SSCsimsi/8Bit_Computer/Programmer/Xgpro/img/T48BGA64.jpg

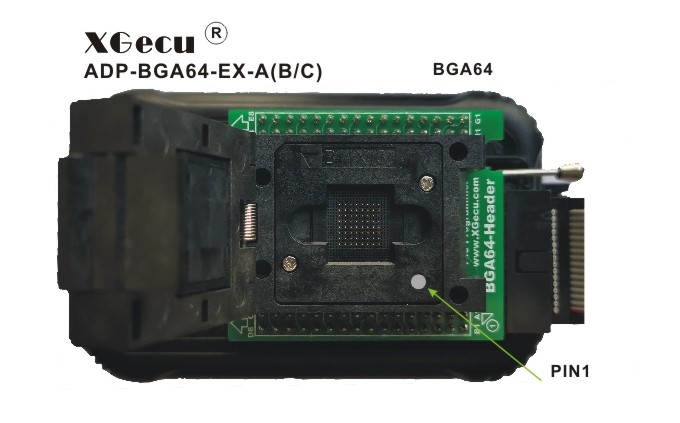
Programmer/Xgpro/img/T48BGA64.jpg
