SSCsimsi/8Bit_Computer/Programmer/Xgpro/img/T48_EMMC_Prog.jpg

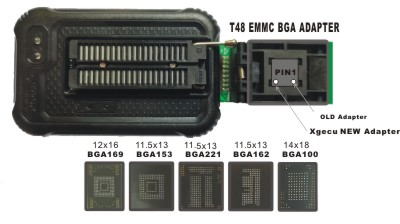
Programmer/Xgpro/img/T48_EMMC_Prog.jpg
