SSCsimsi/8Bit_Computer/Digital_new/docu/Documentation_it.pdf

### Digital

# Digital


Revisione: | v0.31
Data: | 2024-09-03 12:57
https://github.com/hneemann/Digital | 1 / 106

## Indice

A Generale

B Impostazioni
C Interfaccia a Linea di Comando D Componenti
1. Logica
2. IO
3. IO - Schermi

4. IO - Meccanici
5. IO - Periferiche
6. Cavi
7. Plexer
8. Flip-Flop
9. Memoria - RAM

10. Memoria - EEPROM
11. Memoria
12. Aritmetica
13. Interruttori
14. Altro
15. Altro - Decorazioni
16. Altro - Generici
17. Altro - VHDL/Verilog
18. Altro

E Libreria

## A Generale

### 1. Digital

### 1.1. Introduzione

Digital è un semplice simulatore utilizzato per simulare circuiti digitali. Le porte logiche sono connesse tra di loro da cavi e il comportamento complessivo del circuito può essere simulato. L'utente può interagire con la simulazione o premendo i bottoni o impostando i valori degli ingressi del circuito.
In questo modo, la maggior parte dei circuiti di base utilizzati nell'elettronica digitale può essere costruita e simulata. Nella cartella examples, gli utenti possono sfogliare gli esempi che inclu-dono anche un processore Harvard funzionale a ciclo singolo a 16 bit.
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
