SSCsimsi/8Bit_Computer/8Bit Computer ver2.0/Kicad/Kicad_Plugins_06.11.2025.png

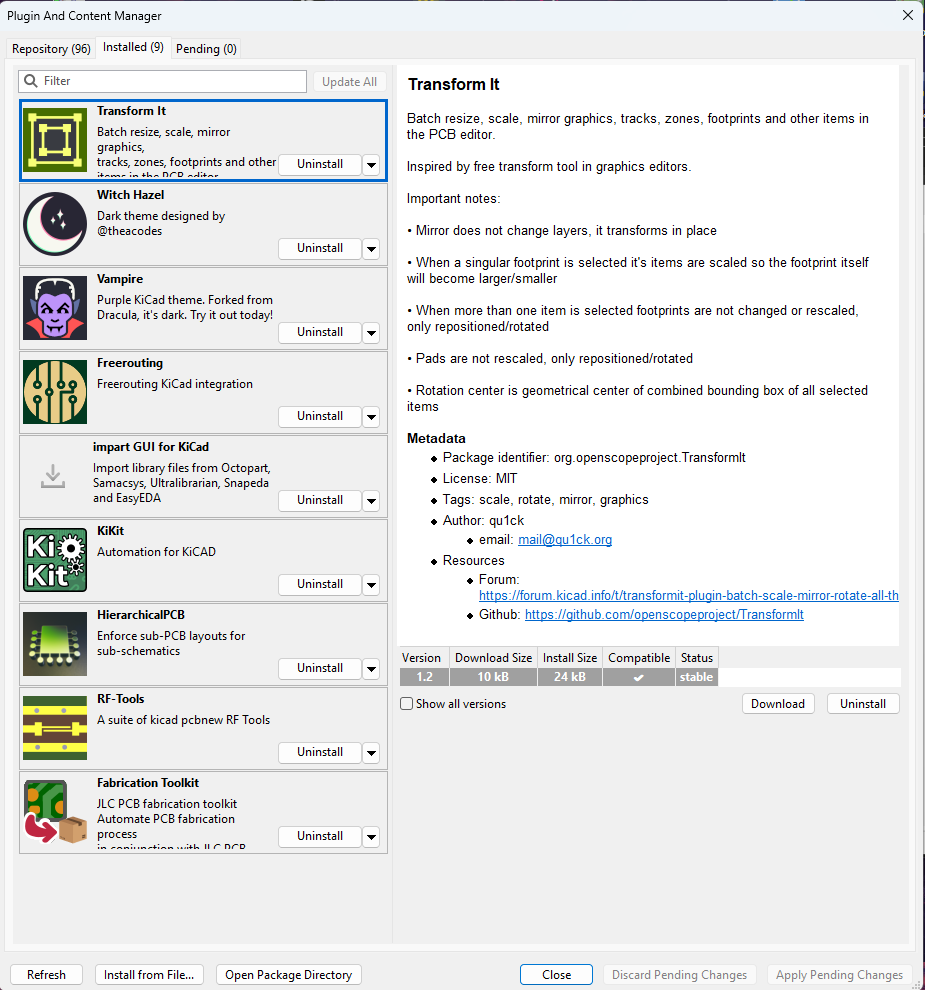
8Bit Computer ver2.0/Kicad/Kicad_Plugins_06.11.2025.png
