SSCsimsi/8Bit_Computer/8Bit Computer ver2.0/new_logic/Buffer.png

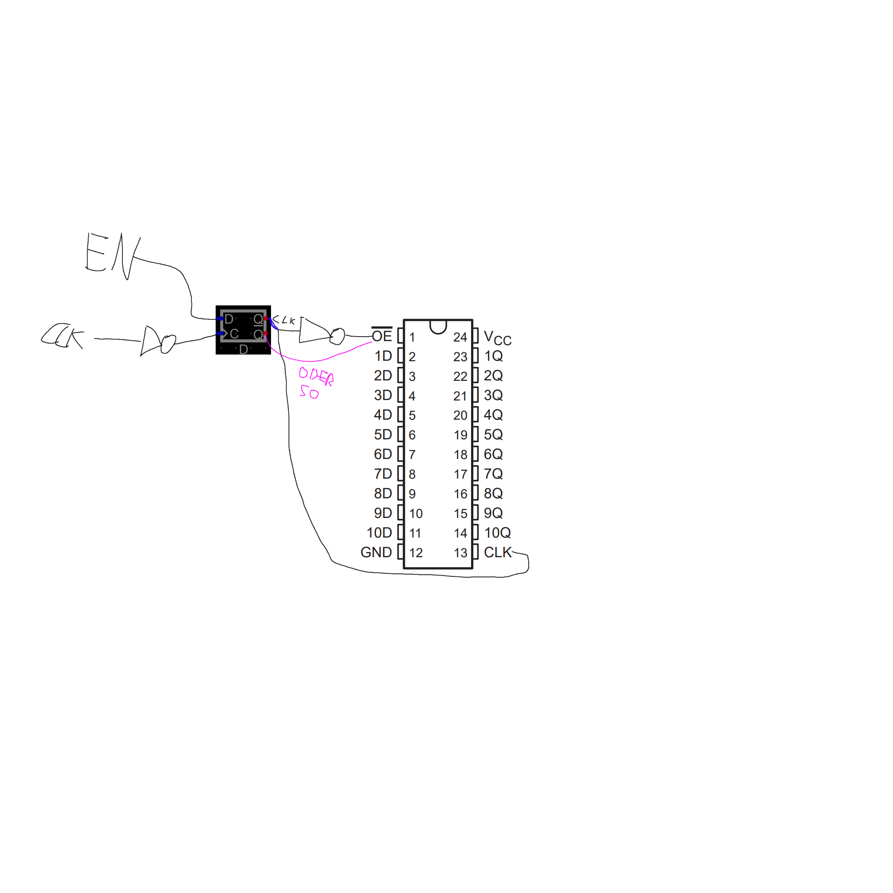
8Bit Computer ver2.0/new_logic/Buffer.png
