SSCsimsi/8Bit_Computer/Documentation/Thesis Documentation/Digital/Basics/Flip Flops/d-Latch.png

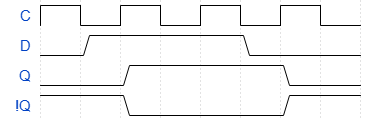
Documentation/Thesis Documentation/Digital/Basics/Flip Flops/d-Latch.png
