SSCsimsi/8Bit_Computer/Documentation/Thesis Documentation/Digital/Busses/Generic Bus.drawio.png

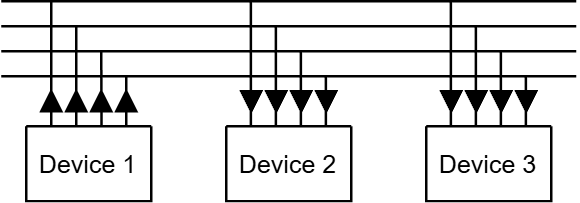
Documentation/Thesis Documentation/Digital/Busses/Generic Bus.drawio.png
