SSCsimsi/8Bit_Computer/Documentation/Thesis Documentation/Digital/Circuits/Output Circuit Diagram.png

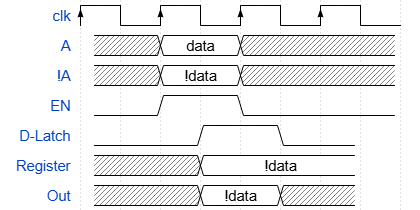
Documentation/Thesis Documentation/Digital/Circuits/Output Circuit Diagram.png
