SSCsimsi/8Bit_Computer/Documentation/Thesis Documentation/Digital/Overview/ALU.png

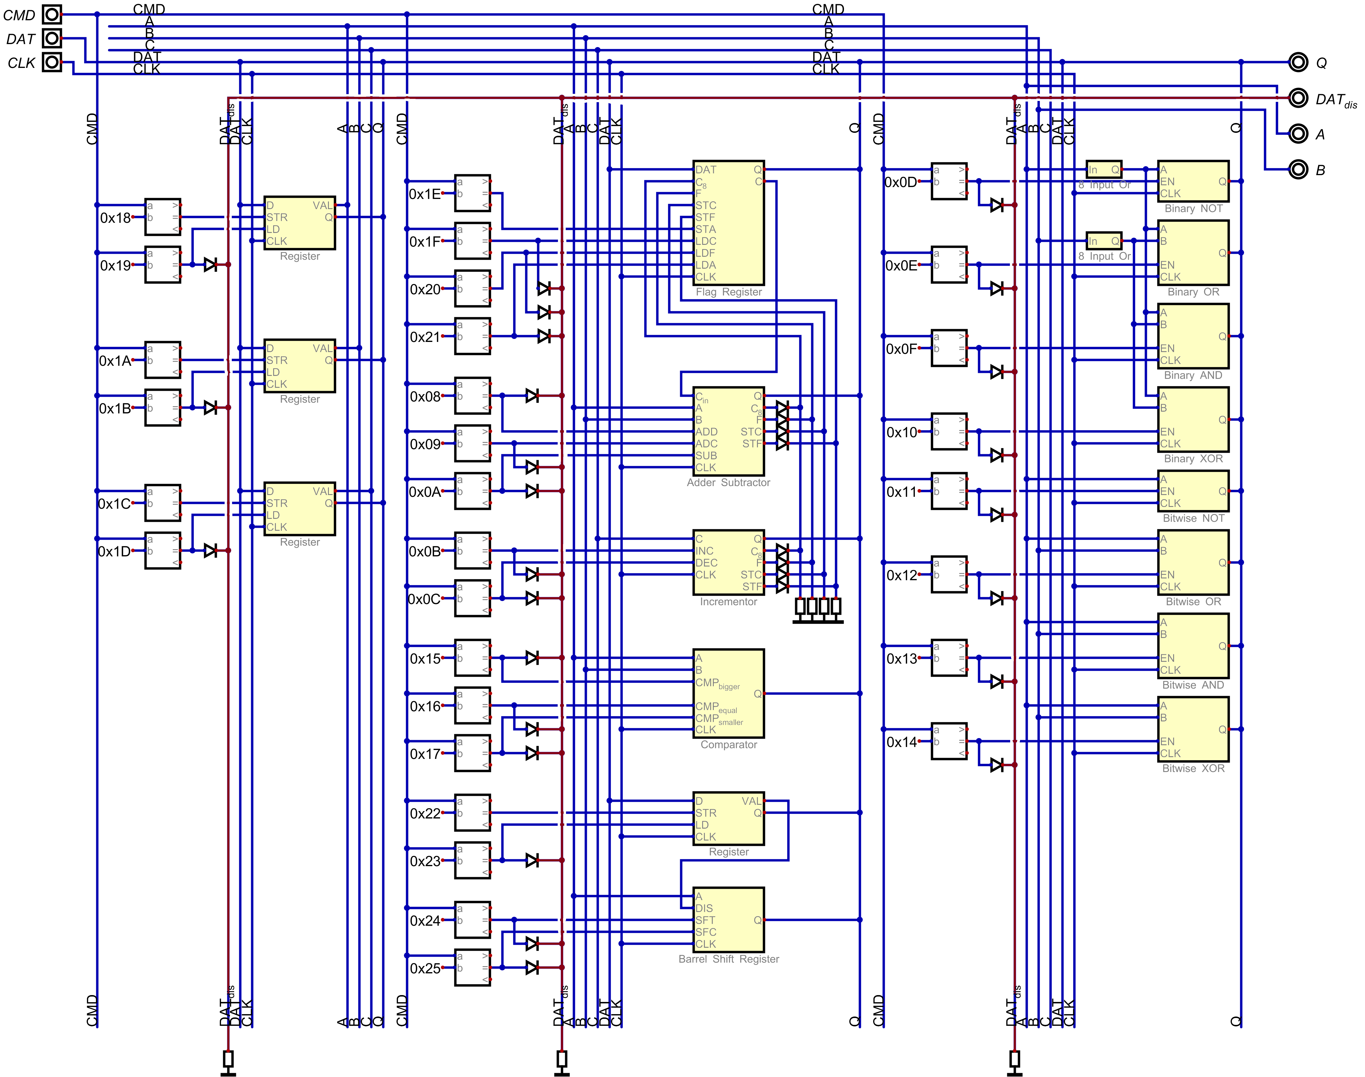
Documentation/Thesis Documentation/Digital/Overview/ALU.png
