SSCsimsi/8Bit_Computer/Programmer/Xgpro/img/T48BGA4808.jpg

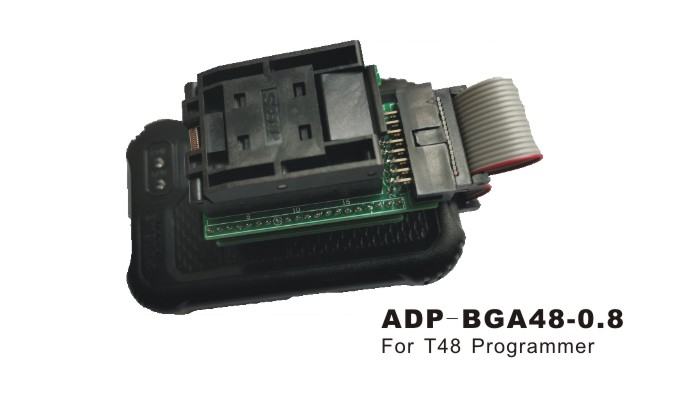
Programmer/Xgpro/img/T48BGA4808.jpg
