SSCsimsi/8Bit_Computer/Programmer/Xgpro/img/T48BGA6308.jpg

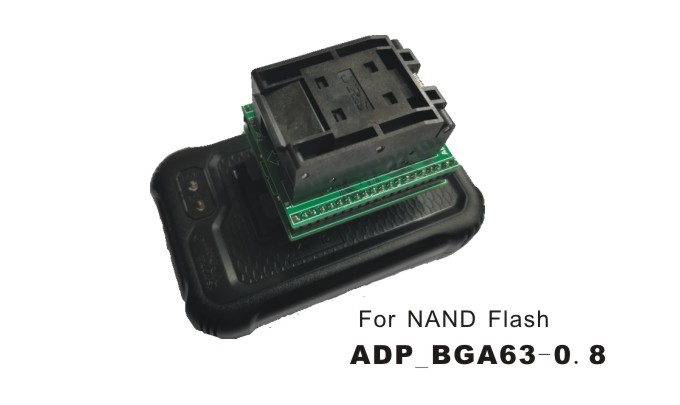
Programmer/Xgpro/img/T48BGA6308.jpg
