SSCsimsi/8Bit_Computer/Programmer/Xgpro/img/T76_VGA.jpg

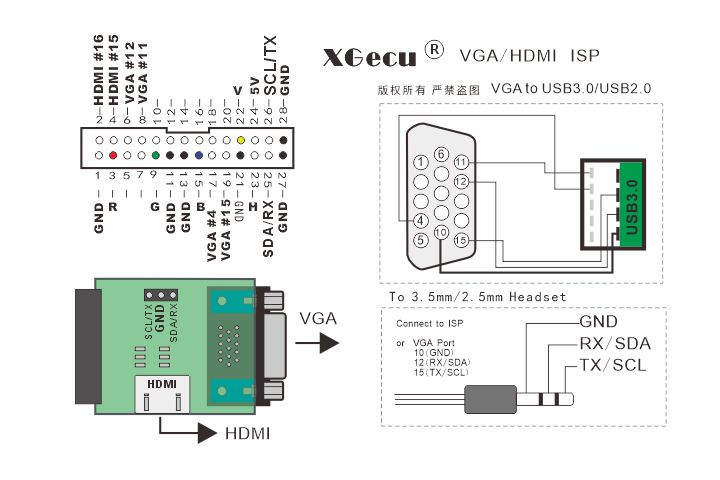
Programmer/Xgpro/img/T76_VGA.jpg
