SSCsimsi/8Bit_Computer/Programmer/Xgpro/img/T76BGA24_4x6.jpg

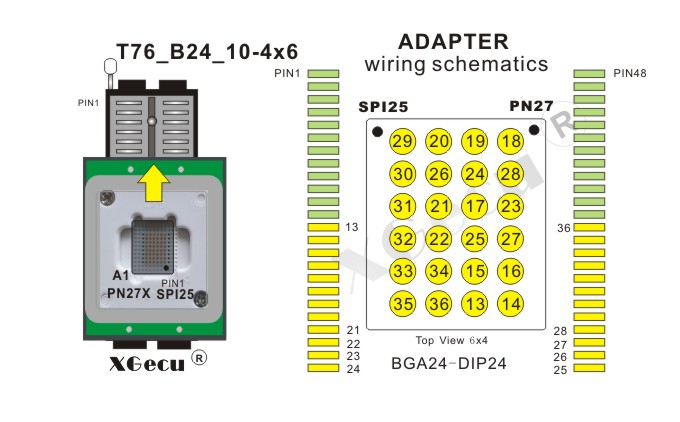
Programmer/Xgpro/img/T76BGA24_4x6.jpg
