SSCsimsi/8Bit_Computer/8Bit Computer ver2.0/excel/BOM.xlsx

Qty | Value | Footprint | Datasheet | Reference
12 | 22uF | Capacitor_SMD:C_1206_3216Metric_Pad1.33x1.80mm_HandSolder | ~ | C1,C2,C3,C6,C7,C9,C167,C168,C169,C175,C176,C177
8 | 0.1uF | Capacitor_SMD:C_1206_3216Metric_Pad1.33x1.80mm_HandSolder | ~ | C4,C5,C11,C12,C170,C171,C178,C179
4 | 22nF | Capacitor_SMD:C_1206_3216Metric_Pad1.33x1.80mm_HandSolder | ~ | C8,C13,C172,C180
4 | 300pF | Capacitor_SMD:C_1206_3216Metric_Pad1.33x1.80mm_HandSolder | ~ | C10,C14,C173,C182
288 | 100nF | Capacitor_SMD:C_1206_3216Metric_Pad1.33x1.80mm_HandSolder | ~ | C15,C16,C17,C18,C19,C20,C21,C22,C23,C24,C25,C26,C27,C28,C29,C30,C31,C32,C33,C34,C35,C36,C37,C38,C39,C40,C41,C42,C43,C44,C45,C46,C47,C48,C49,C50,C51,C52,C53,C54,C55,C56,C57,C58,C59,C60,C61,C62,C63,C64,C65,C66,C67,C68,C69,C70,C71,C72,C73,C74,C75,C76,C77,C78,C79,C80,C81,C82,C83,C84,C85,C86,C87,C88,C89,C90,C91,C92,C93,C94,C95,C96,C97,C98,C99,C100,C101,C102,C103,C104,C105,C106,C107,C108,C109,C110,C111,C112,C113,C114,C115,C116,C117,C118,C119,C120,C121,C122,C123,C124,C125,C126,C127,C128,C129,C130,C131,C132,C133,C134,C135,C136,C137,C138,C139,C140,C141,C142,C143,C144,C145,C146,C147,C148,C149,C150,C151,C152,C153,C154,C155,C156,C157,C158,C159,C160,C161,C162,C163,C164,C165,C166,C174,C181,C183,C184,C185,C186,C187,C188,C189,C190,C191,C192,C193,C194,C195,C196,C197,C198,C199,C200,C201,C202,C203,C204,C205,C206,C207,C208,C209,C210,C211,C212,C213,C214,C215,C216,C217,C218,C219,C220,C221,C222,C223,C224,C225,C226,C227,C228,C229,C230,C231,C232,C233,C234,C235,C236,C237,C238,C239,C240,C241,C242,C244,C246,C247,C248,C251,C252,C253,C254,C255,C256,C257,C258,C259,C260,C261,C262,C263,C264,C265,C266,C267,C268,C269,C270,C271,C272,C274,C275,C276,C277,C278,C279,C280,C281,C282,C283,C284,C285,C286,C287,C288,C289,C290,C291,C292,C293,C294,C295,C296,C297,C298,C299,C300,C301,C302,C303,C304,C305,C306,C307,C308,C309,C310,C311,C312,C313,C314,C315,C316,C317,C318,C319,C320,C321
2 | 27pF | Capacitor_SMD:C_1206_3216Metric_Pad1.33x1.80mm_HandSolder | ~ | C243,C245
1 | 10nF | Capacitor_SMD:C_1206_3216Metric_Pad1.33x1.80mm_HandSolder | ~ | C249
1 | 4.7uF | Capacitor_SMD:C_1206_3216Metric_Pad1.33x1.80mm_HandSolder | ~ | C250
1 | 100uF | Capacitor_THT:CP_Radial_D8.0mm_P3.50mm | ~ | C322
30 | 1N4148WS-7-F | Samacsys:SOD2513X120N | https://www.diodes.com//assets/Datasheets/1N4148WS_BAV16WS.pdf | D1,D2,D3,D4,D5,D6,D7,D8,D9,D10,D11,D12,D13,D14,D15,D16,D17,D18,D19,D20,D21,D22,D23,D24,D26,D27,D28,D29,D30,D31
4 | MP2338GTL-Z | Samacsys:MP2338GTLZ | https://www.monolithicpower.com/en/documentview/productdocument/index/version/2/document_type/Datasheet/lang/en/sku/MP2338GTL/document_id/9461/ | IC1,IC2,IC31,IC261
2 | DS1100Z-150+ | Samacsys:SOIC127P600X175-8N | https://datasheets.maximintegrated.com/en/ds/DS1100.pdf | IC3,IC238
42 | SN74F521DWR | Samacsys:SOIC127P1030X265-20N | http://www.ti.com/lit/gpn/sn74f521 | IC4,IC5,IC6,IC7,IC8,IC9,IC32,IC33,IC34,IC35,IC36,IC37,IC38,IC39,IC40,IC41,IC42,IC43,IC44,IC45,IC46,IC47,IC69,IC70,IC71,IC72,IC73,IC74,IC75,IC76,IC155,IC156,IC216,IC217,IC224,IC225,IC226,IC236,IC237,IC242,IC243,IC272
75 | SN74LVC1G14DBVR | Samacsys:SOT95P280X145-5N | https://datasheet.datasheetarchive.com/originals/distributors/Datasheets-DGA13/1136296.pdf | IC10,IC11,IC12,IC13,IC14,IC15,IC16,IC17,IC18,IC48,IC49,IC50,IC51,IC52,IC53,IC54,IC55,IC56,IC57,IC58,IC59,IC60,IC61,IC62,IC63,IC64,IC77,IC78,IC79,IC80,IC81,IC82,IC83,IC84,IC89,IC93,IC94,IC97,IC101,IC105,IC110,IC115,IC120,IC125,IC136,IC137,IC145,IC146,IC151,IC152,IC157,IC158,IC159,IC164,IC169,IC183,IC197,IC218,IC219,IC220,IC222,IC227,IC228,IC229,IC230,IC239,IC241,IC244,IC245,IC246,IC248,IC249,IC252,IC268,IC273
23 | SN74ABT574ADWR | Samacsys:SOIC127P1030X265-20N | http://www.ti.com/lit/gpn/sn74abt574a | IC19,IC20,IC21,IC65,IC92,IC96,IC100,IC104,IC109,IC114,IC119,IC124,IC133,IC143,IC144,IC154,IC182,IC195,IC196,IC231,IC232,IC247,IC255
28 | SN74AHC74DR | Samacsys:SOIC127P600X175-14N | http://www.ti.com/lit/gpn/sn74ahc74 | IC22,IC23,IC24,IC66,IC91,IC95,IC99,IC103,IC108,IC113,IC118,IC123,IC129,IC130,IC131,IC138,IC150,IC173,IC189,IC199,IC221,IC233,IC250,IC253,IC254,IC257,IC264,IC270
13 | SN74LVC1G08DBVR | Samacsys:SOT95P280X145-5N | http://www.ti.com/lit/ds/symlink/sn74lvc1g08.pdf | IC25,IC26,IC27,IC67,IC90,IC153,IC160,IC174,IC177,IC178,IC186,IC251,IC258
25 | SN74ABT245BDWR | Samacsys:SOIC127P1030X265-20N | http://www.ti.com/lit/gpn/sn74abt245b | IC28,IC29,IC30,IC68,IC134,IC184,IC200,IC201,IC202,IC203,IC204,IC206,IC208,IC209,IC210,IC211,IC212,IC213,IC214,IC215,IC234,IC235,IC256,IC259,IC260
6 | SN74HCS4075DR | Samacsys:SOIC127P600X175-14N | https://www.ti.com/lit/gpn/SN74HCS4075 | IC85,IC87,IC127,IC149,IC162,IC185
9 | SN74LVC1G32DBVR | Samacsys:SOT95P280X145-5N | http://www.ti.com/lit/gpn/sn74lvc1g32 | IC86,IC88,IC102,IC135,IC161,IC163,IC170,IC190,IC271
4 | SN74LVC1G86DBVR | Samacsys:SOT95P280X145-5N | http://www.ti.com/lit/ds/symlink/sn74lvc1g86.pdf | IC98,IC142,IC194,IC240
6 | SN74AHC08DR | Samacsys:SOIC127P600X175-14N | http://www.ti.com/lit/gpn/sn74ahc08 | IC106,IC107,IC128,IC132,IC148,IC179
2 | SN74AHC14DR | Samacsys:SOIC127P600X175-14N | http://www.ti.com/lit/gpn/sn74ahc14 | IC111,IC112
3 | SN74AHC32DR | Samacsys:SOIC127P600X175-14N | http://www.ti.com/lit/gpn/sn74ahc32 | IC116,IC117,IC126
4 | SN74AHC86DR | Samacsys:SOIC127P600X175-14N | http://www.ti.com/lit/gpn/sn74ahc86 | IC121,IC122,IC187,IC188
6 | SN74F283D | Samacsys:SOIC127P600X175-16N | http://www.ti.com/lit/ds/symlink/sn74f283.pdf | IC139,IC140,IC141,IC191,IC192,IC193
1 | SN74HC682N | Samacsys:DIP794W53P254L2540H508Q20N | http://www.ti.com/lit/gpn/sn74hc682 | IC147
4 | CY74FCT163CTSOC | Samacsys:SOIC127P1030X265-16N | http://www.ti.com/lit/ds/symlink/cy54fct163t.pdf | IC165,IC166,IC167,IC168
6 | SN74AHC157DR | Samacsys:SOIC127P600X175-16N | http://www.ti.com/lit/gpn/sn74ahc157 | IC171,IC172,IC175,IC176,IC180,IC181
1 | DS1100Z-20+ | Samacsys:SOIC127P600X175-8N | https://datasheets.maximintegrated.com/en/ds/DS1100.pdf | IC198
2 | M29F800FT55N3E2 | Samacsys:SOP50P2000X120-48N | https://www.alliancememory.com/wp-content/uploads/pdf/micron/M29FxxFT_FB.pdf | IC205,IC207
1 | AS7C1024B-12TCN | Samacsys:SOP50P2000X120-32N | https://mm.digikey.com/Volume0/opasdata/d220001/medias/docus/7135/PdfFile_316396.pdf | IC223
10 | SN74AHC540DWR | Samacsys:SOIC127P1030X265-20N | http://www.ti.com/lit/gpn/sn74ahc540 | IC262,IC263,IC274,IC275,IC276,IC277,IC278,IC279,IC280,IC281
1 | SN74LVC1GU04DCKR | Samacsys:SOT65P210X110-5N | http://www.ti.com/lit/gpn/sn74lvc1gu04 | IC266
1 | TMUX1309DYYR | Samacsys:SOP50P326X110-16N | https://www.ti.com/lit/ds/symlink/tmux1309.pdf | IC267
1 | LM555CMX_NOPB | Samacsys:SOIC127P600X175-8N | http://www.ti.com/lit/ds/symlink/lm555.pdf | IC269
19 | M20-7910842R | Samacsys:M207910842R | https://www.digikey.ph/en/products/detail/harwin-inc/M20-7910842R/6559285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 | J1,J2,J3,J4,J5,J6,J7,J8,J9,J10,J11,J12,J13,J14,J15,J16,J17,J38,J39
17 | M20-8890845 | Samacsys:M208890845 | https://cdn.harwin.com/pdfs/M20-889.pdf | J18,J19,J20,J21,J22,J23,J24,J25,J26,J27,J28,J29,J30,J31,J32,J33,J34
2 | Conn_02x25_Odd_Even | Connector_PinHeader_2.54mm:PinHeader_2x25_P2.54mm_Vertical | ~ | J35,J36
2 | M20-7911042R | Samacsys:M207911042R | https://content.harwin.com/m/0e0398fdb977d498/original/DRG-02613-Technical-Drawing-Datasheet-M20-791R-pdf.pdf | J40,J41
4 | 6.8uH | Samacsys:INDPM108100X400N | https://content.kemet.com/datasheets/KEM_L9016_MPEV.pdf | L1,L2,L3,L4
16 | LTST-C170KRKT | Samacsys:LEDC2012X120N | https://componentsearchengine.com/Datasheets/1/LTST-C170KRKT.pdf | LED1,LED2,LED3,LED4,LED6,LED8,LED10,LED12,LED97,LED98,LED99,LED100,LED101,LED102,LED103,LED104
8 | LTST-C171TBKT | Samacsys:LTSTC171TBKT | https://optoelectronics.liteon.com/upload/download/DS22-2000-233/LTST-C171TBKT(0630).pdf | LED5,LED7,LED9,LED11,LED13,LED14,LED15,LED16
48 | LTST-C170KFKT | Samacsys:LEDC2012X120N | http://optoelectronics.liteon.com/upload/download/DS-22-99-0185/LTST-C170KFKT.pdf | LED17,LED18,LED19,LED20,LED21,LED22,LED23,LED24,LED25,LED26,LED27,LED28,LED29,LED30,LED31,LED32,LED33,LED34,LED35,LED36,LED37,LED38,LED39,LED40,LED41,LED42,LED43,LED44,LED45,LED46,LED47,LED48,LED49,LED50,LED51,LED52,LED53,LED54,LED55,LED56,LED88,LED90,LED91,LED92,LED93,LED94,LED95,LED96
24 | LTST-C171KSKT | Samacsys:LTSTC171KSKT | https://optoelectronics.liteon.com/upload/download/DS22-2000-110/LTST-C171KSKT.pdf | LED57,LED58,LED59,LED60,LED61,LED62,LED63,LED64,LED65,LED66,LED67,LED68,LED69,LED70,LED71,LED72,LED105,LED107,LED109,LED111,LED113,LED115,LED117,LED119
24 | LTST-C170KGKT | Samacsys:LEDC2012X110N |  | LED73,LED74,LED75,LED76,LED77,LED78,LED79,LED80,LED81,LED82,LED83,LED84,LED85,LED86,LED87,LED89,LED106,LED108,LED110,LED112,LED114,LED116,LED118,LED120
26 | 4.7k | Resistor_SMD:R_1206_3216Metric_Pad1.30x1.75mm_HandSolder | ~ | R1,R20,R21,R22,R23,R24,R25,R26,R27,R28,R29,R30,R31,R35,R39,R42,R45,R50,R54,R57,R60,R62,R68,R69,R70,R71
12 | 10k | Resistor_SMD:R_1206_3216Metric_Pad1.30x1.75mm_HandSolder | ~ | R2,R5,R7,R8,R11,R13,R14,R17,R19,R32,R36,R38
4 | 191k | Resistor_SMD:R_1206_3216Metric_Pad1.30x1.75mm_HandSolder | ~ | R3,R9,R15,R33
4 | 49.9k | Resistor_SMD:R_1206_3216Metric_Pad1.30x1.75mm_HandSolder | ~ | R4,R10,R16,R34
4 | 90.9k | Resistor_SMD:R_1206_3216Metric_Pad1.30x1.75mm_HandSolder | ~ | R6,R12,R18,R37
72+40 | 390 | Resistor_SMD:R_1206_3216Metric_Pad1.30x1.75mm_HandSolder | ~ | R40,R41,R43,R44,R47,R49,R52,R55,R112,R113,R114,R115,R116,R117,R118,R119,R120,R121,R122,R123,R124,R125,R126,R127,R128,R129,R130,R131,R132,R133,R134,R135,R136,R137,R138,R139,R140,R141,R142,R143,R144,R145,R146,R147,R148,R149,R150,R151,R152,R153,R154,R155,R156,R157,R158,R159,R160,R161,R162,R163,R164,R165,R166,R167,R168,R169,R170,R171,R172,R173,R174,R175
8 | 270 | Resistor_SMD:R_1206_3216Metric_Pad1.30x1.75mm_HandSolder | ~ | R46,R48,R51,R53,R56,R58,R59,R61
2 | 1M | Resistor_SMD:R_1206_3216Metric_Pad1.30x1.75mm_HandSolder | ~ | R63,R66
1 | 330 | Resistor_SMD:R_1206_3216Metric_Pad1.30x1.75mm_HandSolder | ~ | R64
1 | 100 | Resistor_SMD:R_1206_3216Metric_Pad1.30x1.75mm_HandSolder | ~ | R65
1 | 1500 | Resistor_SMD:R_1206_3216Metric_Pad1.30x1.75mm_HandSolder | ~ | R67
x40 | 150 | Resistor_SMD:R_1206_3216Metric_Pad1.30x1.75mm_HandSolder | ~ | R72,R73,R74,R75,R76,R77,R78,R79,R80,R81,R82,R83,R84,R85,R86,R87,R88,R89,R90,R91,R92,R93,R94,R95,R96,R97,R98,R99,R100,R101,R102,R103,R104,R105,R106,R107,R108,R109,R110,R111
3 | B3FS-4055P | Samacsys:B3FS4055P | https://omronfs.omron.com/en_US/ecb/products/pdf/en-b3fs_4.pdf | S1,S2,S14
11 | 2MS1T2B3M2QES | Samacsys:2MS1T2B3M2QES |  | S3,S4,S5,S6,S7,S8,S9,S10,S11,S12,S13
1 | ~ | Samacsys:USB_C_PD_Triggerboard |  | U1
1 | M61P104KT20T607 | Samacsys:M61P104KT20T607 | https://www.vishay.com/docs/51108/m61.pdf | VR1
1 | 8MHz | Crystal:Crystal_SMD_HC49-SD_HandSoldering | ~ | Y1
