SSCsimsi/8Bit_Computer/8Bit Computer ver2.0/excel/8Bit_Computer_1.0_Parts.xlsx

2 input AND gate | 83 |  | https://csd-electronics.de/ICs/Logik/74HC/SMD/Logikgatter-74HC08-SO14::200.html | https://www.reichelt.at/at/de/4-fach-und-gatter-2-eingaenge-2--6-v-so-14-74hc-08d-nxp-p219337.html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 | ICs | Plugs
2 input OR gate | 66 |  | https://csd-electronics.de/ICs/Logik/74HC/SMD/Logikgatter-74HC32-SO14::206.html | https://www.reichelt.at/at/de/or-gate-2-input-3--20-v-so-14-smd-4071-p18488.html?&trstct=pol_2&nbc=1
2 input XOR gate | 34 |  |  | https://www.reichelt.at/at/de/xor-gate-2-input-3--20-v-so-14-smd-4070-p18487.html?trstct=pol_0&nbc=1 | 2 input AND gate single | Molex
3 input OR gate | 9 |  |  | https://www.reichelt.at/at/de/or-gate-3-input-3--15-v-so-14-smd-4075-p18491.html?&trstct=pol_1&nbc=1
4 input AND gate | 15 |  |  | https://www.reichelt.at/at/de/and-gate-4-element-2--6-v-so-14-smd-hc-21-p18657.html?trstct=pos_0&nbc=1 | SN74AHC1G08DCKR | https://www.reichelt.at/at/de/molex-crimpkontakt-mini-fit-jr-buchse-molex-39000039-p185722.html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
NOT gate | 40 |  |  | https://www.reichelt.at/at/de/inverter-hex-2--6-v-so-14-smd-hc-04-p18627.html?&trstct=pol_1&nbc=1 | https://www.ti.com/product/SN74AHC1G08/part-details/SN74AHC1G08DCKR
D latch | 18 |  |  | https://www.reichelt.at/at/de/octal-d-type-latch-3-state-2--6-v-so-20-smd-hc-573-p18698.html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 | https://www.snapeda.com/parts/SN74AHC1G08DCKR/Texas%20Instruments/view-part/?t=SN74AHC1G08DCKR | MOLEX 39281243 Molex Stiftleiste - Mini-Fit Jr - 2x12-polig - Stecker
T latch | 1 |  |  | https://www.reichelt.de/dual-flip-flop-jk-type-24-mhz-13ns-5-2-ma-2--6-v-so-16-smd-hc-112-p18633.html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 | included | https://www.reichelt.at/at/de/molex-stiftleiste-mini-fit-jr-2x12-polig-stecker-molex-39281243-p236824.html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
register file | 1 | (8 bit address + 8 data bits) |  | https://www.reichelt.at/at/de/register-3-state-ausgang-2--6-v-dil-16-74hc-670-p3279.html?trstct=pol_0&nbc=1 |  | https://www.snapeda.com/parts/39281243/Molex/view-part/?ref=search&t=MOLEX%2039281243
counter | 1 | (8 data bits + ld command) |  | https://www.reichelt.at/at/de/decoder-4-bit-2--6-v-so-16-smd-hc-193-p18655.html?&trstct=pol_0&nbc=1 | Single Inverter
rom chips | 3 | (8 bit address + 8 data bits) |  | https://www.reichelt.at/at/de/eeprom-128-b-16-x-8-2-5--5-5-v-so-8-24lc00-i-sn-p96528.html?trstct=pol_0&nbc=1 |  | MOLEX 39012240 Molex Crimpgehäuse - Mini-Fit Jr - 2x12-polig - Buchse
variable clock | 1 |  |  | inside school | SN74AHC1G14DBVR | https://www.reichelt.at/at/de/molex-crimpgehaeuse-mini-fit-jr-2x12-polig-buchse-molex-39012240-p236814.html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
 |  |  |  |  | https://www.ti.com/product/SN74AHC1G14/part-details/SN74AHC1G14DBVR
 |  |  |  |  | https://www.snapeda.com/parts/SN74AHC1G14DBVR/Texas%20Instruments/view-part/?t=SN74AHC1G14DBVR | included
 |  |  |  |  | included
 |  |  |  |  |  | MOLEX 39281023 Molex Stiftleiste - Mini-Fit Jr - 2x1-polig - Stecker
 |  |  |  |  | 6 channel Inverter | https://www.reichelt.at/at/de/molex-stiftleiste-mini-fit-jr-2x1-polig-stecker-molex-39281023-p185715.html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
 |  |  |  |  |  | https://www.snapeda.com/parts/39281023/Molex/view-part/?ref=search&t=MOLEX%2039281023
 |  |  | T flip flop build with 1 xor gate and 1 d flip flop |  | 74HC04D
 |  |  |  | https://www.mouser.at/ | https://www.reichelt.at/at/de/inverter-hex-2--6-v-so-14-smd-hc-04-p18627.html?&trstct=pol_1&nbc=1 | MOLEX 39012020 Molex Crimpgehäuse - Mini-Fit Jr - 2x1-polig - Buchse
 |  |  |  |  | https://www.snapeda.com/parts/74HC04D%2C653/Nexperia%20USA%20Inc./view-part/?ref=search&t=74HC04 | https://www.reichelt.at/at/de/molex-crimpgehaeuse-mini-fit-jr-2x1-polig-buchse-molex-39012020-p185701.html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
 |  |  |  |  | included
 |  |  |  |  |  | included
 |  |  |  |  | 2 input OR gate single
 |  |  |  |  |  | MOLEX 39303035 Molex Stiftleiste - Mini-Fit Jr - 1x3-polig - Stecker
 |  |  |  |  | SN74AHC1G32DBVR | https://www.reichelt.at/at/de/molex-stiftleiste-mini-fit-jr-1x3-polig-stecker-molex-39303035-p236835.html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
 |  |  |  |  | https://www.ti.com/product/SN74AHC1G32/part-details/SN74AHC1G32DBVR | https://www.snapeda.com/parts/39303035/Molex/view-part/?ref=search&t=MOLEX%2039303035
 |  |  |  |  | https://www.snapeda.com/parts/SN74AHC1G32DBVR/Texas%20Instruments/view-part/?t=SN74AHC1G32DBVR
 |  |  |  |  | included | MOLEX 39014030 Molex Crimpgehäuse - Mini-Fit Jr - 1x3-polig - Buchse
 |  |  |  |  |  | https://www.reichelt.at/at/de/molex-crimpgehaeuse-mini-fit-jr-1x3-polig-buchse-molex-39014030-p185699.html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
 |  |  |  |  | 3 input OR gate single
 |  |  |  |  |  | included
 |  |  |  |  | SN74LVC1G332DCKR
 |  |  |  |  | https://www.ti.com/product/SN74LVC1G332/part-details/SN74LVC1G332DCKR | MOLEX 39281183 Molex Stiftleiste - Mini-Fit Jr - 2x9-polig - Stecker
 |  |  |  |  | https://www.snapeda.com/parts/SN74LVC1G332DCKR/Texas%20Instruments/view-part/?t=SN74LVC1G332 | https://www.reichelt.at/at/de/molex-stiftleiste-mini-fit-jr-2x9-polig-stecker-molex-39281183-p186193.html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
 |  |  |  |  | included | https://www.snapeda.com/parts/39281183/Molex/view-part/?ref=search&t=MOLEX%2039281183
 |  |  |  |  | 2 input XOR gate single | MOLEX 39012180 Molex Crimpgehäuse - Mini-Fit Jr - 2x9-polig - Buchse
 |  |  |  |  |  | https://www.reichelt.at/at/de/molex-crimpgehaeuse-mini-fit-jr-2x9-polig-buchse-molex-39012180-p185709.html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
 |  |  |  |  | SN74AHC1G86DBVR
 |  |  |  |  | https://www.ti.com/product/SN74AHC1G86/part-details/SN74AHC1G86DBVR | included
 |  |  |  |  | https://www.snapeda.com/parts/SN74AHC1G86DBVR/Texas%20Instruments/view-part/?t=SN74AHC1G86DBVR
 |  |  |  |  | included | MOLEX 39281103 Molex Stiftleiste - Mini-Fit Jr - 2x5-polig - Stecker
 |  |  |  |  |  | https://www.reichelt.at/at/de/molex-stiftleiste-mini-fit-jr-2x5-polig-stecker-molex-39281103-p185719.html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
 |  |  |  |  | D flip flop single | https://www.snapeda.com/parts/39281103/Molex/view-part/?ref=search&t=MOLEX%2039281103
 |  |  |  |  | 74AHC 1G79GW | MOLEX 39012100 Molex Crimpgehäuse - Mini-Fit Jr - 2x5-polig - Buchse
 |  |  |  |  | https://www.reichelt.at/at/de/flip-flop-d-type-single-2--5-5-v-sot-353-5-74ahc-1g79gw-p219157.html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 | https://www.reichelt.at/at/de/molex-crimpgehaeuse-mini-fit-jr-2x5-polig-buchse-molex-39012100-p185705.html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
 |  |  |  |  | https://www.snapeda.com/parts/74AHCT1G79GW/NXP%20Semiconductors/view-part/?t=74AHC%201G79GW
 |  |  |  |  | included | included
 |  |  |  |  | 4 input OR gate 2 channel
 |  |  |  |  | CD4072BM
 |  |  |  |  | https://www.reichelt.at/at/de/or-gate-4-input-3--15-v-so-14-smd-4072-p18489.html?trstct=pol_10&nbc=1
 |  |  |  |  | https://www.snapeda.com/parts/CD4072BM/Texas%20Instruments/view-part/?ref=search&t=CD4072BM
 |  |  |  |  | included
 |  |  |  |  | Octal D flip flop
 |  |  |  |  | SN74HC273QDWRG4Q1
 |  |  |  |  | https://www.ti.com/product/SN74HC273-Q1/part-details/SN74HC273QDWRG4Q1
 |  |  |  |  | https://vendor.ultralibrarian.com/TI/embedded/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
 |  |  |  |  | included
 |  |  |  |  | 2 input AND gate 4 channel
 |  |  |  |  | 74HC08D
 |  |  |  |  | https://www.reichelt.at/at/de/4-fach-und-gatter-2-eingaenge-2--6-v-so-14-74hc-08d-nxp-p219337.html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
 |  |  |  |  | https://www.snapeda.com/parts/74HC08D%2C652/Nexperia%20USA/view-part/?ref=search&t=74HC08D
 |  |  |  |  | included
 |  |  |  |  | 4 input AND gate 2 channel
 |  |  |  |  | SN74HC21D
 |  |  |  |  | https://www.reichelt.at/at/de/and-gate-4-element-2--6-v-so-14-smd-hc-21-p18657.html?trstct=pos_0&nbc=1
 |  |  |  |  | https://www.snapeda.com/parts/SN74HC21D/Texas%20Instruments/view-part/?ref=search&t=SN74HC21D
 |  |  |  |  | included
 |  |  |  |  | 2 input OR gate 4 channel
 |  |  |  |  | SN74HCS32PWR
 |  |  |  |  | https://www.ti.com/product/SN74HCS32/part-details/SN74HCS32PWR
 |  |  |  |  | https://vendor.ultralibrarian.com/TI/embedded/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
 |  |  |  |  | included
 |  |  |  |  | 2 input XOR gate 4 channel
 |  |  |  |  | 74HC 86D NXP
 |  |  |  |  | https://www.reichelt.at/at/de/vierfache-2-eingangs-exklusiv-oder-gatter-2--6-v-so-14-74hc-86d-nxp-p219160.html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
 |  |  |  |  | https://www.snapeda.com/parts/74HC86D%2C652/Nexperia%20USA/view-part/?ref=search&t=74HC86D
 |  |  |  |  | included
 |  |  |  |  | 4-by-4 Register File
 |  |  |  |  | CD74HC670M
 |  |  |  |  | https://www.ti.com/product/CD74HC670/part-details/CD74HC670M
 |  |  |  |  | https://vendor.ultralibrarian.com/TI/embedded/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
 |  |  |  |  | included
 |  |  |  |  | 4-Bit Synchronous Up/Down Counters (Dual Clock With Clear)
 |  |  |  |  | SN74HC193D
 |  |  |  |  | https://www.ti.com/product/SN74HC193/part-details/SN74HC193D
 |  |  |  |  | https://www.snapeda.com/parts/SN74HC193D/Texas%20Instruments/view-part/?ref=search&t=SN74HC193D
 |  |  |  |  | included
 |  |  |  |  | 3 input OR gate 3 channel
 |  |  |  |  | SN74HCS4075DR
 |  |  |  |  | https://www.ti.com/product/SN74HCS4075/part-details/SN74HCS4075DR
 |  |  |  |  | https://vendor.ultralibrarian.com/TI/embedded/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
 |  |  |  |  | included
 |  |  |  |  | EEPROM
 |  |  |  |  | AT28C64B-15PU
 |  |  |  |  | https://www.microchip.com/en-us/product/AT28C64B
 |  |  |  |  | https://www.snapeda.com/parts/AT28C64B-15PU/Microchip/view-part/?ref=search&t=AT28C64B-15PU
 |  |  |  |  | included
 |  |  |  |  | SRAM
 |  |  |  |  | IS62C1024AL-35QL
 |  |  |  |  | https://www.reichelt.at/at/de/sram-1-mb-128-k-x-8-5-v-35ns-sop-32-is62c1024al-35ql-p146565.html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
 |  |  |  |  | https://www.snapeda.com/parts/IS62C1024AL35QLITR/ISSI/view-part/?ref=search&t=IS62C1024AL
