SSCsimsi/8Bit_Computer/8Bit Computer ver2.0/excel/chips availability.xlsx

 |  | Boolean Logic
Need | State | Chip Name | Chip Function | Version1 | Version2 | Website1 | Website2 | Price~ | Chip Type | Propagation Delay Time |  | Datasheet1 | Datasheet2 | Kicad state | Mouser
 | notused | 74x04 | Not | 1CH
 | use | 74x14 | Not | 6CH Schmitttrigger | 6CH Schmitttrigger | Website1 (https://www.ti.com/product/de-de/SN74AHC14) | Website2 (https://www.ti.com/product/de-de/SN74HCS14) | 0.30 USD | AHC/HCS |  |  | Datasheet1 (https://www.ti.com/lit/ds/symlink/sn74ahc14.pdf?ts=1760108227976) | Datasheet2 (https://www.ti.com/lit/ds/symlink/sn74hcs14.pdf?ts=1757190910036) | INCLUDED | BUY (https://eu.mouser.com/ProductDetail/Texas-Instruments/SN74AHC14DR?qs=ZA235jQDfbrd%252BwhwnzLskw%3D%3D)
 | use | 74x1G14 | Not | 1CH Schmitttrigger | 1CH Schmitttrigger | Website1 (https://www.ti.com/product/de-de/SN74AHC1G14) | Website2 (https://www.ti.com/product/de-de/SN74LVC1G14) | 0.30 USD | AHC/LVC |  |  | Datasheet1 (https://www.ti.com/lit/ds/symlink/sn74ahc1g14.pdf?ts=1757172131384) | Datasheet2 (https://www.ti.com/lit/ds/symlink/sn74lvc1g14.pdf?ts=1757172154130) | INCLUDED | BUY (https://www.mouser.at/ProductDetail/Texas-Instruments/SN74LVC1G14DBVR?qs=dT9u2OTAaVWRIgCrQFnxuQ%3D%3D)
 | use | 74x08 | And | 4x 2input | 4x 2input Schmittt | Website1 (https://www.ti.com/product/SN74AHC08) | Website2 (https://www.ti.com/product/SN74HCS08) | 0.30 USD | AHC/HCS |  |  | Datasheet1 (https://www.ti.com/lit/ds/symlink/sn74ahc08.pdf?ts=1760074946404) | Datasheet2 (https://www.ti.com/lit/ds/symlink/sn74hcs08.pdf?ts=1757190317977) | INCLUDED | BUY (https://eu.mouser.com/ProductDetail/Texas-Instruments/SN74AHC08DR?qs=3pnr37ZAbK%252BRKKo59Fme5A%3D%3D)
 | use | 74x32 | Or | 4x 2input | 4x 2input Schmittt | Website1 (https://www.ti.com/product/SN74AHC32) | Website2 (https://www.ti.com/product/SN74HCS32) | 0.30 USD | AHC/HCS |  |  | Datasheet1 (https://www.ti.com/lit/ds/symlink/sn74hc32.pdf?ts=1757190561557) | Datasheet2 (https://www.ti.com/lit/ds/symlink/sn74hcs32.pdf?ts=1757190458236) | INCLUDED | BUY (https://eu.mouser.com/ProductDetail/Texas-Instruments/SN74AHC32DR?qs=bvpNxolhIUP1gpgKlKyYQQ%3D%3D)
 | use | 74x86 | Xor | 4x 2input | 4x 2input Schmittt | Website1 (https://www.ti.com/product/de-de/SN74AHC86) | Website2 (https://www.ti.com/product/de-de/SN74HCS86) | 0.30 USD | AHC/HCS |  |  | Datasheet1 (https://www.ti.com/lit/ds/symlink/sn74ahc86.pdf?ts=1760108265518) | Datasheet2 (https://www.ti.com/lit/ds/symlink/sn74hcs86.pdf?ts=1757189011902) | INCLUDED | BUY (https://eu.mouser.com/ProductDetail/Texas-Instruments/SN74AHC86DR?qs=D5pVkbrsqqK0yvWJ8LFETg%3D%3D)
6 | use as 8in or | 74x4075 | Or | 3x 3input | 3x 3input Schmittt | Website1 (https://www.ti.com/product/CD74HC4075) | Website2 (https://www.ti.com/product/SN74HCS4075) | 0.30 USD | HC/HCS |  |  | Datasheet1 (https://www.ti.com/lit/ds/symlink/cd74hc4075.pdf?ts=1757183417815) | Datasheet2 (https://www.ti.com/lit/ds/symlink/sn74hcs4075.pdf?ts=1757186975519) | INCLUDED | BUY (https://www.mouser.at/ProductDetail/Texas-Instruments/SN74HCS4075DR?qs=sPbYRqrBIVmdJ91ff%252BdGMg%3D%3D)
2 | use for 8in or | 74x1G32 | Or | 1CH | 1CH | Website1 (https://www.ti.com/product/SN74AHC1G32) | Website2 (https://www.ti.com/product/SN74LVC1G32) | 0.30 USD | AHC/LVC |  |  | Datasheet1 (https://www.ti.com/lit/ds/symlink/sn74ahc1g32.pdf?ts=1757188663895) | Datasheet2 (https://www.ti.com/lit/ds/symlink/sn74lvc1g32.pdf?ts=1757172239914) | INCLUDED | BUY (https://www.mouser.at/ProductDetail/Texas-Instruments/SN74LVC1G32DBVR?qs=3pnr37ZAbK%2F6ArGi%2FPb2Ng%3D%3D)
 | use | 74x1G08 | And | 1CH |  | Website1 (https://www.ti.com/product/SN74LVC1G08) |  | 0.30USD | LVC |  |  | Datasheet1 (https://www.ti.com/lit/ds/symlink/sn74lvc1g08.pdf?ts=1760074824393) |  | INCLUDED | BUY (https://www.mouser.at/ProductDetail/Texas-Instruments/SN74LVC1G08DBVR?qs=8yeEWhuAOtNjtL049wSCoQ%3D%3D)
 | use | SN74x1G86 | XOR | 1CH |  | Website1 (https://www.ti.com/product/SN74LVC1G86) |  | 0.30USD | LVC |  |  | Datasheet1 (https://www.ti.com/lit/ds/symlink/sn74lvc1g86.pdf?ts=1760181090682) |  | INCLUDED | BUY (https://www.mouser.at/ProductDetail/Texas-Instruments/SN74LVC1G86DBVR?qs=d9gICRQKuCcyH%2F0J6yE9tQ%3D%3D)
 |  | SN74LVC1GU04 | NOT | 1CH Unbuffered |  | Website1 (https://www.ti.com/product/SN74LVC1GU04) |  | 0.30 | LVC |  |  | Datasheet1 (https://www.ti.com/lit/ds/symlink/sn74lvc1gu04.pdf?ts=1762367978997) |  | Not Included | BUY (https://www.mouser.at/ProductDetail/Texas-Instruments/SN74LVC1GU04DCKR?qs=HE9hdJajmeplLYeGBFwXAQ%3D%3D)
 |  | General Logic
 | State | Chip Name | Chip Function | Version |  | Website1 | Website2 | Price | Chip Type | Propagation Delay Time |  | Datasheet1 | Datasheet2 | Kicad state
 | old | 74x85 | Comparator | 8Bit |  | Website (https://www.mouser.at/ProductDetail/Texas-Instruments/SN74LS85N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) |  | 1.44 EUR | LS
 | old | 74x682 | Comparator | 8Bit |  | Website (https://www.digikey.at/en/products/base-product/texas-instruments/296/74LS682/21135) |  | 2.57 EUR | LS
 | old | 74x518 | Comparator | 8Bit |  | Website (https://www.ti.com/product/SN74ALS518/part-details/SN74ALS518N) |  | 10.166 USD | ALS
 | old | 74x688 | Comparator | 8Bit nex | 8Bit ti | Website1 (https://www.nexperia.com/product/74HC688D) | Website2 (https://www.ti.com/product/de-de/CD74HC688) | 0.5 EUR | HC |  |  | Datasheet1 (https://assets.nexperia.com/documents/data-sheet/74HC688.pdf) | Datasheet2 (https://www.ti.com/lit/ds/symlink/cd74hc688.pdf?ts=1757335819558) | INCLUDED | BUY (https://www.mouser.at/ProductDetail/Nexperia/74HC688D653?qs=P62ublwmbi%252BZYv%2F8J45taw%3D%3D)
 | use for cmds | 74x521 | Comparator | 8Bit identity |  | Website (https://www.ti.com/product/SN74F521) |  | 0.8 | F |  |  | Datasheet (https://www.ti.com/lit/ds/symlink/sn54f521.pdf?ts=1760223444371) |  | INCLUDED | BUY (https://www.mouser.at/ProductDetail/Texas-Instruments/SN74F521DWR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)
1 | use for P>Q | 74HC682 | Comparator | 8Bit |  | Website1 (https://www.ti.com/product/de-de/SN74HC682) |  |  | HC PDIP |  |  | Datasheet1 (https://www.ti.com/lit/ds/symlink/sn74hc682.pdf?ts=1759864992606) |  | INCLUDED | BUY (https://eu.mouser.com/ProductDetail/Texas-Instruments/SN74HC682N?qs=JD1fk4stihZ5fZizX5ugBQ%3D%3D)
 | old | 74x323 | Shift Register | 8Bit |  | Website1 (https://www.ti.com/product/SN74ALS323) | Website2 (https://www.ti.com/product/CD74AC323) | 11USD/0.7USD | ALS/AC |  |  | Datasheet1 (https://www.ti.com/lit/ds/symlink/sn54als323.pdf?ts=1756926622365f?ts=1756926622365) | Datasheet2 (https://www.ti.com/lit/ds/symlink/cd74ac323.pdf?ts=1757345595129) | INCLUDED
 | old | CD74x194 | Shift Register | 4Bit |  | Website1 (https://www.ti.com/product/CD74HC194) |  | 0.5 | HC |  |  | Datasheet1 (https://www.ti.com/lit/ds/symlink/cd74hc194.pdf?ts=1759666023722)
1 | old | SN74x4051 | MUX | 8Bit |  | Website (https://www.ti.com/product/SN74LV4051A) |  |  | LV |  |  | Datasheet (https://www.ti.com/lit/ds/symlink/sn74lv4051a.pdf?ts=1759374886404) |  | INCLUDED | BUY (https://www.mouser.at/ProductDetail/Texas-Instruments/SN74LV4051ADR?qs=8Pd2FuFSoMHt2f%2FU0%252B0rVg%3D%3D)
 | old | CD74x4051 | Multiplexer | 8Bit |  | Website (https://www.ti.com/product/CD74HC4051) |  |  | HCT/HC |  | fall rise | Datasheet (https://www.ti.com/lit/ds/symlink/cd74hc4051.pdf?ts=1756999873621)
 | old | 74x194 | Shift Register | 4Bit |  | Website (https://www.ti.com/product/SN74AS194) |  | 3.68 USD | AS
 | old | 74x83 | Adder | 4Bit |  | Not available |  | - | -
 | use as 4Bit+3B+2B+1B | 74x283 | Adder | 4Bit |  | Website1 (https://www.ti.com/product/de-de/SN74S283) | Website2 (https://www.ti.com/product/de-de/SN74F283) | 8.295 EUR/ 1EUR | S/F |  |  | Datasheet1 (https://www.ti.com/lit/ds/symlink/sn74s283.pdf?ts=1757168041261) | Datasheet2 (https://www.ti.com/lit/ds/symlink/sn74f283.pdf?ts=1757344110529) | INCLUDED | BUY (https://www.mouser.at/ProductDetail/Texas-Instruments/SN74F283D?qs=RnzODY3cU8t9RP7%252BwWjEZw%3D%3D)
 | old | 74x183 | 2 Half Adders |  |  | Not available |  | - | -
 | old | 74x80 | 2 Half Adders |  |  | Not many sources |  | ? | LS
 | old | 74x885 | Comparator | 8Bit |  |  |  |  | AS |  | would need a nor as the output
 | old | 74x795 | Buffer/Driver | 8Bit |  |  |  |  | LS | 15ns
 | use 4xfor 16Bit | 74x163 | Program Counter | 4Bit |  | Website1 (https://www.ti.com/product/CY74FCT163T) |  | 1.3USD | FCT | sub 10ns |  | Datasheet1 (https://www.ti.com/lit/ds/symlink/cy74fct163t.pdf?ts=1760116319125) |  | INCLUDED | BUY (https://www.mouser.at/ProductDetail/Texas-Instruments/CY74FCT163CTSOC?qs=LU5rZWrBGo2D2kQkTzgJvw%3D%3D)
 | use | LM555 | Timer |  |  | Website1 (https://www.ti.com/product/LM555/part-details/LM555CMX/NOPB) |  |  | CMX/NOPB |  |  | Datasheet1 (https://www.ti.com/lit/ds/symlink/lm555.pdf?ts=1764232185351) |  | INCLUDED | BUY (https://www.mouser.at/ProductDetail/Texas-Instruments/LM555CMX-NOPB?qs=QbsRYf82W3GHnQuoL%2FmIoA%3D%3D)
 |  | Storage
 | State | Chip Name | Chip Function |  |  | Website |  | Price | Chip Type | Read speed | Info | Datasheet
 | old | AT28C64B | EEPROM | 64Kbit (8Kbit x 8) |  | Website (https://www.microchip.com/en-us/product/AT28C64B) |  |  |  | 150ns |  | Datasheet (https://ww1.microchip.com/downloads/aemDocuments/documents/MPD/ProductDocuments/DataSheets/AT28C64B-64-Kbit-8Kx8-Parallel-EEPROM-with-Page-Write-and-Software-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)
 | use faster as IS | AS7C1024B-12TCN | SRAM | 1Mb (128Kbit x 8) |  | Website (https://www.alliancememory.com/AS7C1024B-1/) |  | ~4USD |  | 12ns |  | Datasheet (https://www.alliancememory.com/wp-content/uploads/AS7C1024B_March2022_v3.0.pdf) |  | INCLUDED | BUY (https://eu.mouser.com/ProductDetail/Alliance-Memory/AS7C1024B-12TCN?qs=E5c5%252Bmu3i39p9b7hUnTiBw%3D%3D)
 | old | IS62C1024 | SRAM | 1Mb (128Kbit x 8) |  | Website (https://www.issi.com/WW/pdf/62-65C1024AL.pdf) |  | ~2USD |  | 35ns/45ns |  | Datasheet (https://www.issi.com/WW/pdf/62-65C1024AL.pdf) |  | INCLUDED | BUY (https://www.mouser.at/ProductDetail/ISSI/IS62C1024AL-35QLI-TR?qs=tFgq3%2FJV4HgOUVNChCblDw%3D%3D)
3 | old | SST39xFxxxx | NORFlash | 1-8Mb |  | Website (https://www.microchip.com/en-us/parametric-search/600) |  | ~2USD |  | 55ns | 1xAdress, 1xData, 1xCommands | Datasheet (https://www.mouser.at/datasheet/3/282/1/25041A.pdf) |  | INCLUDED | BUY (https://www.mouser.at/ProductDetail/Microchip-Technology/SST39LF802C-55-4C-EKE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)
3 | use | M29F800FT | NORFlash | 8Mb |  | Website (https://www.alliancememory.com/product/micron-m29f-nor-flash-5v/) |  | ~4USD |  | 55ns | 1xAdress, 1xData, 1xCommands | Datasheet (https://www.alliancememory.com/wp-content/uploads/M29FxxFT_FB.pdf) |  | INCLUDED | BUY (https://www.mouser.at/ProductDetail/Alliance-Memory/M29F800FT55N3E2?qs=vmHwEFxEFR9Aw9aI%2FlWRzQ%3D%3D)
3 | old | SN74HCS273 | Register | Octal Dlatch |  | Website (https://www.ti.com/product/SN74HCS273) |  | 0.5 |  |  |  | Datasheet (https://www.ti.com/lit/ds/symlink/sn74hcs273.pdf?ts=1759408082671) |  |  | BUY (https://www.mouser.at/ProductDetail/Texas-Instruments/SN74HCS273PWR?qs=QNEnbhJQKvYIJo9rBWLKyw%3D%3D)
3 | use | SN74x574 | Register/Buffer | Octal Dlatch | TriState | Website (https://www.ti.com/product/SN74HCS574) | Website2 (https://www.ti.com/product/SN74ABT574A) | 0.4/0.9 | HCS/ABT | 16.7/6.6ns |  | Datasheet (https://www.ti.com/lit/ds/symlink/sn74hcs74.pdf?ts=1759421989098) | Datasheet2 (https://www.ti.com/lit/ds/symlink/sn74abt574a.pdf?ts=1760121015200) | INCLUDED | BUY1 (https://www.mouser.at/ProductDetail/Texas-Instruments/SN74HCS574DGSR?qs=3Rah4i%252BhyCHGg6B36IqQww%3D%3D) | BUY2 (https://www.mouser.at/ProductDetail/Texas-Instruments/SN74ABT574ADWR?qs=nMmhAzRCgdCWNOUsuPi1DA%3D%3D)
 | use | SN74x74 | Dlatch | 2x |  | Website (https://www.ti.com/product/SN74HCS74) | Website2 (https://www.ti.com/product/SN74AHC74) | 0.2/0.3 | HCS/AHC |  |  | Datasheet (https://www.ti.com/lit/ds/symlink/sn74hcs74.pdf?ts=1759421989098) | Datasheet2 (https://www.ti.com/lit/ds/symlink/sn74ahc74.pdf?ts=1760122148694) | INCLUDED | BUY (https://www.mouser.at/ProductDetail/Texas-Instruments/SN74HCS74DR?qs=TiOZkKH1s2QvGxo75w4r5Q%3D%3D) | BUY2 (http://mouser.at/ProductDetail/Texas-Instruments/SN74AHC74DR?qs=st7IWvlL5%2FgP9OJq63EsFQ%3D%3D)
9 | old | 74x821 | Buffer | 10Bit | TriState | Website (https://www.ti.com/product/de-de/SN74ABT821A) |  |  | AS |  |  | Datasheet (https://www.ti.com/lit/ds/symlink/sn74abt821a.pdf?ts=1757008739474) |  | INCLUDED | BUY (https://www.mouser.at/ProductDetail/Texas-Instruments/SN74ABT821ADWR?qs=FM6NhYOeeBXxX%2Fnpl0SzFQ%3D%3D)
 | old | SN74ABT16374A | Buffer | 16Bit | TriState | Website (https://www.ti.com/product/de-de/SN74ABT16374A) |  | 1.6EUR | ABT |  |  | Datasheet (https://www.ti.com/lit/ds/symlink/sn74abt16374a.pdf?ts=1759423616551) |  | INCLUDED | BUY (https://www.mouser.at/ProductDetail/Texas-Instruments/SN74ABT16374ADLR?qs=spW5eSrOWB6e5DUehrf92g%3D%3D)
6 | use | SN74AHC157 | MUX(Barrelshifter) | 4x2in |  | Website (https://www.ti.com/product/SN74AHC157) |  | 0.3 | AHC | 7.5ns |  | Datasheet (https://www.ti.com/lit/ds/symlink/sn74ahc157.pdf?ts=1760133933987) |  | INCLUDED | BUY (https://www.mouser.at/ProductDetail/Texas-Instruments/SN74AHC157DR?qs=nMmhAzRCgdCMVxhGfqxf9A%3D%3D)
 | use need pullup res | SN74ABT245B | Driver | 8Bit | TriState | Website (https://www.ti.com/product/SN74ABT245B) |  | 0.8USD | ABT |  |  | Datasheet (https://www.ti.com/lit/ds/symlink/sn74abt245b.pdf?ts=1760218683334) |  | INCLUDED | BUY (https://www.mouser.at/ProductDetail/Texas-Instruments/SN74ABT245BDWR?qs=afYny40WCj1jrBby8G5Ixw%3D%3D)
 | old | SN74ABT16245A | Driver | 16Bit | TriState | Website (https://www.ti.com/product/SN74ABT16245A) |  | 1.6USD | ABT |  |  | Datasheet (https://www.ti.com/lit/ds/symlink/sn74abt16245a.pdf?ts=1760218680080) |  | INCLUDED | BUY (https://www.mouser.at/ProductDetail/Texas-Instruments/SN74ABT16245ADLR?qs=vxEfx8VrU7BbFiTJWgbLWw%3D%3D)
 |  | Other
 |  | Chip Name | Chip Function |  |  | Website |  | Price | Chip Type | Propagation Delay Time
 |  | 74x153 | Multiplexer |  |  | https://www.digipart.com/part/74S153 |  | 0.35 USD | S
 |  | M20-8891045 | Pin Strip | 10pin |  |  |  |  |  |  |  | Datasheet (https://www.mouser.at/datasheet/3/71/1/M20-889.pdf) |  | NOT INCLUDED | BUY (https://www.mouser.at/ProductDetail/Harwin/M20-8891045?qs=k41KVqW3ymoWRIXfp5Ho2g%3D%3D)
 |  | M20-7911042R | Pin socket | 10pin |  |  |  |  |  |  |  | Datasheet (https://www.mouser.at/datasheet/3/71/1/M20-791R.pdf) |  | NOT INCLUDED | BUY (https://www.mouser.at/ProductDetail/Harwin/M20-7911042R?qs=k41KVqW3ymrRz%252BqhOwly6Q%3D%3D)
 |  | M20-8890845 | Pin Strip | 8pin |  |  |  |  |  |  |  | Datasheet (https://www.mouser.at/datasheet/3/71/1/M20-889.pdf) |  | INCLUDED | BUY (https://www.mouser.at/ProductDetail/Harwin/M20-8890845?qs=k41KVqW3ymqbj55BP%2FIx8Q%3D%3D)
 |  | M20-7910842R | Pin socket | 8pin |  |  |  |  |  |  |  | Datasheet (https://www.mouser.at/datasheet/3/71/1/M20-791R.pdf) |  | INCLUDED | BUY (https://www.mouser.at/ProductDetail/Harwin/M20-7910842R?qs=k41KVqW3ympJ6ZCQNkwKKw%3D%3D)
 |  | DS1100Z-20+ | Delay | 16ns |  |  |  |  | -20 | 4,8,12,16,20 |  | Datasheet (https://www.analog.com/media/en/technical-documentation/data-sheets/DS1100.pdf) |  | INCLUDED | BUY (https://www.mouser.at/ProductDetail/Analog-Devices-Maxim-Integrated/DS1100Z-20%2b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)
 | use for PSU | MPEV1D1040L6R8 | Inductor |  |  |  |  |  |  |  |  | Datasheet (https://www.mouser.at/datasheet/3/72/1/KEM_L9016_MPEV.pdf) |  | INCLUDED | BUY (https://www.mouser.at/ProductDetail/KEMET/MPEV1D1040L6R8?qs=CiayqK2gdcKA1UFpsymDIg%3D%3D)
 |  | MP2338GTL | Step-Down Converter |  |  |  |  |  |  |  |  | Datasheet (https://www.monolithicpower.com/en/documentview/productdocument/index/version/2/document_type/Datasheet/lang/en/sku/MP2338GTL) |  | INCLUDED | BUY (https://www.mouser.at/ProductDetail/Monolithic-Power-Systems-MPS/MP2338GTL-Z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)
 | use for clk delay | DS1100Z-150+ | Delay | 90ns |  |  |  |  |  |  |  | Datasheet (https://www.analog.com/media/en/technical-documentation/data-sheets/DS1100.pdf) |  | INCLUDED | BUY (https://www.mouser.at/ProductDetail/Analog-Devices-Maxim-Integrated/DS1100Z-150%2b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)
 |  | Adafruit 5807 | USB C PD Trigger board |  |  |  |  |  |  |  |  |  |  |  | BUY (https://www.mouser.at/ProductDetail/Adafruit/5807?qs=mELouGlnn3fWsy0gTsEJWw%3D%3D)
 | use for clk mux | TMUX1309DYYR | MUX CLKs |  |  |  |  |  |  |  |  | Datasheet (https://www.ti.com/lit/ds/symlink/tmux1309.pdf?ts=1764235918623) |  | INCLUDED | BUY (https://www.mouser.at/ProductDetail/Texas-Instruments/TMUX1309DYYR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)
 | use4 | 1N4148WS-7-F | diode |  |  |  |  | 0.086 |  |  |  | Datasheet (https://4donline.ihs.com/images/VipMasterIC/IC/DIOD/DIOD-S-A0001754954/DIOD-S-A0001754954-1.pdf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) |  | INCLUDED | BUY (https://www.mouser.at/ProductDetail/Diodes-Incorporated/1N4148WS-7-F?qs=4drIV0IxA0r8aNy7%2Fu4kVw%3D%3D)
 |  |  |  |  |  |  |  |  |  |  | For other socket/strips (https://www.mouser.at/c/connectors/headers-wire-housings/?mounting%20angle=Right%20Angle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)
 |  | I/O
 | State | Chip Name | Chip Function | Version |  | Website1 | Website2 | Price | Chip Type | Propagation Delay Time |  | Datasheet1 | Datasheet2 | Kicad state
 | use | SN74x540 | NOT | 8 channel |  | Website1 (https://www.ti.com/product/de-de/SN74AHC540) |  | 0.5 | AHC |  |  | Datasheet1 (https://www.ti.com/lit/ds/symlink/sn74ahc540.pdf?ts=1761241872935) |  | INCLUDED | BUY (https://eu.mouser.com/ProductDetail/Texas-Instruments/SN74AHC540DWR?qs=L4Mc90zKIpi4SuDaog6Ejw%3D%3D)
 | use | LTST-C170KFKT | LED | Orange |  |  |  |  |  |  |  | Datasheet1 (https://www.mouser.com/catalog/specsheets/Lite-On-LTST-C170KFKT.pdf) |  | INCLUDED | BUY (https://www.mouser.at/ProductDetail/LITEON/LTST-C170KFKT?qs=sGAEpiMZZMvVL5Kk7ZYykcZEi2s58B9En7hpGRVPfLI%3D)
 | use | LTST-C170KGKT | LED | Green |  |  |  |  |  |  |  | Datasheet1 (https://www.mouser.com/catalog/specsheets/Lite-On-LTST-C170KGKT.pdf) |  | INCLUDED | BUY (https://www.mouser.at/ProductDetail/LITEON/LTST-C170KGKT?qs=sGAEpiMZZMvVL5Kk7ZYykcgAqUIE7U7q7CTKtePBO7o%3D)
 | use | LTST-C170KRKT | LED | Red |  |  |  |  |  |  |  | Datasheet1 (https://www.mouser.com/catalog/specsheets/Lite-On-LTST-C170KRKT.pdf) |  | INCLUDED | BUY (https://www.mouser.at/ProductDetail/LITEON/LTST-C170KRKT?qs=sGAEpiMZZMvVL5Kk7ZYykXqPXANRkQ325sjpbimicKg%3D)
 | use | LTST-C171KSKT | LED | Yellow |  |  |  |  |  |  |  | Datasheet1 (https://www.mouser.com/catalog/specsheets/Lite-On-LTST-C171KSKT.pdf) |  | INCLUDED | BUY (https://www.mouser.at/ProductDetail/LITEON/LTST-C171KSKT?qs=sGAEpiMZZMvVL5Kk7ZYykfQIlWBvjmHcwcfZRRuiU7w%3D)
 | use | LTST-C171TBKT | LED | Blue |  |  |  |  |  |  |  | Datasheet1 (https://www.mouser.com/catalog/specsheets/Lite-On_LTST-C171TBKT.pdf) |  | INCLUDED | BUY (https://www.mouser.at/ProductDetail/LITEON/LTST-C171TBKT?qs=sGAEpiMZZMvVL5Kk7ZYykXNOjDnPJrWD0yOSCVEHjRI%3D)
8 | use | 2MS1T2B3M2QES | Flip Switch | ON-ON |  |  |  |  |  |  | Schematic wrong chngd to right | Datasheet1 (https://www.mouser.com/catalog/specsheets/Dailywell_01132020_2M_Series.pdf) |  | INCLUDED | BUY (https://www.mouser.at/ProductDetail/Dailywell/2MS1T2B3M2QES?qs=B6kkDfuK7%2FA47d%2FxOCDsrA%3D%3D)
 | use | B3FS-4055P | Push Button | OFF - (ON) |  |  |  |  |  |  |  | Datasheet1 (https://omronfs.omron.com/en_US/ecb/products/pdf/en-b3fs_4.pdf) |  | INCLUDED | BUY (https://www.mouser.at/ProductDetail/Omron-Electronics/B3FS-4055P?qs=8Kz9Wu9QwqWEoBxnkyUN7A%3D%3D)
 | use | M61P104KT20T607 | Potentiometer | 100kOhm |  |  |  |  |  |  |  | Datasheet1 (https://www.vishay.com/docs/51108/m61.pdf) |  | INCLUDED | BUY (https://www.mouser.at/ProductDetail/Vishay-Sfernice/M61P104KT20T607?qs=savM97goi5hOBnoBAJ7hyw%3D%3D)
 | possible LEDs (https://www.mouser.at/c/optoelectronics/led-lighting/leds-light-emitting-diodes/single-color-leds/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)
 | possible switches (https://eu.mouser.com/ProductDetail/TE-Connectivity-PB/A101SDCQ04?qs=qzQkFgQjdxXW%252BQKGDdgTyA%3D%3D)
