SSCsimsi/8Bit_Computer/8Bit Computer ver2.0/excel/chips availabilityOLDOLD.xlsx

 |  | Boolean Logic
Need | State | Chip Name | Chip Function | Version1 | Version2 | Website1 | Website2 | Price~ | Chip Type | Propagation Delay Time |  | Datasheet1 | Datasheet2 | Kicad state | Mouser
 | notused | 74x04 | Not | 1CH
 | use | 74x14 | Not | 6CH Schmitttrigger | 6CH Schmitttrigger | Website1 (https://www.ti.com/product/de-de/SN74LS14) | Website2 (https://www.ti.com/product/de-de/SN74HCS14) | 0.30 USD | LS/HCS |  |  | Datasheet1 (https://www.ti.com/lit/ds/symlink/sn74ls14.pdf?ts=1757172349561) | Datasheet2 (https://www.ti.com/lit/ds/symlink/sn74hcs14.pdf?ts=1757190910036) |  | BUY (https://www.mouser.at/ProductDetail/Texas-Instruments/SN74HCS14DR?qs=sPbYRqrBIVmUkCpweRJJCA%3D%3D)
 | use | 74x1G14 | Not | 1CH Schmitttrigger | 1CH Schmitttrigger | Website1 (https://www.ti.com/product/de-de/SN74AHC1G14) | Website2 (https://www.ti.com/product/de-de/SN74LVC1G14) | 0.30 USD | AHC/LVC |  |  | Datasheet1 (https://www.ti.com/lit/ds/symlink/sn74ahc1g14.pdf?ts=1757172131384) | Datasheet2 (https://www.ti.com/lit/ds/symlink/sn74lvc1g14.pdf?ts=1757172154130) |  | BUY (https://www.mouser.at/ProductDetail/Texas-Instruments/SN74LVC1G14DBVR?qs=dT9u2OTAaVWRIgCrQFnxuQ%3D%3D)
 | use | 74x08 | And | 4x 2input | 4x 2input Schmittt | Website1 (https://www.ti.com/product/SN74HC08) | Website2 (https://www.ti.com/product/SN74HCS08) | 0.30 USD | HC/HCS |  |  | Datasheet1 (https://www.ti.com/lit/ds/symlink/sn74hc08.pdf?ts=1757190110676) | Datasheet2 (https://www.ti.com/lit/ds/symlink/sn74hcs08.pdf?ts=1757190317977) |  | BUY (https://www.mouser.at/ProductDetail/Texas-Instruments/SN74HCS08DR?qs=7MVldsJ5UaxBpqBusi11%2Fg%3D%3D)
 | use | 74x32 | Or | 4x 2input | 4x 2input Schmittt | Website1 (https://www.ti.com/product/SN74HC32) | Website2 (https://www.ti.com/product/SN74HCS32) | 0.30 USD | HC/HCS |  |  | Datasheet1 (https://www.ti.com/lit/ds/symlink/sn74hc32.pdf?ts=1757190561557) | Datasheet2 (https://www.ti.com/lit/ds/symlink/sn74hcs32.pdf?ts=1757190458236) |  | BUY (https://www.mouser.at/ProductDetail/Texas-Instruments/SN74HCS32DR?qs=7MVldsJ5Uay%2FXLwyM20zFg%3D%3D)
 | use | 74x86 | Xor | 4x 2input | 4x 2input Schmittt | Website1 (https://www.ti.com/product/de-de/SN74HC86) | Website2 (https://www.ti.com/product/de-de/SN74HCS86) | 0.30 USD | HC/HCS |  |  | Datasheet1 (https://www.ti.com/lit/ds/symlink/sn74hc86.pdf?ts=1757189010256) | Datasheet2 (https://www.ti.com/lit/ds/symlink/sn74hcs86.pdf?ts=1757189011902) |  | BUY (https://www.mouser.at/ProductDetail/Texas-Instruments/SN74HCS86DR?qs=7MVldsJ5Uax3N1HpQm%2FwtA%3D%3D)
6 | use as 8in or | 74x4075 | Or | 3x 3input | 3x 3input Schmittt | Website1 (https://www.ti.com/product/CD74HC4075) | Website2 (https://www.ti.com/product/SN74HCS4075) | 0.30 USD | HC/HCS |  |  | Datasheet1 (https://www.ti.com/lit/ds/symlink/cd74hc4075.pdf?ts=1757183417815) | Datasheet2 (https://www.ti.com/lit/ds/symlink/sn74hcs4075.pdf?ts=1757186975519) |  | BUY (https://www.mouser.at/ProductDetail/Texas-Instruments/SN74HCS4075DR?qs=sPbYRqrBIVmdJ91ff%252BdGMg%3D%3D)
2 | use for 8in or | 74x1G32 | Or | 1CH | 1CH | Website1 (https://www.ti.com/product/SN74AHC1G32) | Website2 (https://www.ti.com/product/SN74LVC1G32) | 0.30 USD | AHC/LVC |  |  | Datasheet1 (https://www.ti.com/lit/ds/symlink/sn74ahc1g32.pdf?ts=1757188663895) | Datasheet2 (https://www.ti.com/lit/ds/symlink/sn74lvc1g32.pdf?ts=1757172239914) |  | BUY (https://www.mouser.at/ProductDetail/Texas-Instruments/SN74LVC1G32DBVR?qs=3pnr37ZAbK%2F6ArGi%2FPb2Ng%3D%3D)
 |  | General Logic
 | State | Chip Name | Chip Function | Version |  | Website1 | Website2 | Price | Chip Type | Propagation Delay Time |  | Datasheet1 | Datasheet2 | Kicad state
 | old | 74x85 | Comparator | 8Bit |  | Website (https://www.mouser.at/ProductDetail/Texas-Instruments/SN74LS85N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) |  | 1.44 EUR | LS
 | old | 74x682 | Comparator | 8Bit |  | Website (https://www.digikey.at/en/products/base-product/texas-instruments/296/74LS682/21135) |  | 2.57 EUR | LS
 | old | 74x518 | Comparator | 8Bit |  | Website (https://www.ti.com/product/SN74ALS518/part-details/SN74ALS518N) |  | 10.166 USD | ALS
 | use | 74x688 | Comparator | 8Bit nex | 8Bit ti | Website1 (https://www.nexperia.com/product/74HC688D) | Website2 (https://www.ti.com/product/de-de/CD74HC688) | 0.5 EUR | HC |  |  | Datasheet1 (https://assets.nexperia.com/documents/data-sheet/74HC688.pdf) | Datasheet2 (https://www.ti.com/lit/ds/symlink/cd74hc688.pdf?ts=1757335819558) |  | BUY (https://www.mouser.at/ProductDetail/Nexperia/74HC688D653?qs=P62ublwmbi%252BZYv%2F8J45taw%3D%3D)
 | Looking for replacement | 74x323 | Shift Register | 8Bit |  | Website1 (https://www.ti.com/product/SN74ALS323) | Website2 (https://www.ti.com/product/CD74AC323) | 11USD/0.7USD | ALS/AC |  |  | Datasheet1 (https://www.ti.com/lit/ds/symlink/sn54als323.pdf?ts=1756926622365f?ts=1756926622365) | Datasheet2 (https://www.ti.com/lit/ds/symlink/cd74ac323.pdf?ts=1757345595129)
1 | for Shift reg | SN74x4051 | MUX | 8Bit |  | Website (https://www.ti.com/product/SN74LV4051A) |  |  | LV |  |  | Datasheet (https://www.ti.com/lit/ds/symlink/sn74lv4051a.pdf?ts=1759374886404) |  |  | BUY (https://www.mouser.at/ProductDetail/Texas-Instruments/SN74LV4051ADR?qs=8Pd2FuFSoMHt2f%2FU0%252B0rVg%3D%3D)
 | old | CD74x4051 | Multiplexer | 8Bit |  | Website (https://www.ti.com/product/CD74HC4051) |  |  | HCT/HC |  | fall rise | Datasheet (https://www.ti.com/lit/ds/symlink/cd74hc4051.pdf?ts=1756999873621)
 | old | 74x194 | Shift Register | 4Bit |  | Website (https://www.ti.com/product/SN74AS194) |  | 3.68 USD | AS
 | old | 74x83 | Adder | 4Bit |  | Not available |  | - | -
 | use as 4Bit+3B+2B+1B | 74x283 | Adder | 4Bit |  | Website1 (https://www.ti.com/product/de-de/SN74S283) | Website2 (https://www.ti.com/product/de-de/SN74F283) | 8.295 EUR/ 1EUR | S/F |  |  | Datasheet1 (https://www.ti.com/lit/ds/symlink/sn74s283.pdf?ts=1757168041261) | Datasheet2 (https://www.ti.com/lit/ds/symlink/sn74f283.pdf?ts=1757344110529) |  | BUY (https://www.mouser.at/ProductDetail/Texas-Instruments/SN74F283D?qs=RnzODY3cU8t9RP7%252BwWjEZw%3D%3D)
 | old | 74x183 | 2 Half Adders |  |  | Not available |  | - | -
 | old | 74x80 | 2 Half Adders |  |  | Not many sources |  | ? | LS
 | old | 74x885 | Comparator | 8Bit |  |  |  |  | AS |  | would need a nor as the output
 | old | 74x795 | Buffer/Driver | 8Bit |  |  |  |  | LS | 15ns
 |  | Storage
 | State | Chip Name | Chip Function |  |  | Website |  | Price | Chip Type | Read speed | Info | Datasheet
 | old | AT28C64B | EEPROM | 64Kbit (8Kbit x 8) |  | Website (https://www.microchip.com/en-us/product/AT28C64B) |  |  |  | 150ns |  | Datasheet (https://ww1.microchip.com/downloads/aemDocuments/documents/MPD/ProductDocuments/DataSheets/AT28C64B-64-Kbit-8Kx8-Parallel-EEPROM-with-Page-Write-and-Software-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)
 | use | IS62C1024 | SRAM | 1Mb (128Kbit x 8) |  | Website (https://www.issi.com/WW/pdf/62-65C1024AL.pdf) |  | ~2USD |  | 35ns/45ns |  | Datasheet (https://www.issi.com/WW/pdf/62-65C1024AL.pdf) |  |  | BUY (https://www.mouser.at/ProductDetail/ISSI/IS62C1024AL-35QLI-TR?qs=tFgq3%2FJV4HgOUVNChCblDw%3D%3D)
3 | use | SST39xFxxxx | NORFlash | 1-8Mb |  | Website (https://www.microchip.com/en-us/parametric-search/600) |  | ~2USD |  | 55ns | 1xAdress, 1xData, 1xCommands | Datasheet (https://www.mouser.at/datasheet/3/282/1/25041A.pdf) |  |  | BUY (https://www.mouser.at/ProductDetail/Microchip-Technology/SST39LF802C-55-4C-EKE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)
3 | old | SN74HCS273 | Register | Octal Dlatch |  | Website (https://www.ti.com/product/SN74HCS273) |  | 0.5 |  |  |  | Datasheet (https://www.ti.com/lit/ds/symlink/sn74hcs273.pdf?ts=1759408082671) |  |  | BUY (https://www.mouser.at/ProductDetail/Texas-Instruments/SN74HCS273PWR?qs=QNEnbhJQKvYIJo9rBWLKyw%3D%3D)
3 | mby | SN74HCS574 | Register | Octal Dlatch | TriState | Website (https://www.ti.com/product/SN74HCS574) |  | 0.4 |  |  |  | Datasheet (https://www.ti.com/lit/ds/symlink/sn74hcs74.pdf?ts=1759421989098) |  |  | BUY (https://www.mouser.at/ProductDetail/Texas-Instruments/SN74HCS574DGSR?qs=3Rah4i%252BhyCHGg6B36IqQww%3D%3D)
 | use | SN74HCS74 | Dlatch | 2x |  | Website (https://www.ti.com/product/SN74HCS74) |  | 0.2 |  |  |  | Datasheet (https://www.ti.com/lit/ds/symlink/sn74hcs74.pdf?ts=1759421989098) |  |  | BUY (https://www.mouser.at/ProductDetail/Texas-Instruments/SN74HCS74DR?qs=TiOZkKH1s2QvGxo75w4r5Q%3D%3D)
9 | need Invert for clk | 74x821 | Buffer | 10Bit | TriState | Website (https://www.ti.com/product/de-de/SN74ABT821A) |  |  | AS |  |  | Datasheet (https://www.ti.com/lit/ds/symlink/sn74abt821a.pdf?ts=1757008739474) |  |  | BUY (https://www.mouser.at/ProductDetail/Texas-Instruments/SN74ABT821ADWR?qs=FM6NhYOeeBXxX%2Fnpl0SzFQ%3D%3D)
 | use need Invert for clk | SN74ABT16374A | Buffer | 16Bit | TriState | Website (https://www.ti.com/product/de-de/SN74ABT16374A) |  | 1.6EUR |  |  |  | Datasheet (https://www.ti.com/lit/ds/symlink/sn74abt16374a.pdf?ts=1759423616551) |  |  | BUY (https://www.mouser.at/ProductDetail/Texas-Instruments/SN74ABT16374ADLR?qs=spW5eSrOWB6e5DUehrf92g%3D%3D)
 |  | Other
 |  | Chip Name | Chip Function |  |  | Website |  | Price | Chip Type | Propagation Delay Time
 |  | 74x153 | Multiplexer |  |  | https://www.digipart.com/part/74S153 |  | 0.35 USD | S
