SSCsimsi/8Bit_Computer/parts/symbolsandfootprints_kicad/74HC04D_653/74HC04D_653.step

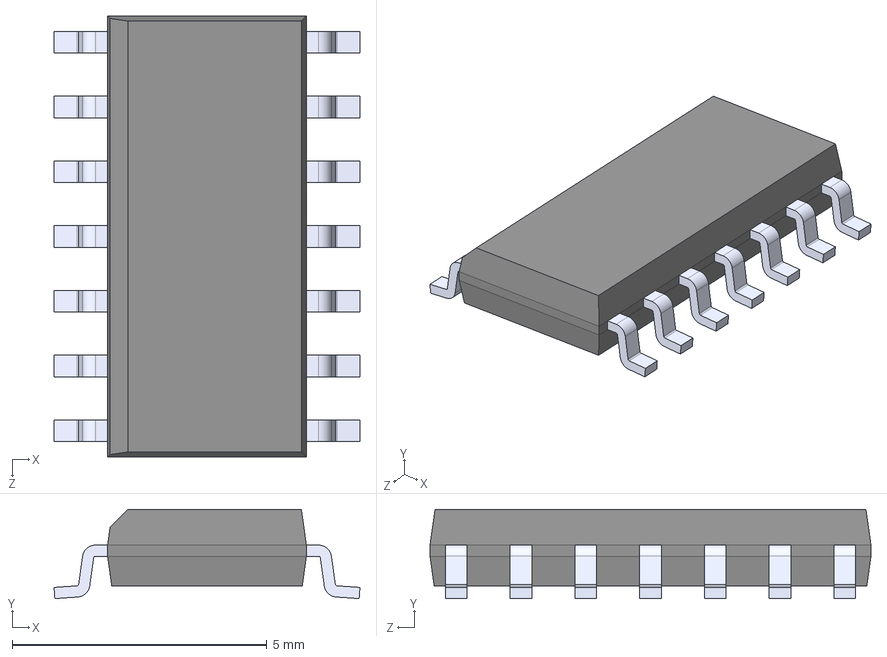
[picture p163: CAD file, 2024-05-31]
parts/symbolsandfootprints_kicad/74HC04D_653/74HC04D_653.step
6.00 x 1.75 x 8.65 mm
