SSCsimsi/8Bit_Computer/parts/symbolsandfootprints_kicad/AT28C64B-15PU/AT28C64B-15PU.step

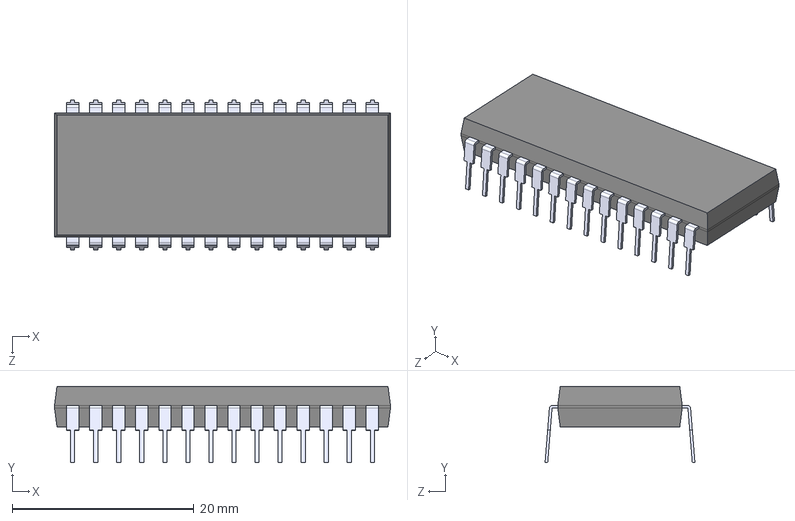
[picture p164: CAD file, 2024-05-31]
parts/symbolsandfootprints_kicad/AT28C64B-15PU/AT28C64B-15PU.step
37.0 x 8.38 x 16.5 mm
