SSCsimsi/8Bit_Computer/parts/symbolsandfootprints_kicad/CD4072BM/CD4072BM.step

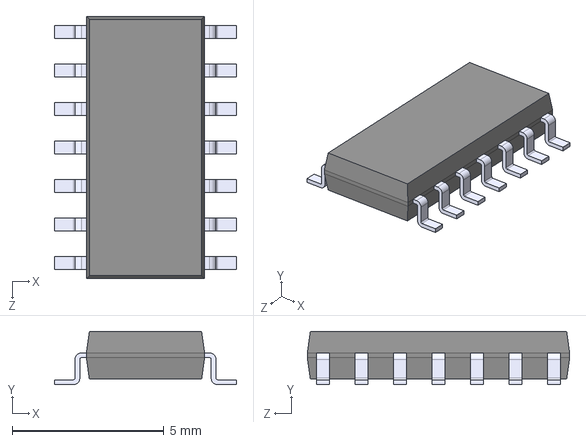
[picture p165: CAD file, 2024-05-31]
parts/symbolsandfootprints_kicad/CD4072BM/CD4072BM.step
6.00 x 1.75 x 8.65 mm
