SSCsimsi/8Bit_Computer/parts/symbolsandfootprints_kicad/SN74AHC1G08DCKR/SN74AHC1G08DCKR.step

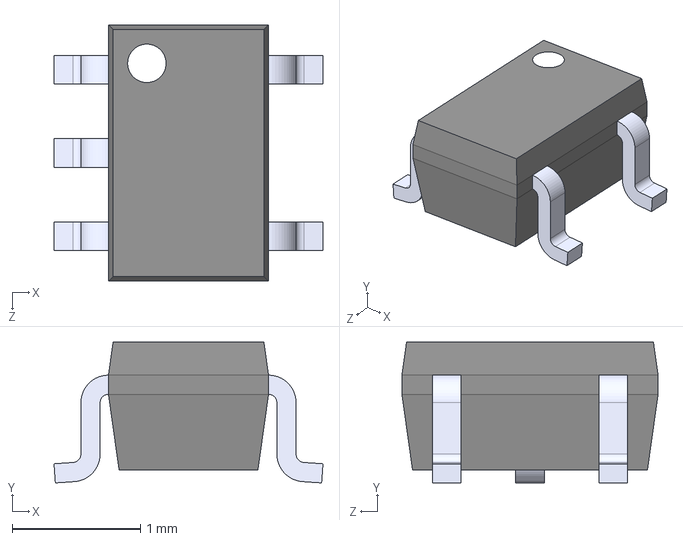
[picture p166: CAD file, 2024-05-31]
parts/symbolsandfootprints_kicad/SN74AHC1G08DCKR/SN74AHC1G08DCKR.step
2.10 x 1.10 x 2.00 mm
