SSCsimsi/8Bit_Computer/parts/symbolsandfootprints_kicad/SN74AHC1G14DBVR/SN74AHC1G14DBVR.step

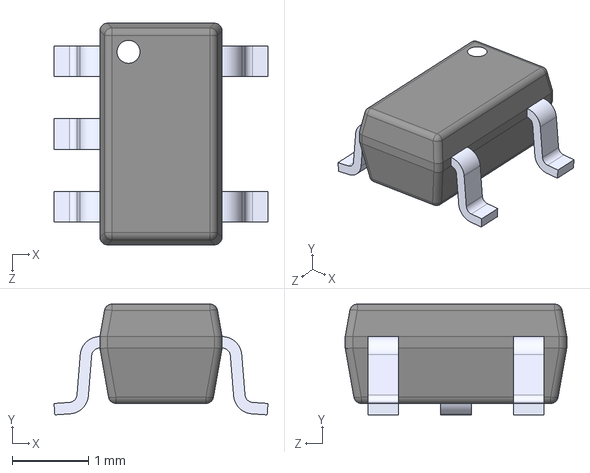
[picture p167: CAD file, 2024-05-31]
parts/symbolsandfootprints_kicad/SN74AHC1G14DBVR/SN74AHC1G14DBVR.step
2.80 x 1.45 x 2.90 mm
