SSCsimsi/8Bit_Computer/parts/symbolsandfootprints_kicad/SN74HC193D/SN74HC193D.step

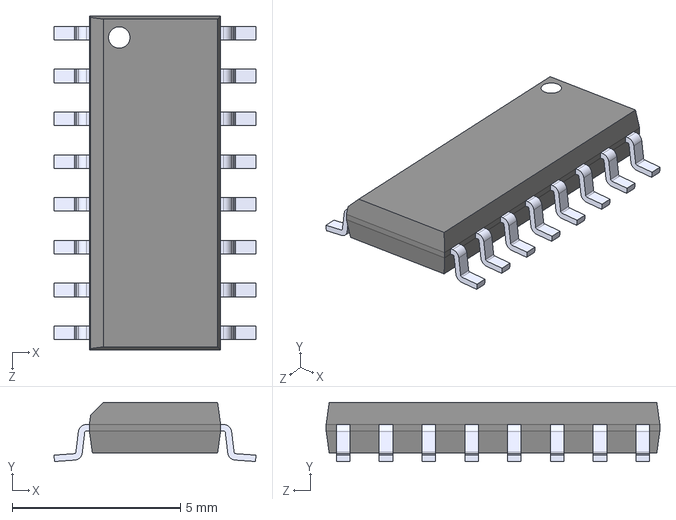
[picture p168: CAD file, 2024-05-31]
parts/symbolsandfootprints_kicad/SN74HC193D/SN74HC193D.step
5.99 x 1.75 x 9.91 mm
