SSCsimsi/8Bit_Computer/parts/symbolsandfootprints_kicad/SN74LVC1G332DCKR/SN74LVC1G332DCKR.step

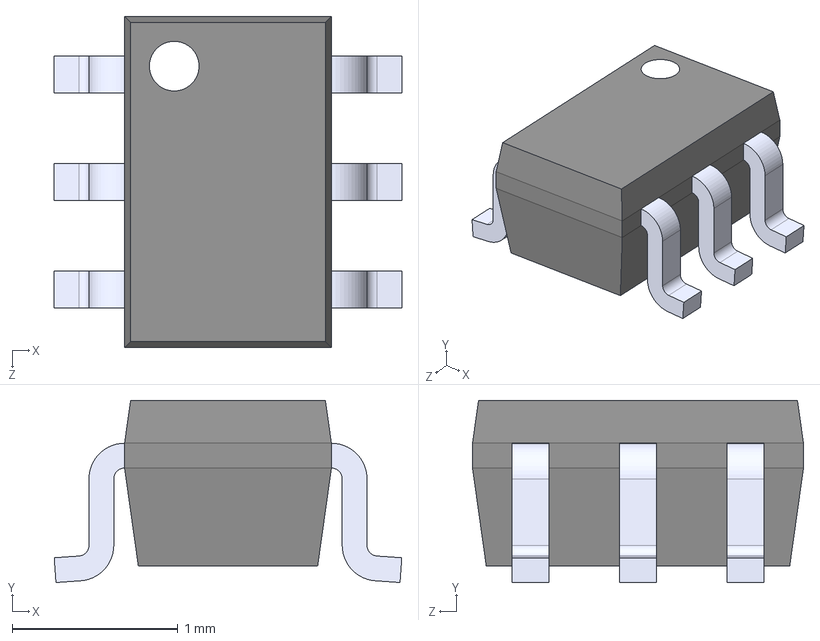
[picture p169: CAD file, 2024-05-31]
parts/symbolsandfootprints_kicad/SN74LVC1G332DCKR/SN74LVC1G332DCKR.step
2.10 x 1.10 x 2.00 mm
