SSCsimsi/8Bit_Computer/parts/symbolsandfootprints_kicad/MOLEX_39281023/39281023.step

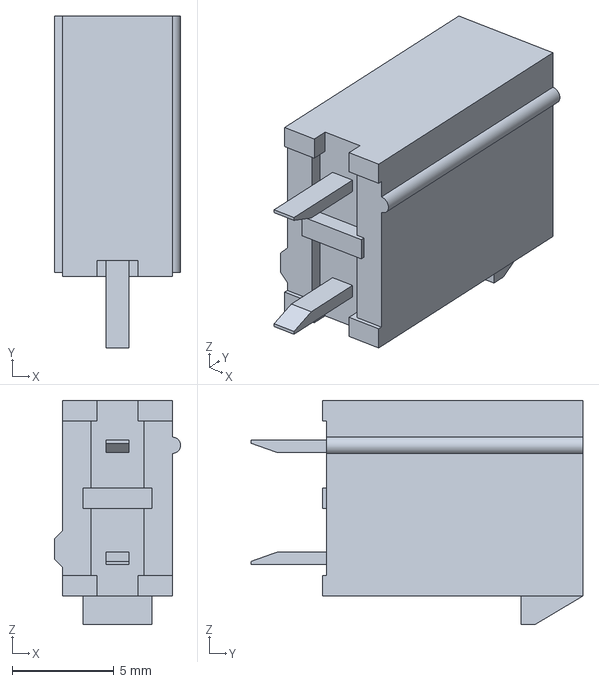
[picture p170: CAD file, 2024-05-31]
parts/symbolsandfootprints_kicad/MOLEX_39281023/39281023.step
6.20 x 16.3 x 11.0 mm
