SSCsimsi/8Bit_Computer/parts/symbolsandfootprints_kicad/MOLEX_39281103/39281103.step

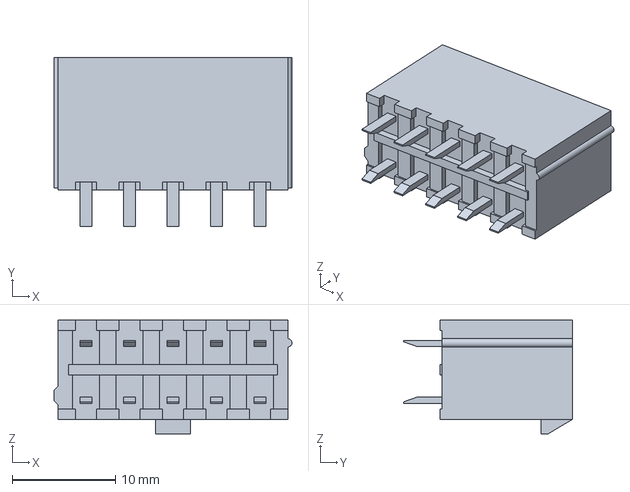
[picture p171: CAD file, 2024-05-31]
parts/symbolsandfootprints_kicad/MOLEX_39281103/39281103.step
23.0 x 16.3 x 11.0 mm
