SSCsimsi/8Bit_Computer/parts/symbolsandfootprints_kicad/MOLEX_39281183/39281183.step

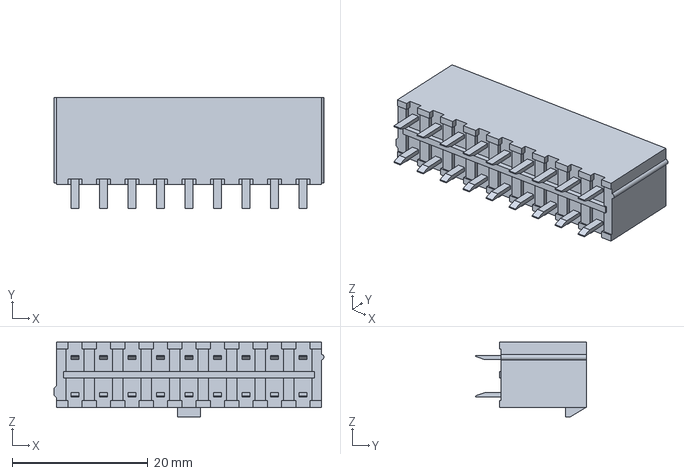
[picture p172: CAD file, 2024-05-31]
parts/symbolsandfootprints_kicad/MOLEX_39281183/39281183.step
39.8 x 16.3 x 11.0 mm
