SSCsimsi/8Bit_Computer/parts/symbolsandfootprints_kicad/MOLEX_39281243/39281243.step

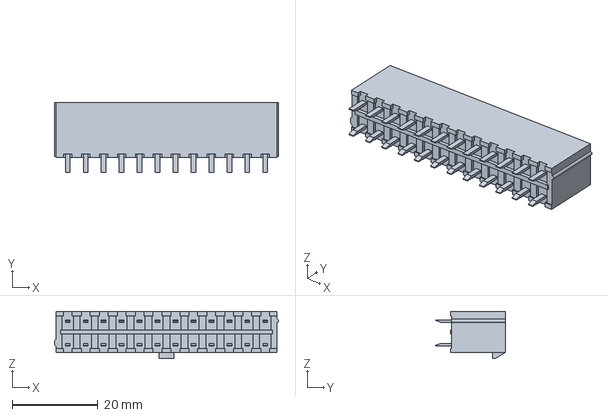
[picture p173: CAD file, 2024-05-31]
parts/symbolsandfootprints_kicad/MOLEX_39281243/39281243.step
52.4 x 16.3 x 11.0 mm
