SSCsimsi/8Bit_Computer/parts/symbolsandfootprints_kicad/MOLEX_39303035/39303035.step

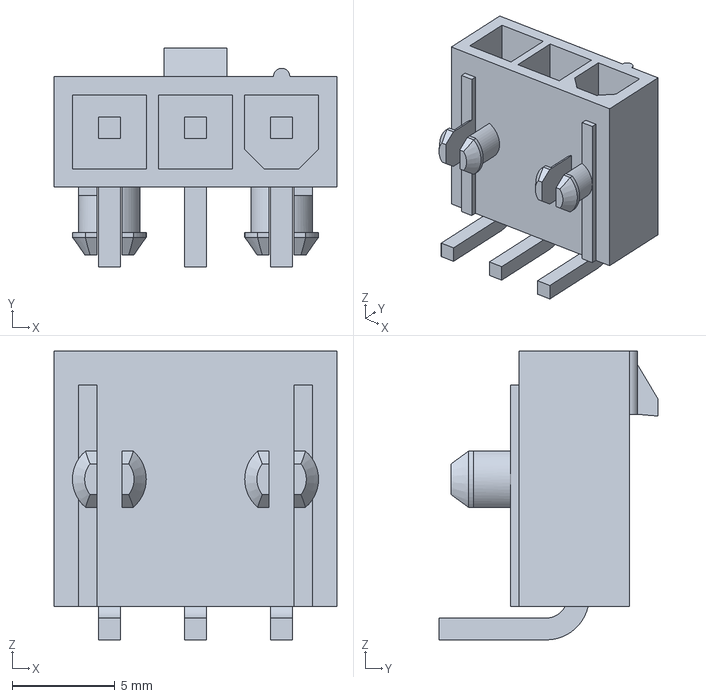
[picture p174: CAD file, 2024-05-31]
parts/symbolsandfootprints_kicad/MOLEX_39303035/39303035.step
13.8 x 10.7 x 14.1 mm
