SSCsimsi/8Bit_Computer/8Bit Computer ver2.0/programmes/test/test.txt

 LN  CMD DAT ADR
0000 NOP 
0001 STR FB 0001
0002 LD     0001
0003 STA 
0004 STB 07	 //A:FB, B:06
0005 ADD 	 
0006 STB 	 //A:FB, B:02, C8:high
0007 ADC	 
0008 STC	 //C:FE, C8:low
0009 INC	 
000A STA
000B STB FF	 //A:FF, B:FF
000C CPE 	 
000D STS
000E STA 01	 //SHIFT DIST:01, A:01
000F SFC	 
0010 STC	 //C:80
0011 DEC
0012 STA
0013 STB 7E	 //A:7F, B:7E
0014 CPB
0015 STA	 //A:01
0016 CPS
0017 STF	 //C8:high
0018 LCR	 /* load carry flag */
0019 STA	 //A:01
001A BWN	 /* bitwise not */
001B STA
001C STS 03	 //A:FE, SHIFT DIST:03
001D SFT
001E STA	 //A:1F
001F LDF
0020 STC	 //C:01
0021 INC
0022 STF	 //C8:low, Ovf:high
0023 LDO
0024 STB	 //A:1F, B:02
0025 SUB
0026 STA	 //A:1D
0027 LDA
0028 BIN	 /* binary not */
0029 CJP    002B /* conditional jump */
002A STB 01
002B NOP
002C LDB	 // should be 02
002D BIO	 /* binary or */
002E STA	 //A:01
002F BIA	 /* binary and */
0030 STA	 //A:01
0031 STB 00	 //B:00
0032 BIX	 /* binary xor */
0033 STA	 //A:01
0034 BWA	 /* bitwise and */
0035 CJP    0037
0036 STA 0F
0037 NOP
0038 BWN	 /* bitwise not */
0039 STA	 //A:F0
003A STB 0F
003B BWO	 /* bitwise or */
003C STA	 //A:FF
003D STB AA	 //B:AA
003E BWX	 /* bitwise xor */
003F STC	 //C:55
0040 LDC
0041 STS	 //SHIFT DIST:55
0042 LDS	 /* load shift distance */
0043 ST1	 /* store interface reg1 */ //INT REG1:55
0044 LDS
0045 ST2	 //INT REG2:55
0046 STR 42 5555
0047 STO AA	 /* store outputs */ //OUT:AA
0048 LDO	 /* load outputs */
0049 STA	 //A:AA
004A NOP
004B BIX
004C CJP    004A /* keep looping */
004D LTA	 /* load to address */ //should be 5555
004E LD 	 //should work, since the address is hopefully still on the bus
004F STO	 //OUT:42
0050 NOP	 //for the loop to repeat starting from here, from now on, it is possible to enter values, which will be written to the output
0051 LDU	 /* load unread */
0052 STA
0053 BIN
0054 CJP    0057
0055 LDI	 /* load inputs */
0056 STO
0057 NOP
0058 JMP    0050
