SSCsimsi/8Bit_Computer/Documentation/Thesis Documentation/8Bit Computer ESD Schutz.pdf

49,39

69,39

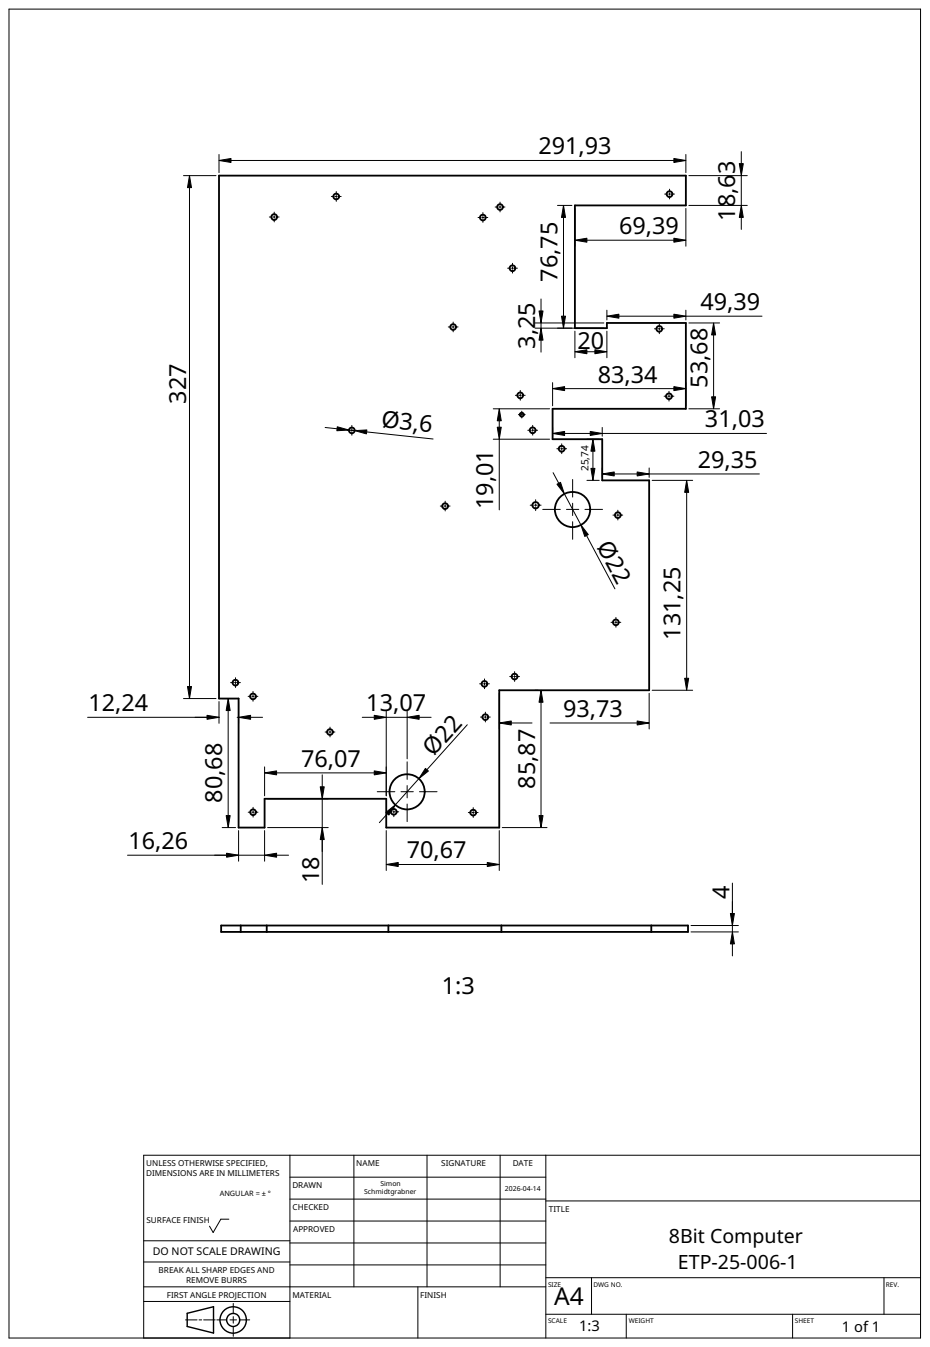
[picture p175: page 1]
MATERIAL; FINISH

UNLESS OTHERWISE SPECIFIED, DIMENSIONS ARE IN MILLIMETERS ANGULAR = ± ° SURFACE FINISH | | NAME | SIGNATURE | DATE

DRAWN | Simon Schmidtgrabner | | 2026-04-14

CHECKED | | | | TITLE 8Bit Computer ETP-25-006-1

APPROVED

DO NOT SCALE DRAWING
BREAK ALL SHARP EDGES AND
REMOVE BURRS
FIRST ANGLE PROJECTION

SIZE A4 | DWG NO. | REV.

SCALE 1:3 | WEIGHT | SHEET 1 of 1
