SSCsimsi/8Bit_Computer/8Bit Computer ver2.0/Kicad/Computer/8Bit_Computer_SCH_V2.7.pdf

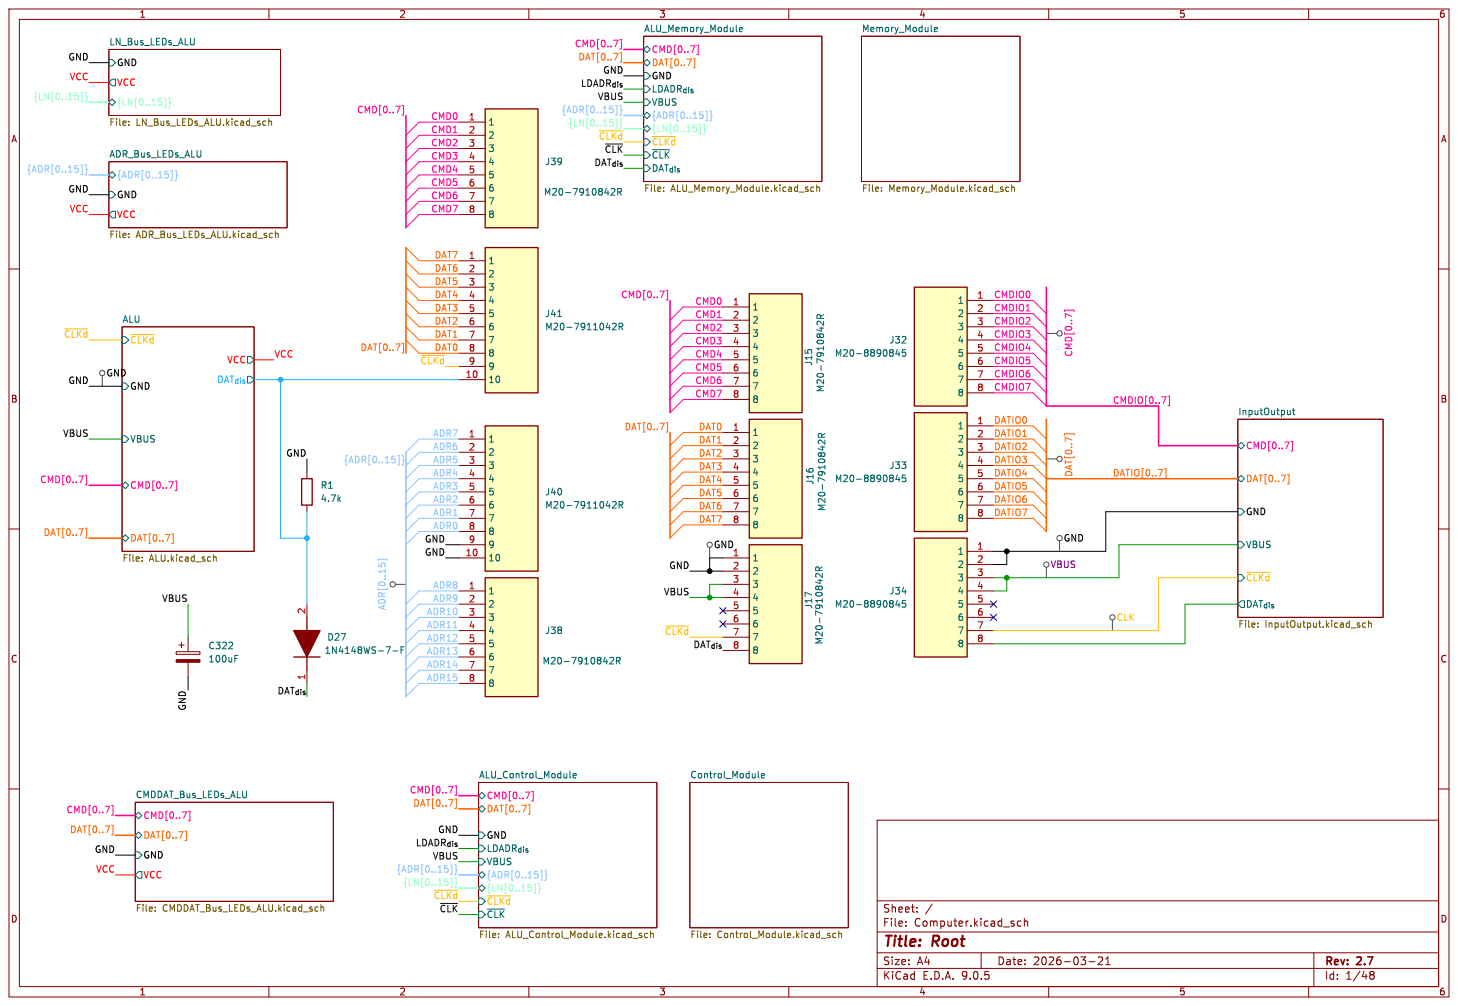
[picture p176: page 1]

Id: 1/48 Title: Root File: Computer.kicad_sch Sheet: /

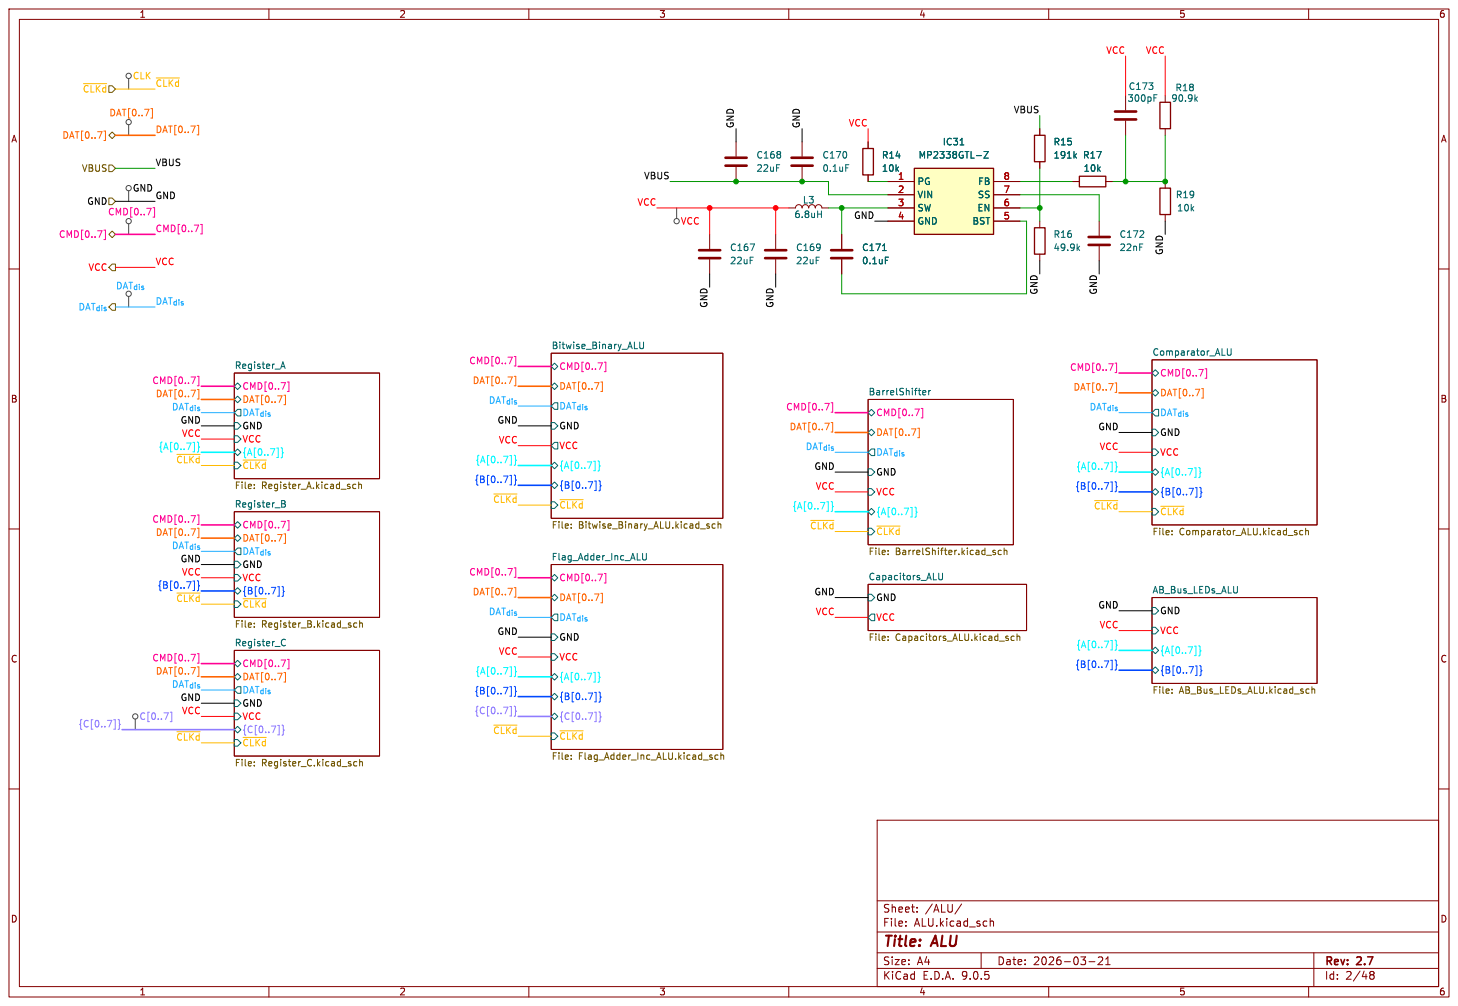
[picture p177: page 2]

VCC
~{CLKd} BarrelShifter File: BarrelShifter.kicad_sch C170

CMD[0..7]
DAT[0..7]
DAT_{dis} GND
File: ALU.kicad_sch Sheet: /ALU/ GND

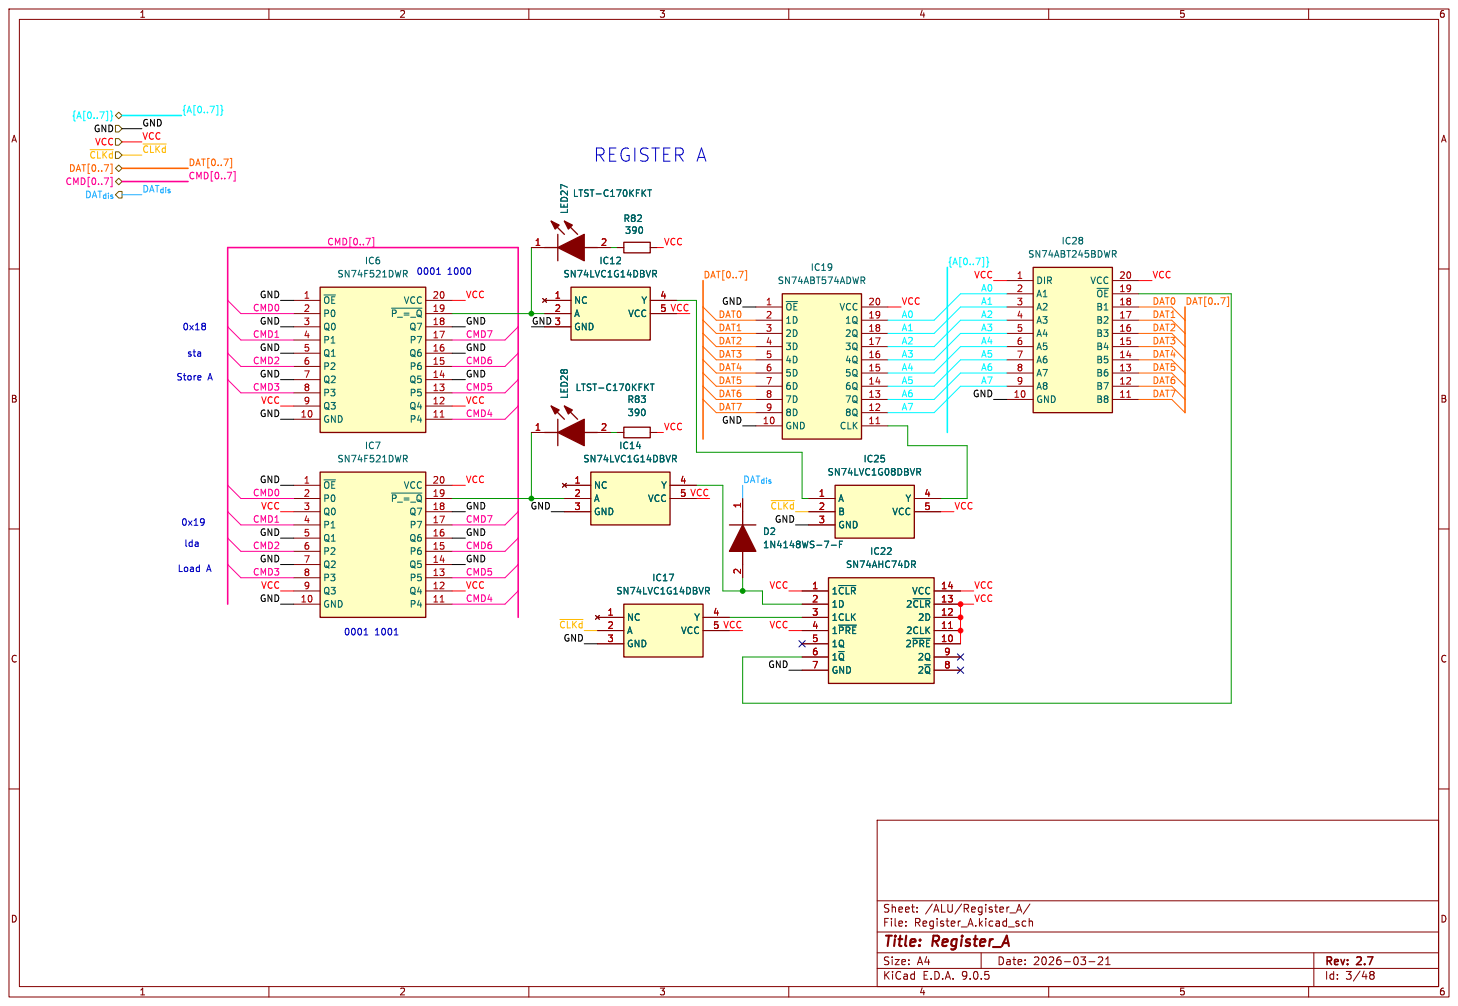
[picture p178: page 3]

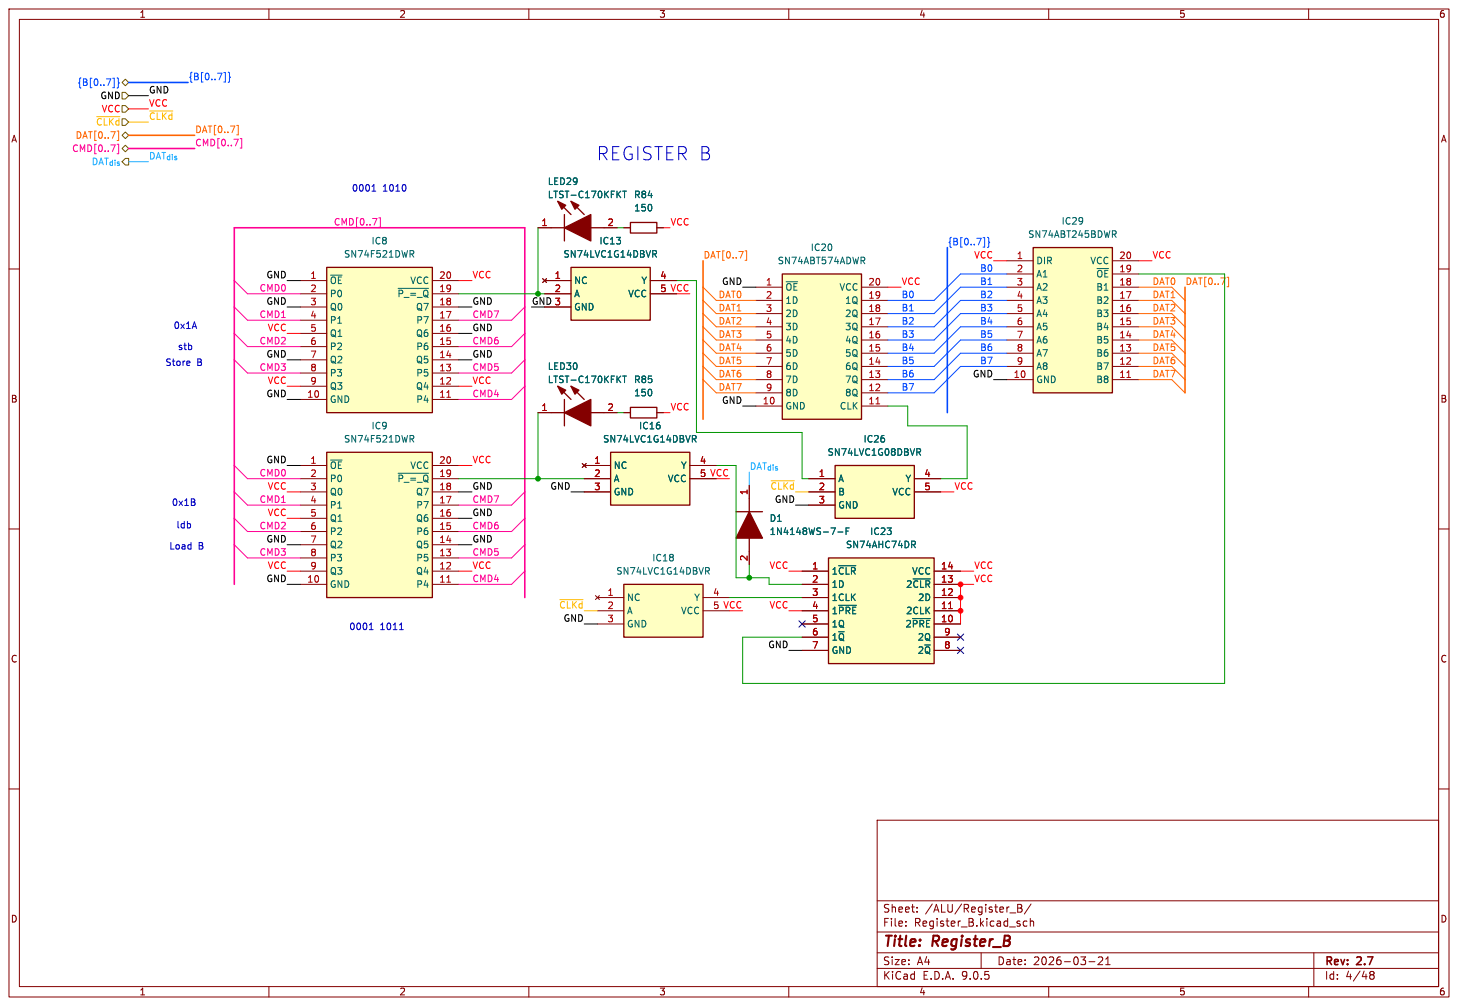
[picture p179: page 4]

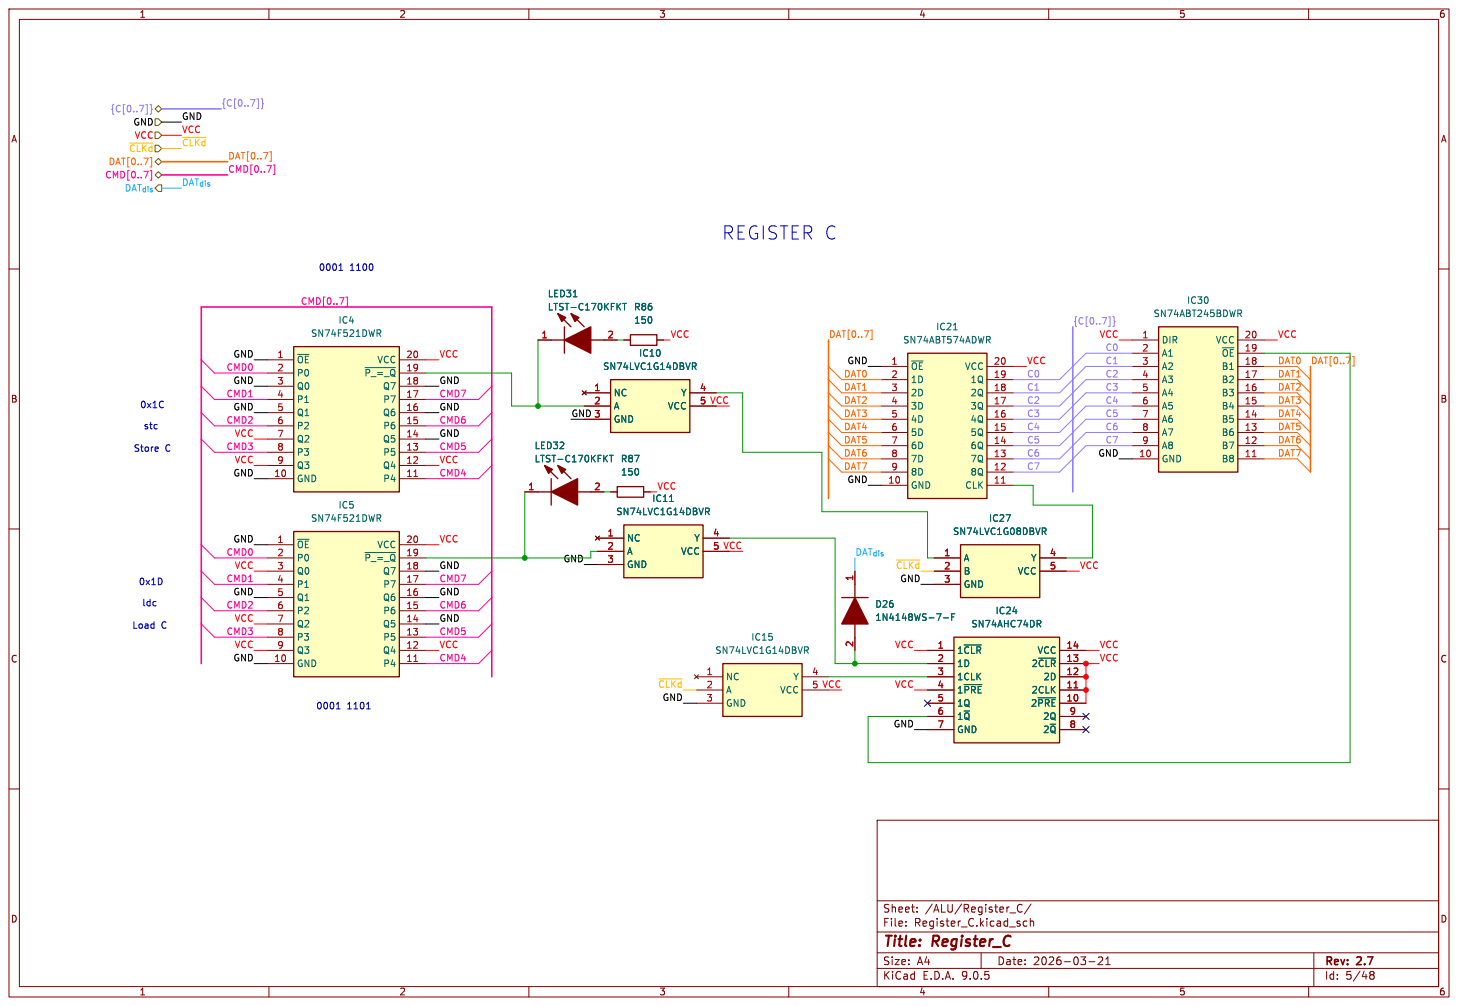
[picture p180: page 5]

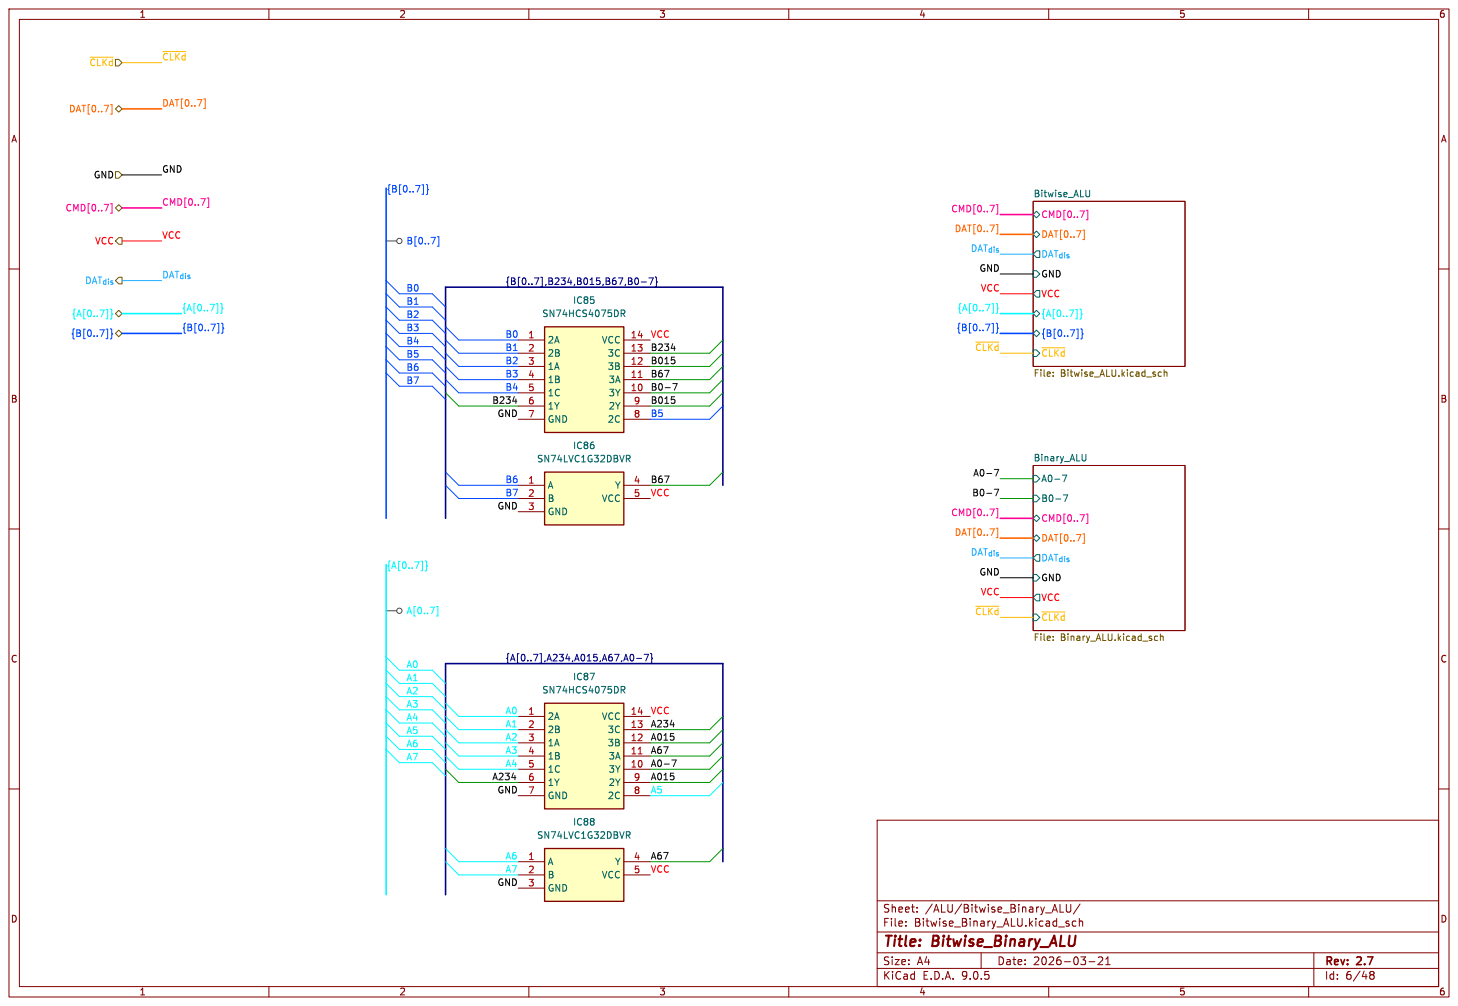
[picture p181: page 6]

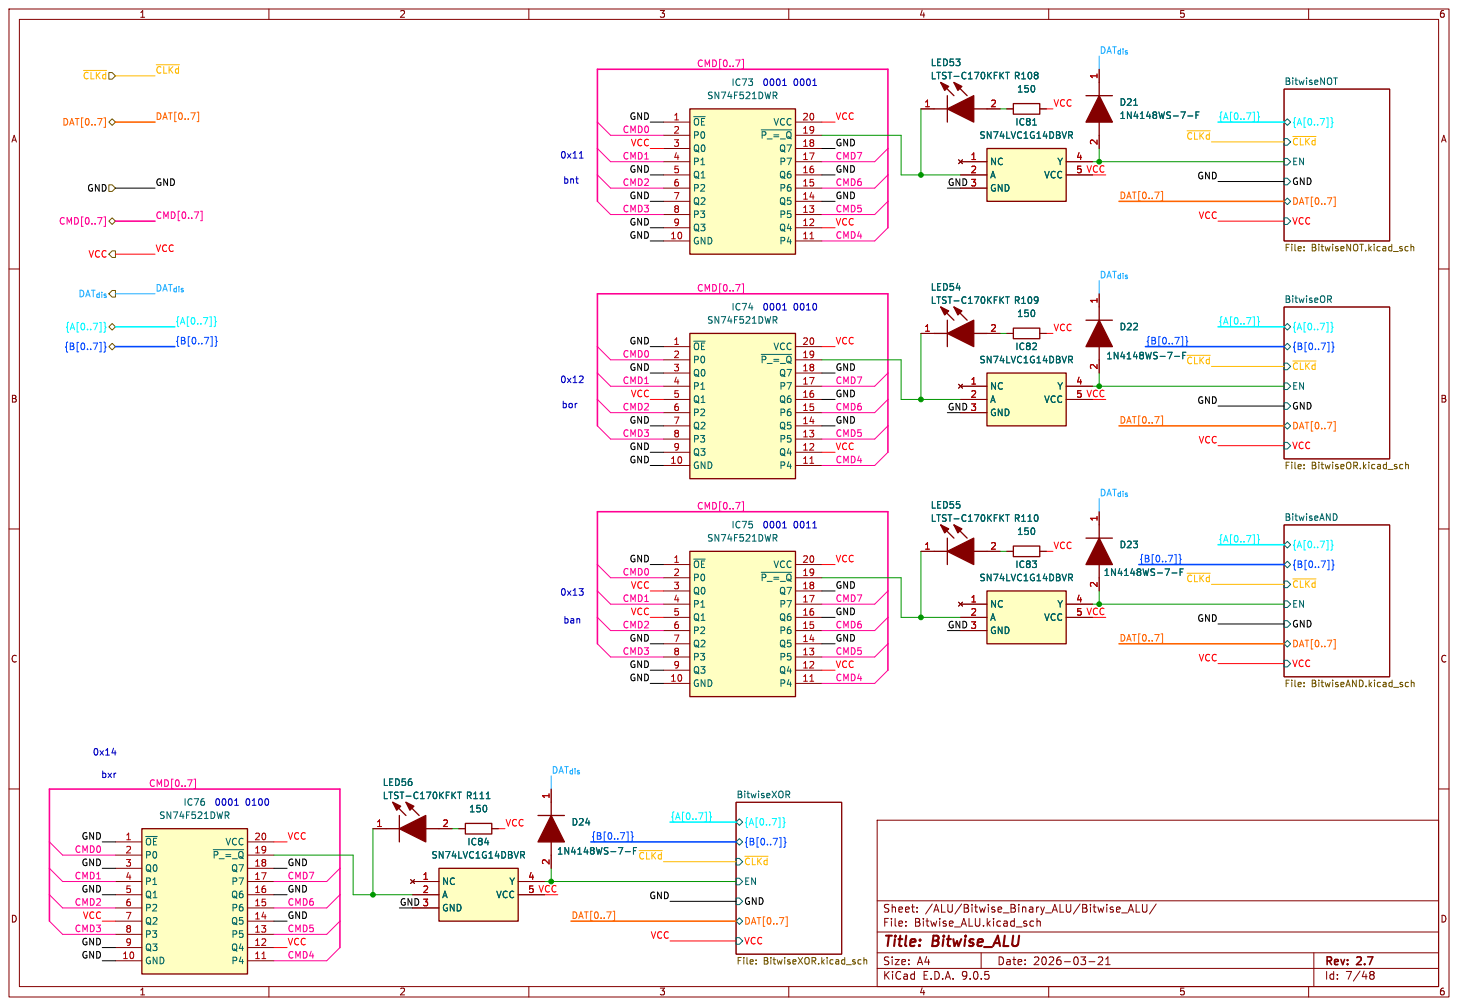
[picture p182: page 7]

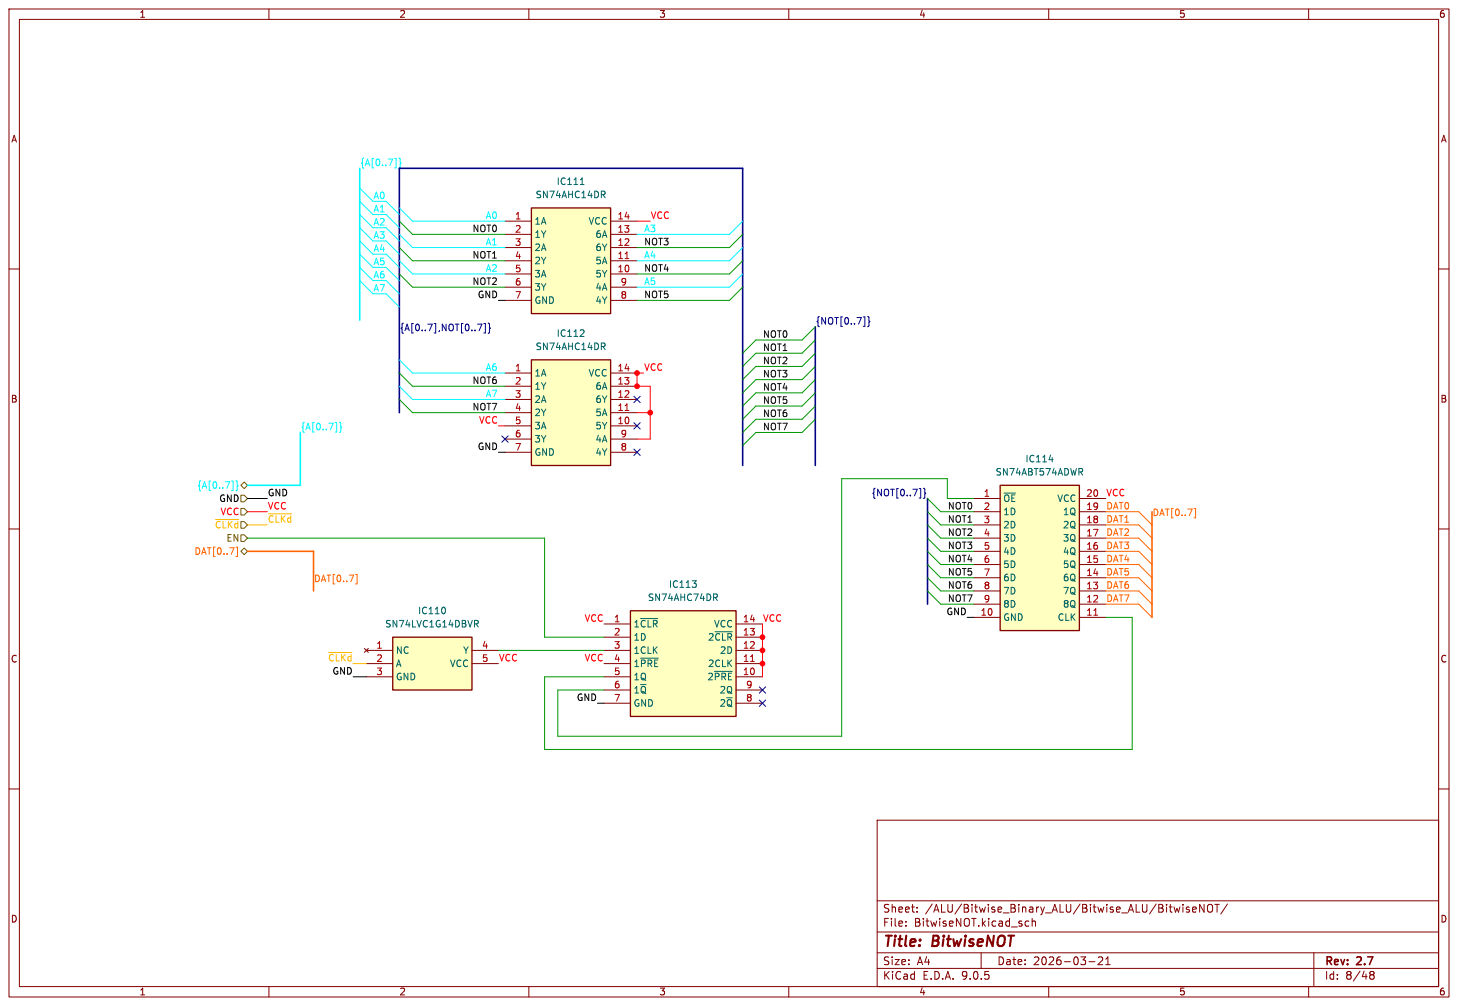
[picture p183: page 8]

File: BitwiseNOT.kicad_sch Sheet: /ALU/Bitwise_Binary_ALU/Bitwise_ALU/BitwiseNOT/
Id: 8/48 Title: BitwiseNOT

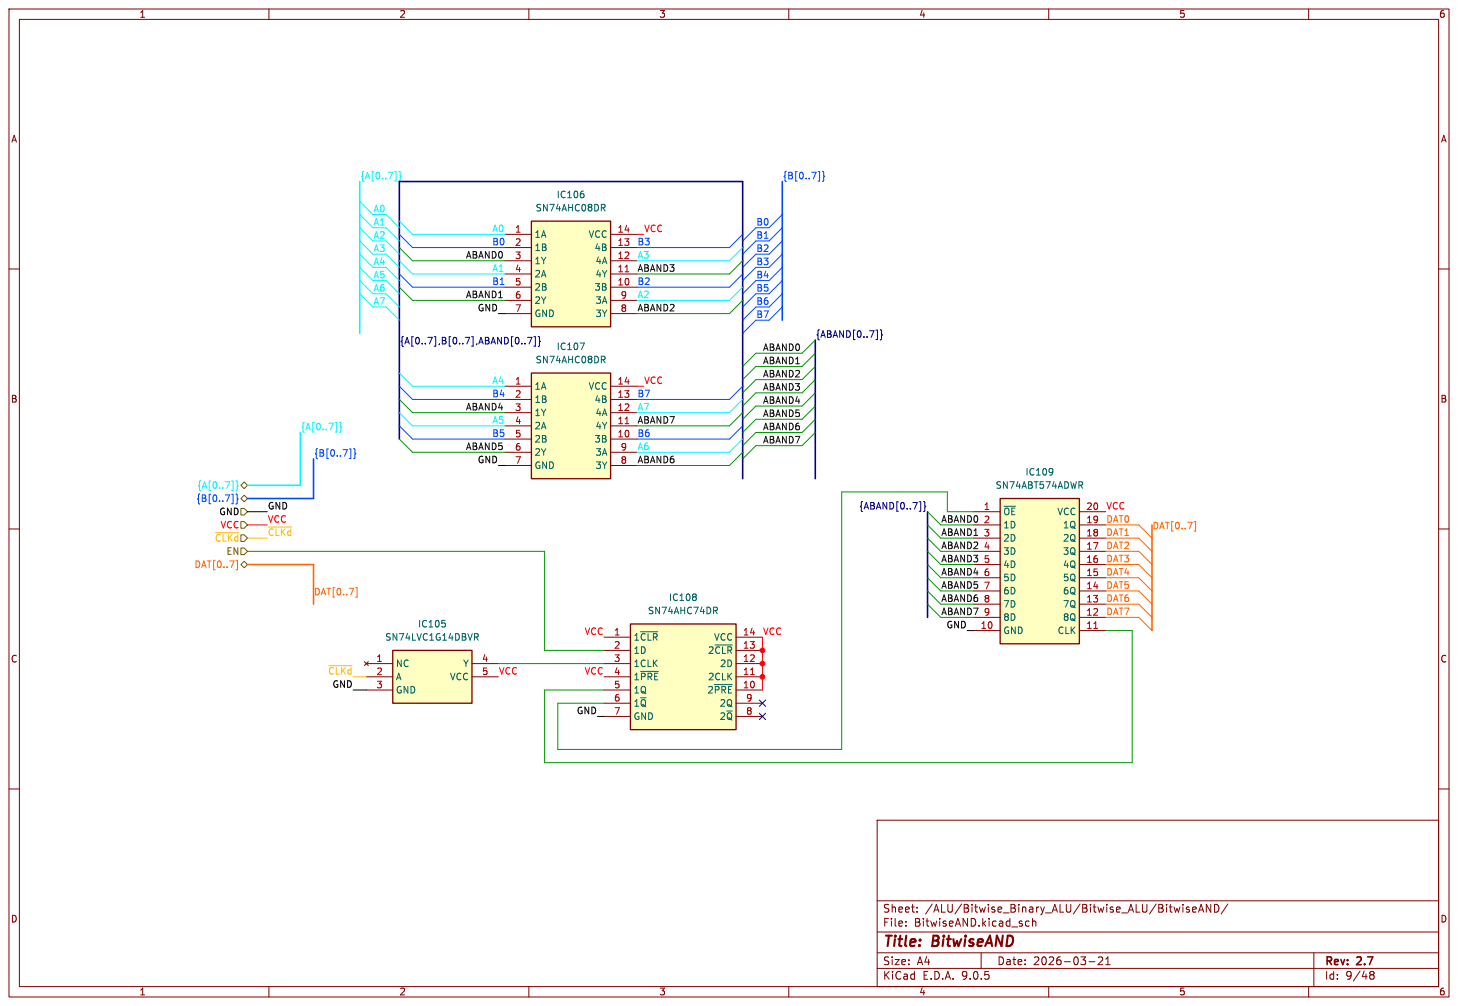
[picture p184: page 9]

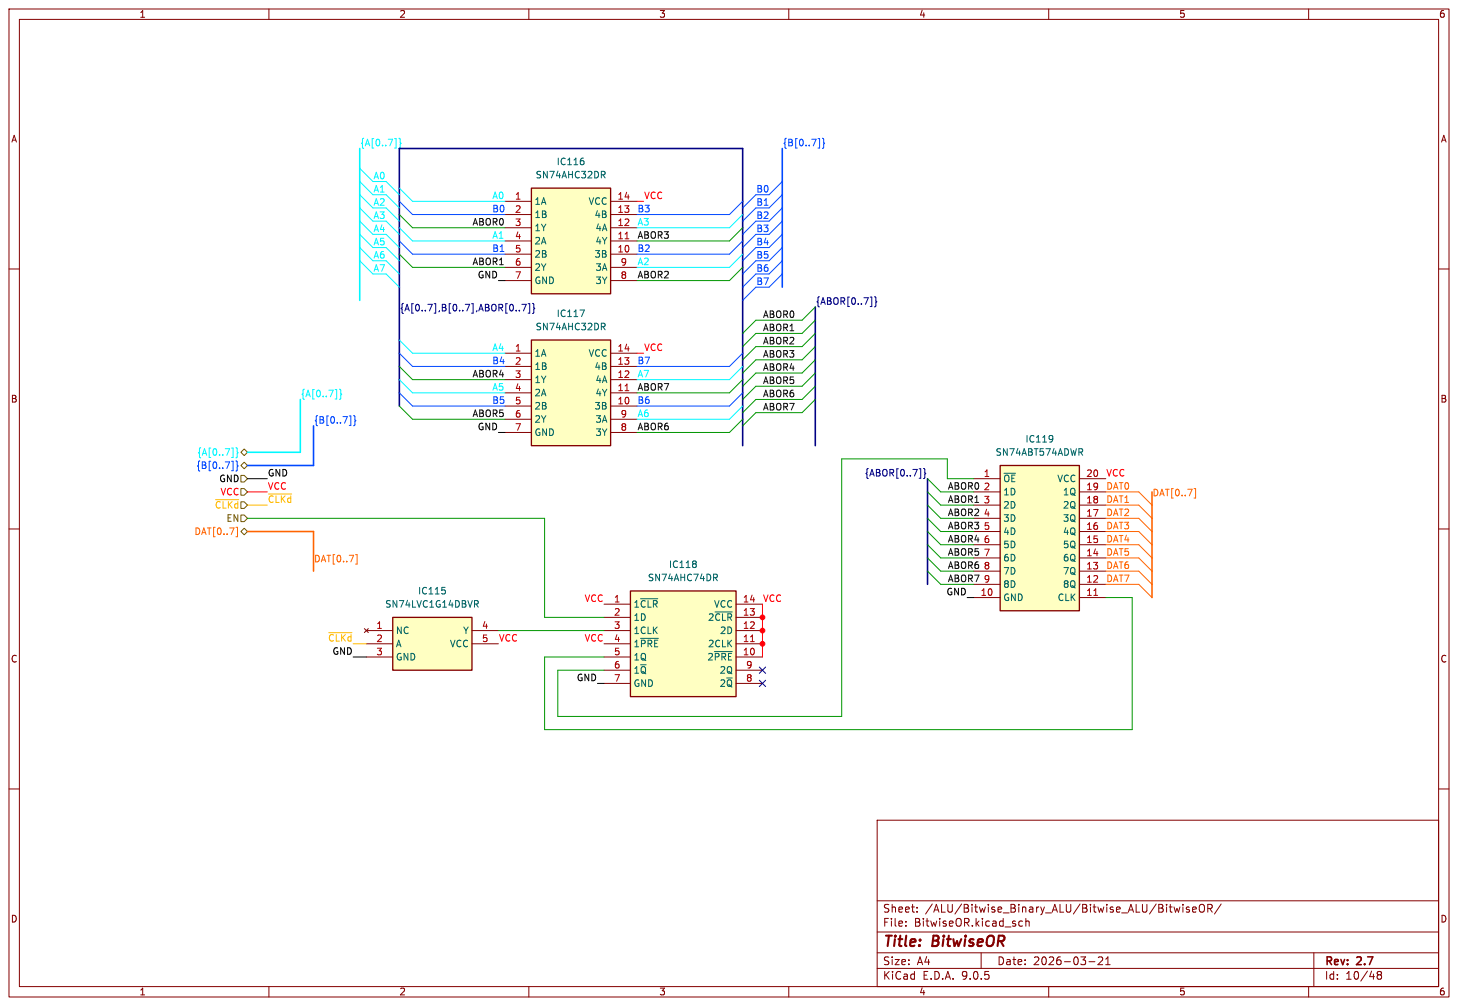
[picture p185: page 10]

File: BitwiseOR.kicad_sch Sheet: /ALU/Bitwise_Binary_ALU/Bitwise_ALU/BitwiseOR/
Id: 10/48 Title: BitwiseOR

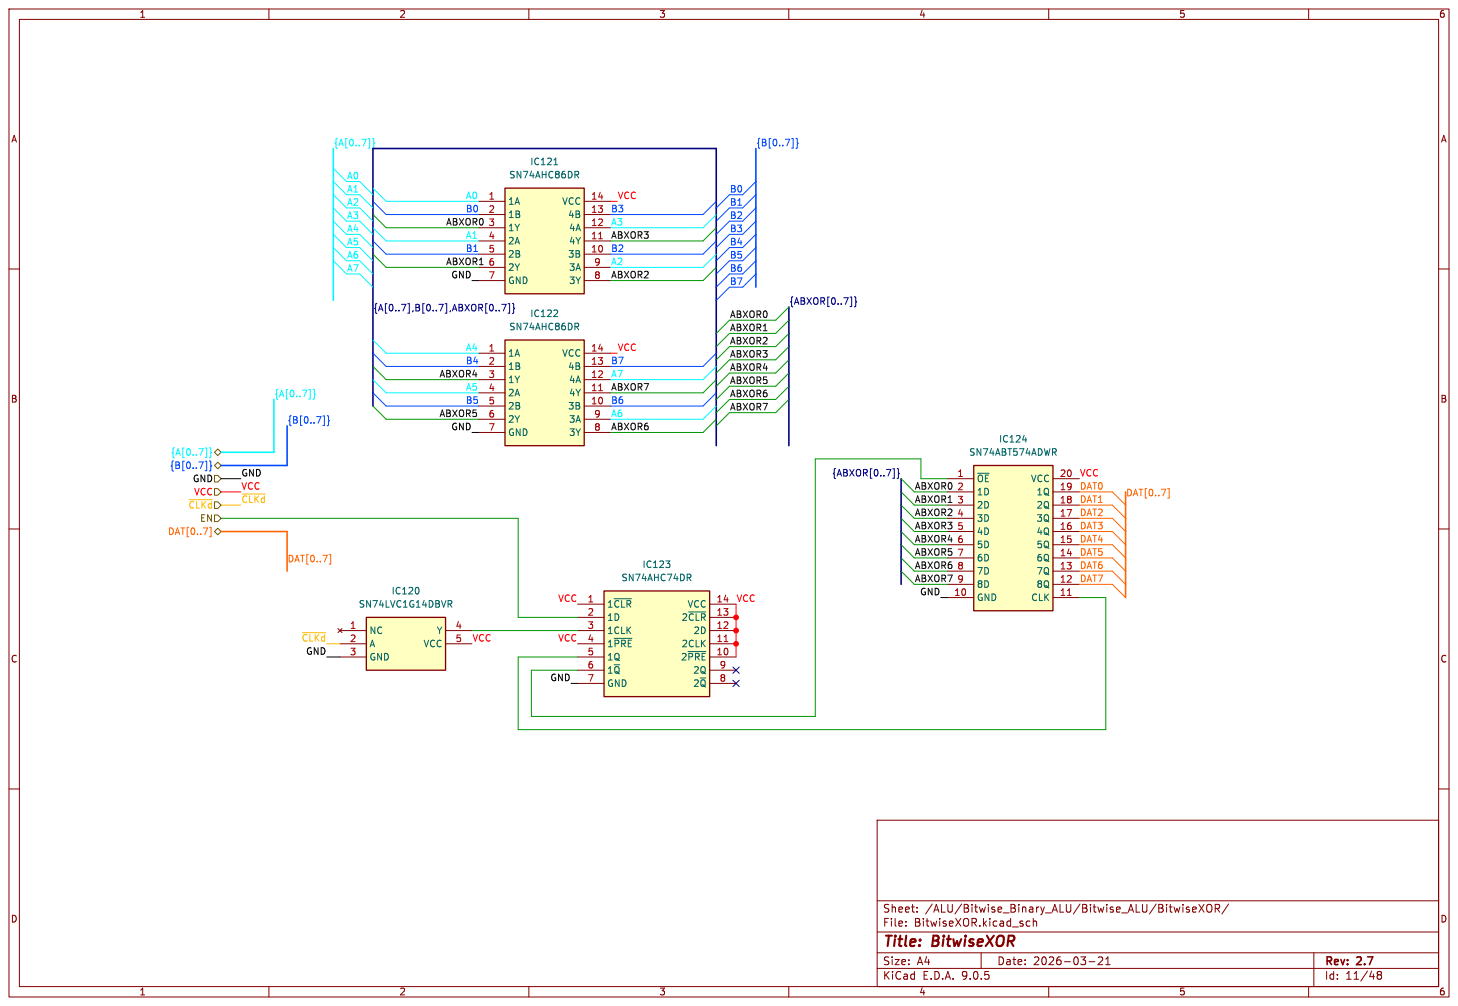
[picture p186: page 11]

File: BitwiseXOR.kicad_sch Sheet: /ALU/Bitwise_Binary_ALU/Bitwise_ALU/BitwiseXOR/
Id: 11/48 Title: BitwiseXOR

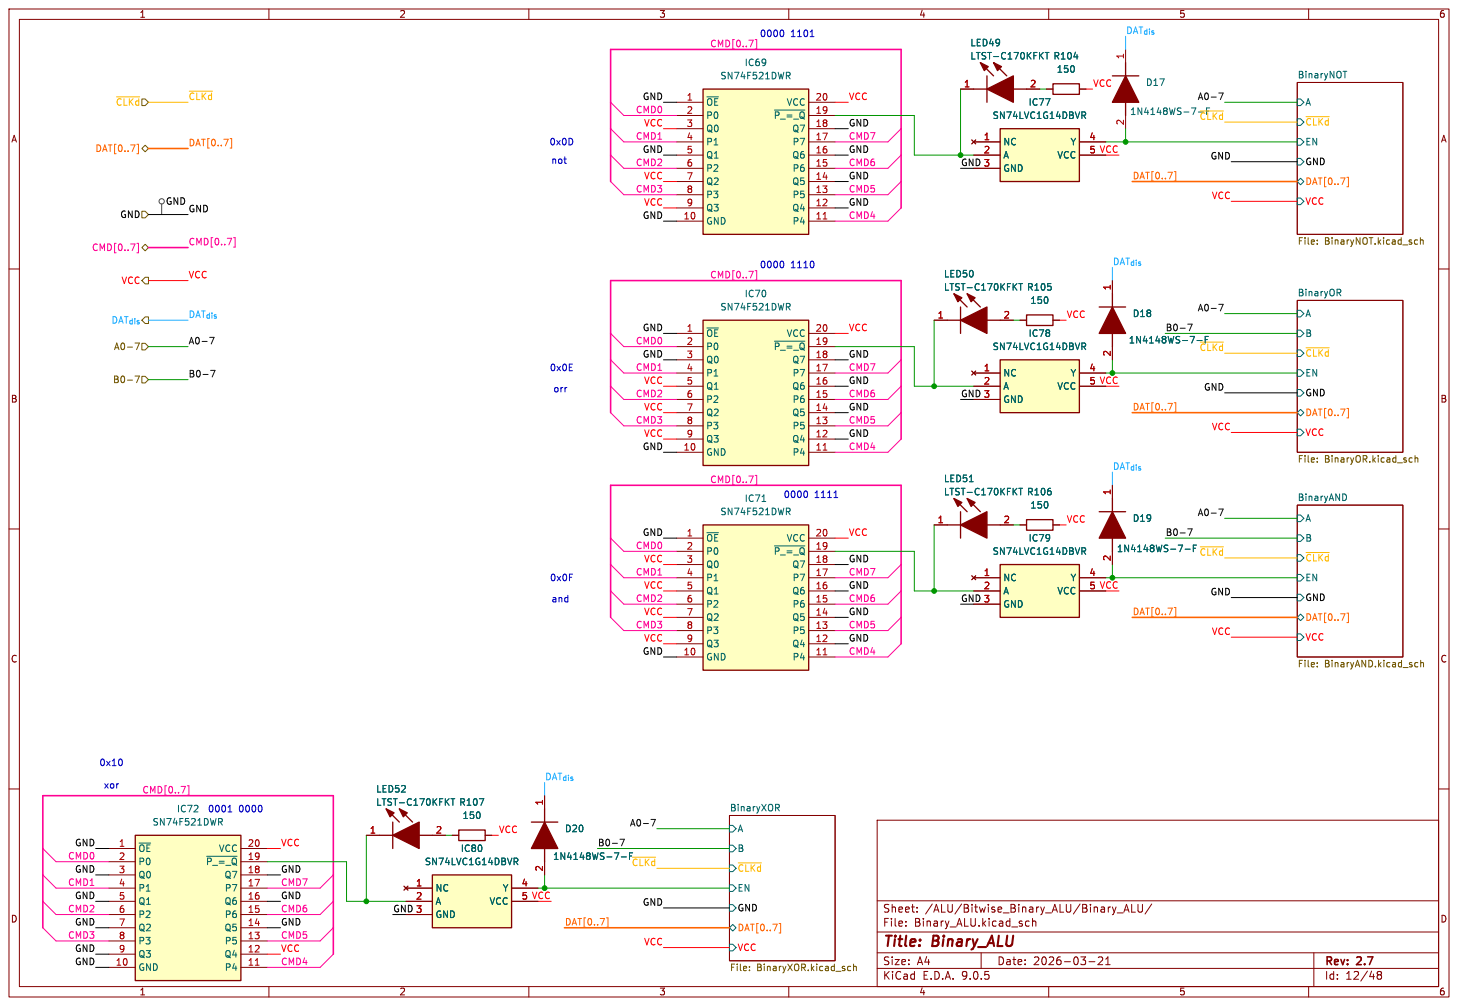
[picture p187: page 12]

VCC
CMD[0..7] CMD3 GND GND GND GND
CMD0 A0-7 ~{CLKd}

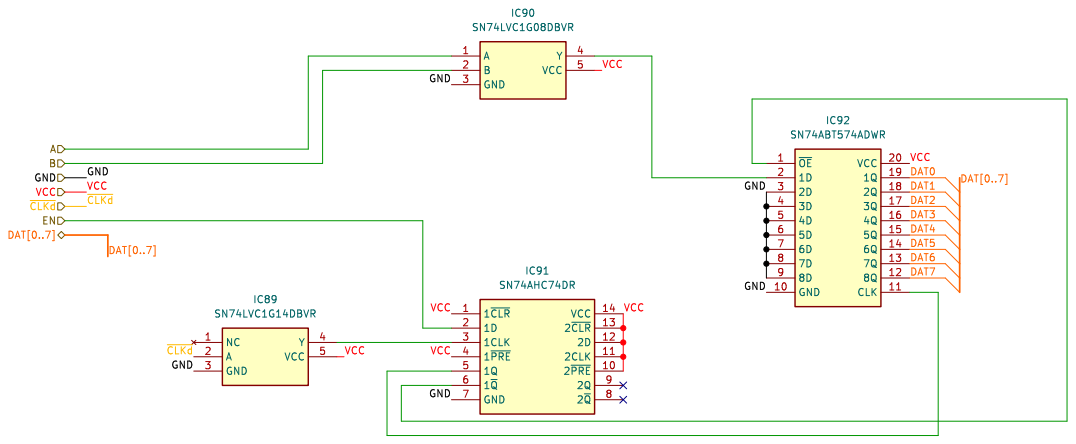
[picture p188: page 13]

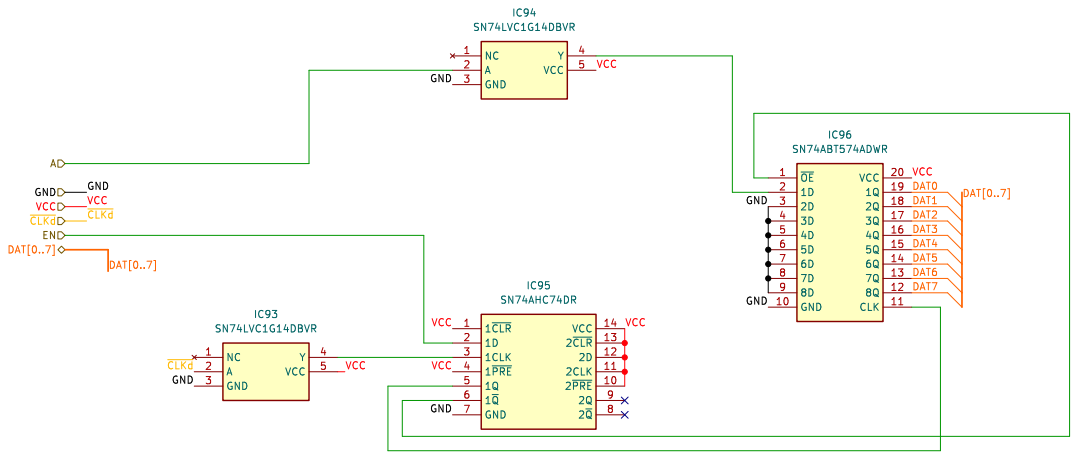
[picture p189: page 14]

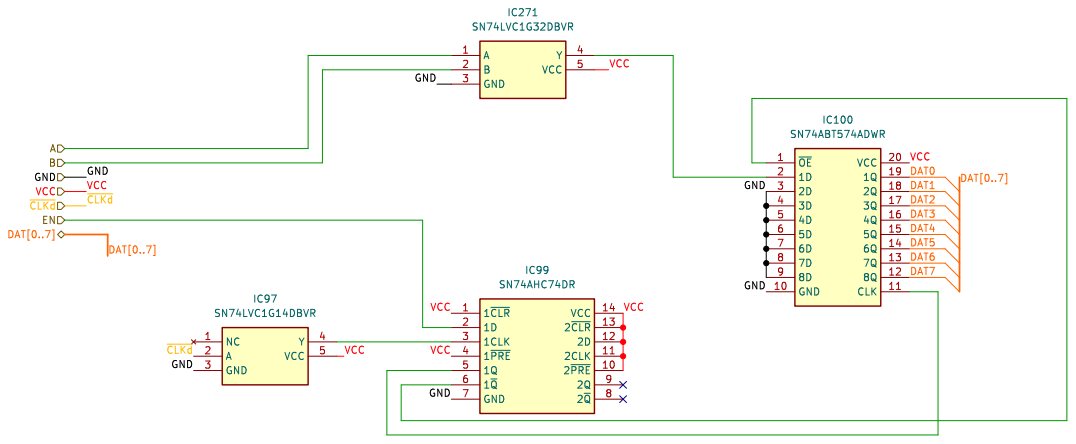
[picture p190: page 15]

File: BinaryOR.kicad_sch Sheet: /ALU/Bitwise_Binary_ALU/Binary_ALU/BinaryOR/
Id: 15/48 Title: BinaryOR

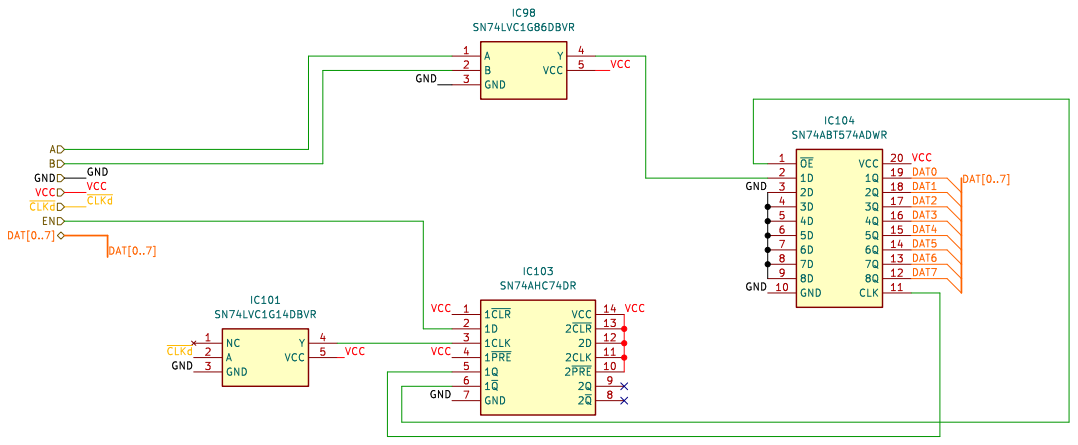
[picture p191: page 16]

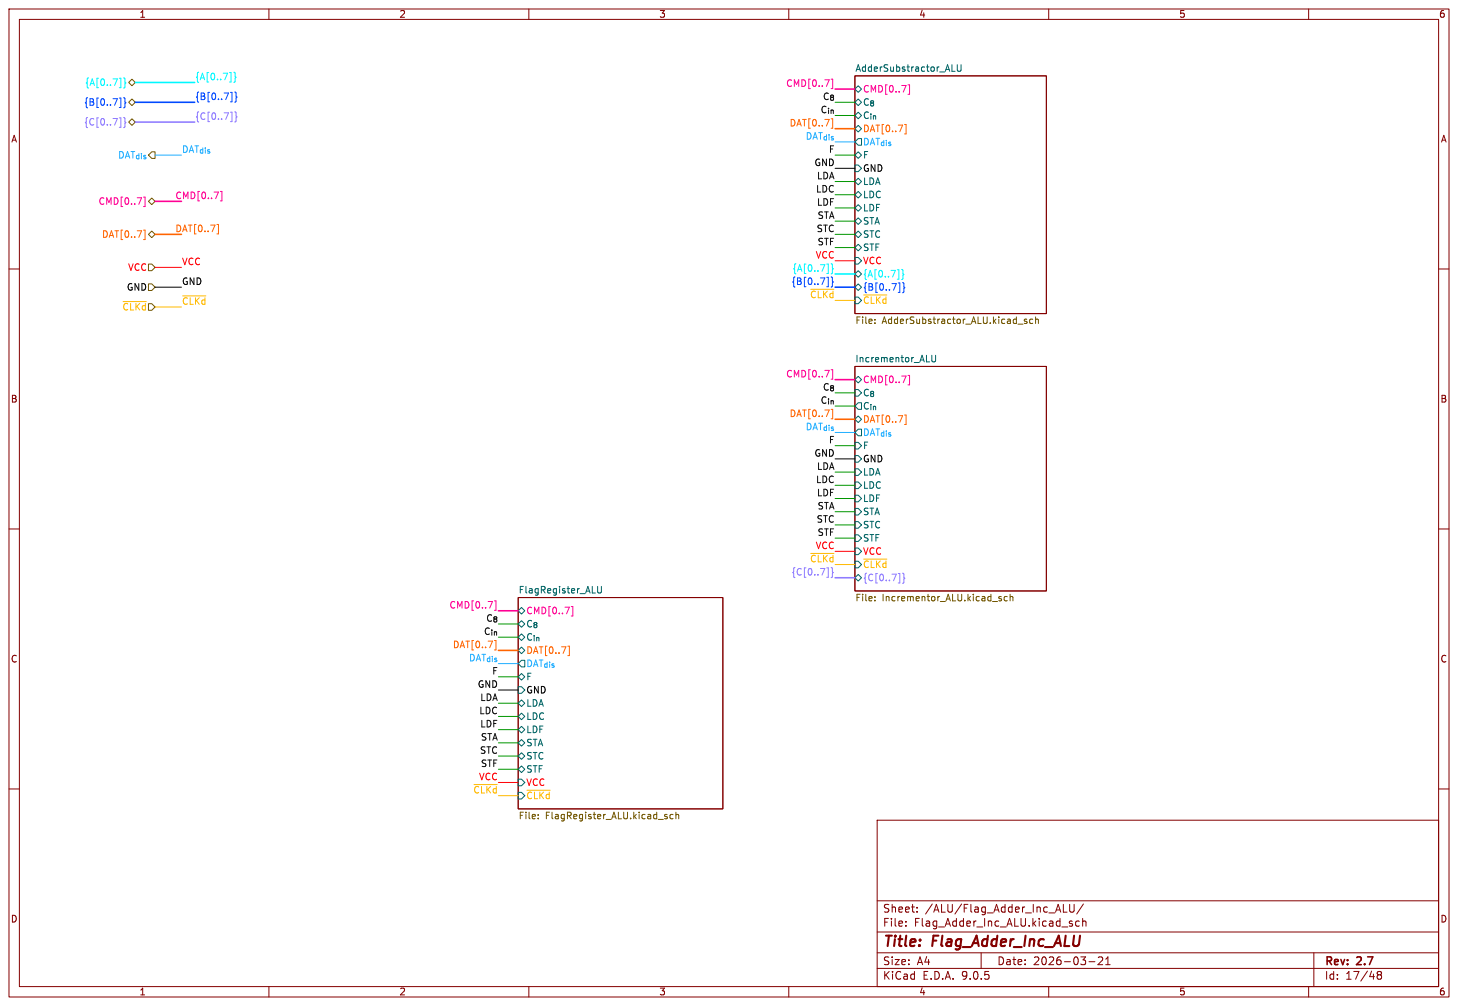
[picture p192: page 17]

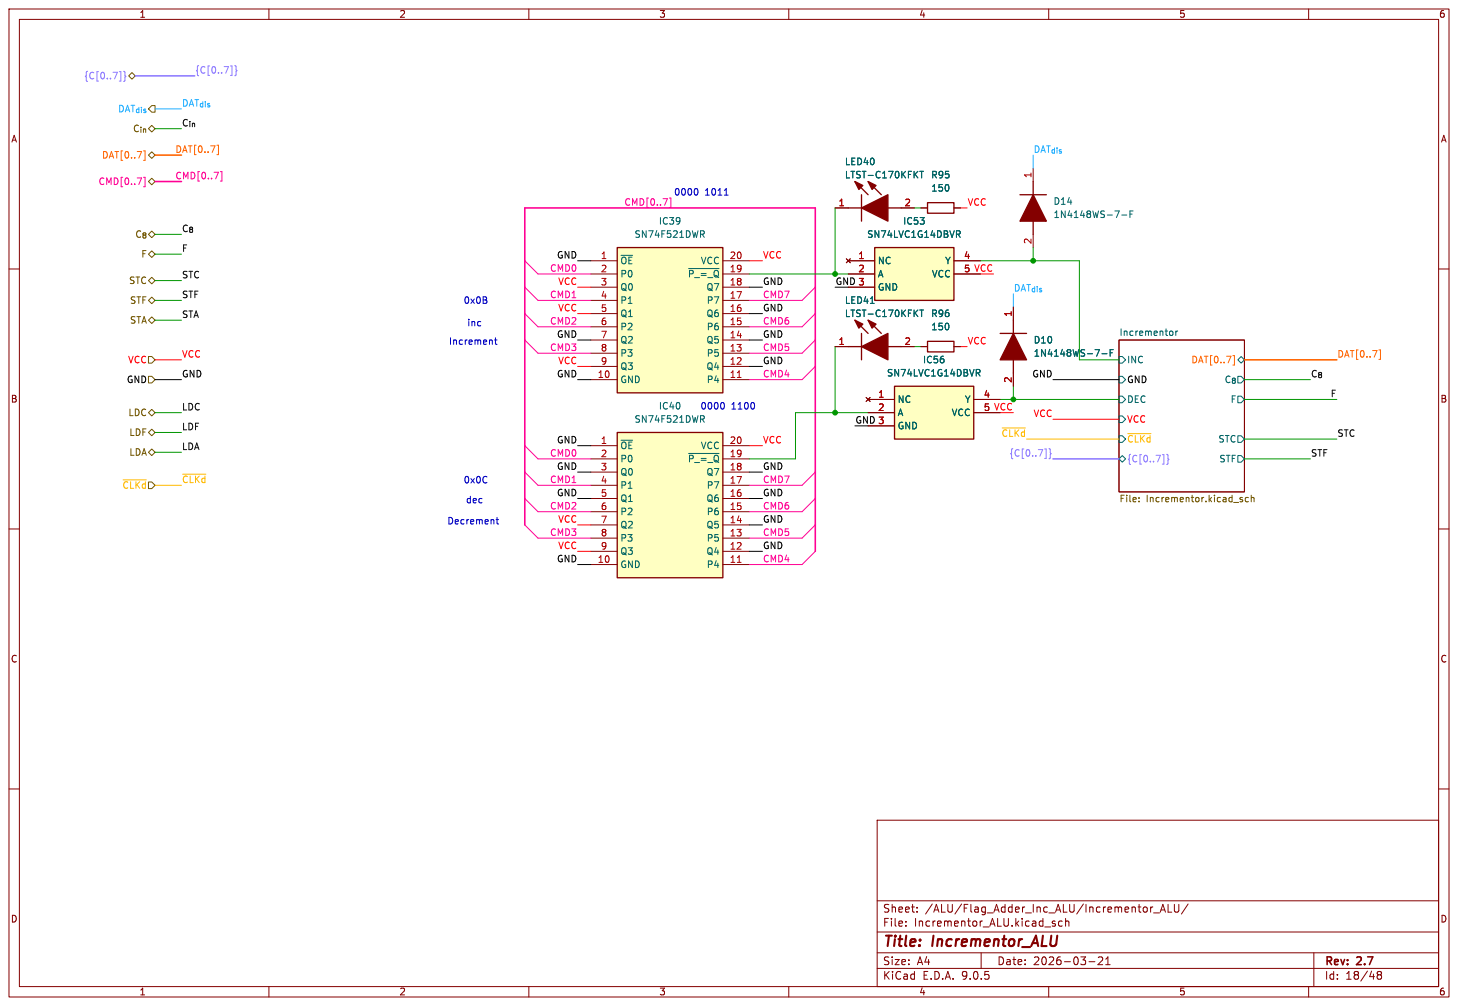
[picture p193: page 18]

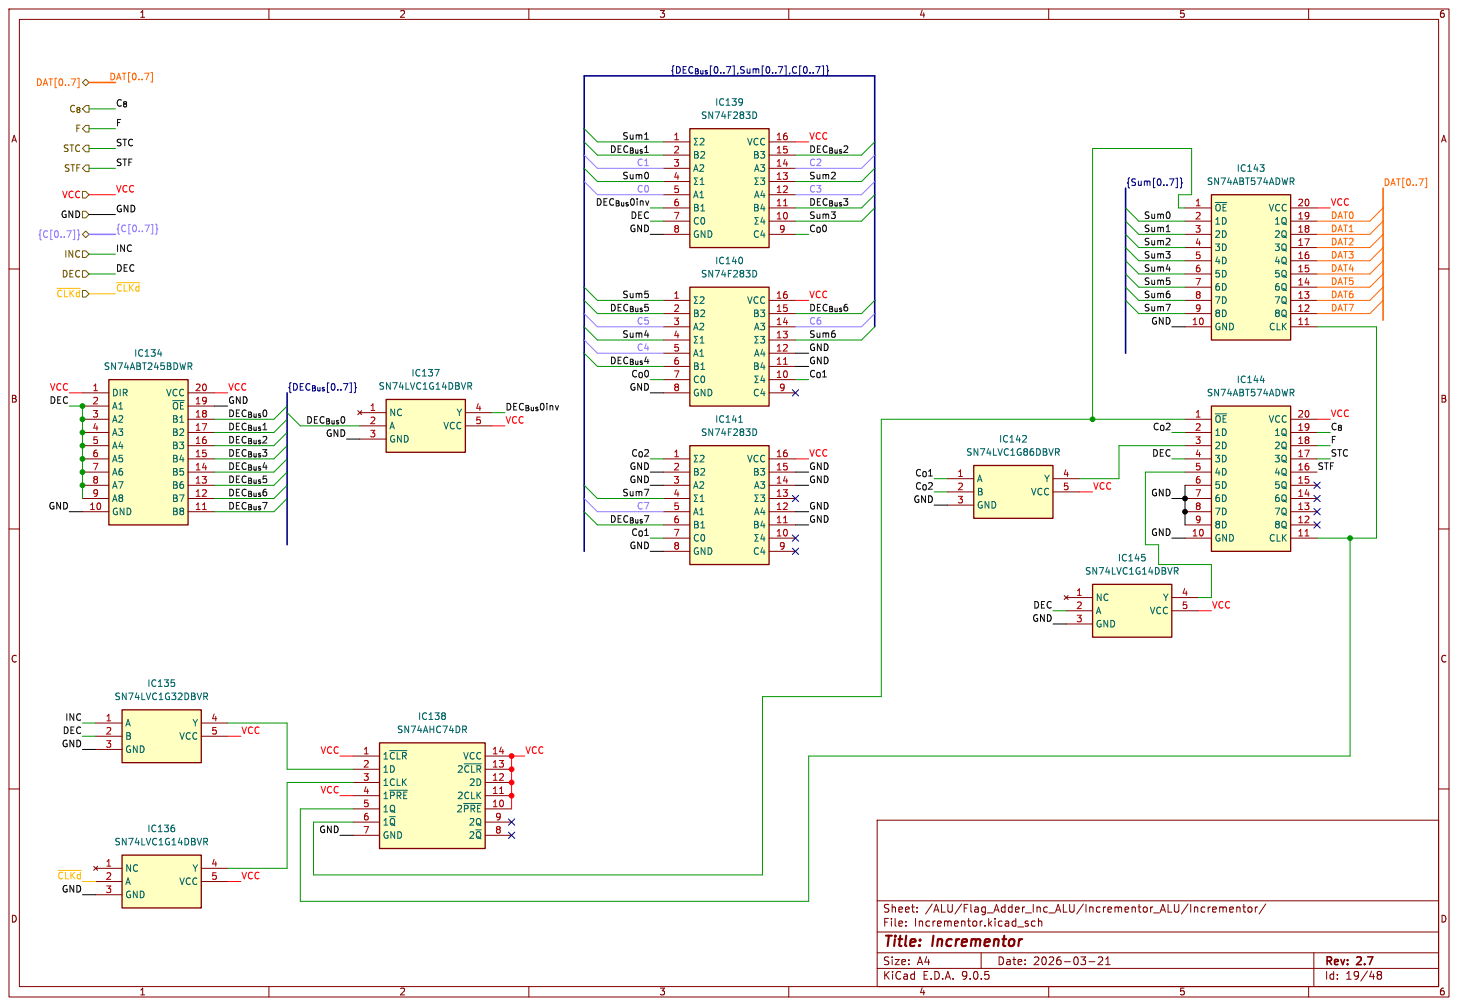
[picture p194: page 19]

Id: 19/48 Title: Incrementor File: Incrementor.kicad_sch Sheet: /ALU/Flag_Adder_Inc_ALU/Incrementor_ALU/Incrementor/

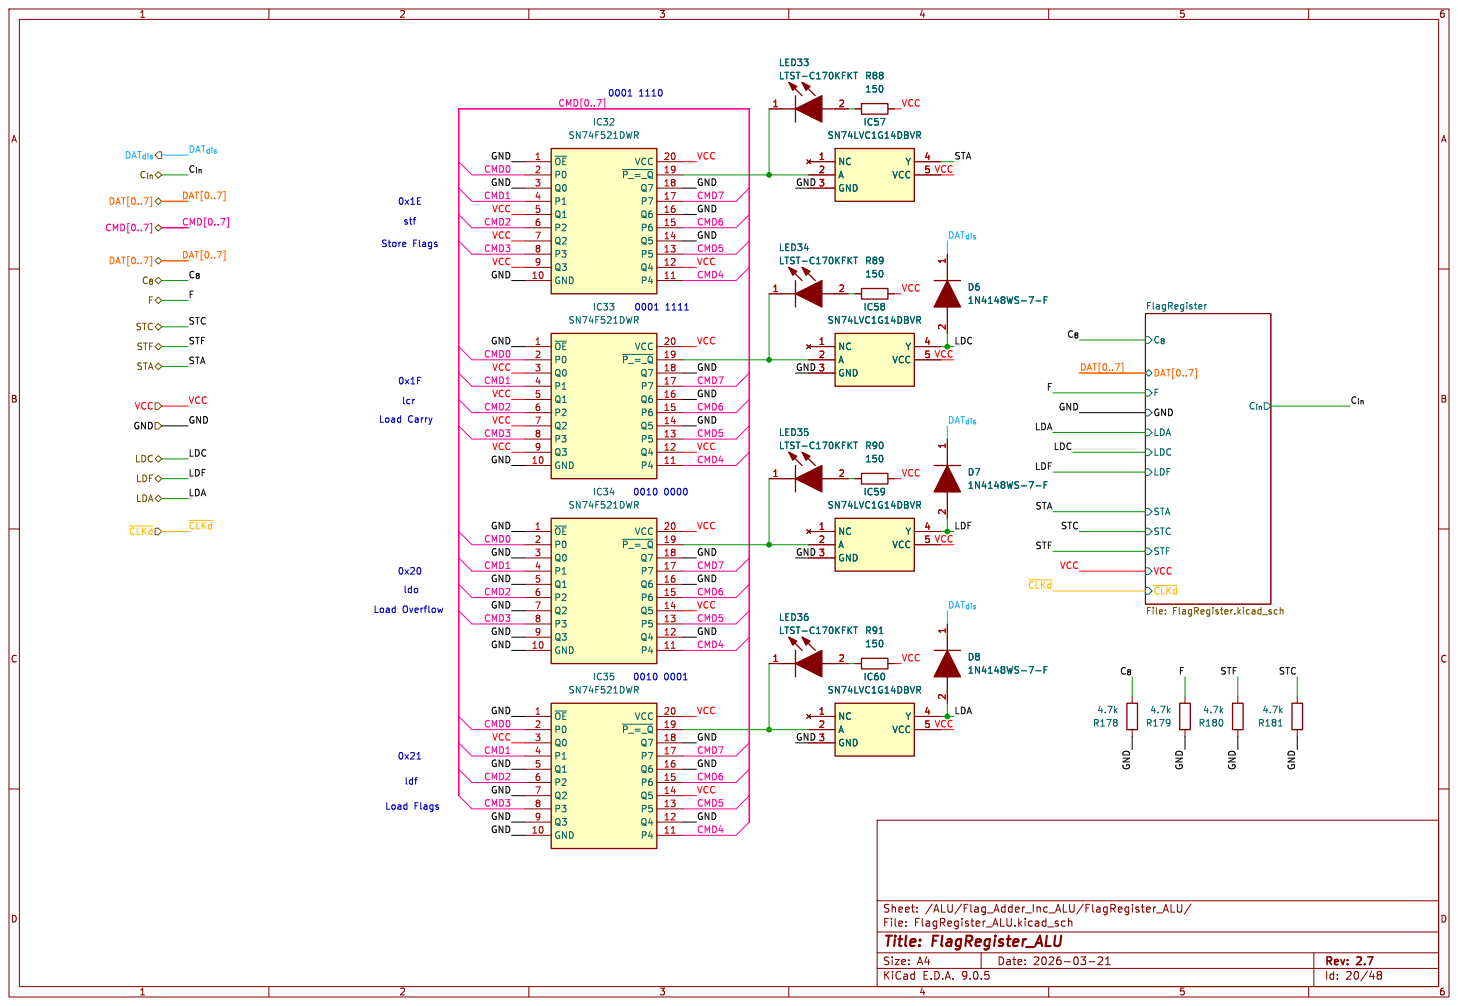
[picture p195: page 20]

LDF STF STA C_{in}

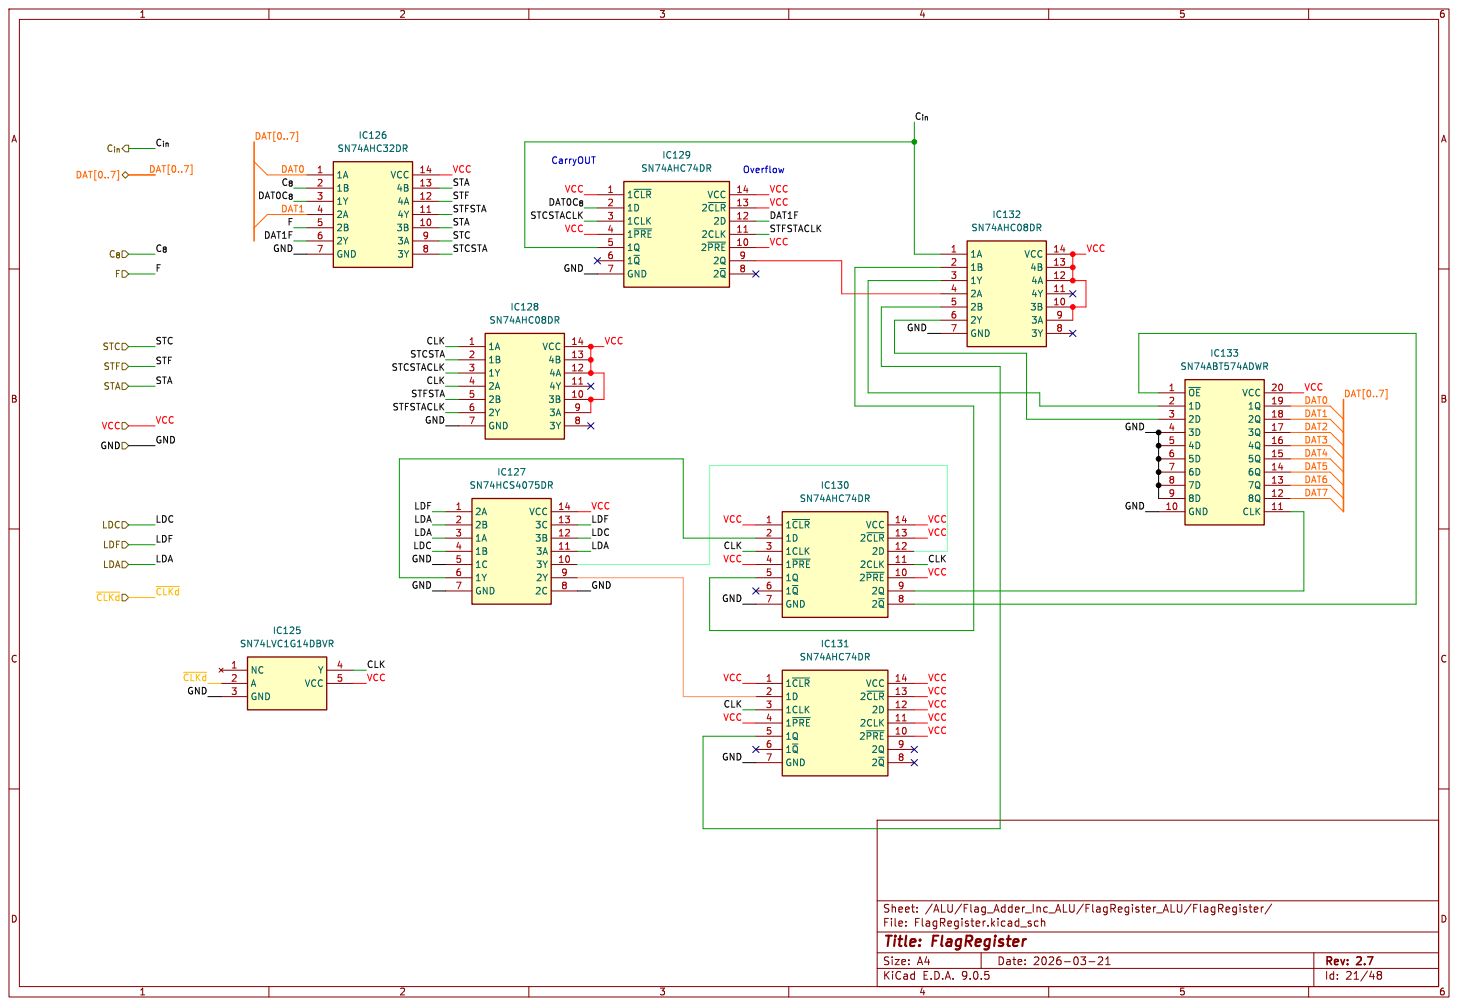
[picture p196: page 21]

Id: 21/48 Title: FlagRegister File: FlagRegister.kicad_sch Sheet: /ALU/Flag_Adder_Inc_ALU/FlagRegister_ALU/FlagRegister/

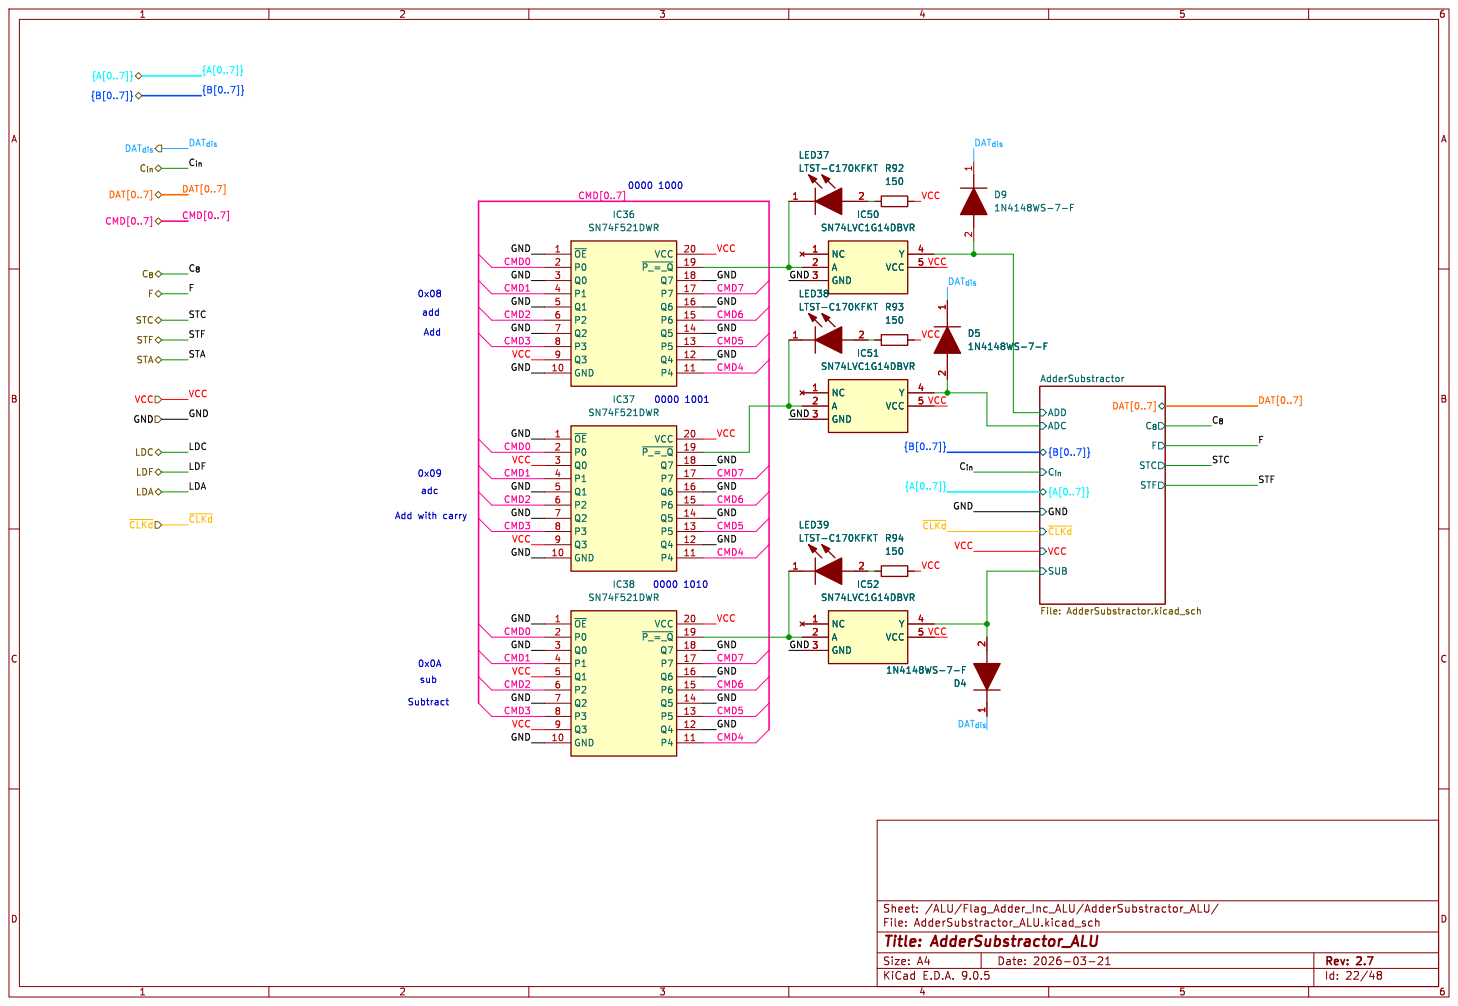
[picture p197: page 22]

IC36 SN74F521DWR
adc Add with carry add

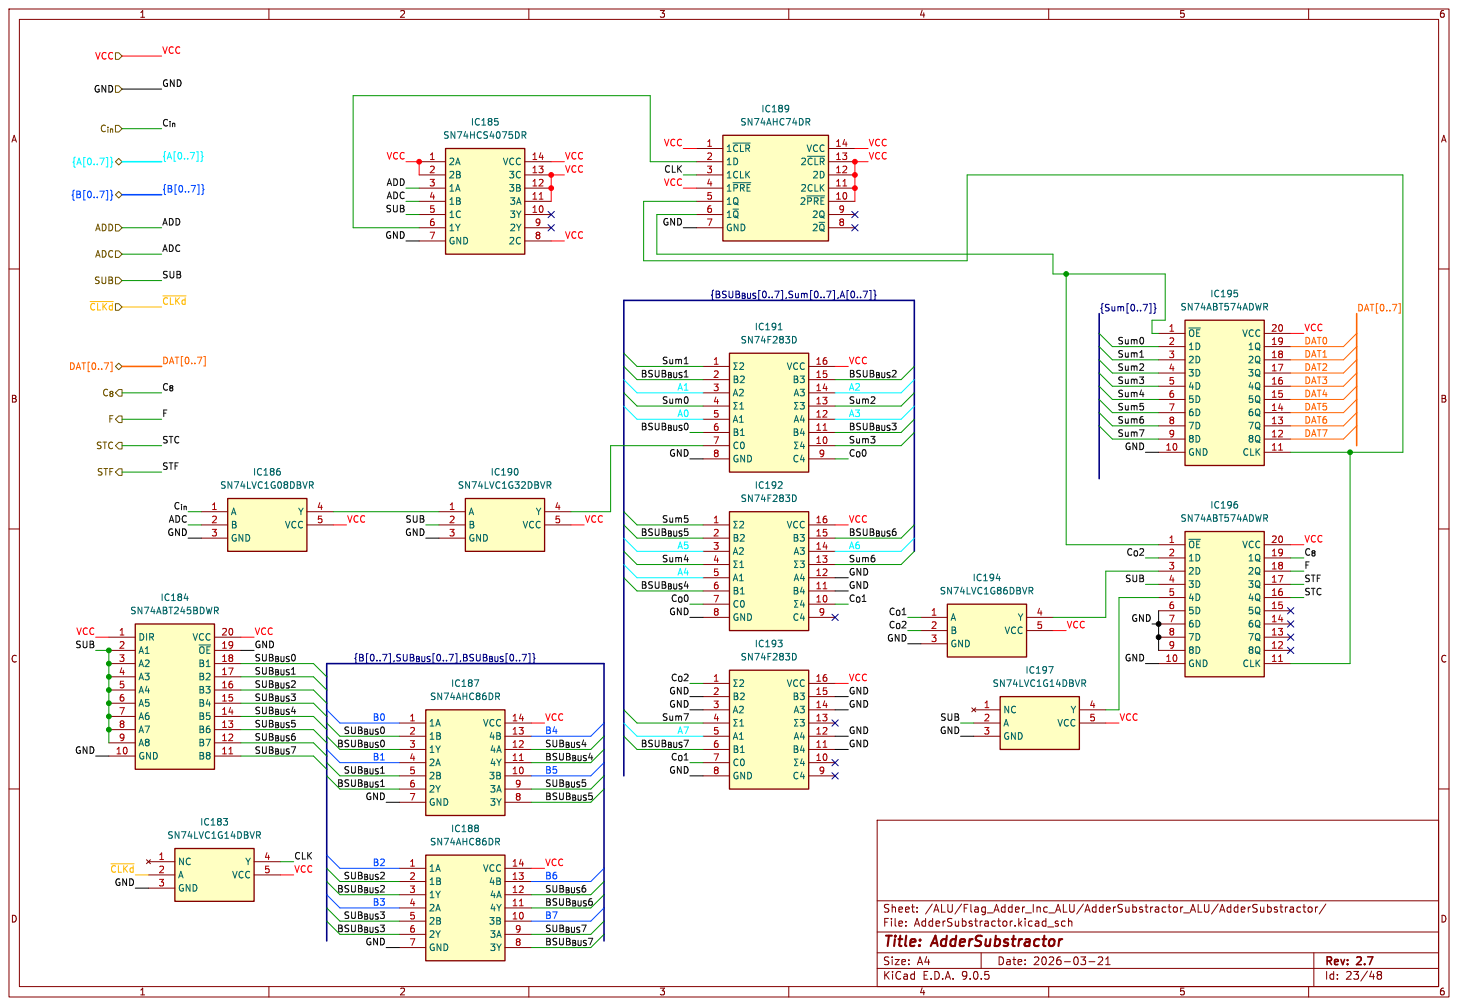
[picture p198: page 23]

VCC GND GND SUB_{BUS}6
SUB_{BUS}3

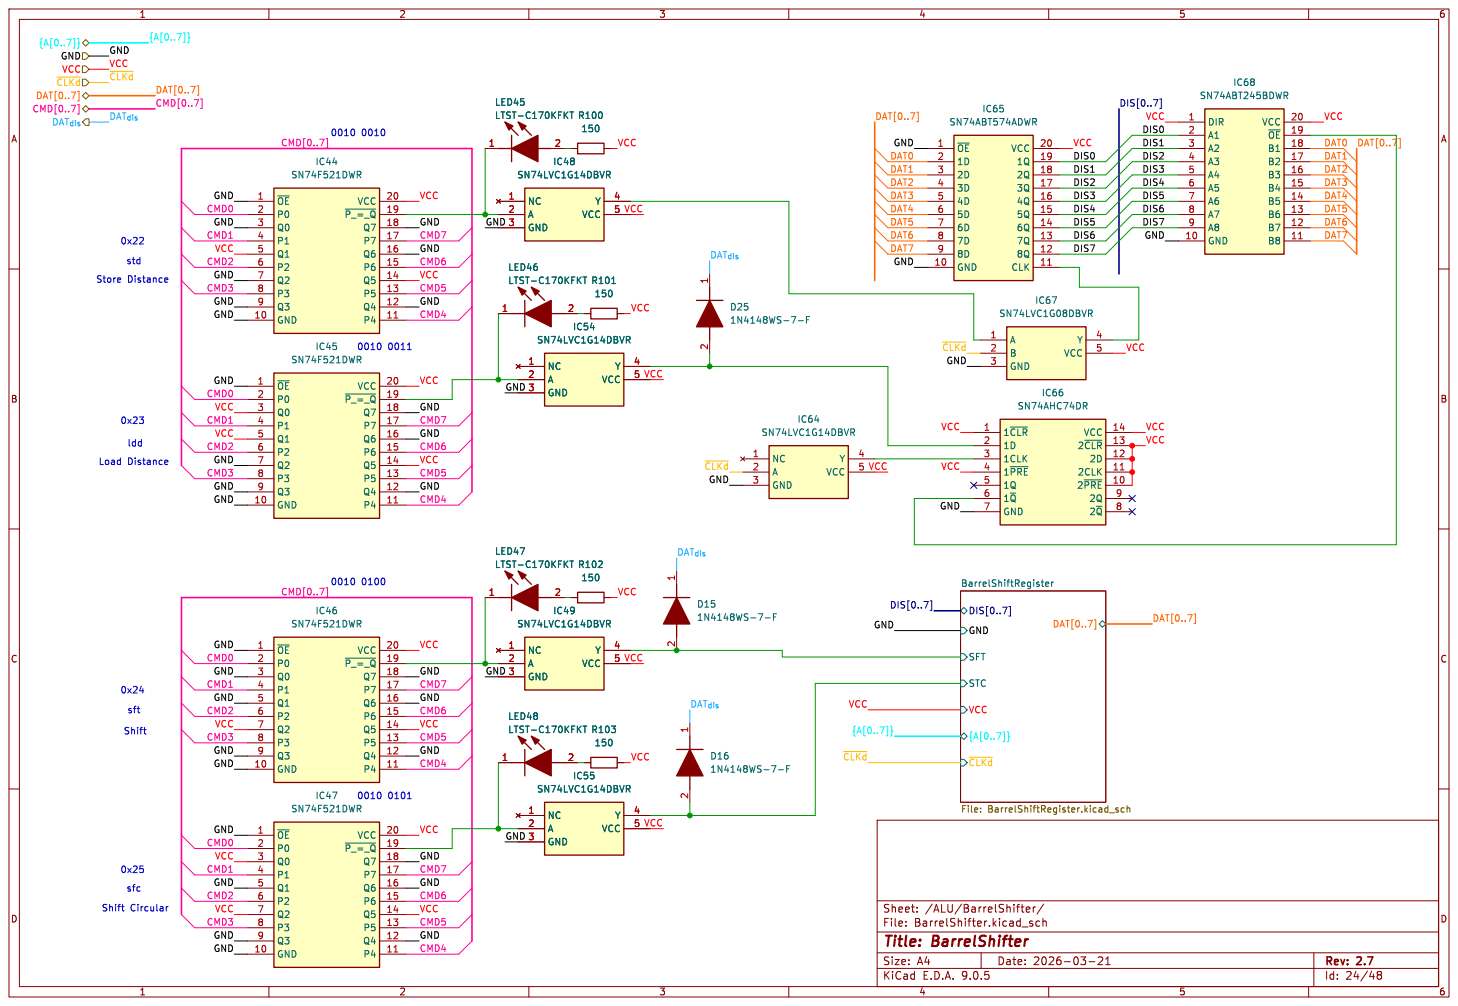
[picture p199: page 24]

SFT BarrelShiftRegister File: BarrelShiftRegister.kicad_sch

Id: 24/48 Title: BarrelShifter File: BarrelShifter.kicad_sch Sheet: /ALU/BarrelShifter/ DIS[0..7] GND

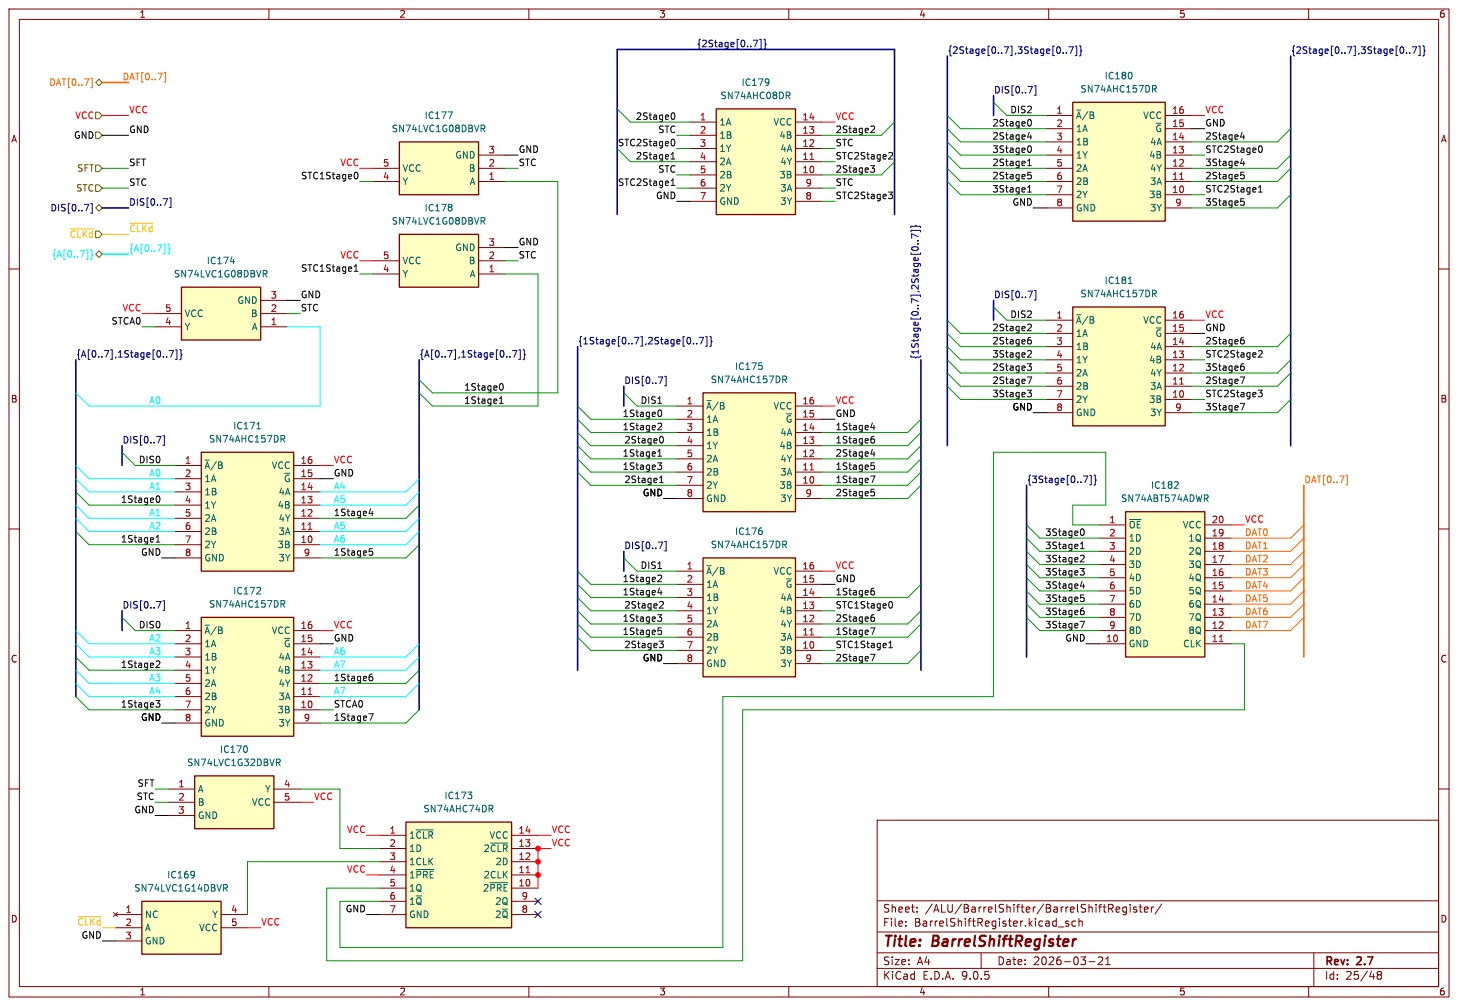
[picture p200: page 25]

Id: 25/48 Title: BarrelShiftRegister File: BarrelShiftRegister.kicad_sch Sheet: /ALU/BarrelShifter/BarrelShiftRegister/

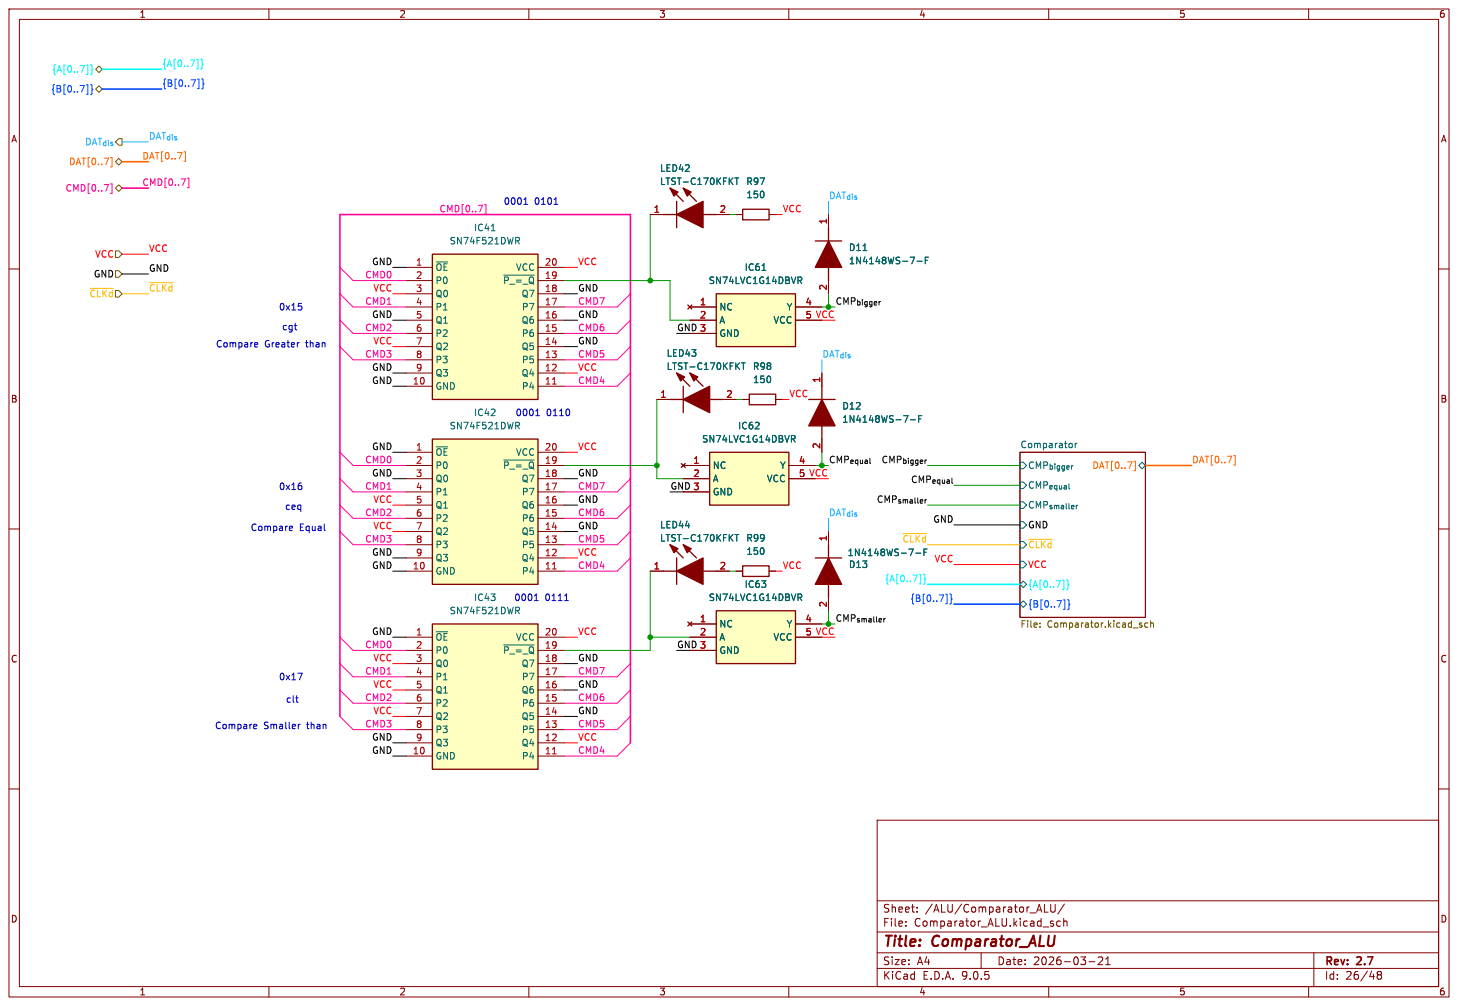
[picture p201: page 26]

ceq Compare Greater than

clt Compare Equal 0x17 Compare Smaller than

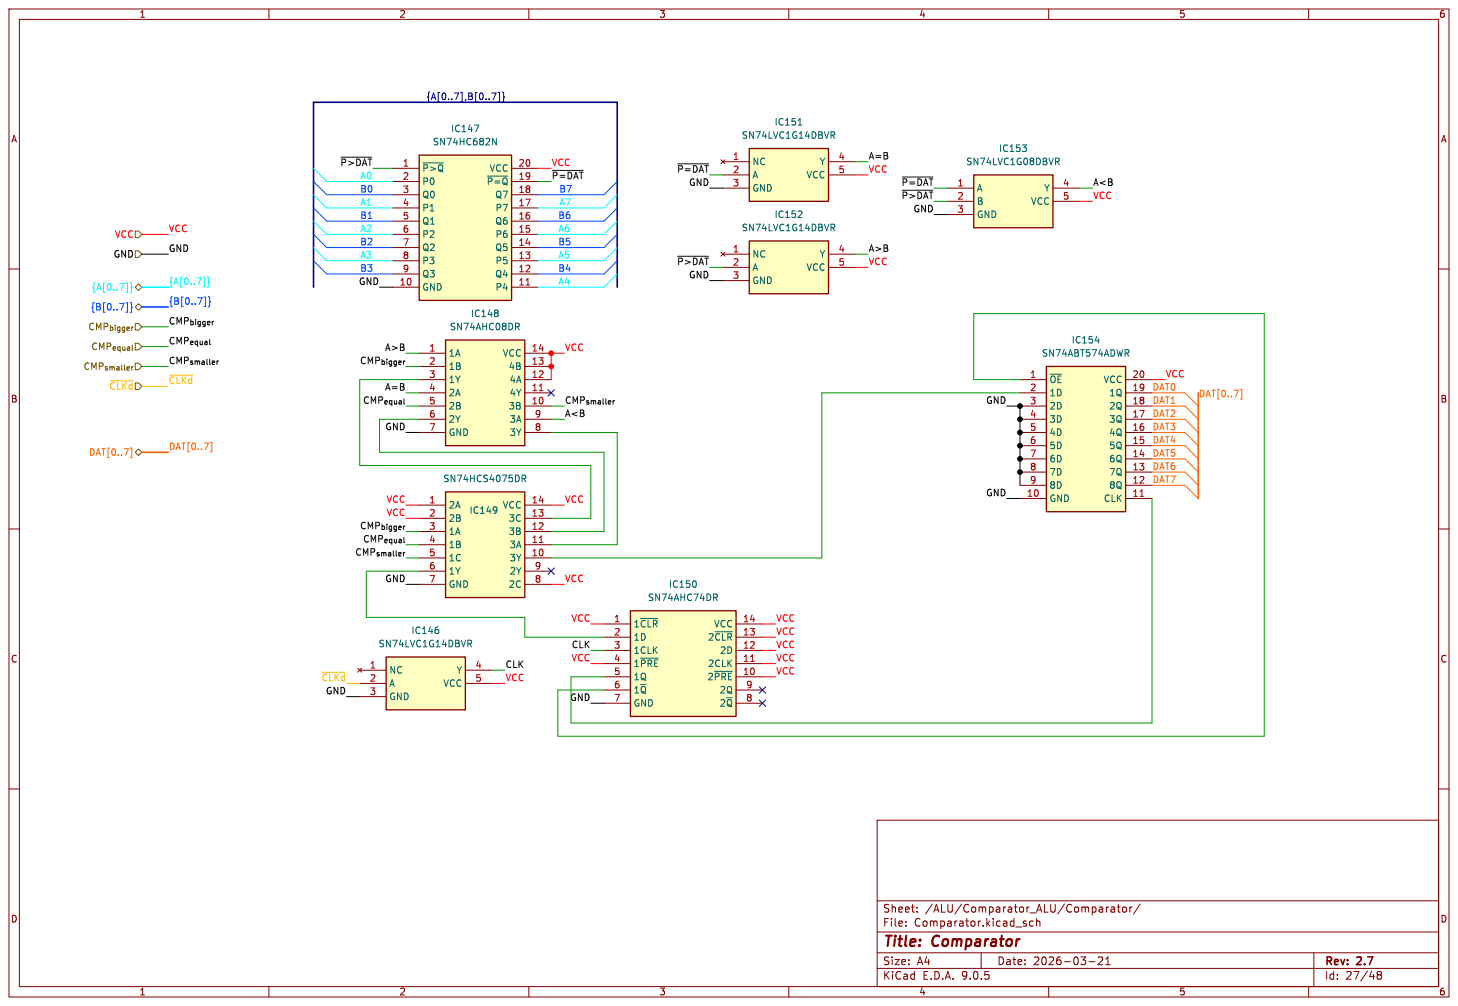
[picture p202: page 27]

Id: 27/48 Title: Comparator File: Comparator.kicad_sch Sheet: /ALU/Comparator_ALU/Comparator/

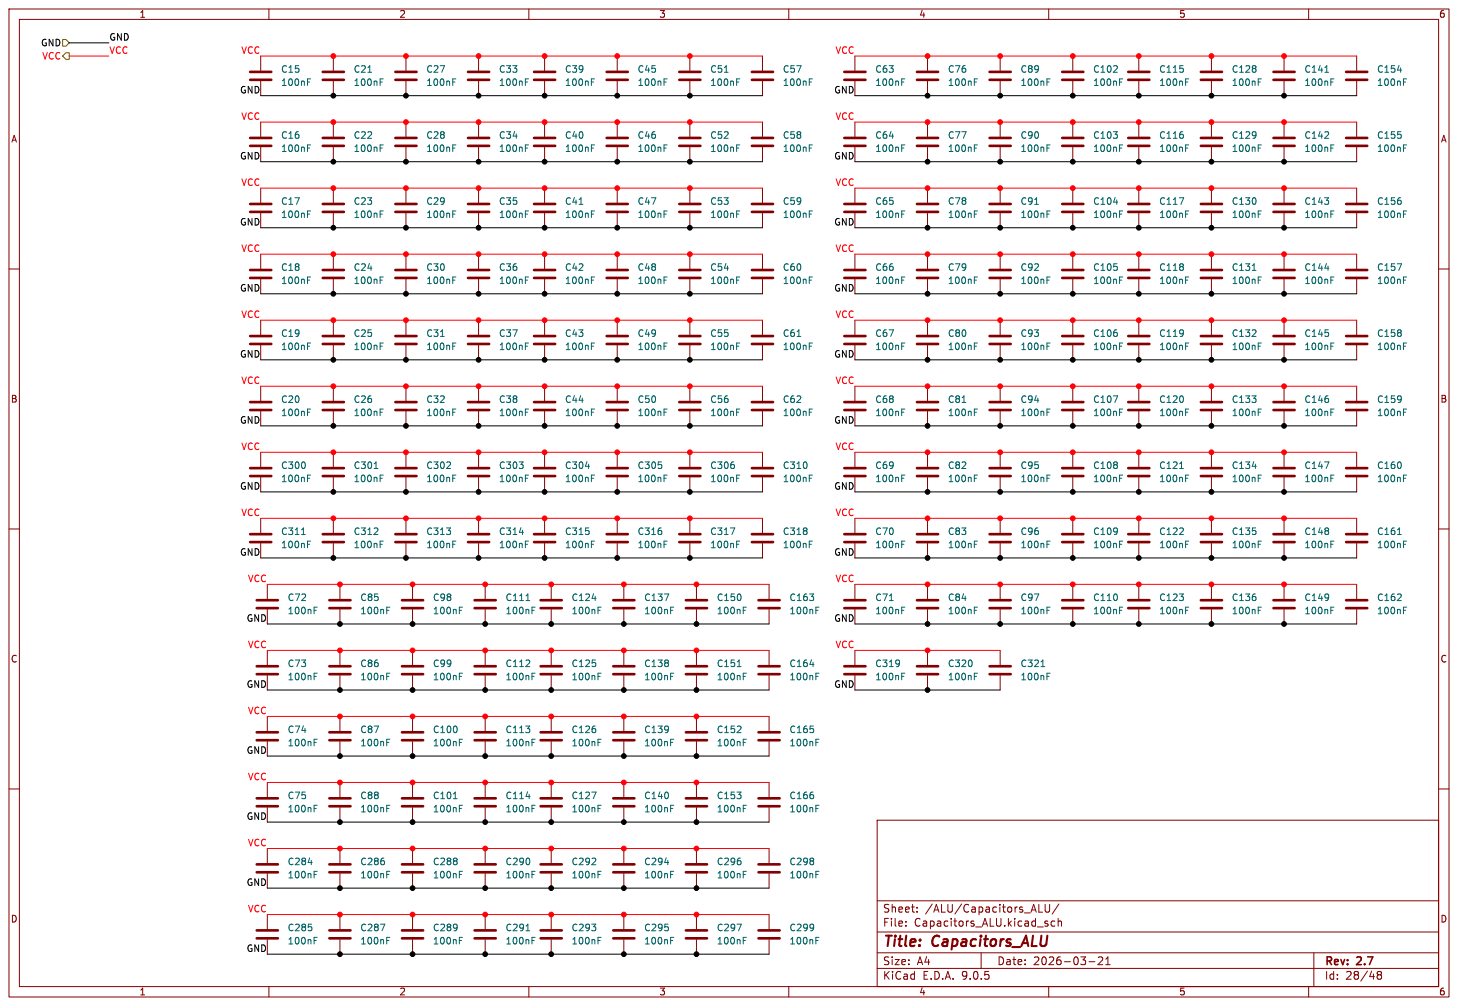
[picture p203: page 28]

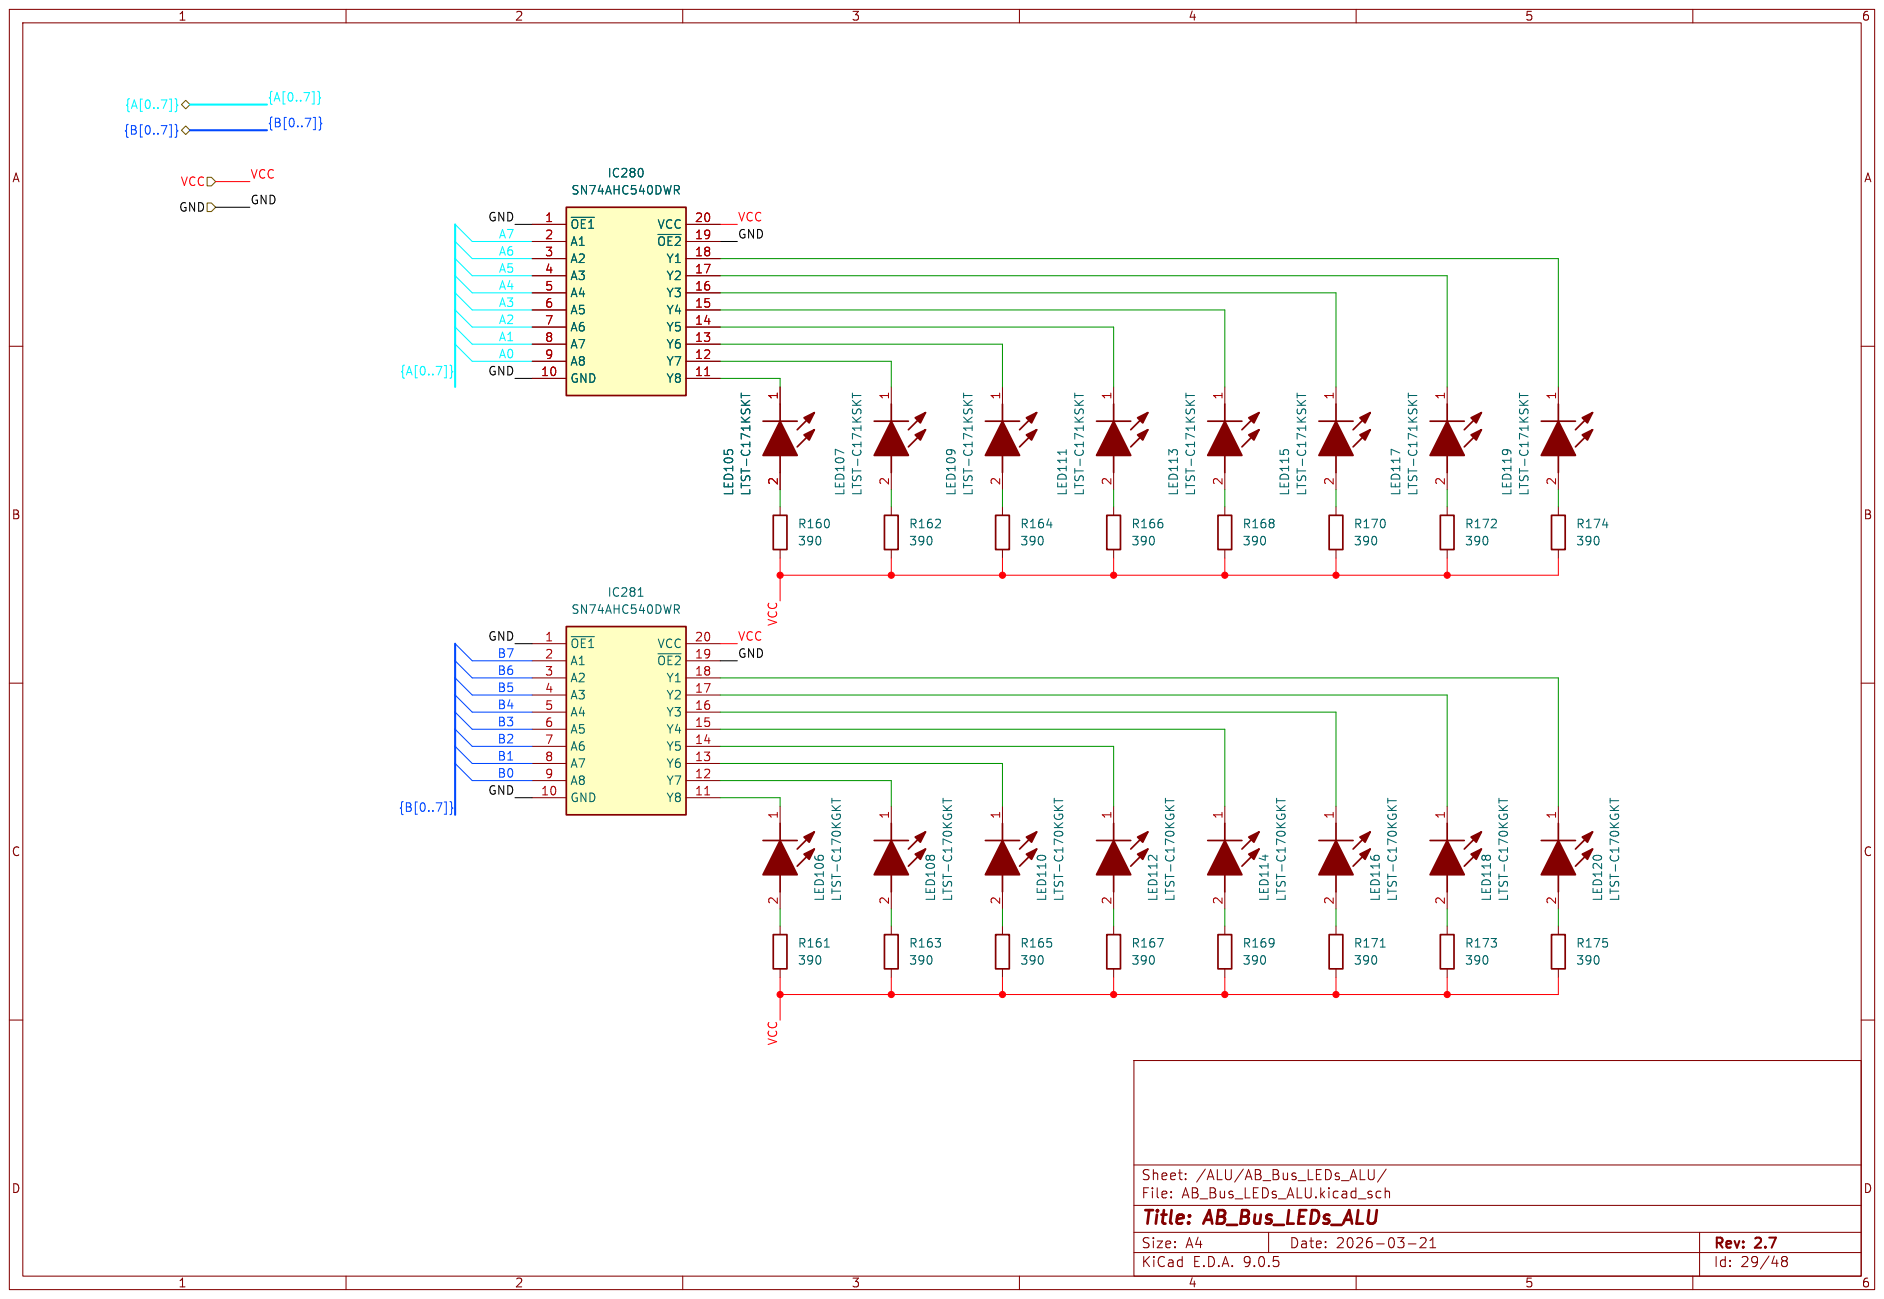
[picture p204: page 29]

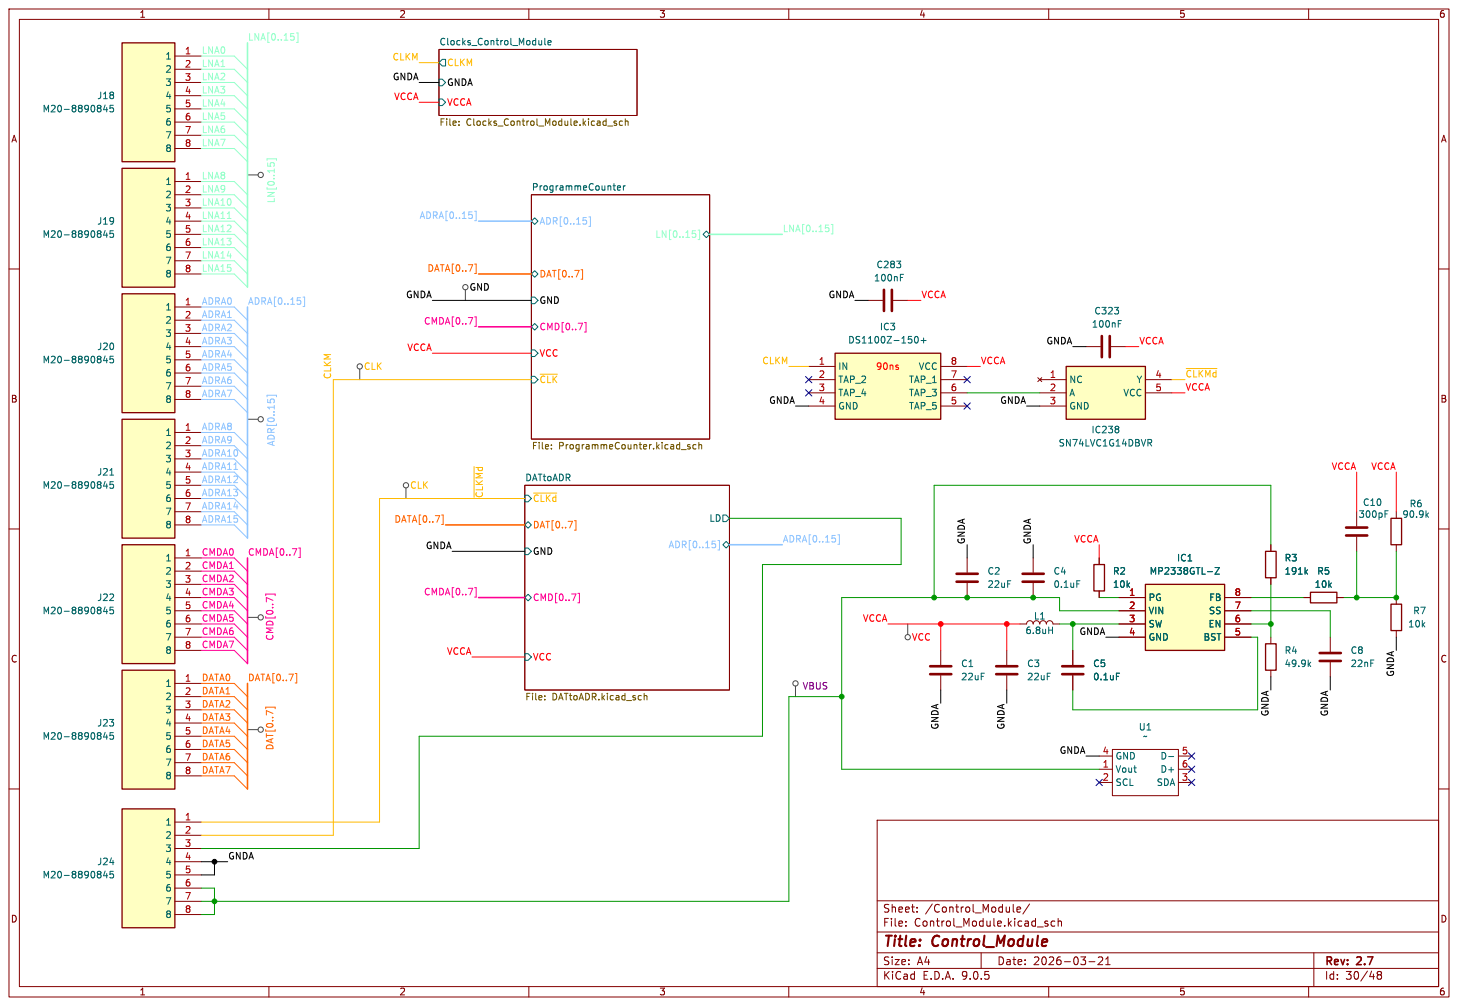
[picture p205: page 30]

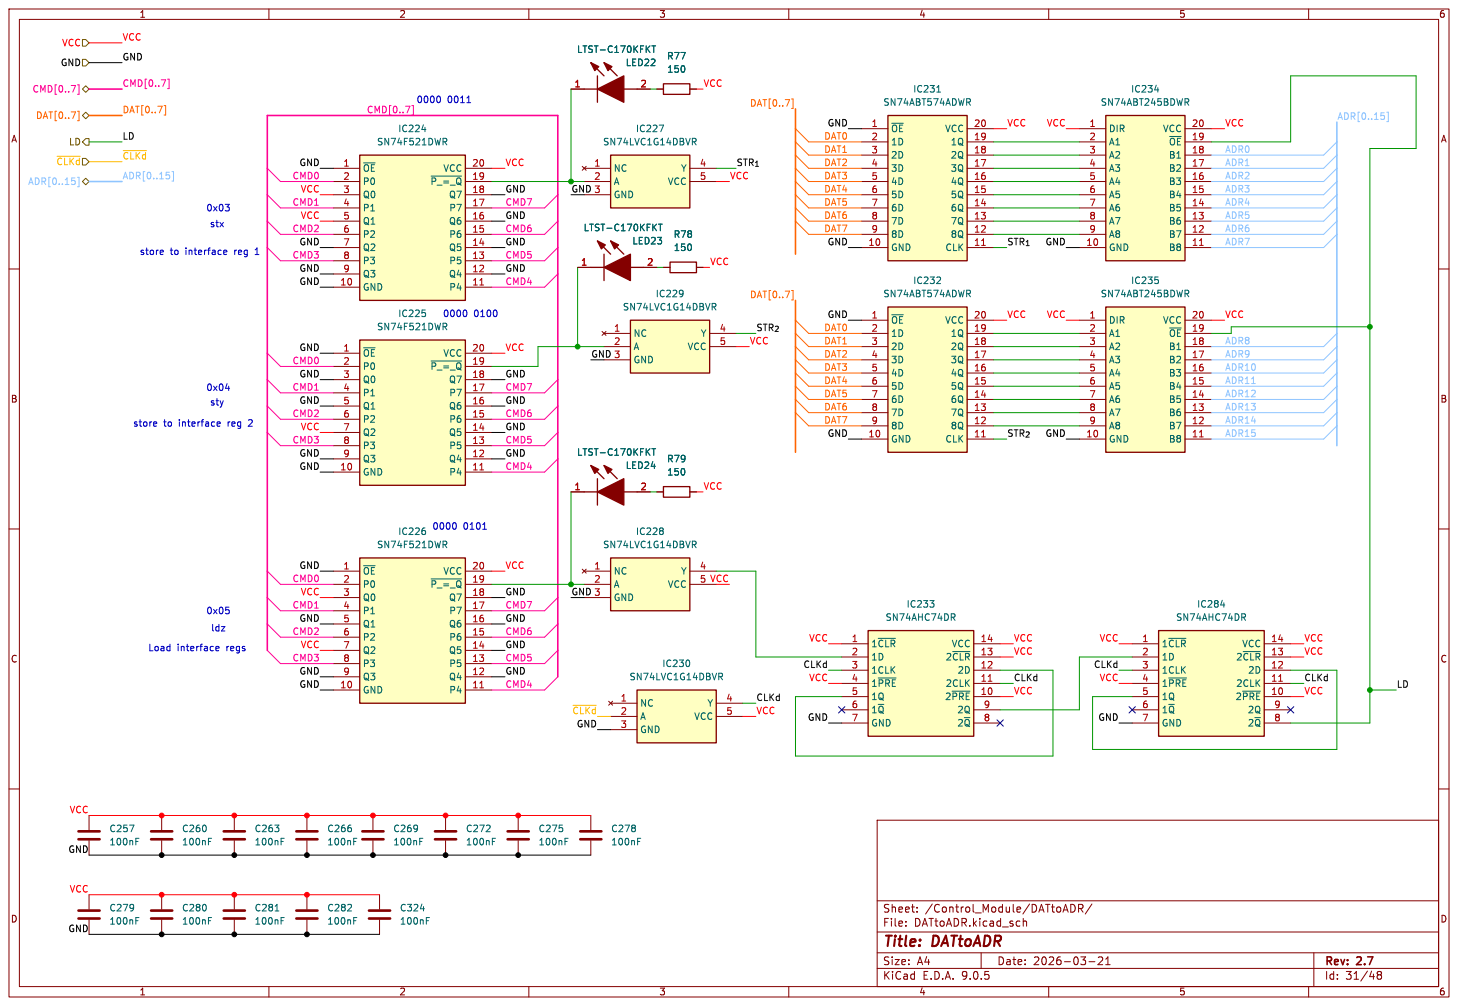
[picture p206: page 31]

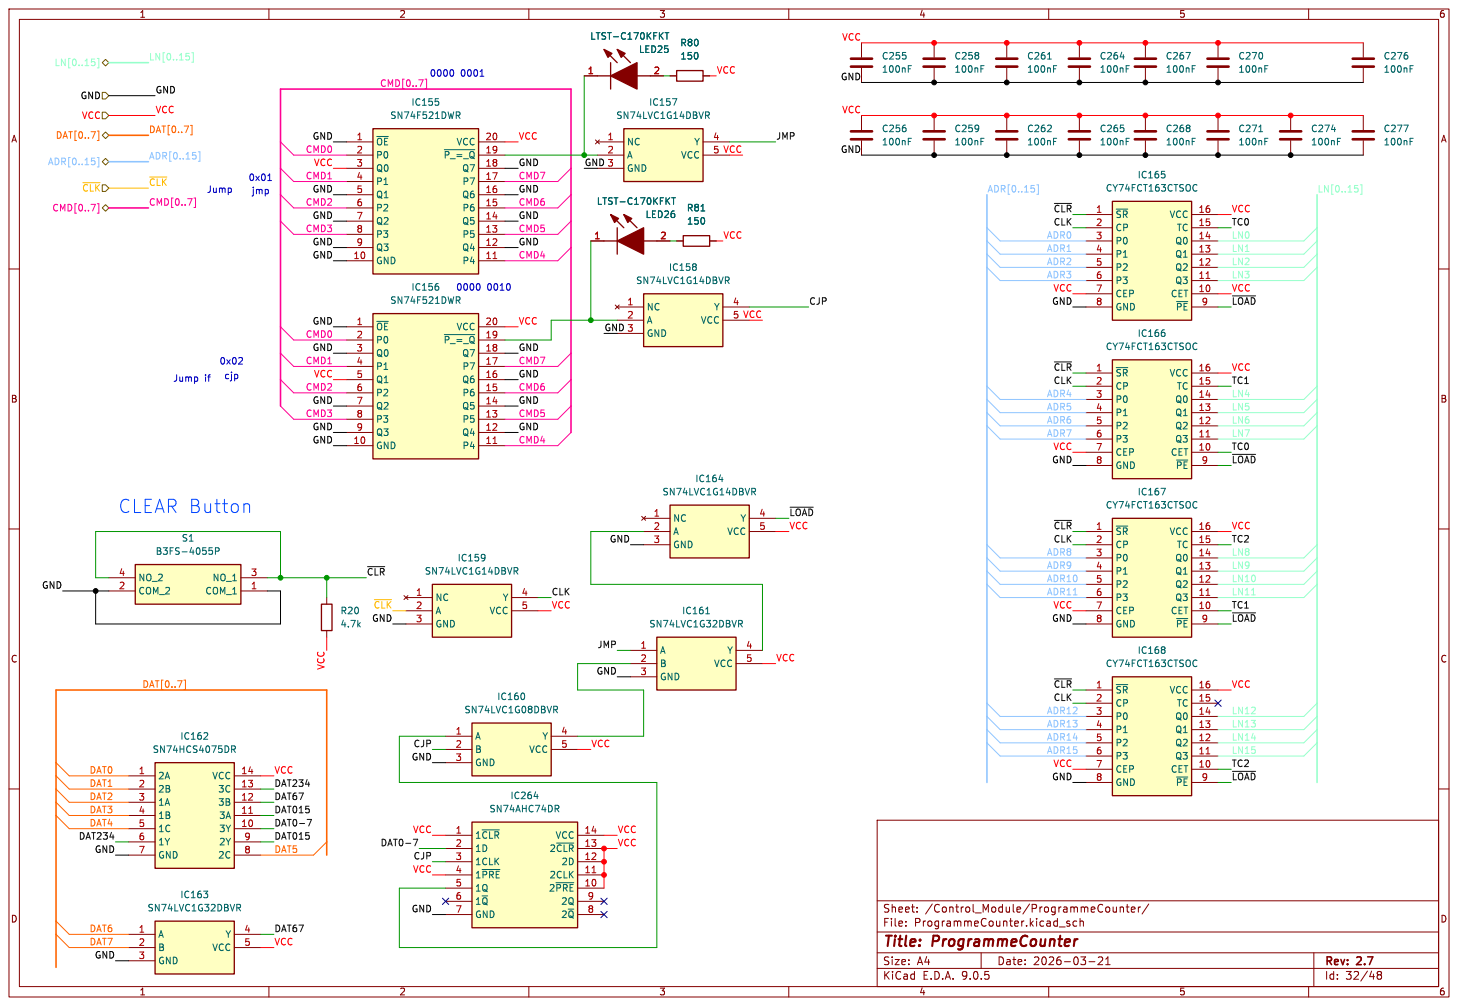
[picture p207: page 32]

Id: 32/48 Title: ProgrammeCounter File: ProgrammeCounter.kicad_sch Sheet: /Control_Module/ProgrammeCounter/

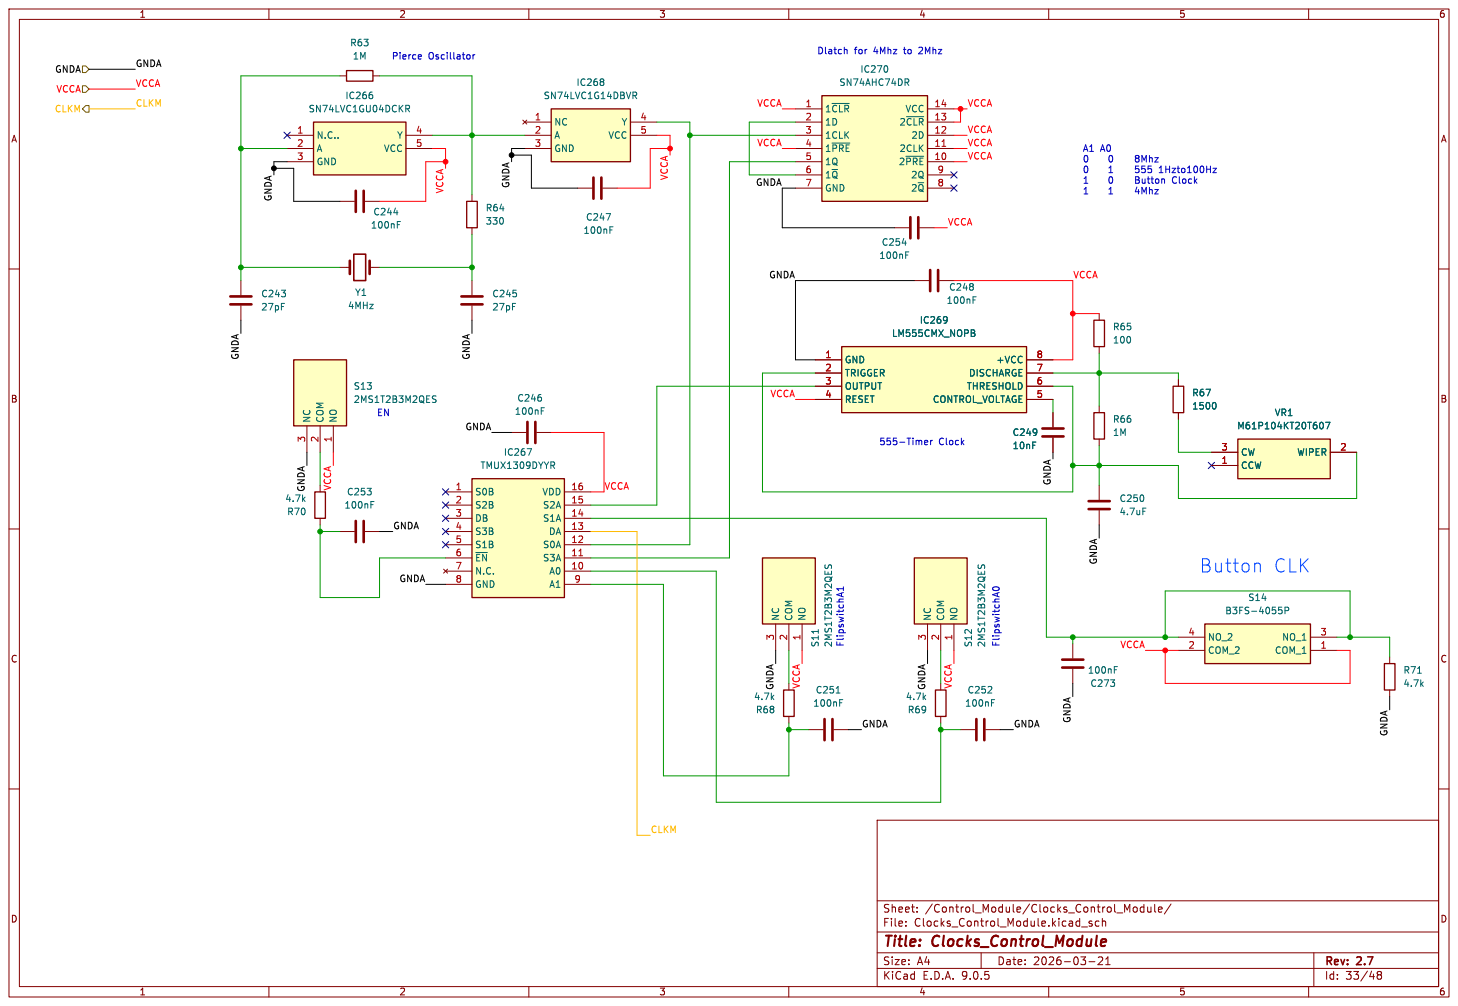
[picture p208: page 33]

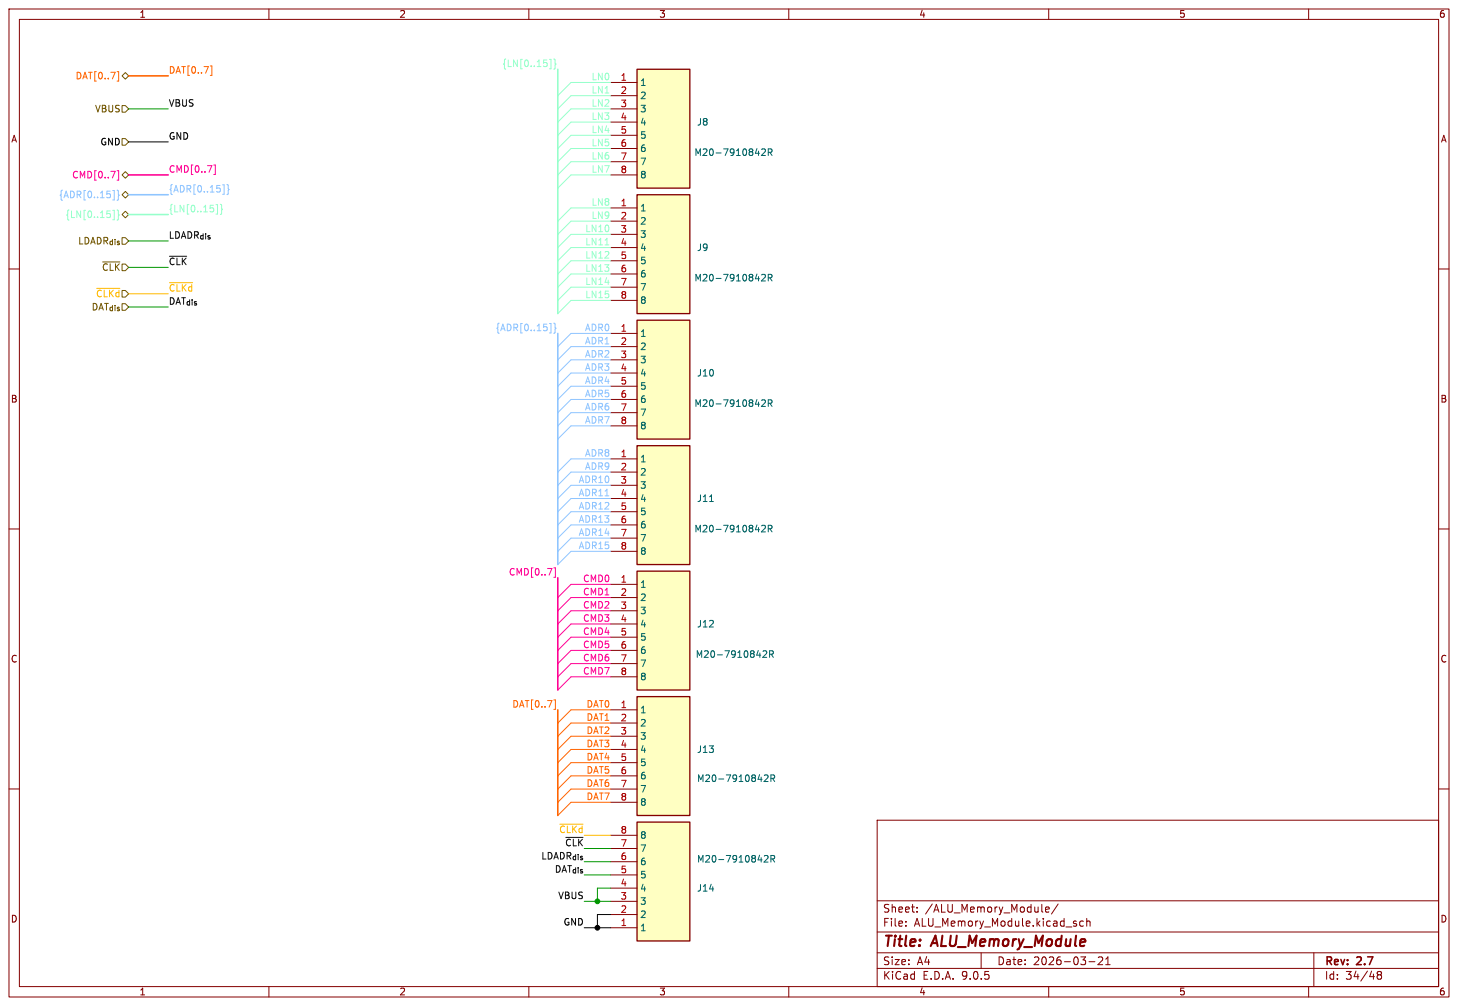
[picture p209: page 34]

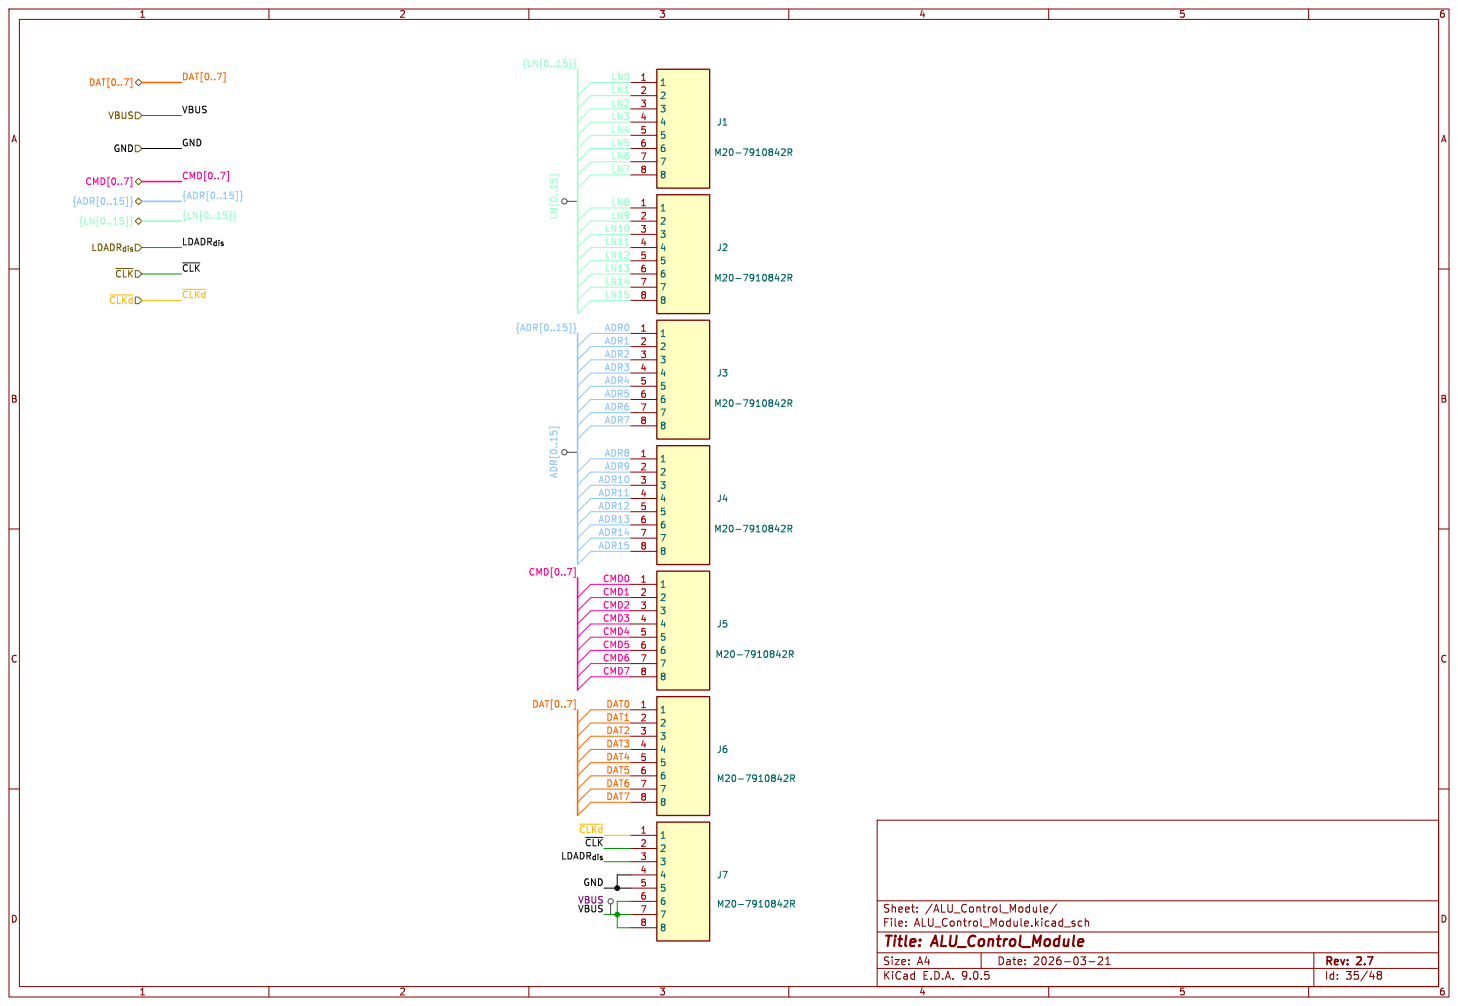
[picture p210: page 35]

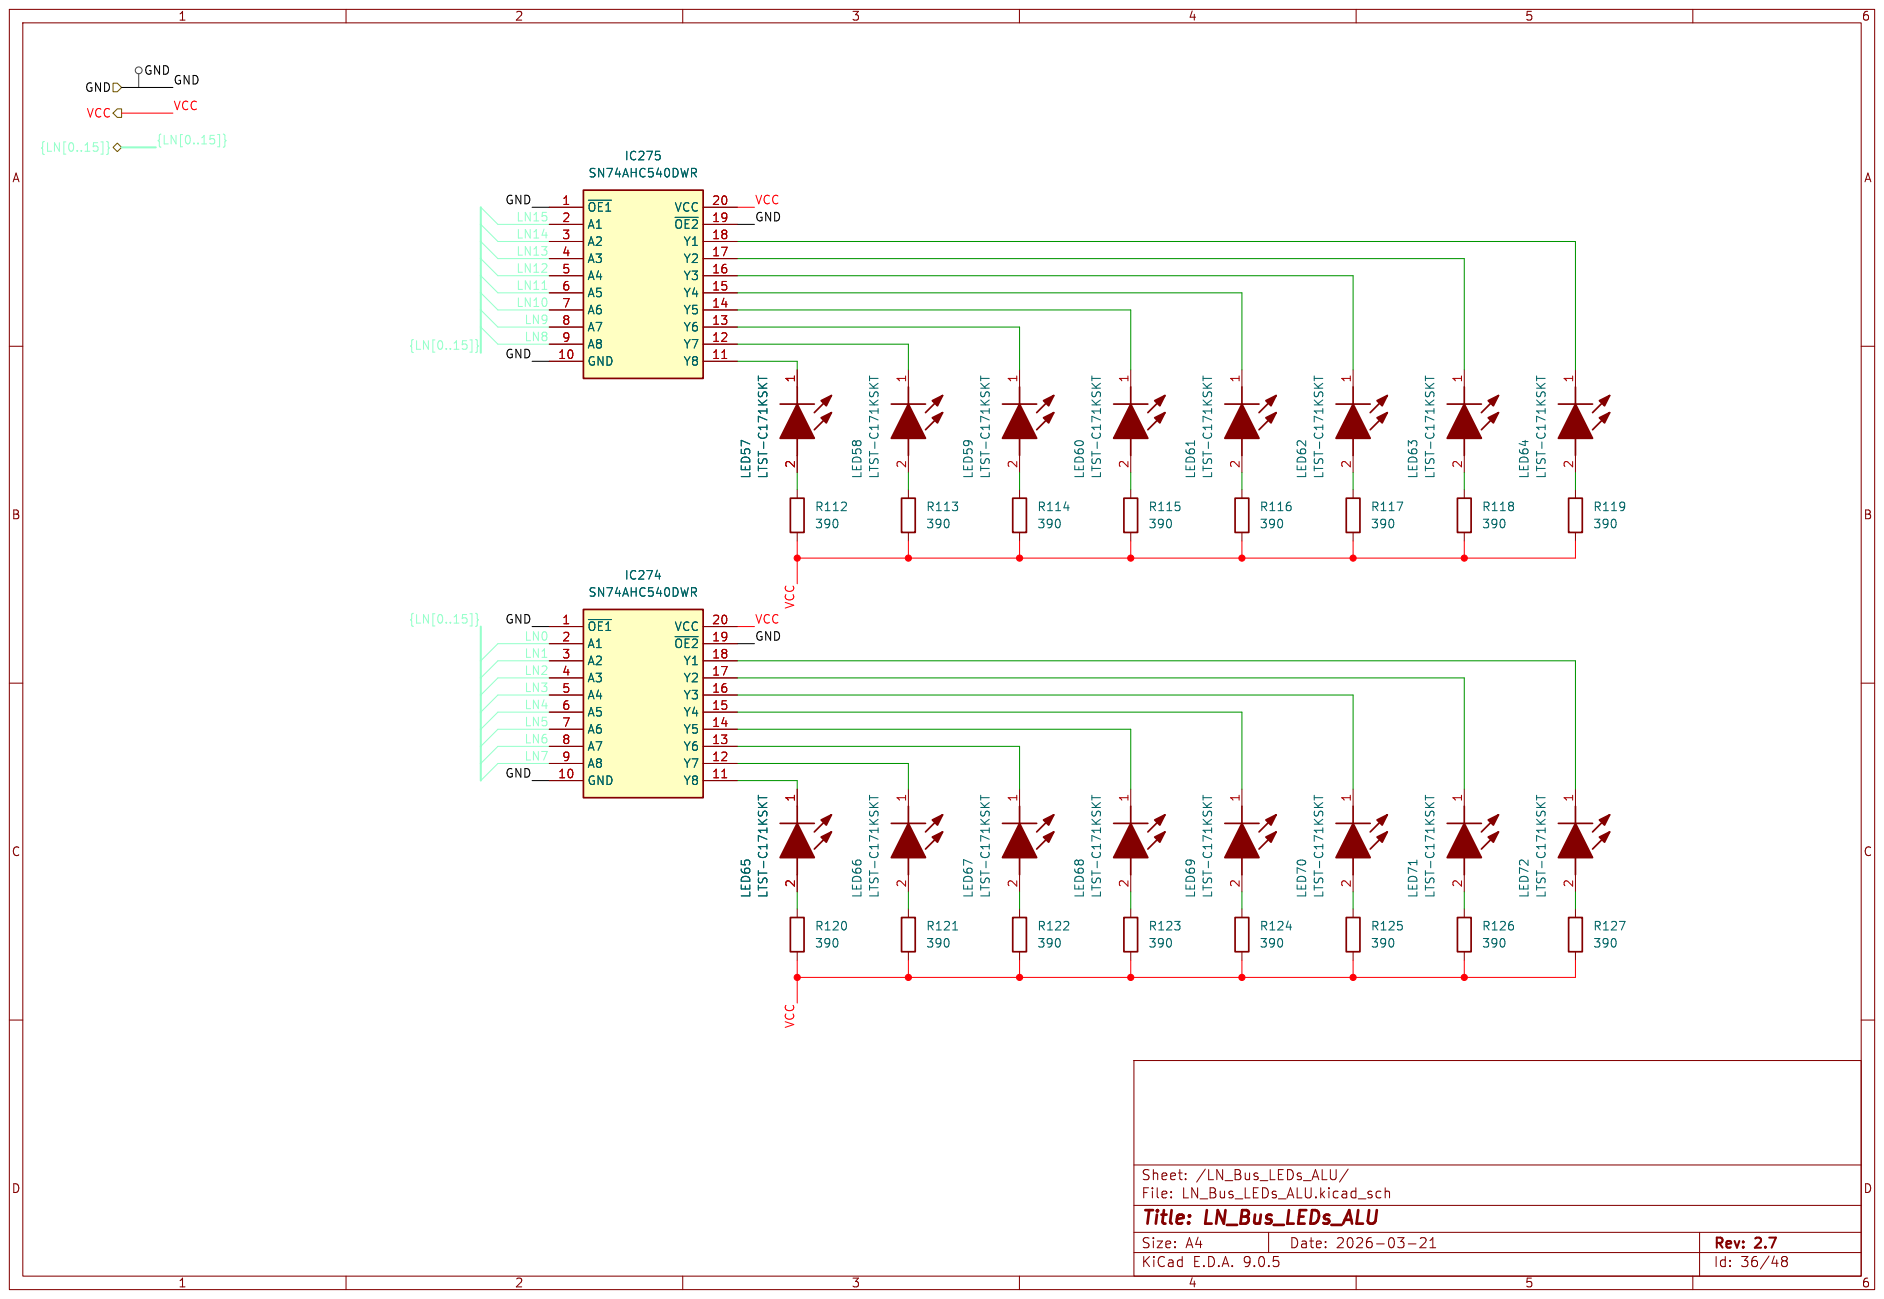
[picture p211: page 36]

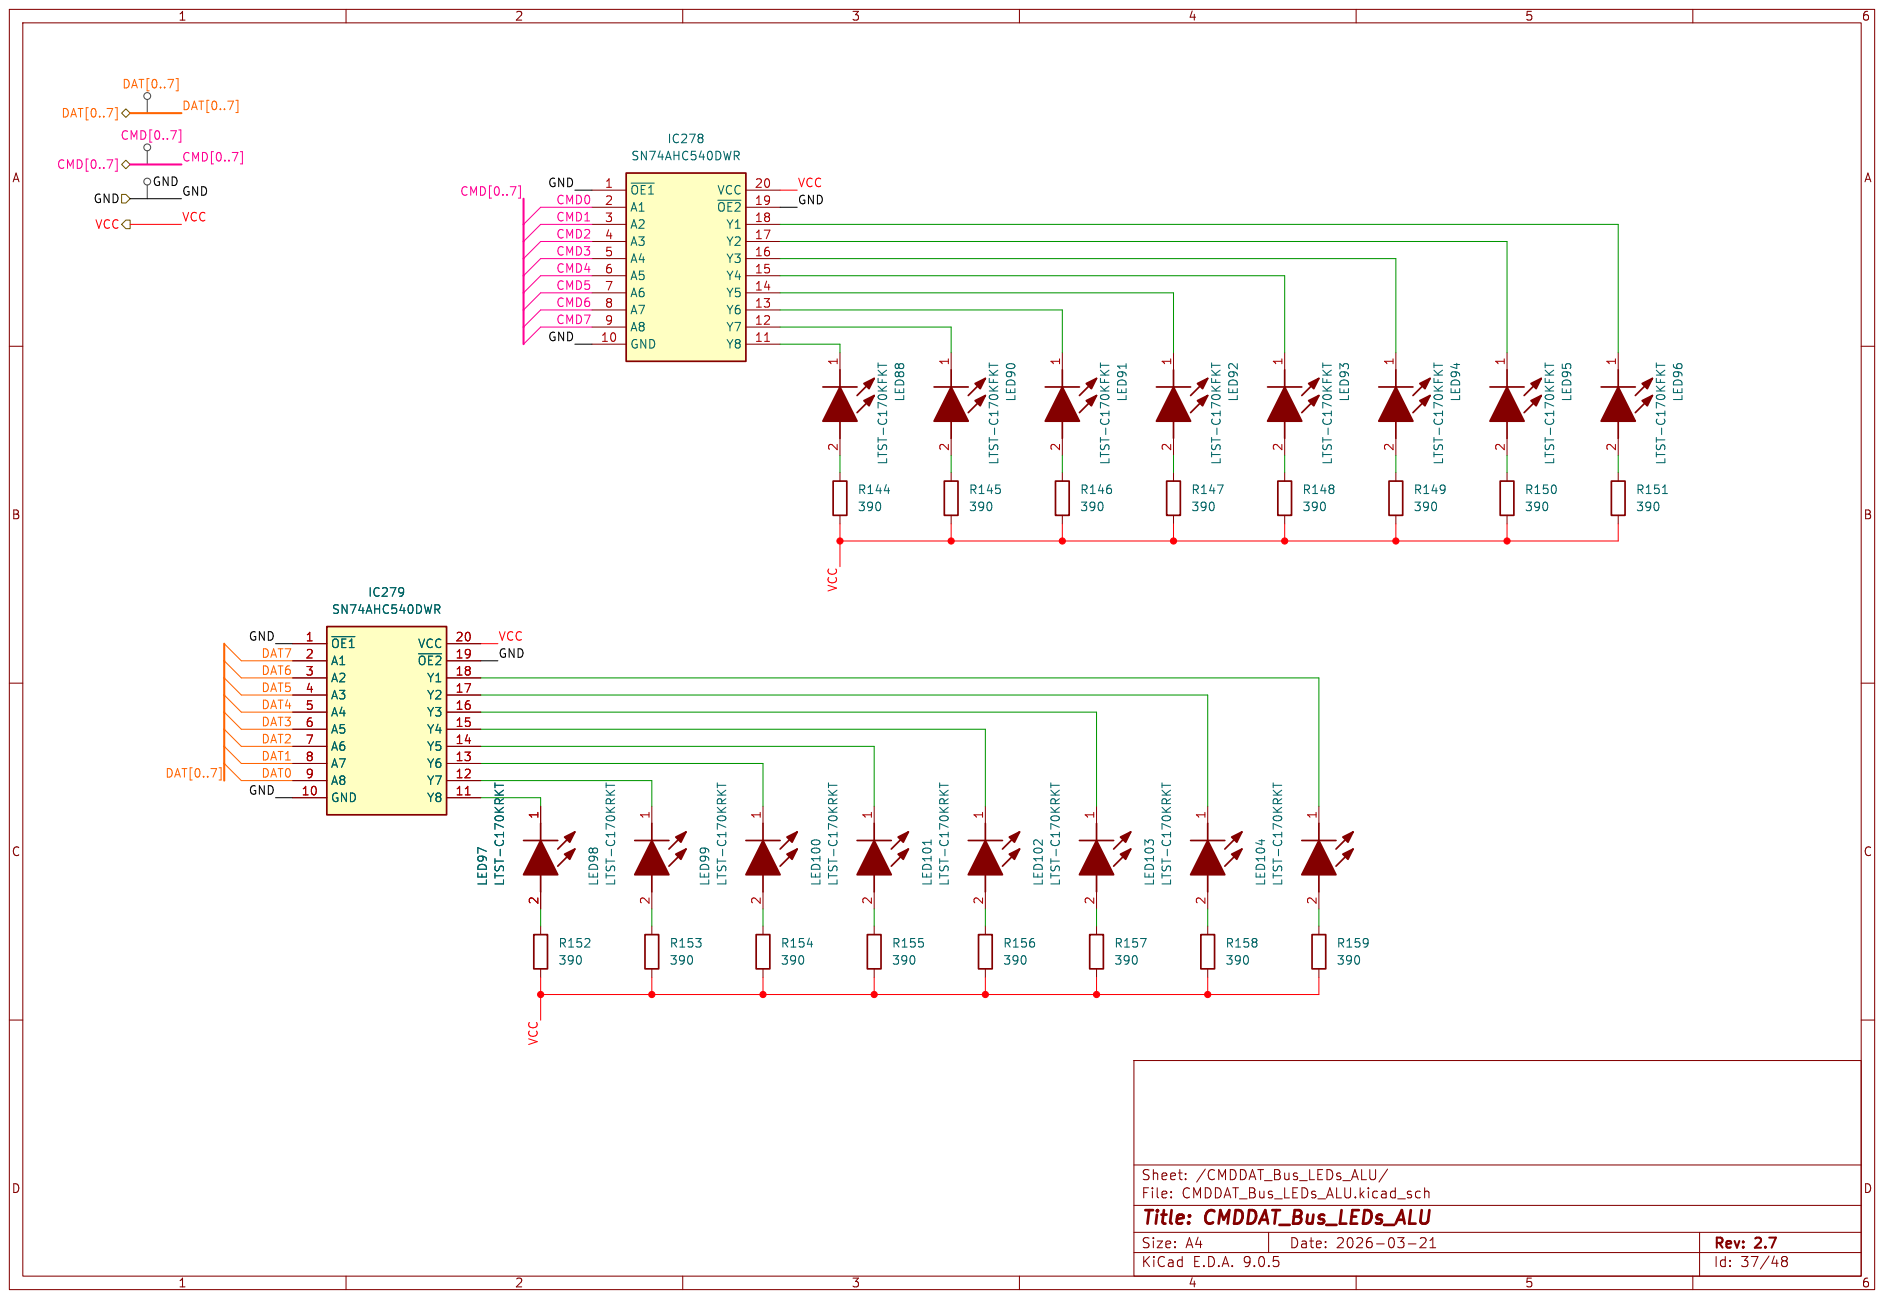
[picture p212: page 37]

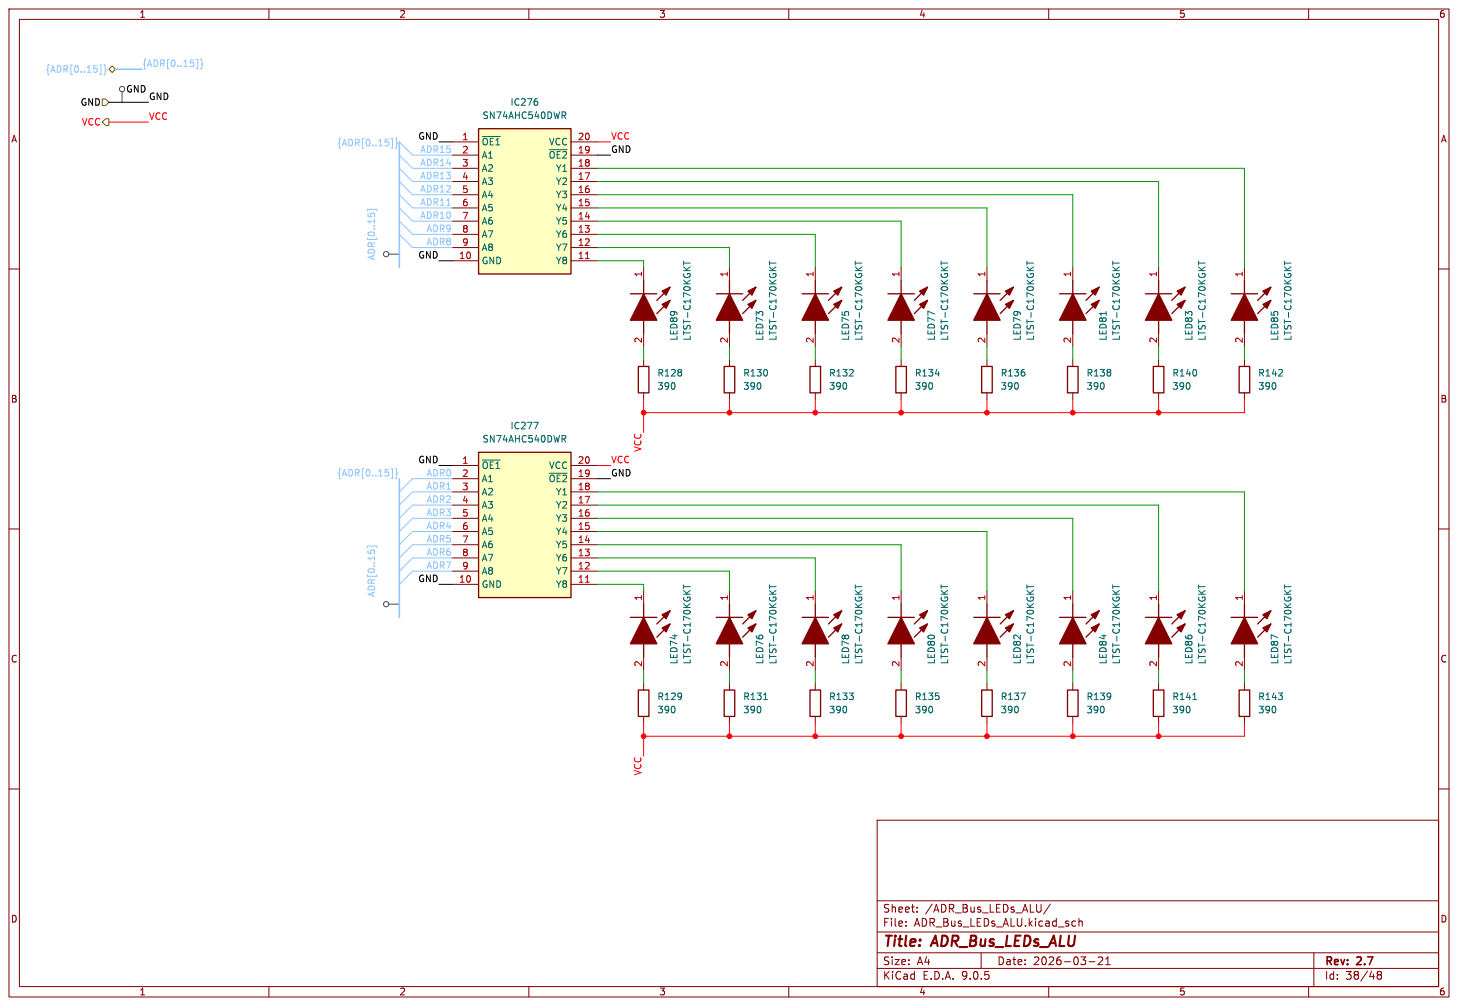
[picture p213: page 38]

IC277 SN74AHC540DWR ADR[0..15] ADR[0..15] GND GND

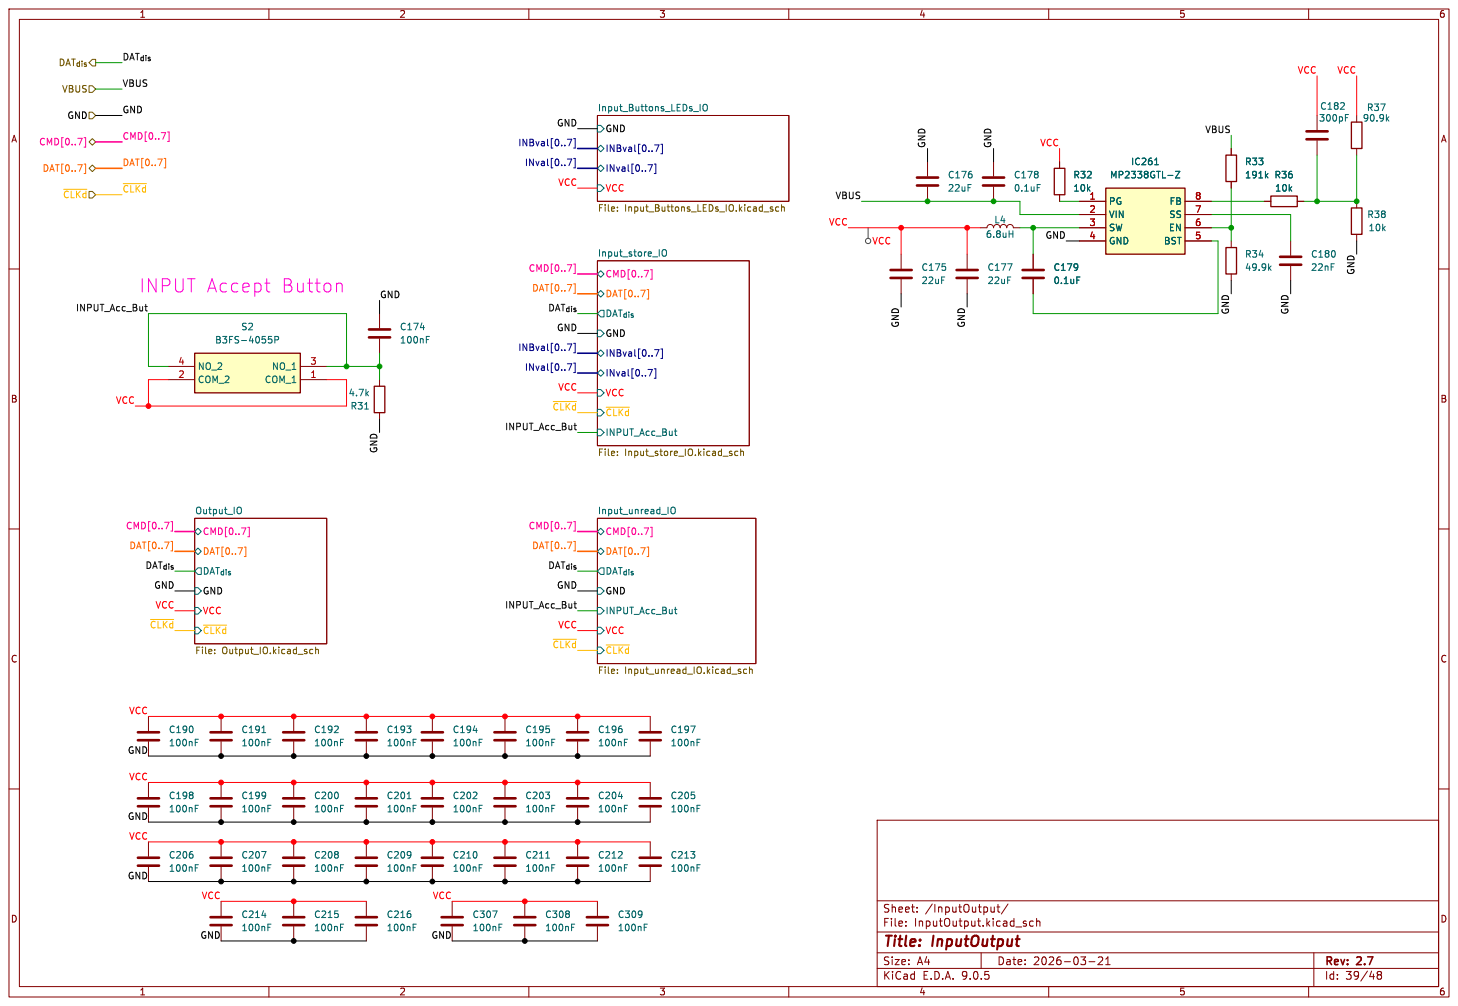
[picture p214: page 39]

Id: 39/48 Title: InputOutput File: InputOutput.kicad_sch Sheet: /InputOutput/

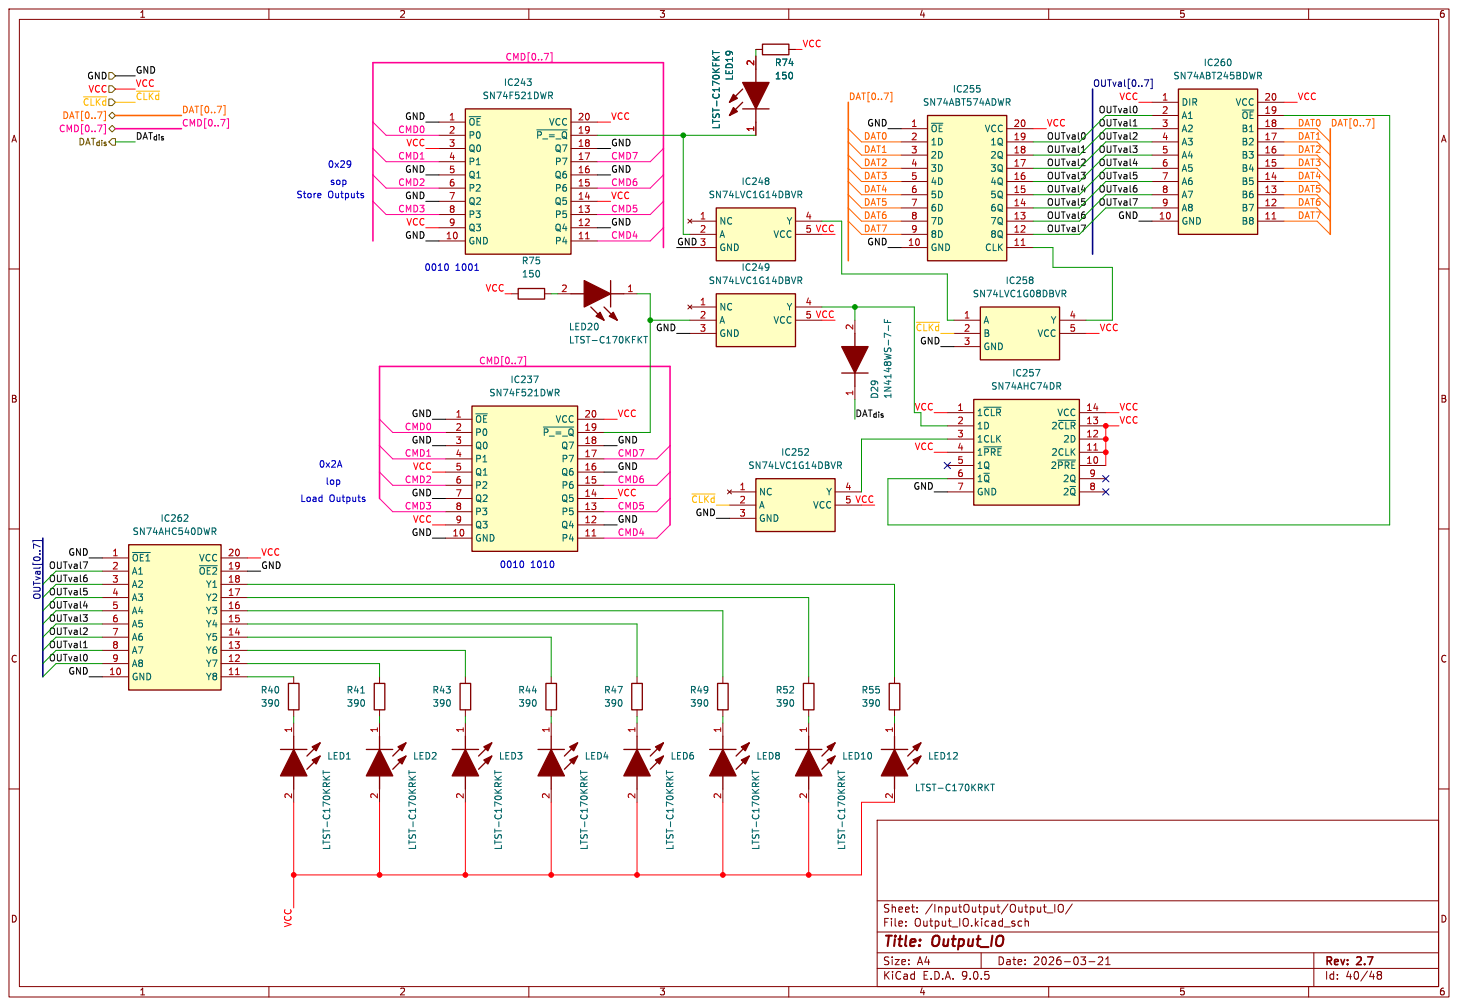
[picture p215: page 40]

0010 1010 Store Outputs Load Outputs

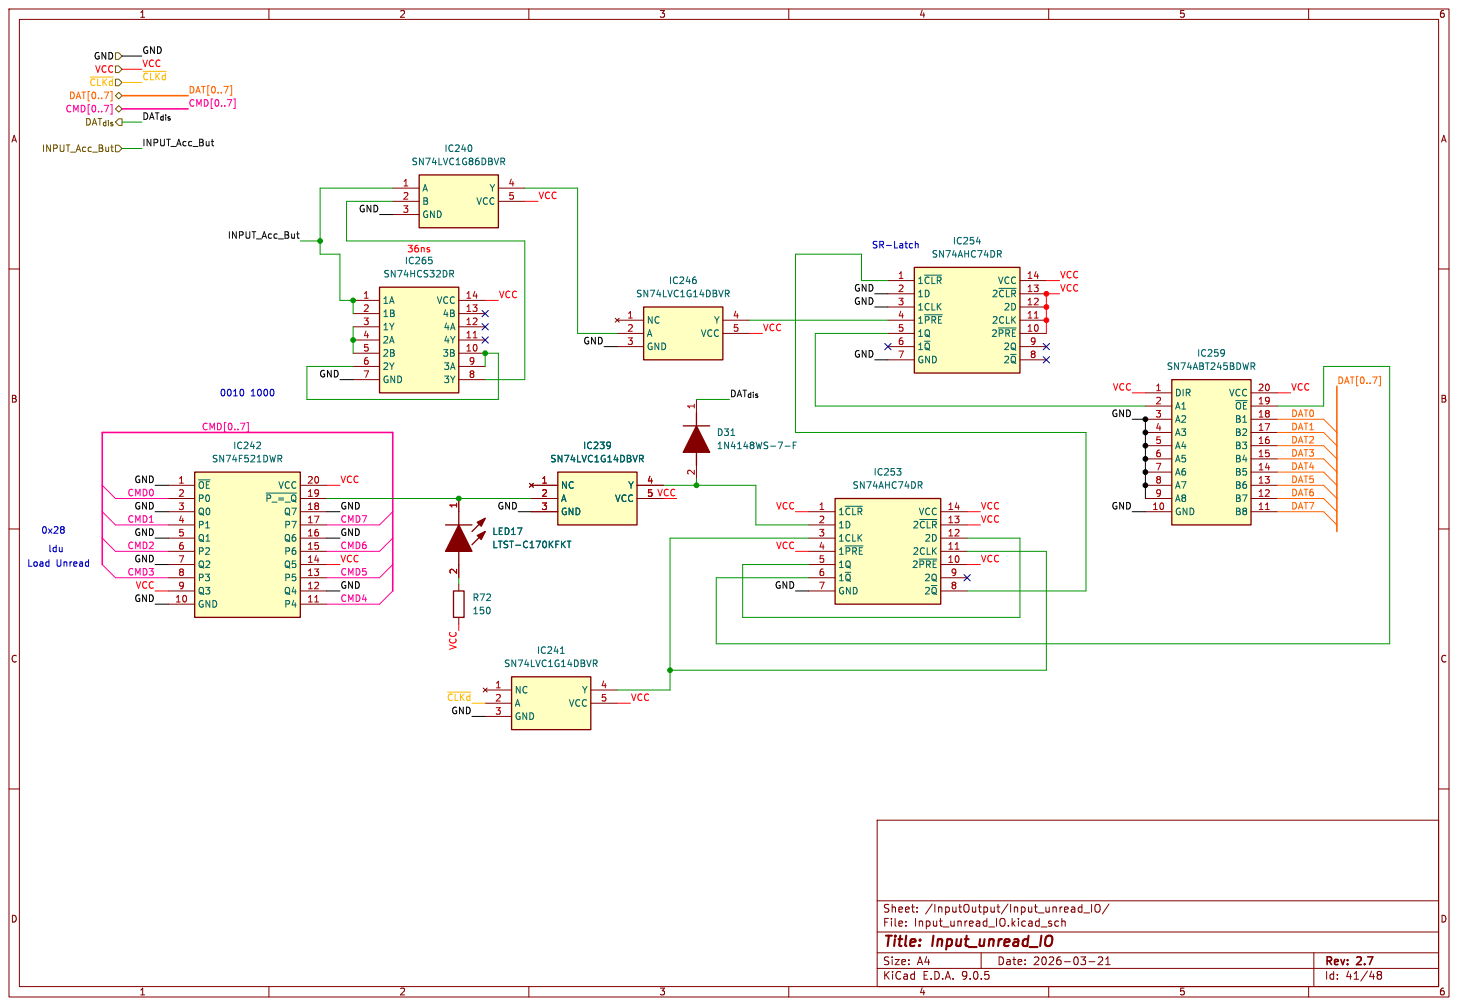
[picture p216: page 41]

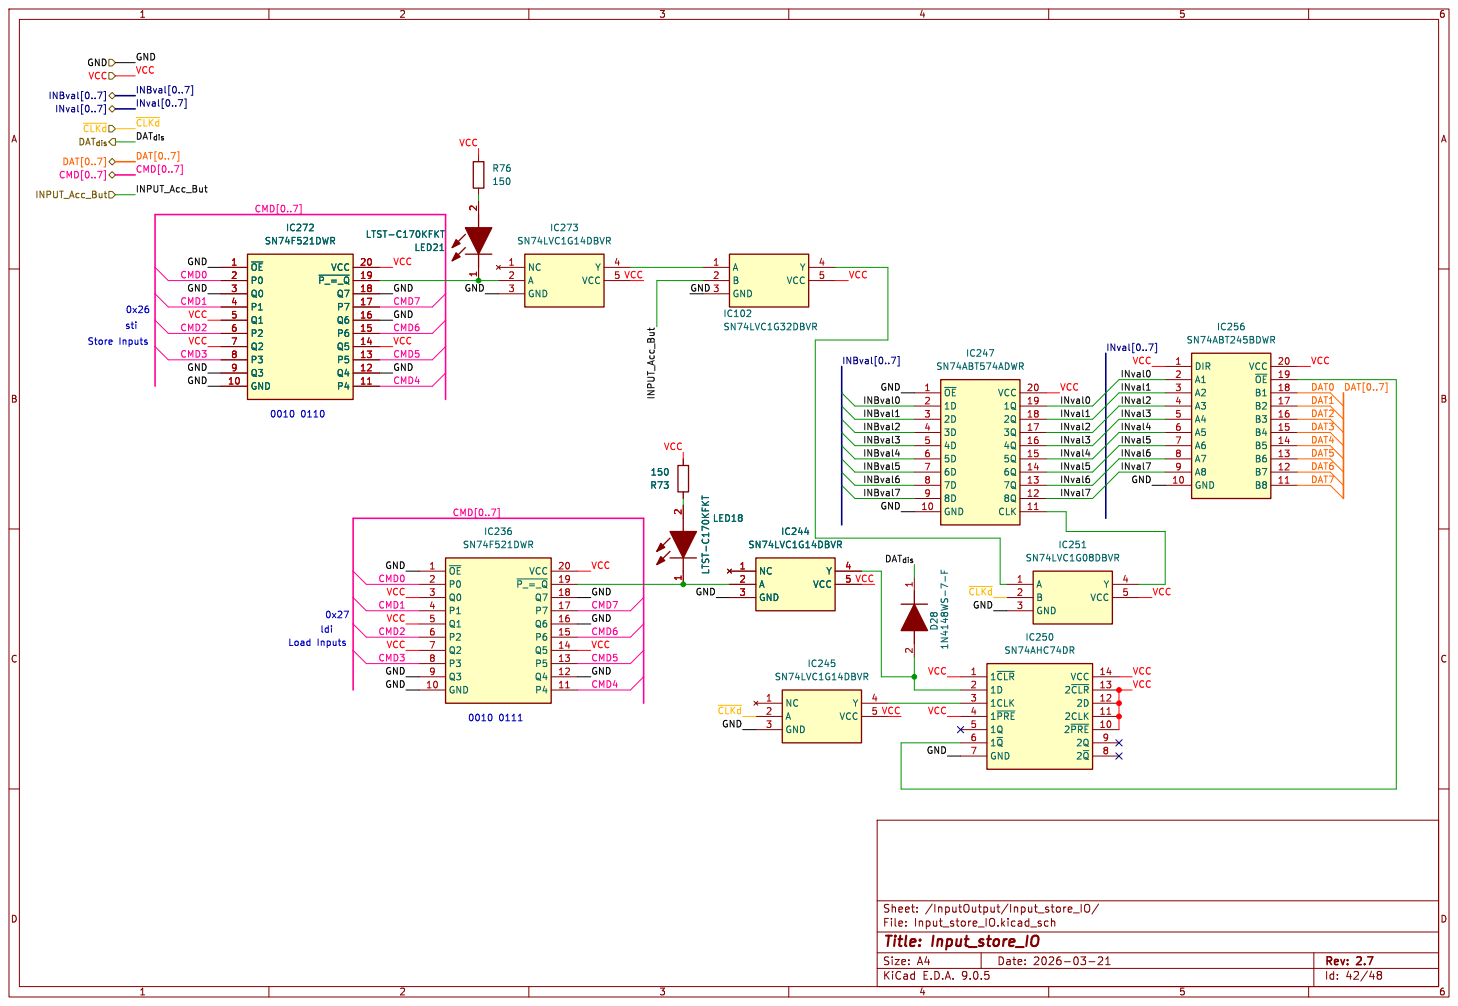
[picture p217: page 42]

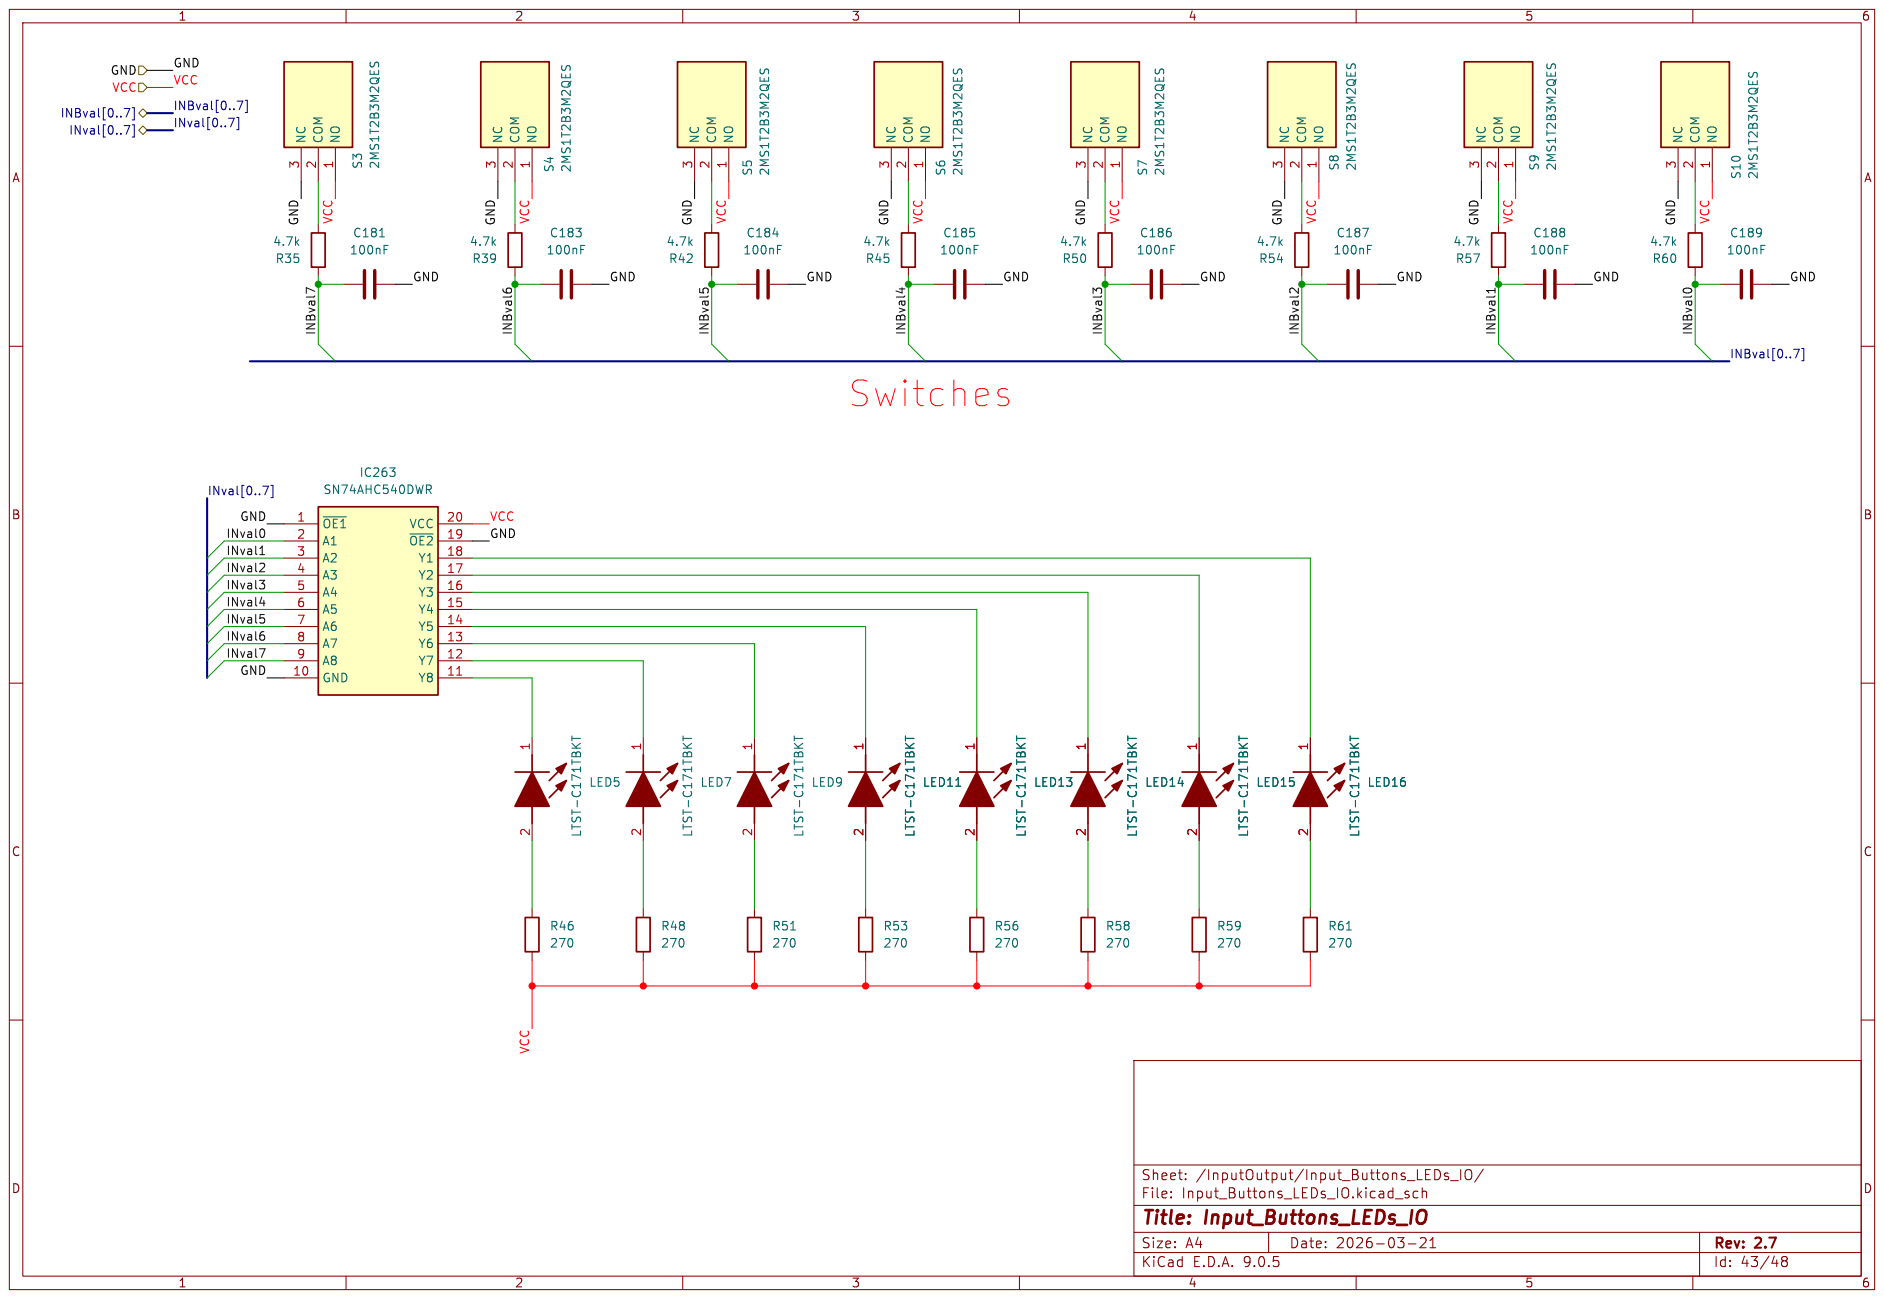
[picture p218: page 43]

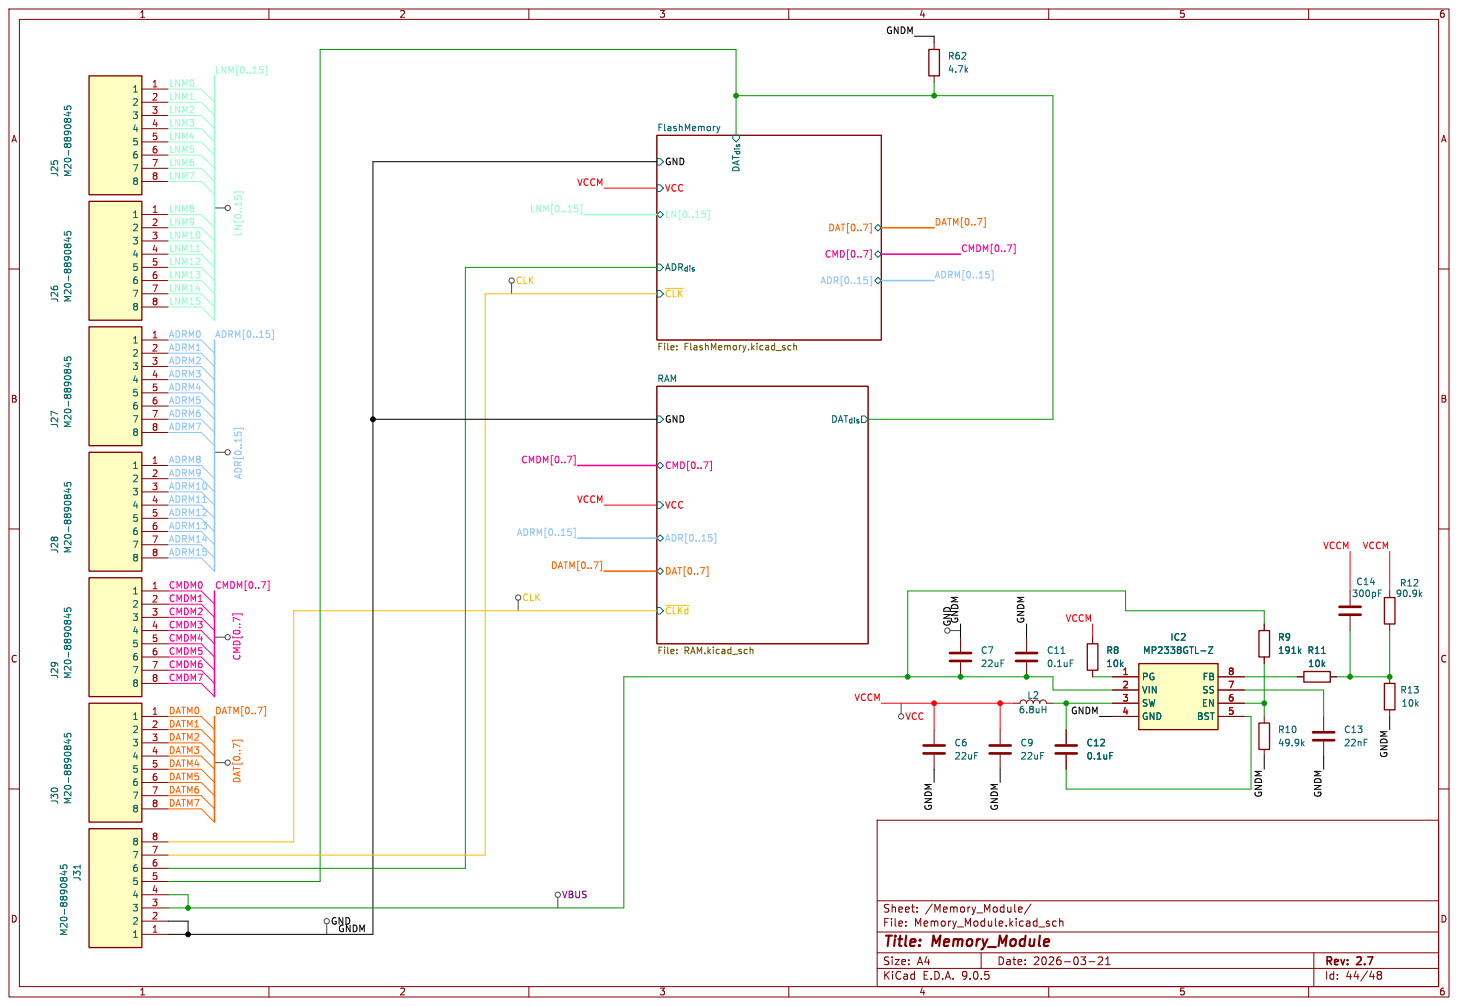
[picture p219: page 44]

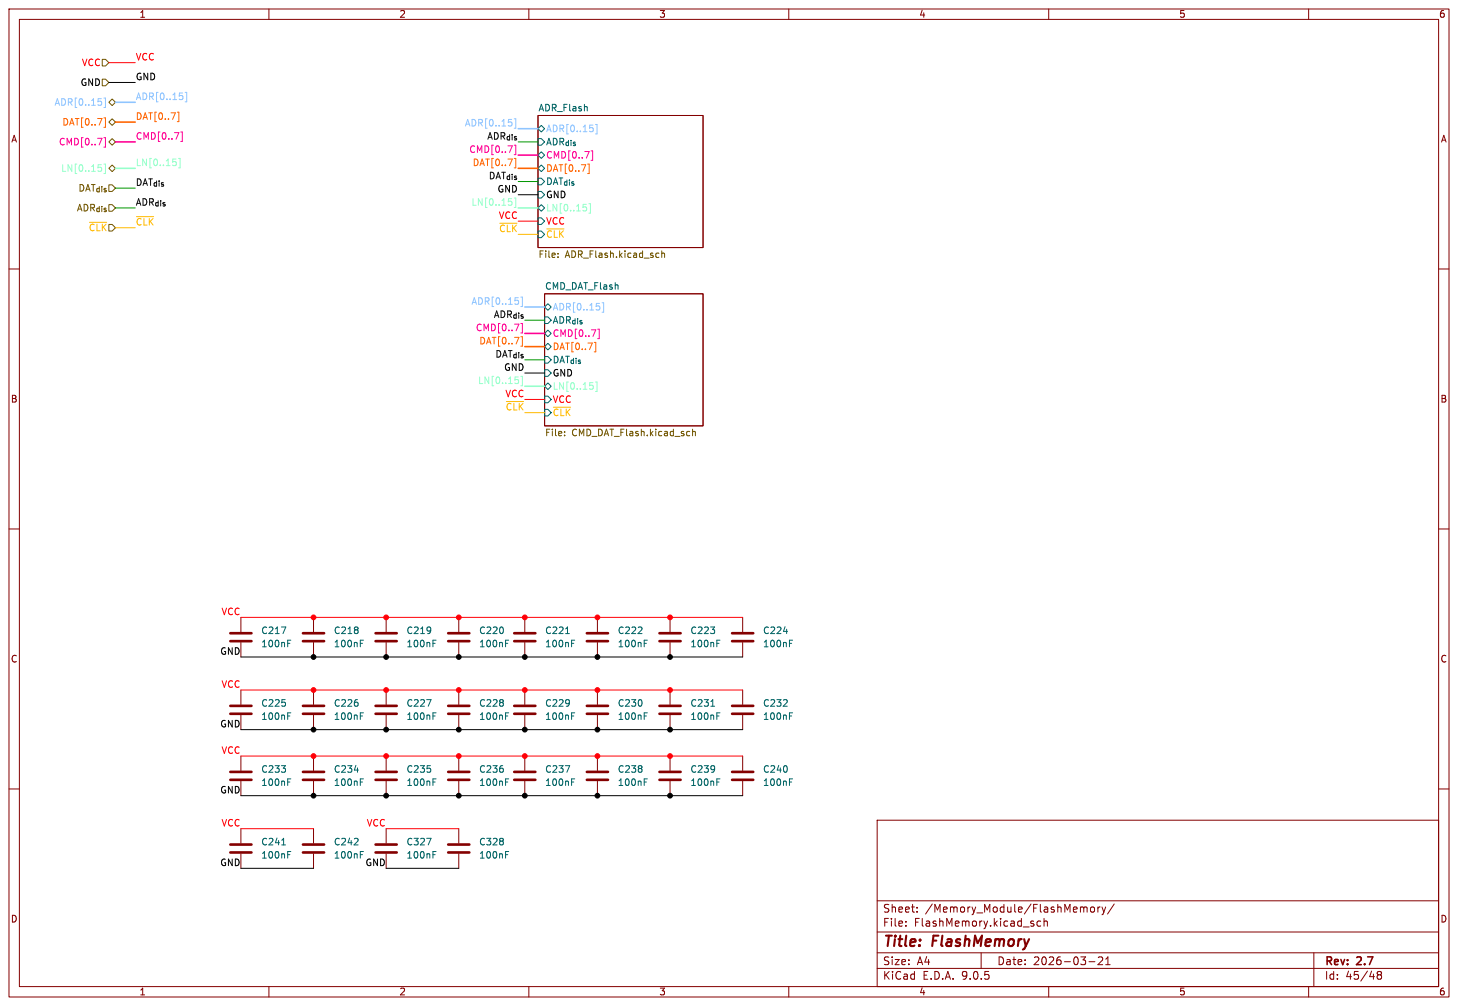
[picture p220: page 45]

File: FlashMemory.kicad_sch Sheet: /Memory_Module/FlashMemory/
Id: 45/48 Title: FlashMemory

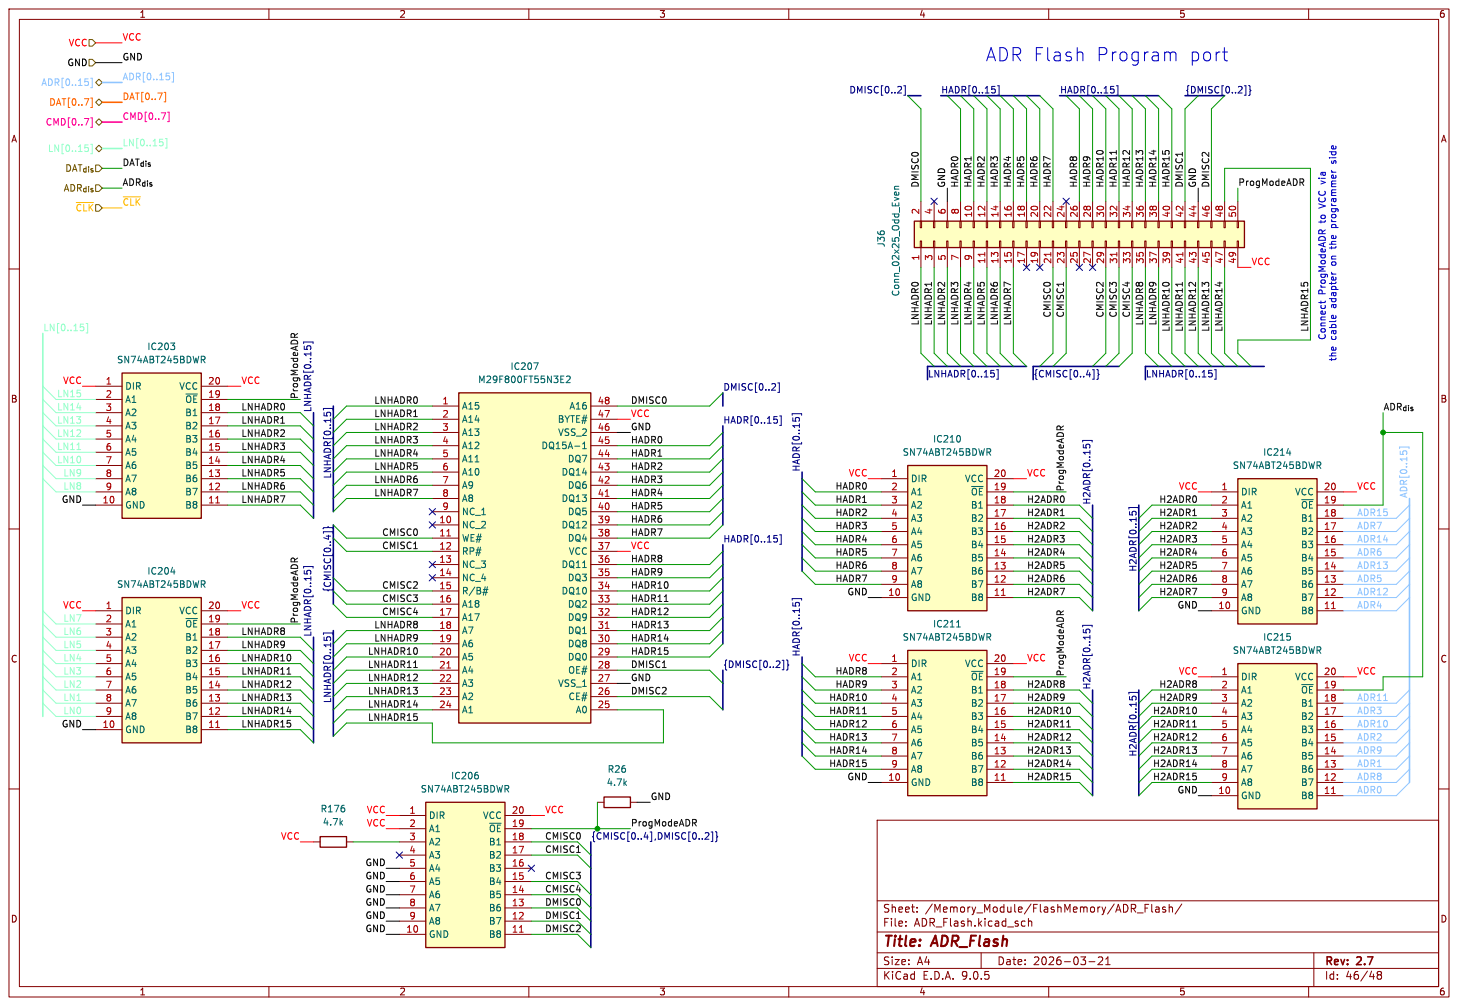
[picture p221: page 46]

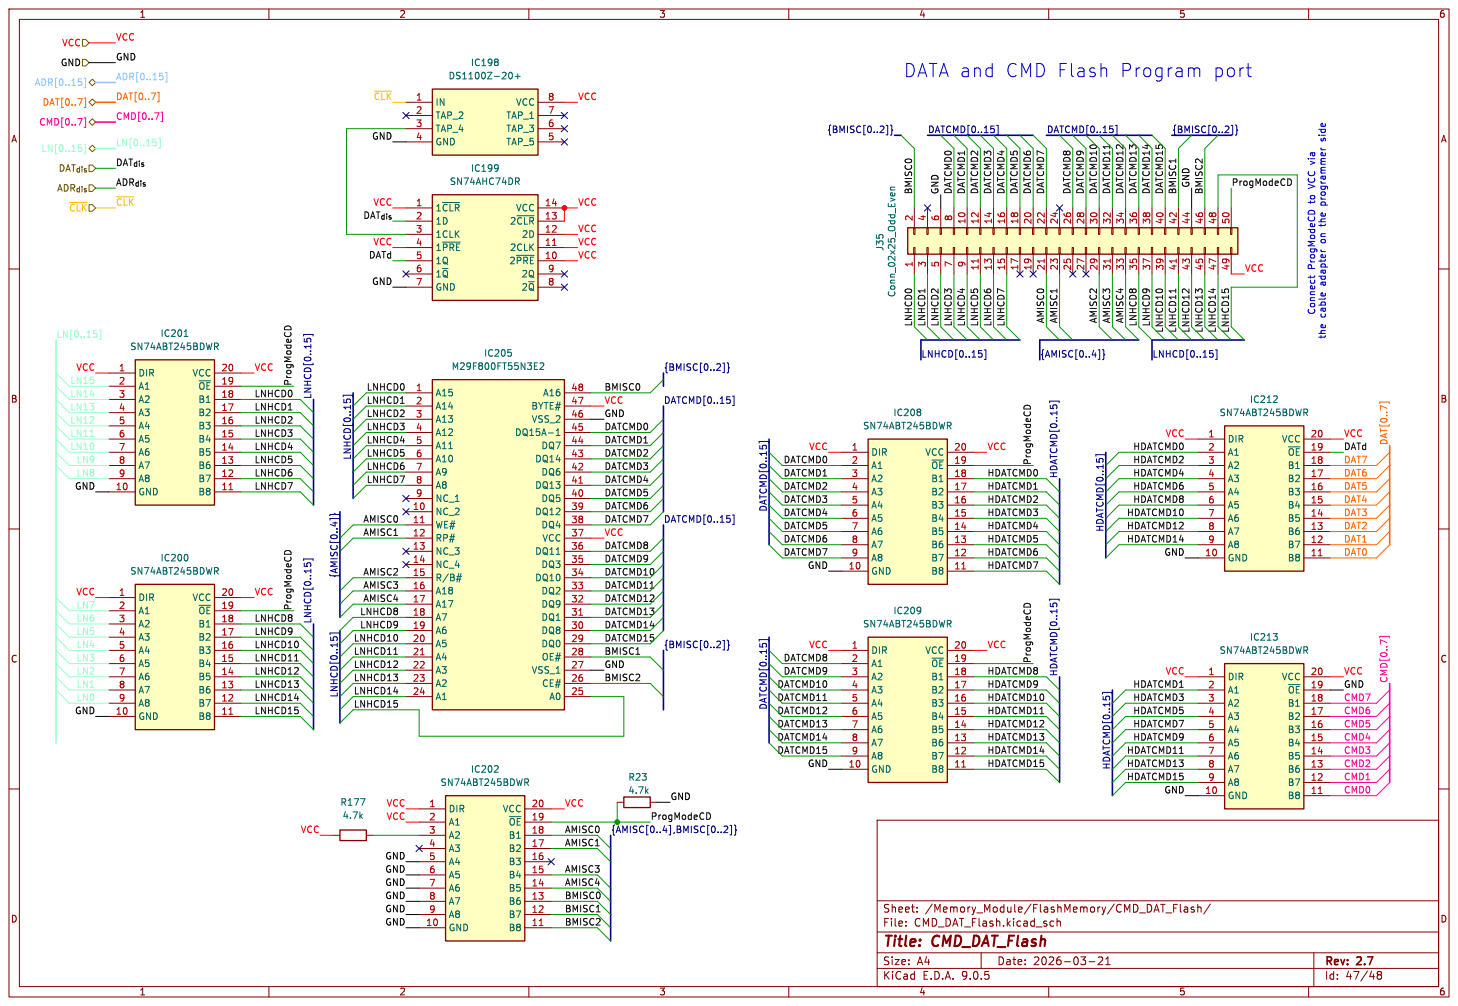
[picture p222: page 47]

DATA and CMD Flash Program port

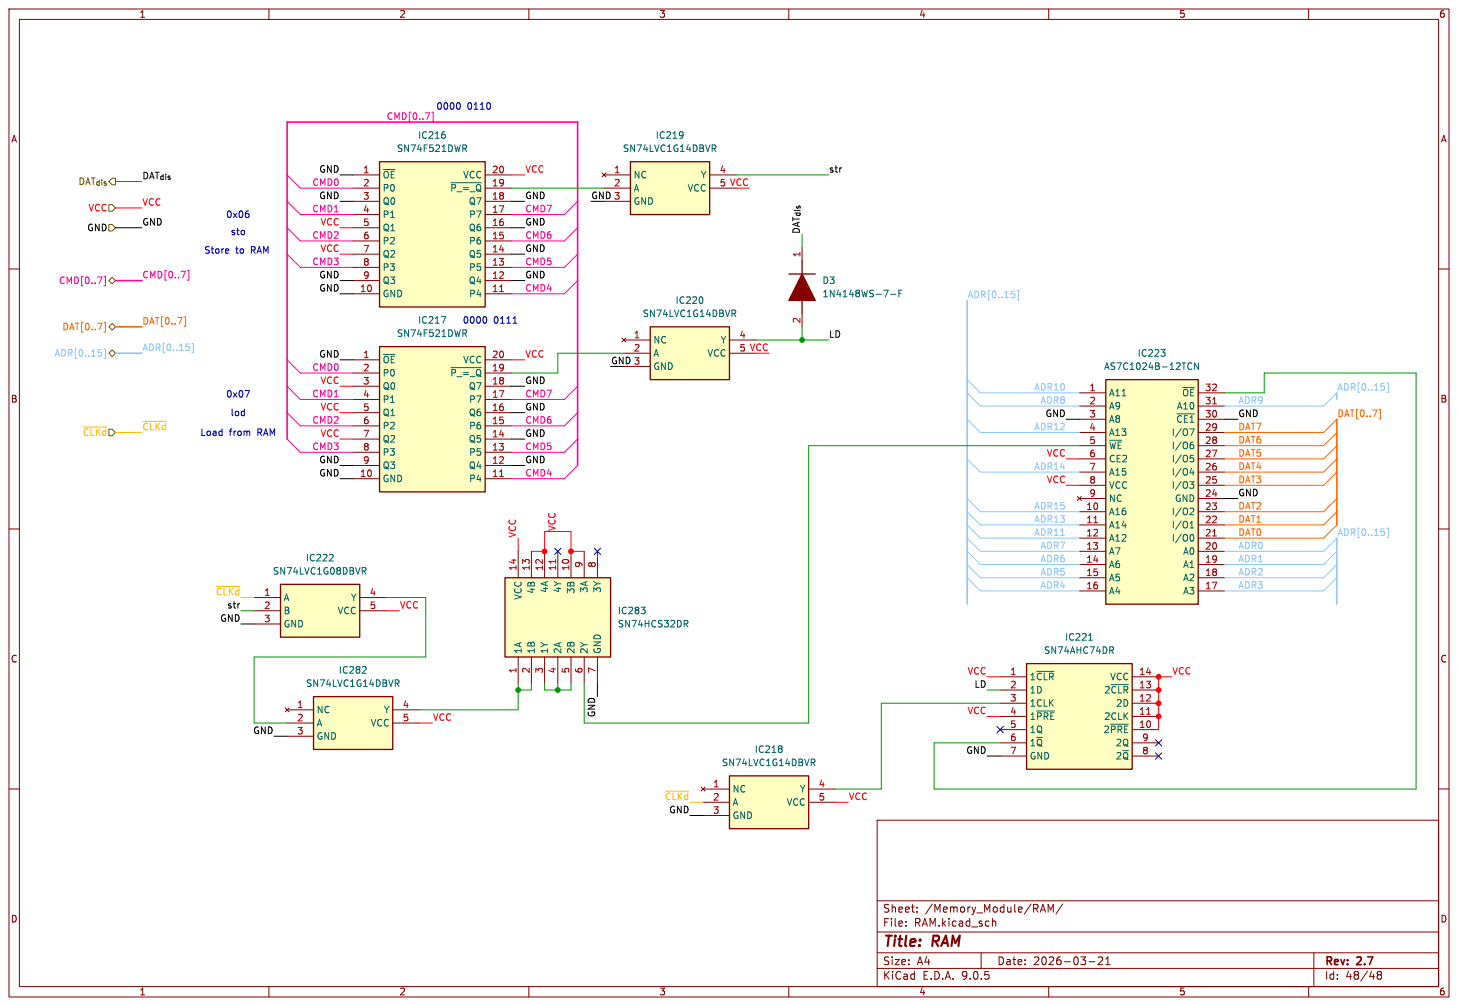
[picture p223: page 48]
