SSCsimsi/8Bit_Computer/8Bit Computer ver2.0/Kicad/Computer/Computer-ALU.pdf

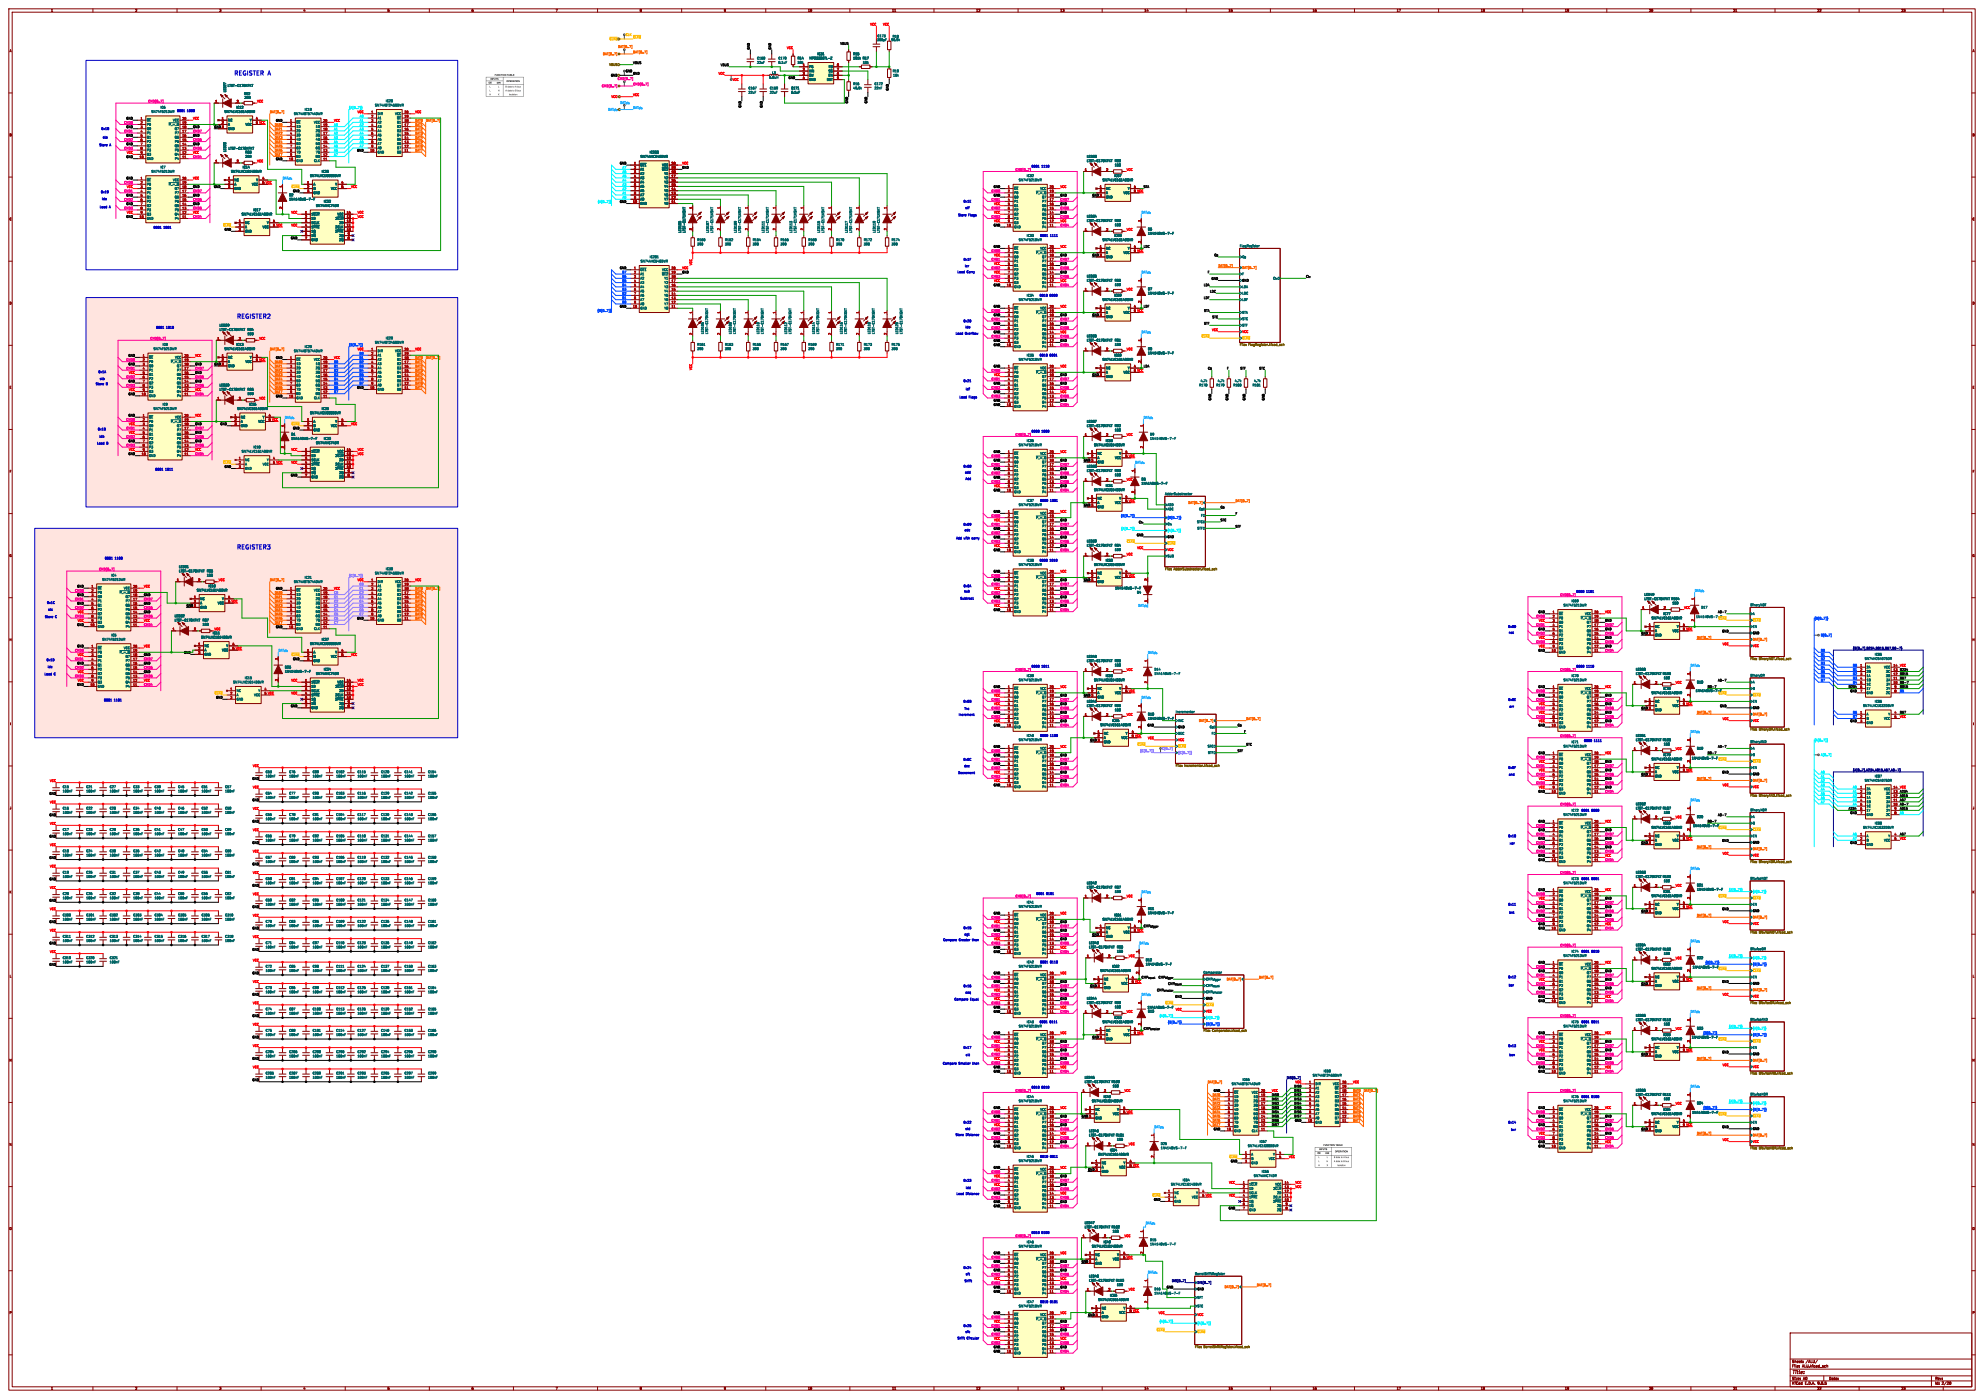
[picture p224: page 1]

VCC GND GND GND
CMD3 CMD2 CMD1

IC33 SN74F521DWR
Load Carry Load Overflow

~{CLKd} AdderSubstractor File: AdderSubstractor.kicad_sch

IC72 SN74F521DWR
CMD3 CMD2 VCC GND GND GND

CMD5 CMD6 VCC

Id: 2/20 Title: File: ALU.kicad_sch Sheet: /ALU/
