SSCsimsi/8Bit_Computer/8Bit Computer ver2.0/Kicad/Computer/Computer-DATtoADR.pdf

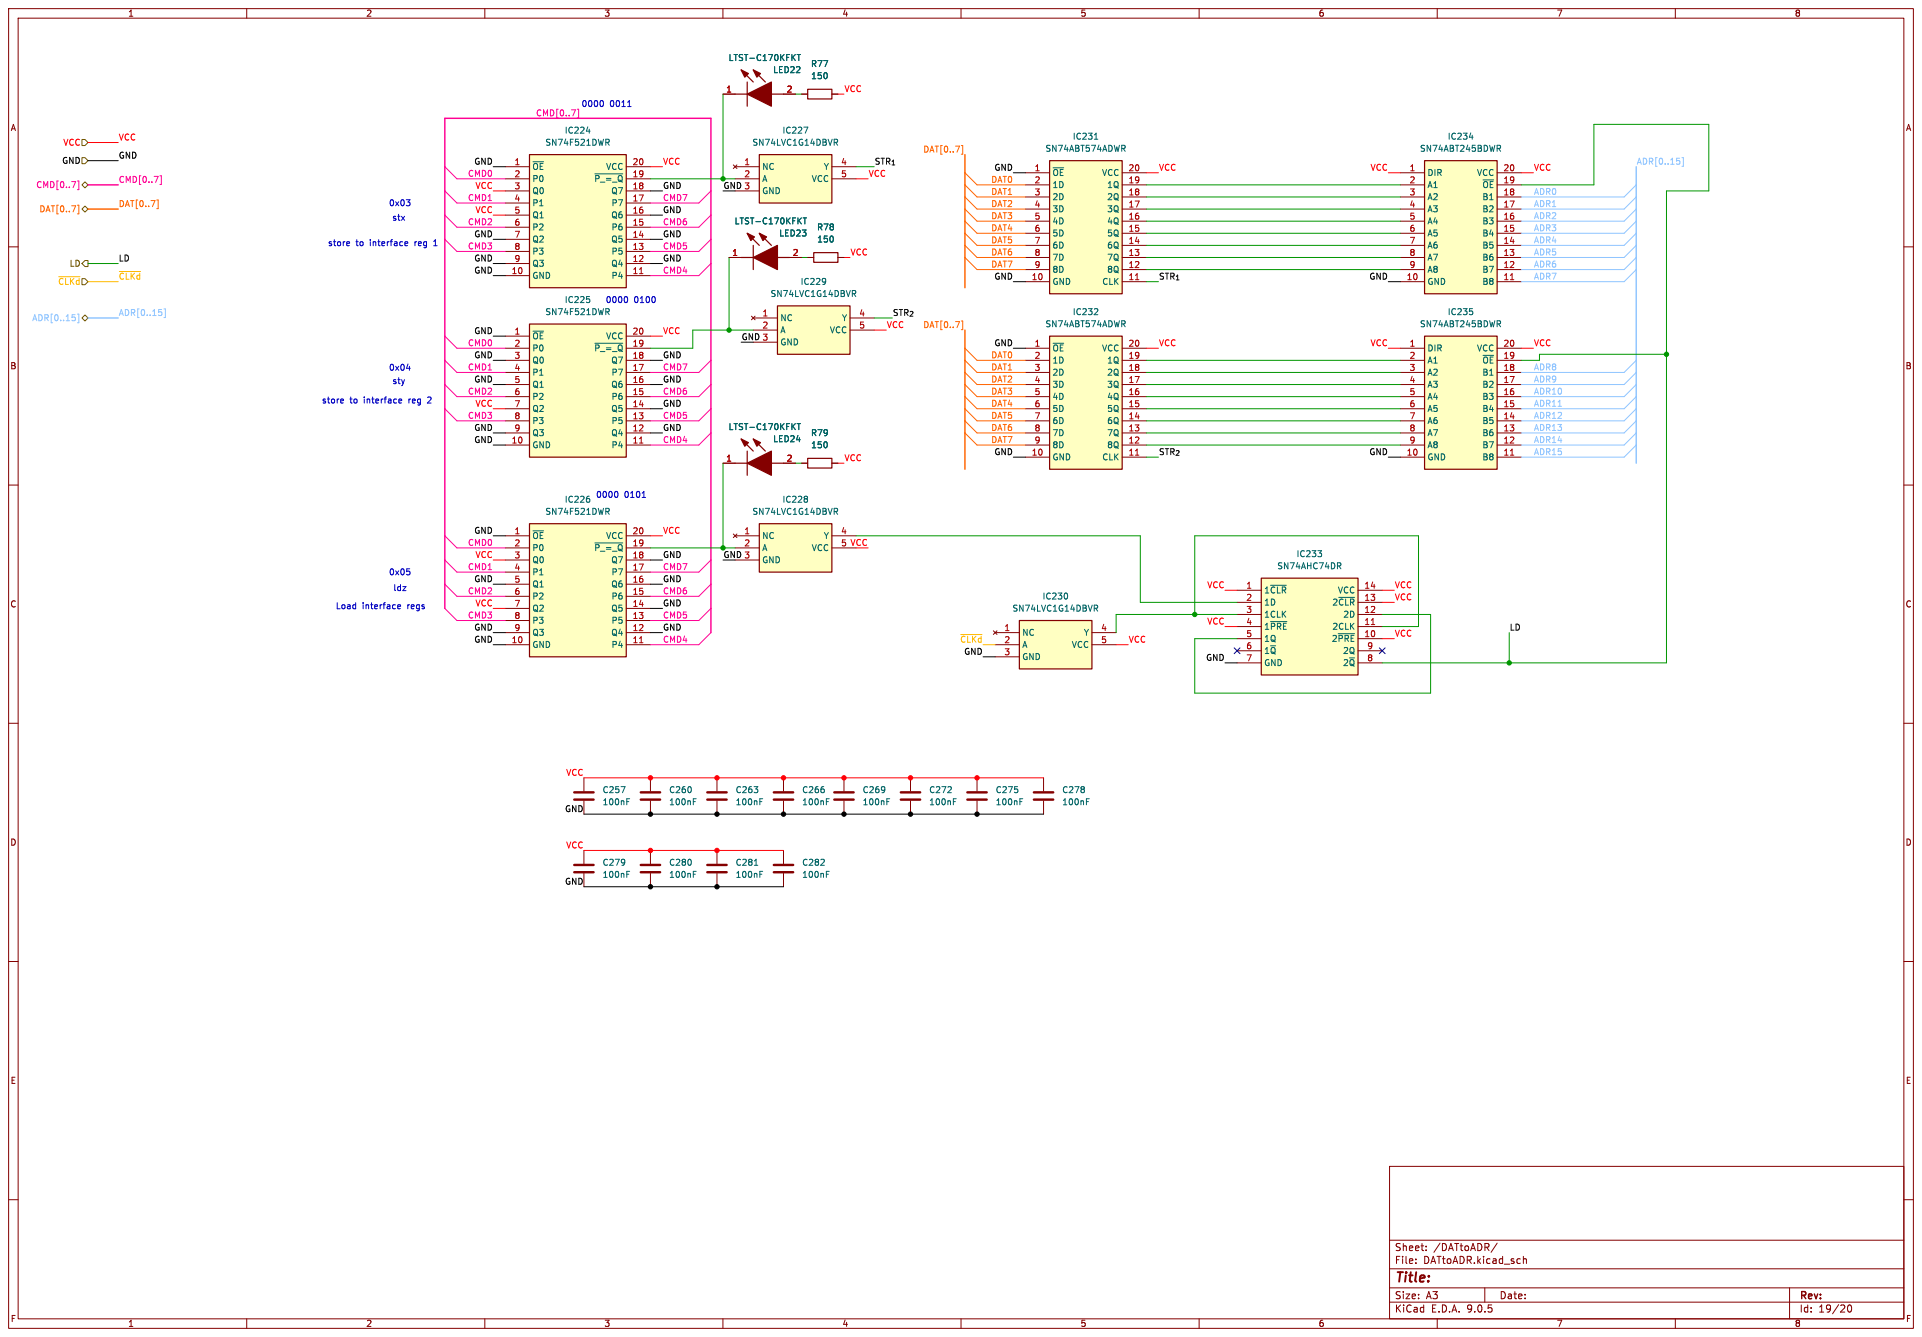
[picture p225: page 1]

CMD0 VCC GND GND GND GND
