SSCsimsi/8Bit_Computer/8Bit Computer ver2.0/Kicad/Computer/Computer-FlashMemory.pdf

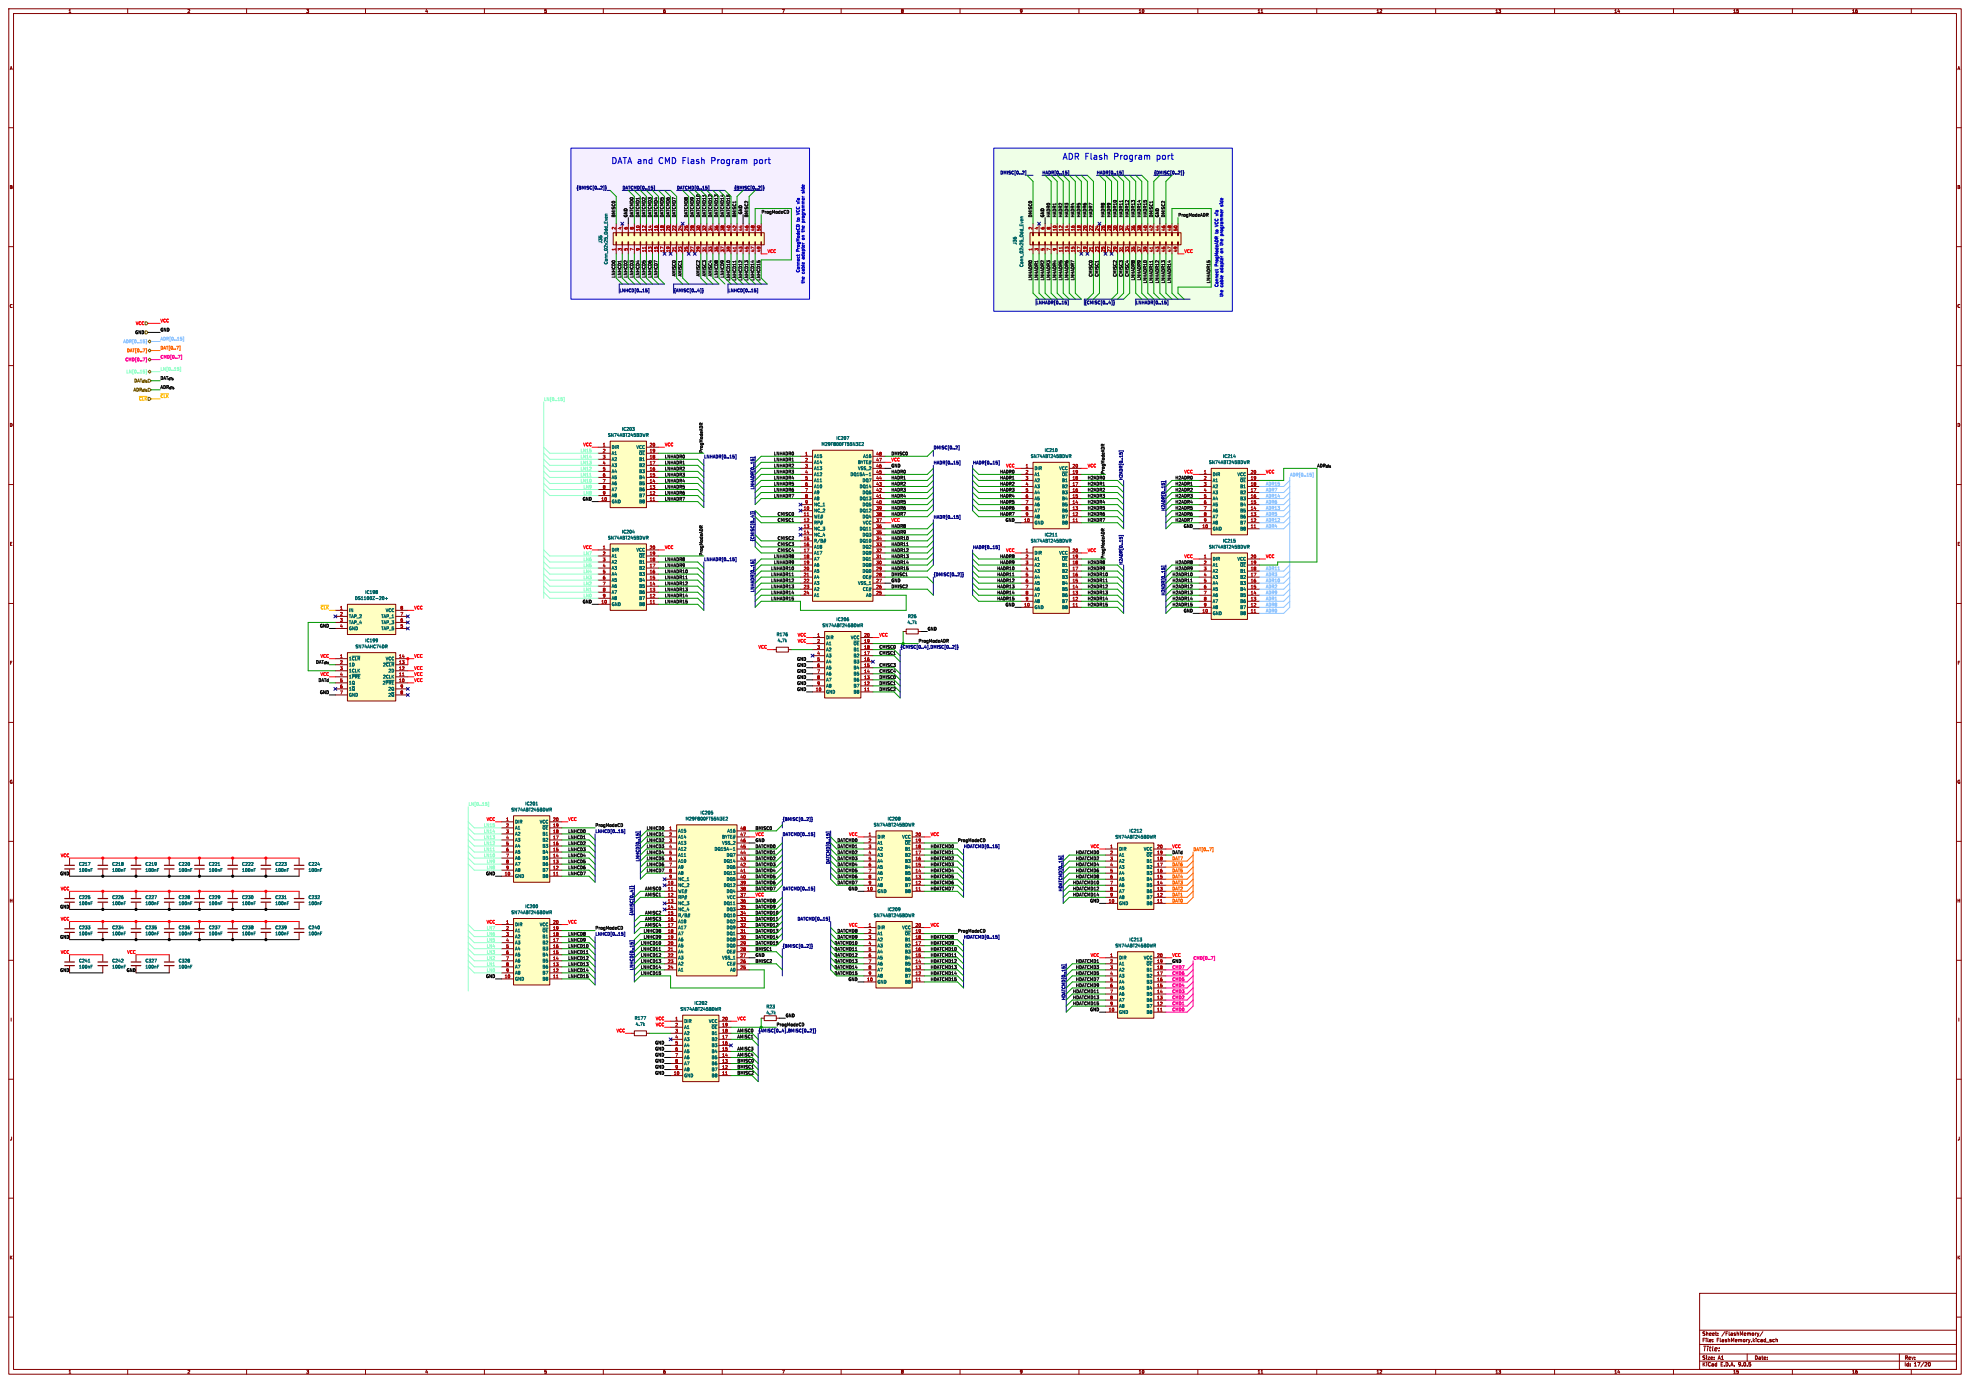
[picture p226: page 1]

ADR Flash Program port

Id: 17/20 Title: File: FlashMemory.kicad_sch Sheet: /FlashMemory/
