SSCsimsi/8Bit_Computer/8Bit Computer ver2.0/Kicad/ClockGen/ClockGen.pdf

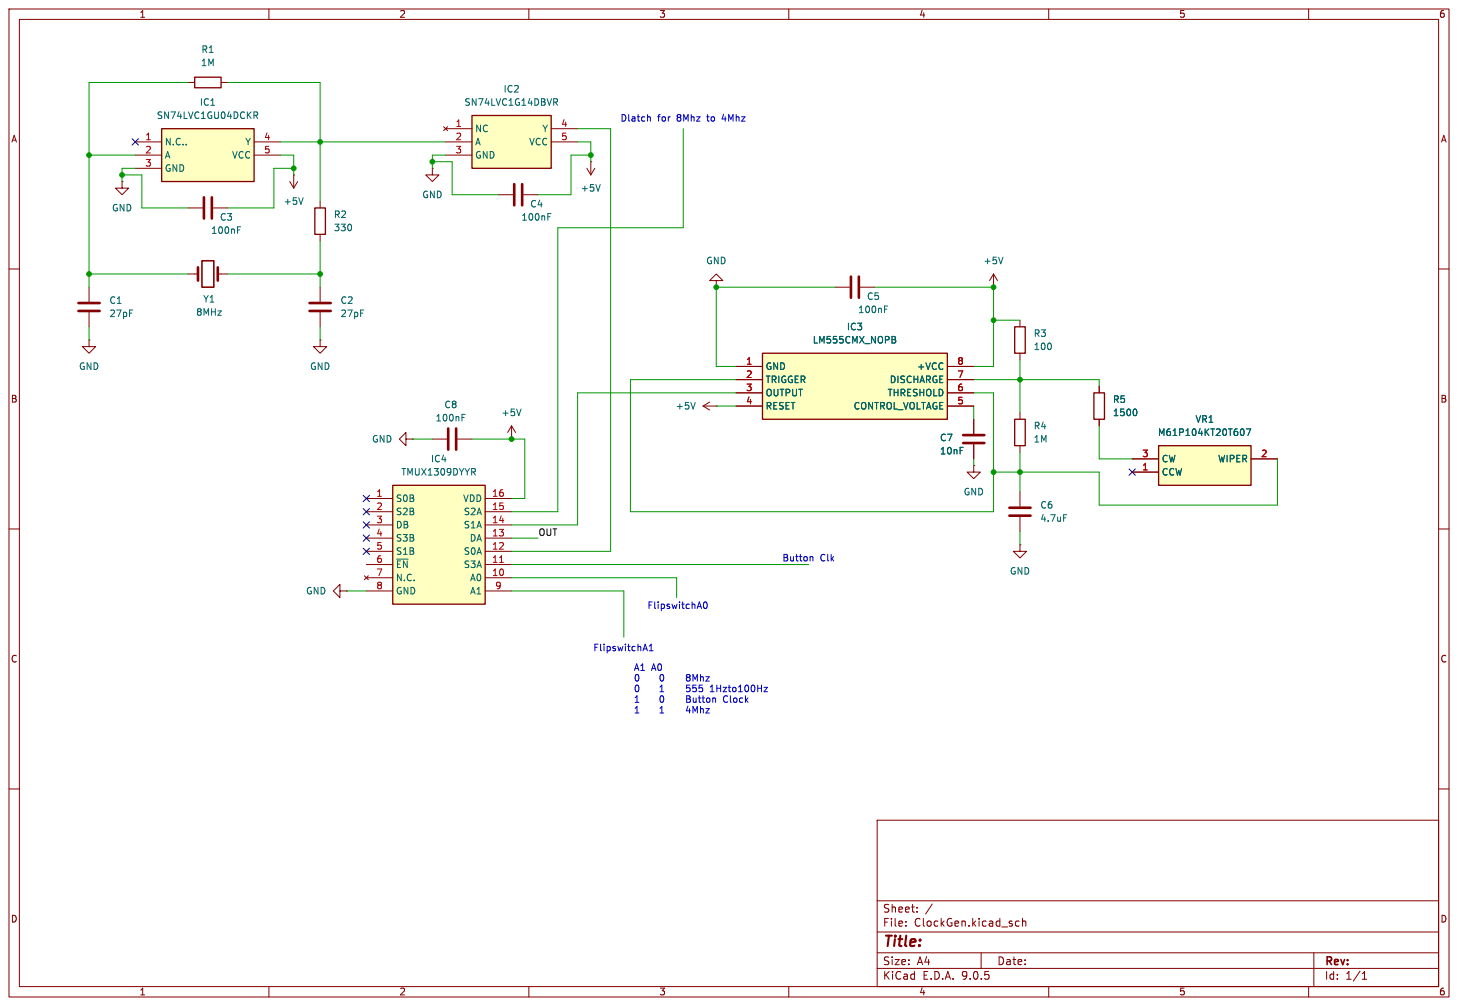
[picture p227: page 1]

Id: 1/1 Title: File: ClockGen.kicad_sch Sheet: /
