SSCsimsi/8Bit_Computer/8Bit Computer ver2.0/Kicad/ClockGen/KALK555.pdf

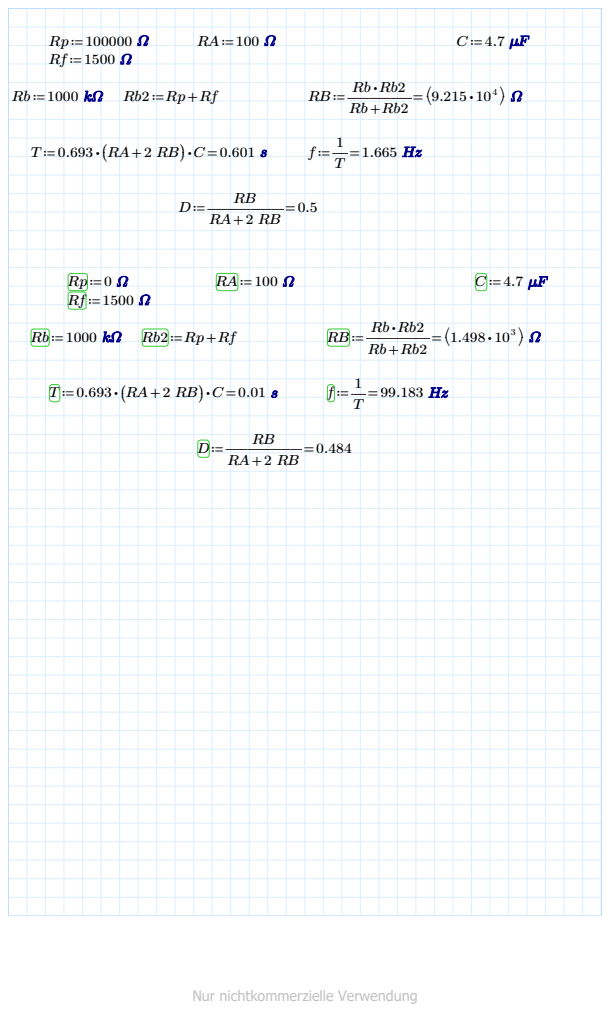
[picture p230: page 1]

Nur nichtkommerzielle Verwendung
