SSCsimsi/8Bit_Computer/8Bit Computer ver2.0/Kicad/ClockGen/ClockGenPCB.pdf

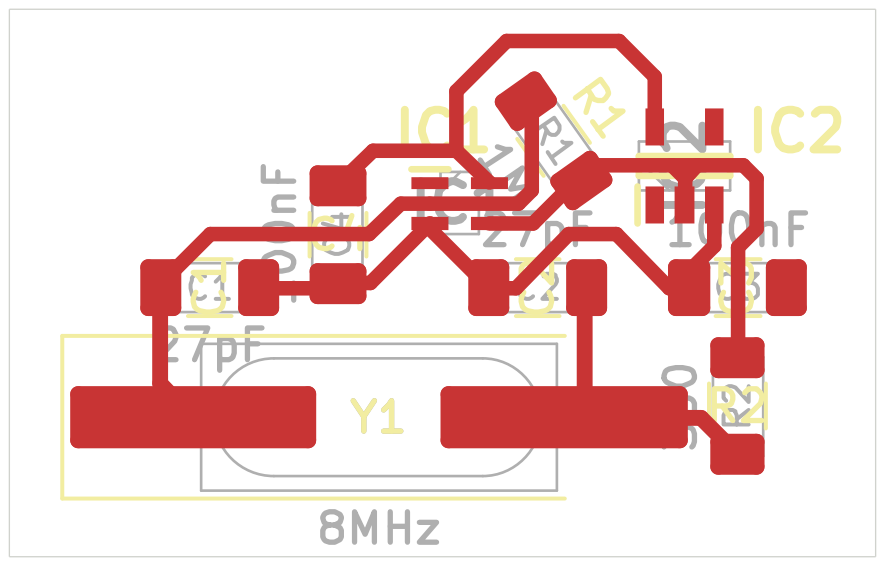
[picture p231: page 1]
