SSCsimsi/8Bit_Computer/8Bit Computer ver2.0/Kicad/Computer/8Bit_Computer_SCH_V2.6.pdf

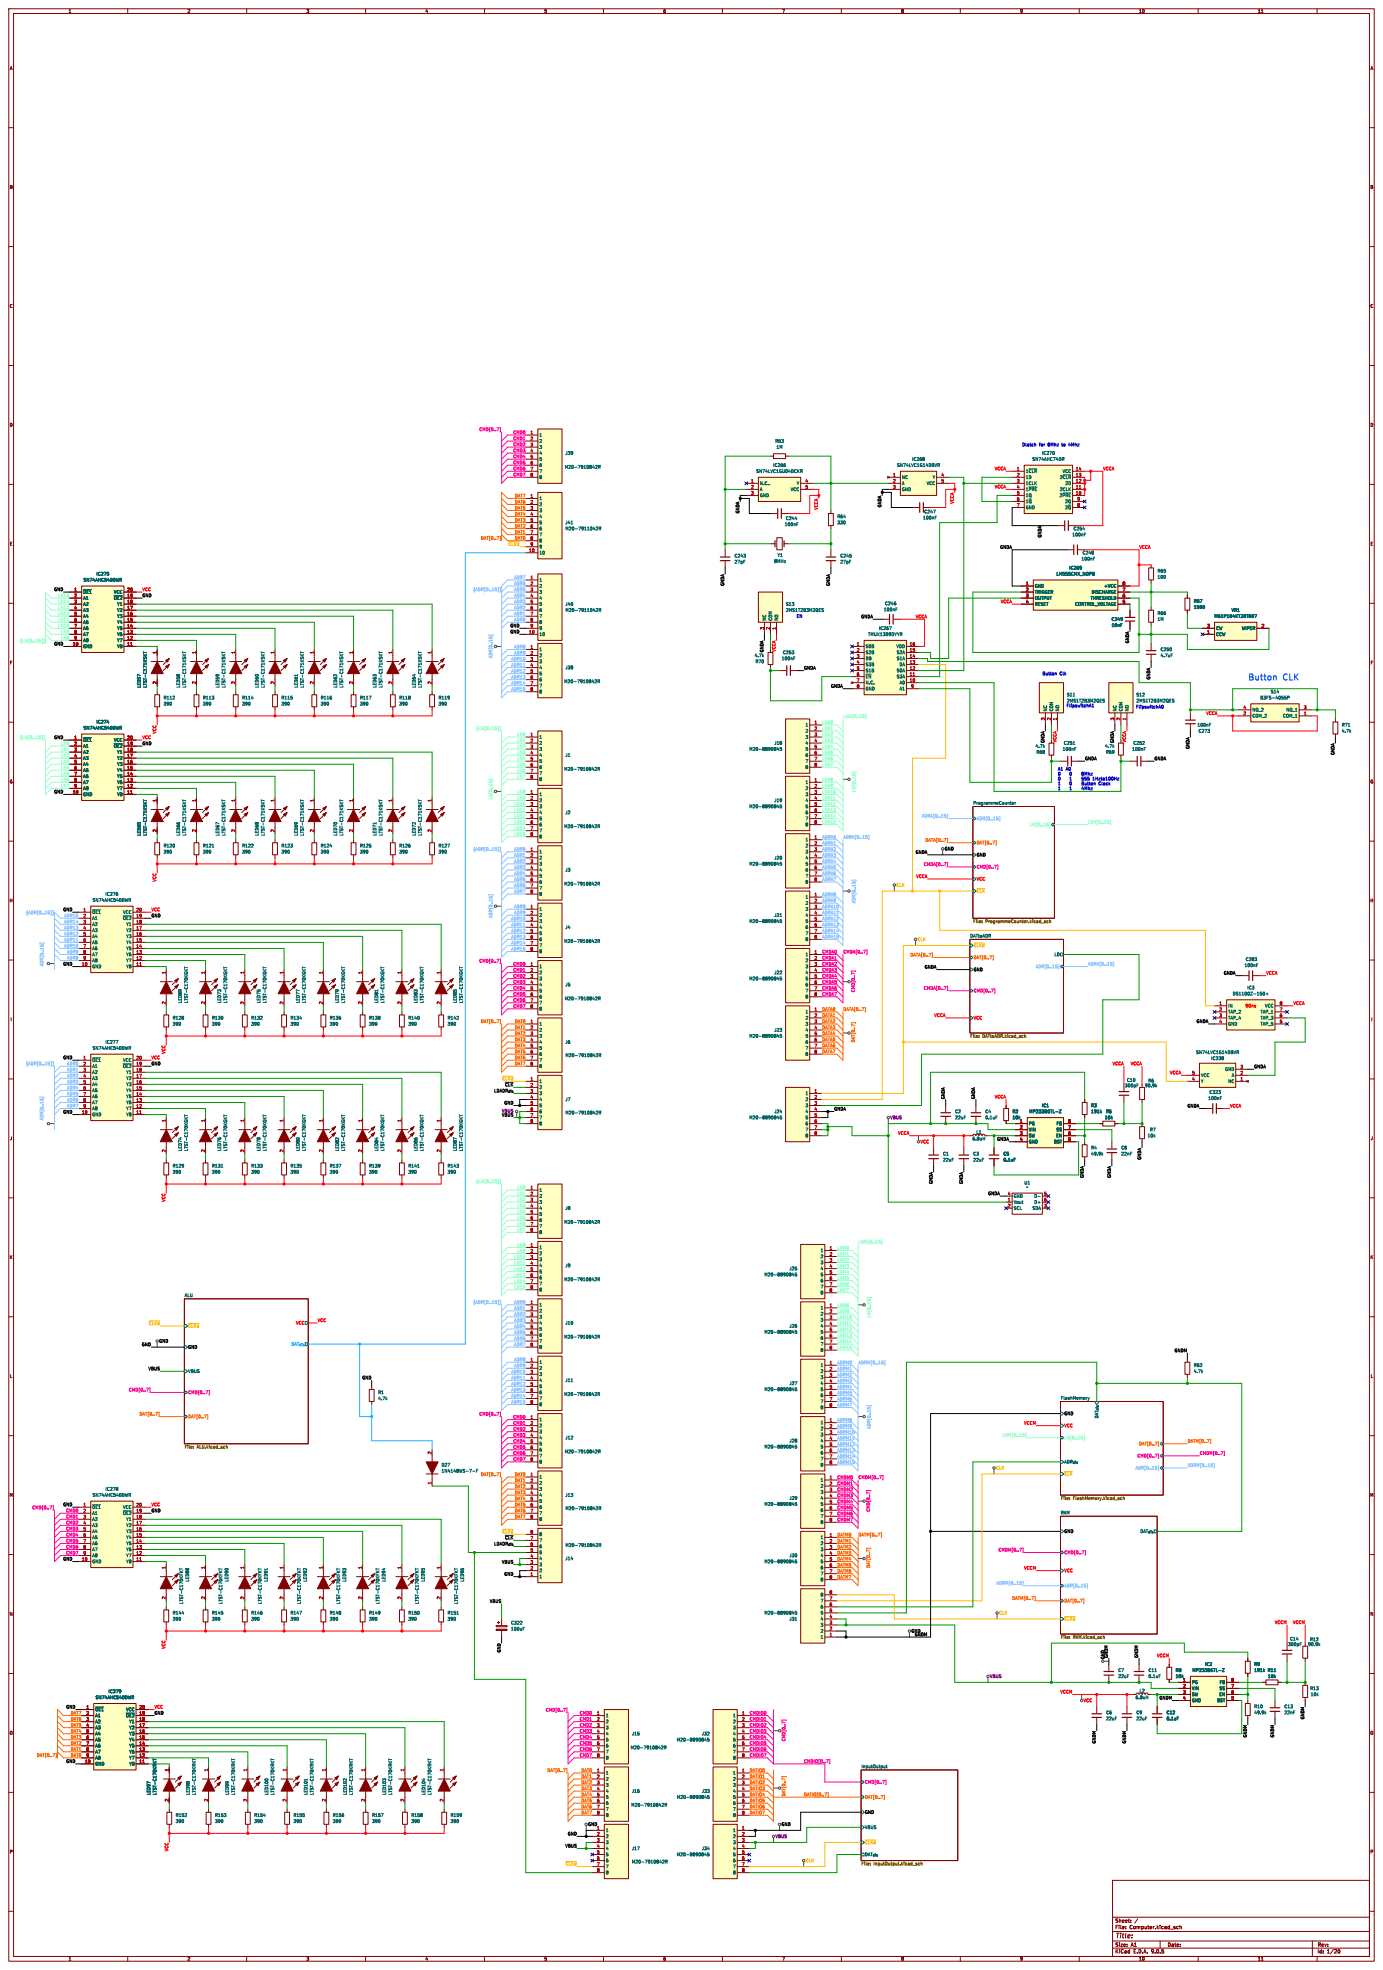
[picture p232: page 1]

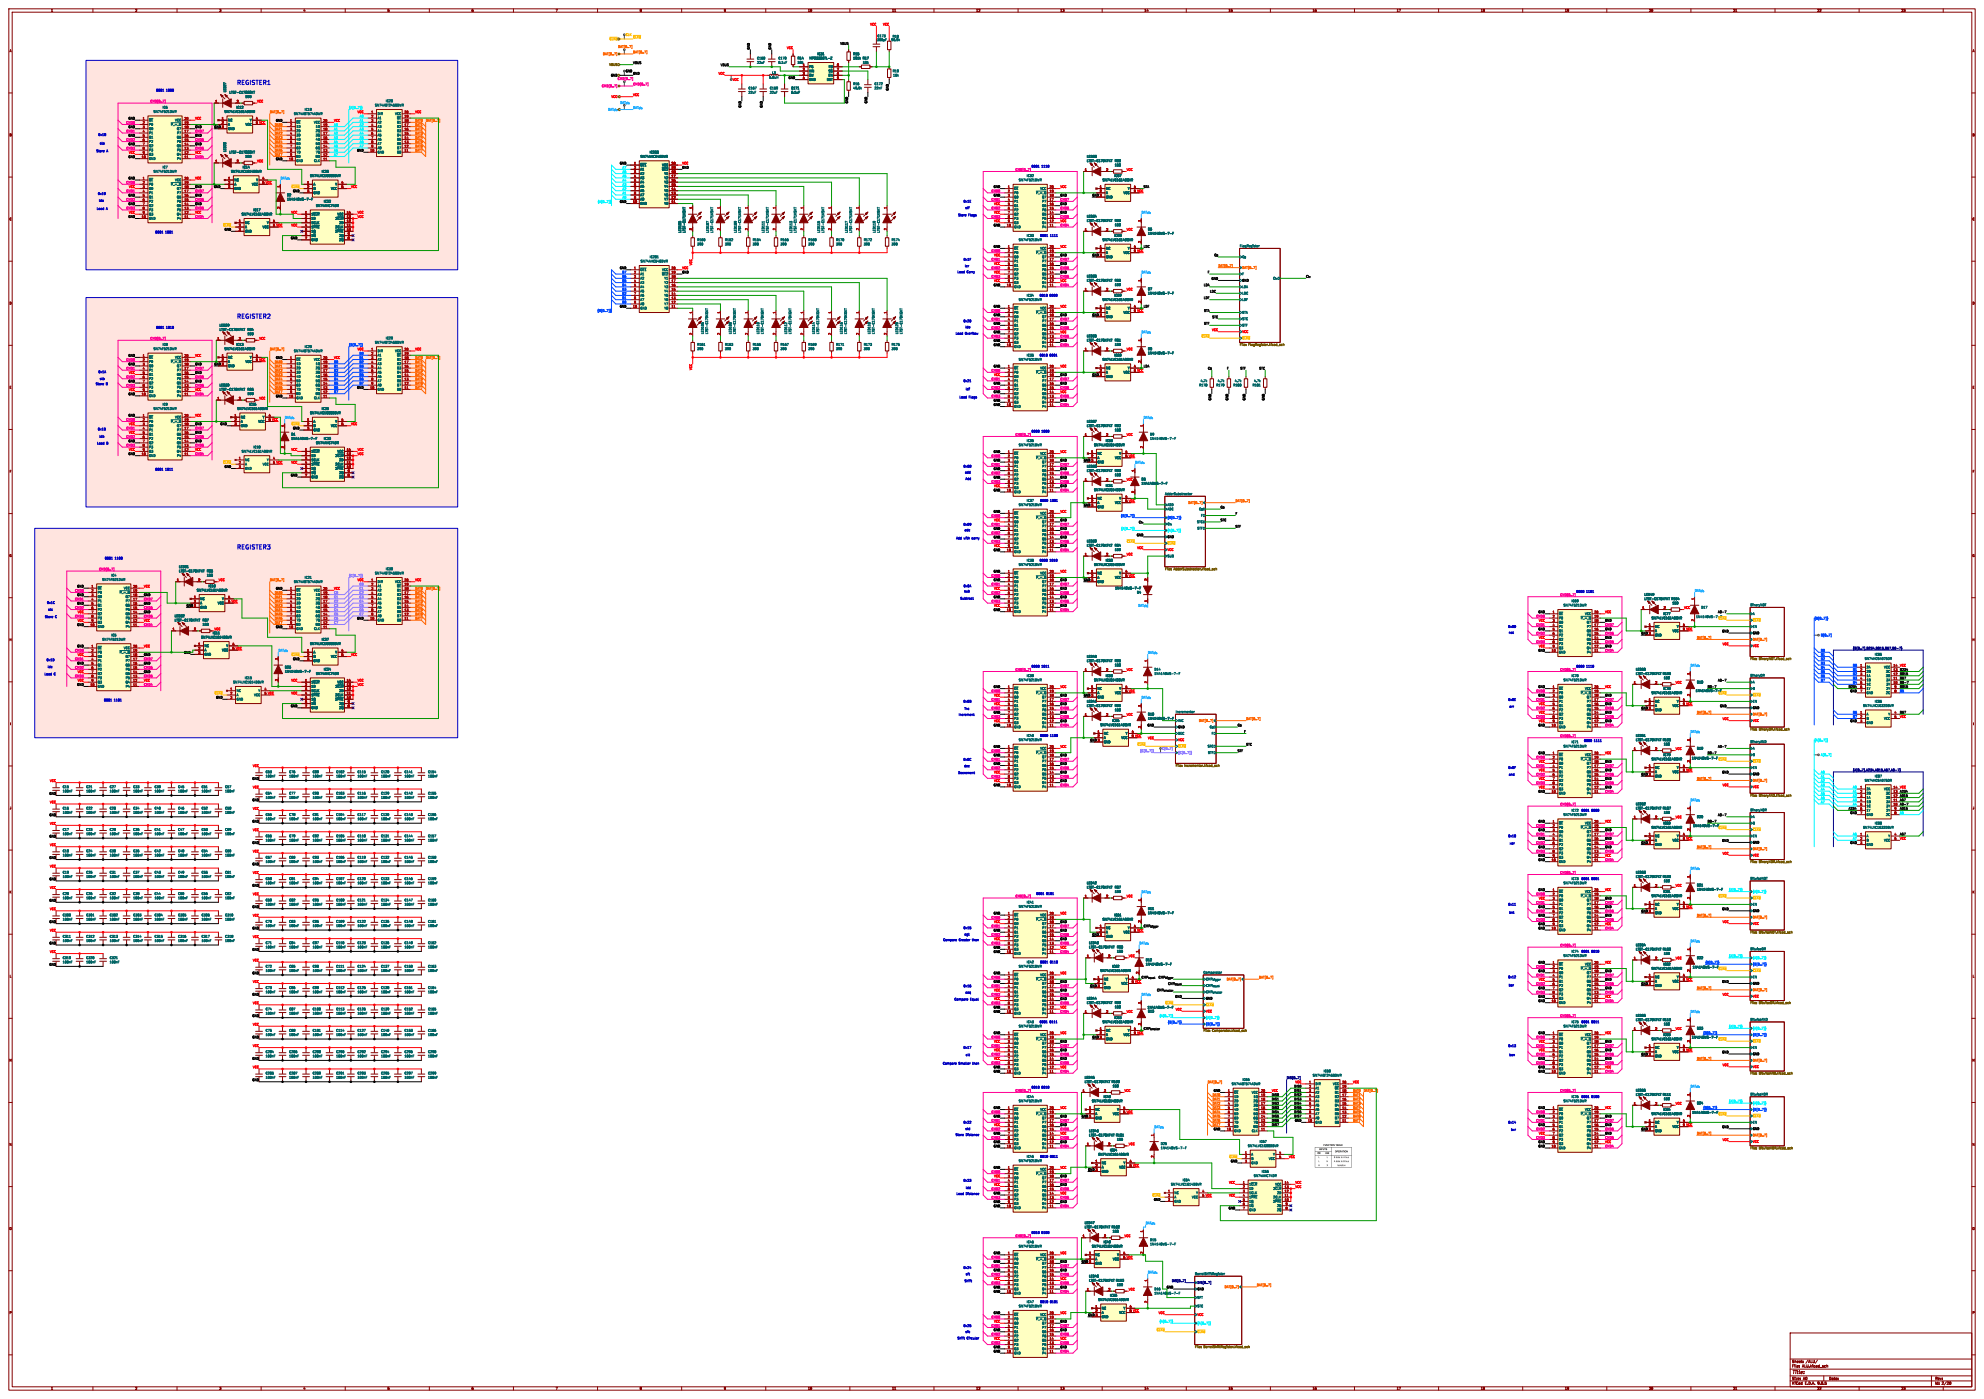
[picture p233: page 2]

~{CLKd} AdderSubstractor File: AdderSubstractor.kicad_sch

ceq Compare Equal 0x16 Compare Greater than

CMD2 CMD3 VCC
VCC GND GND
Compare Smaller than Store Distance

SFT BarrelShiftRegister File: BarrelShiftRegister.kicad_sch

Id: 2/20 Title: File: ALU.kicad_sch Sheet: /ALU/


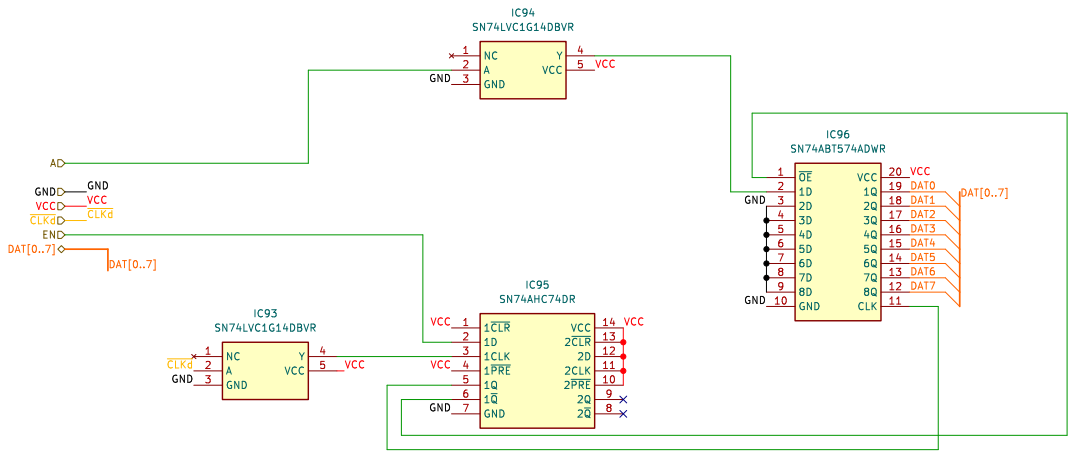
[picture p234: page 4]

Id: 4/20 Title: File: BinaryNOT.kicad_sch Sheet: /ALU/BinaryNOT/

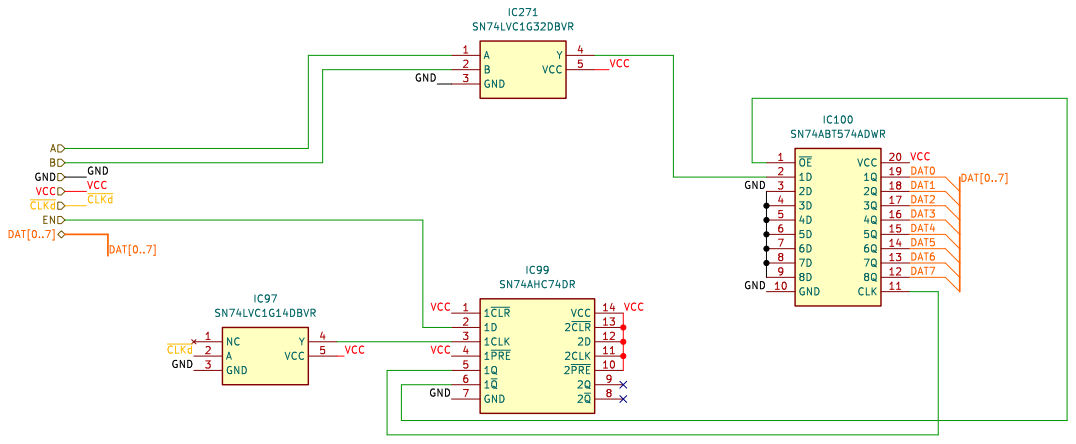
[picture p235: page 5]

Id: 5/20 Title: File: BinaryOR.kicad_sch Sheet: /ALU/BinaryOR/

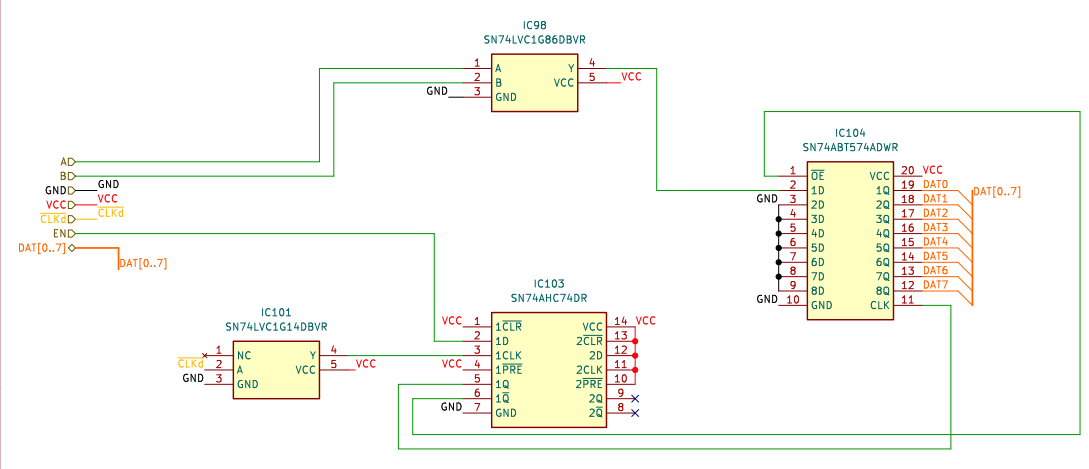
[picture p236: page 6]

Id: 6/20 Title: File: BinaryXOR.kicad_sch Sheet: /ALU/BinaryXOR/

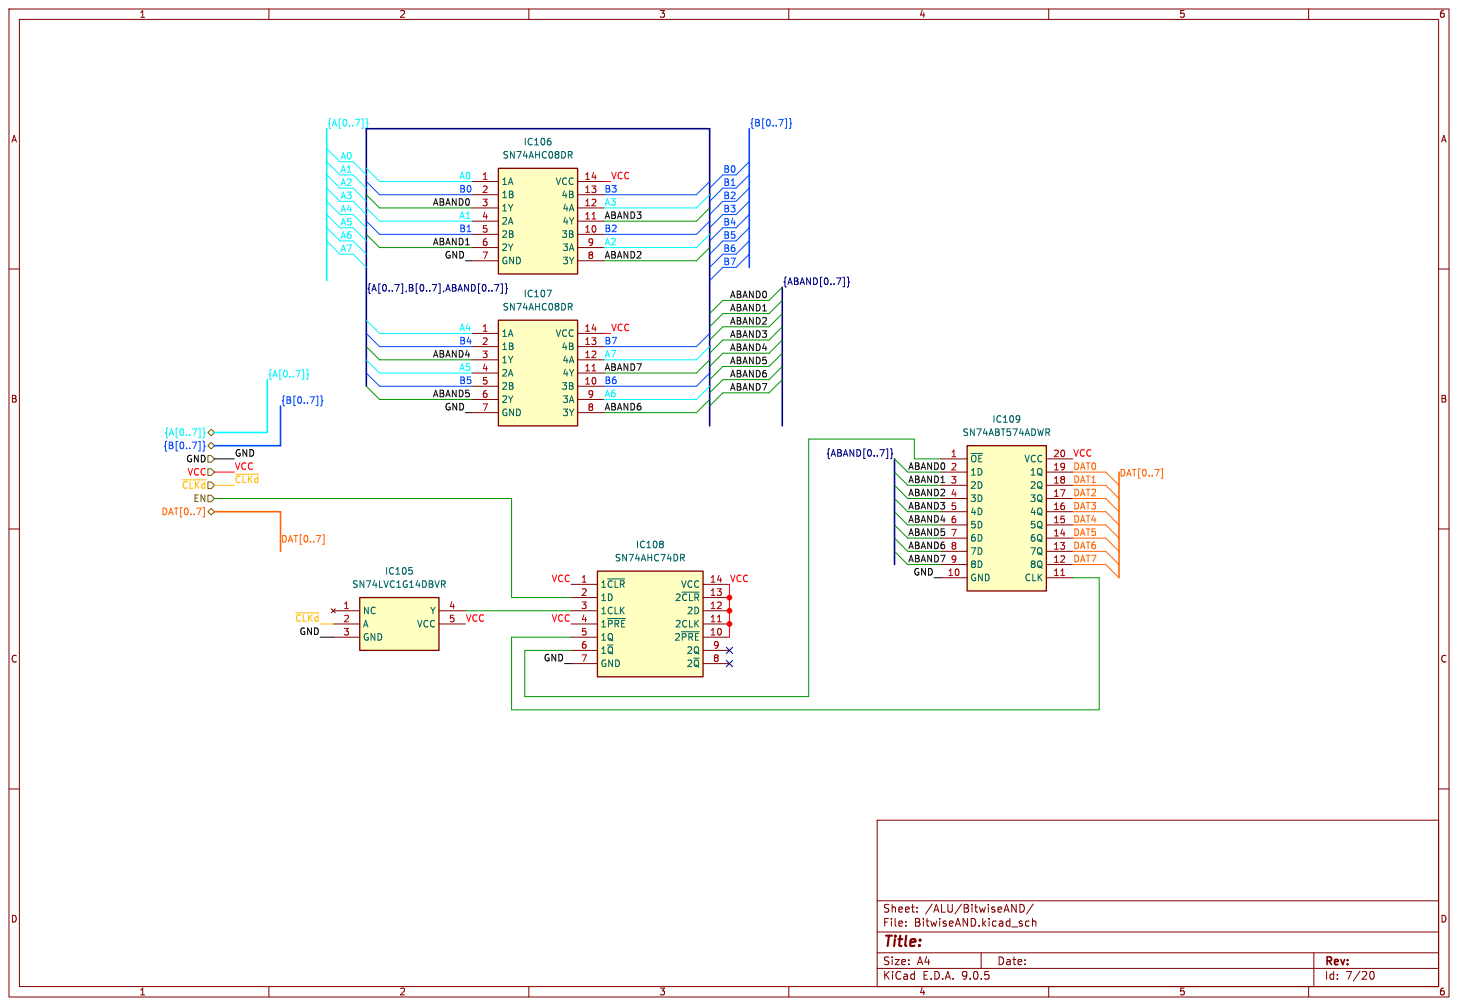
[picture p237: page 7]

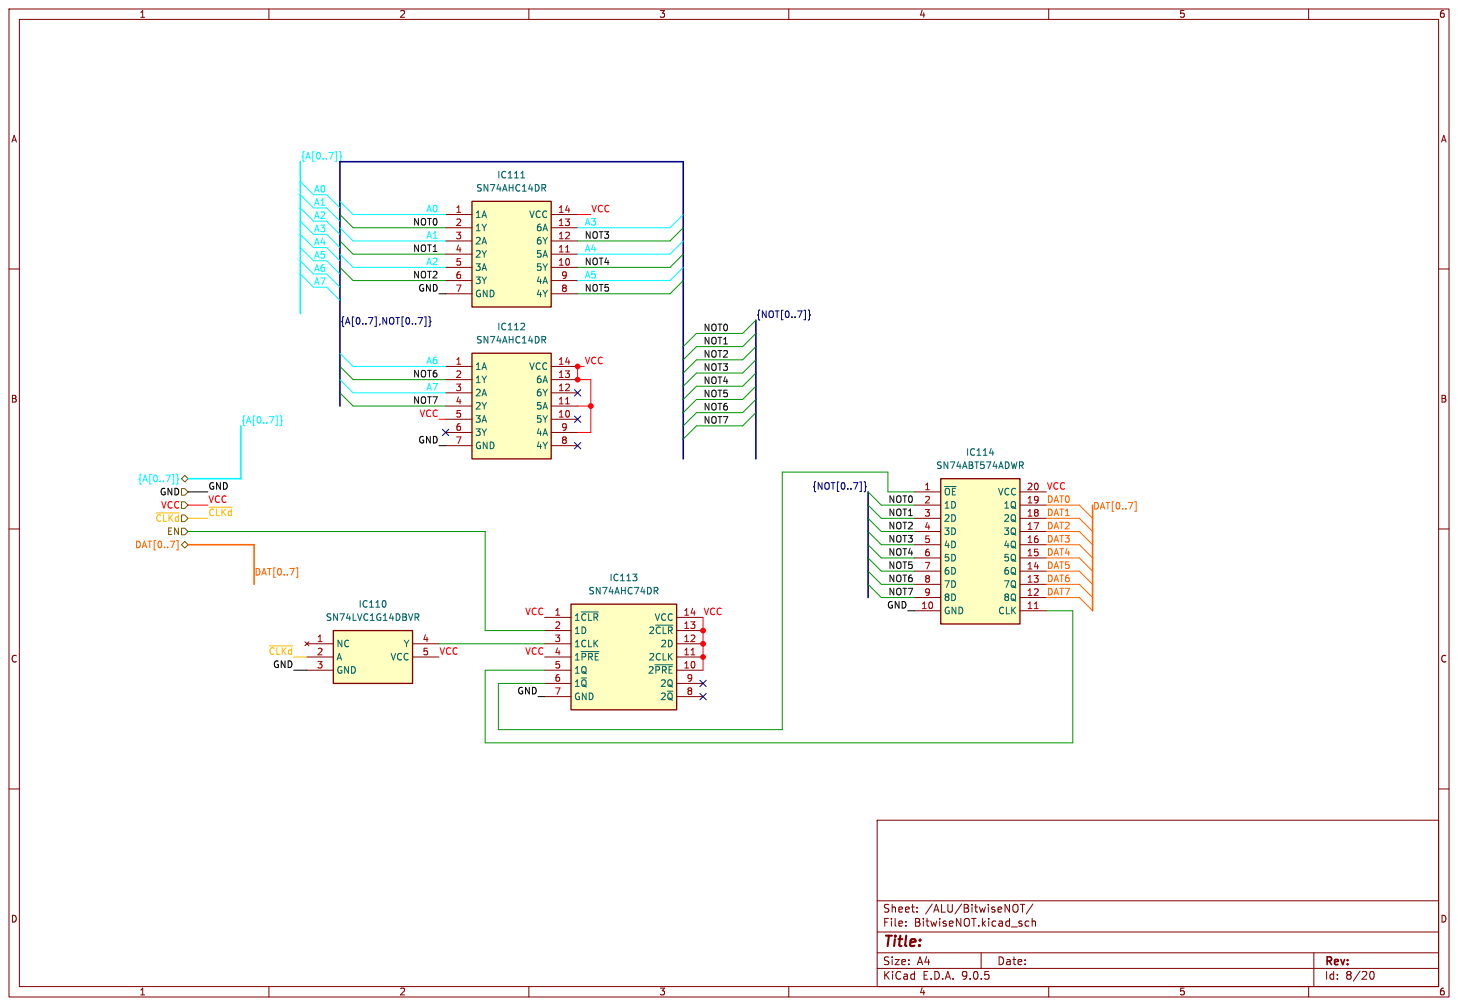
[picture p238: page 8]

Id: 8/20 Title: File: BitwiseNOT.kicad_sch Sheet: /ALU/BitwiseNOT/

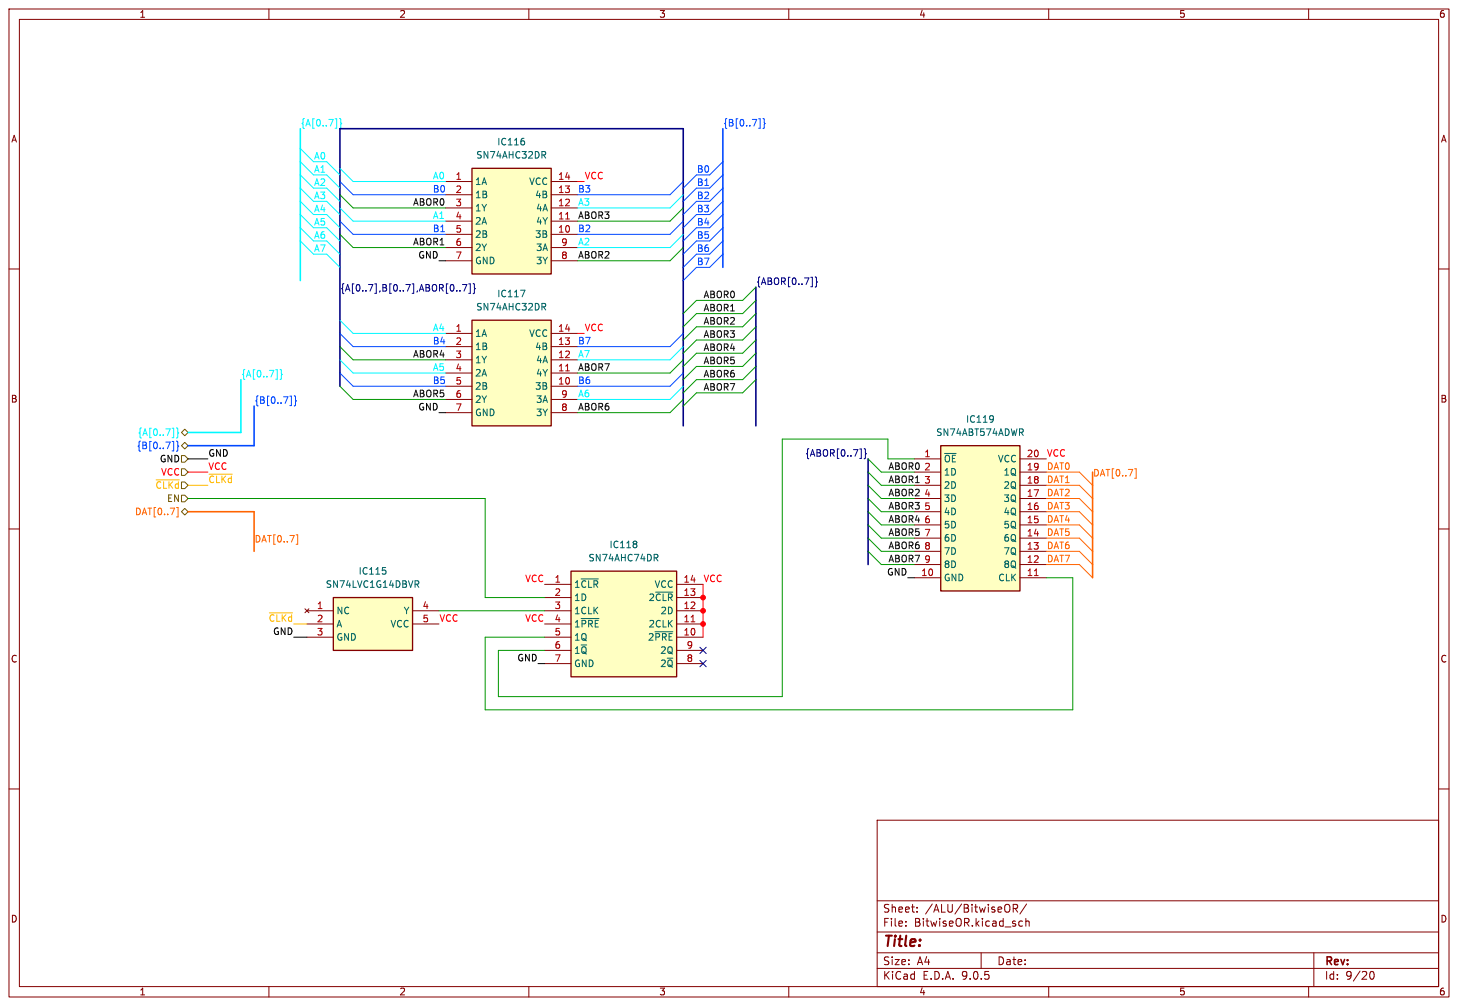
[picture p239: page 9]

Id: 9/20 Title: File: BitwiseOR.kicad_sch Sheet: /ALU/BitwiseOR/

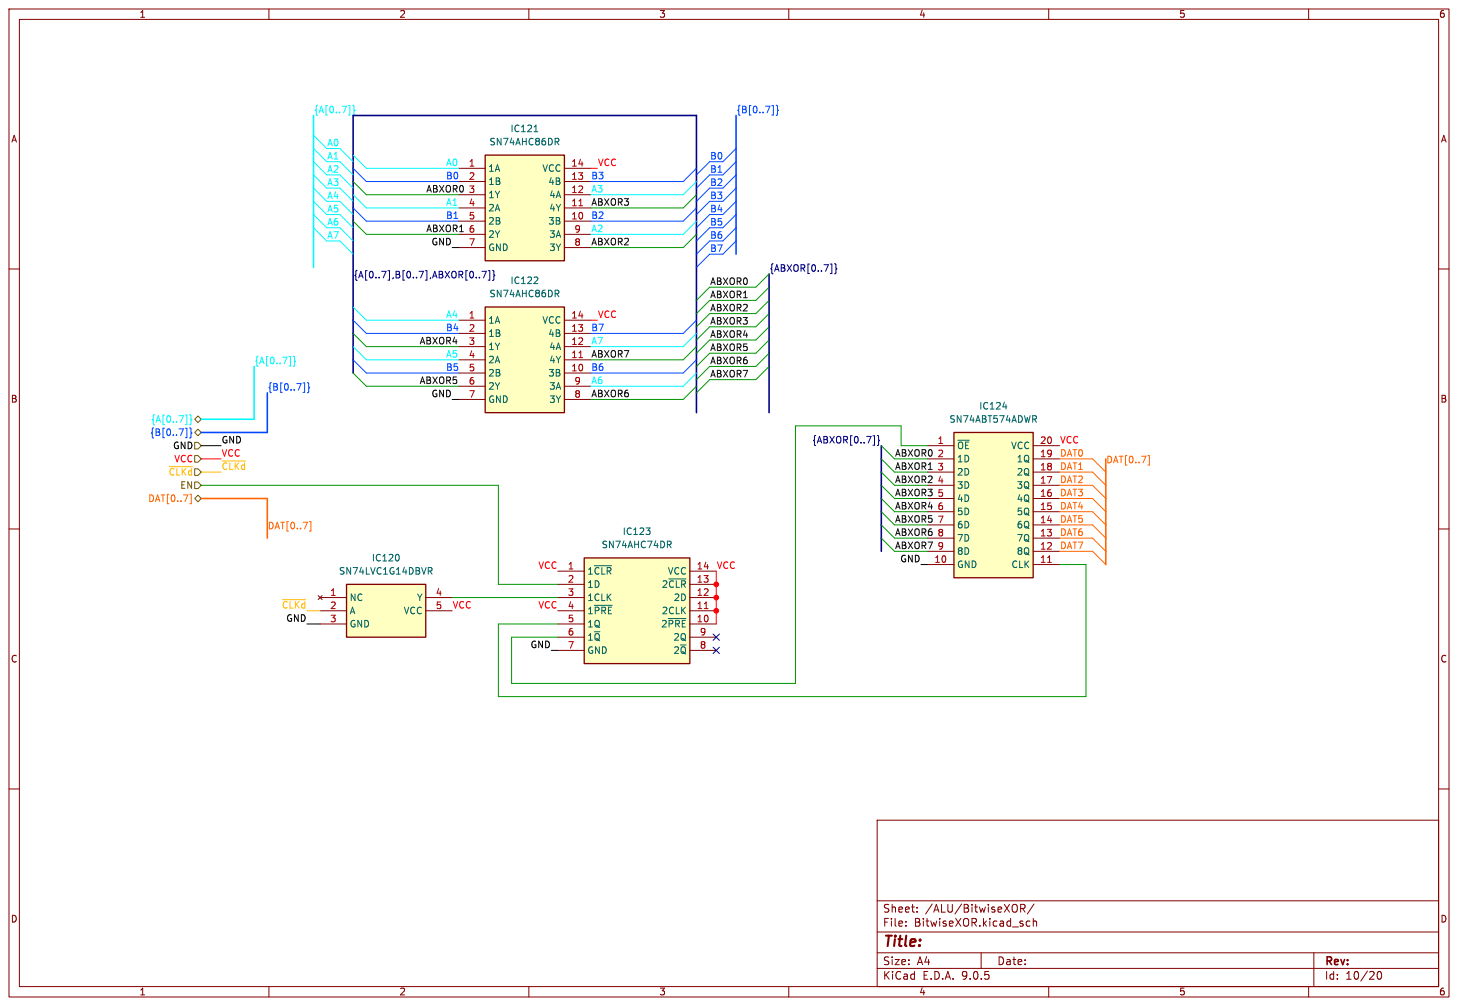
[picture p240: page 10]

Id: 10/20 Title: File: BitwiseXOR.kicad_sch Sheet: /ALU/BitwiseXOR/

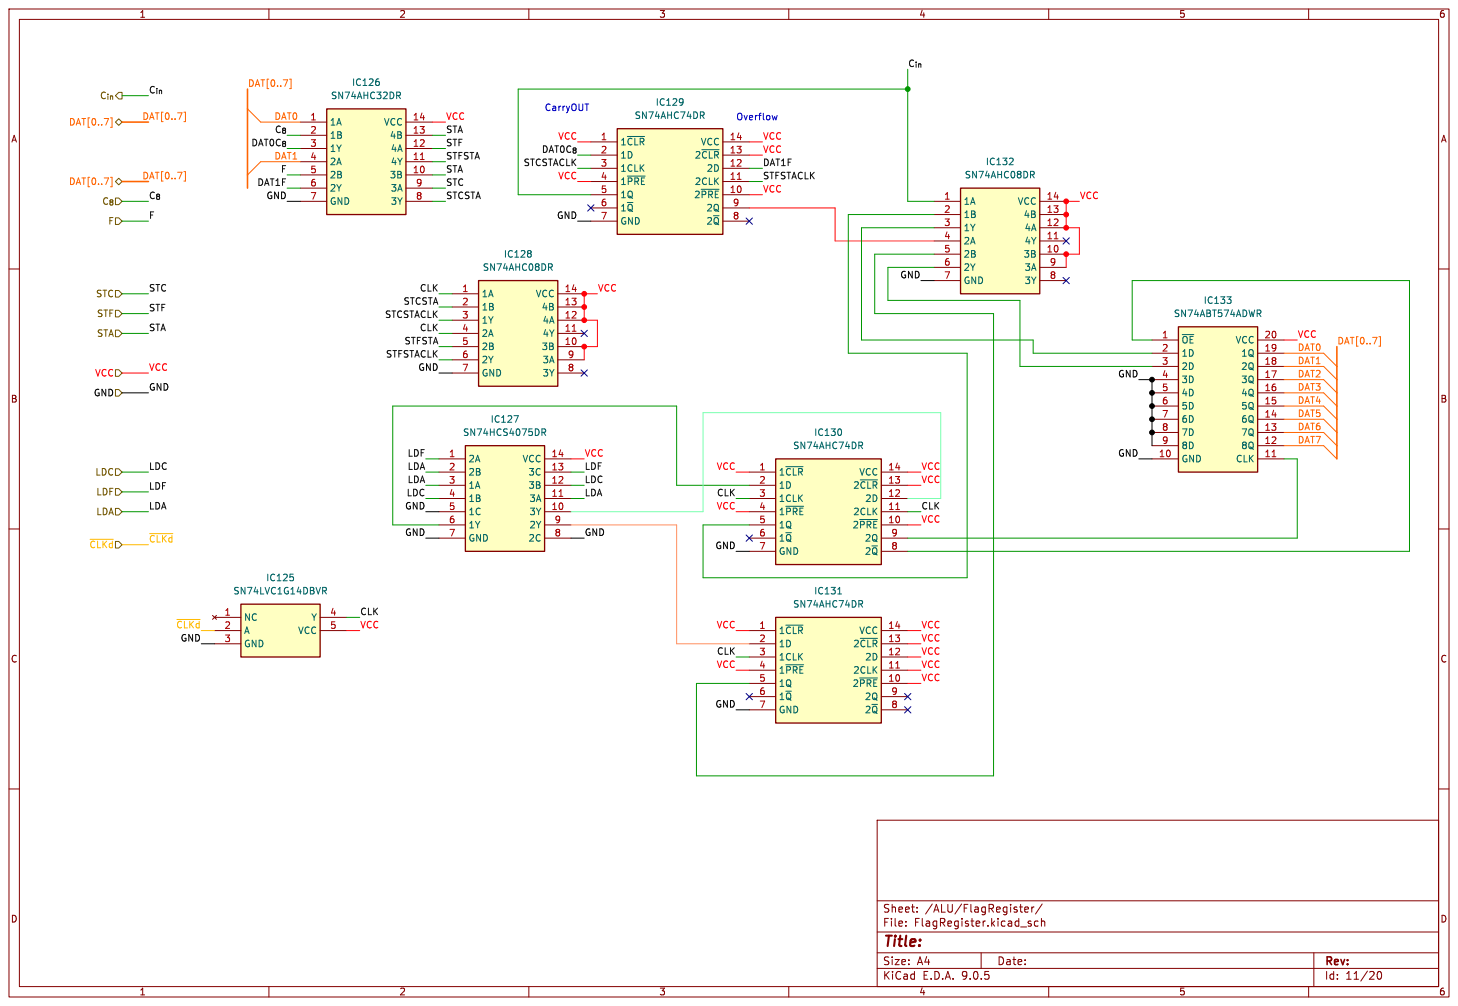
[picture p241: page 11]

Id: 11/20 Title: File: FlagRegister.kicad_sch Sheet: /ALU/FlagRegister/

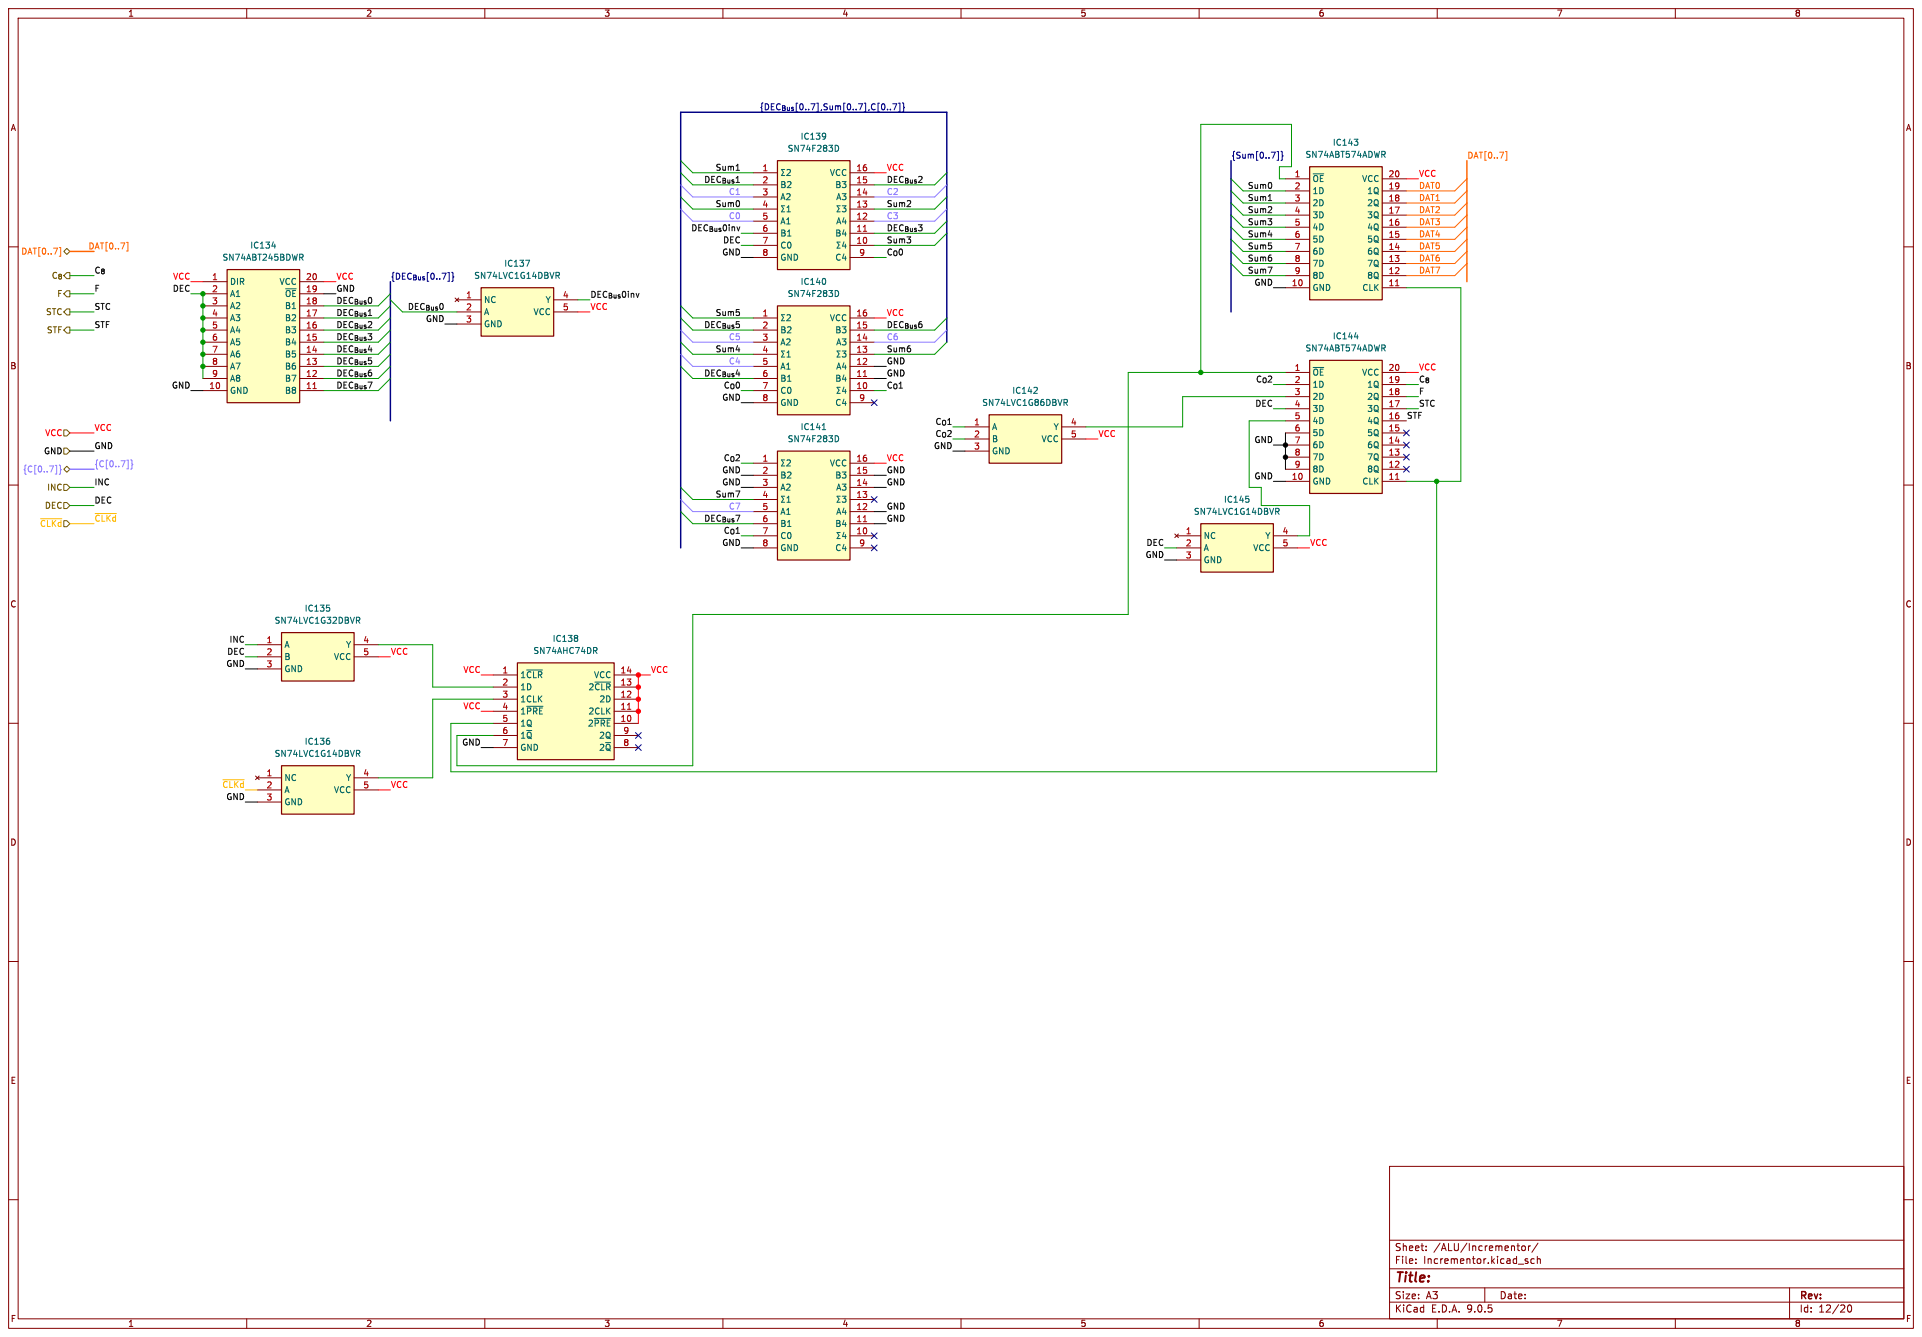
[picture p242: page 12]

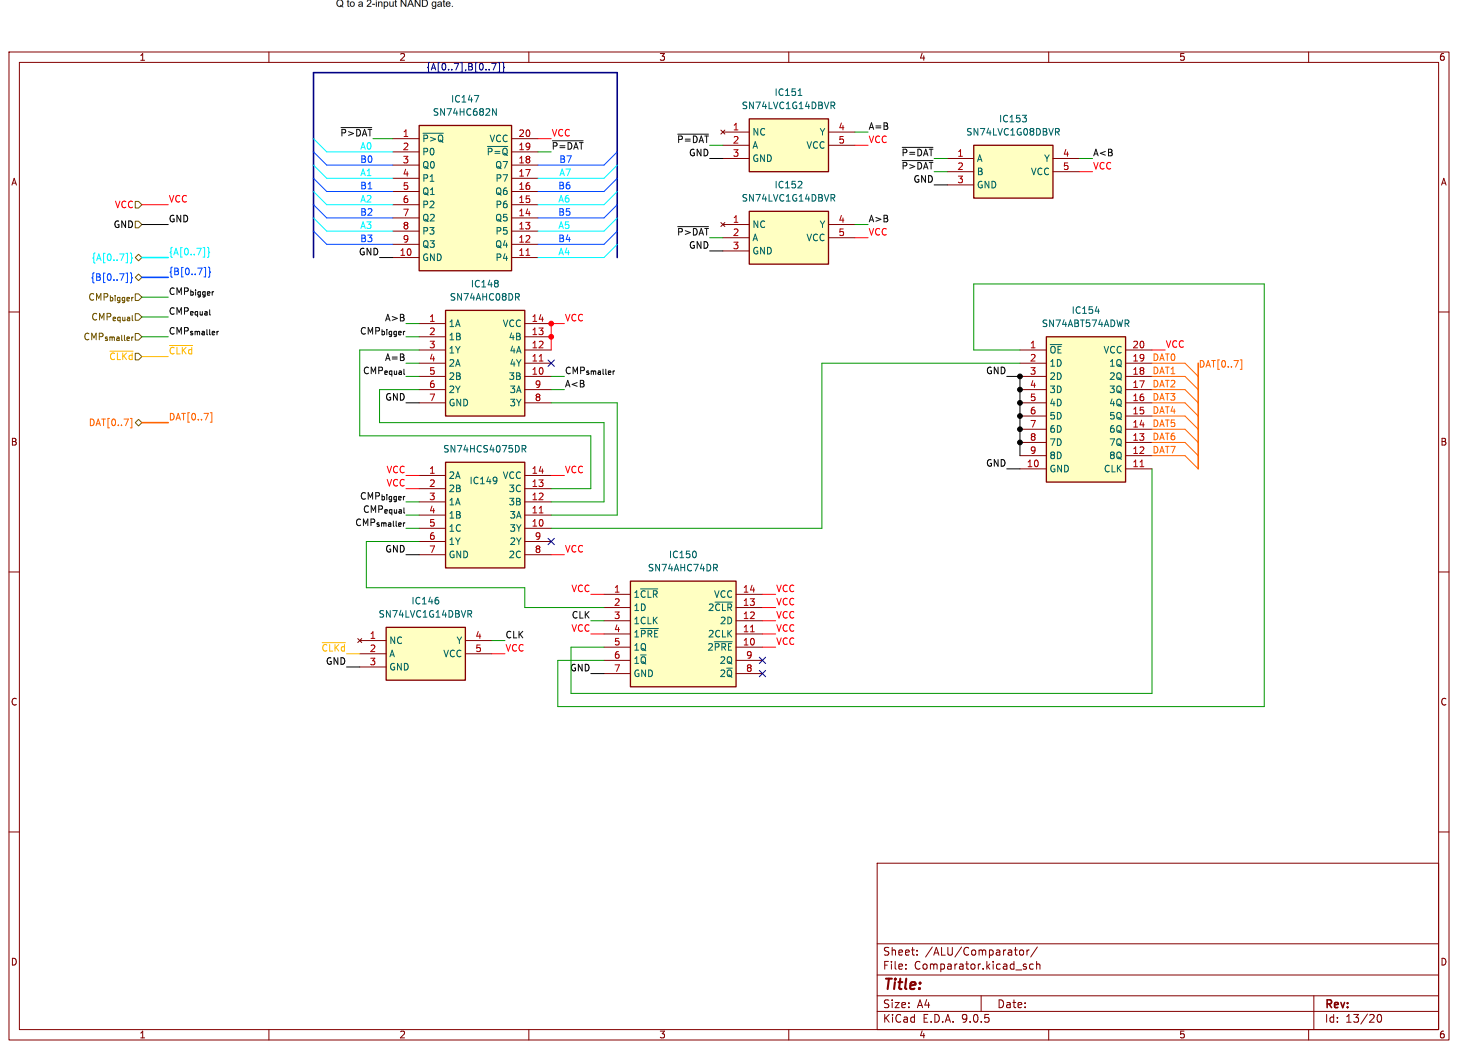
[picture p243: page 13]

Id: 13/20 Title: File: Comparator.kicad_sch Sheet: /ALU/Comparator/

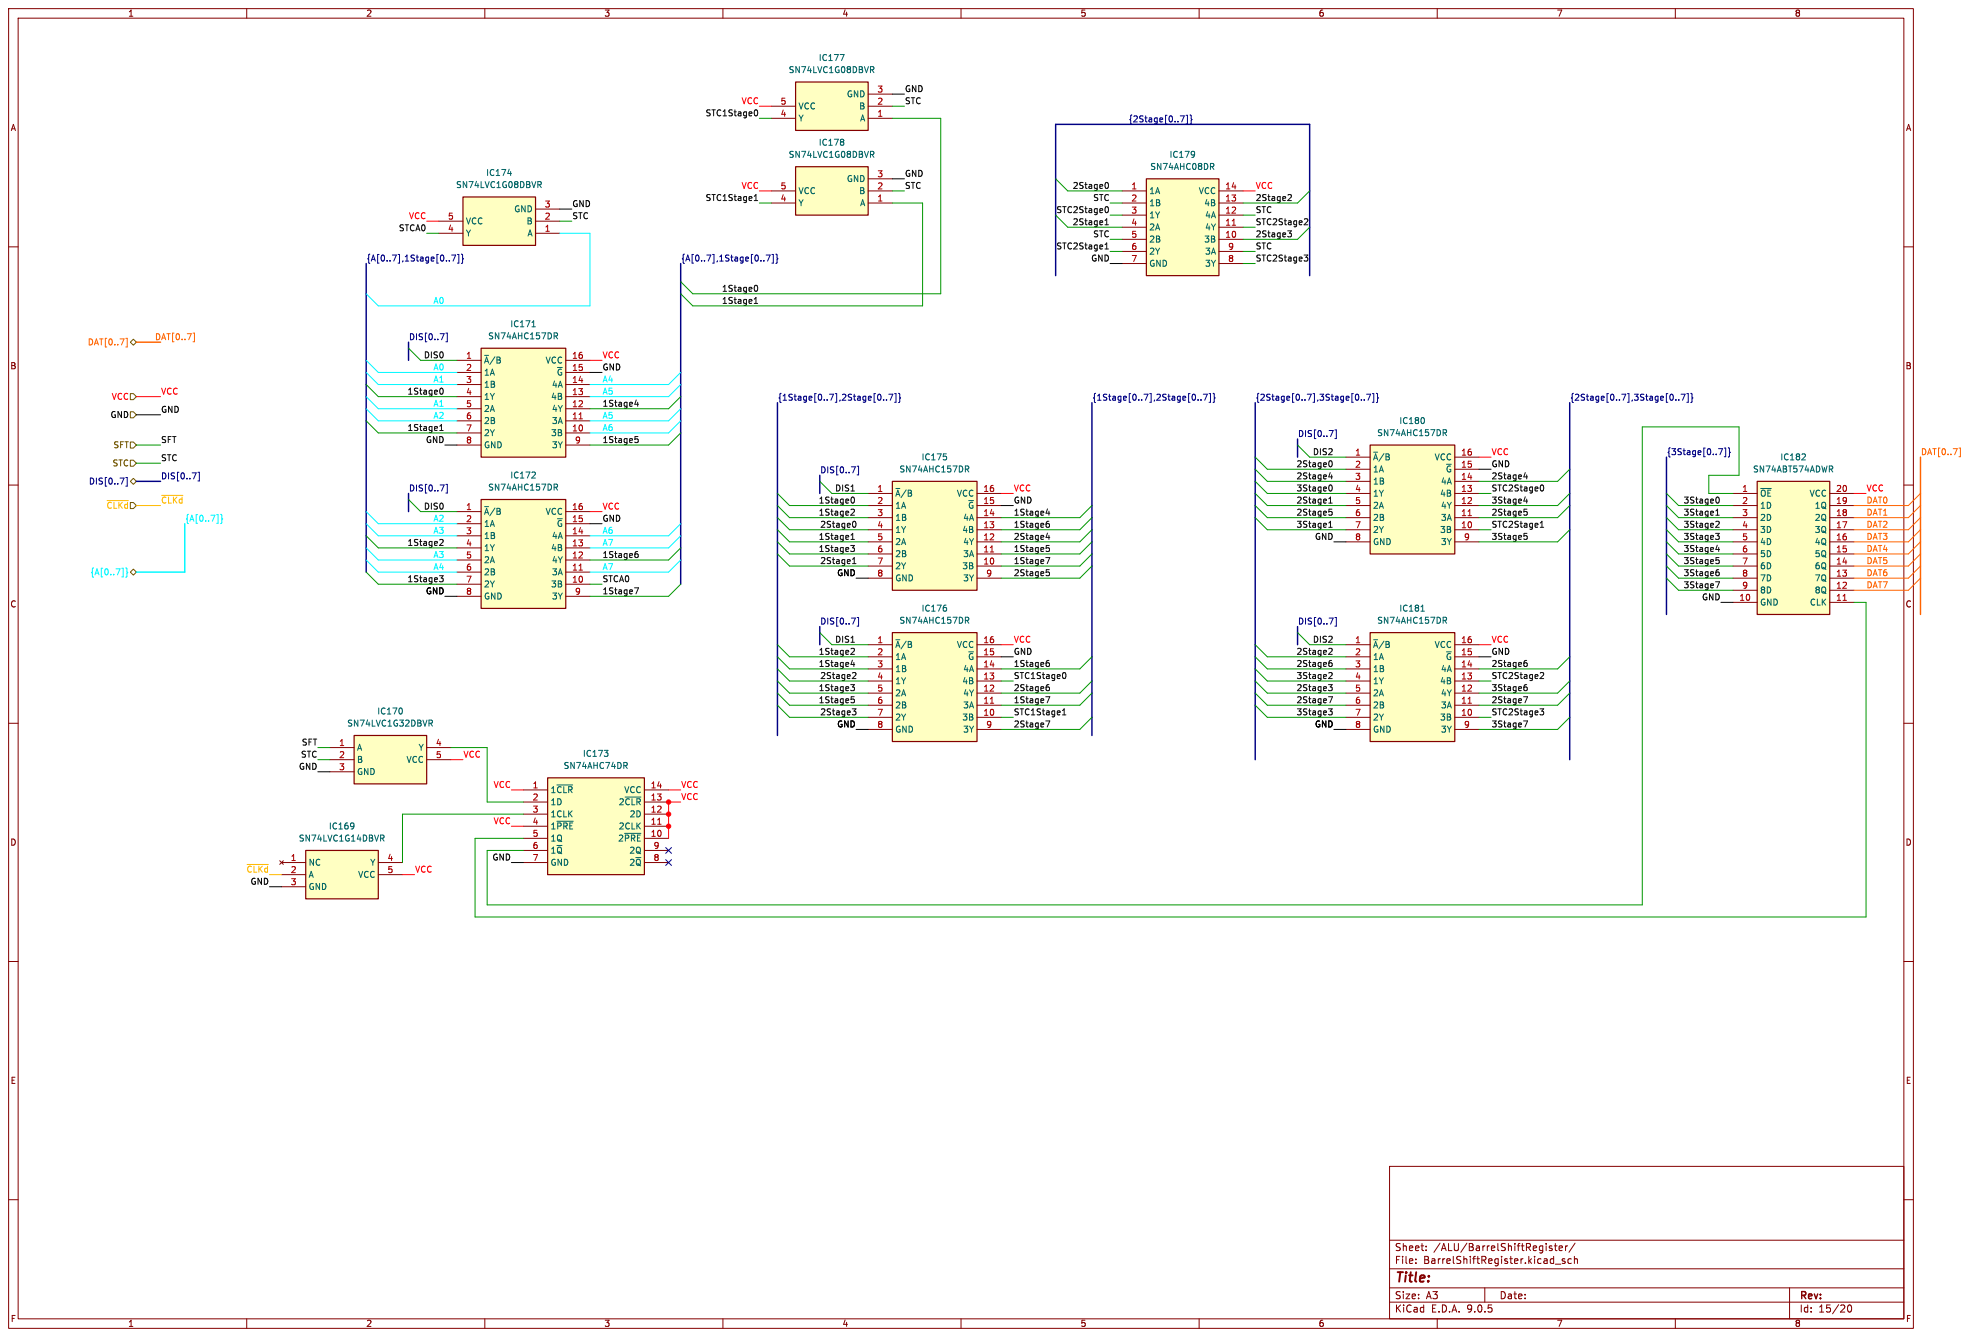
[picture p244: page 14]

DAT[0..7] VCC
DIS[0..7] SFT DAT[0..7] STC
{A[0..7]} GND

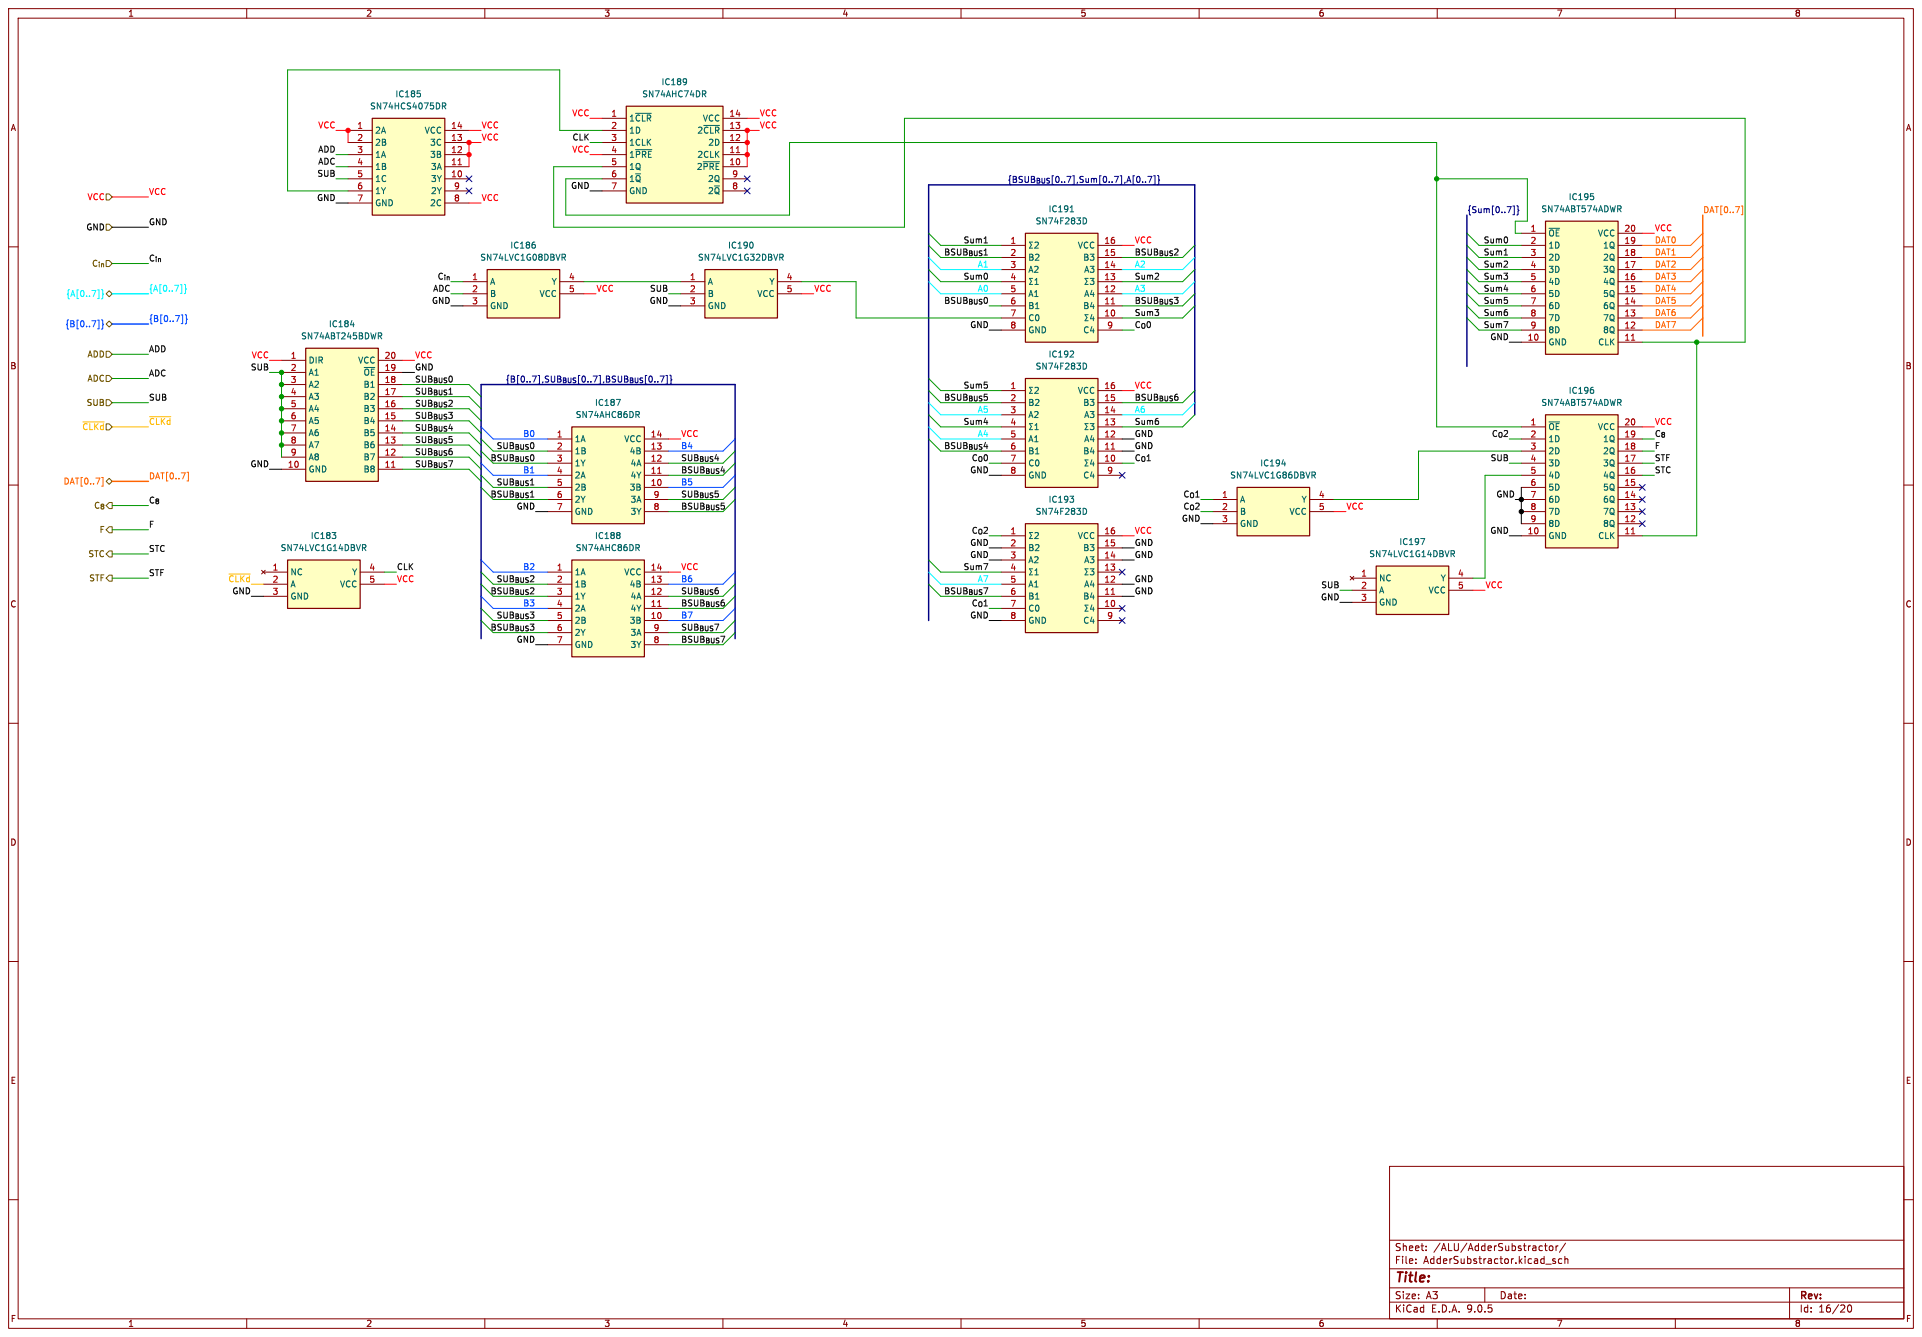
[picture p245: page 15]

Id: 16/20 Title: File: AdderSubstractor.kicad_sch Sheet: /ALU/AdderSubstractor/

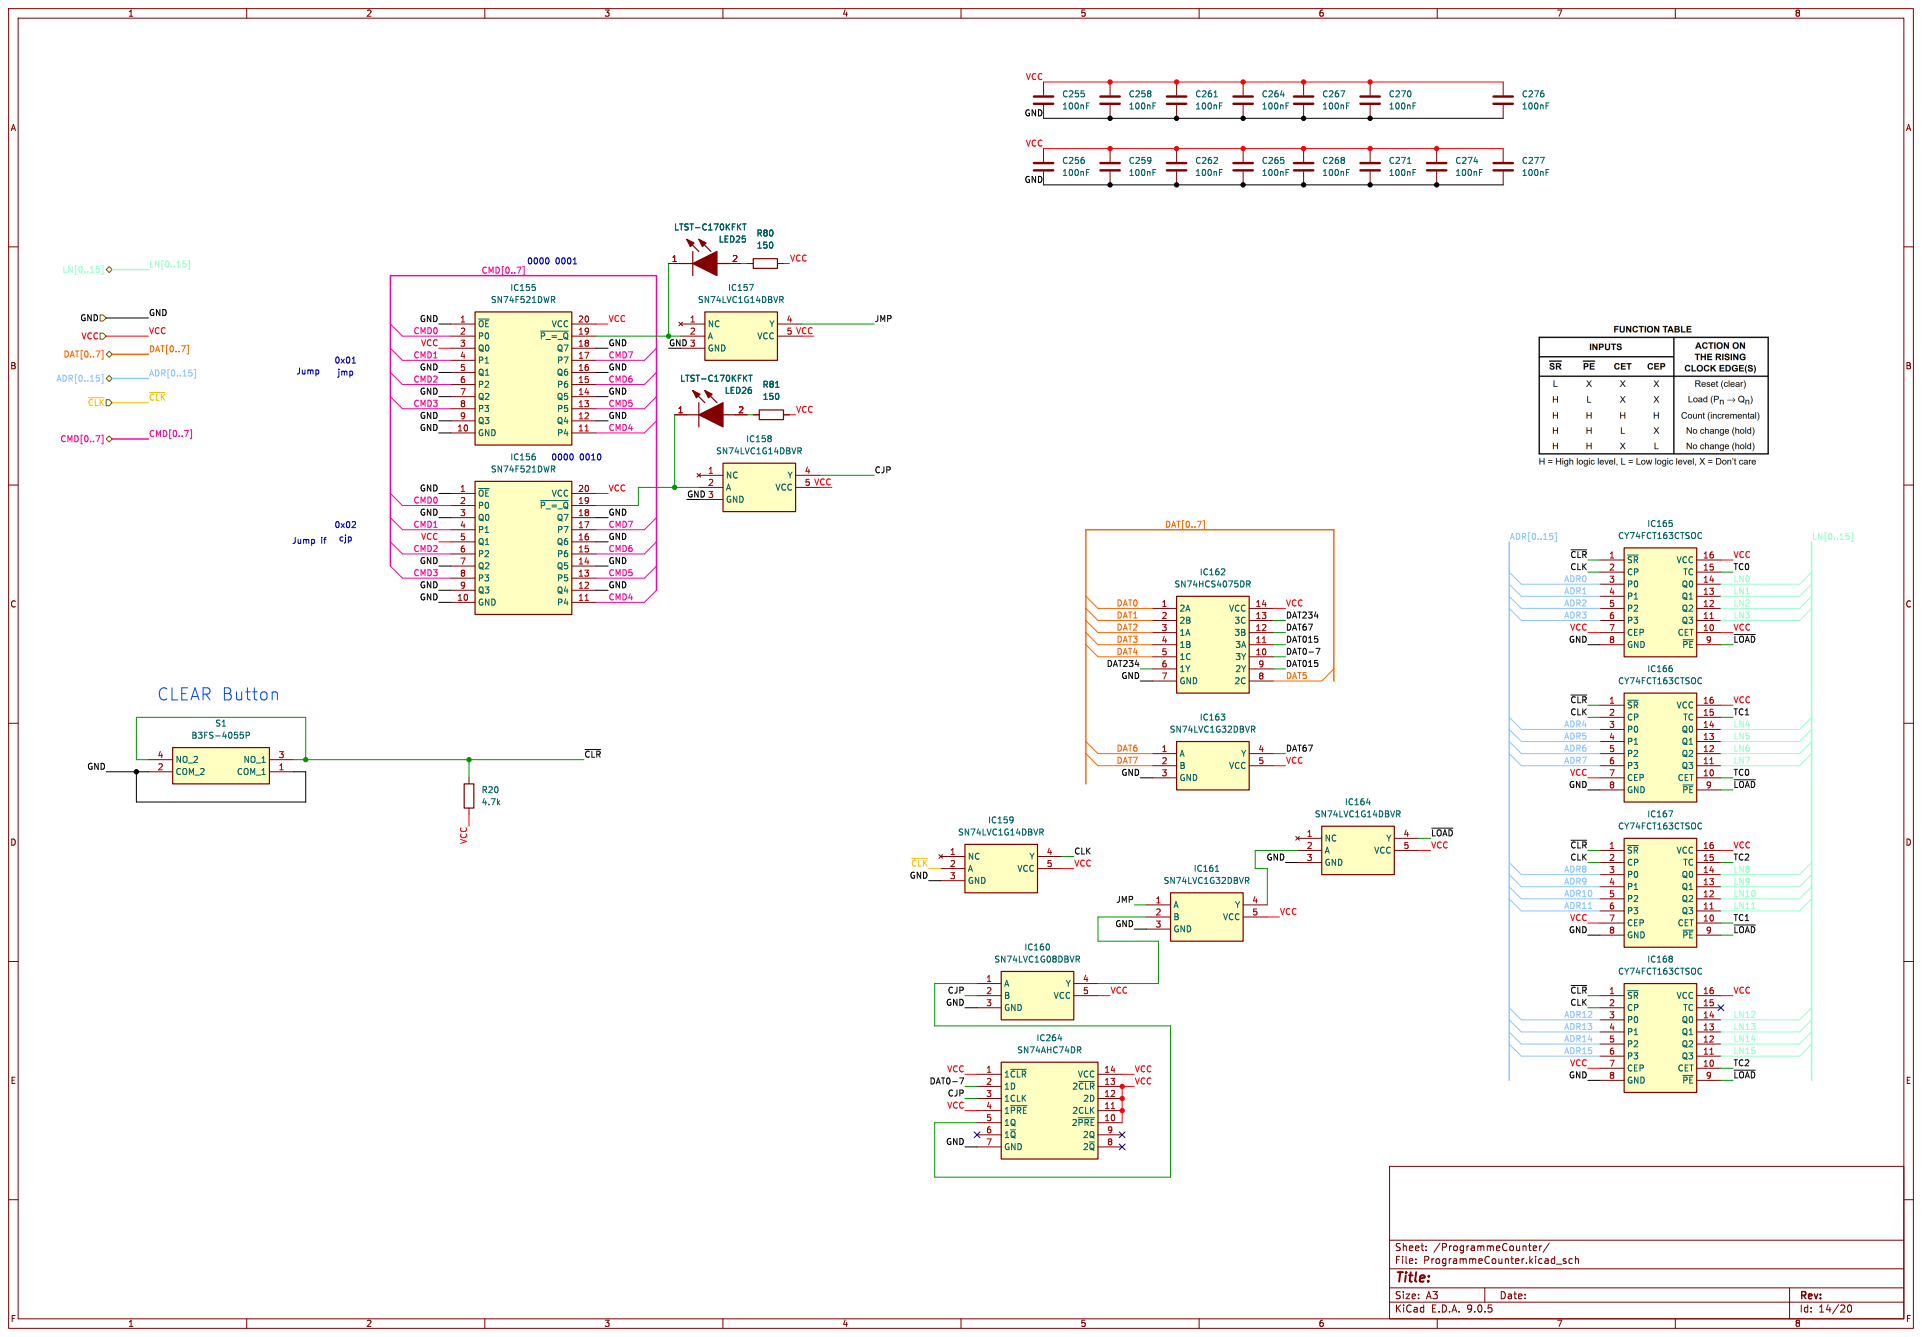
[picture p246: page 16]

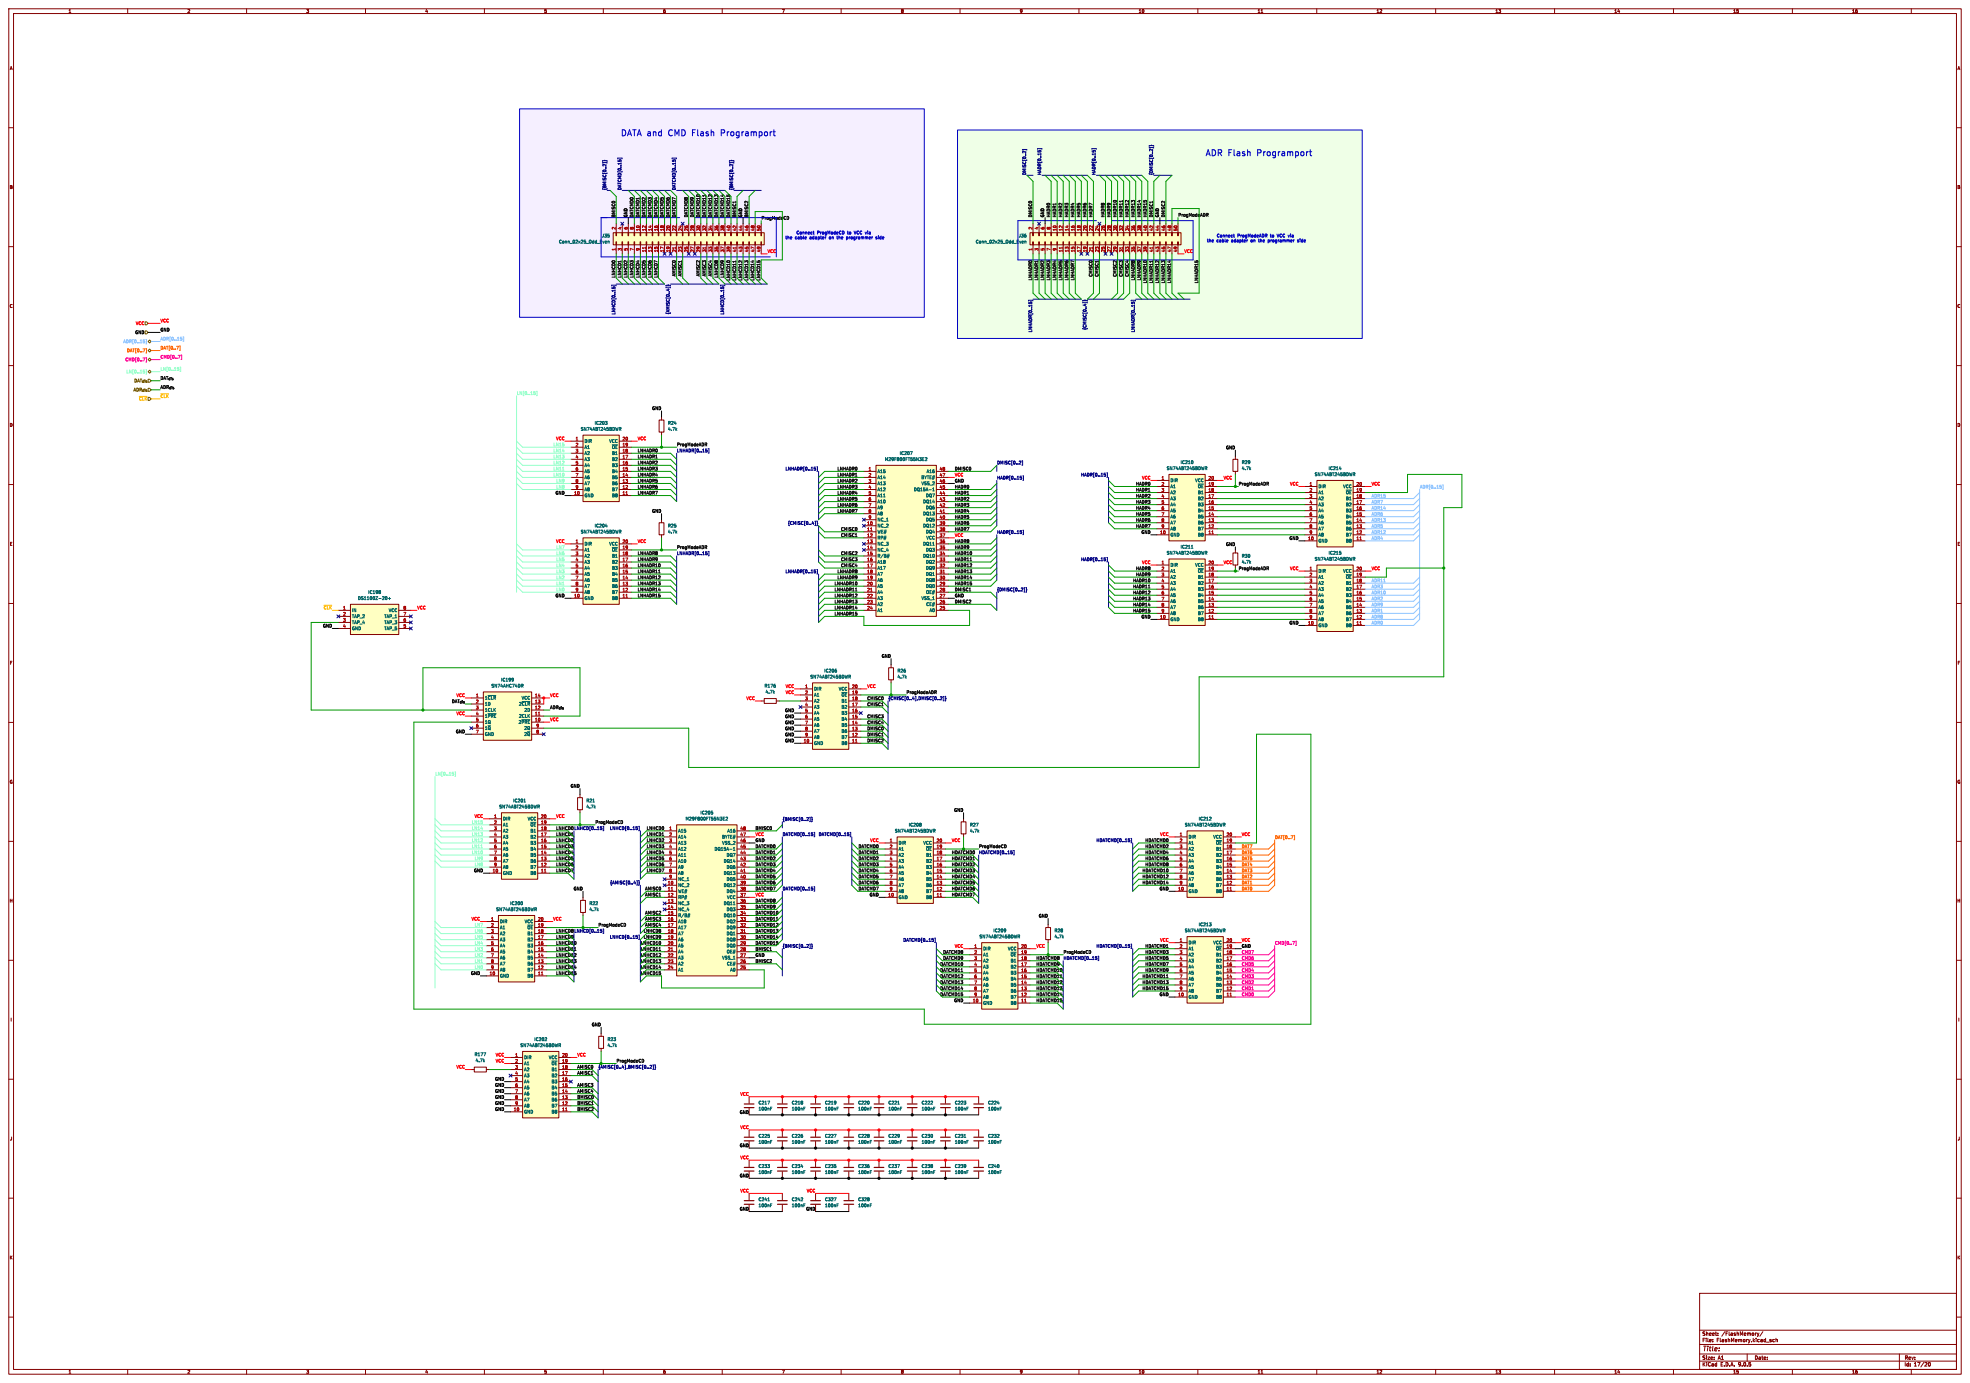
[picture p247: page 17]

Connect ProgModeADR to VCC via

Id: 17/20 Title: File: FlashMemory.kicad_sch Sheet: /FlashMemory/ C225

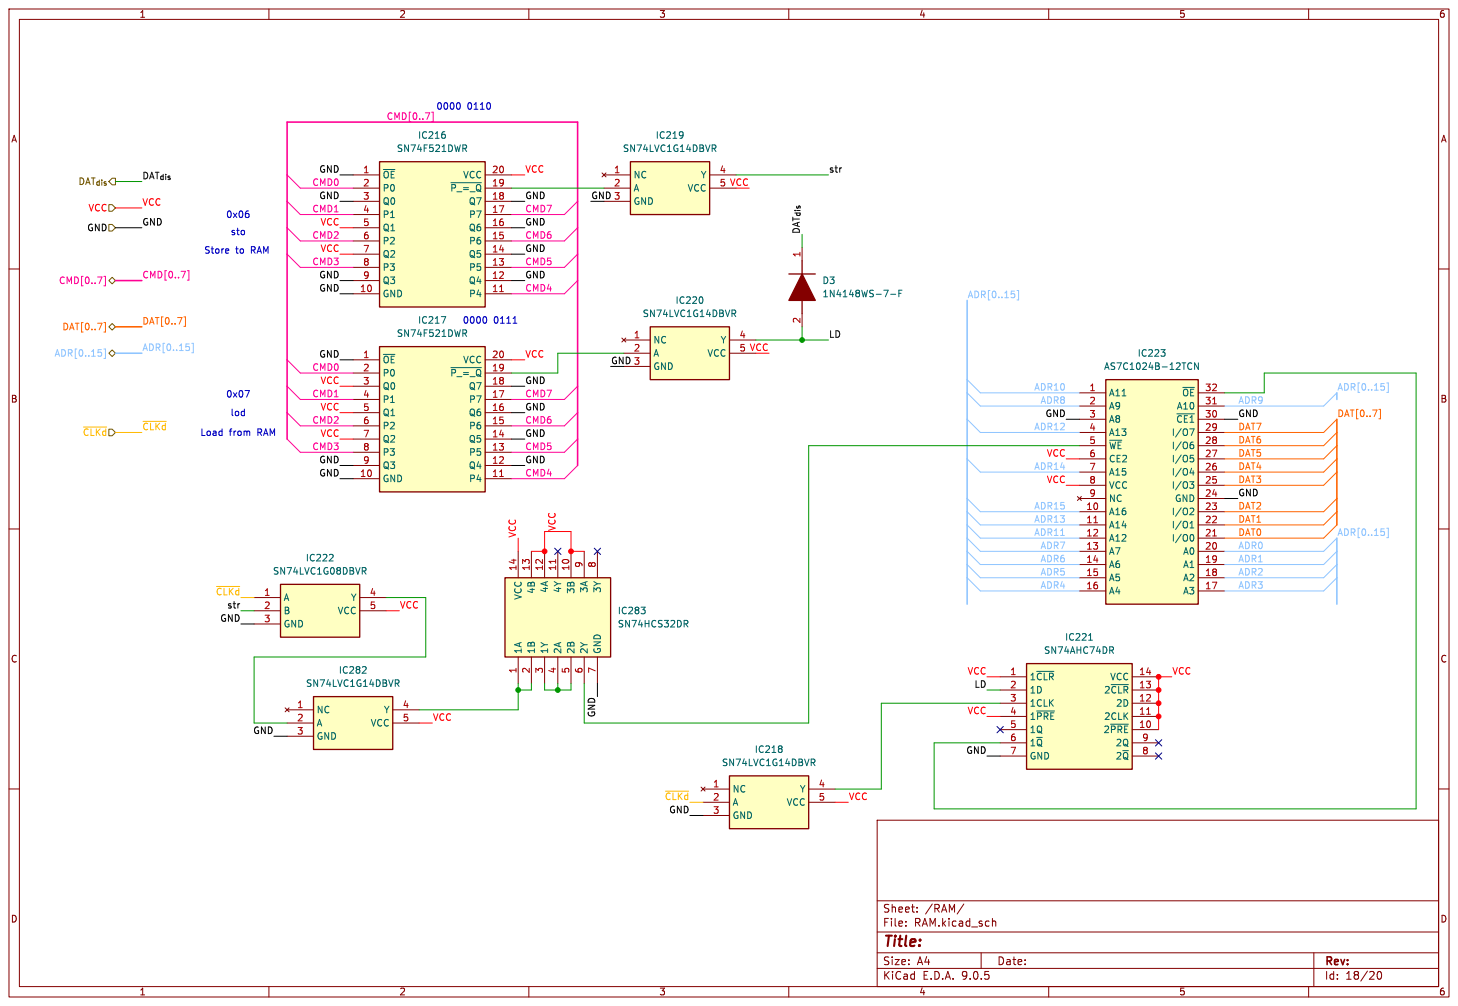
[picture p248: page 18]

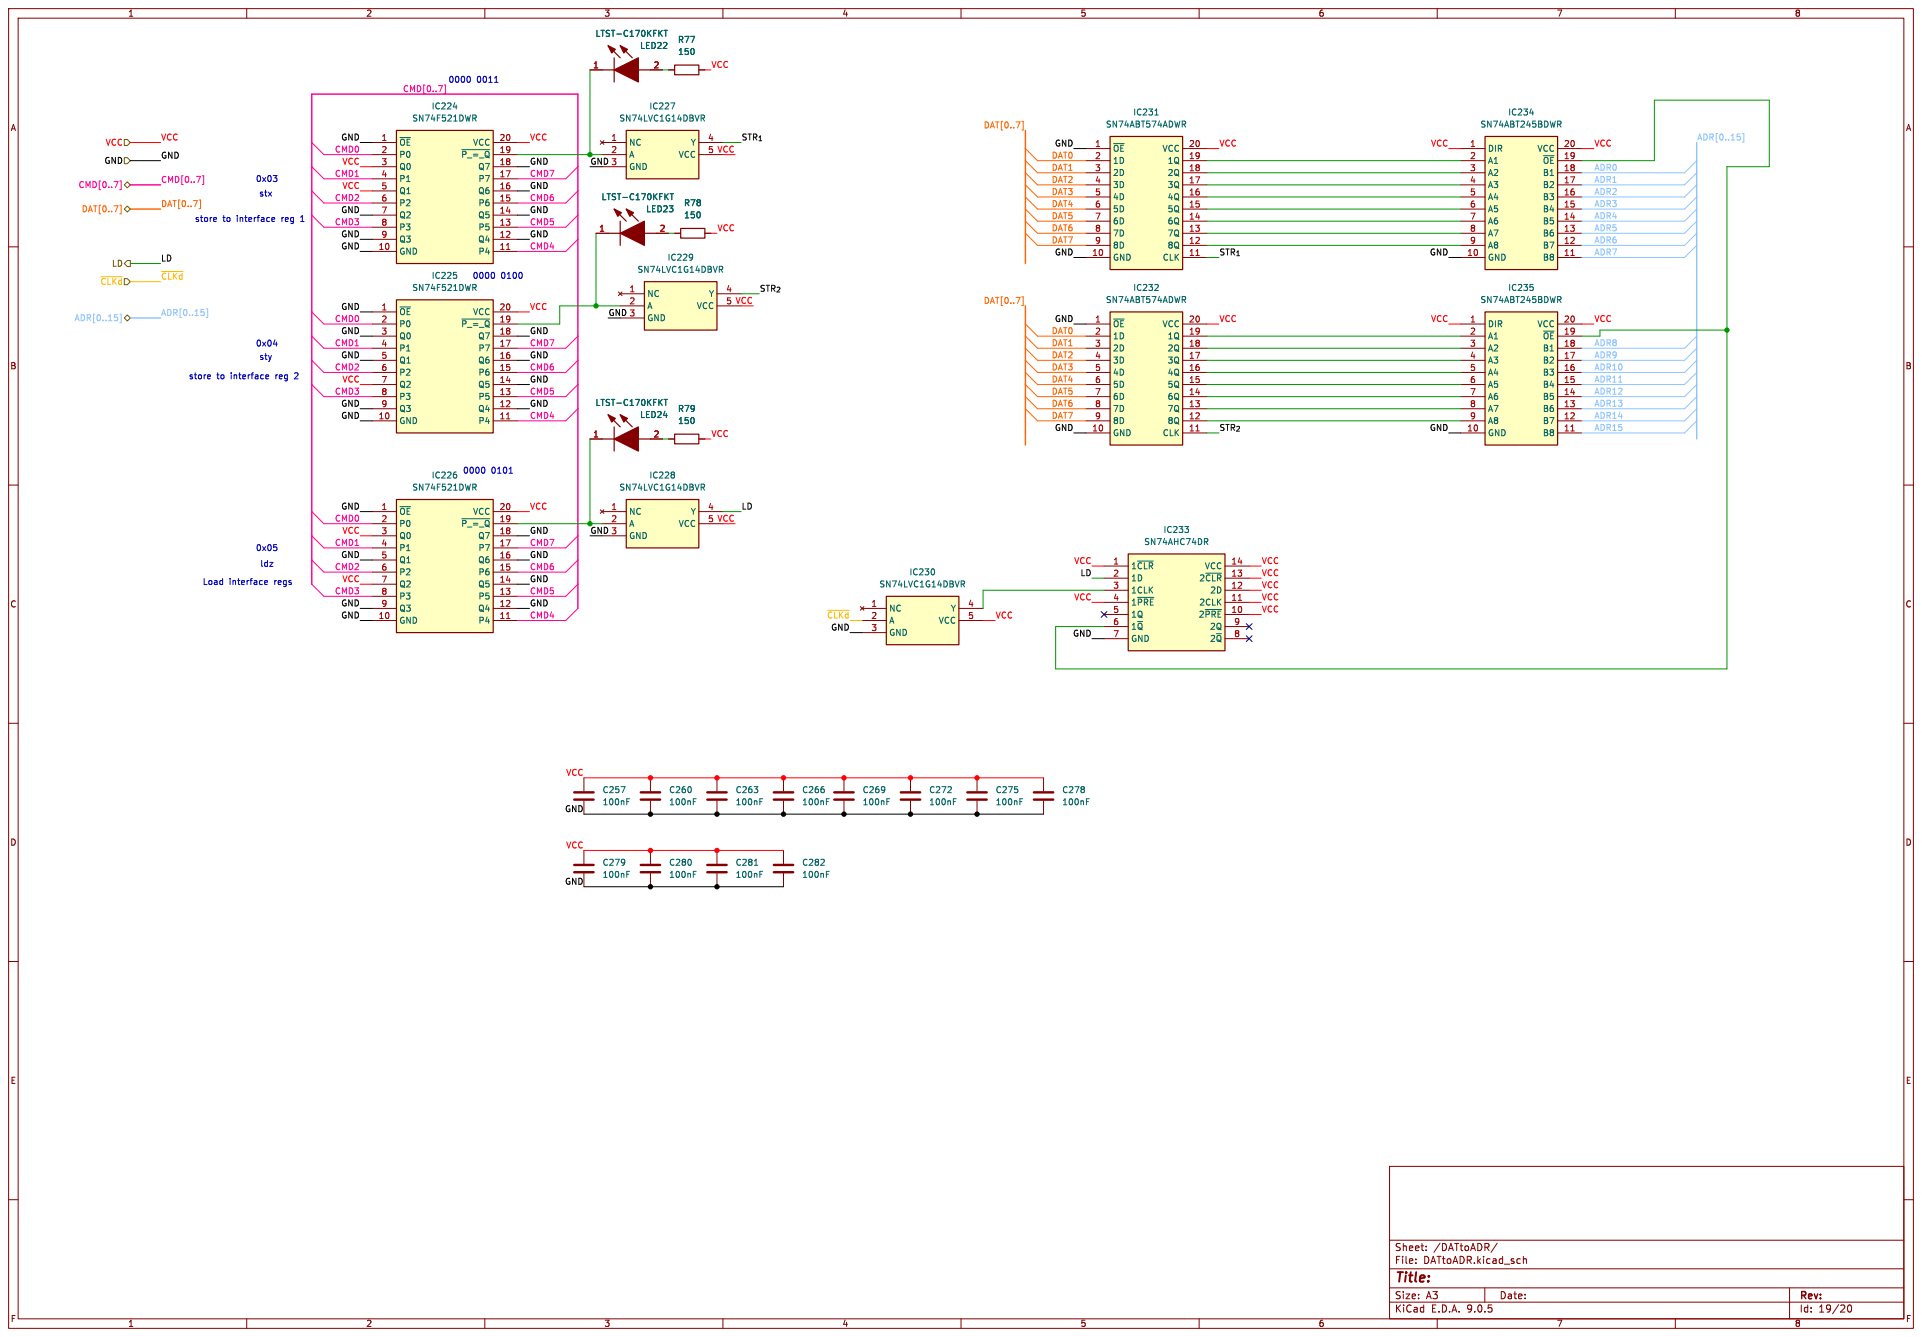
[picture p249: page 19]

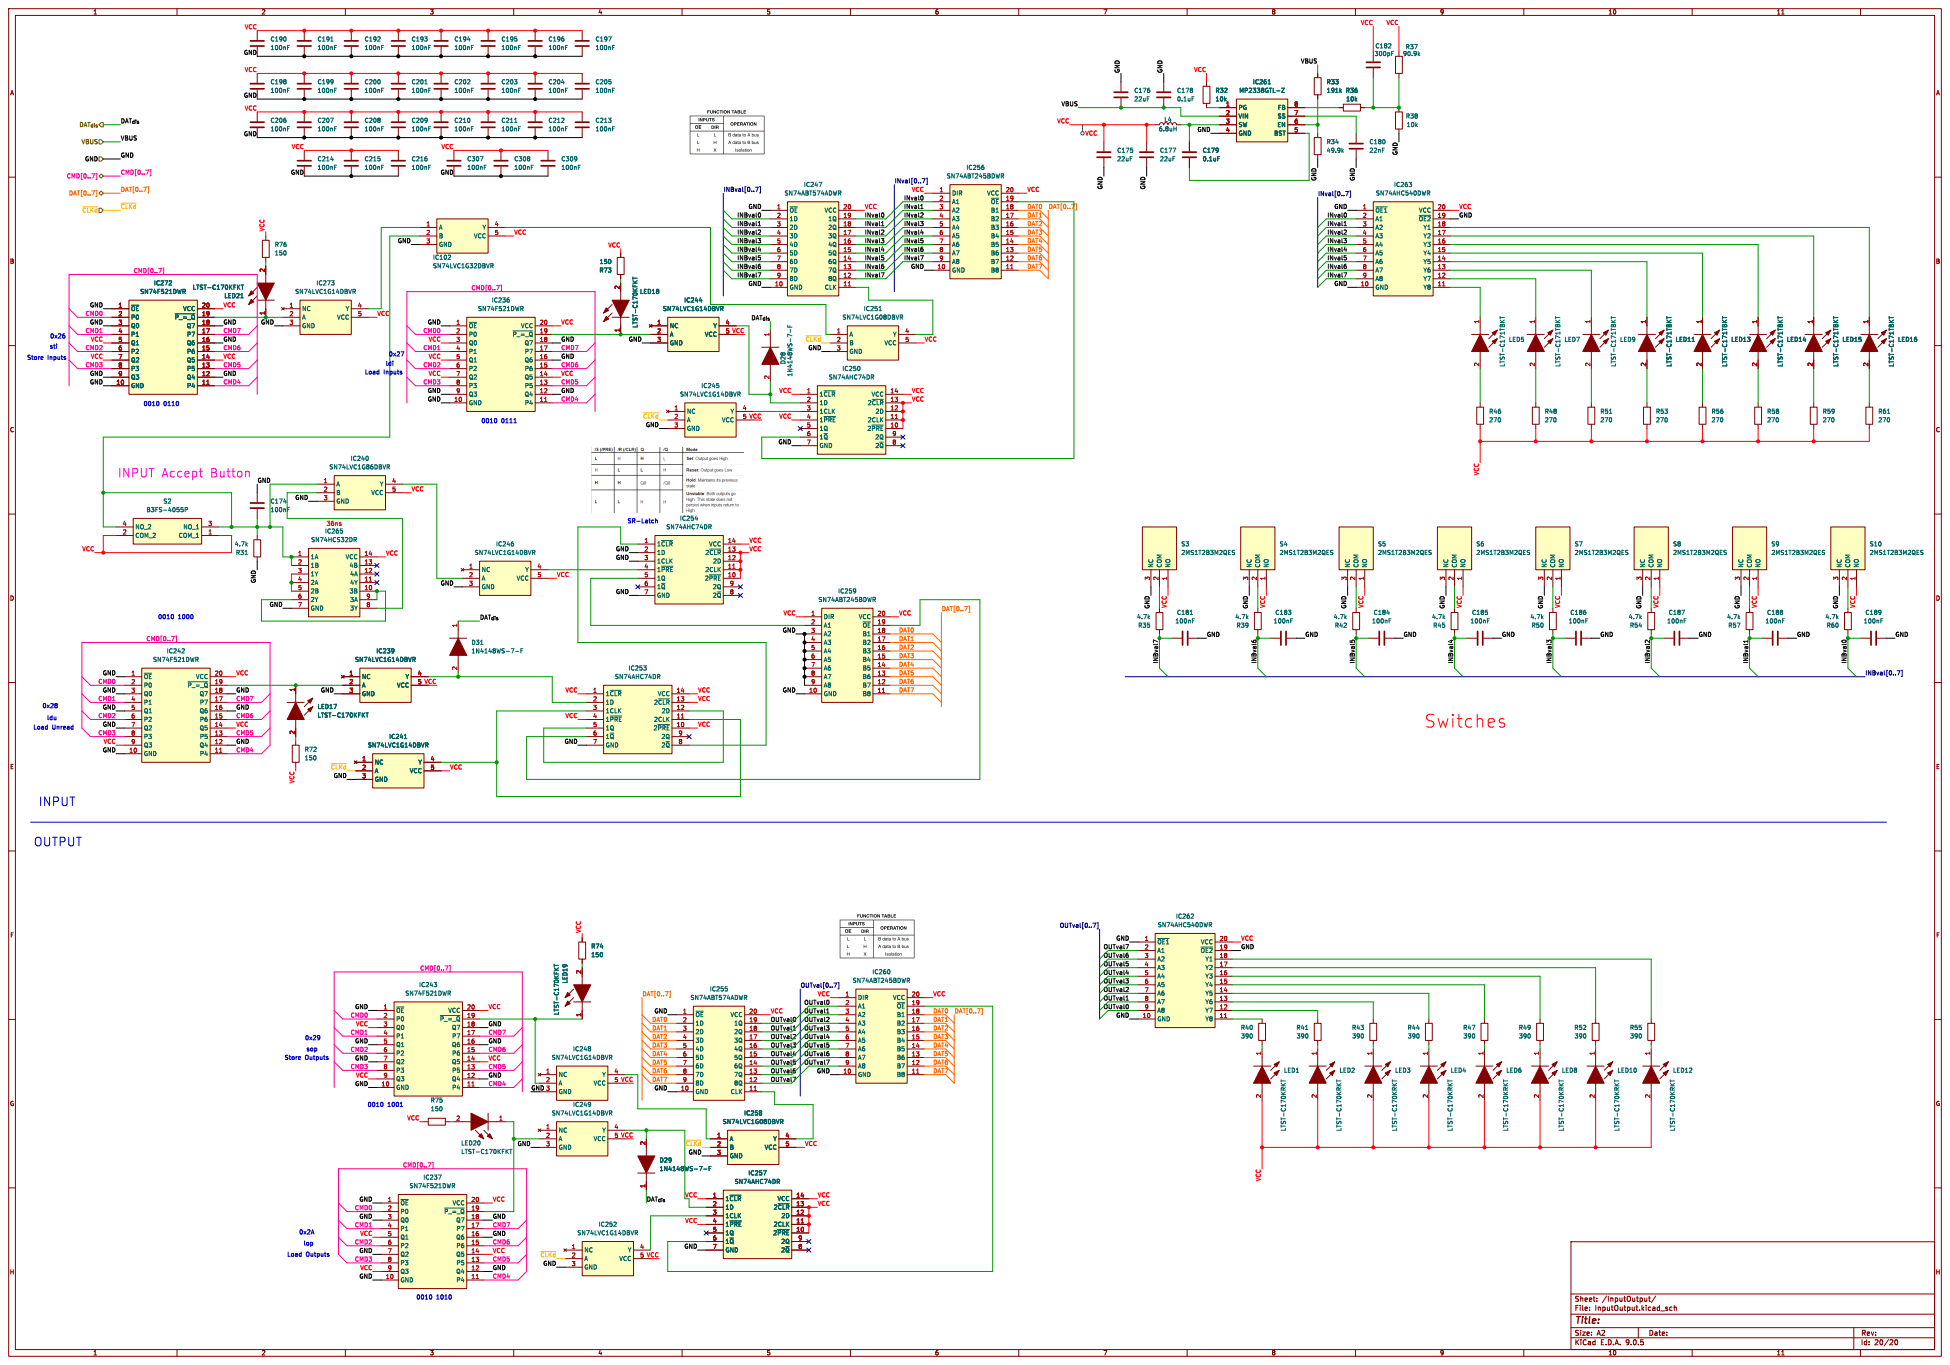
[picture p250: page 20]

VCC VCC GND GND
