SSCsimsi/8Bit_Computer/8Bit Computer ver2.0/Kicad/Computer/8Bit_Computer_SCH_V2.5.pdf

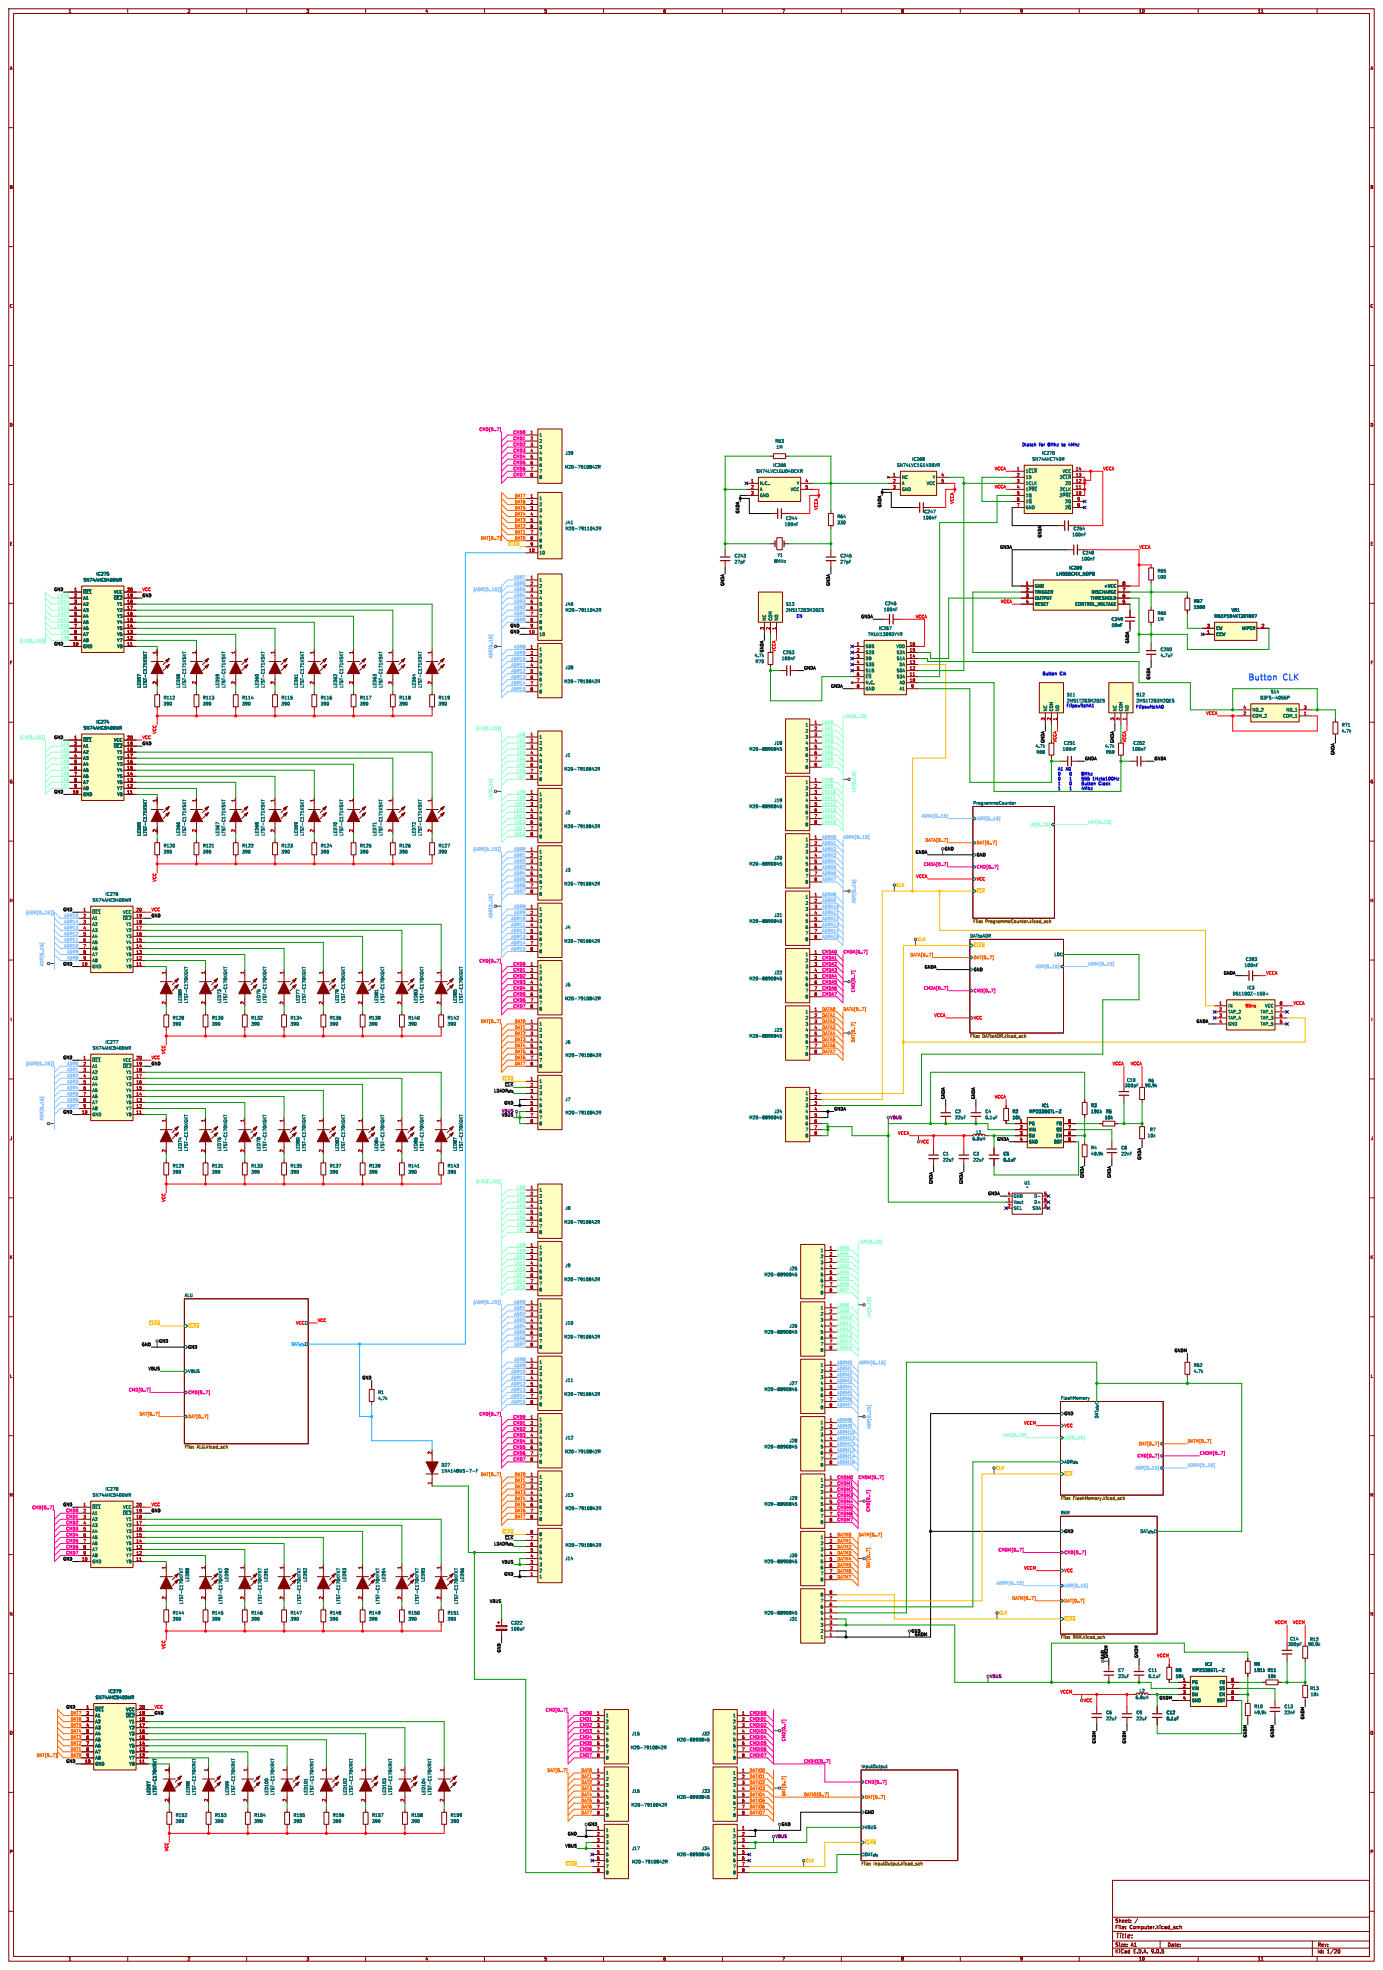
[picture p251: page 1]

Dlatch for 8Mhz to 4Mhz EN

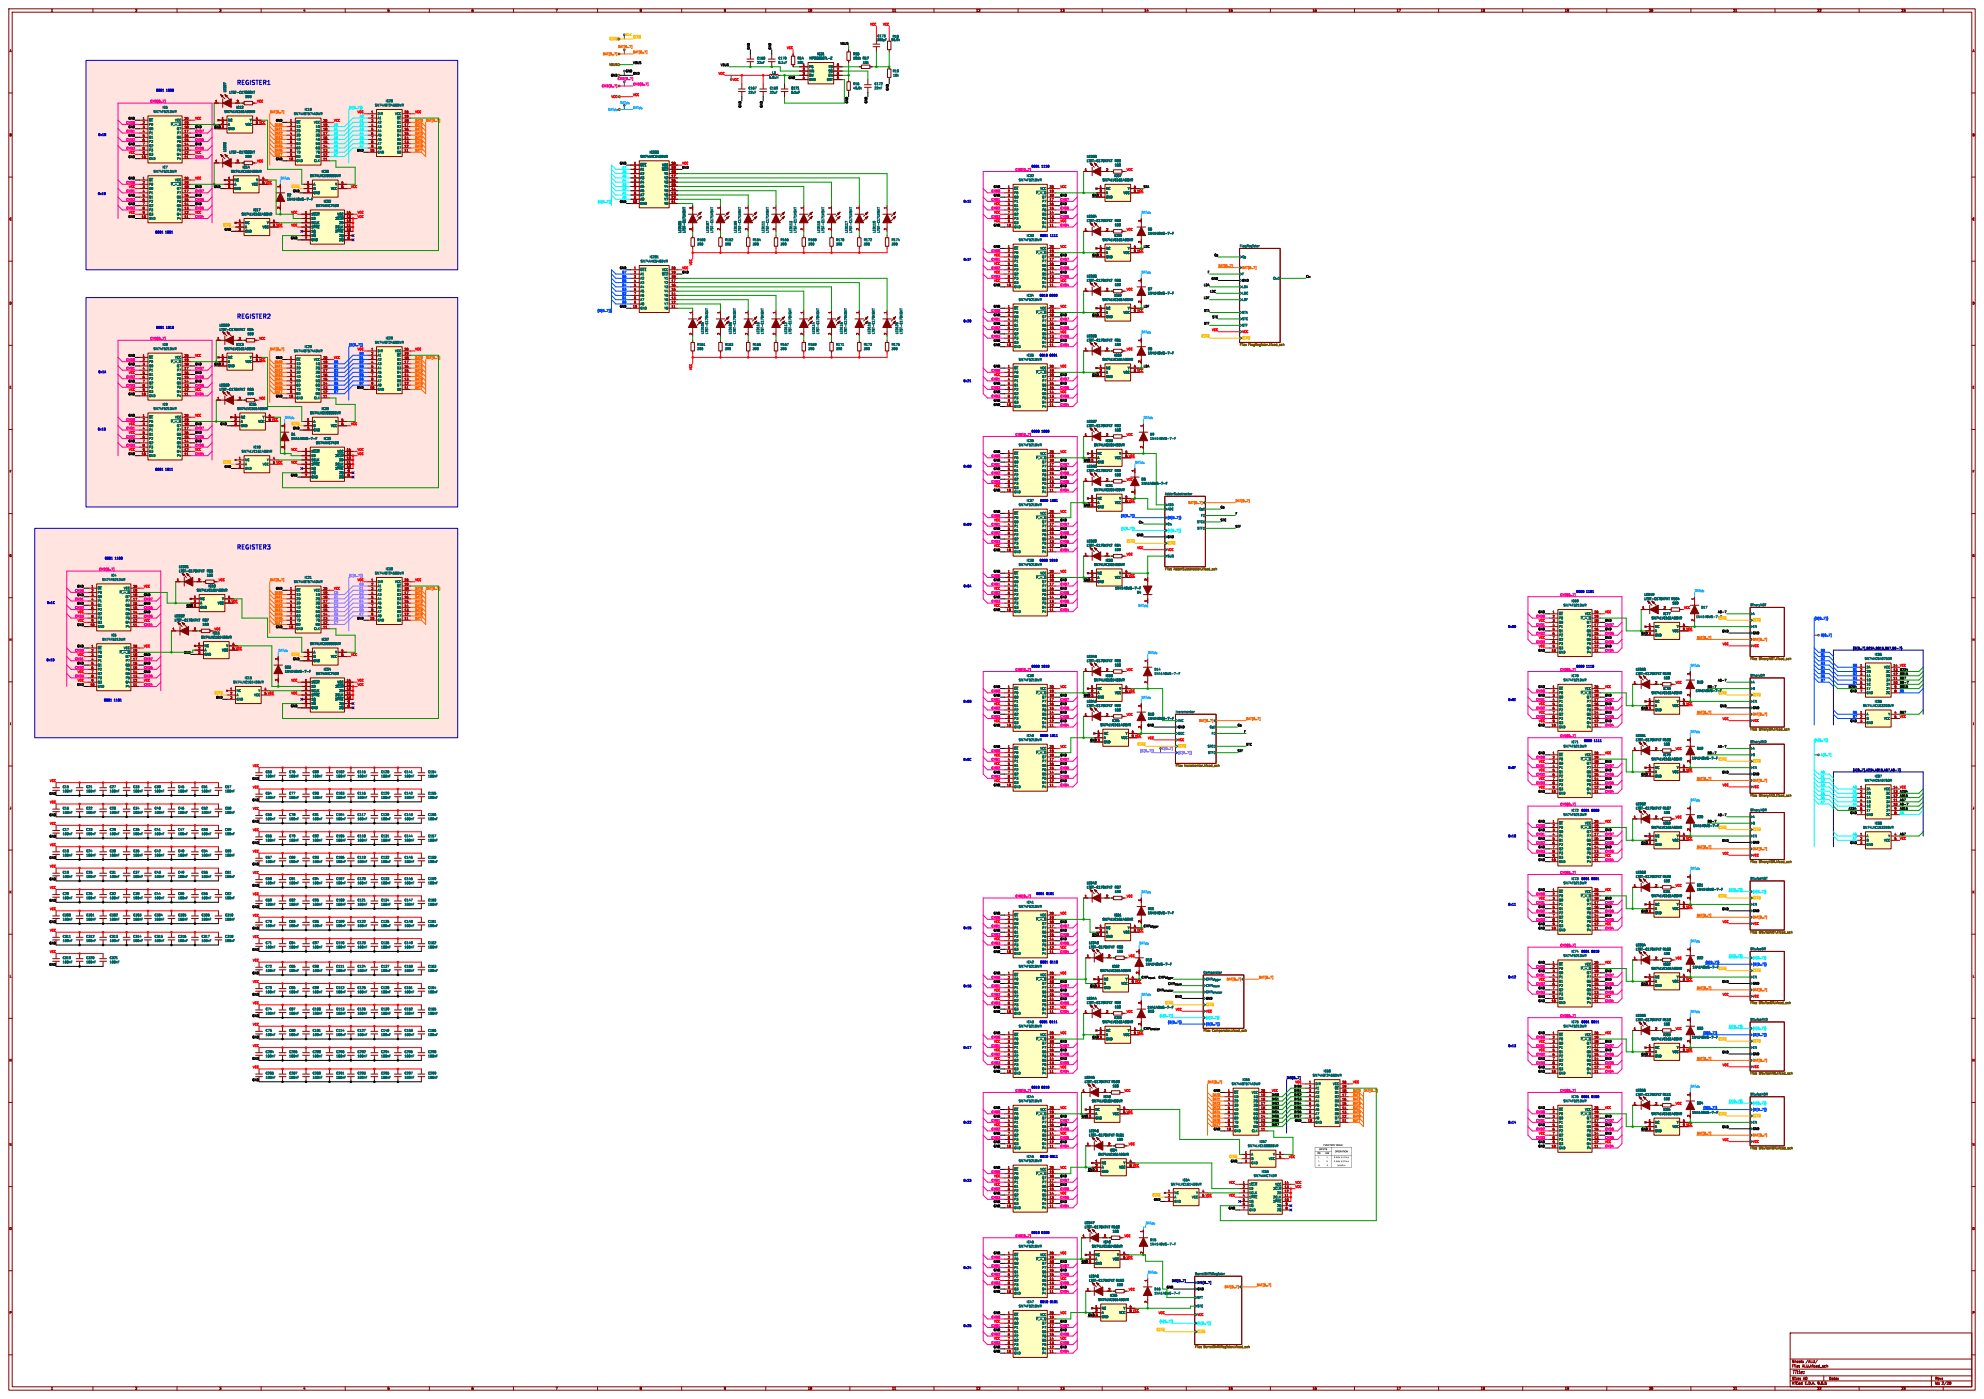
[picture p252: page 2]

{B[0..7],B234,B015,B67,B0-7} B0B4B3 B234B6B7 GND GND VCC GND

~{CLKd} AdderSubstractor File: AdderSubstractor.kicad_sch

CMD0 VCC GND GND GND GND GND

CMD1 GND
VCC GND GND GND

SFT BarrelShiftRegister File: BarrelShiftRegister.kicad_sch

Id: 2/20 Title: File: ALU.kicad_sch Sheet: /ALU/



Id: 4/20 Title: File: BinaryNOT.kicad_sch Sheet: /ALU/BinaryNOT/


Id: 5/20 Title: File: BinaryOR.kicad_sch Sheet: /ALU/BinaryOR/


Id: 6/20 Title: File: BinaryXOR.kicad_sch Sheet: /ALU/BinaryXOR/



Id: 8/20 Title: File: BitwiseNOT.kicad_sch Sheet: /ALU/BitwiseNOT/


Id: 9/20 Title: File: BitwiseOR.kicad_sch Sheet: /ALU/BitwiseOR/


Id: 10/20 Title: File: BitwiseXOR.kicad_sch Sheet: /ALU/BitwiseXOR/

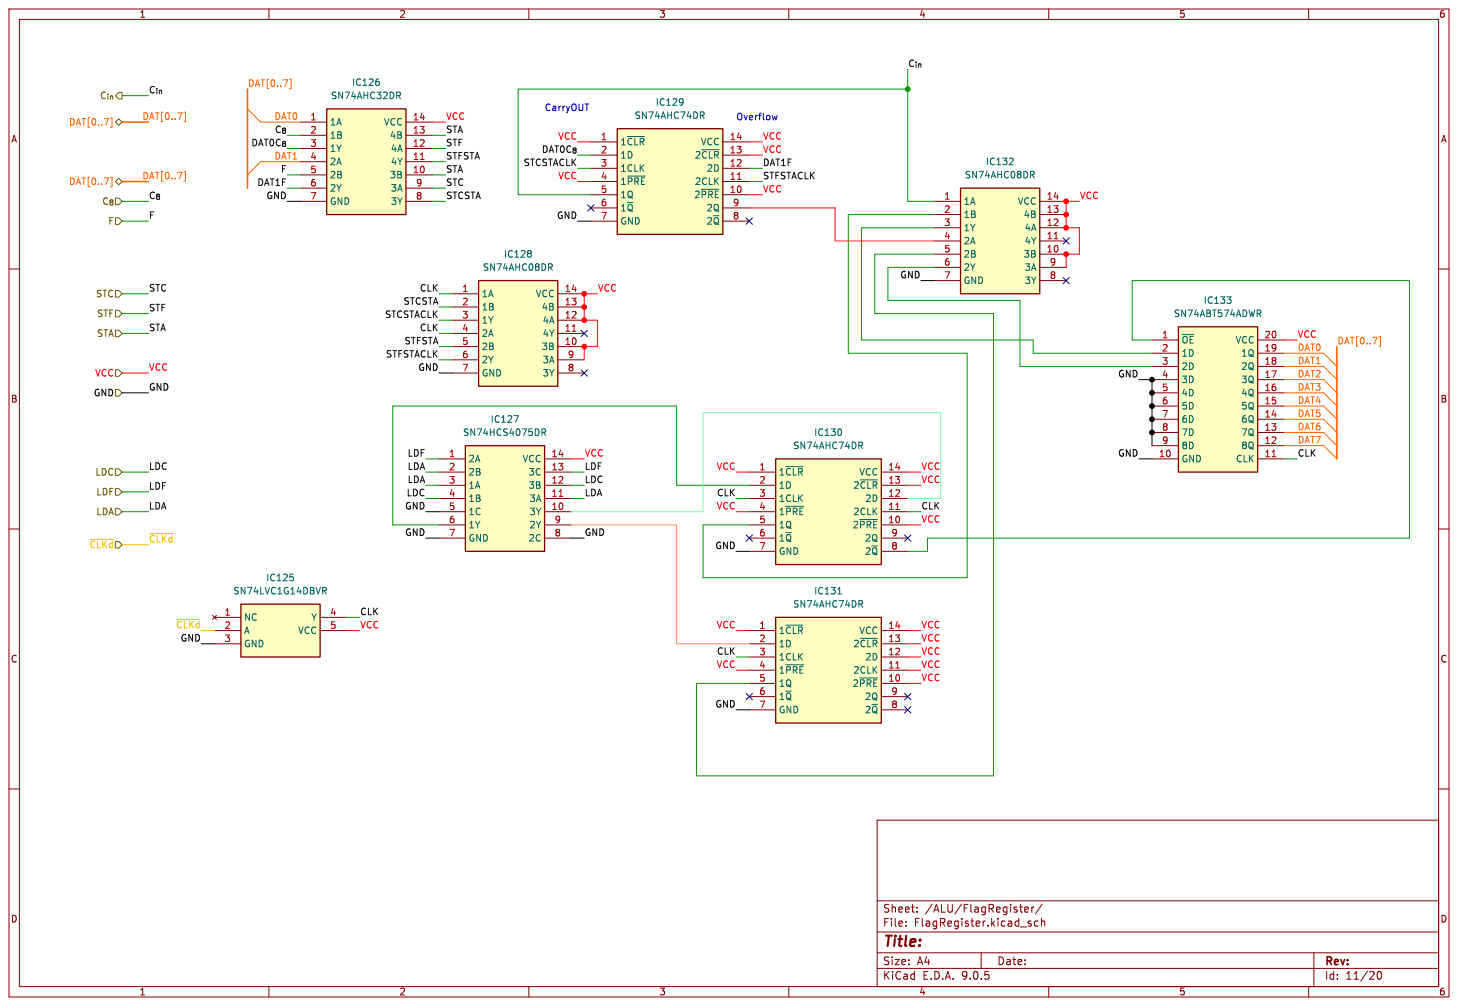
[picture p253: page 11]

Id: 11/20 Title: File: FlagRegister.kicad_sch Sheet: /ALU/FlagRegister/



Id: 13/20 Title: File: Comparator.kicad_sch Sheet: /ALU/Comparator/


DAT[0..7] VCC
DIS[0..7] SFT DAT[0..7] STC
{A[0..7]} GND


Id: 16/20 Title: File: AdderSubstractor.kicad_sch Sheet: /ALU/AdderSubstractor/

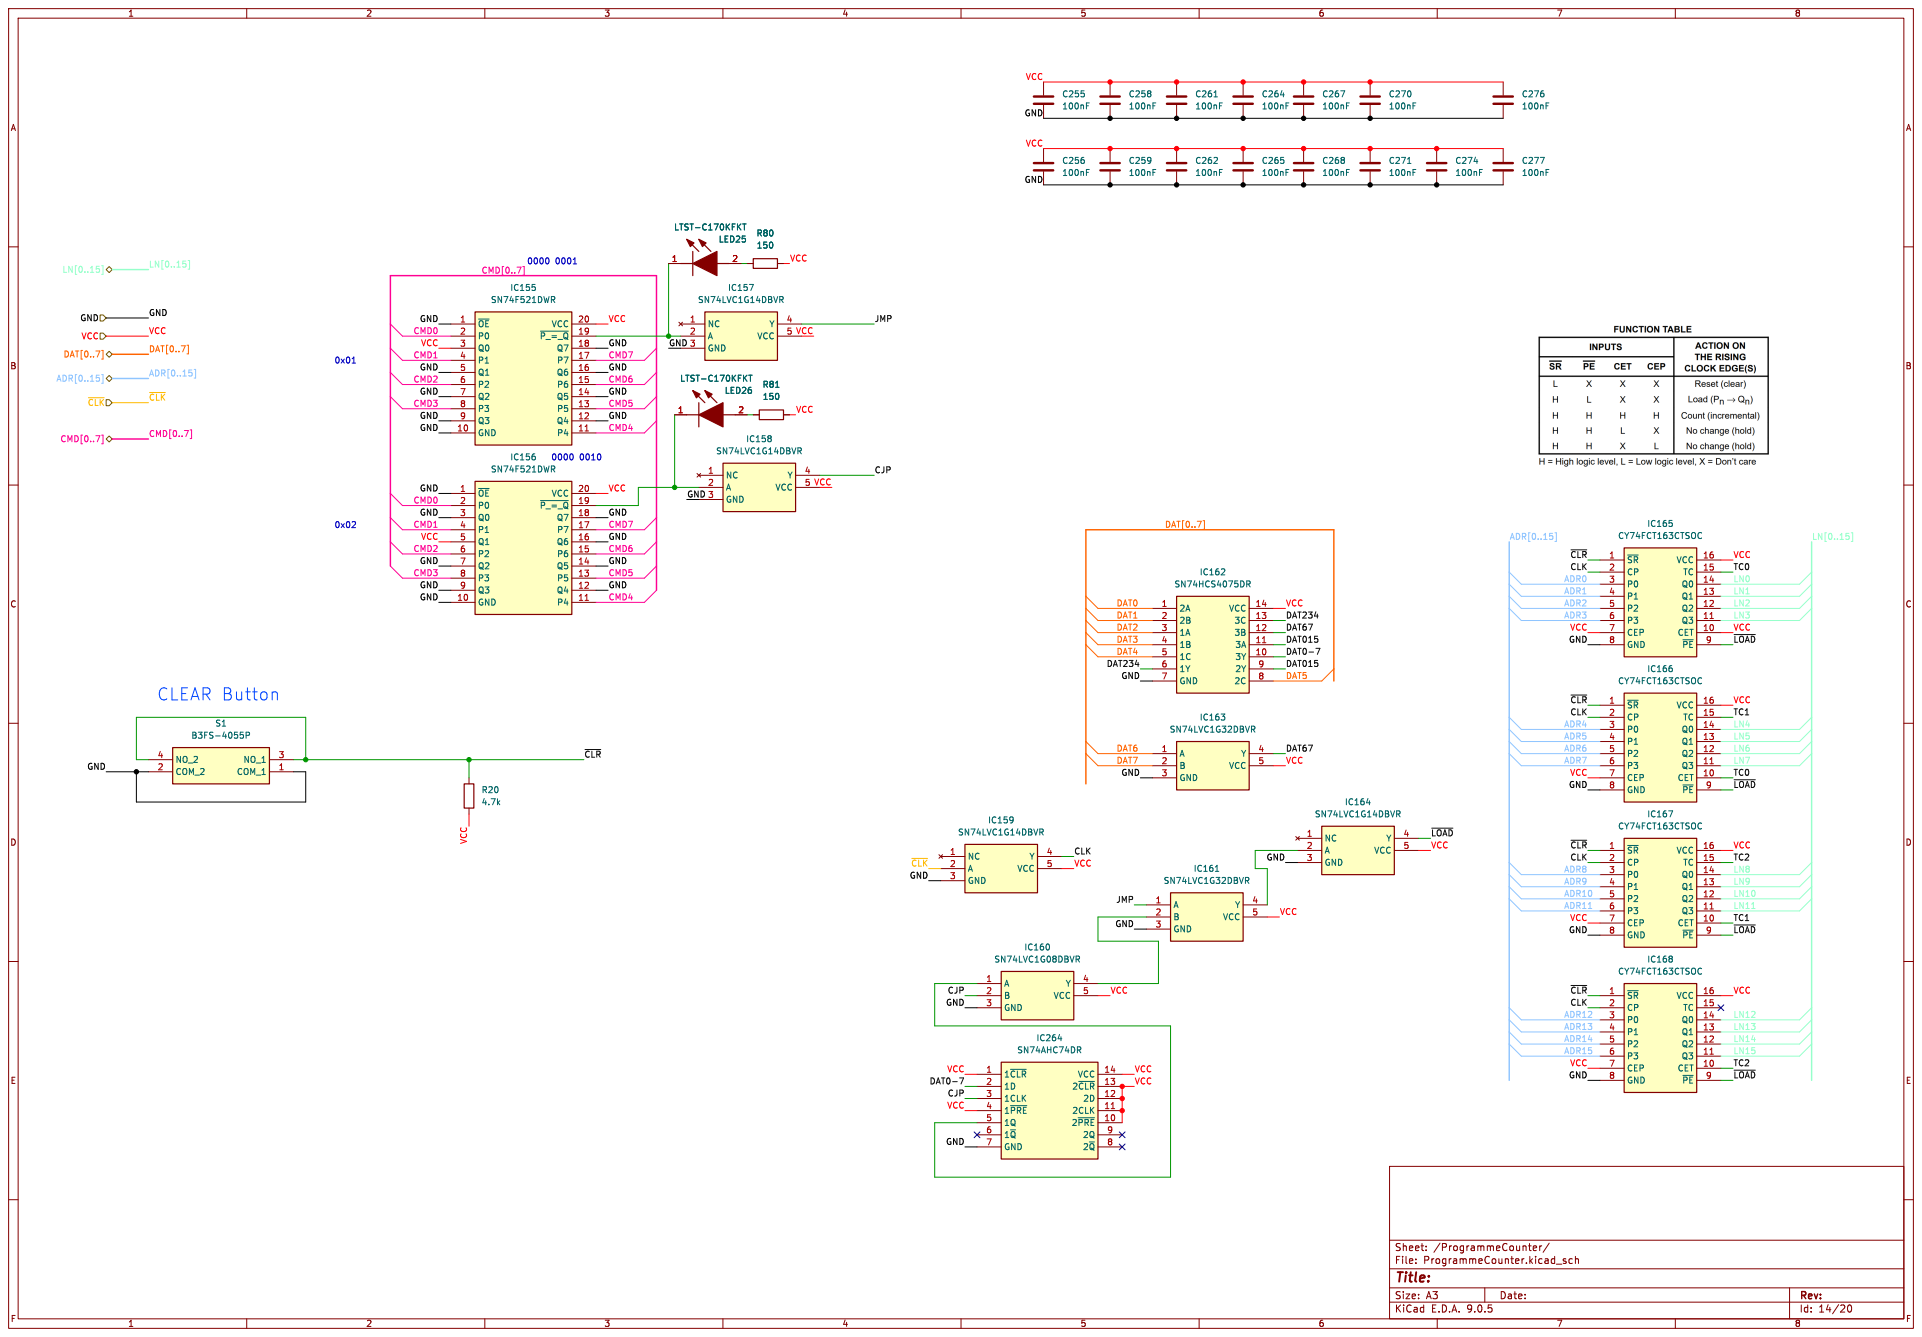
[picture p254: page 16]

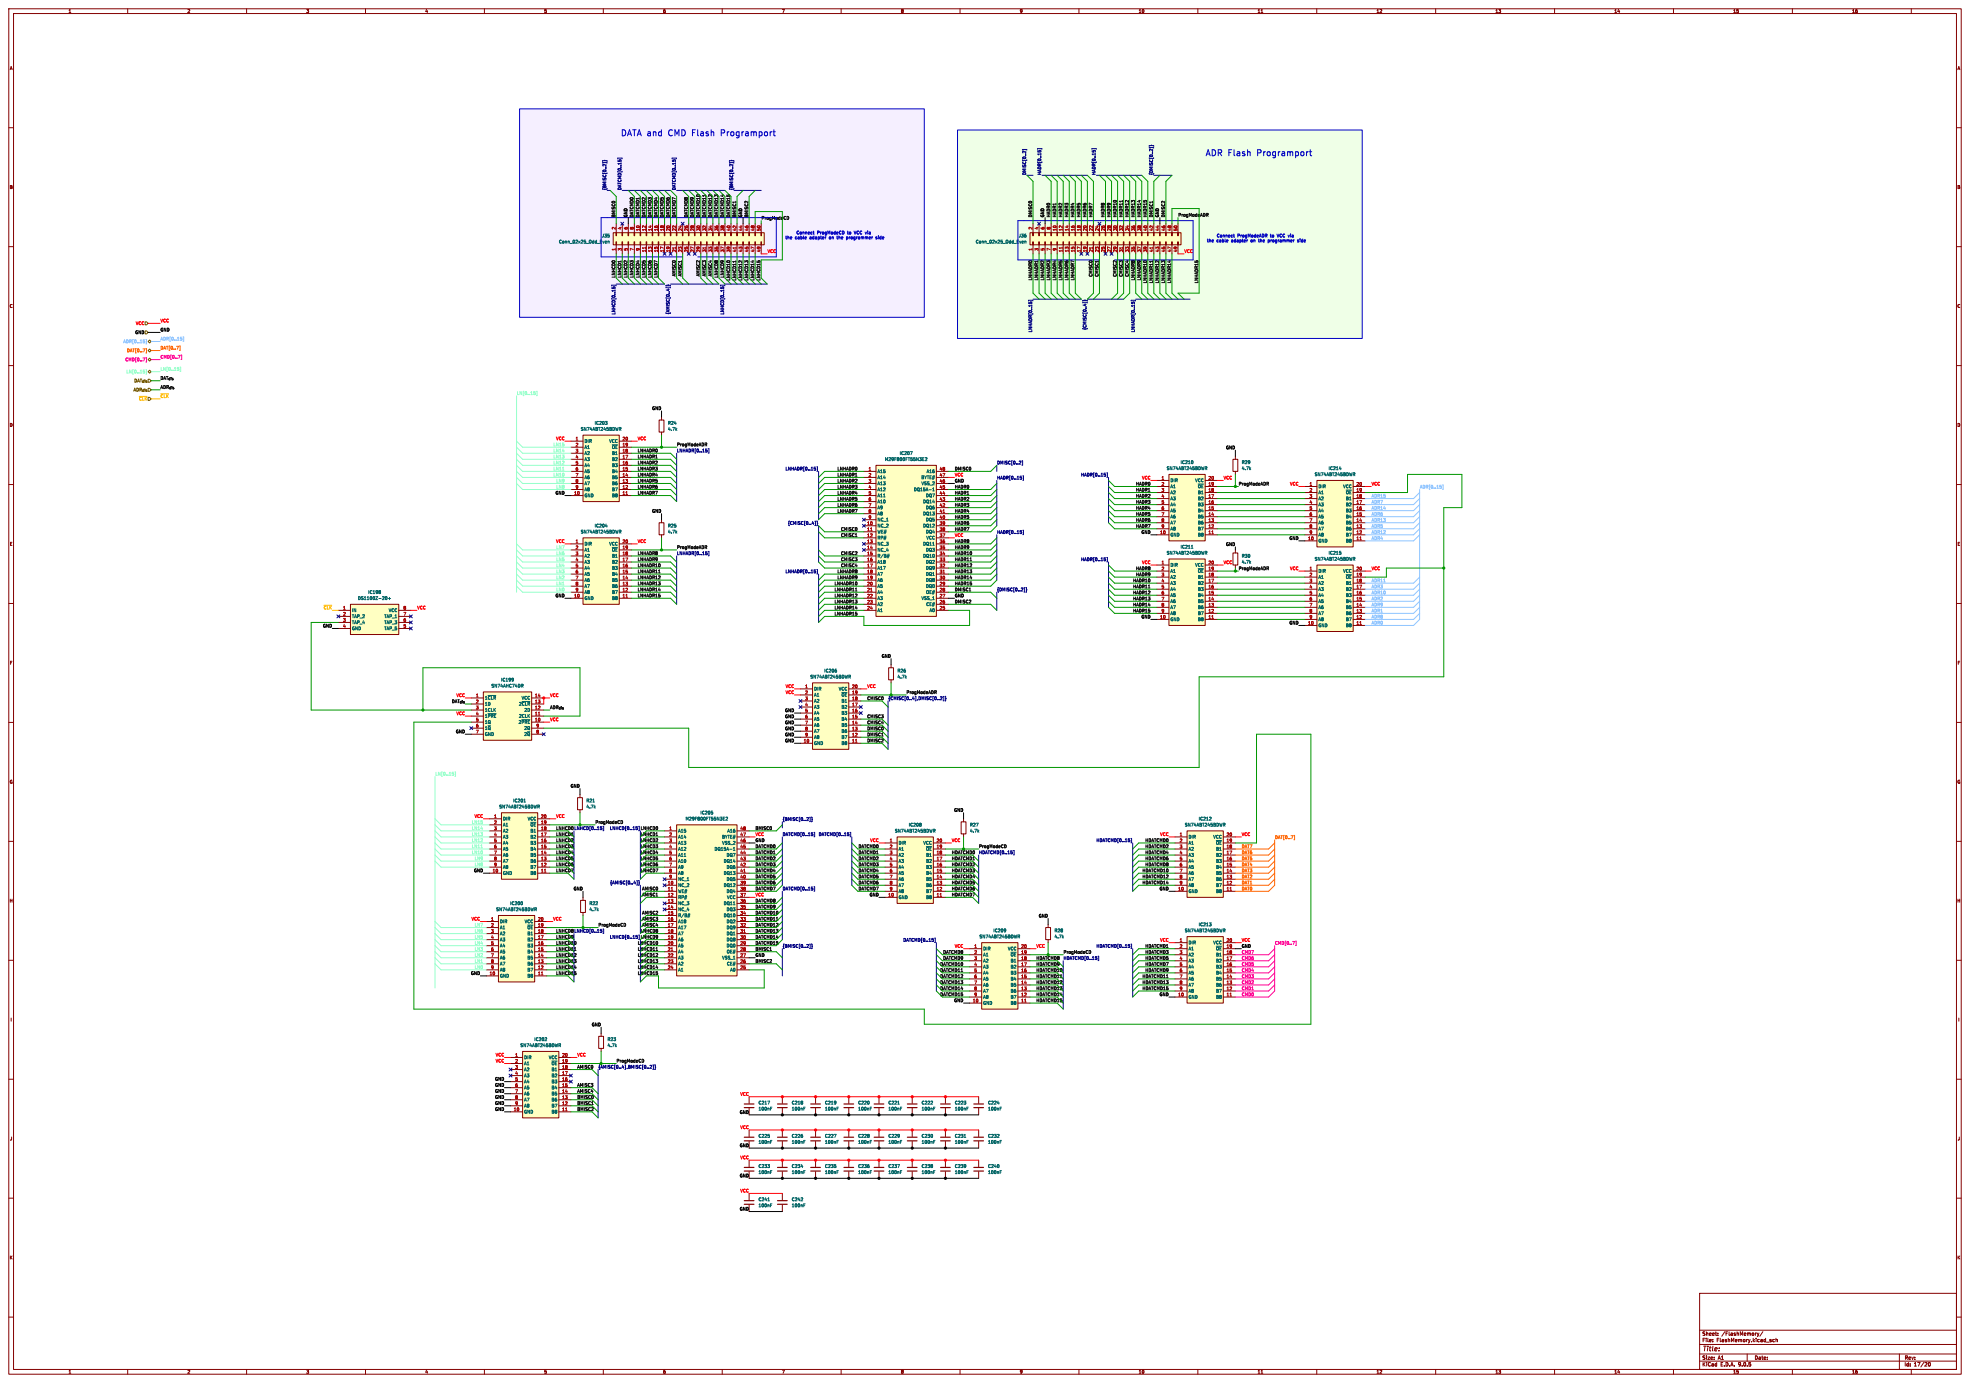
[picture p255: page 17]

Id: 17/20 Title: File: FlashMemory.kicad_sch Sheet: /FlashMemory/

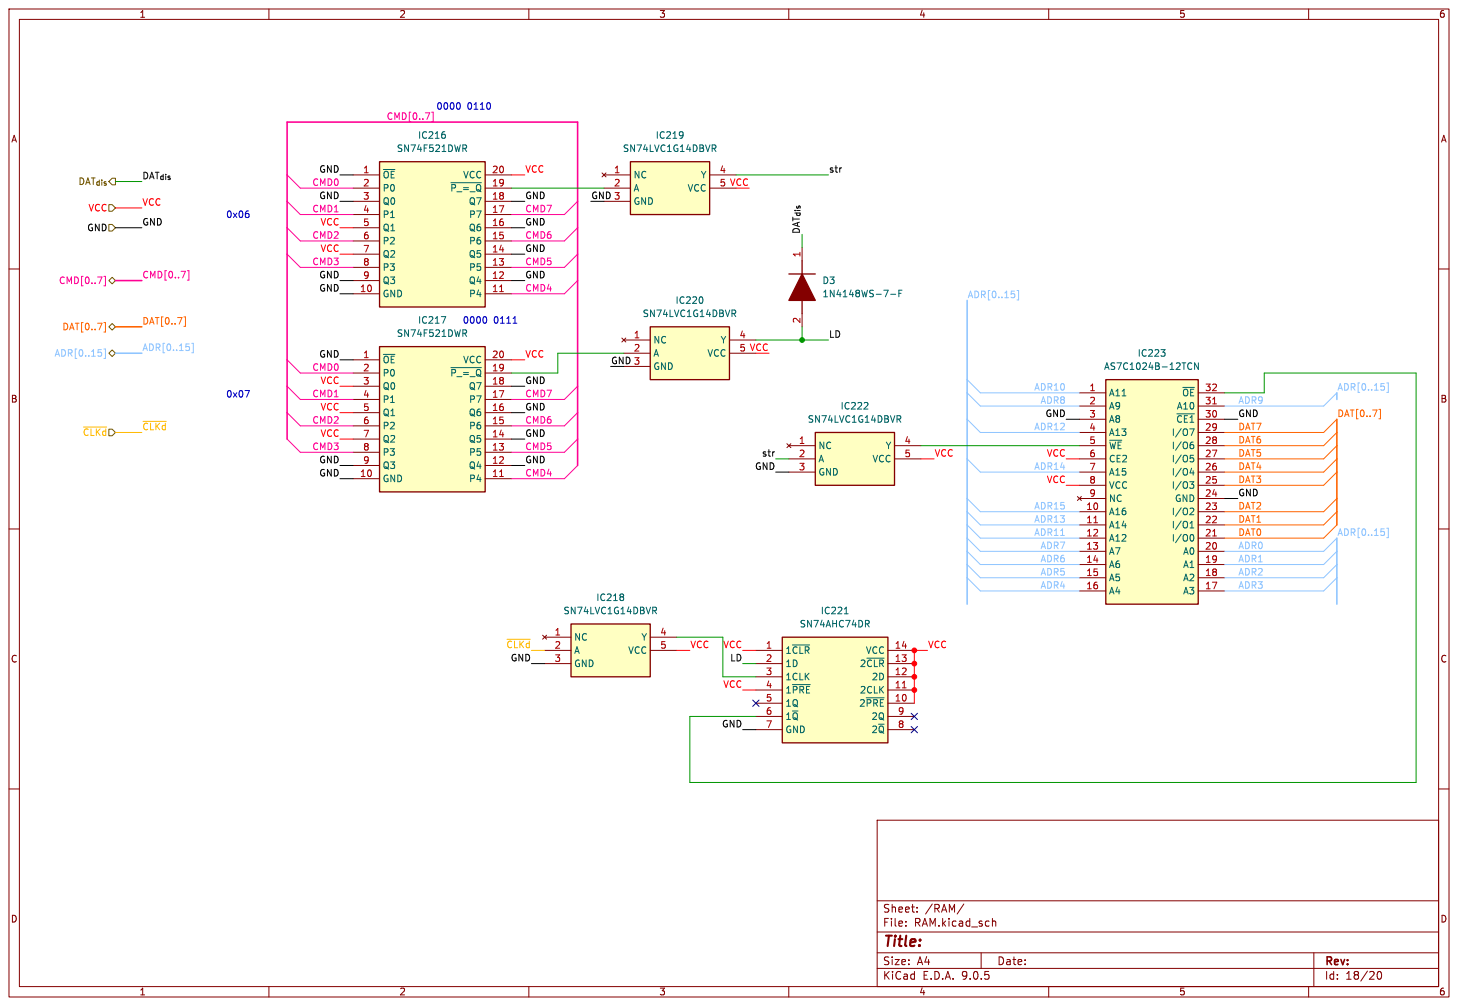
[picture p256: page 18]

Id: 18/20 Title: File: RAM.kicad_sch Sheet: /RAM/

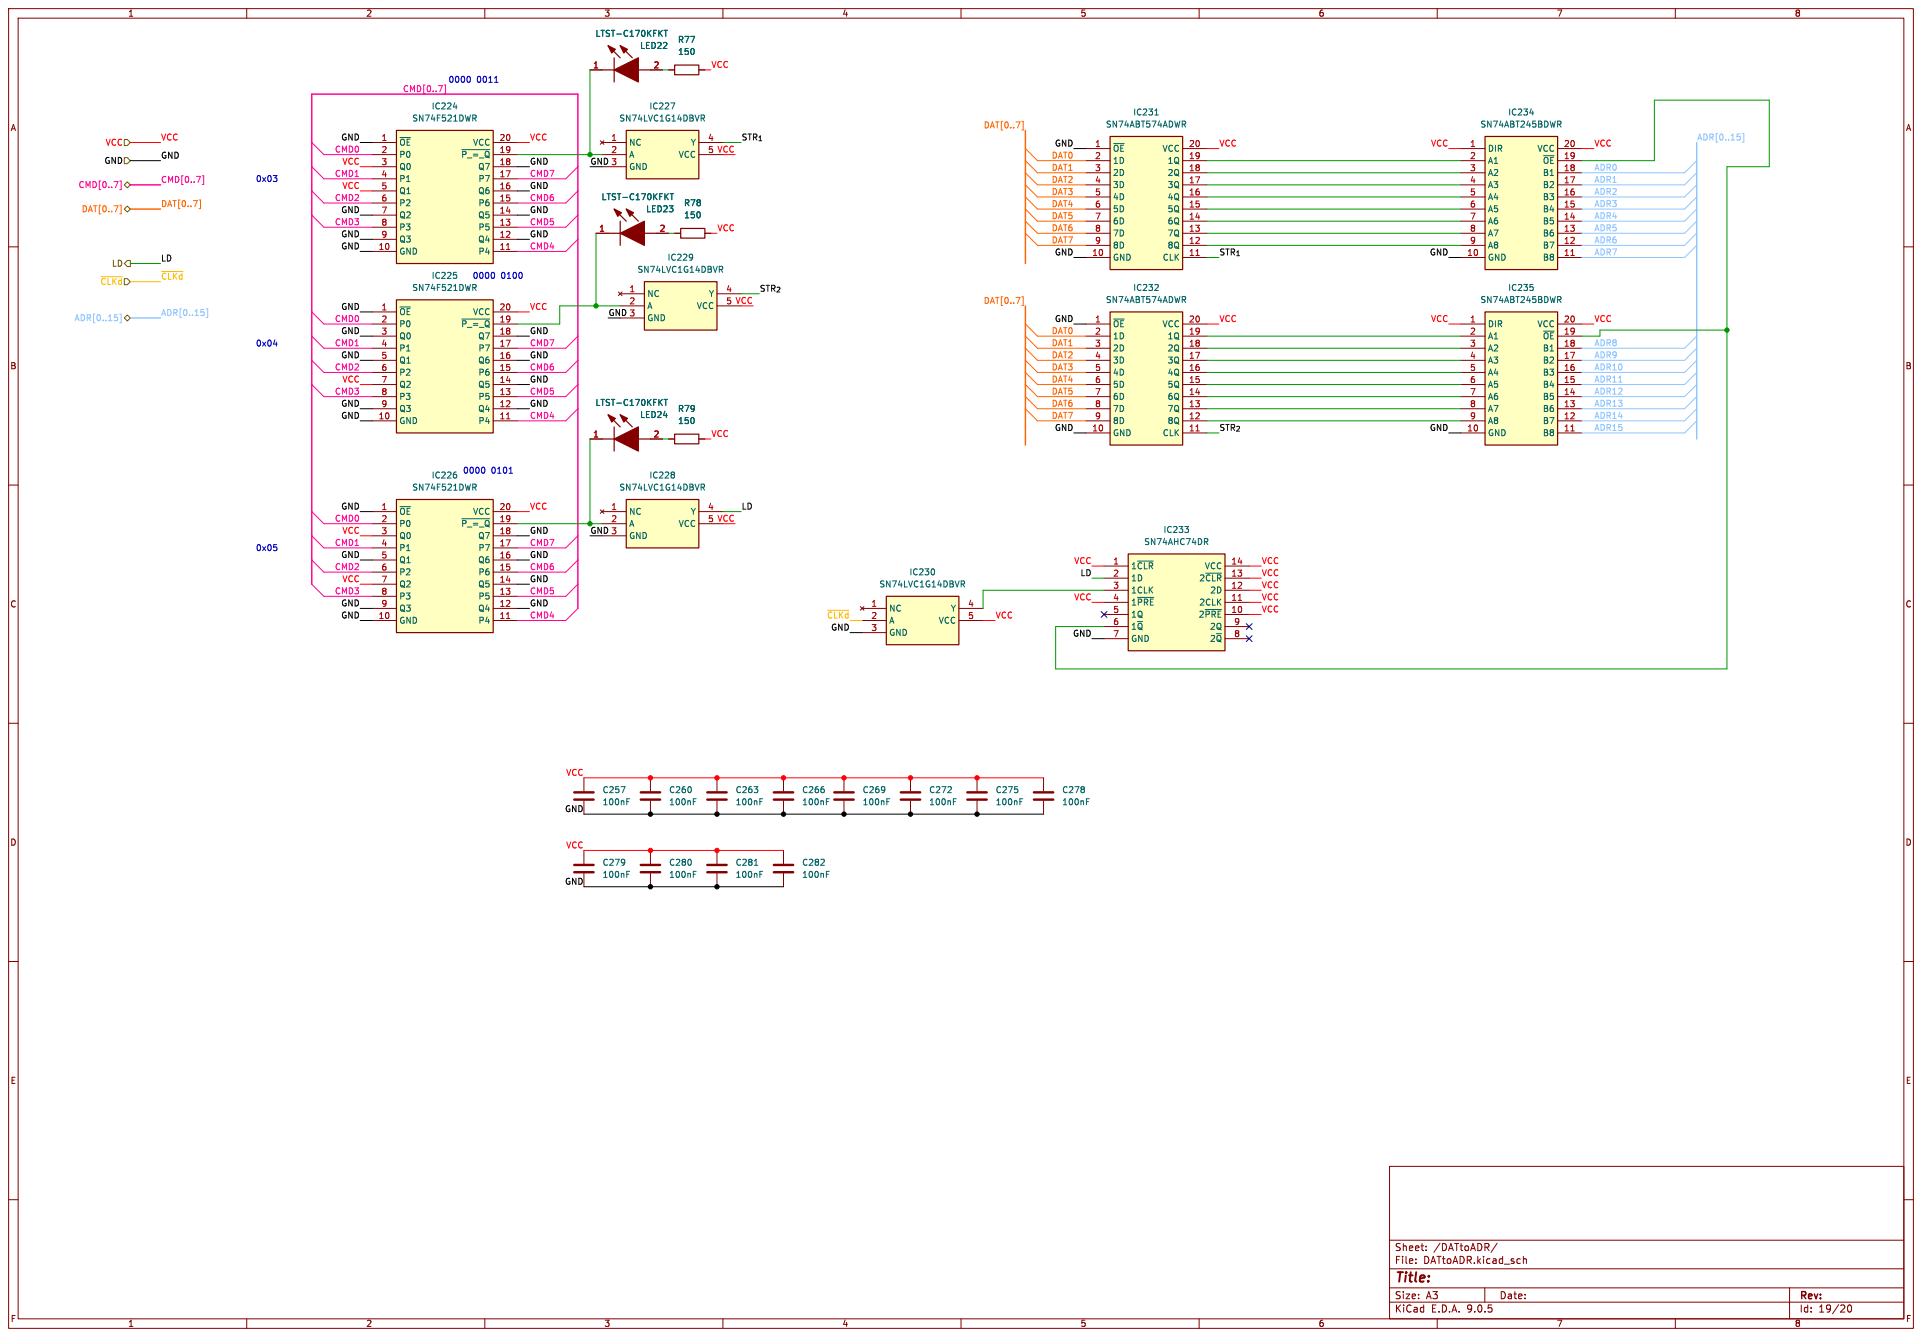
[picture p257: page 19]

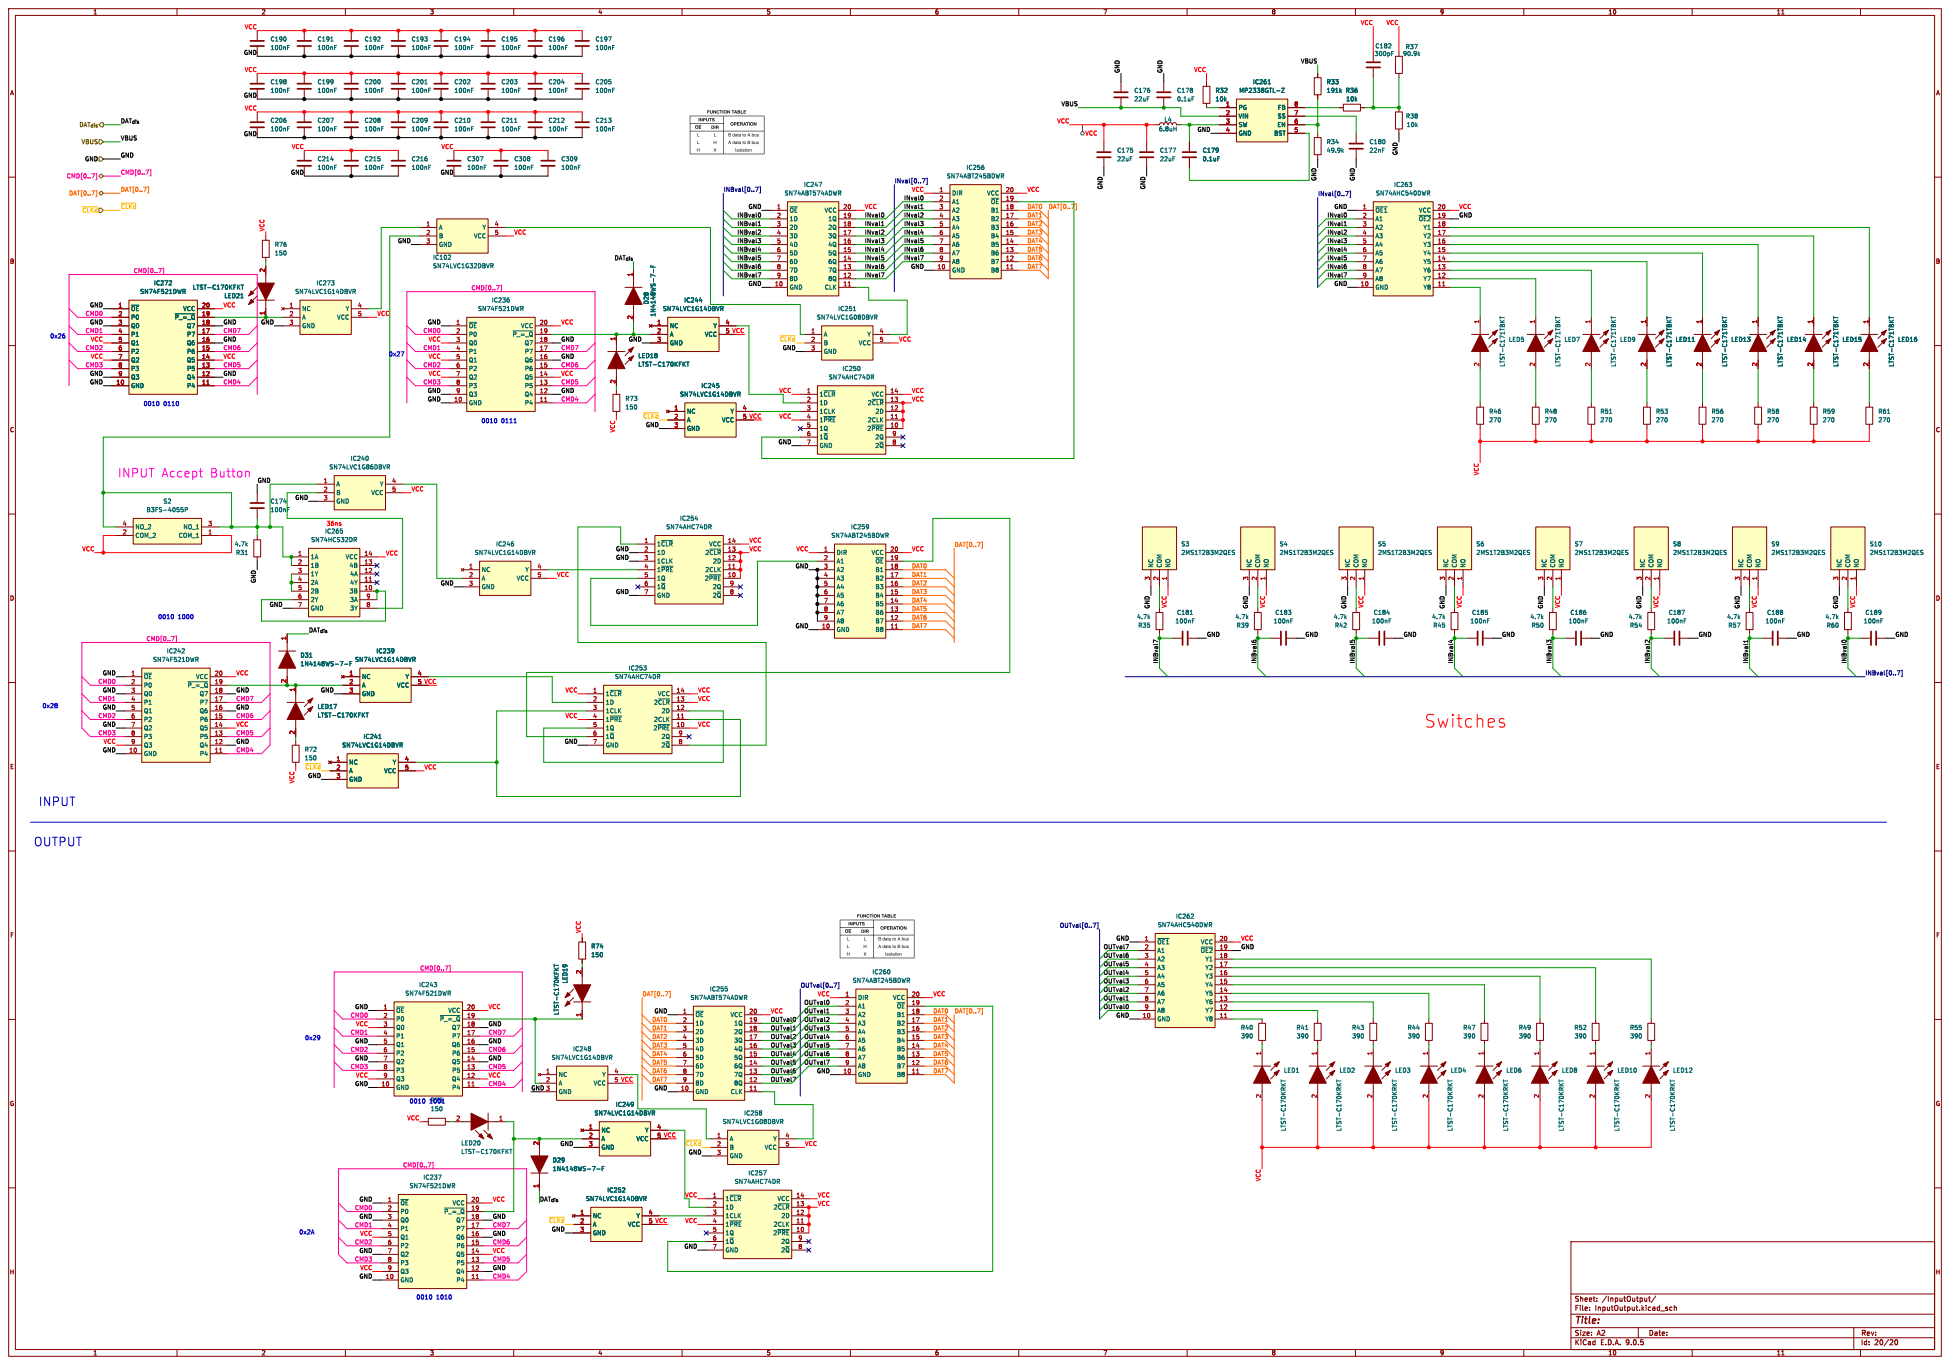
[picture p258: page 20]
