SSCsimsi/8Bit_Computer/8Bit Computer ver2.0/Kicad/Computer/8Bit_Computer_SCH_V0.5.pdf

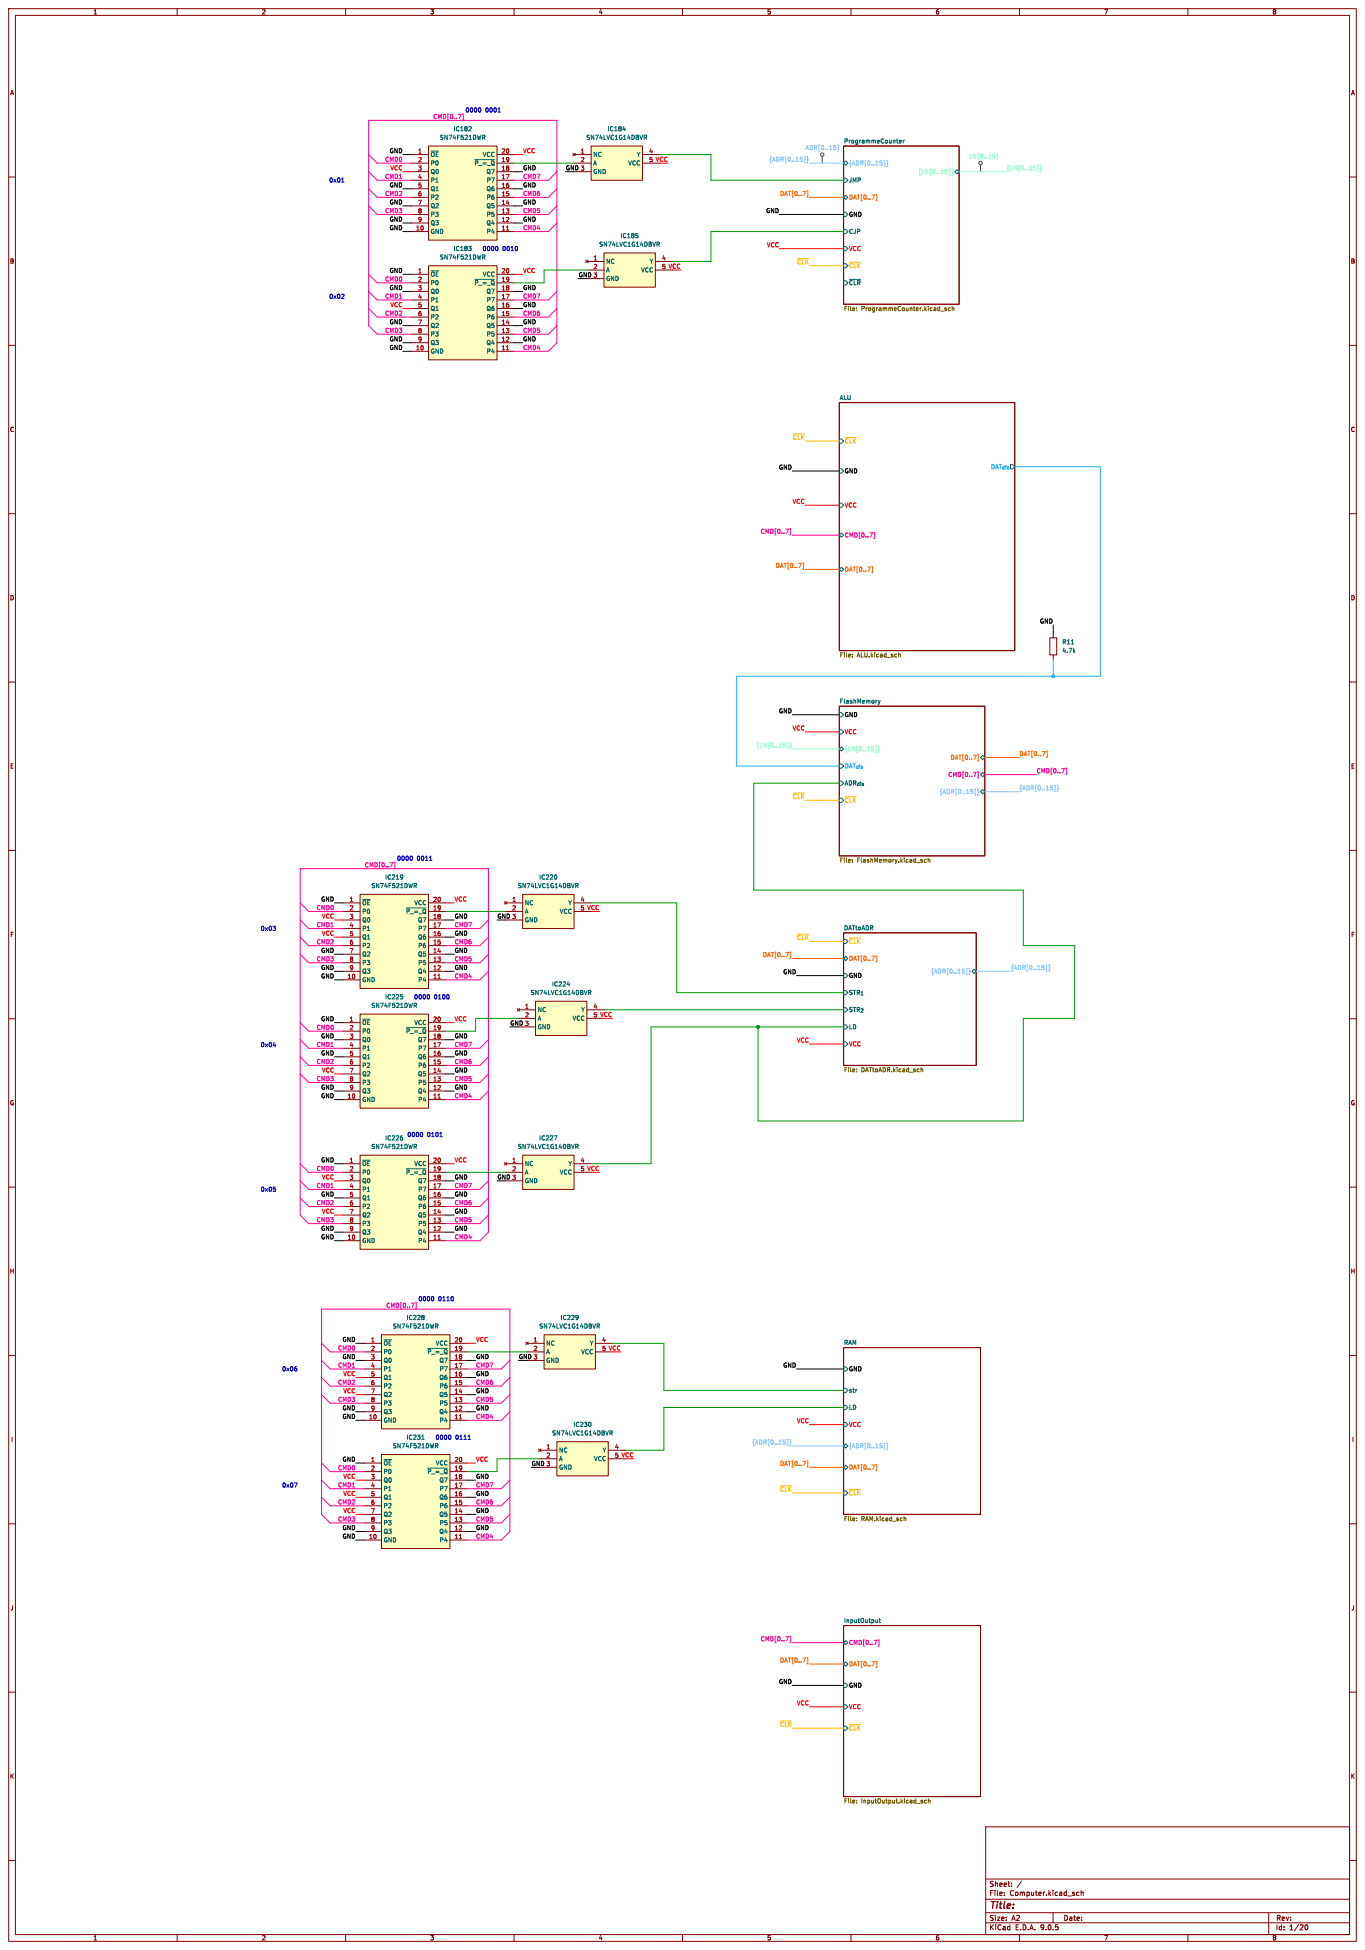
[picture p259: page 1]

ProgrammeCounter File: ProgrammeCounter.kicad_sch
{ADR[0..15]} CJP DAT[0..7] GND
{LN[0..15]} VCC
JMP

Id: 1/20 Title: File: Computer.kicad_sch Sheet: / CMD[0..7]

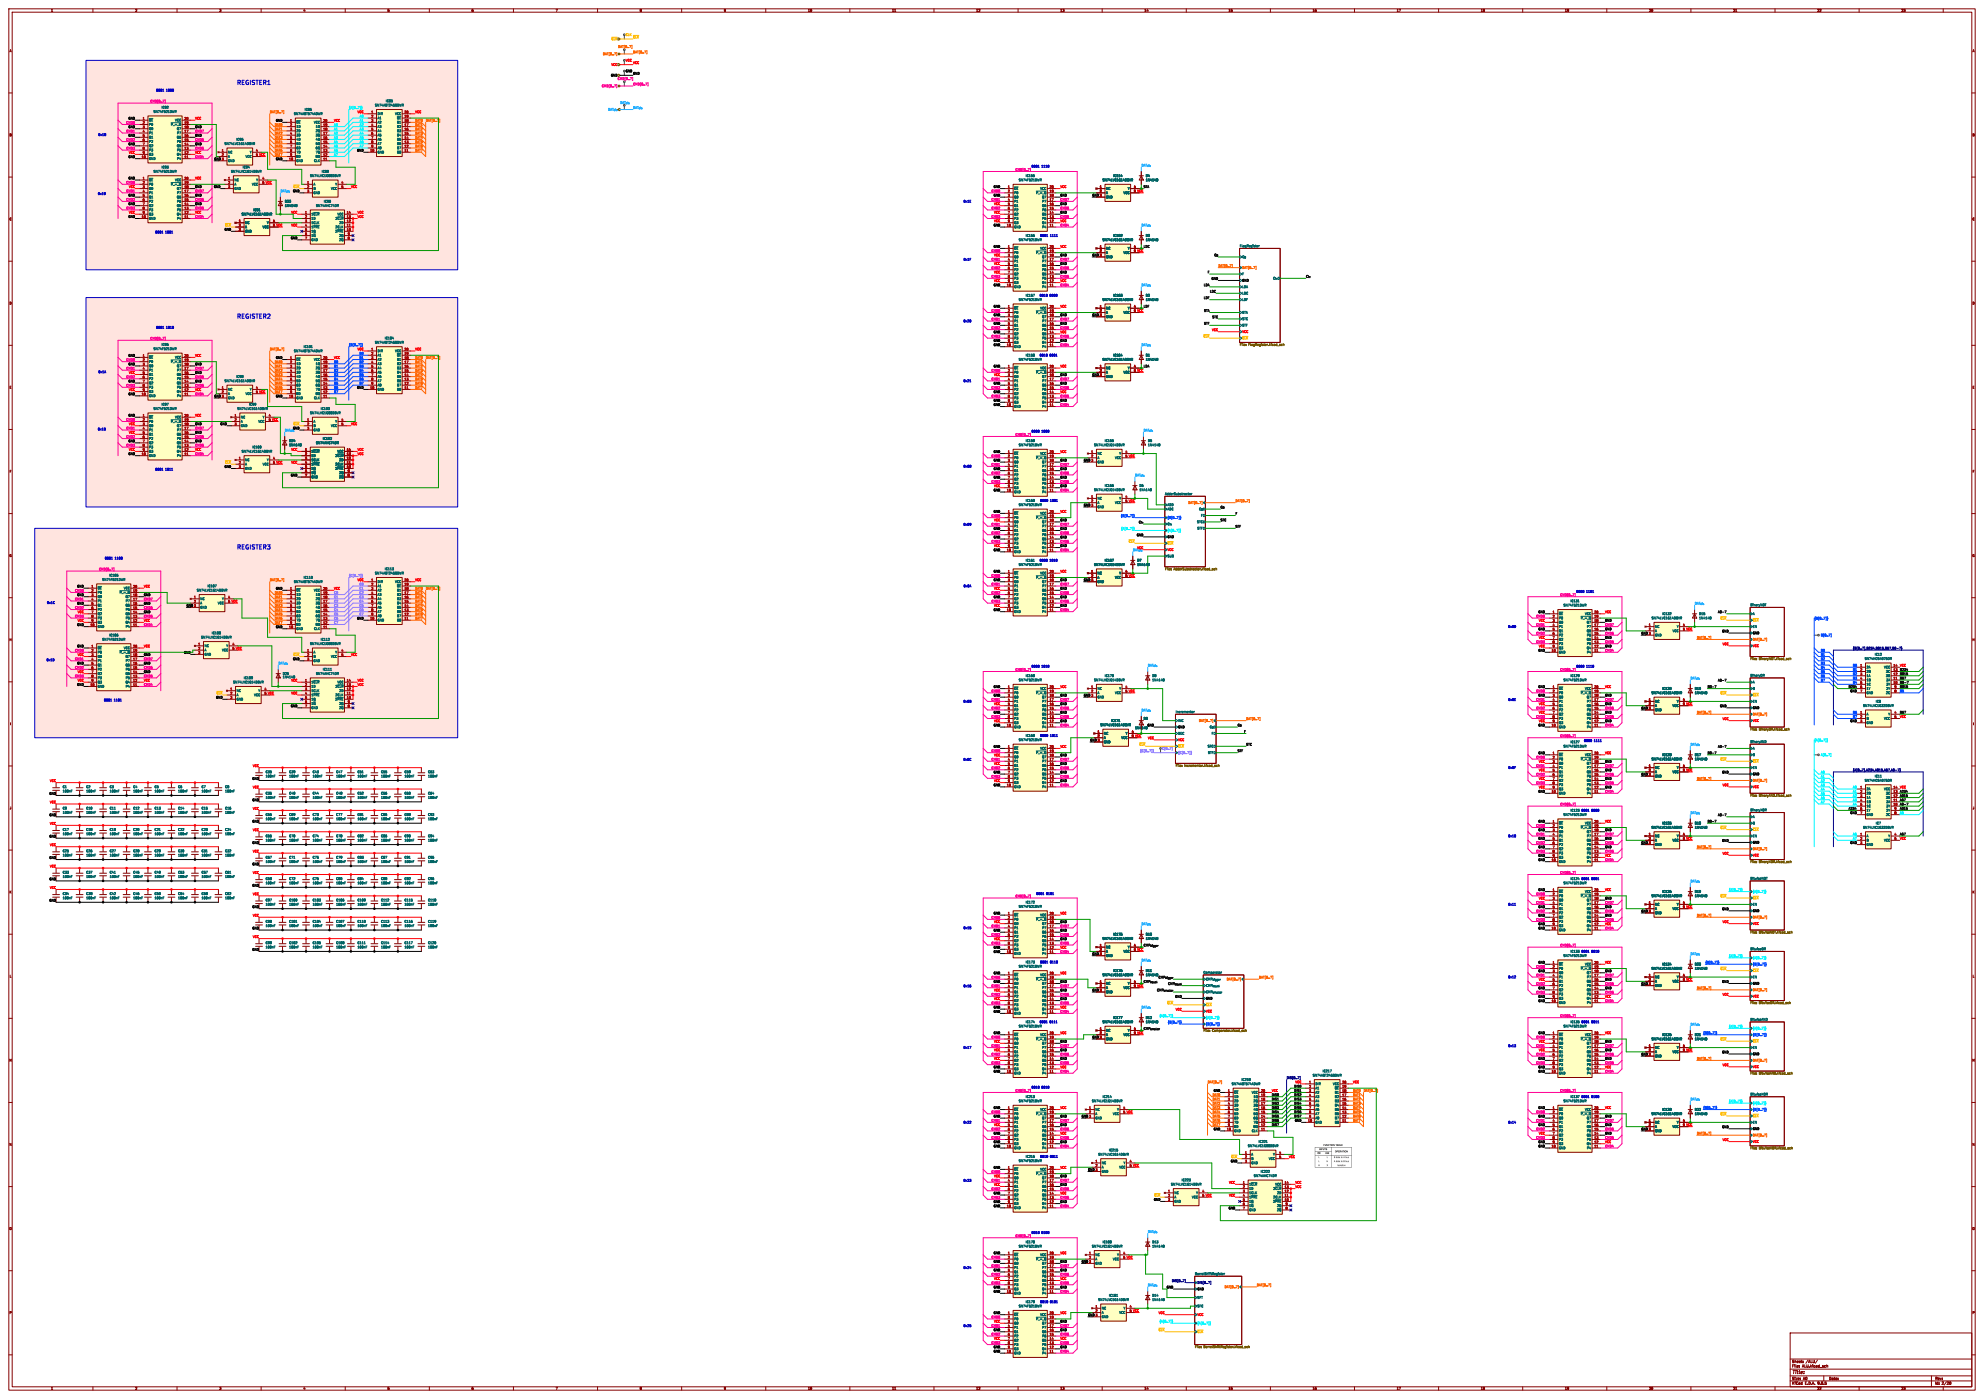
[picture p260: page 2]

CMD0 CMD1 GND
VCC GND GND GND GND GND

~{CLK} AdderSubstractor File: AdderSubstractor.kicad_sch

Id: 2/20 Title: File: ALU.kicad_sch Sheet: /ALU/ AB

VCC GND GND GND

CMD[0..7] GND GND GND

SFT BarrelShiftRegister File: BarrelShiftRegister.kicad_sch

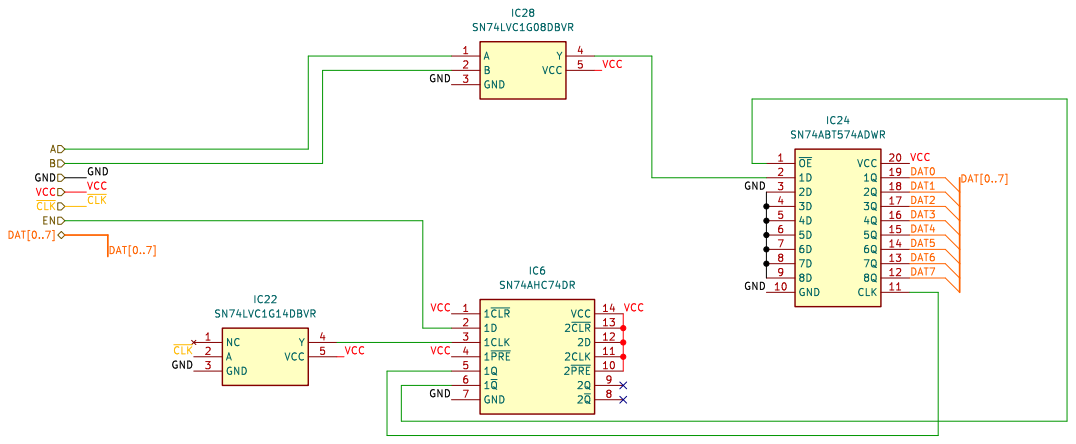
[picture p261: page 3]

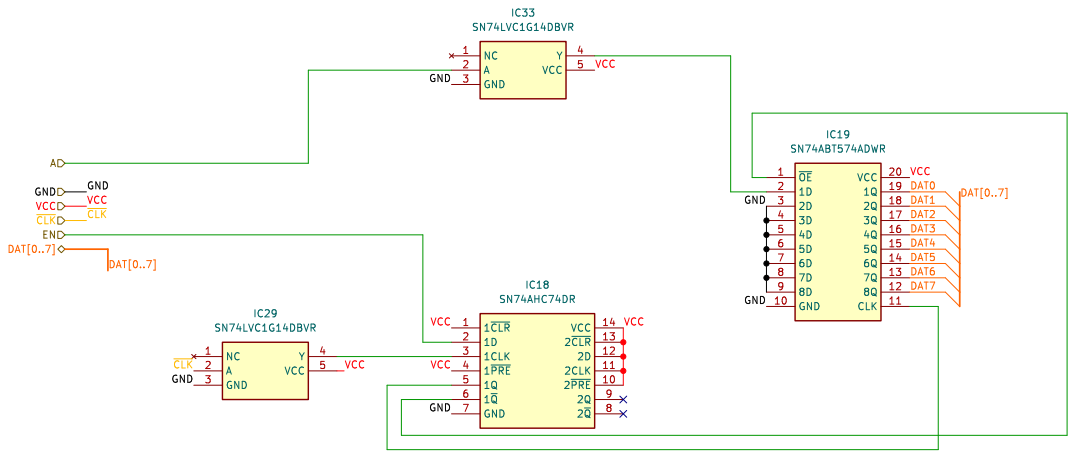
[picture p262: page 4]

Id: 4/20 Title: File: BinaryNOT.kicad_sch Sheet: /ALU/BinaryNOT/

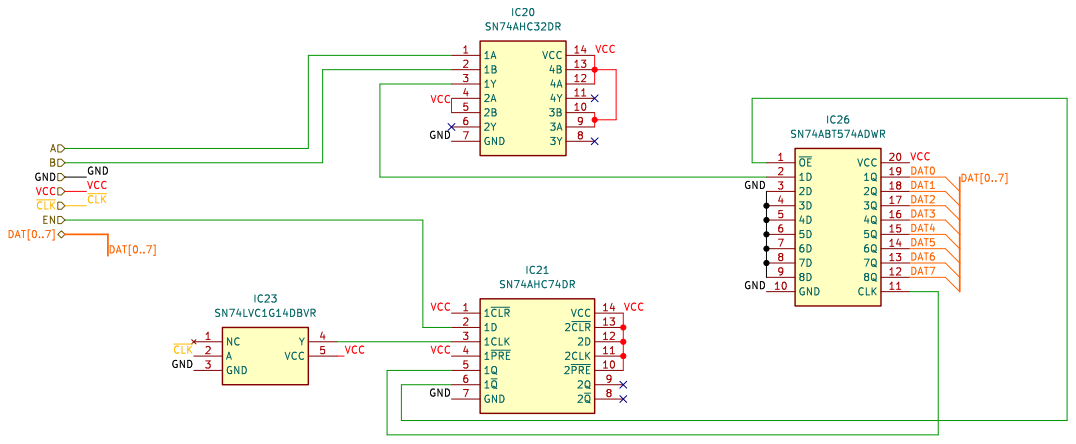
[picture p263: page 5]

Id: 5/20 Title: File: BinaryOR.kicad_sch Sheet: /ALU/BinaryOR/

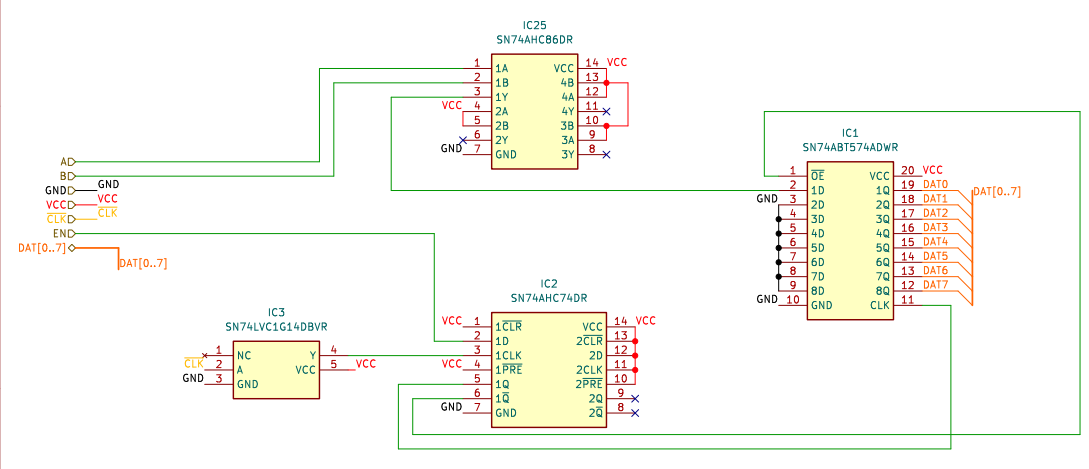
[picture p264: page 6]

Id: 6/20 Title: File: BinaryXOR.kicad_sch Sheet: /ALU/BinaryXOR/

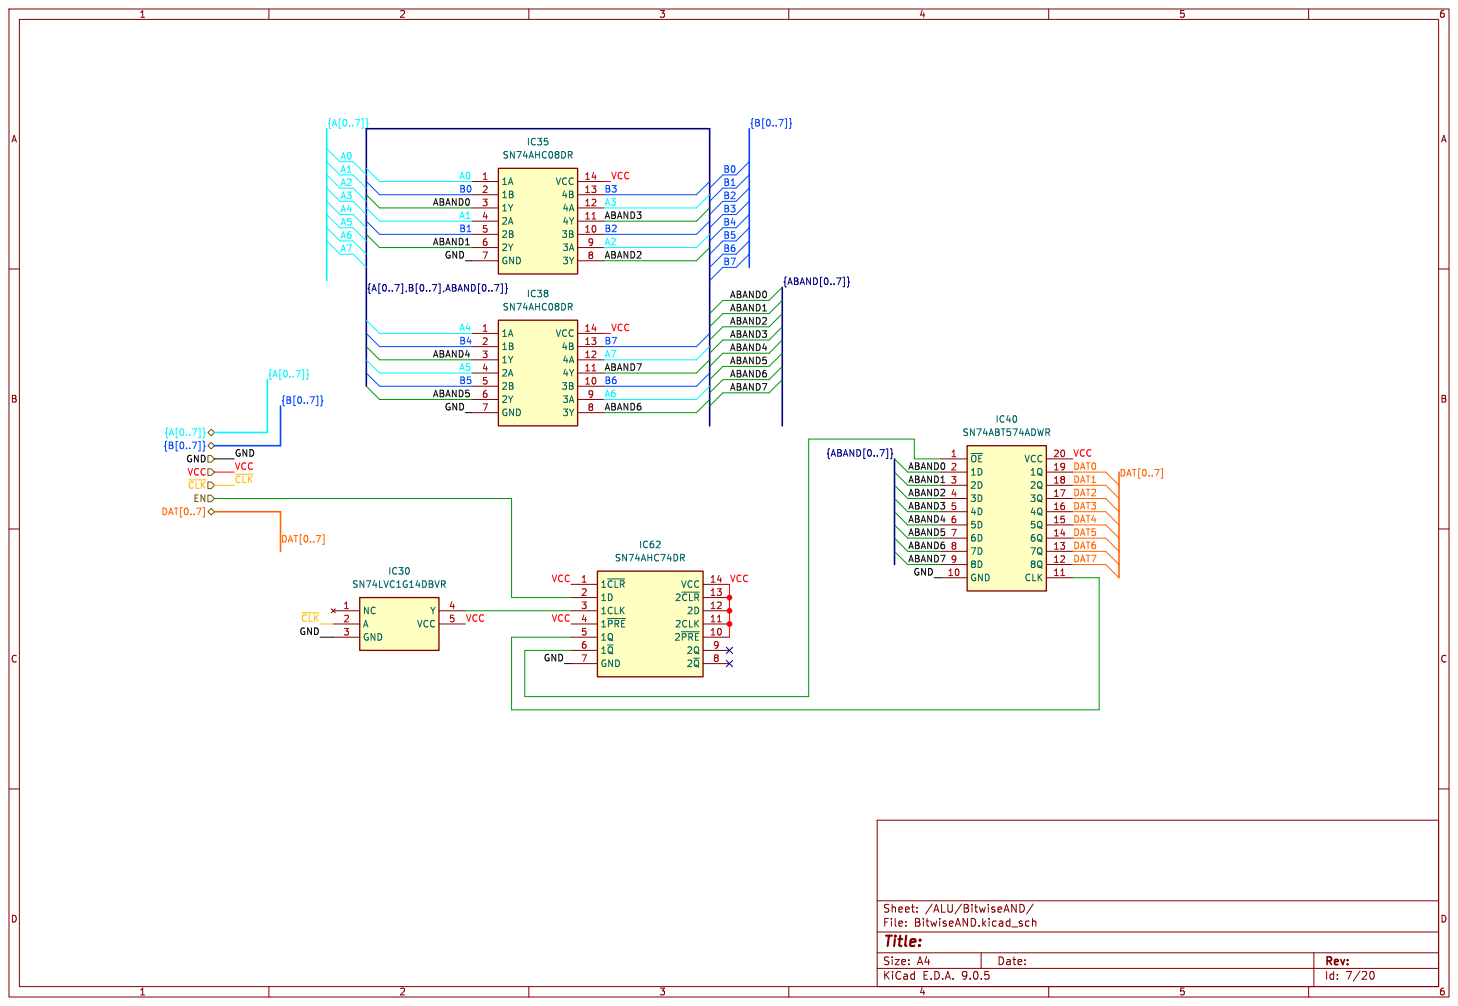
[picture p265: page 7]

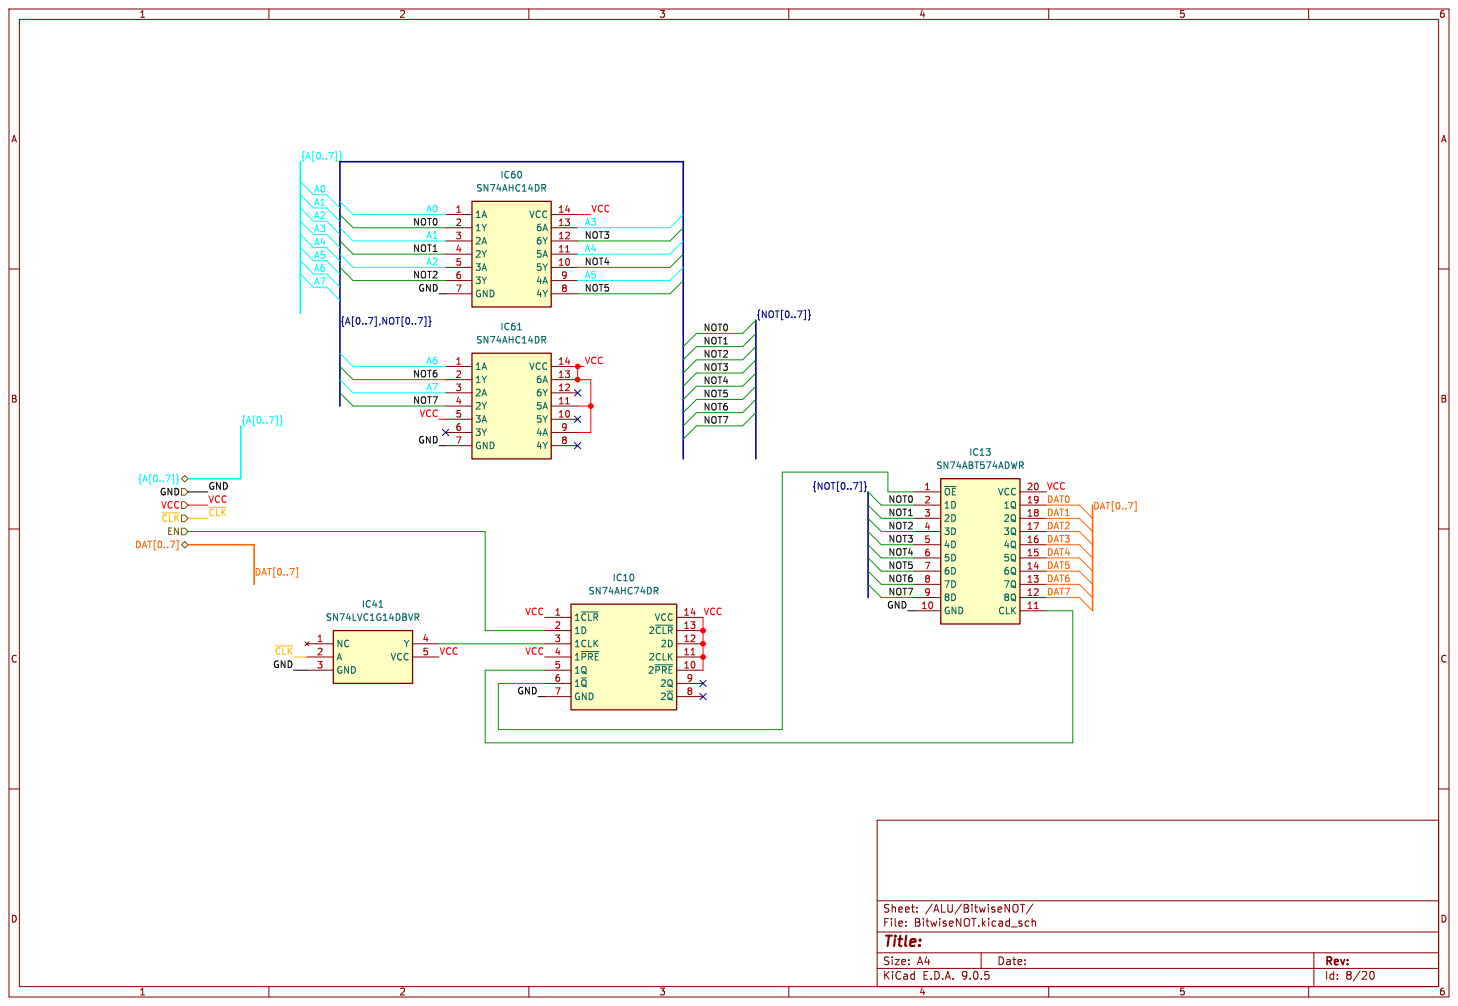
[picture p266: page 8]

Id: 8/20 Title: File: BitwiseNOT.kicad_sch Sheet: /ALU/BitwiseNOT/

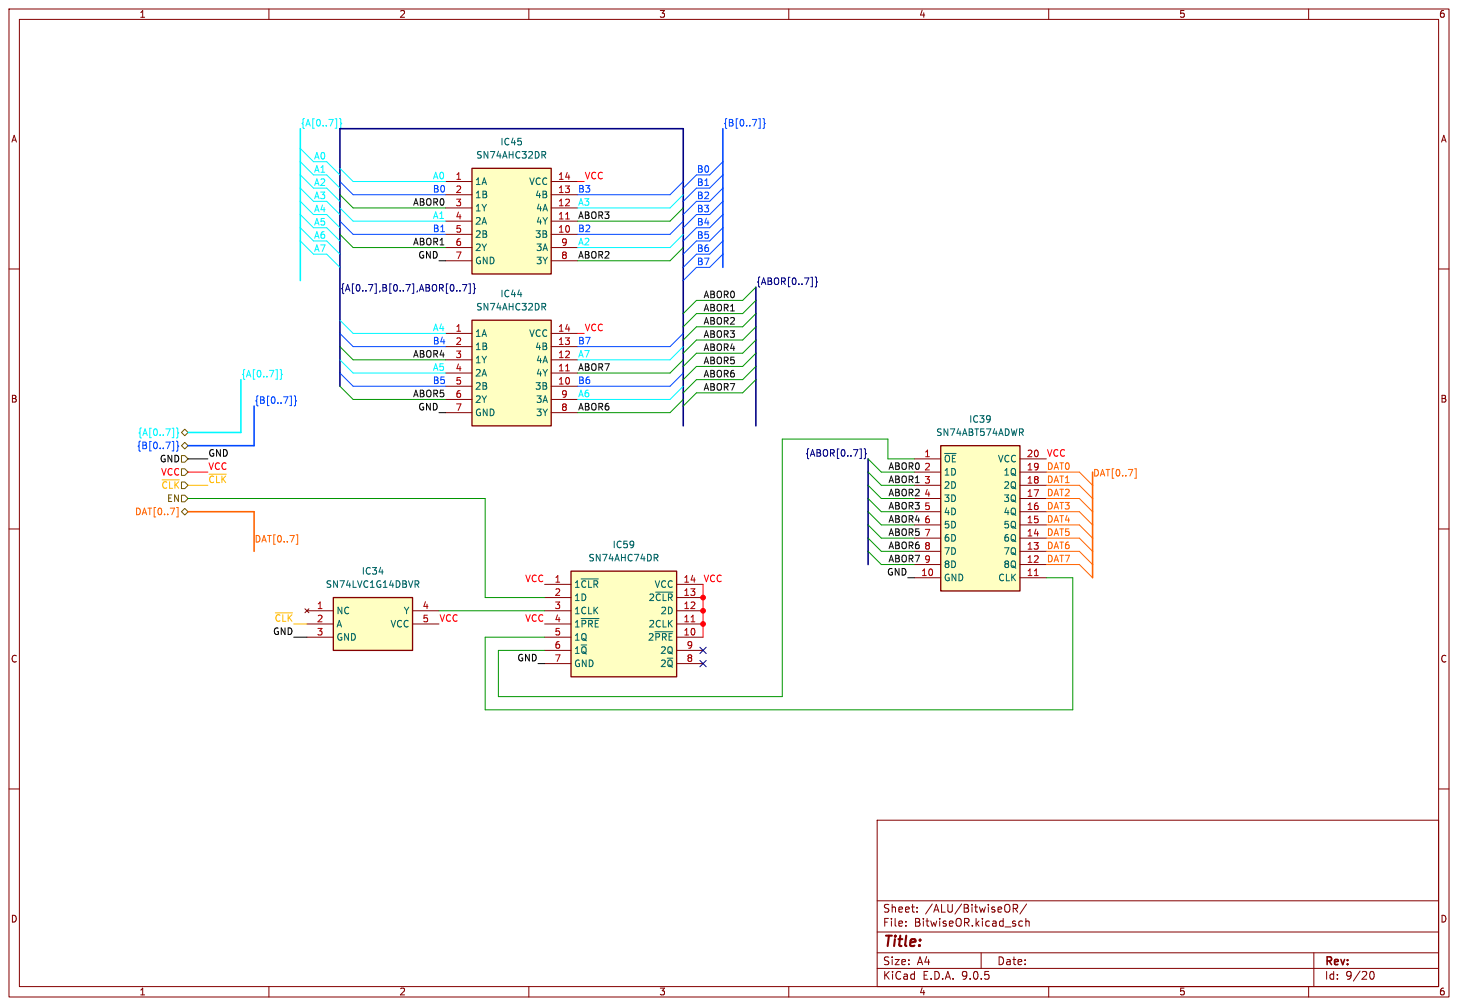
[picture p267: page 9]

Id: 9/20 Title: File: BitwiseOR.kicad_sch Sheet: /ALU/BitwiseOR/

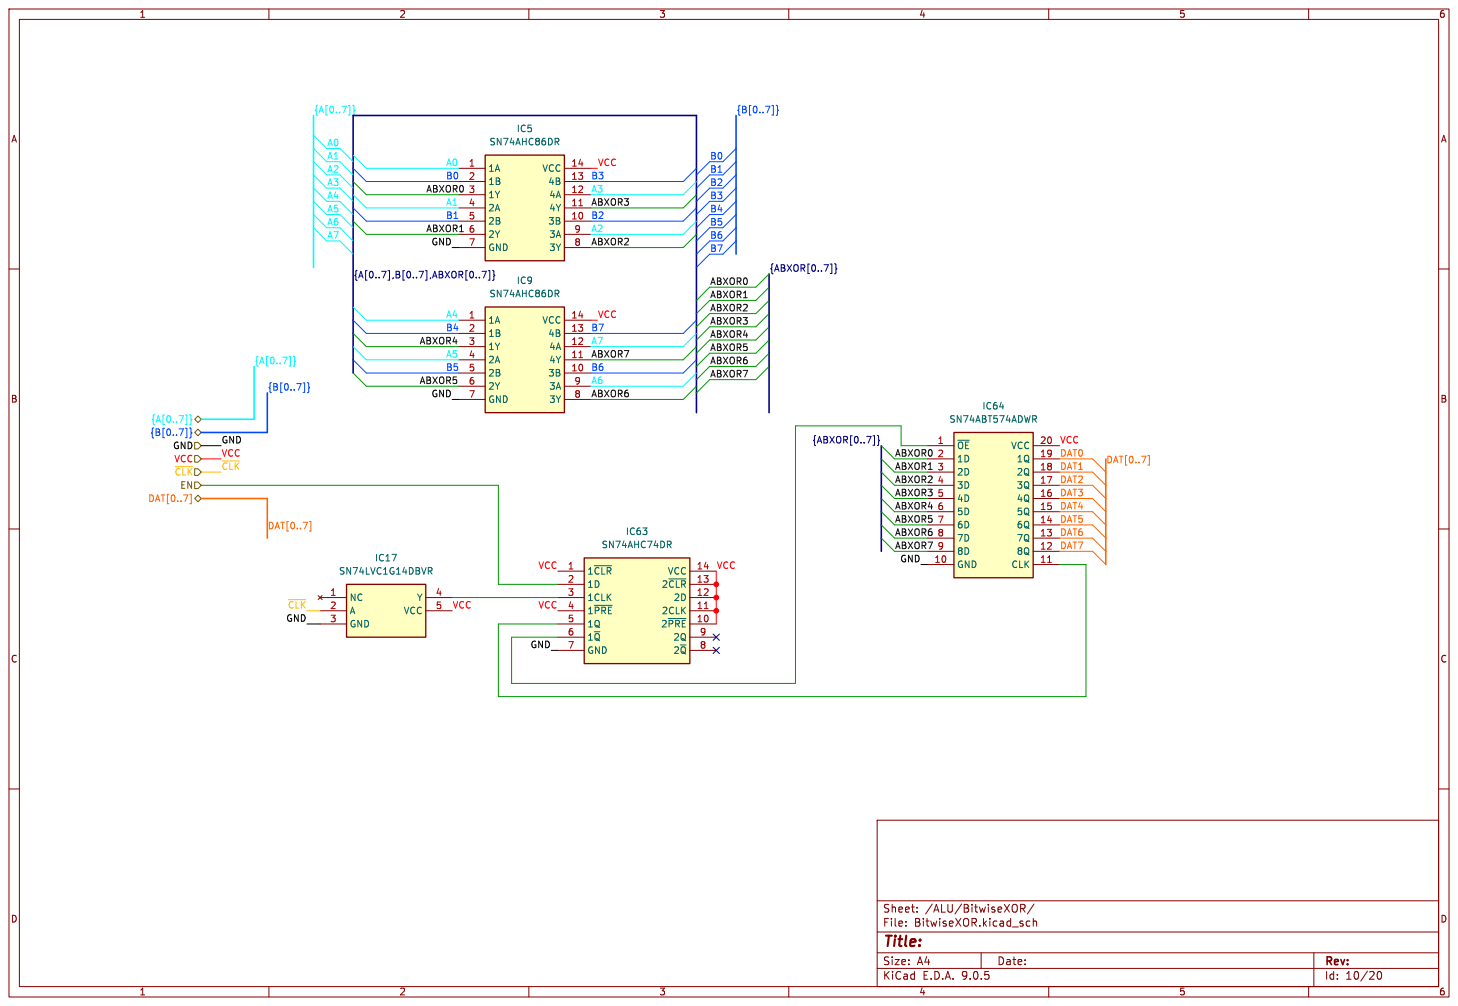
[picture p268: page 10]

Id: 10/20 Title: File: BitwiseXOR.kicad_sch Sheet: /ALU/BitwiseXOR/

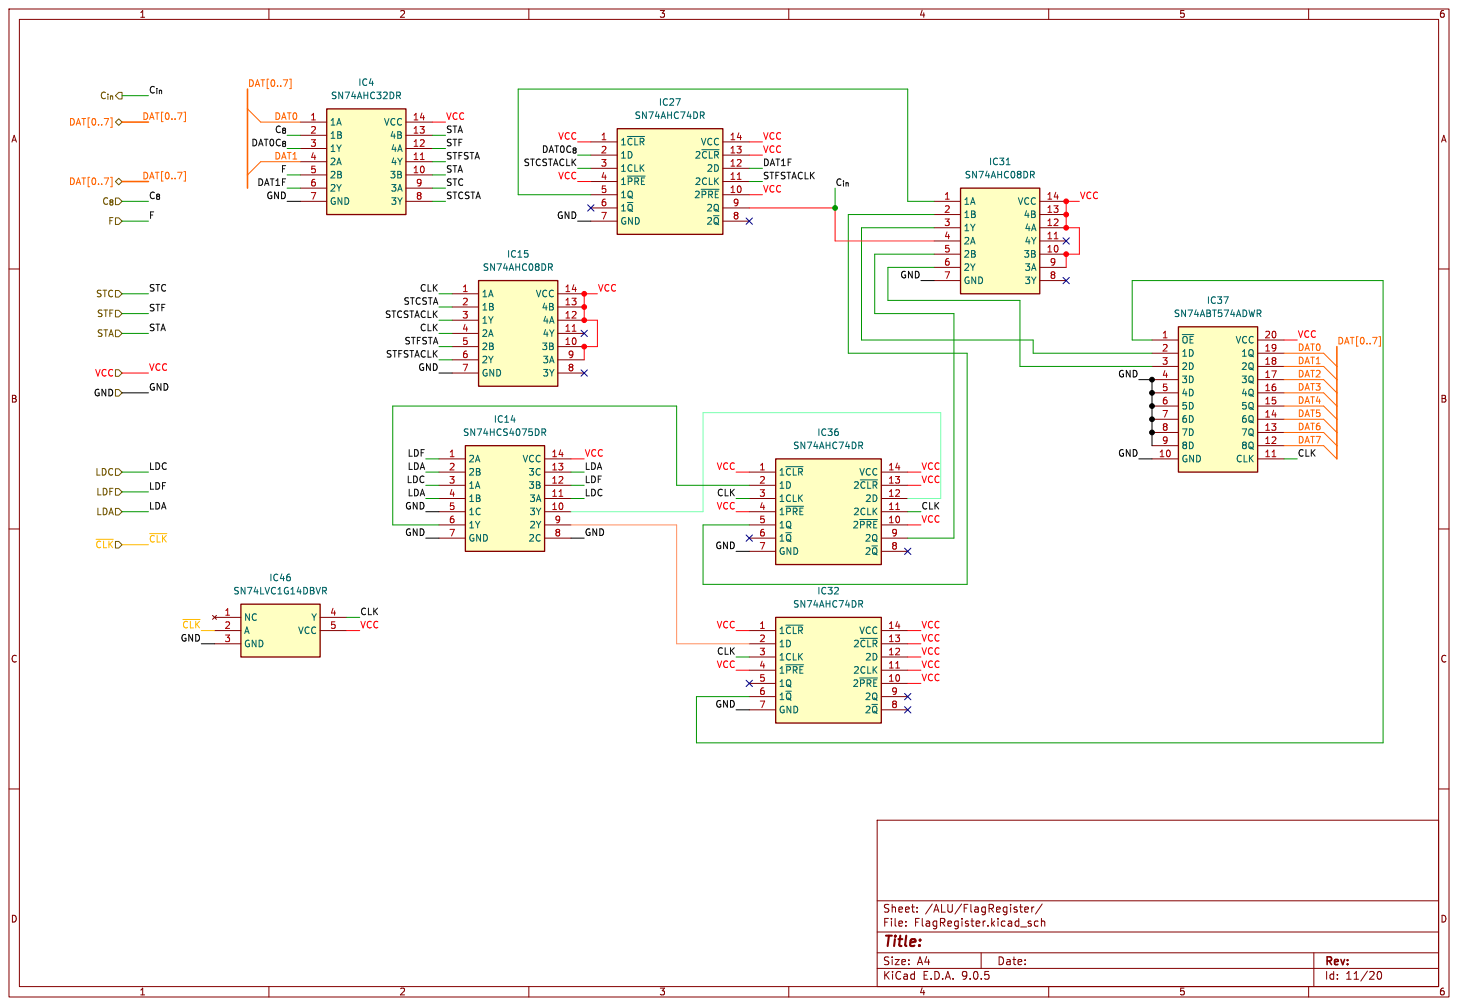
[picture p269: page 11]

DAT1FDAT1 C_{in}
LDF STA C_{in} STFC_{8} LDC GND
DAT[0..7] LDA

Id: 11/20 Title: File: FlagRegister.kicad_sch Sheet: /ALU/FlagRegister/

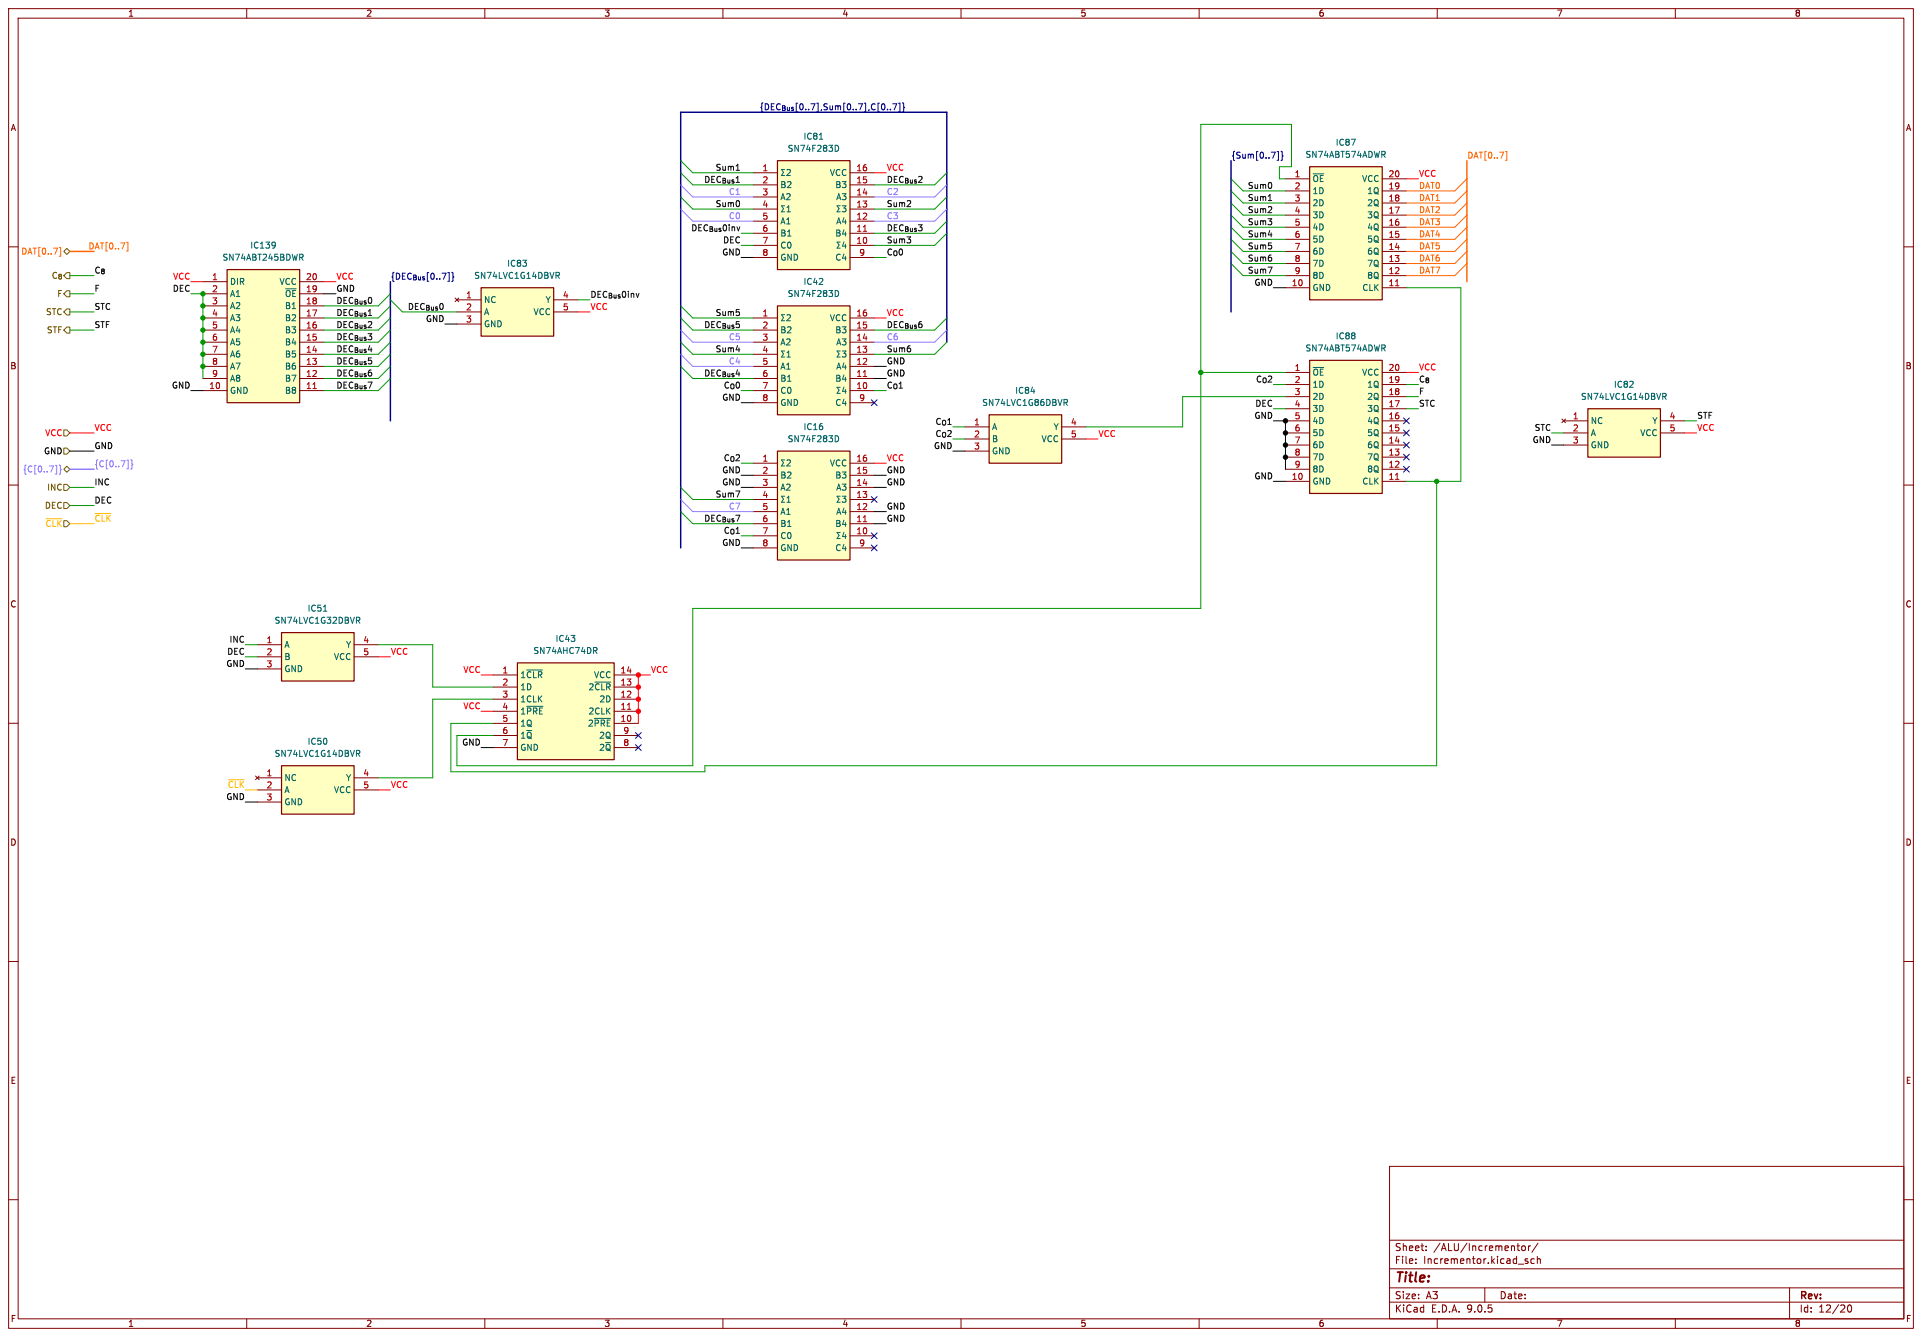
[picture p270: page 12]

DEC_{Bus}0inv VCC DEC_{Bus}1 VCC

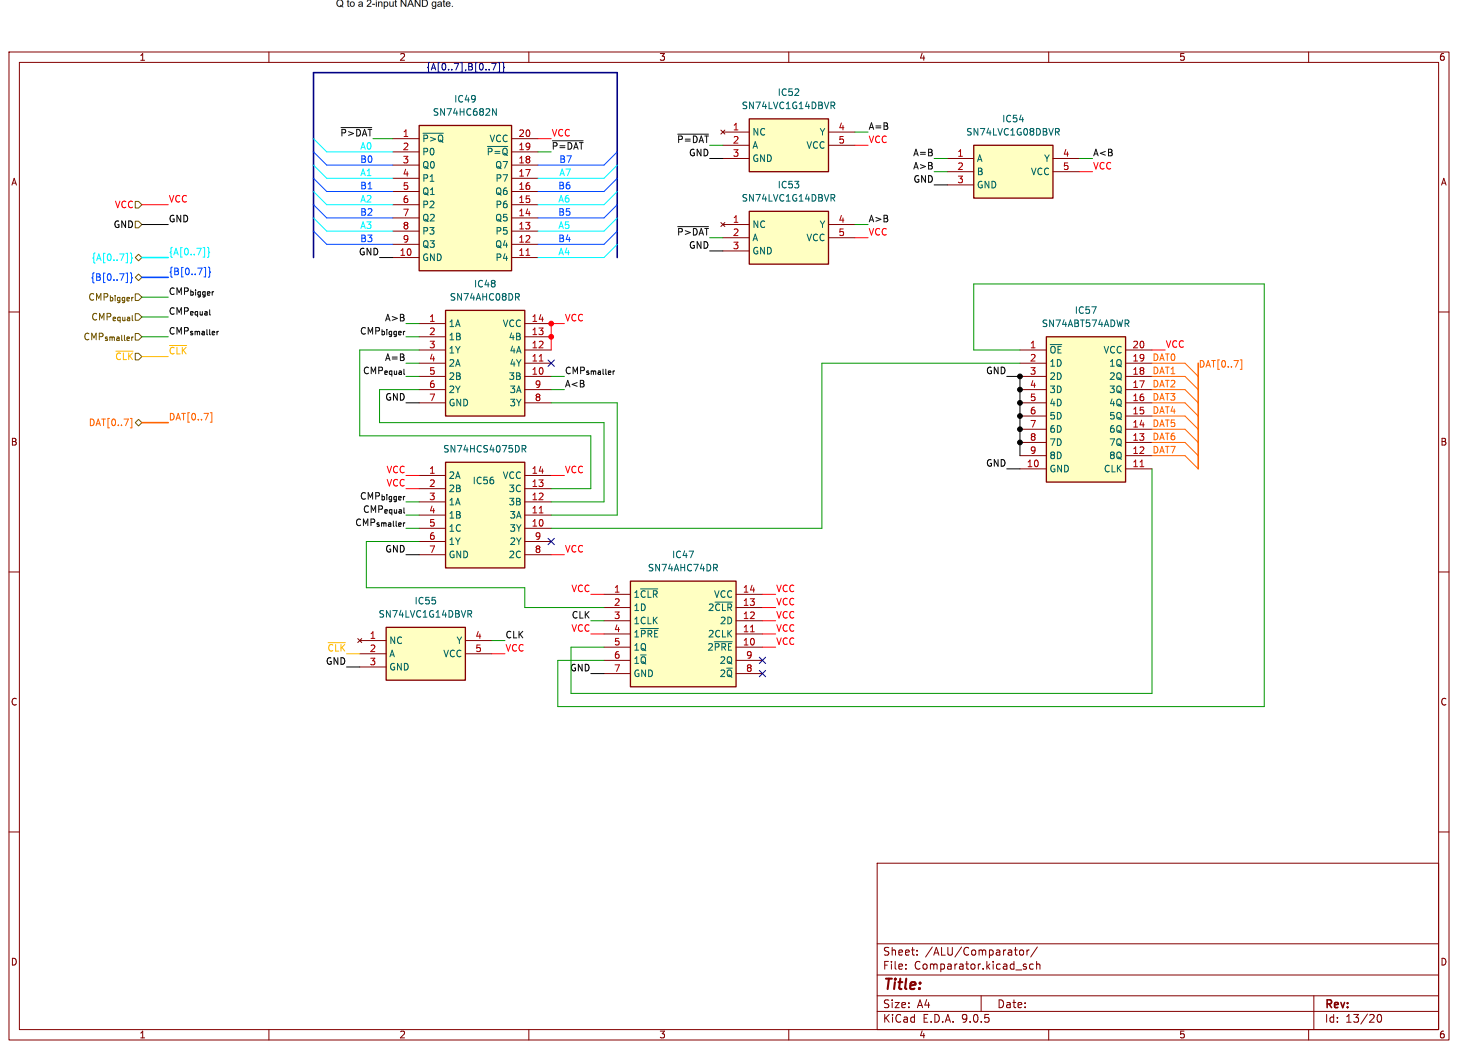
[picture p271: page 13]

Id: 13/20 Title: File: Comparator.kicad_sch Sheet: /ALU/Comparator/

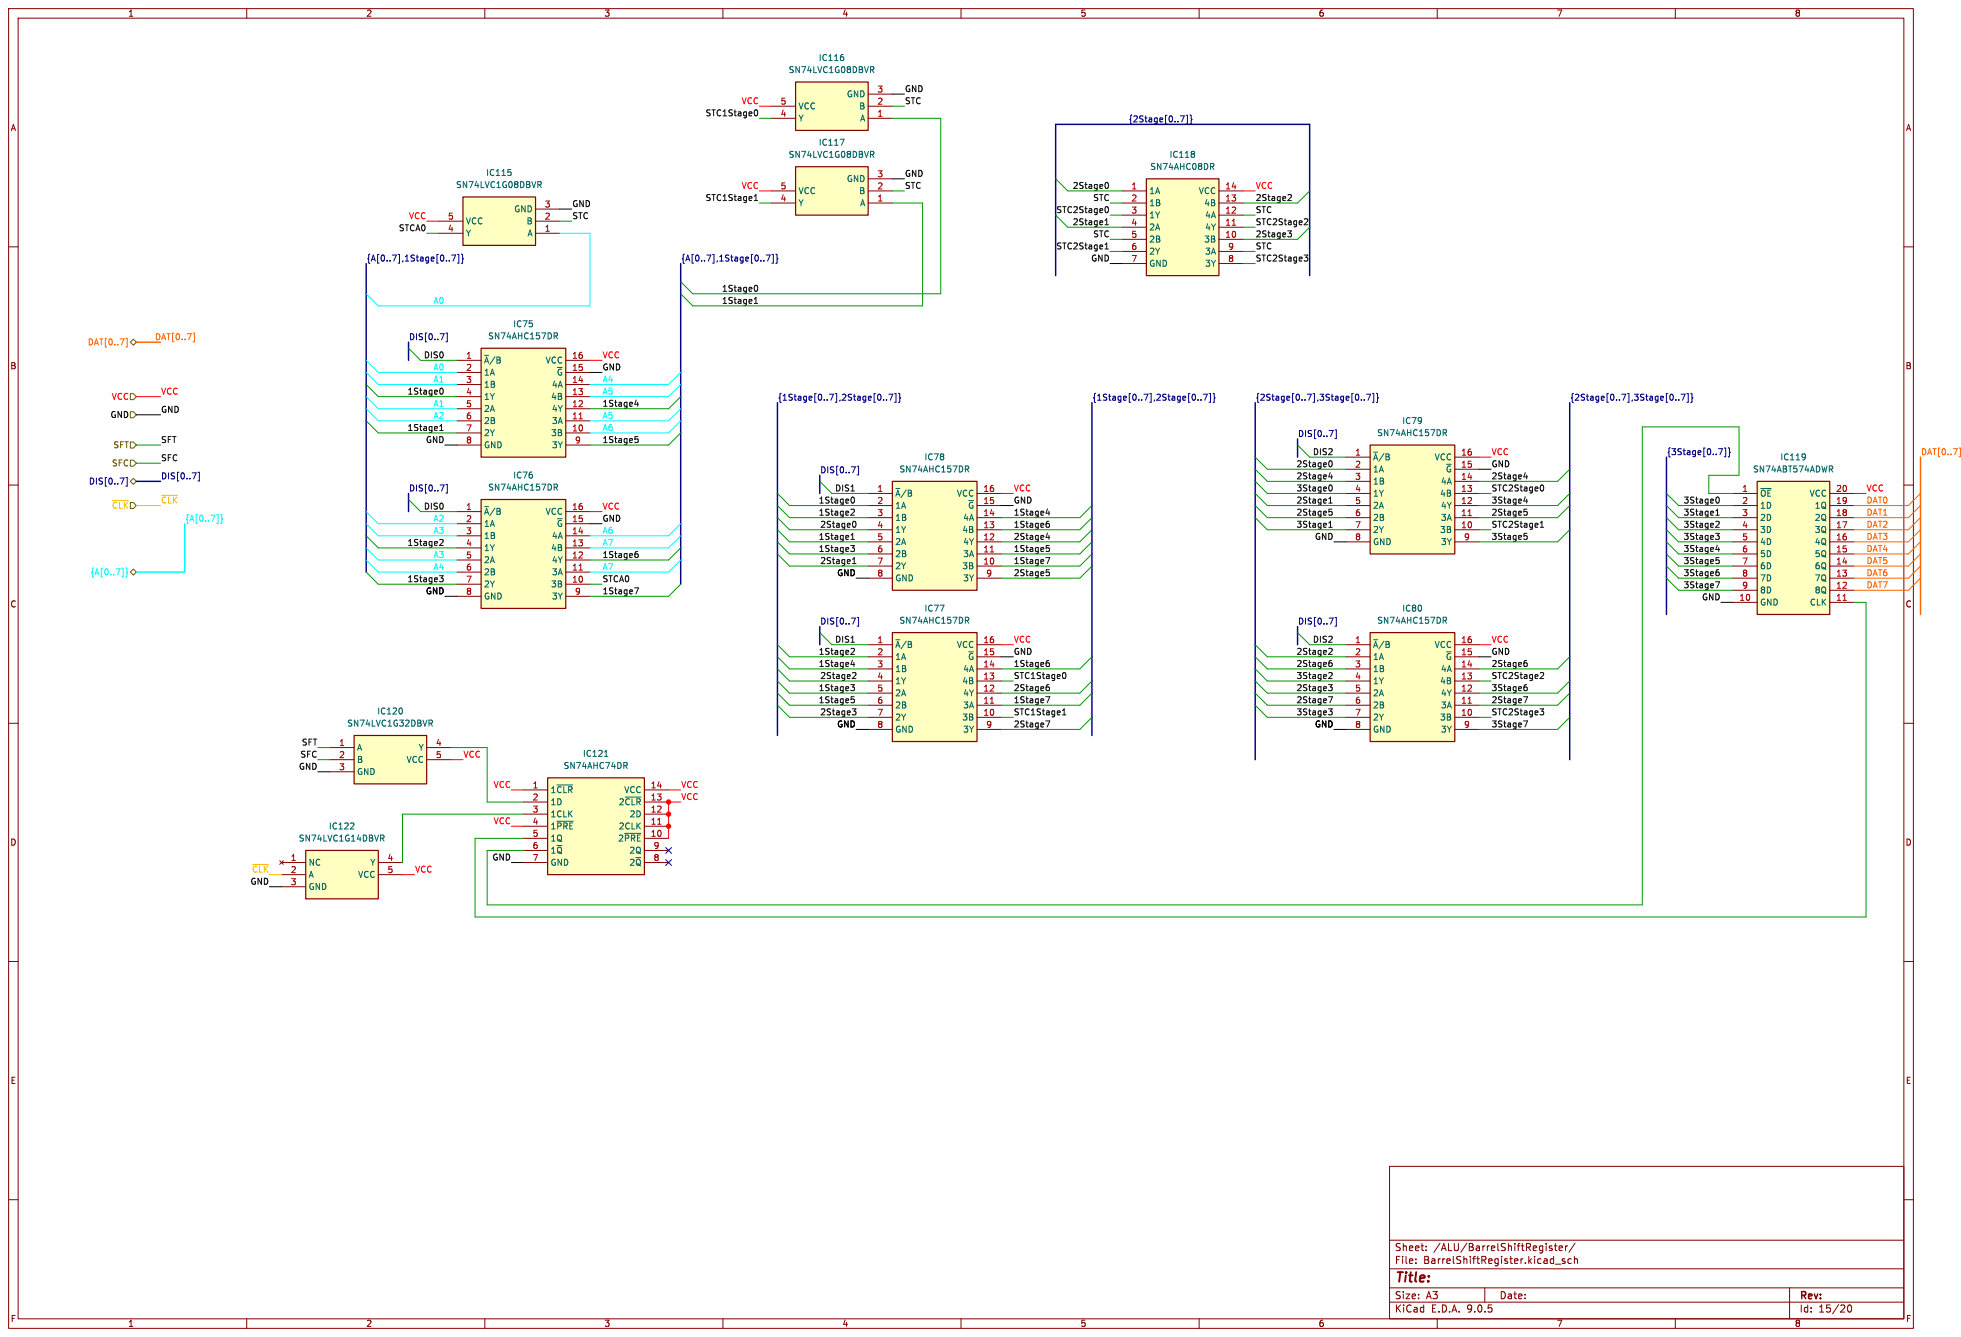
[picture p272: page 14]

DAT[0..7] VCC
DIS[0..7] SFT DAT[0..7] SFC
{A[0..7]} GND

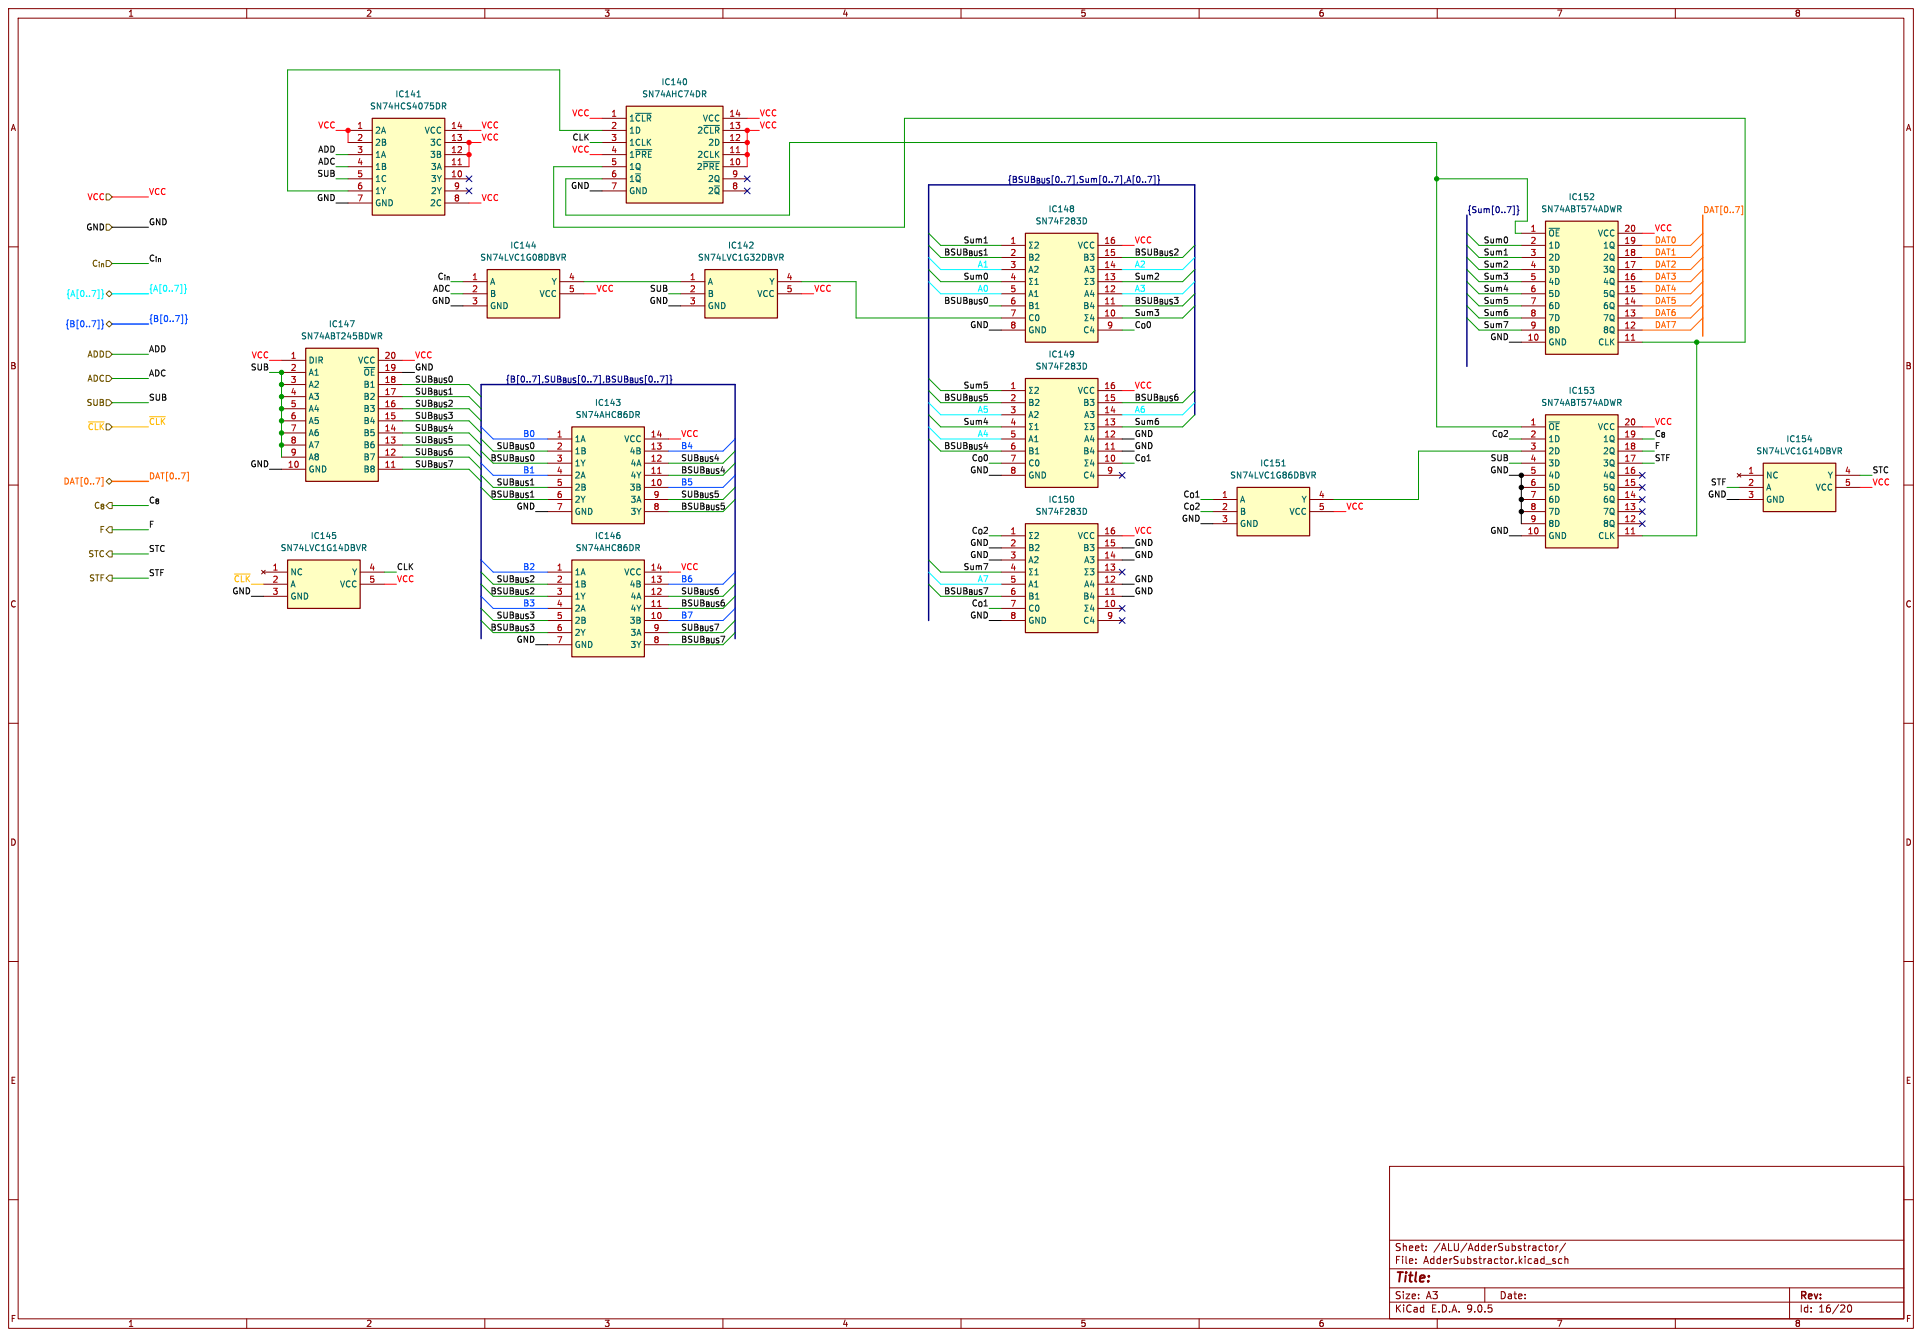
[picture p273: page 15]

Id: 16/20 Title: File: AdderSubstractor.kicad_sch Sheet: /ALU/AdderSubstractor/

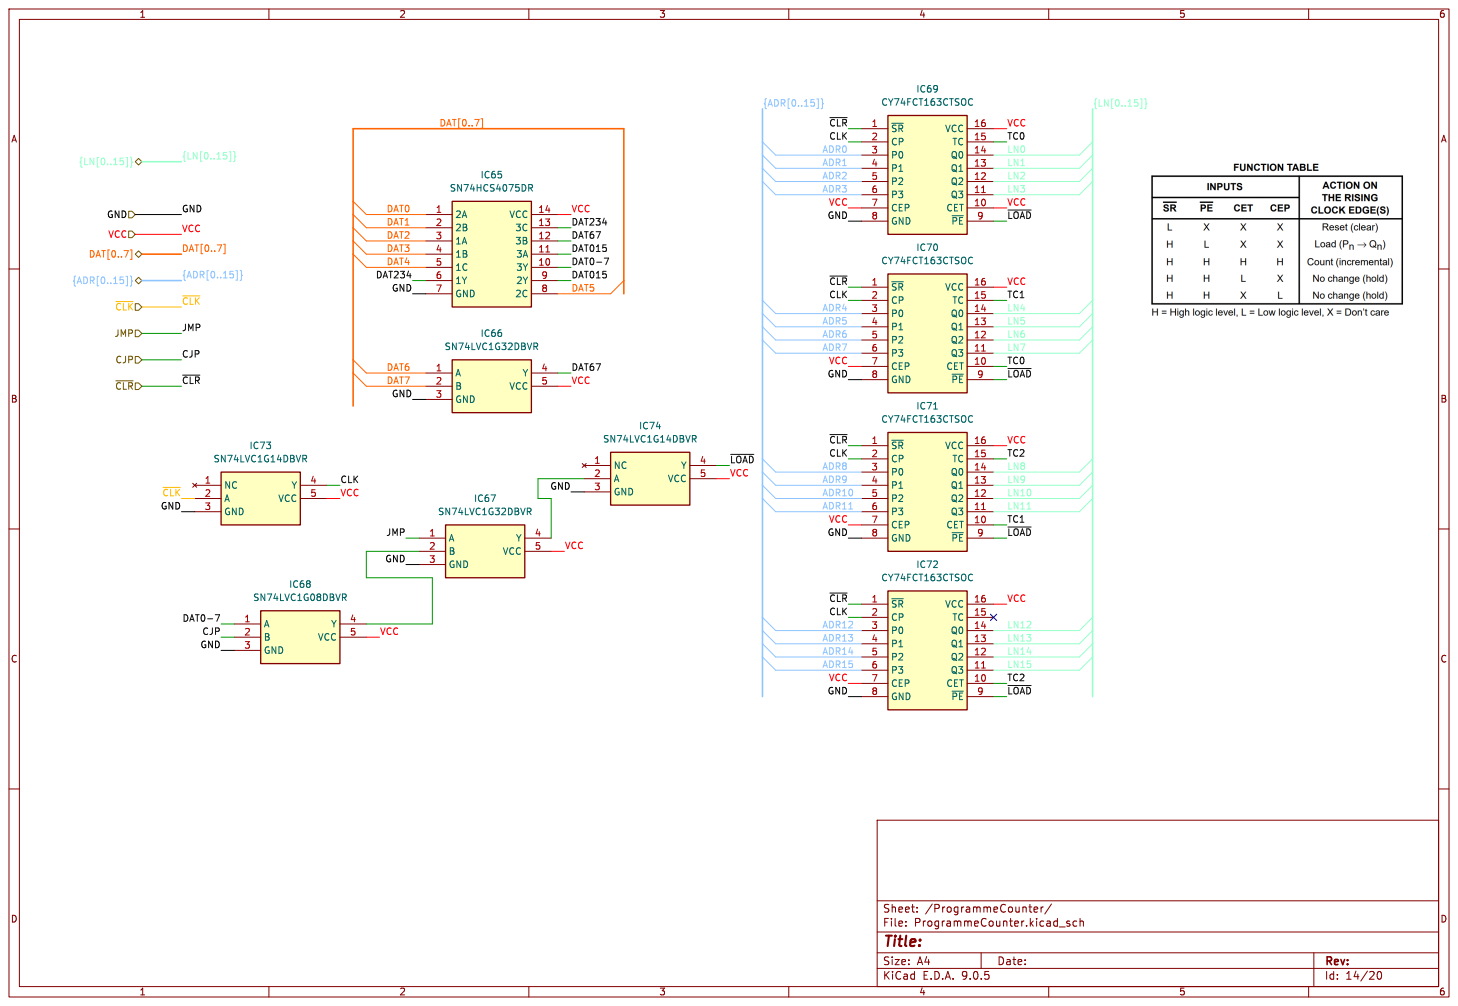
[picture p274: page 16]

~{CLR} CLK GND GND

Id: 14/20 Title: File: ProgrammeCounter.kicad_sch Sheet: /ProgrammeCounter/

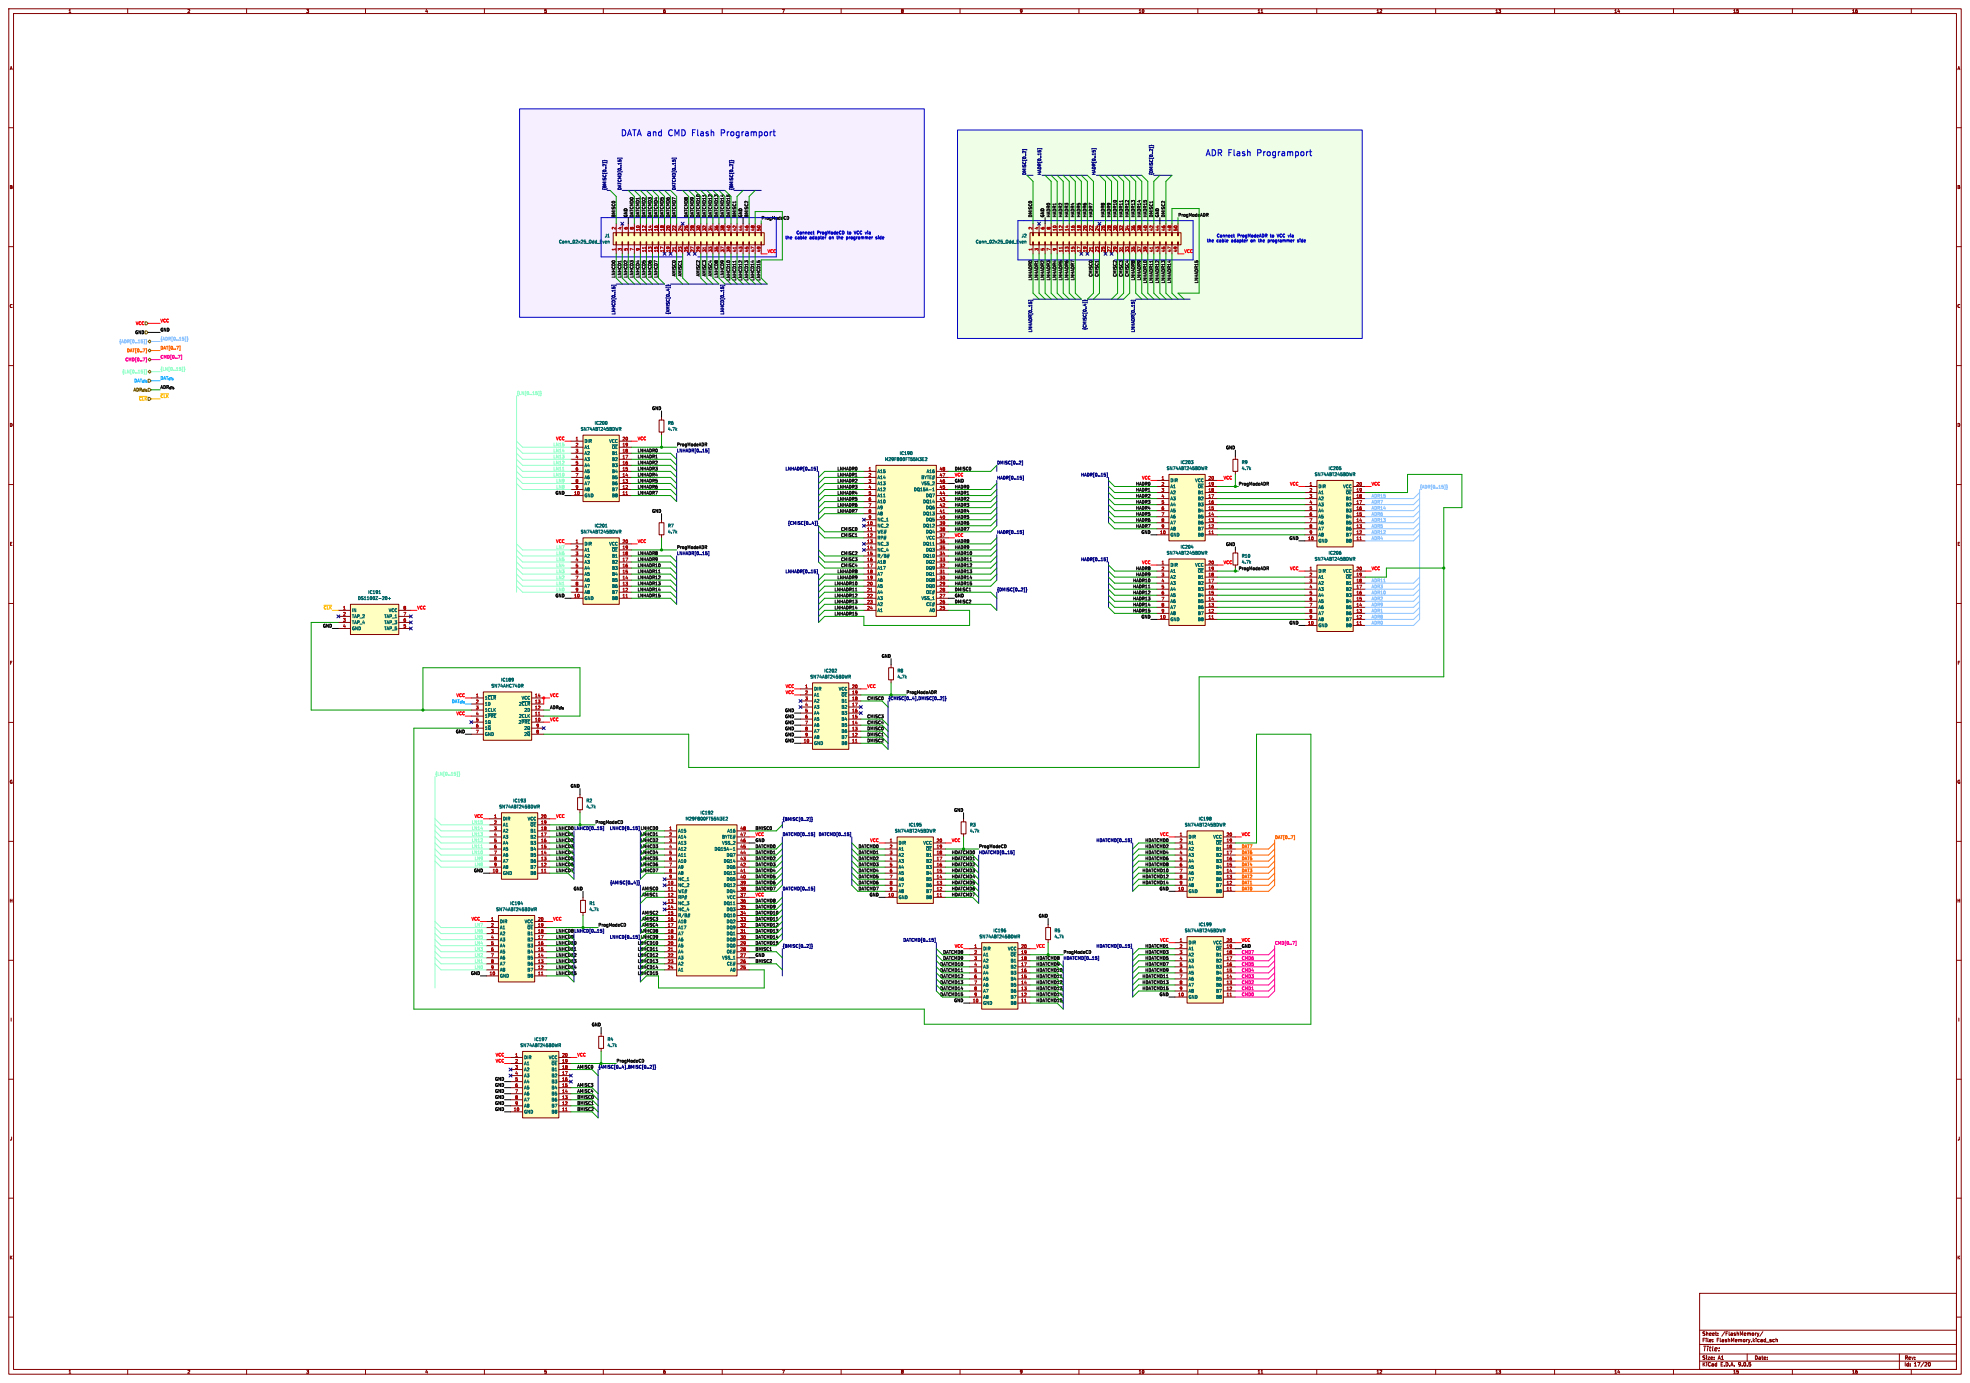
[picture p275: page 17]

DMISC0 VCC GND GND GND GND

Id: 17/20 Title: File: FlashMemory.kicad_sch Sheet: /FlashMemory/

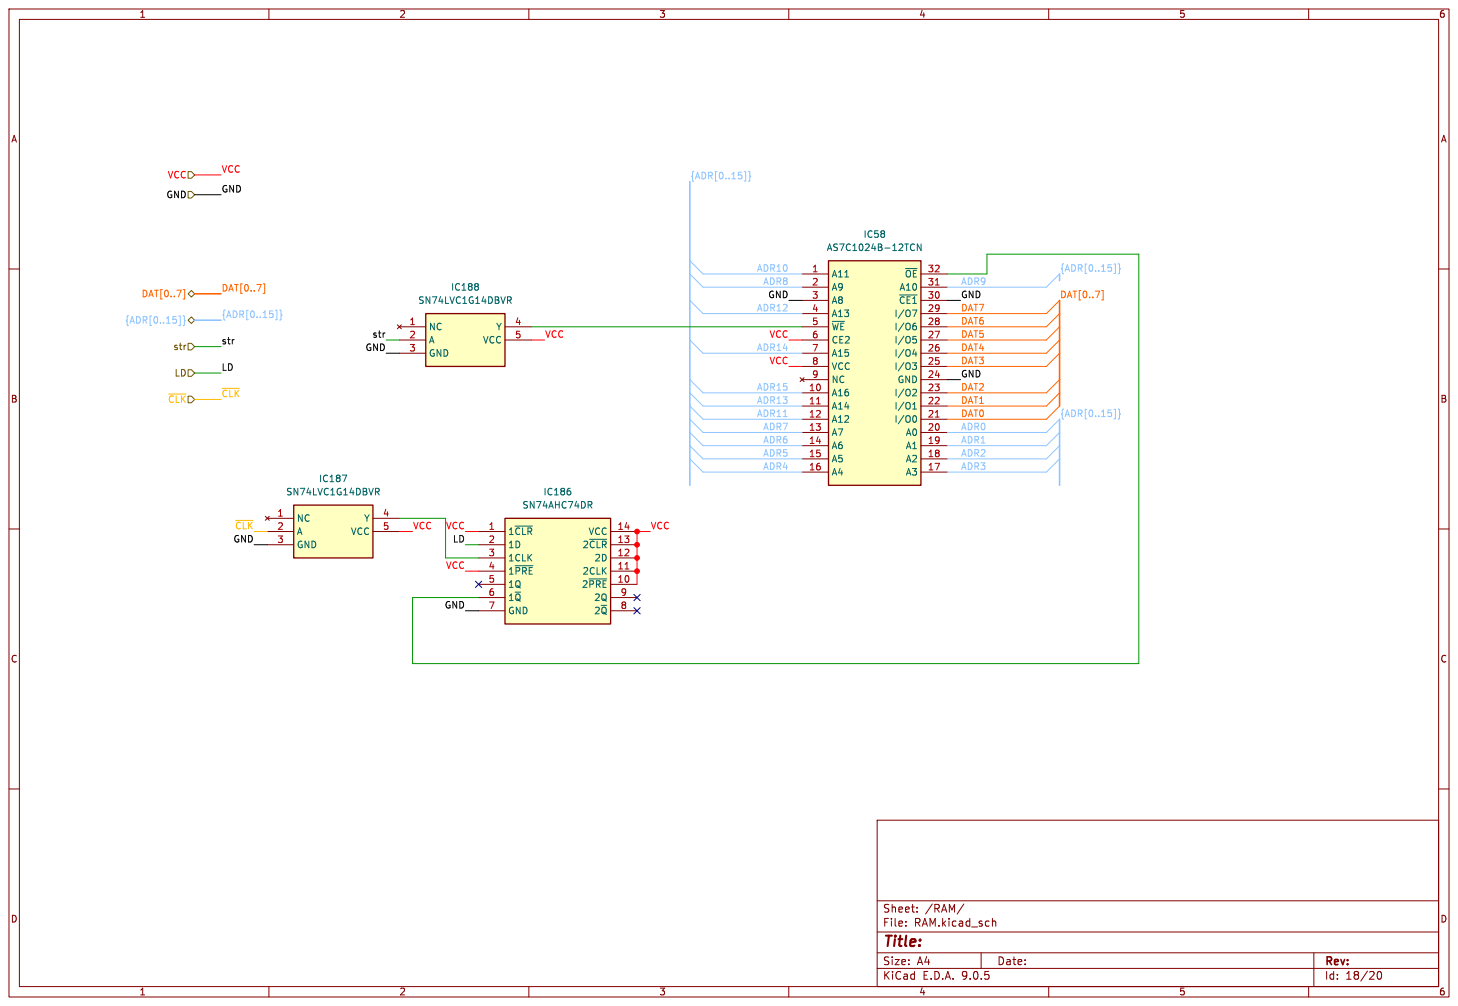
[picture p276: page 18]

{ADR[0..15]} str ~{CLK} GND
DAT[0..7]
DAT[0..7] str LD

Id: 18/20 Title: File: RAM.kicad_sch Sheet: /RAM/

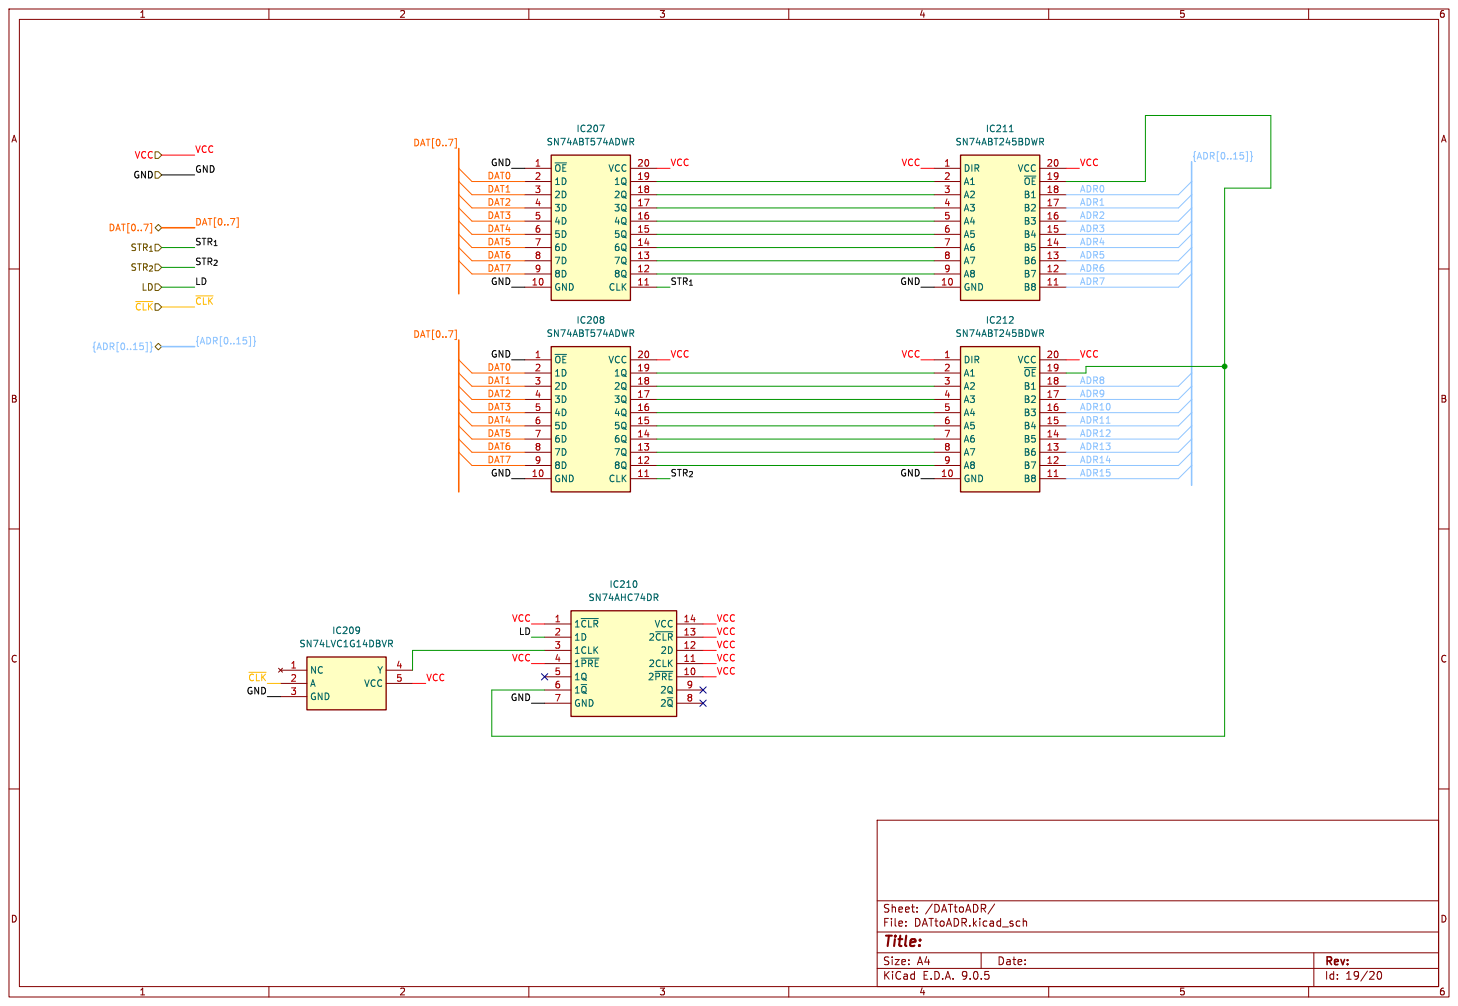
[picture p277: page 19]

Id: 19/20 Title: File: DATtoADR.kicad_sch Sheet: /DATtoADR/

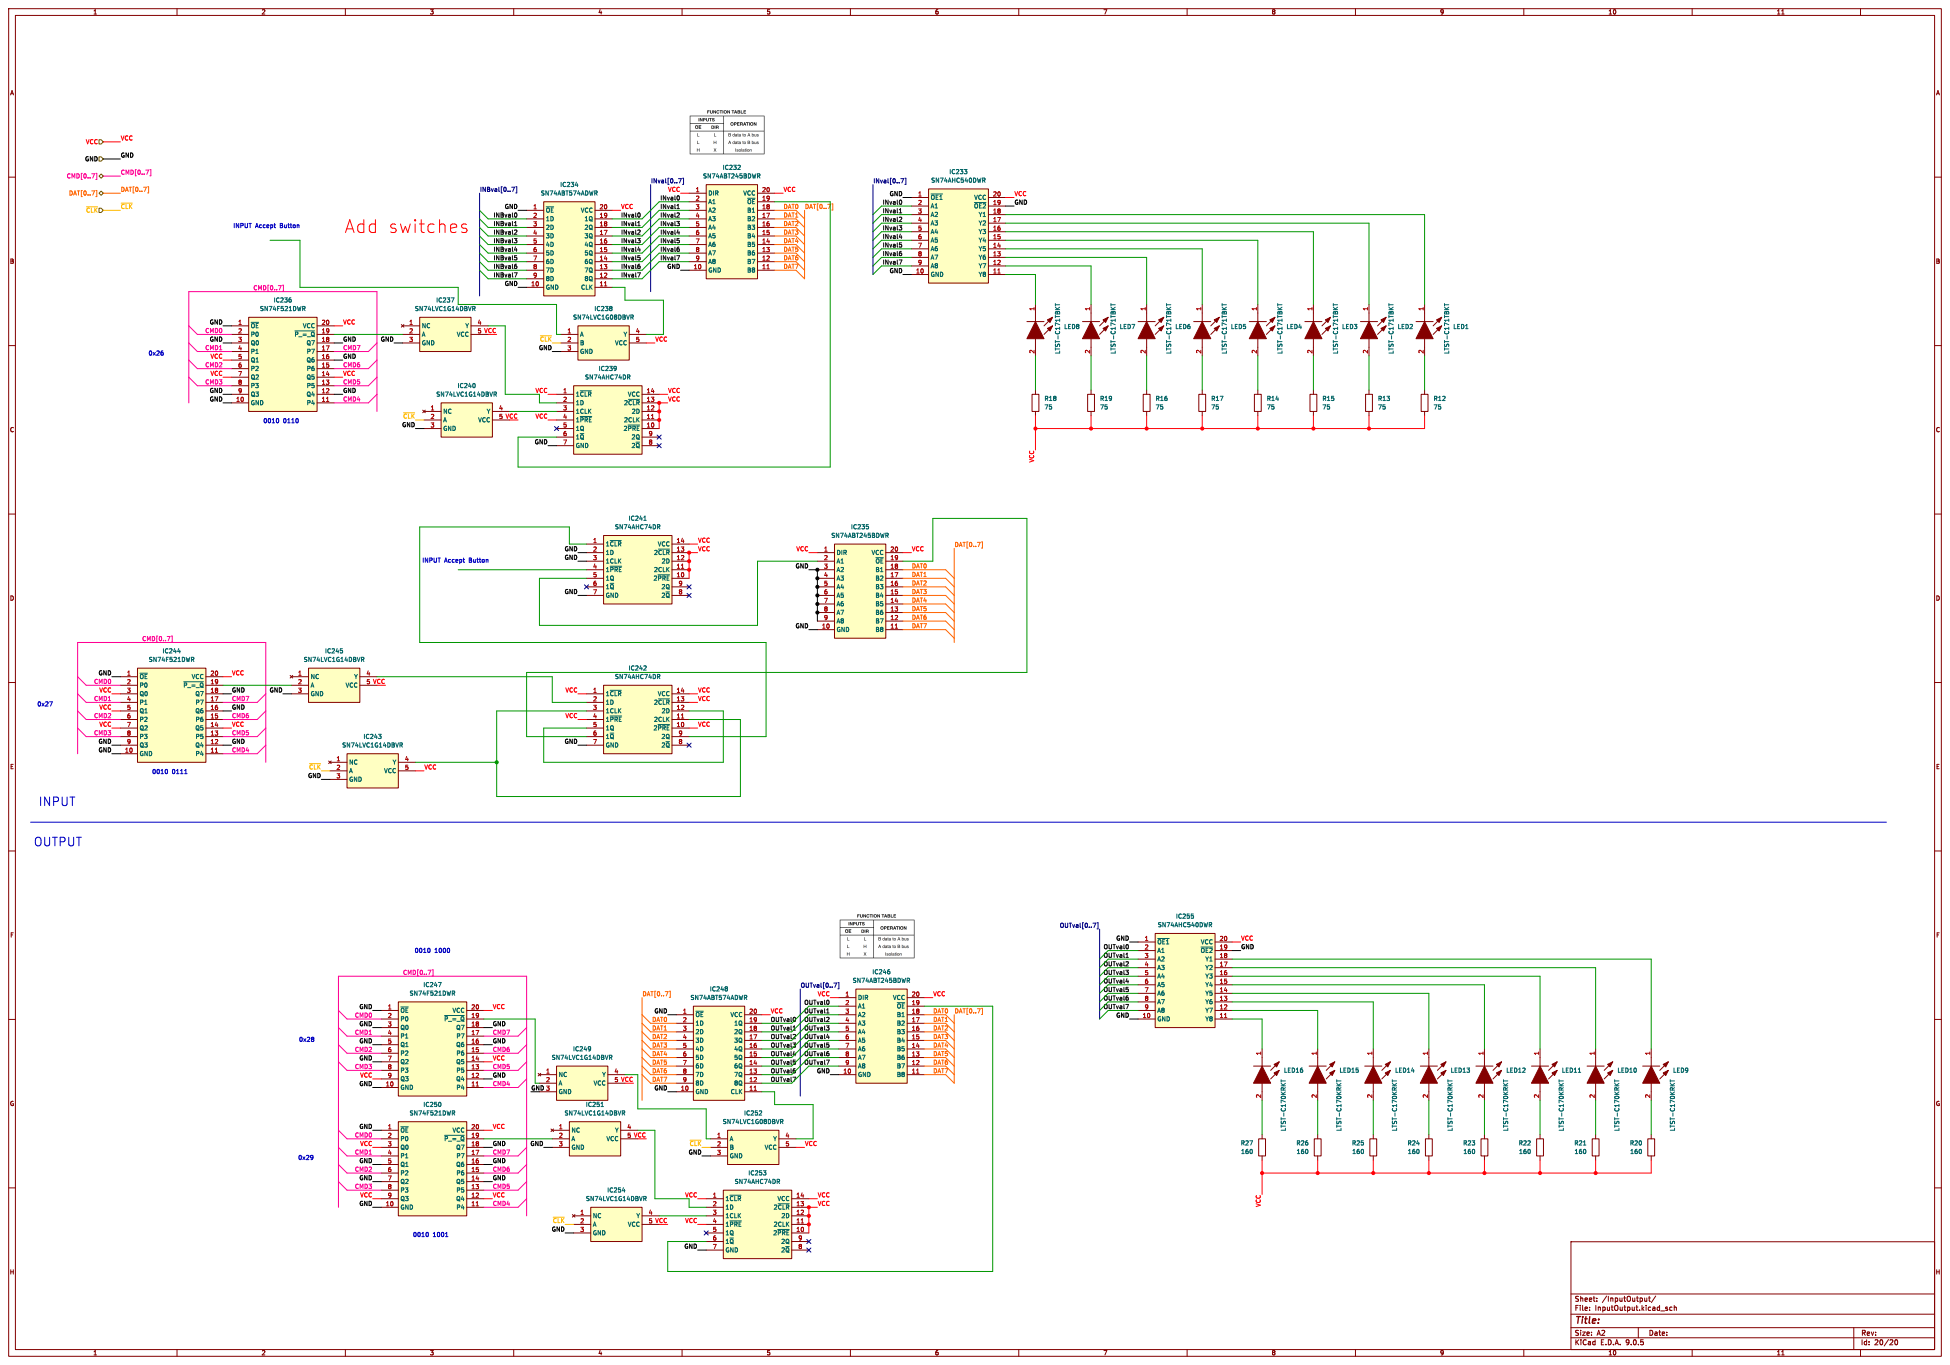
[picture p278: page 20]
