SSCsimsi/8Bit_Computer/8Bit Computer ver2.0/Kicad/Computer/8Bit_Computer_SCH_V2.0.pdf

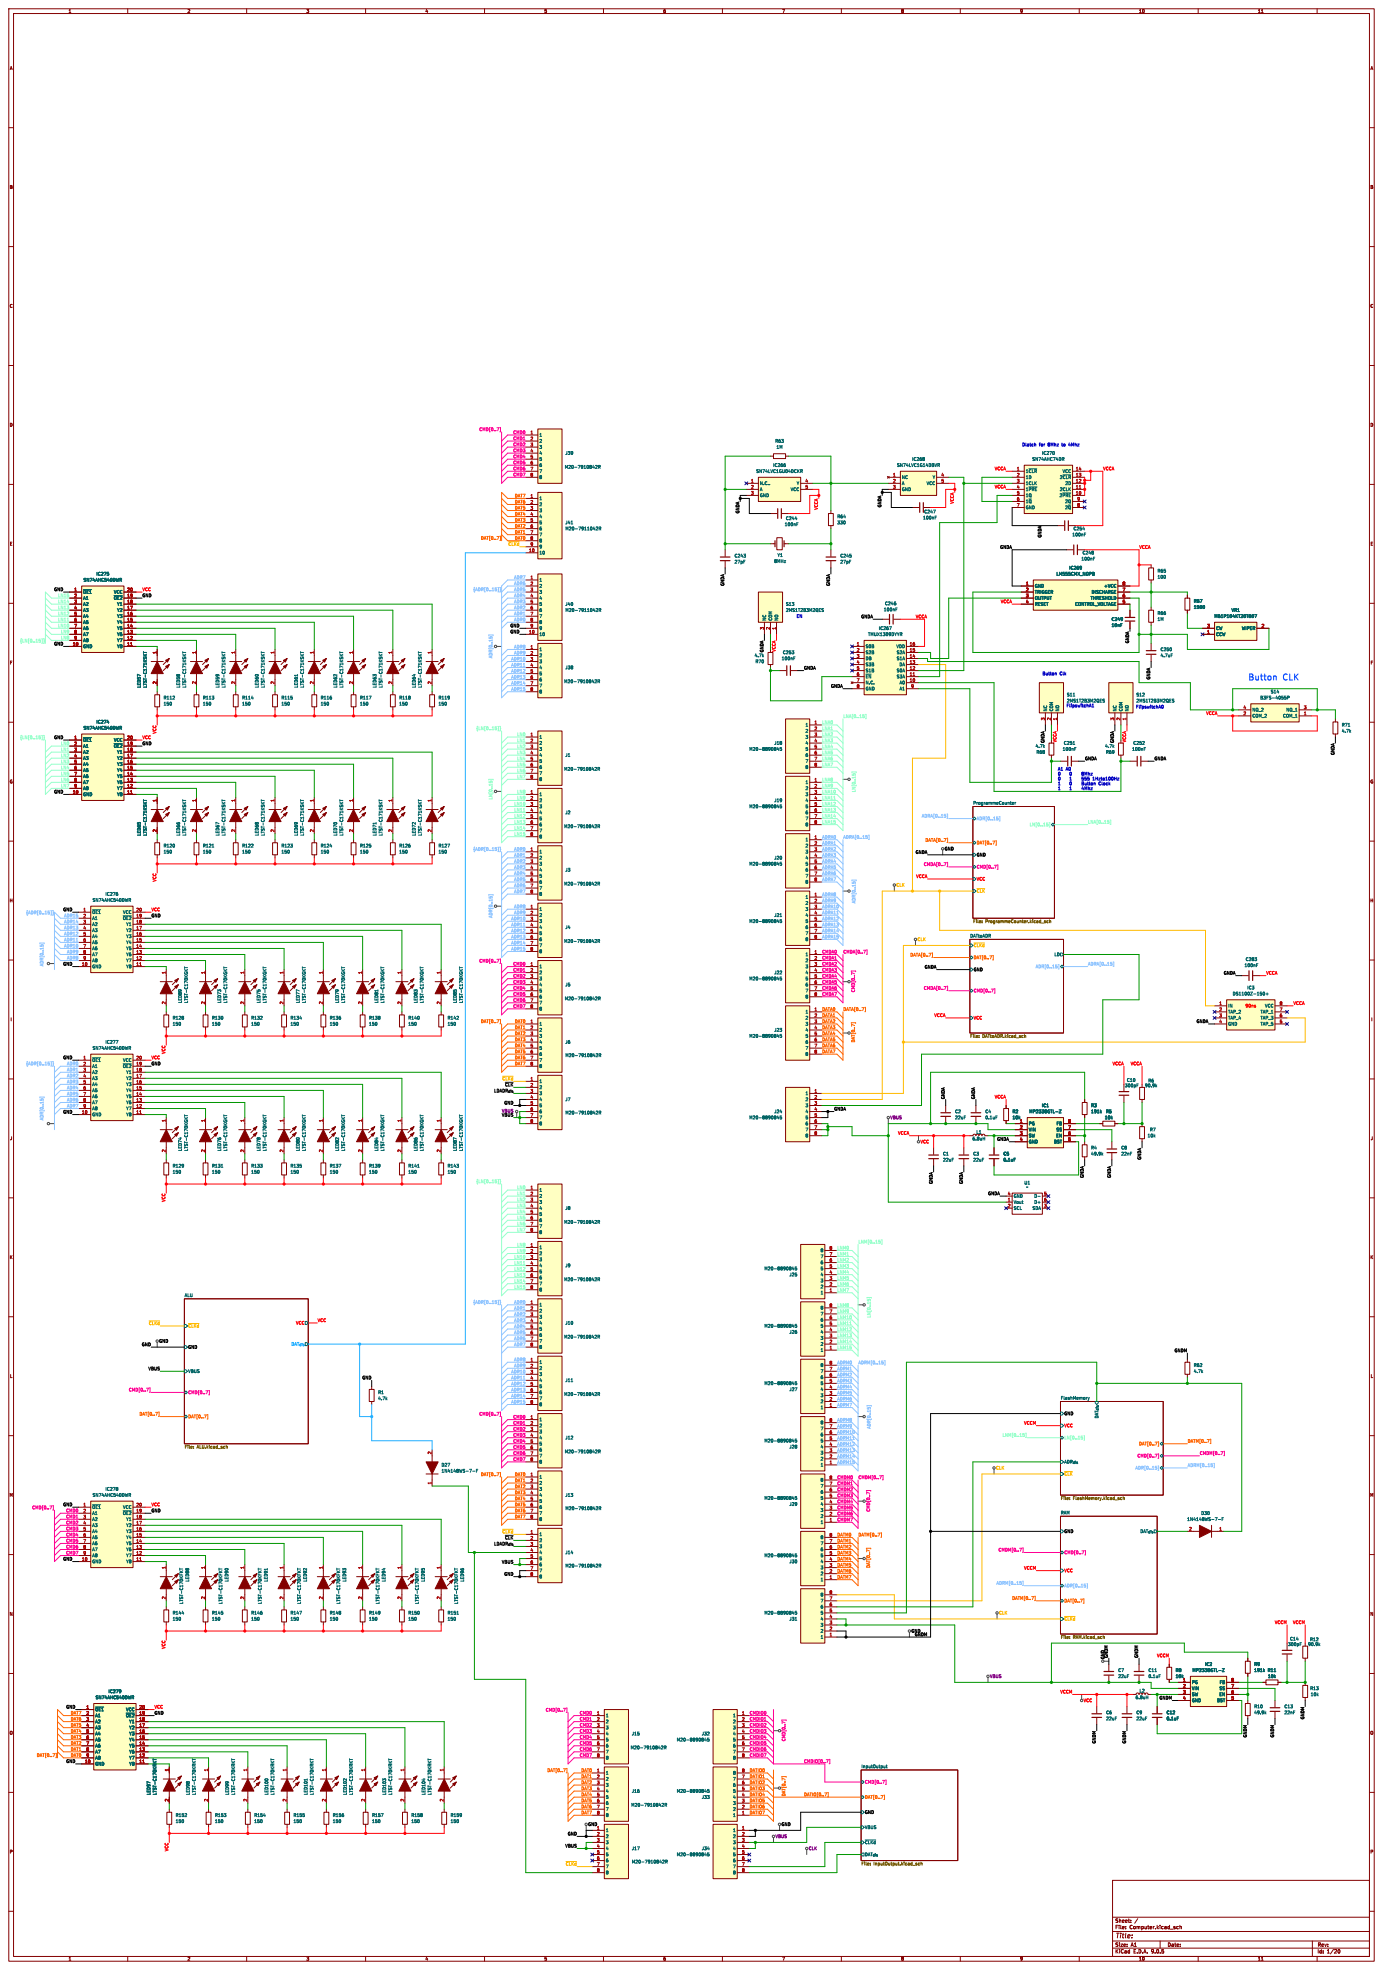
[picture p279: page 1]

GND ADR[0..15] ADR[0..15] ADR[0..15]

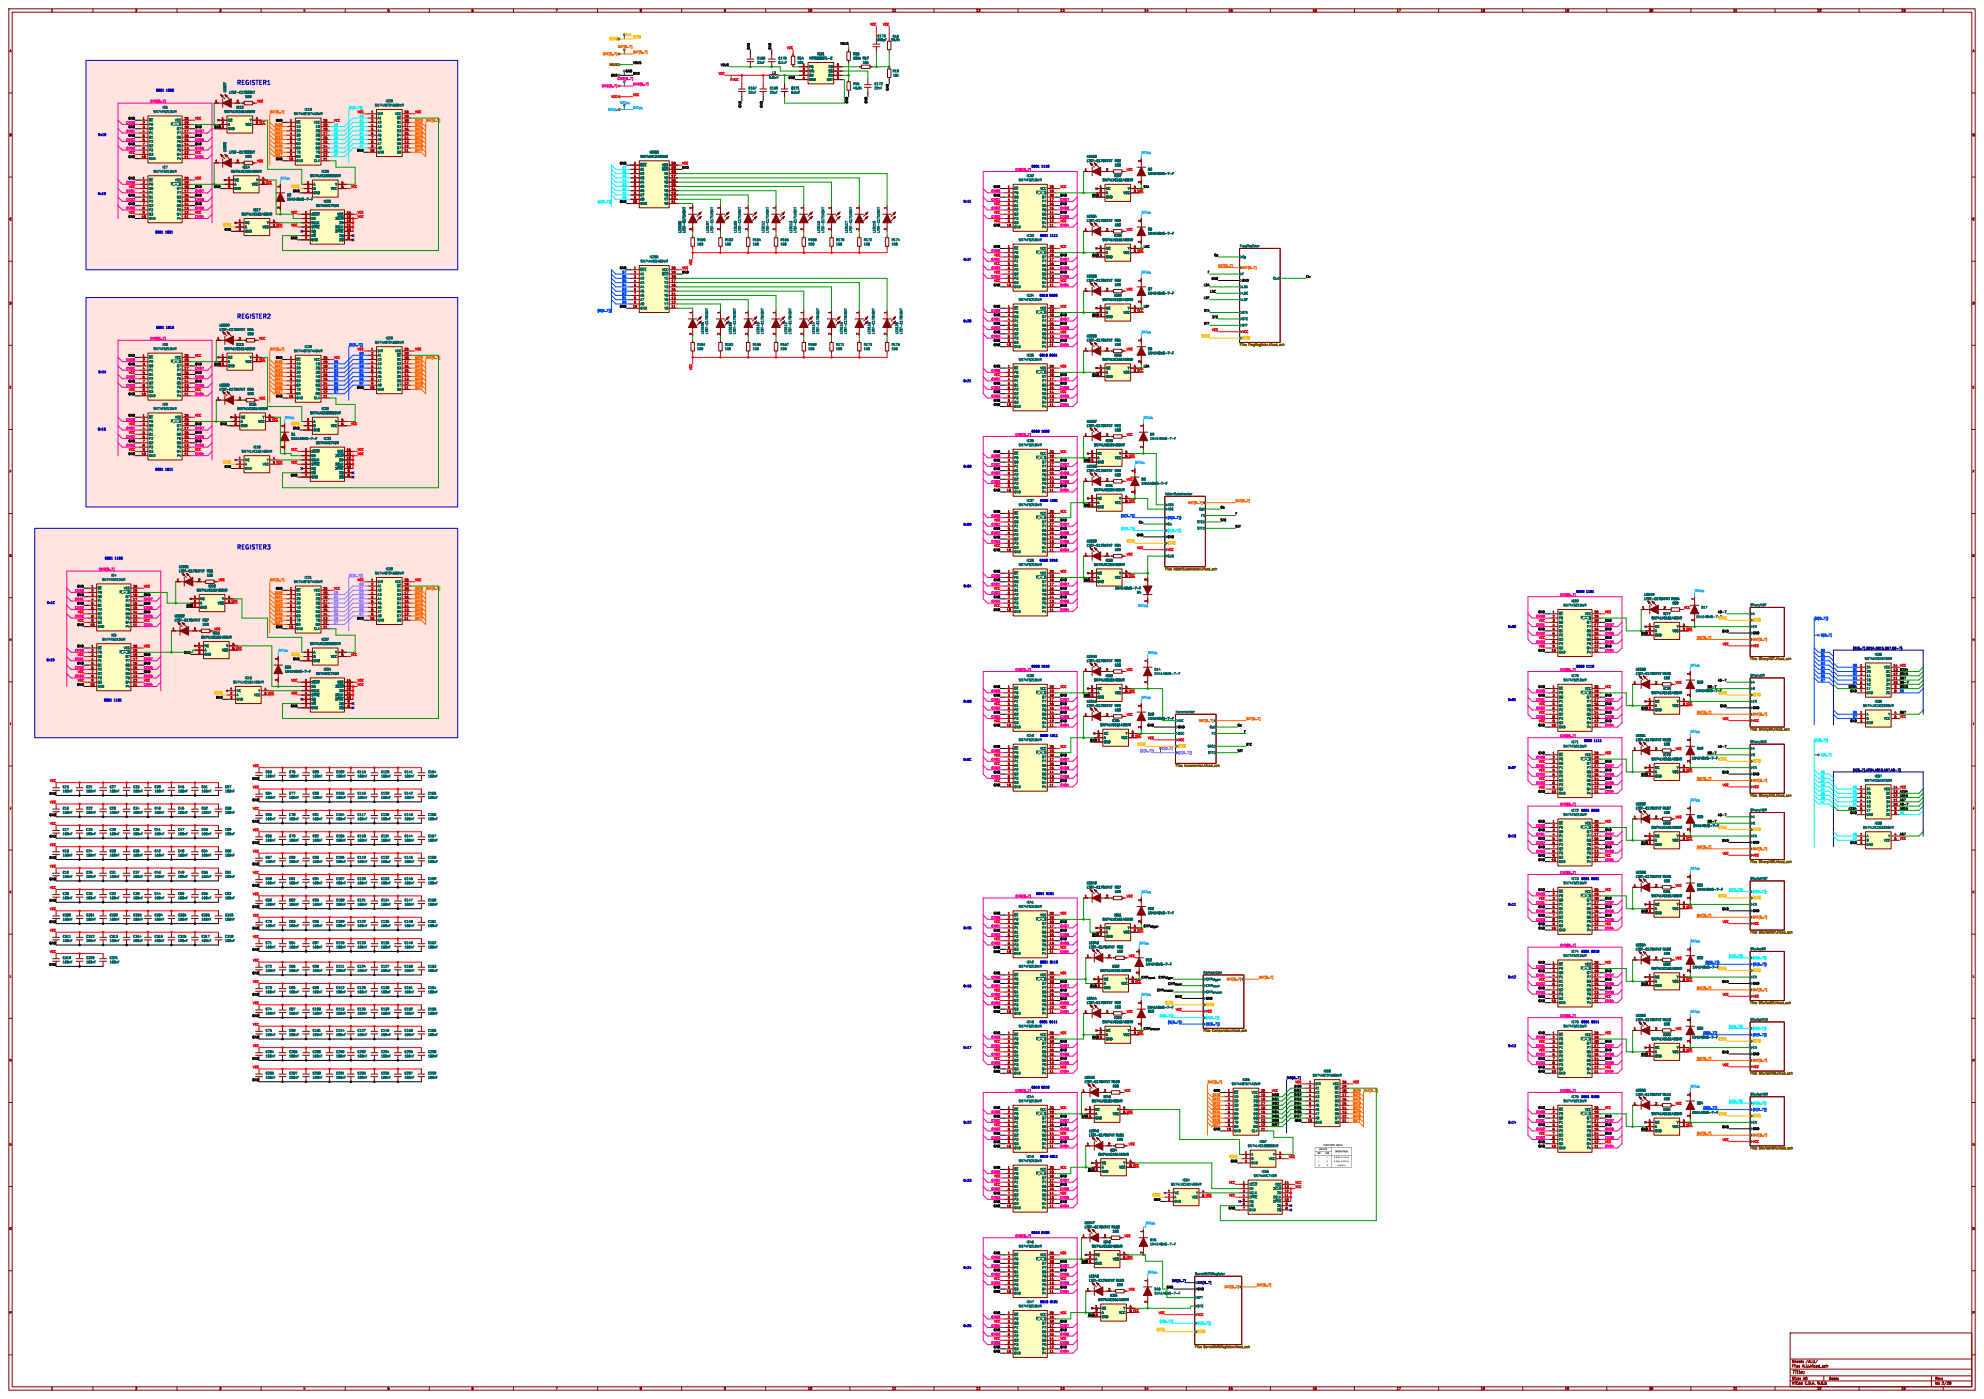
[picture p280: page 2]

~{CLKd} AdderSubstractor File: AdderSubstractor.kicad_sch

GND
Id: 2/20 Title: File: ALU.kicad_sch Sheet: /ALU/ AB

CMD0 VCC GND GND GND GND GND

CMD1 GND
VCC GND GND GND

SFT BarrelShiftRegister File: BarrelShiftRegister.kicad_sch



Id: 4/20 Title: File: BinaryNOT.kicad_sch Sheet: /ALU/BinaryNOT/


Id: 5/20 Title: File: BinaryOR.kicad_sch Sheet: /ALU/BinaryOR/


Id: 6/20 Title: File: BinaryXOR.kicad_sch Sheet: /ALU/BinaryXOR/



Id: 8/20 Title: File: BitwiseNOT.kicad_sch Sheet: /ALU/BitwiseNOT/


Id: 9/20 Title: File: BitwiseOR.kicad_sch Sheet: /ALU/BitwiseOR/


Id: 10/20 Title: File: BitwiseXOR.kicad_sch Sheet: /ALU/BitwiseXOR/

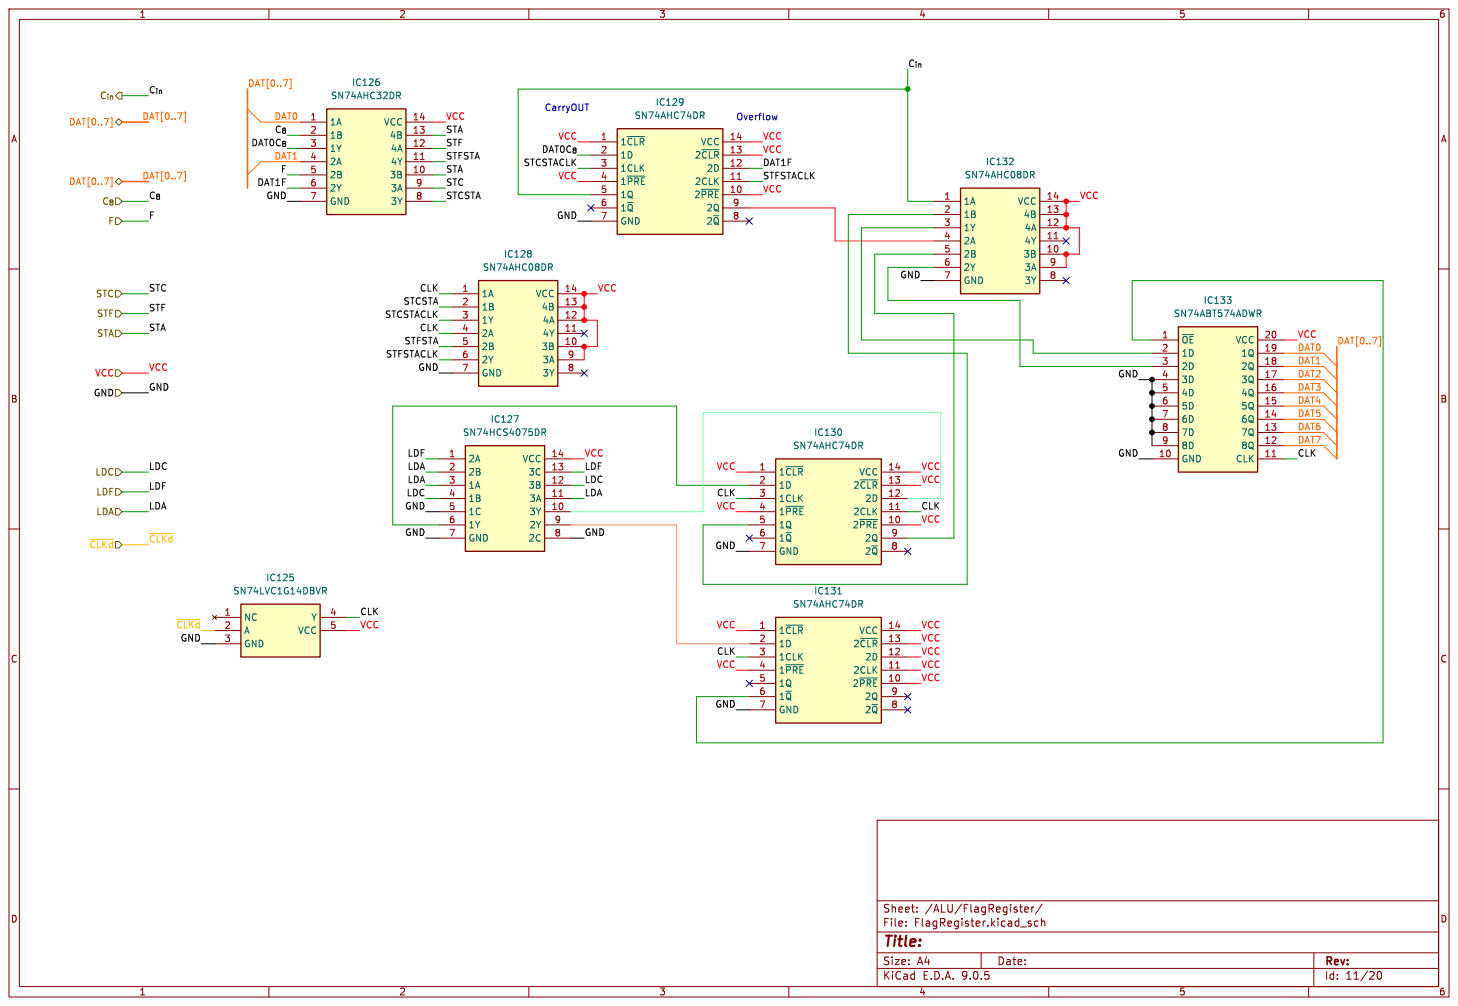
[picture p281: page 11]

DAT[0..7]
DAT[0..7] STC
~{CLKd} STF STA DAT[0..7]

STCSTACLK CLK CLK GND
~{CLKd} LDC GND
LDC GND

Id: 11/20 Title: File: FlagRegister.kicad_sch Sheet: /ALU/FlagRegister/


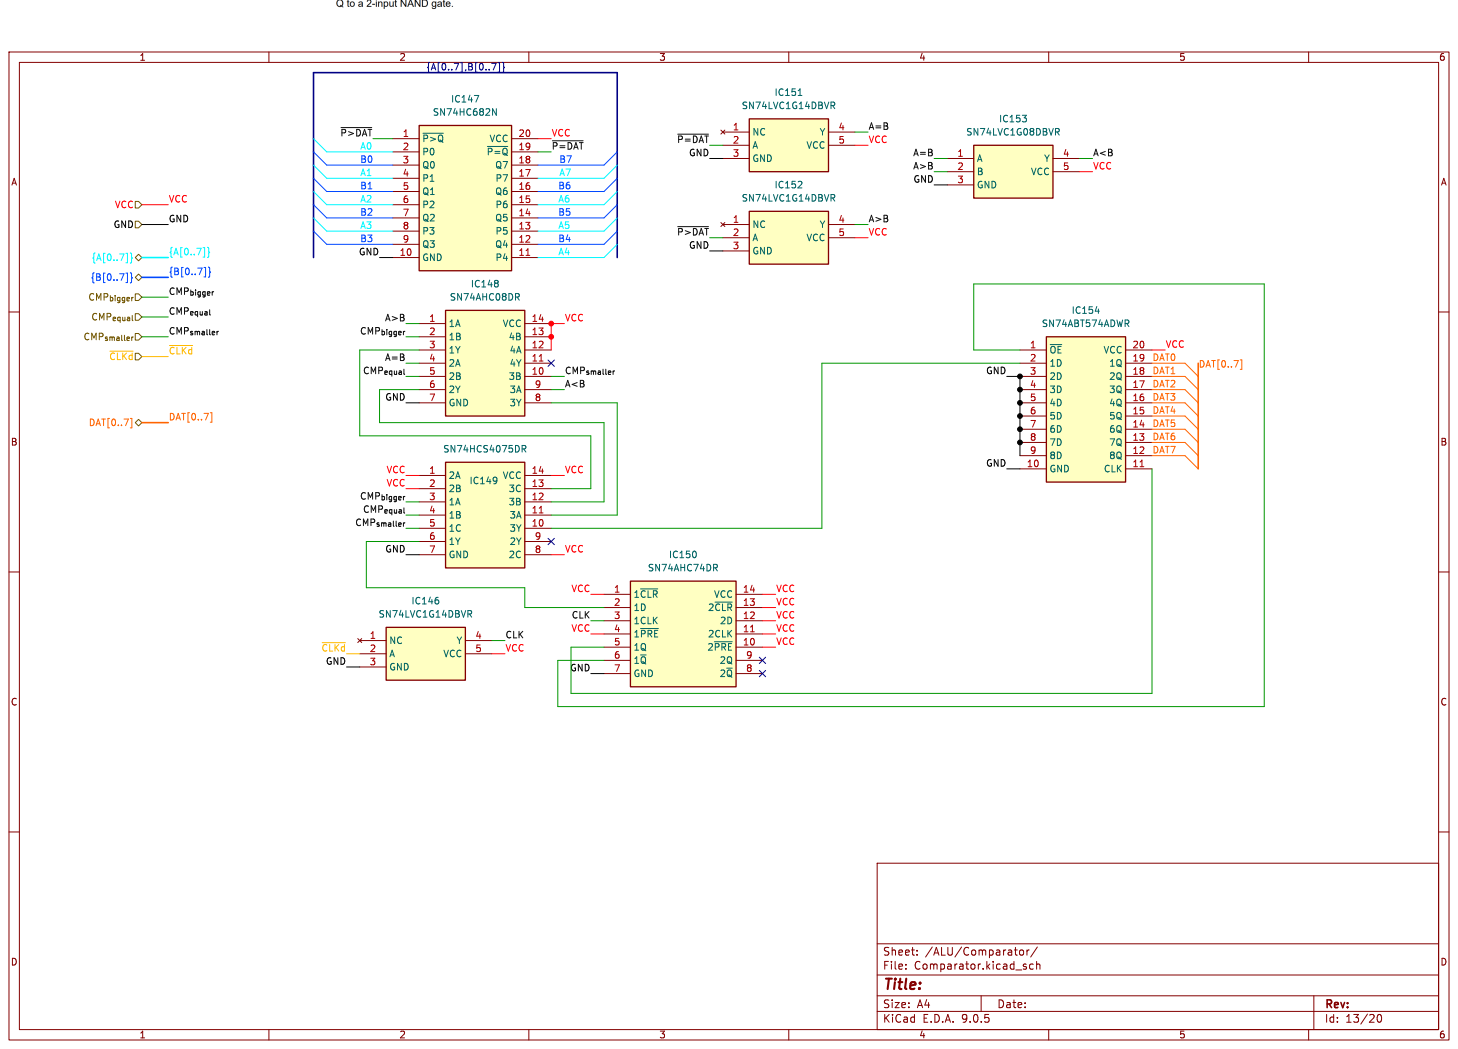
[picture p282: page 13]

Id: 13/20 Title: File: Comparator.kicad_sch Sheet: /ALU/Comparator/

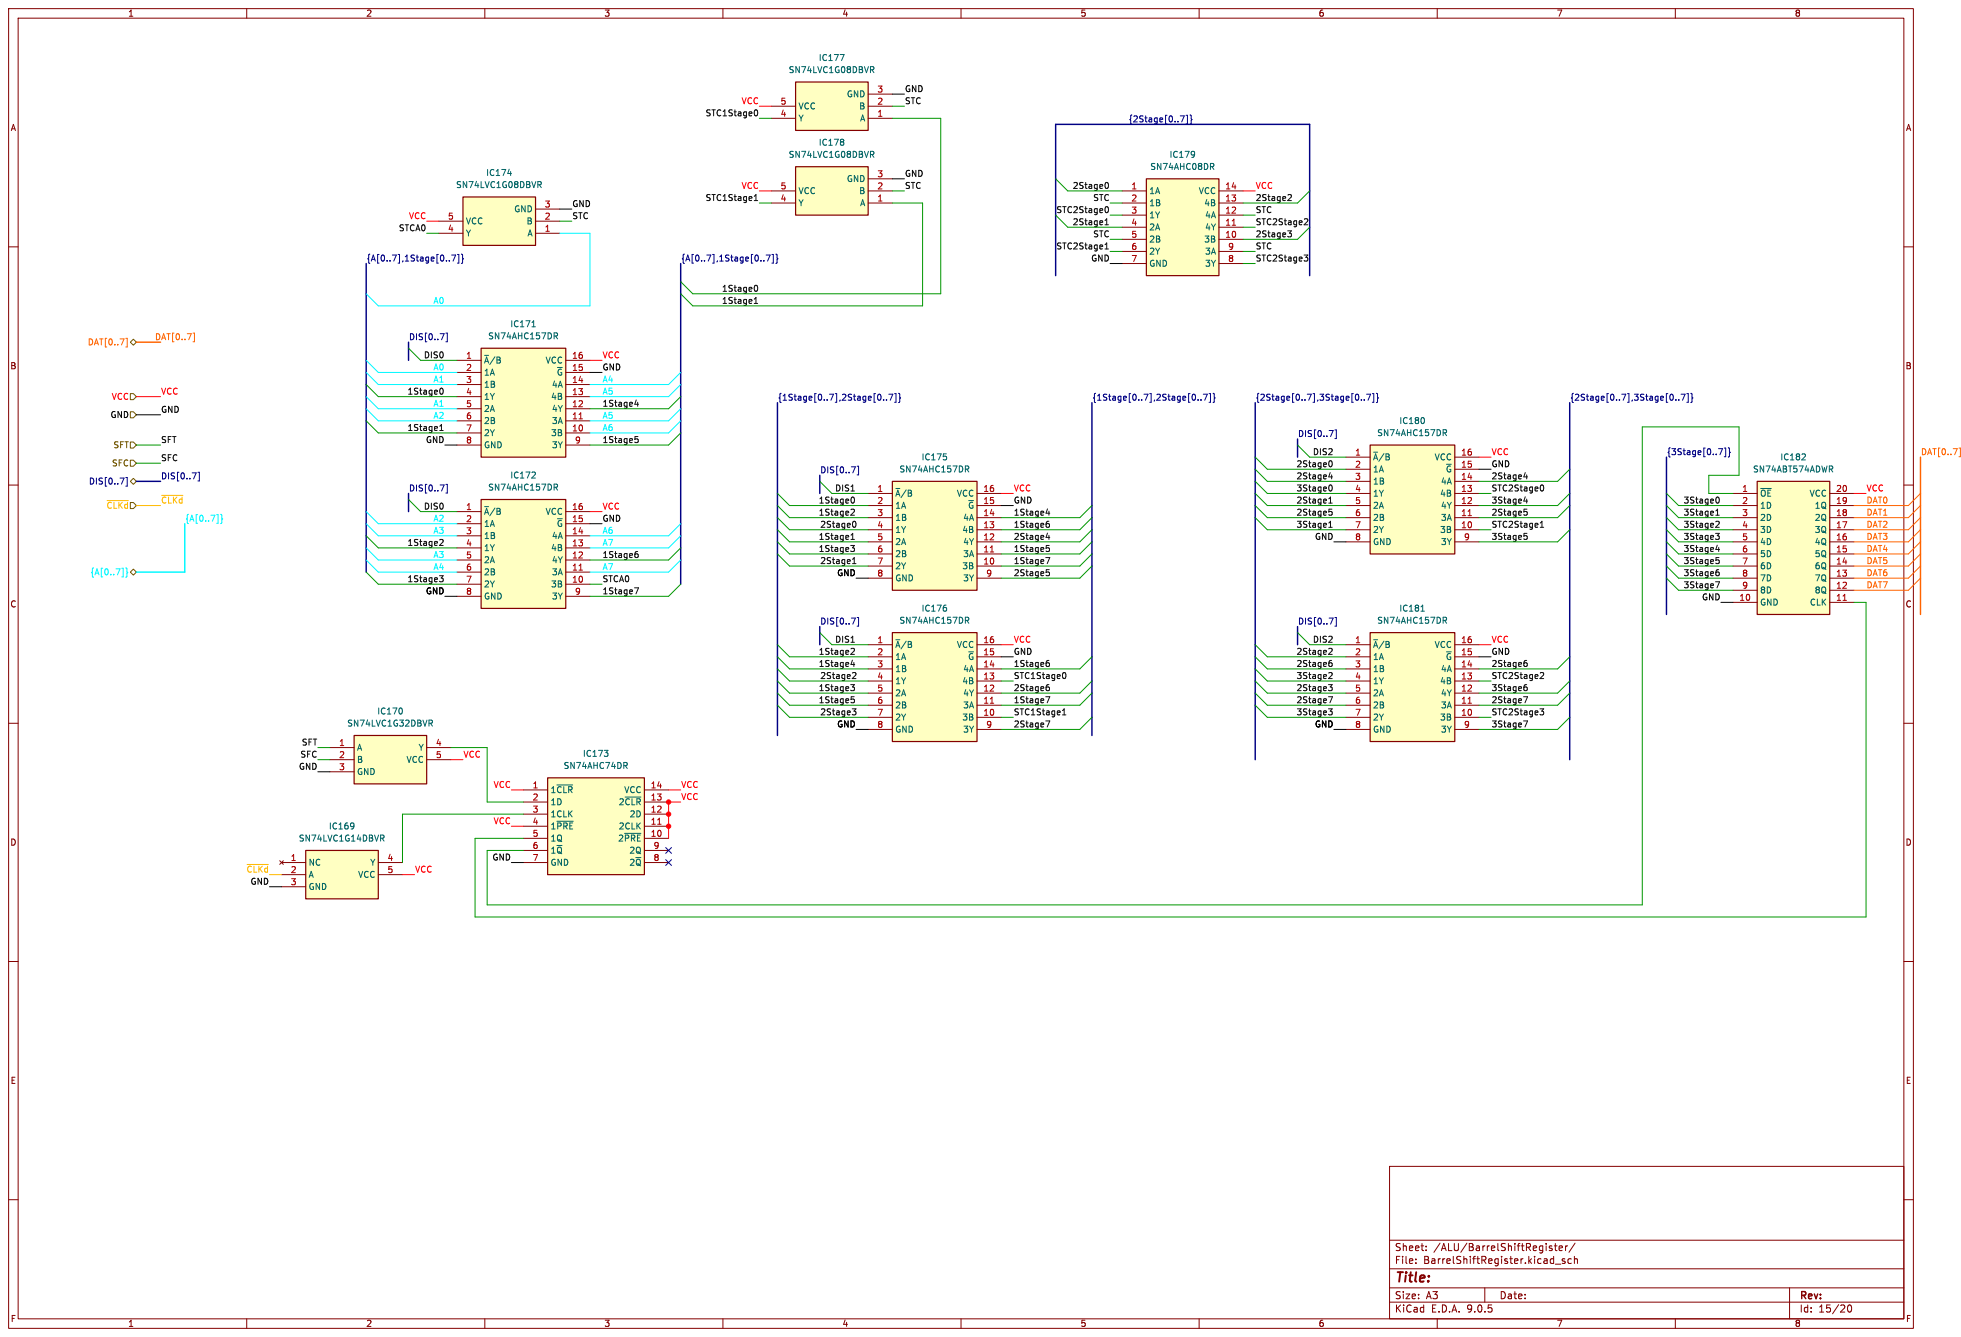
[picture p283: page 14]

DAT[0..7] VCC
DIS[0..7] SFT DAT[0..7] SFC
{A[0..7]} GND


Id: 16/20 Title: File: AdderSubstractor.kicad_sch Sheet: /ALU/AdderSubstractor/

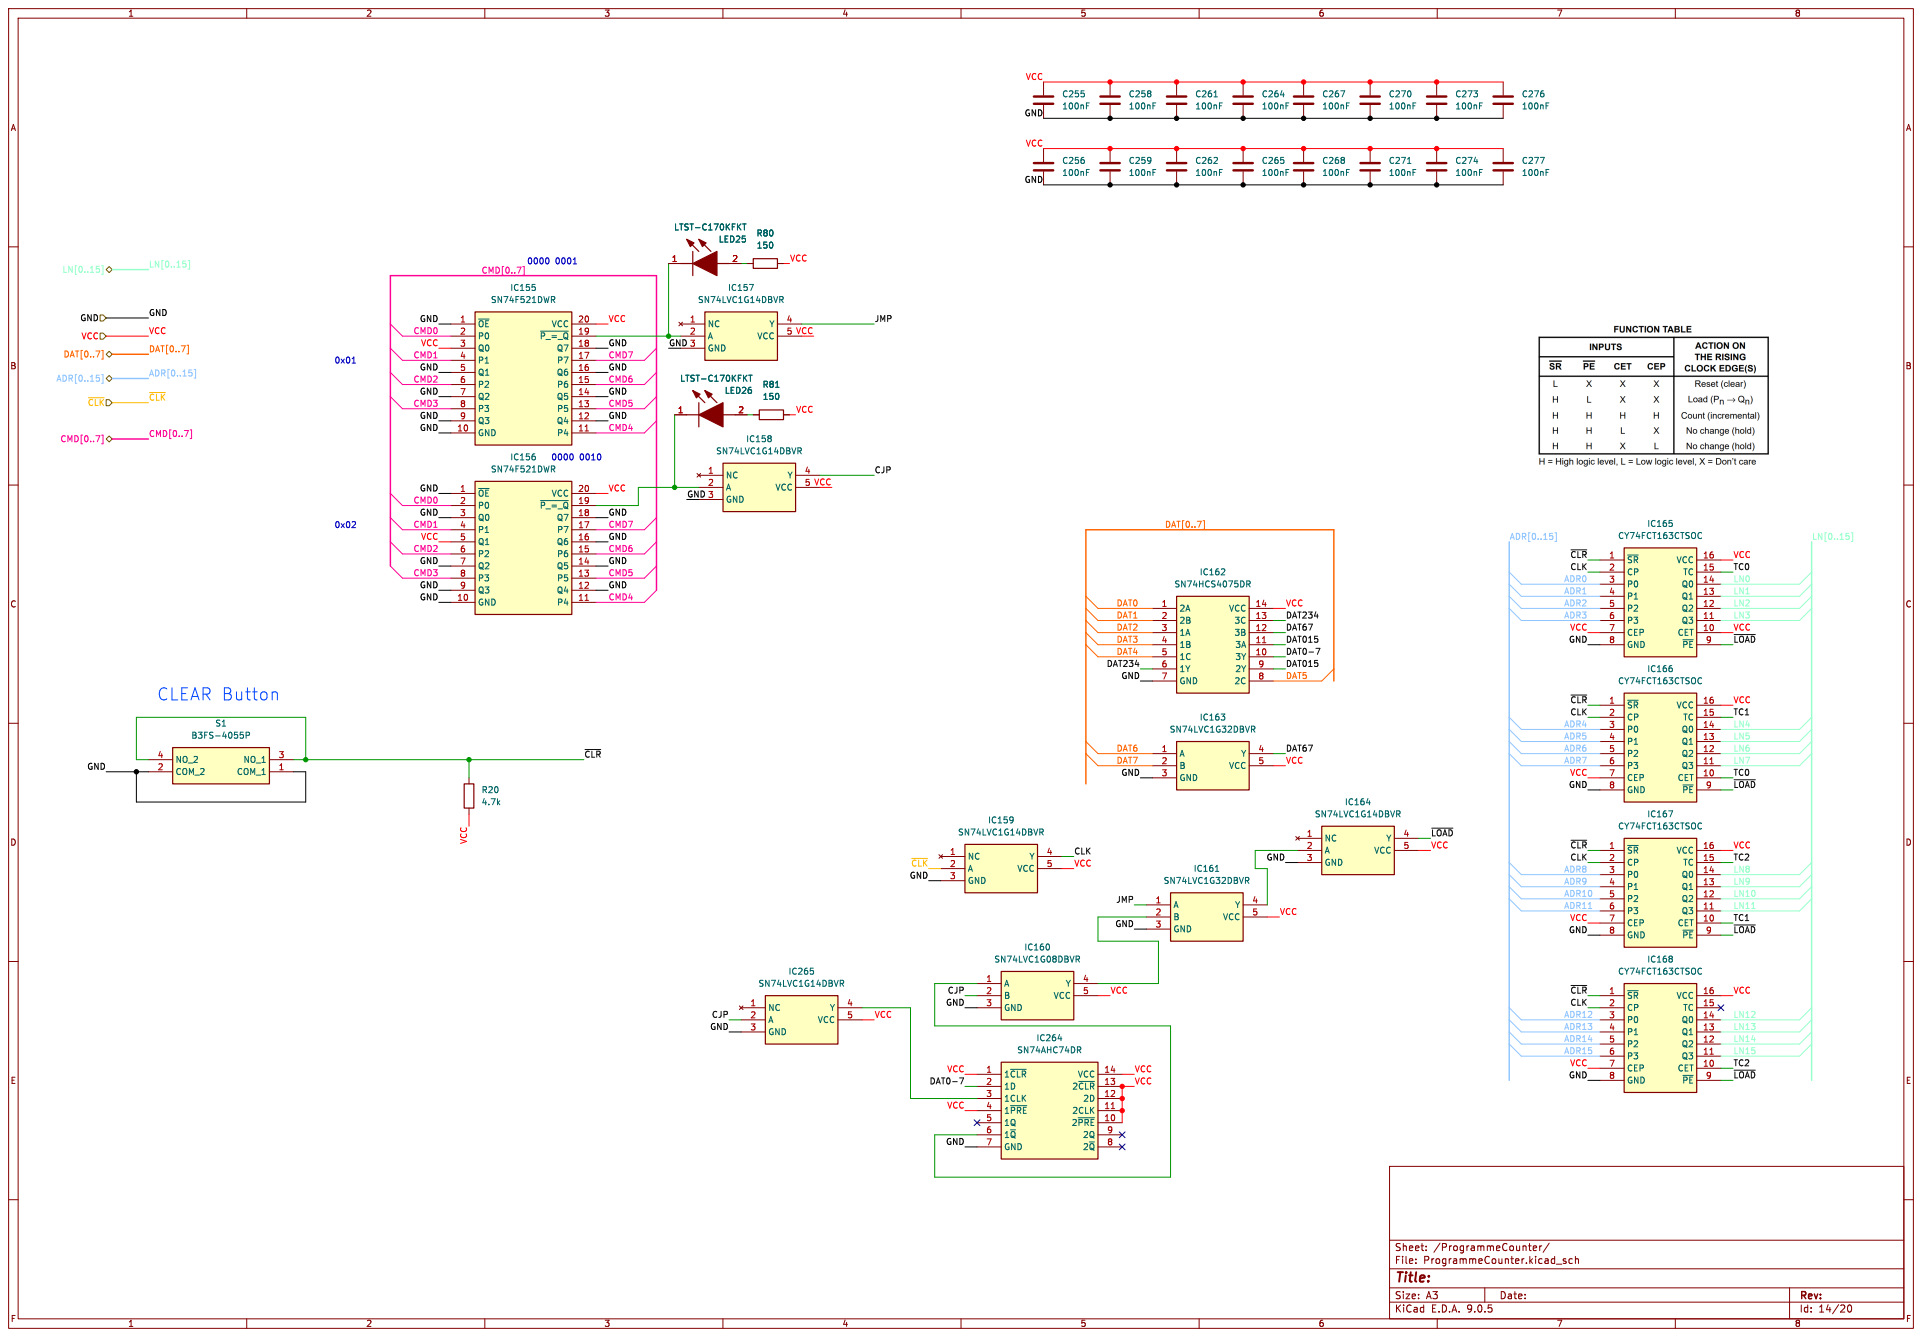
[picture p284: page 16]

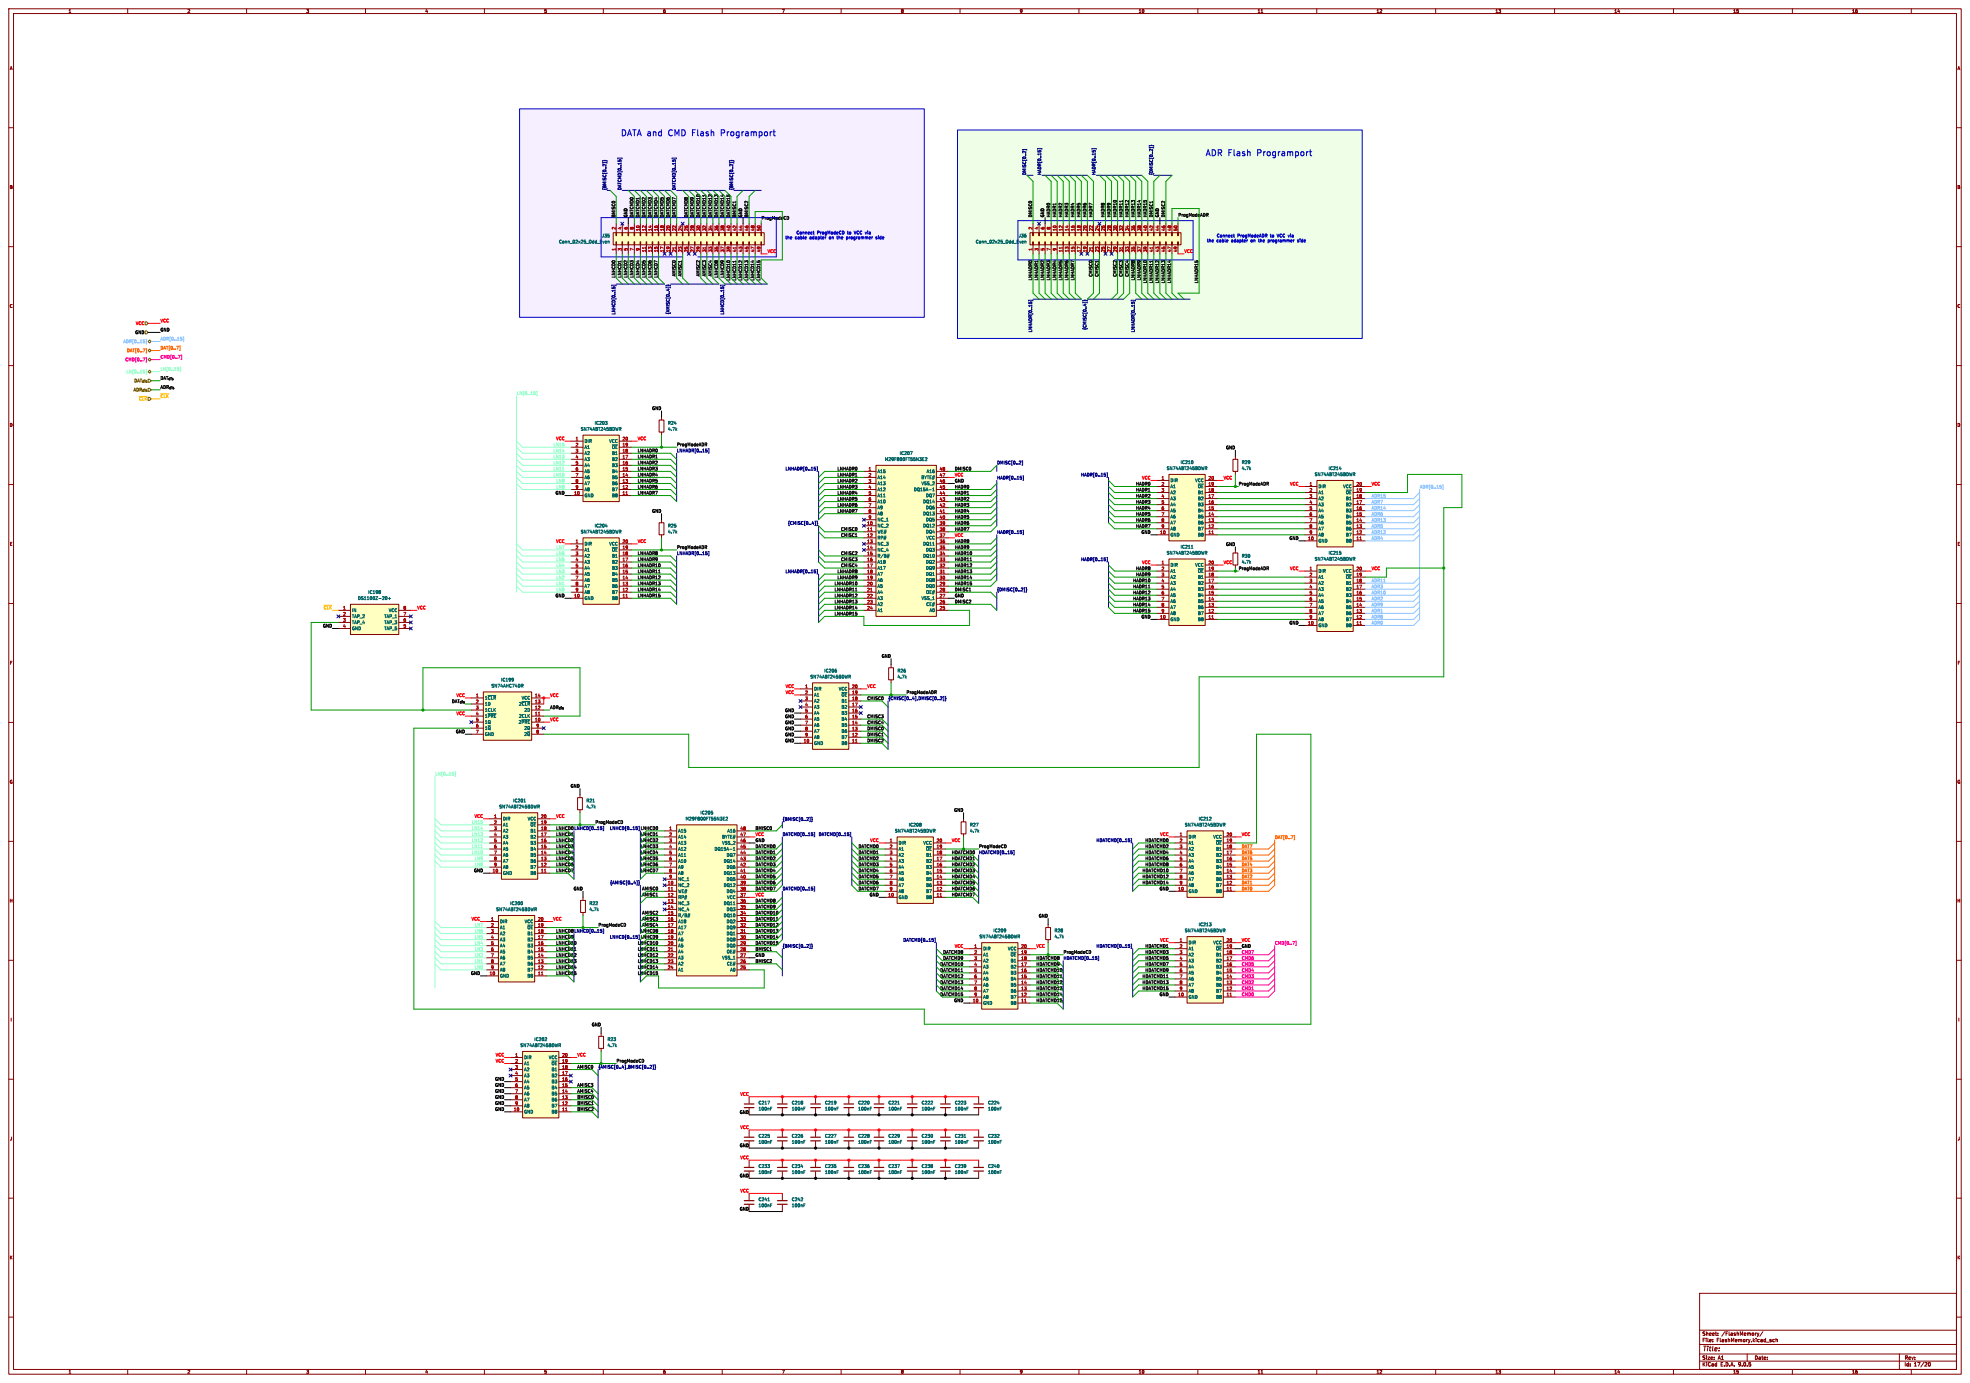
[picture p285: page 17]

Id: 17/20 Title: File: FlashMemory.kicad_sch Sheet: /FlashMemory/

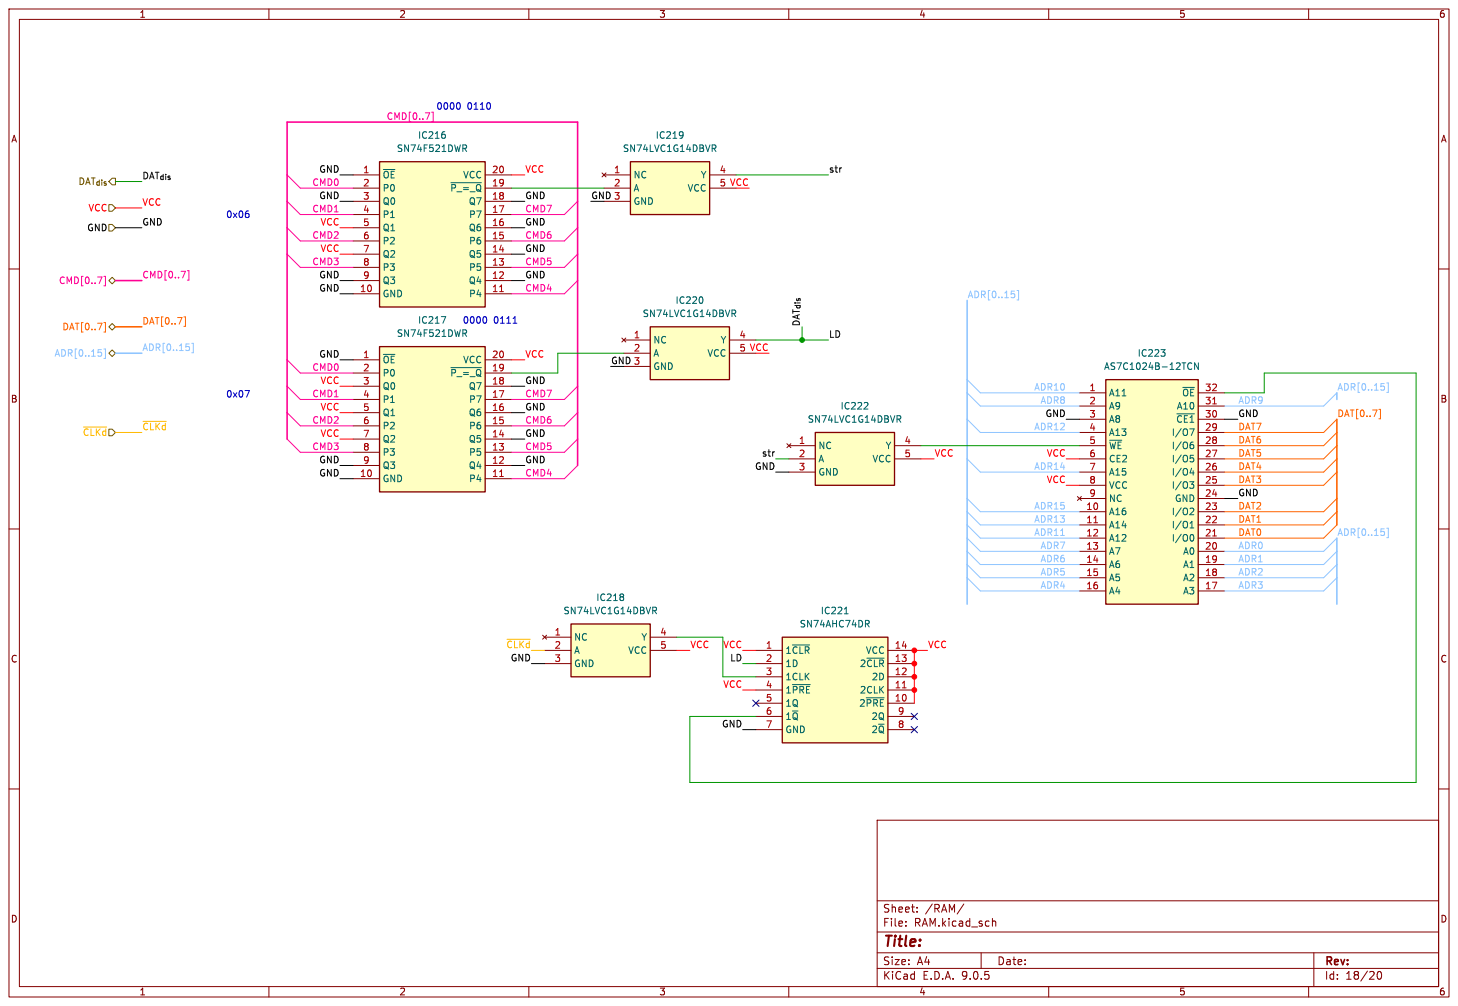
[picture p286: page 18]

Id: 18/20 Title: File: RAM.kicad_sch Sheet: /RAM/


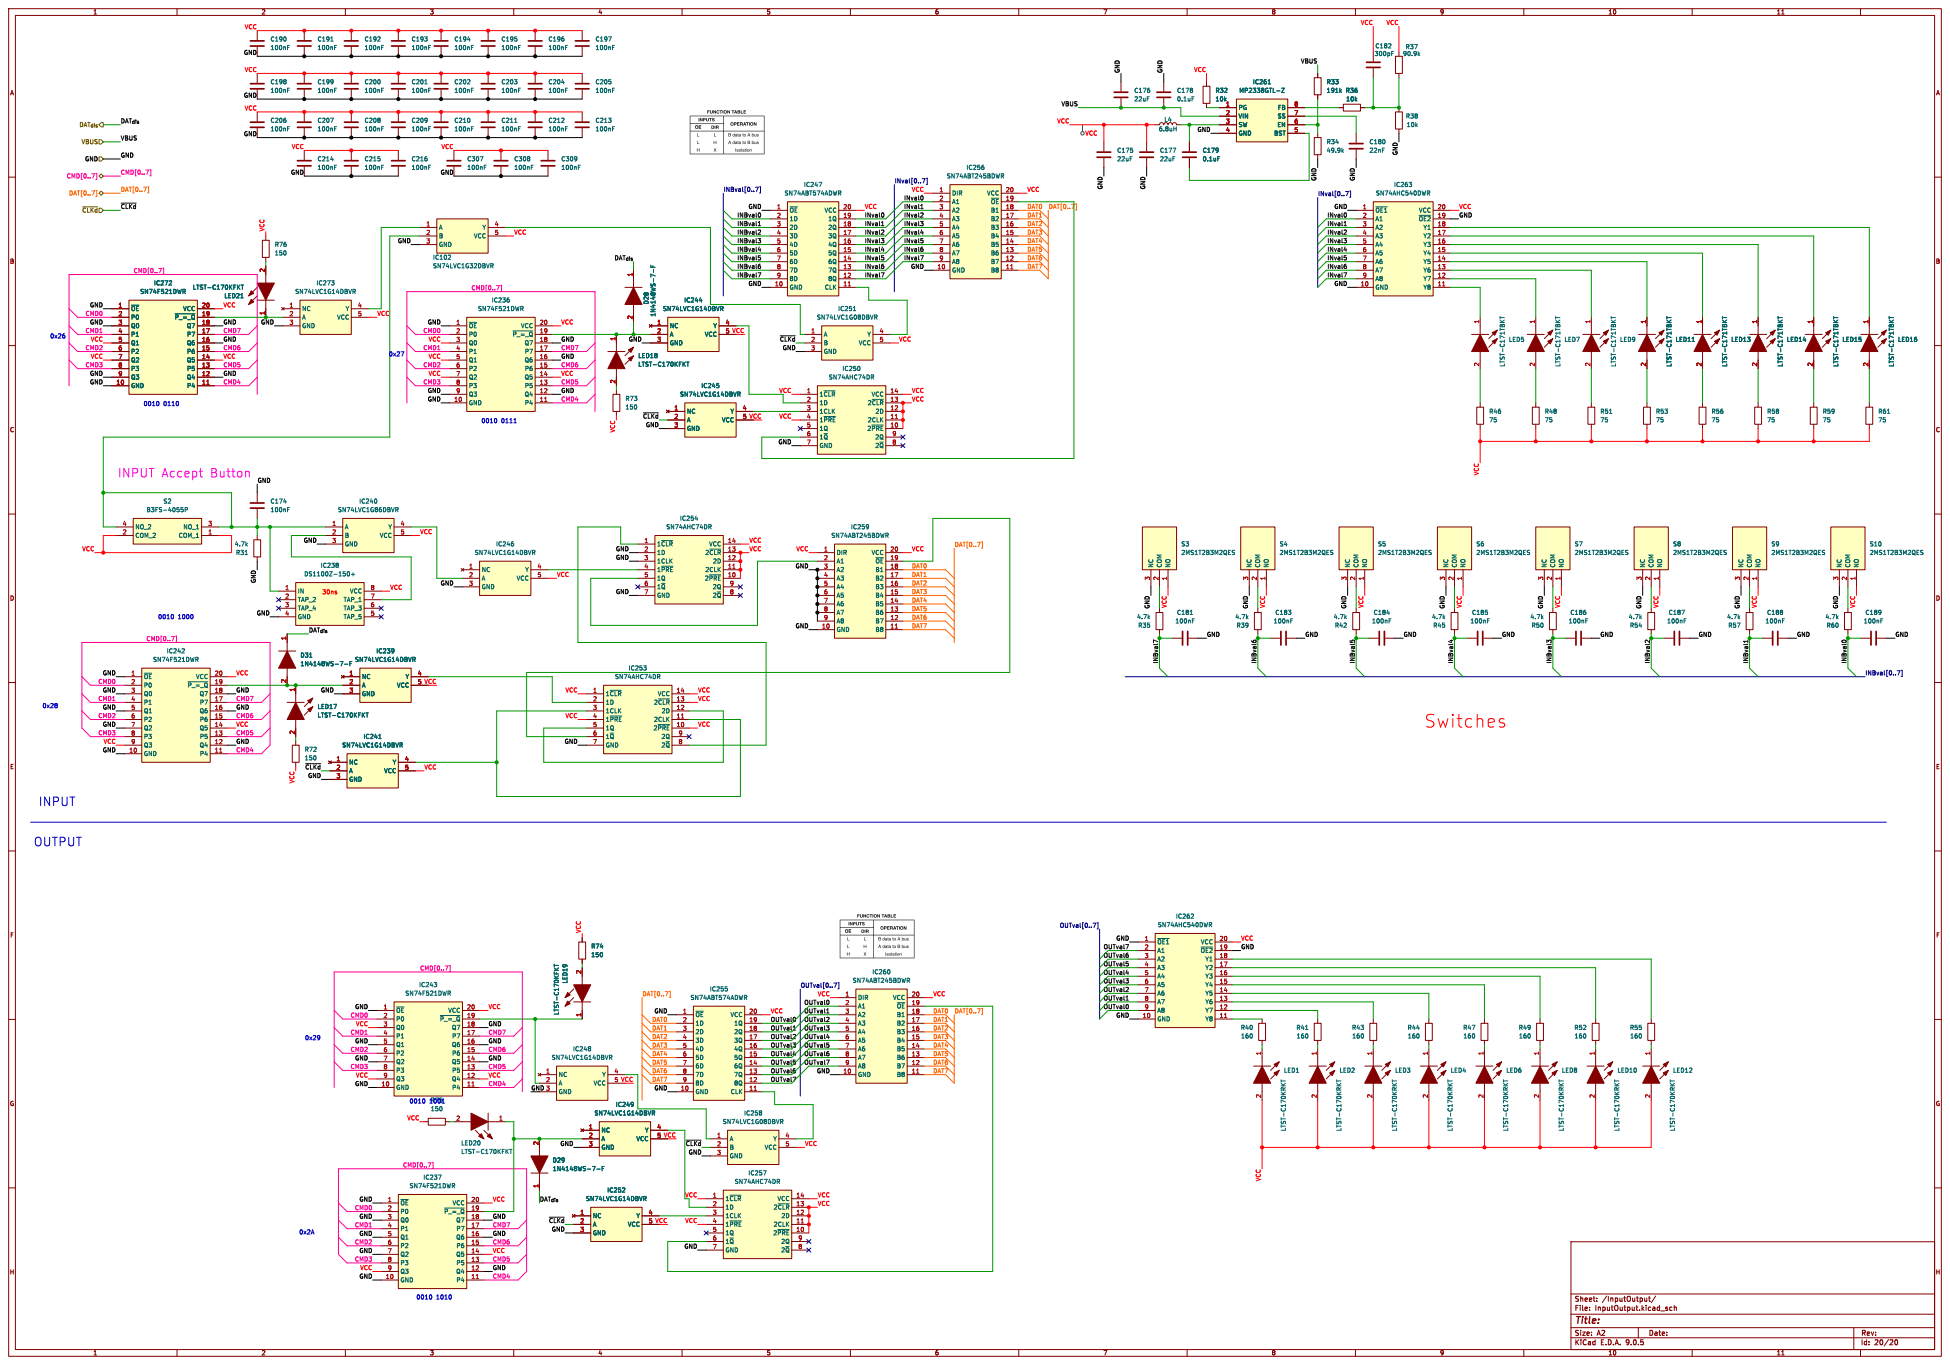
[picture p287: page 20]
