SSCsimsi/8Bit_Computer/8Bit Computer ver2.0/Kicad/Computer/8Bit_Computer_SCH_V1.0.pdf

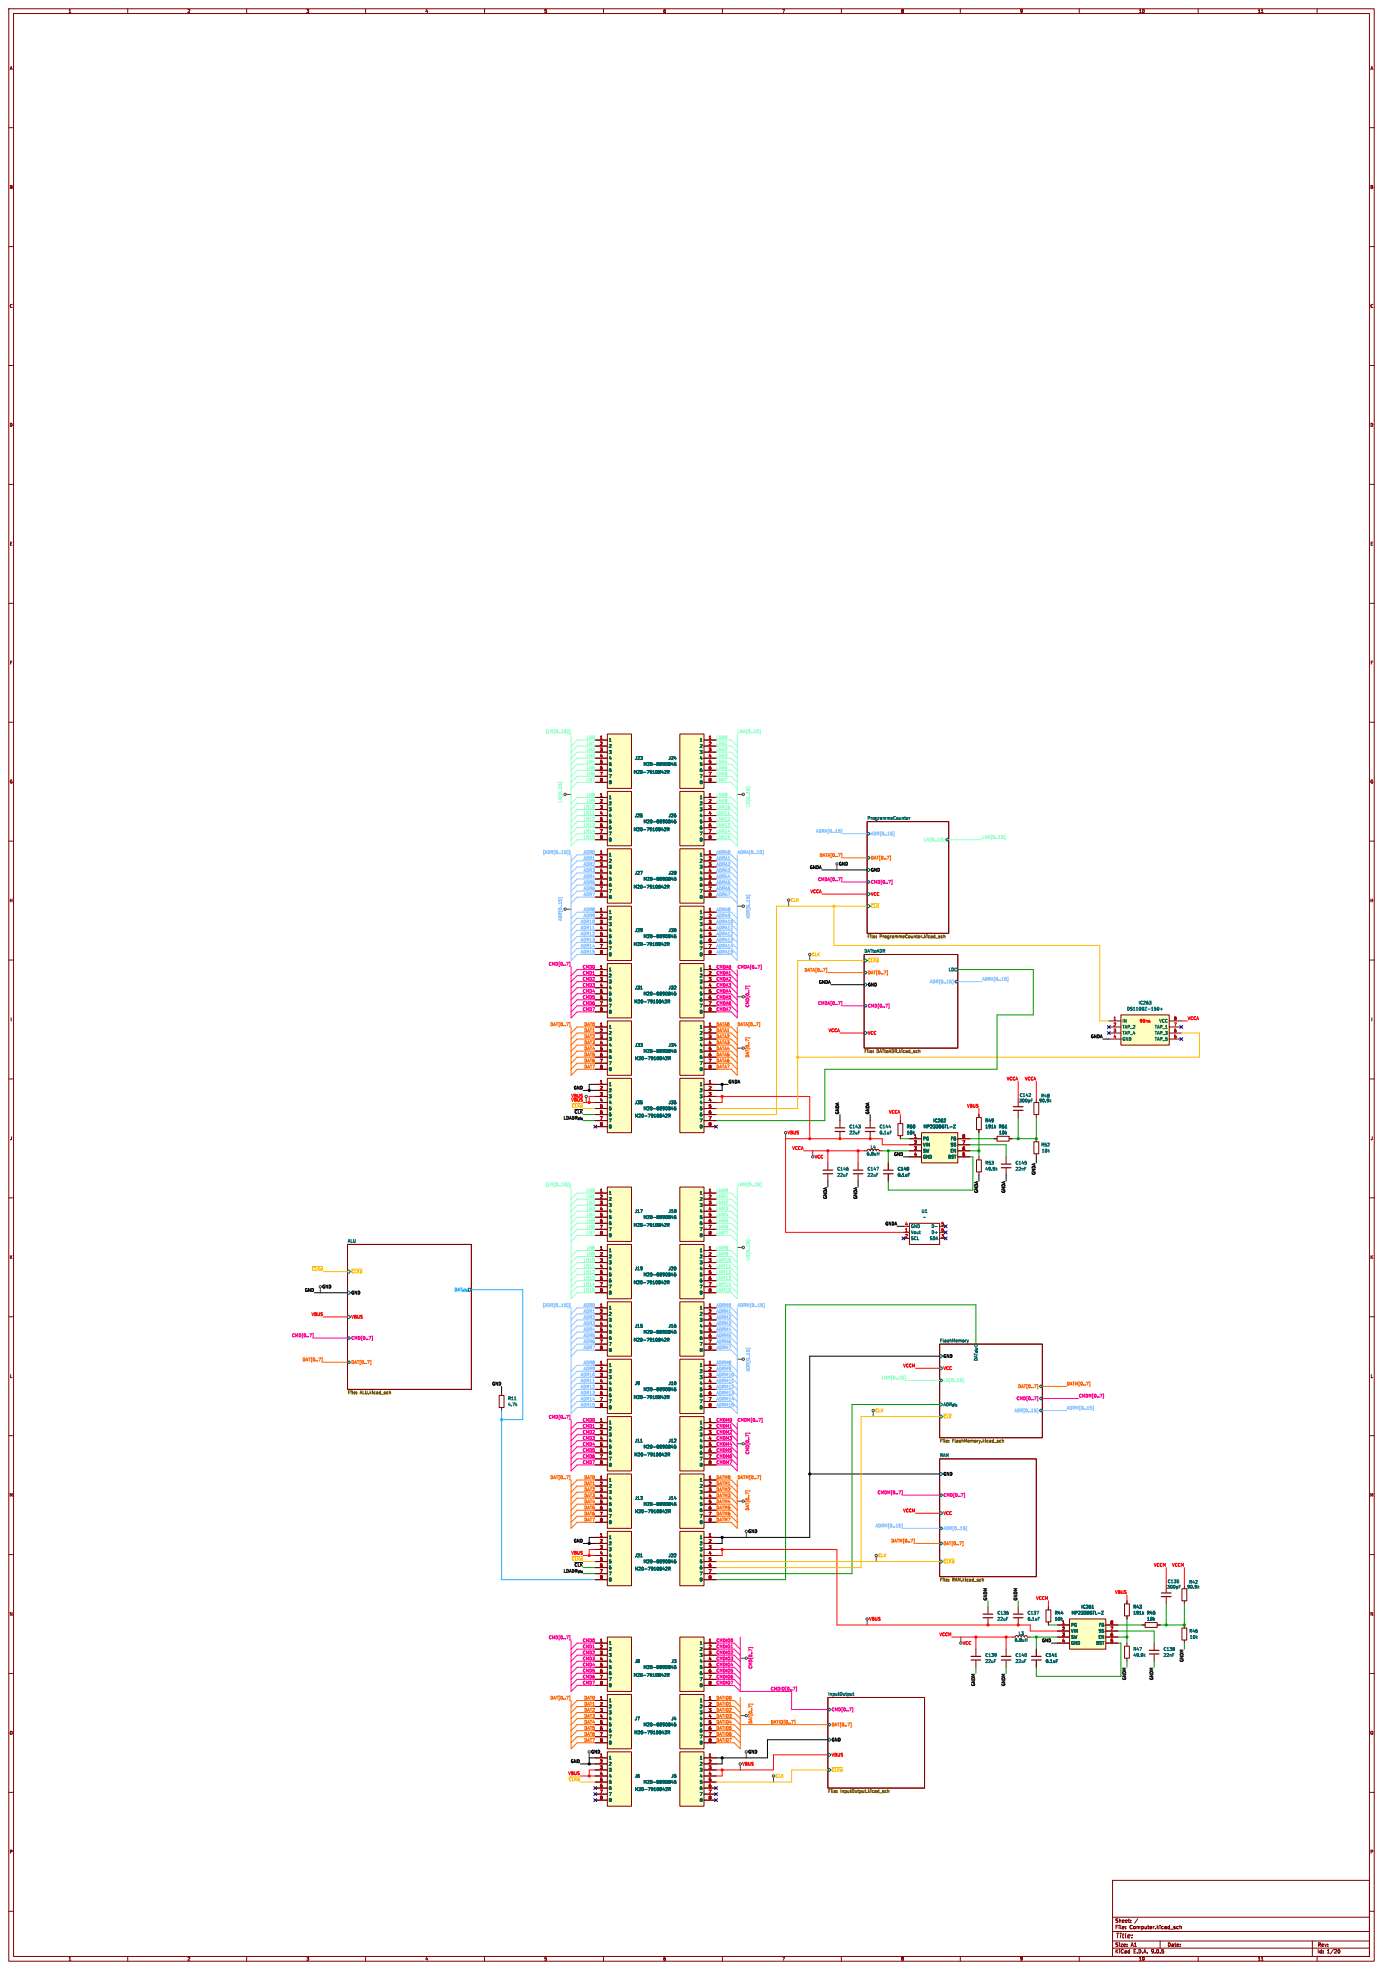
[picture p288: page 1]

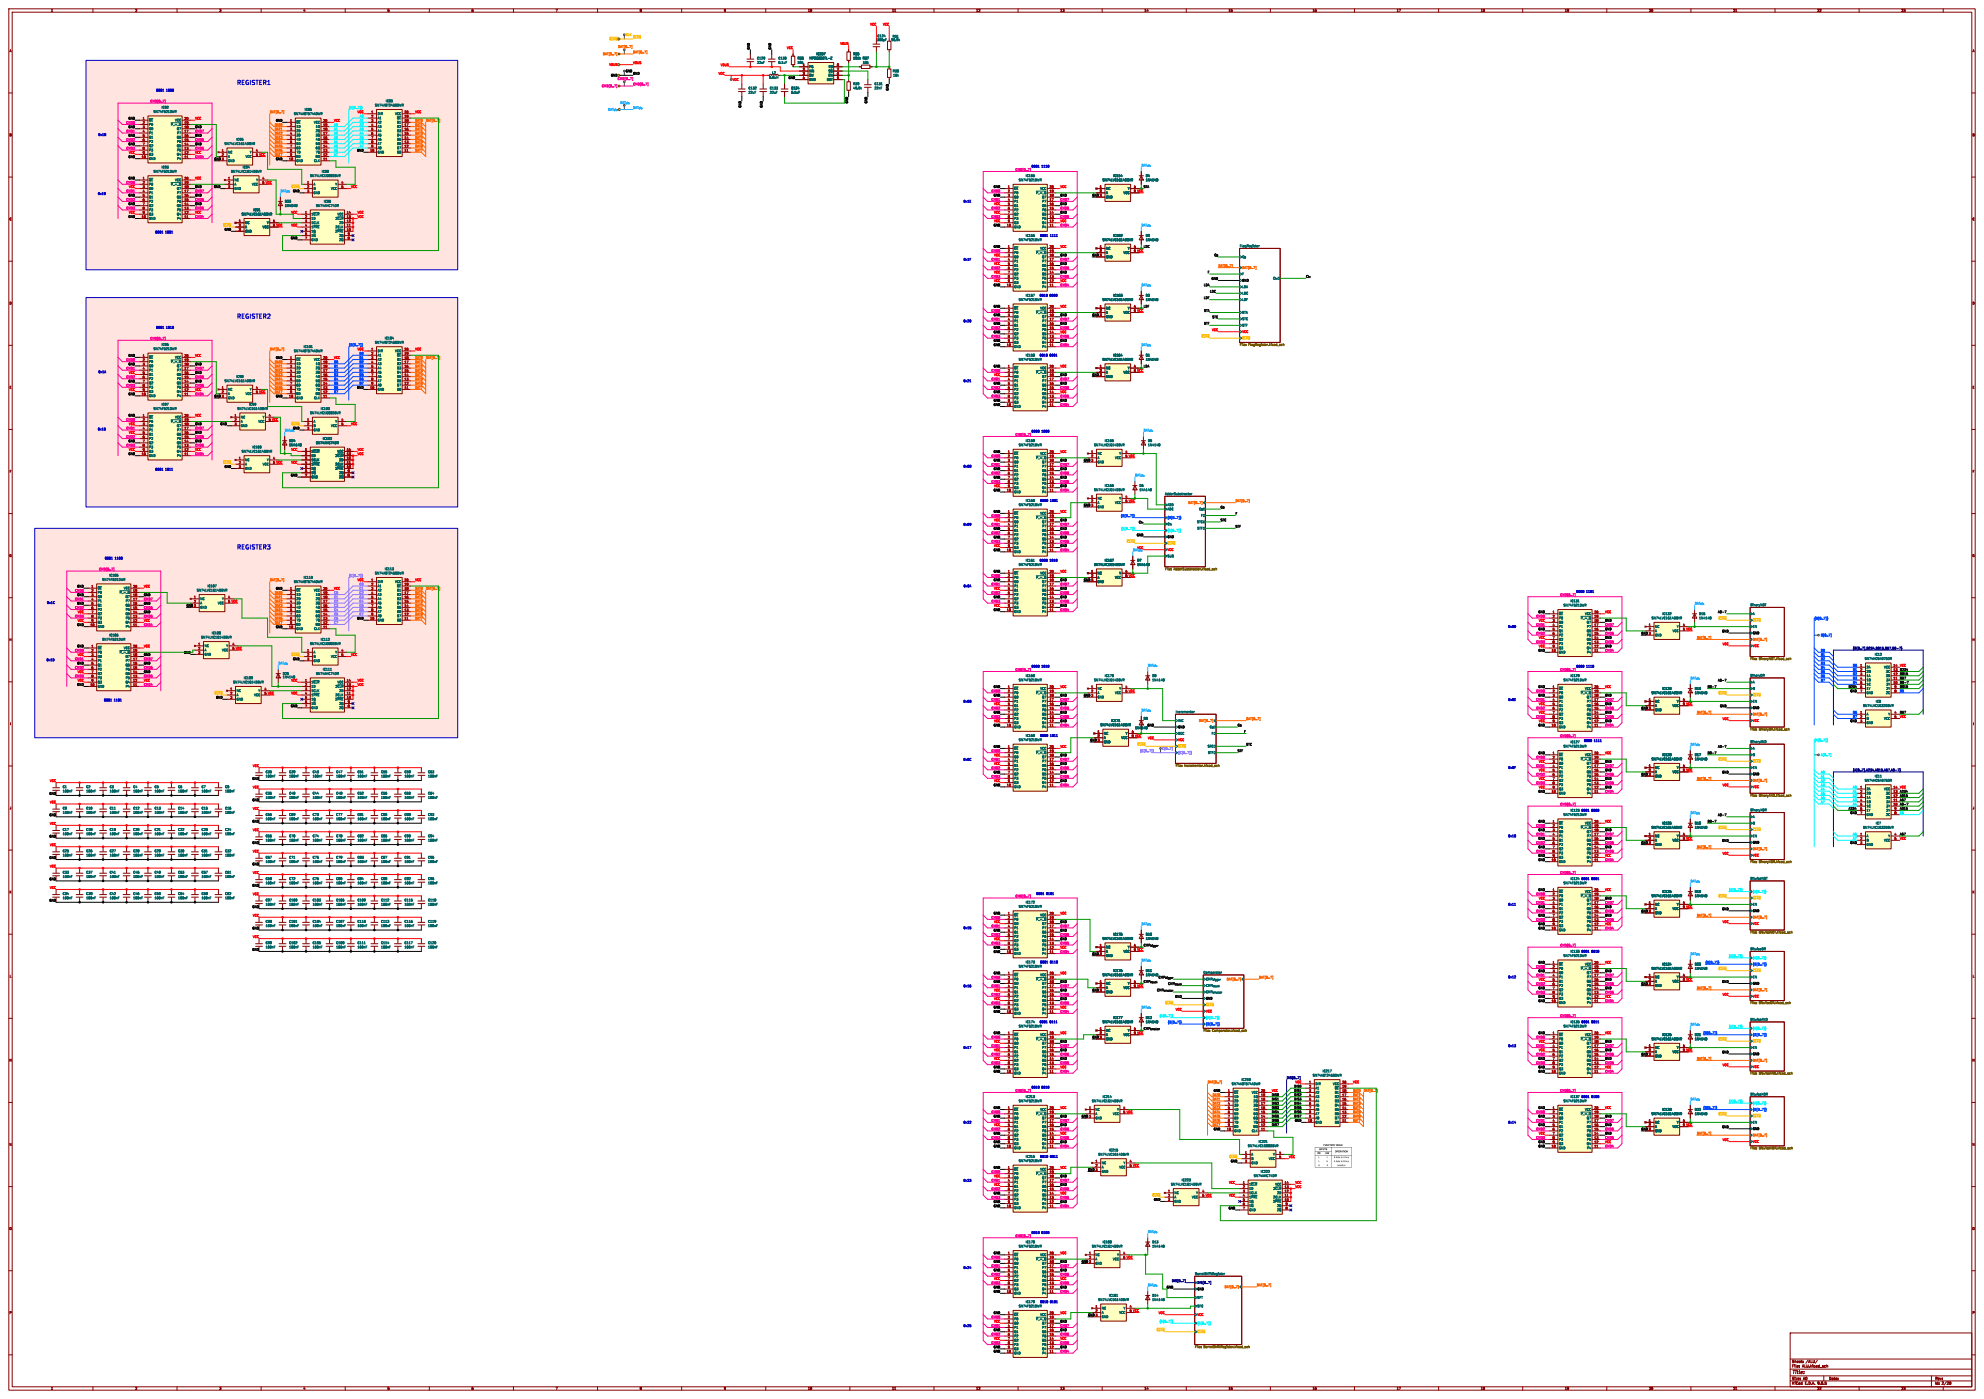
[picture p289: page 2]

~{CLKd} AdderSubstractor File: AdderSubstractor.kicad_sch

INC
CMP_{equal} VCC GND GND

DAT_{dis} GND GND GND

SFT BarrelShiftRegister File: BarrelShiftRegister.kicad_sch

Id: 2/20 Title: File: ALU.kicad_sch Sheet: /ALU/

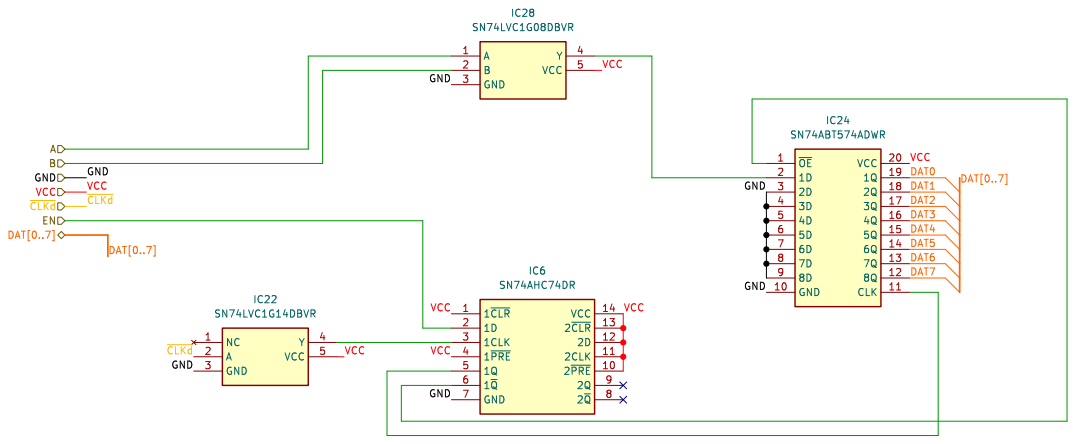
[picture p290: page 3]

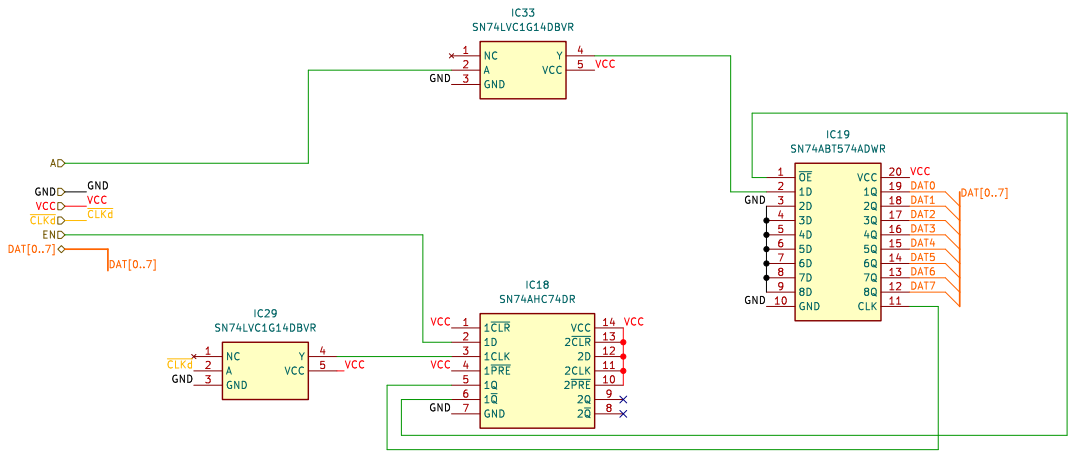
[picture p291: page 4]

Id: 4/20 Title: File: BinaryNOT.kicad_sch Sheet: /ALU/BinaryNOT/

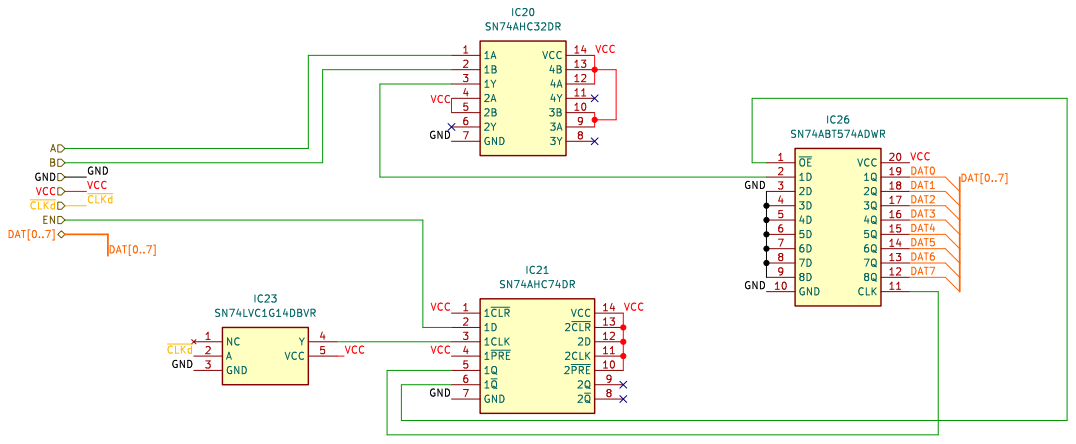
[picture p292: page 5]

Id: 5/20 Title: File: BinaryOR.kicad_sch Sheet: /ALU/BinaryOR/

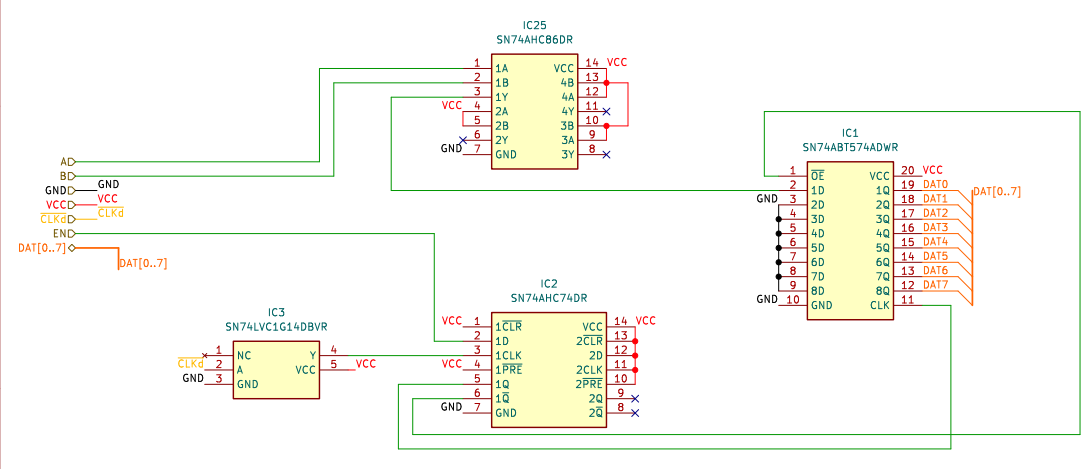
[picture p293: page 6]

Id: 6/20 Title: File: BinaryXOR.kicad_sch Sheet: /ALU/BinaryXOR/

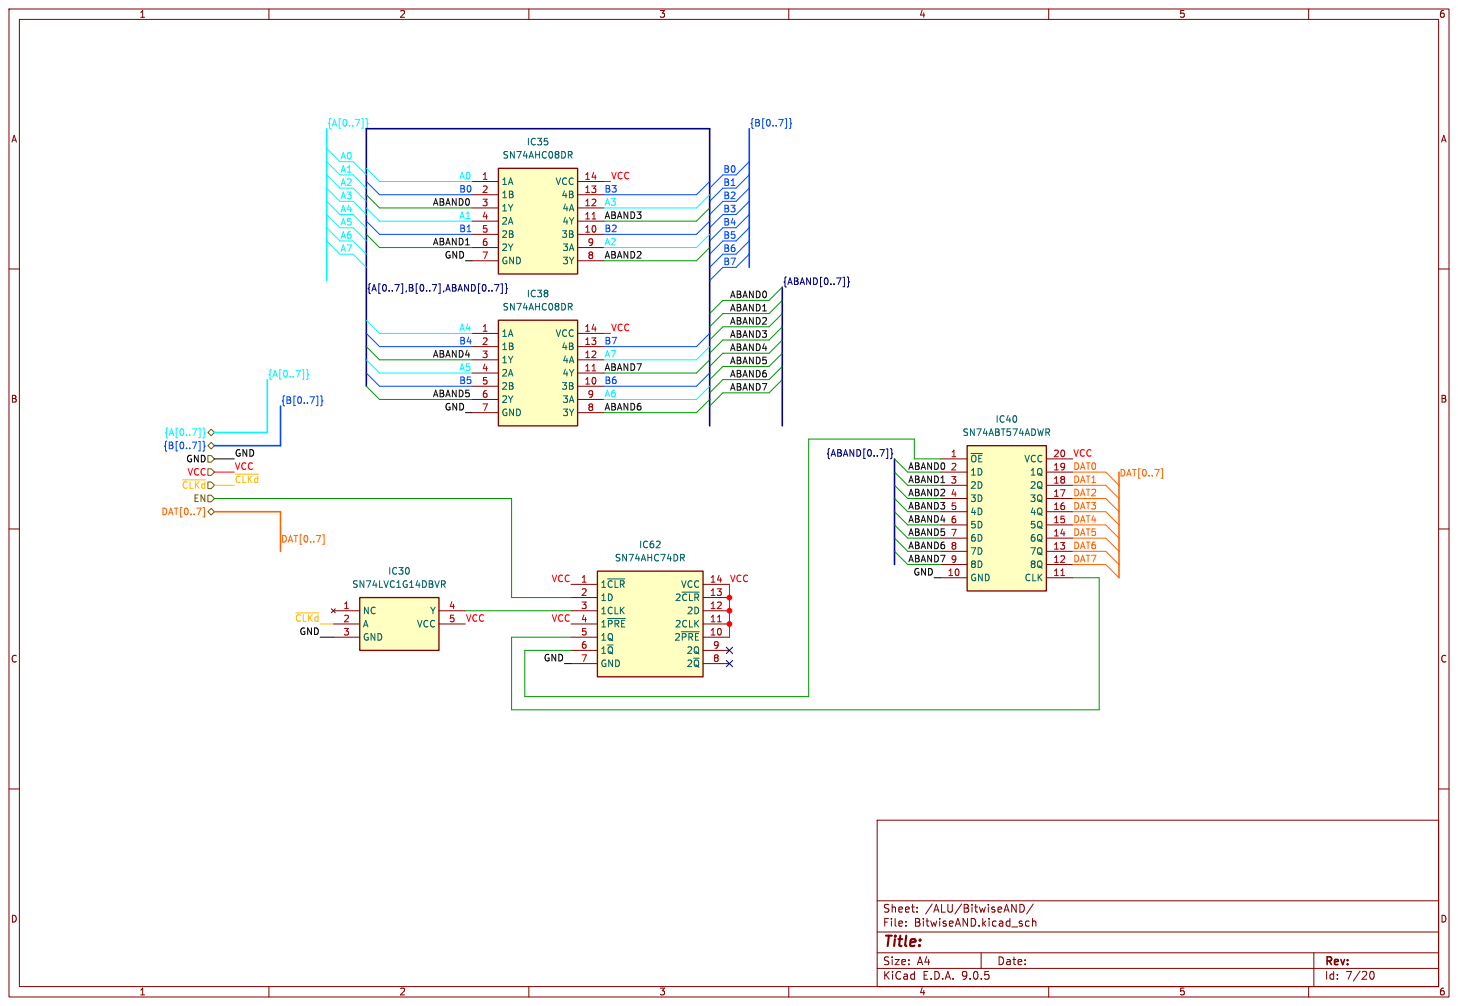
[picture p294: page 7]

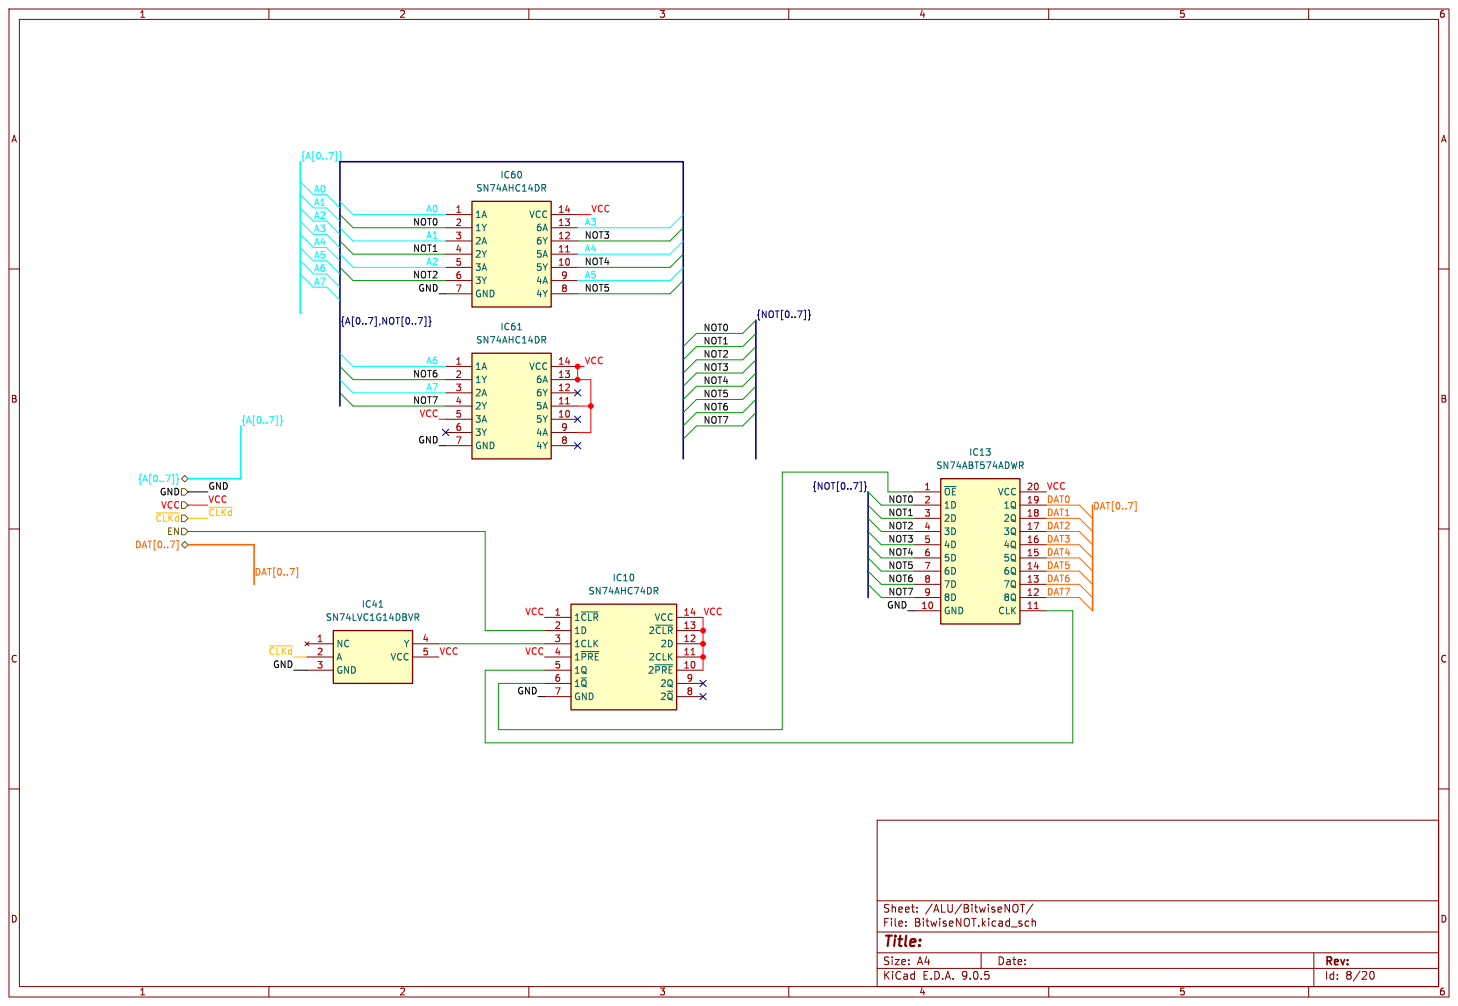
[picture p295: page 8]

Id: 8/20 Title: File: BitwiseNOT.kicad_sch Sheet: /ALU/BitwiseNOT/

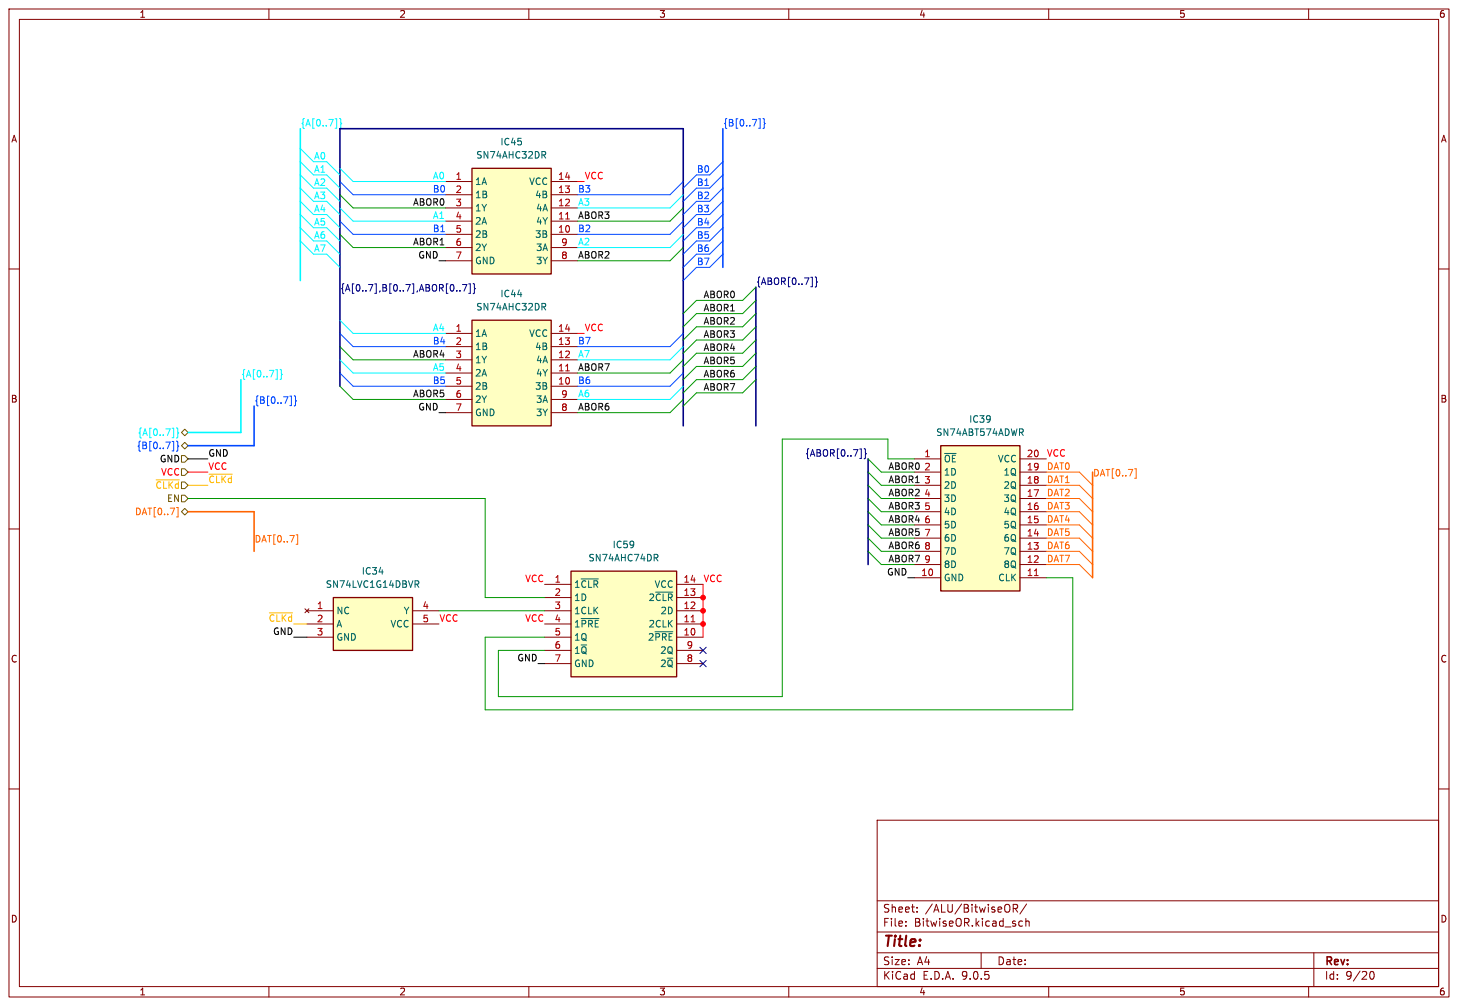
[picture p296: page 9]

Id: 9/20 Title: File: BitwiseOR.kicad_sch Sheet: /ALU/BitwiseOR/

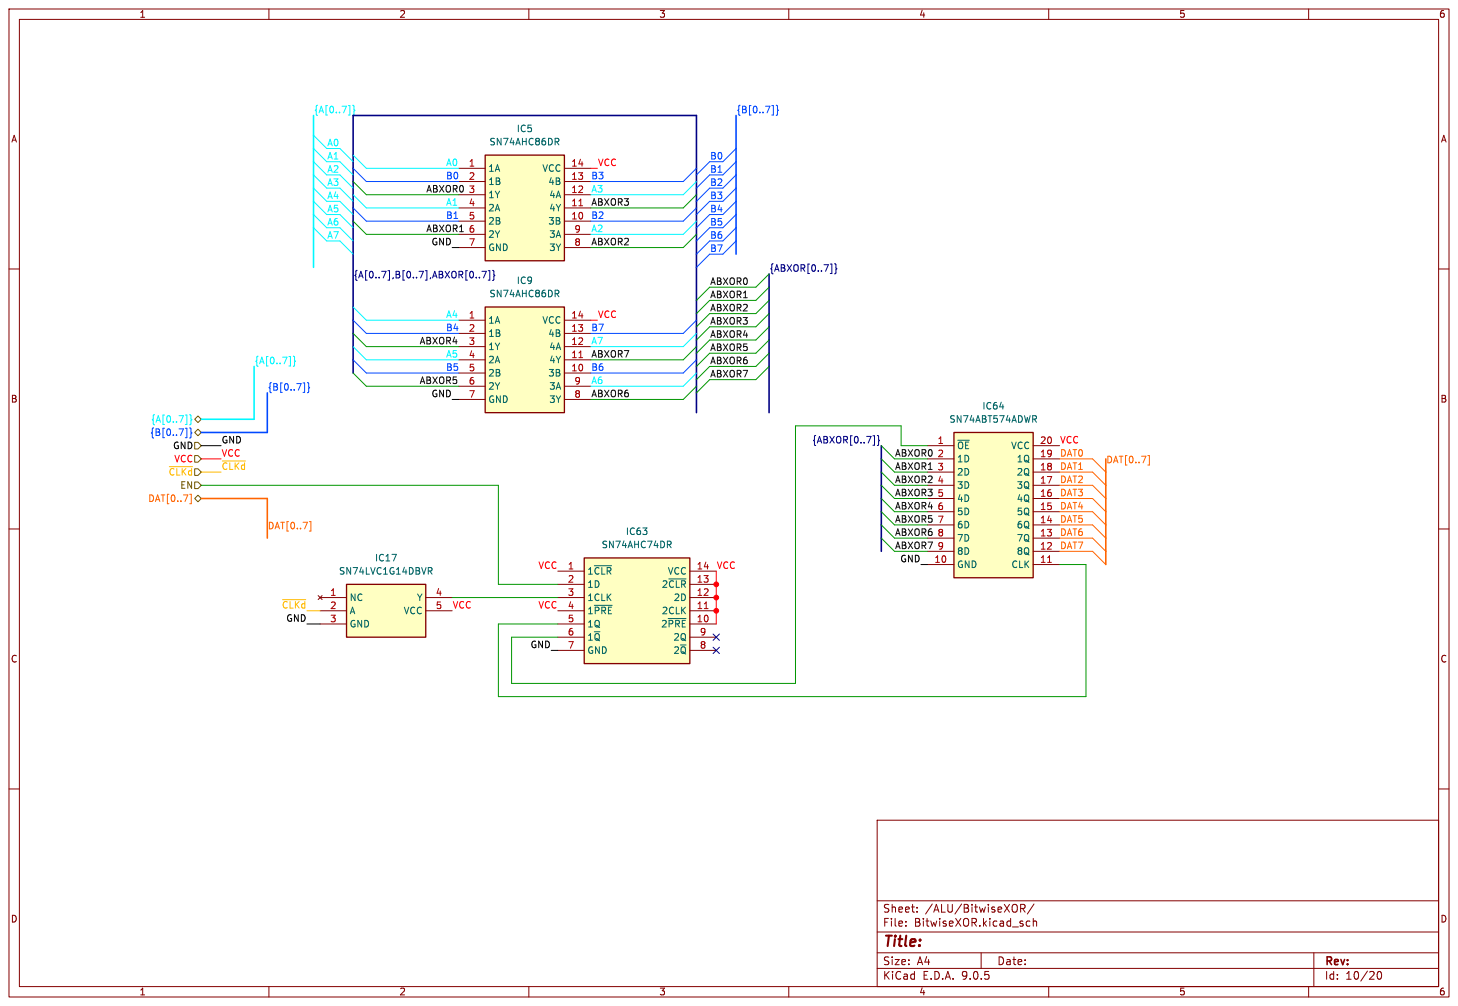
[picture p297: page 10]

Id: 10/20 Title: File: BitwiseXOR.kicad_sch Sheet: /ALU/BitwiseXOR/

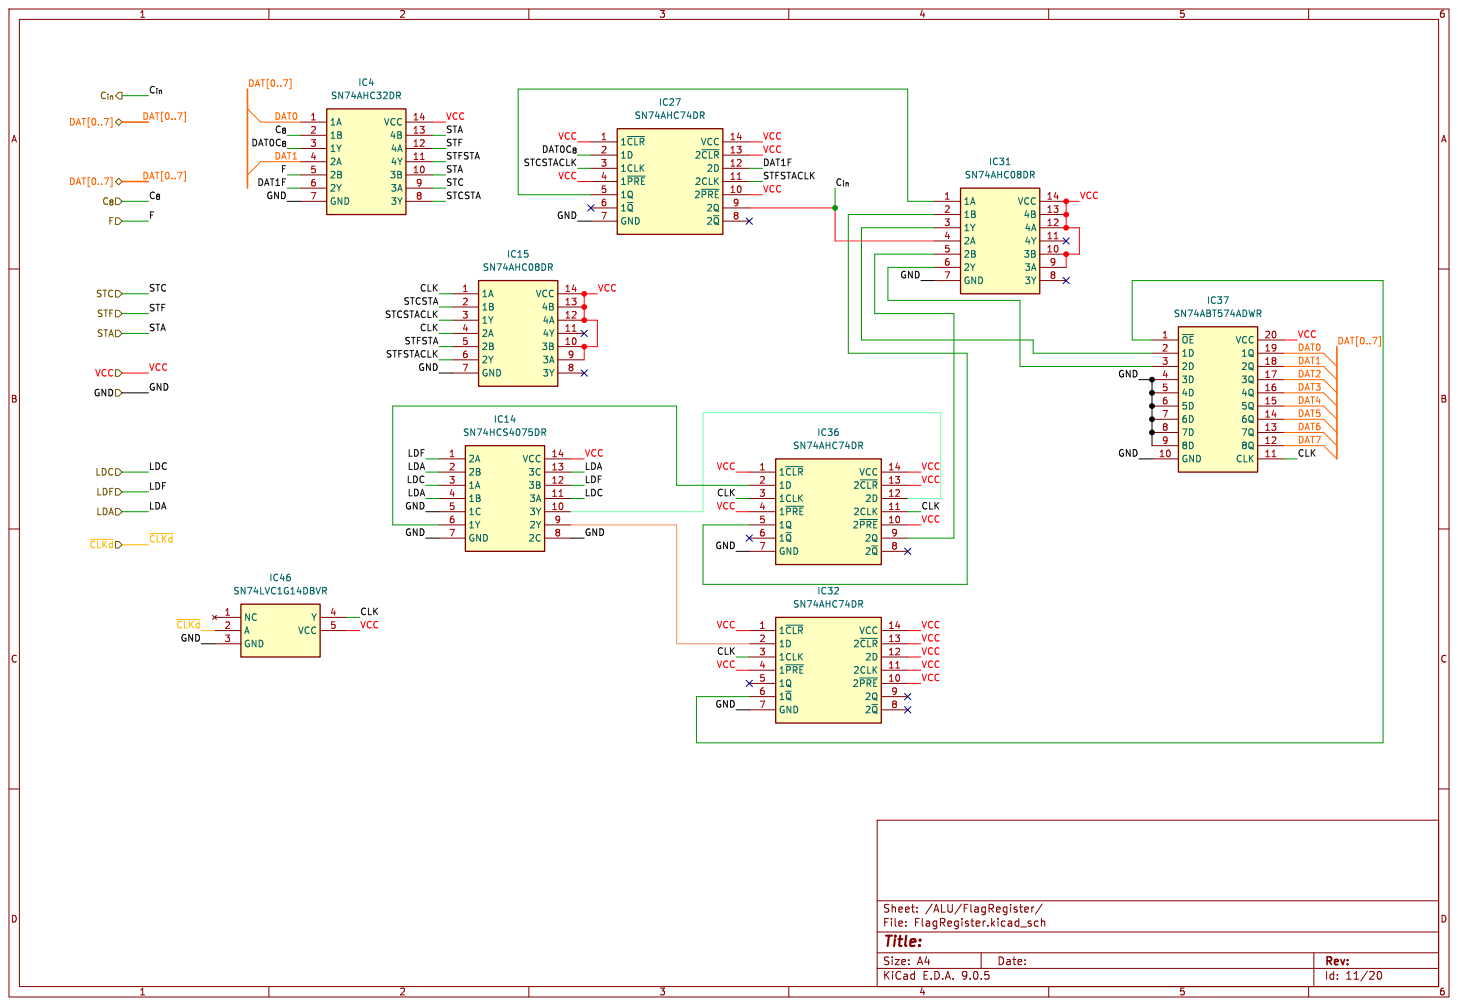
[picture p298: page 11]

DAT1FDAT1 C_{in}
LDF STA C_{in} STFC_{8} LDC GND
DAT[0..7] LDA

Id: 11/20 Title: File: FlagRegister.kicad_sch Sheet: /ALU/FlagRegister/

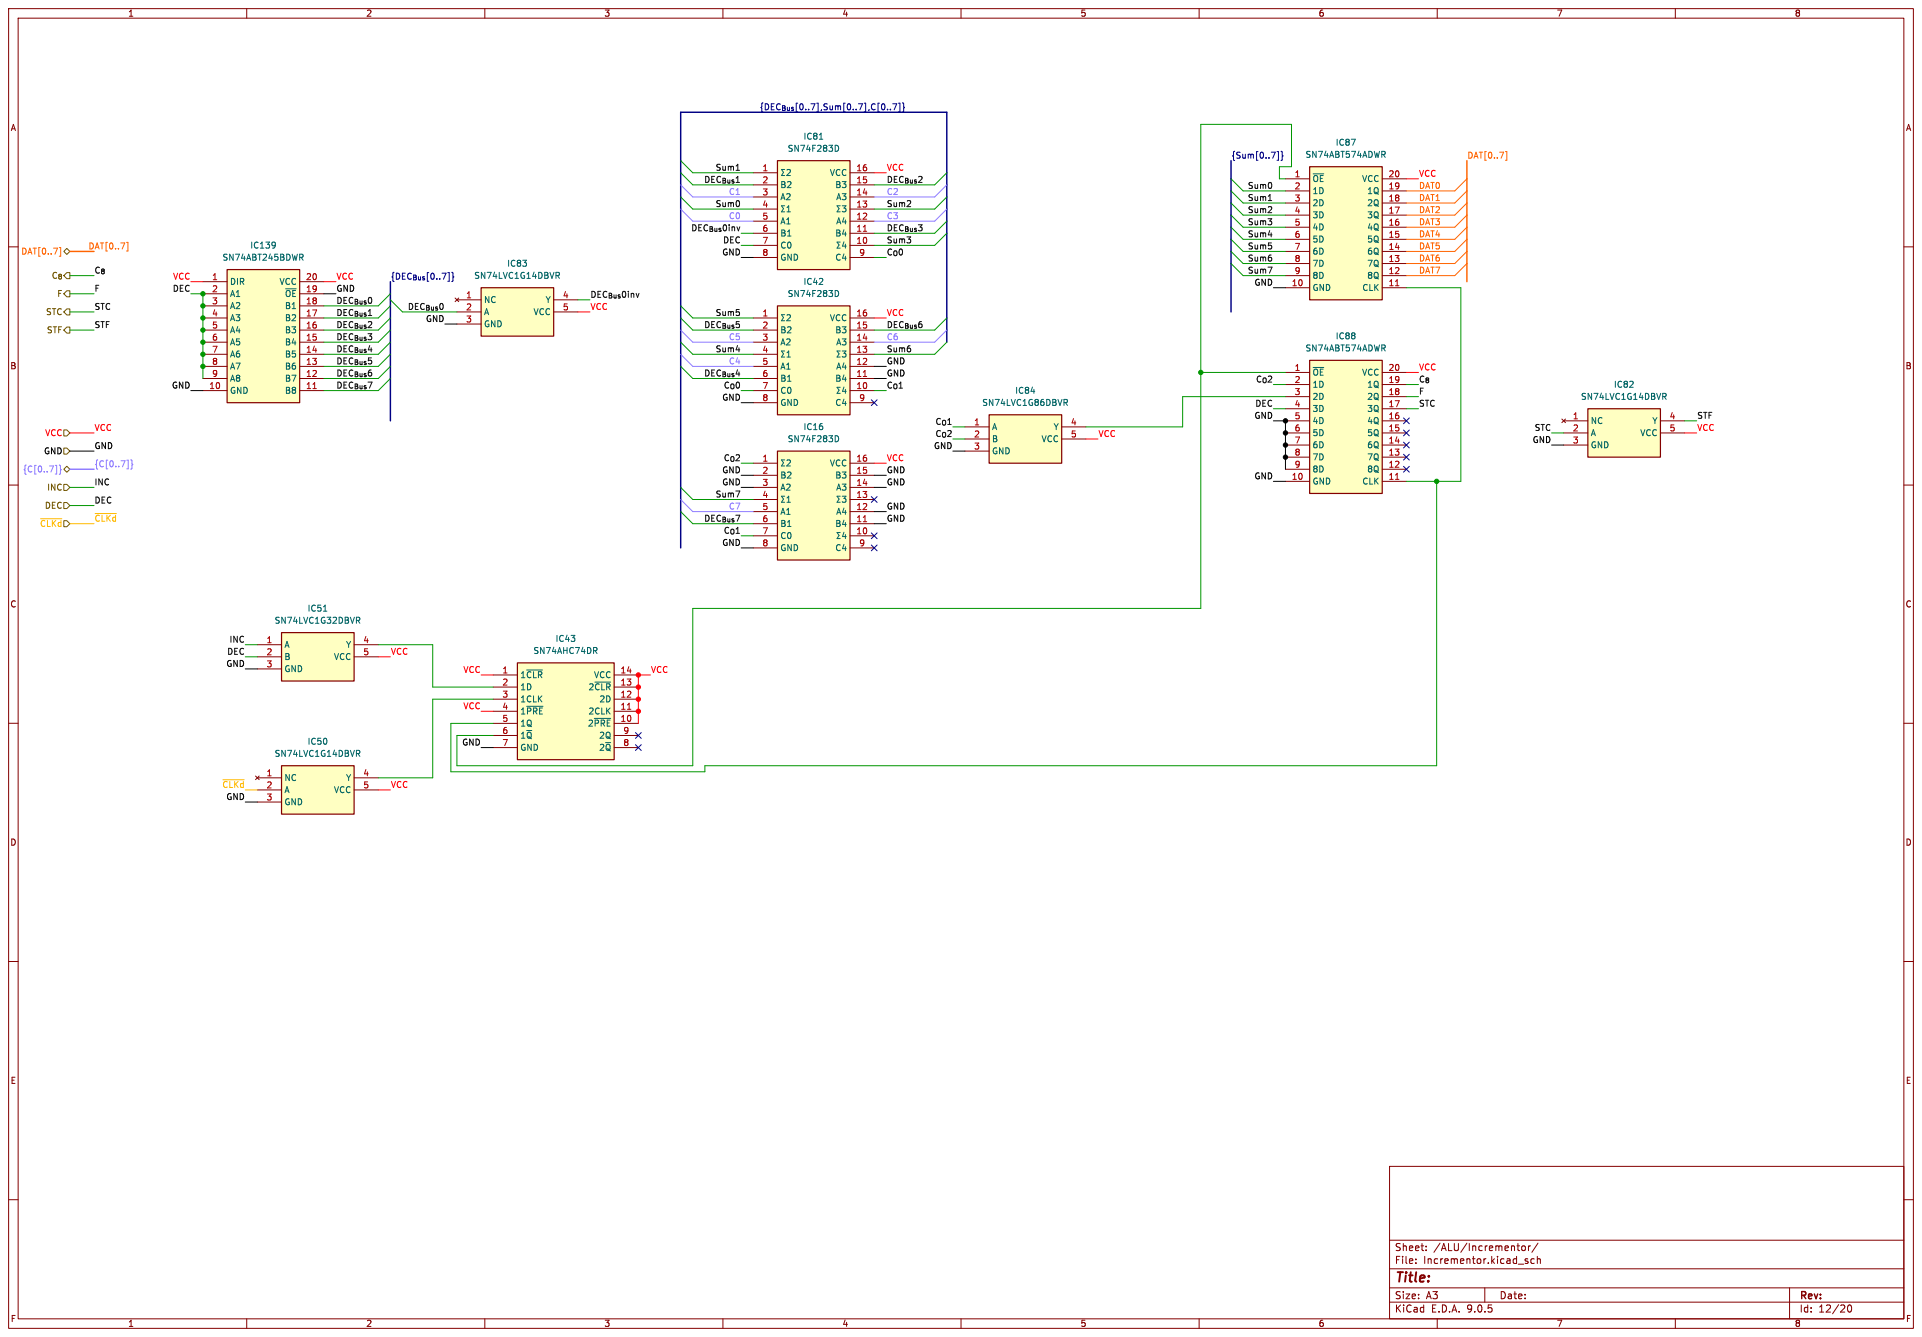
[picture p299: page 12]

DEC_{Bus}0inv VCC DEC_{Bus}1 VCC

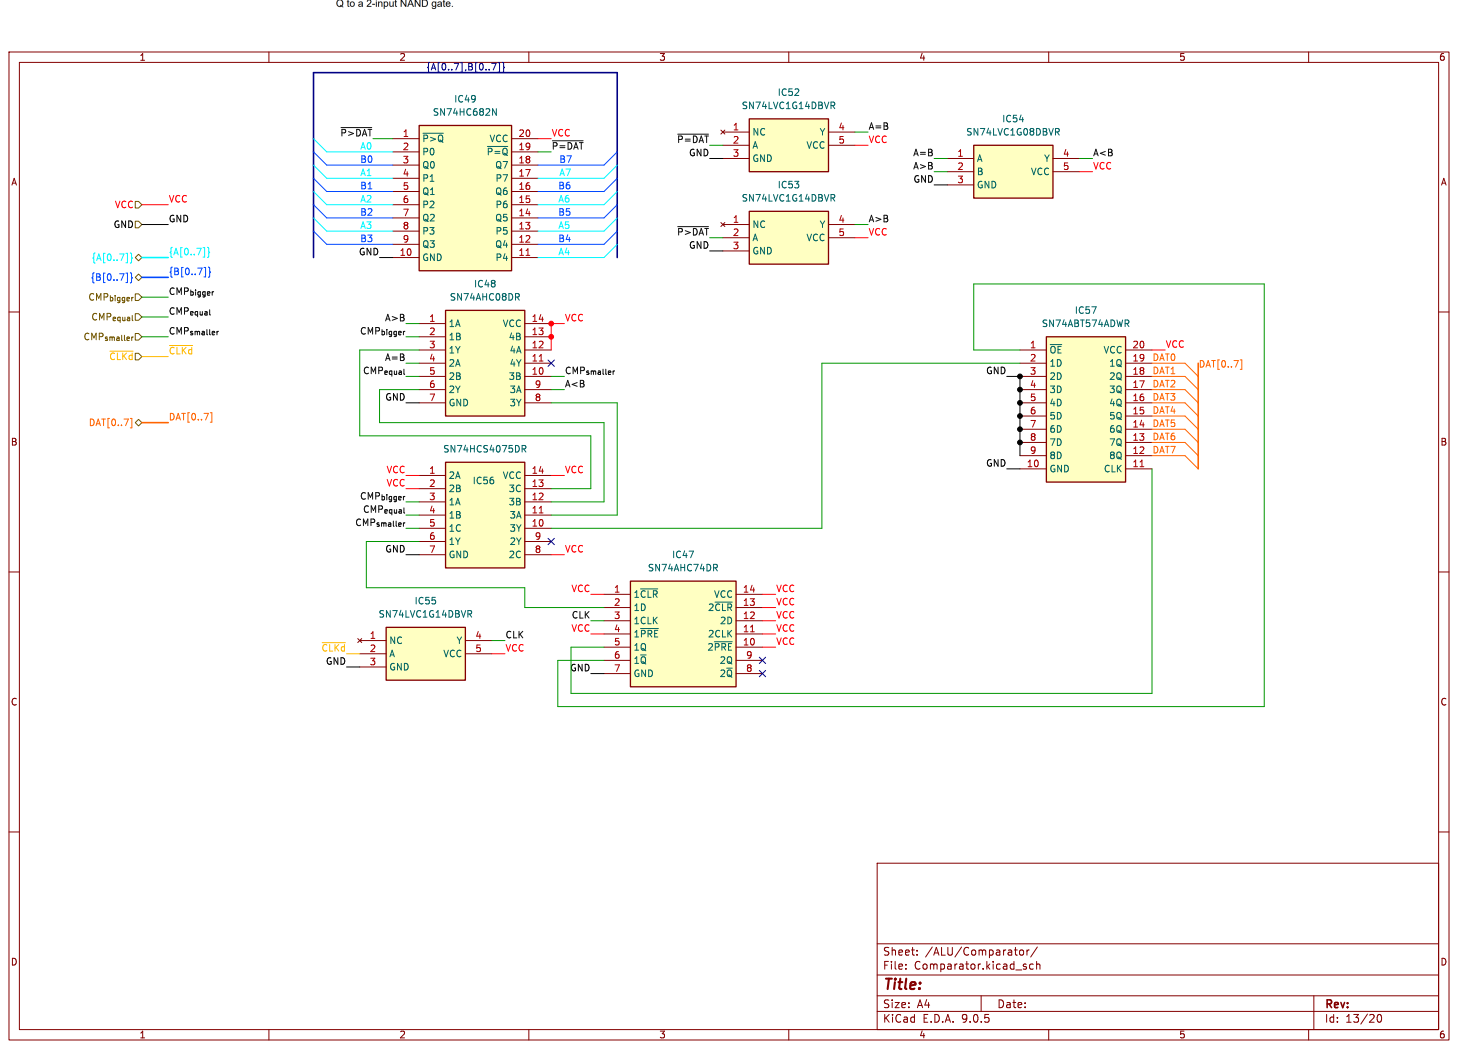
[picture p300: page 13]

Id: 13/20 Title: File: Comparator.kicad_sch Sheet: /ALU/Comparator/

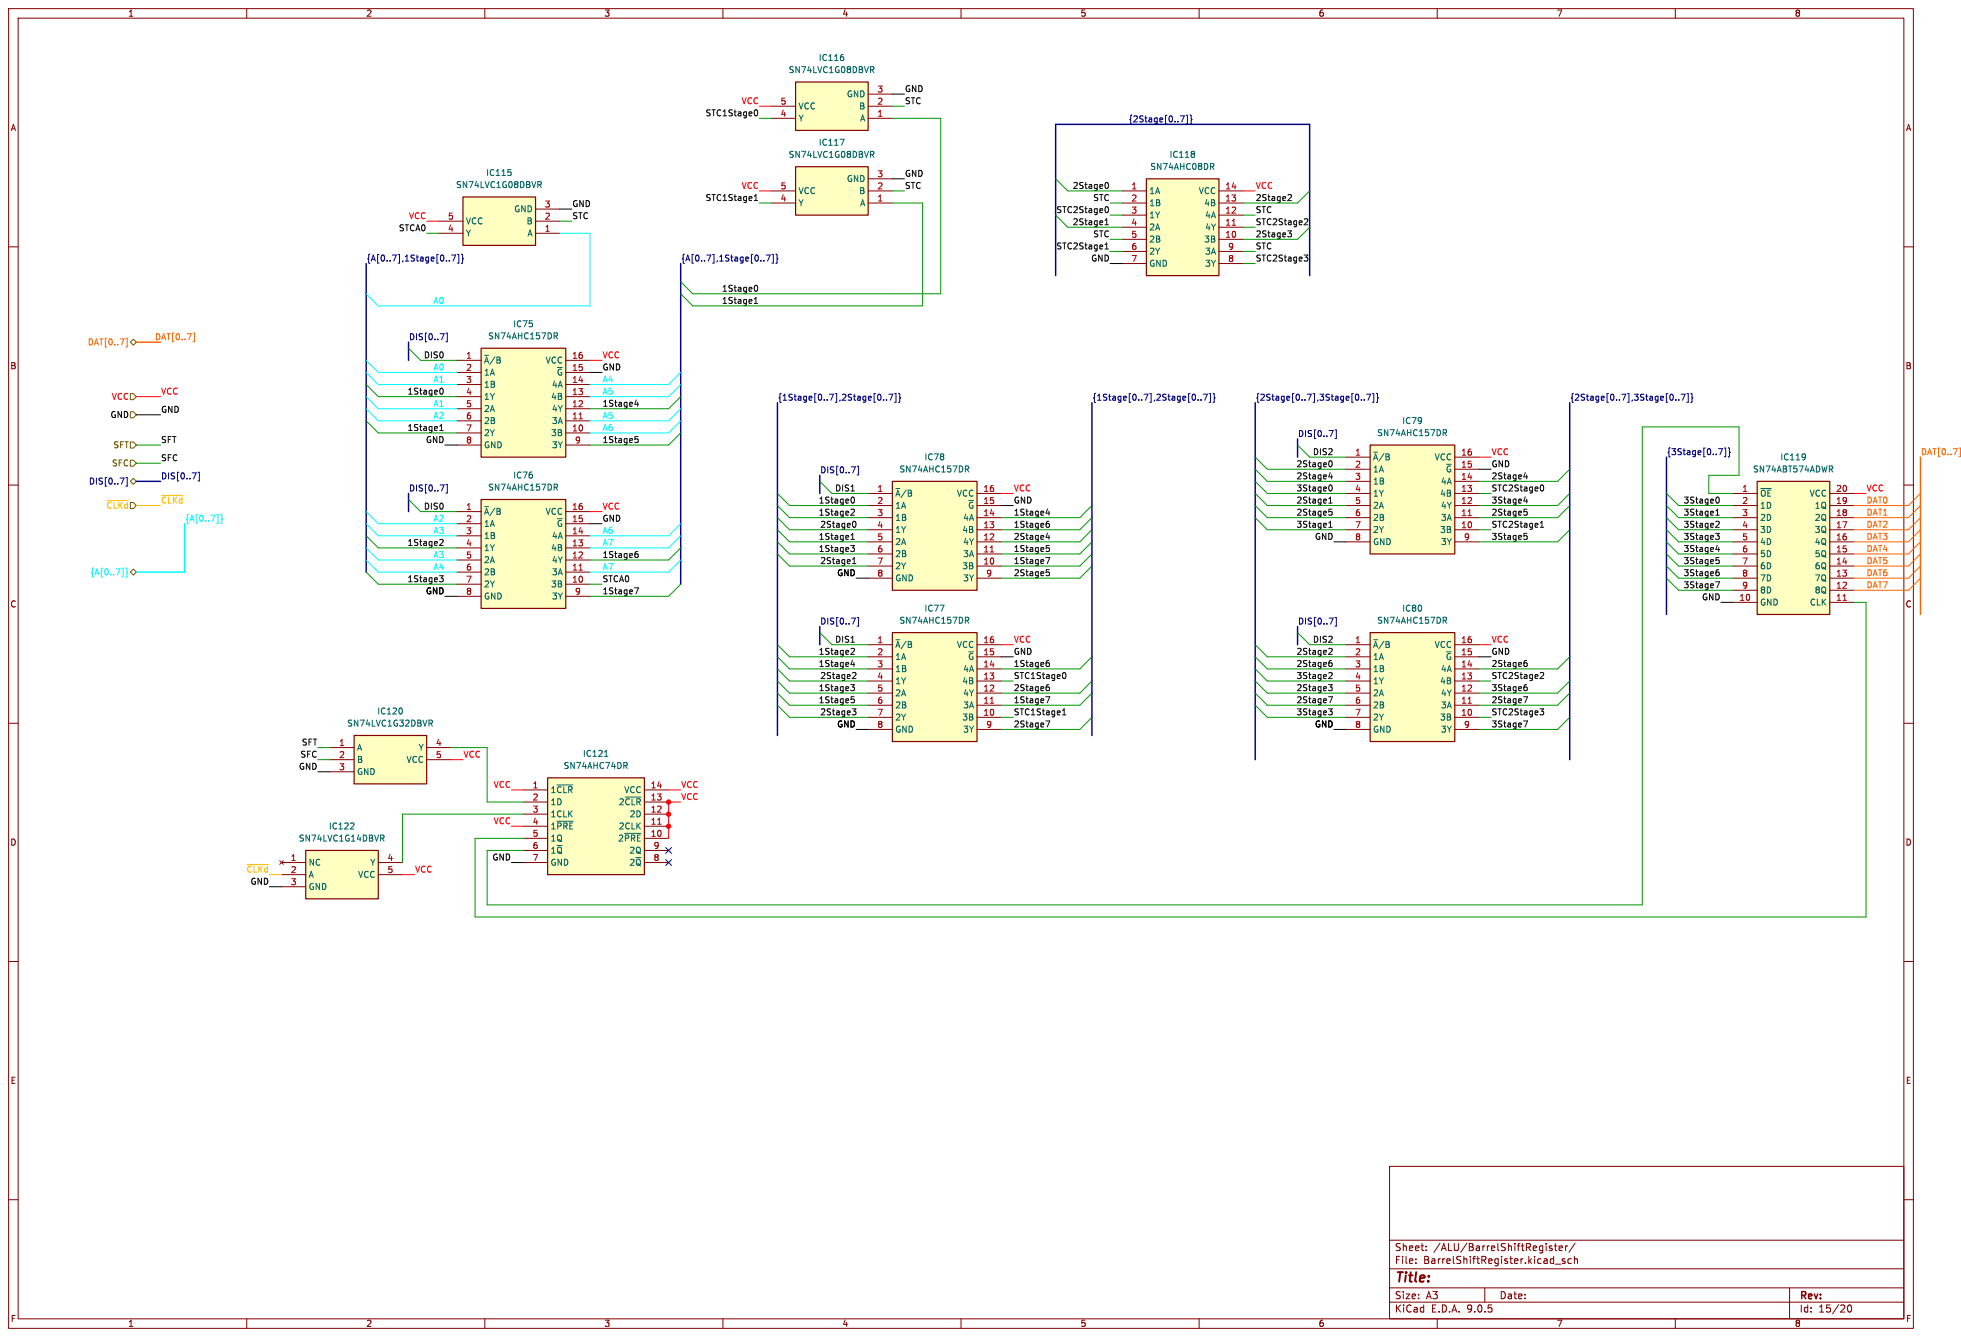
[picture p301: page 14]

DAT[0..7] VCC
DIS[0..7] SFT DAT[0..7] SFC
{A[0..7]} GND

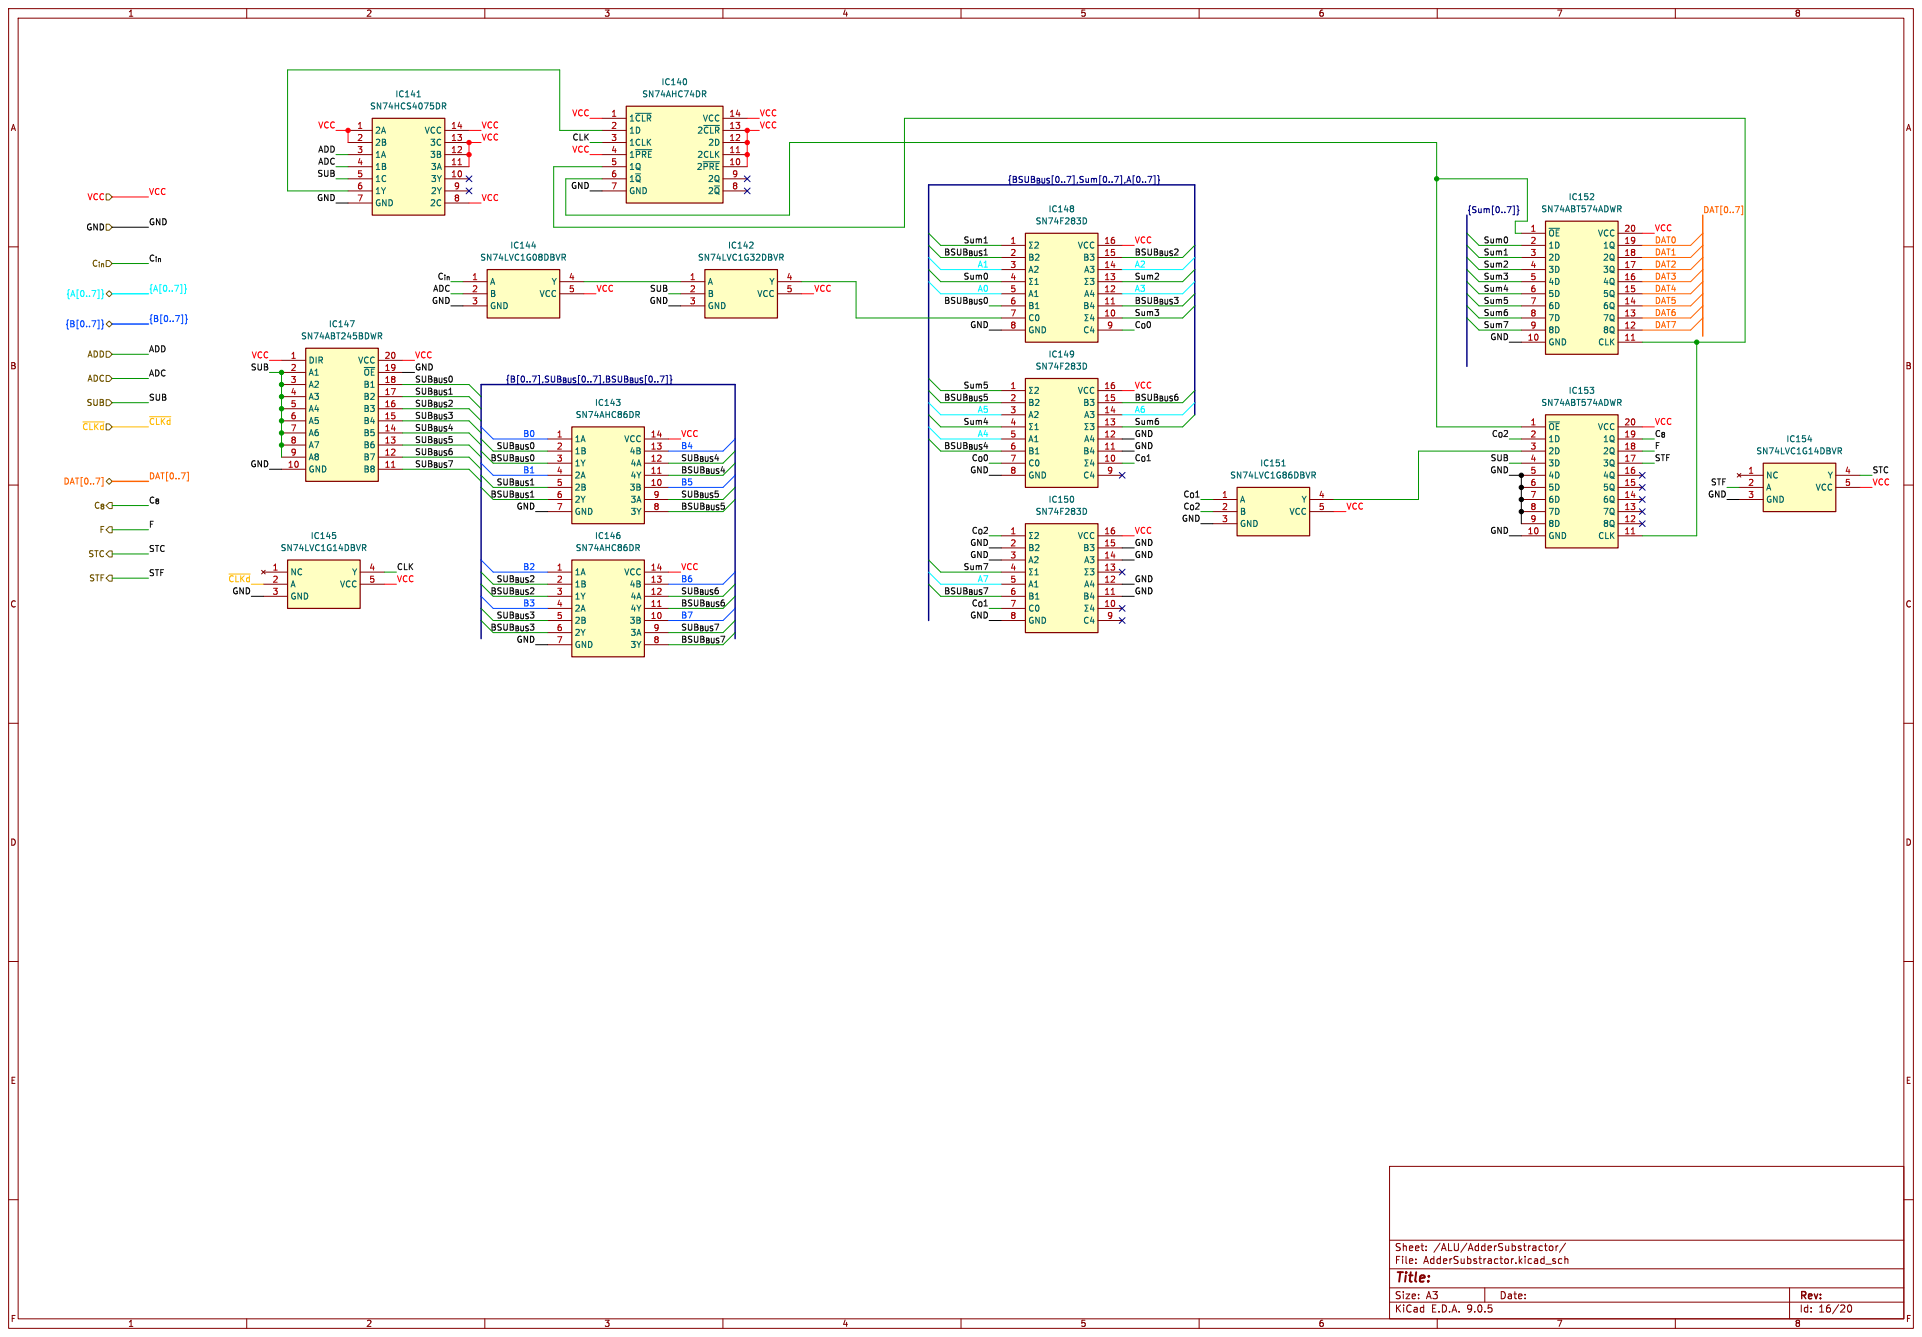
[picture p302: page 15]

Id: 16/20 Title: File: AdderSubstractor.kicad_sch Sheet: /ALU/AdderSubstractor/

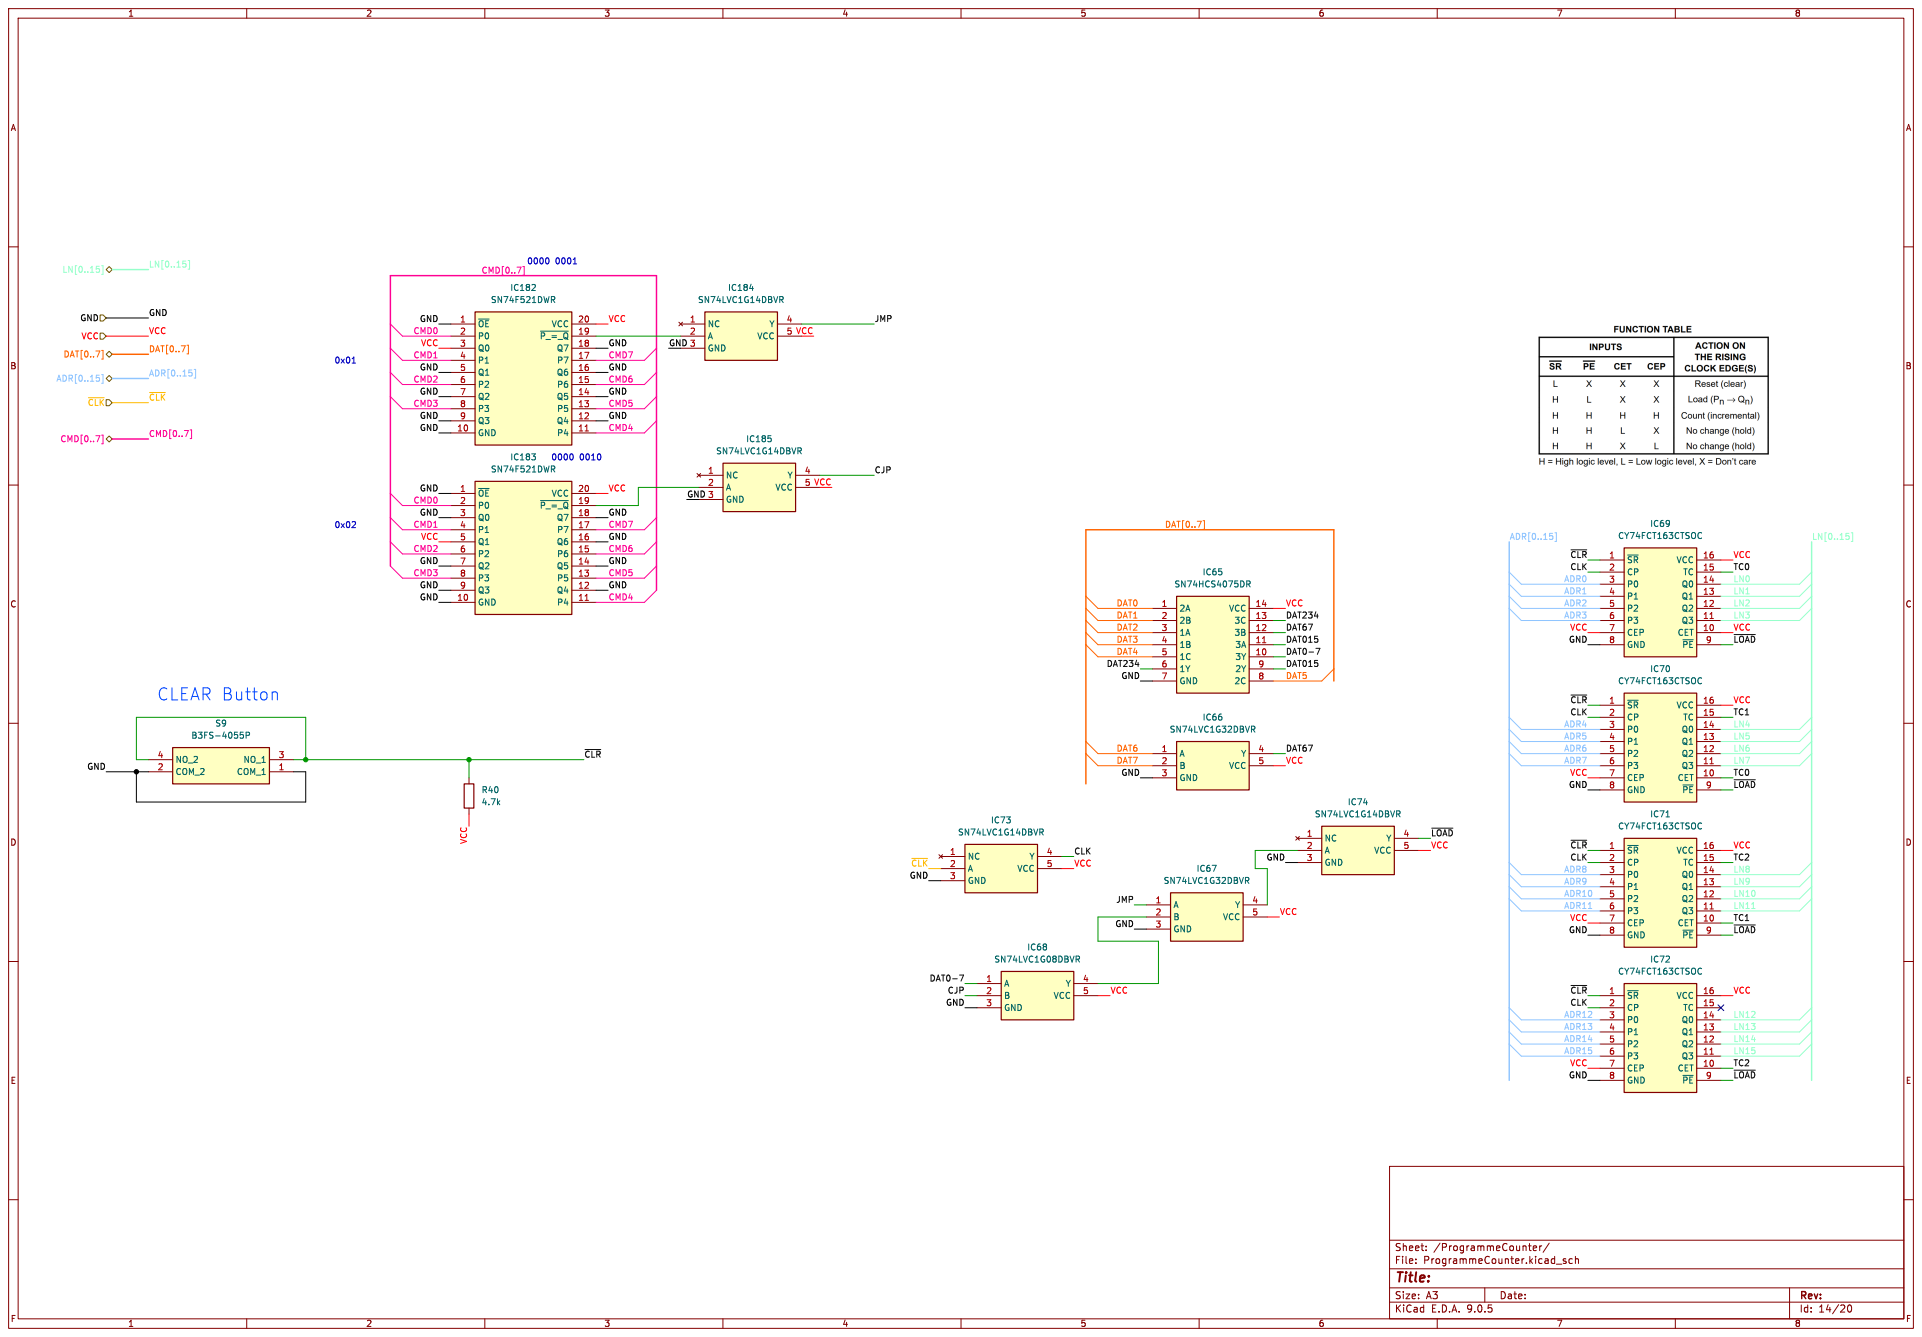
[picture p303: page 16]

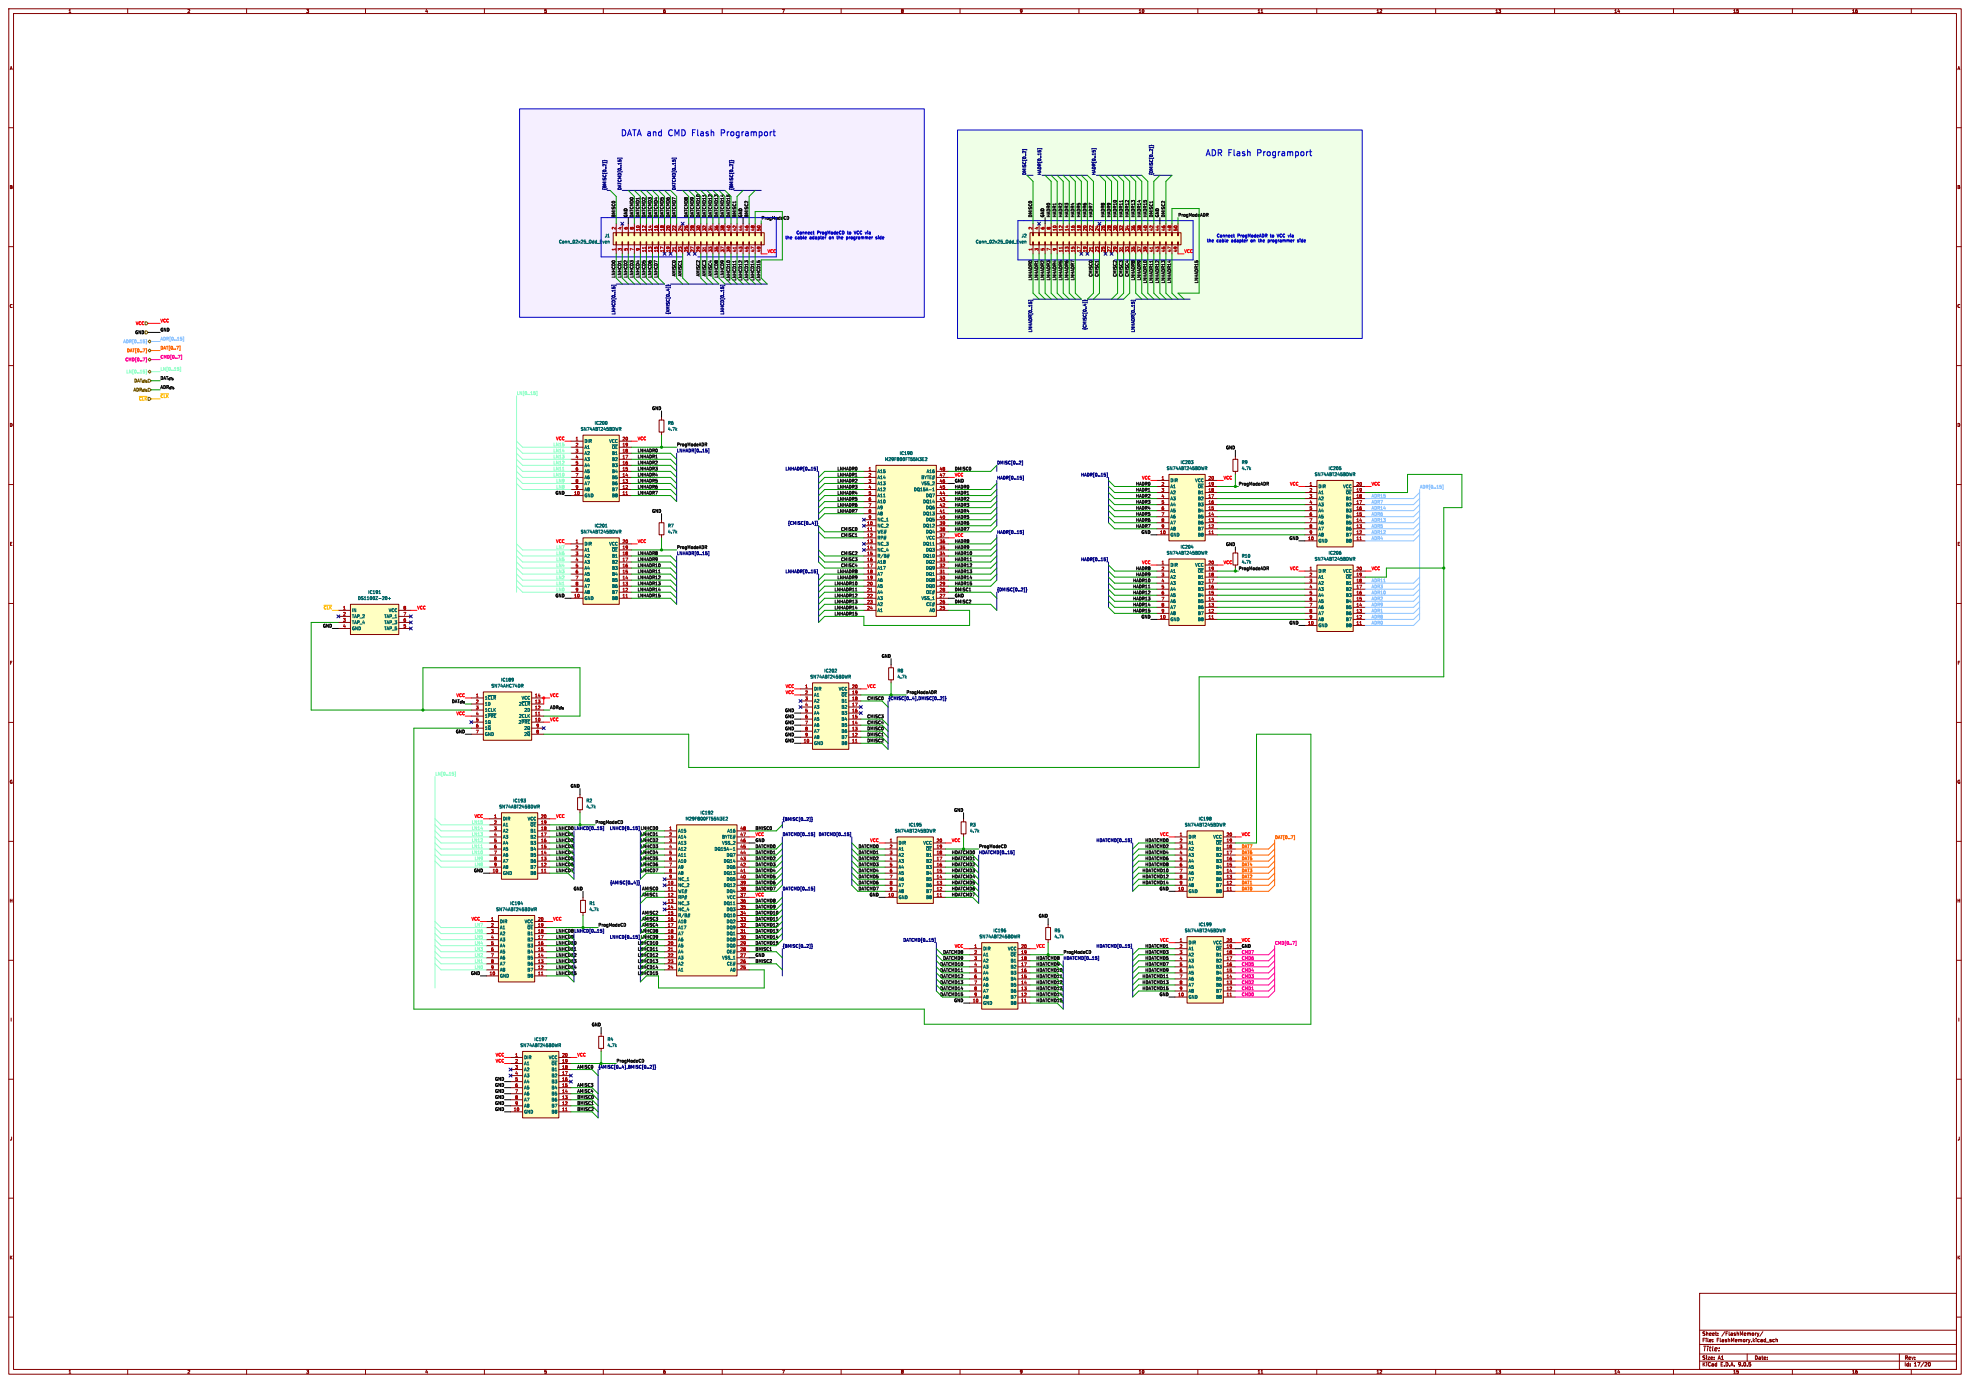
[picture p304: page 17]

DMISC0 VCC GND GND GND GND

Id: 17/20 Title: File: FlashMemory.kicad_sch Sheet: /FlashMemory/

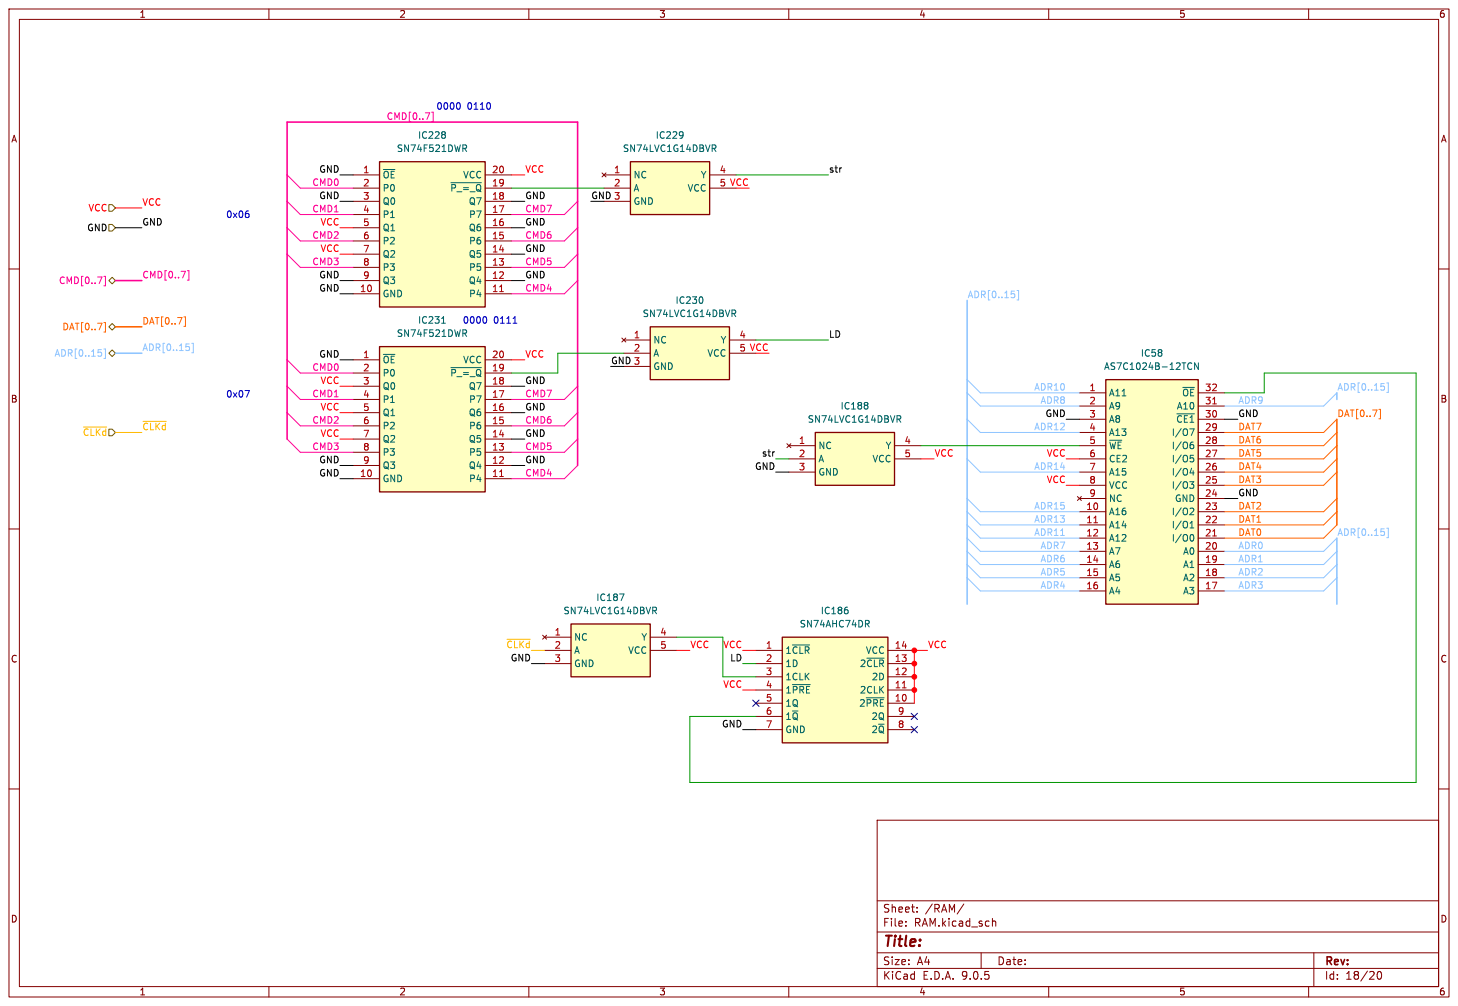
[picture p305: page 18]

Id: 18/20 Title: File: RAM.kicad_sch Sheet: /RAM/

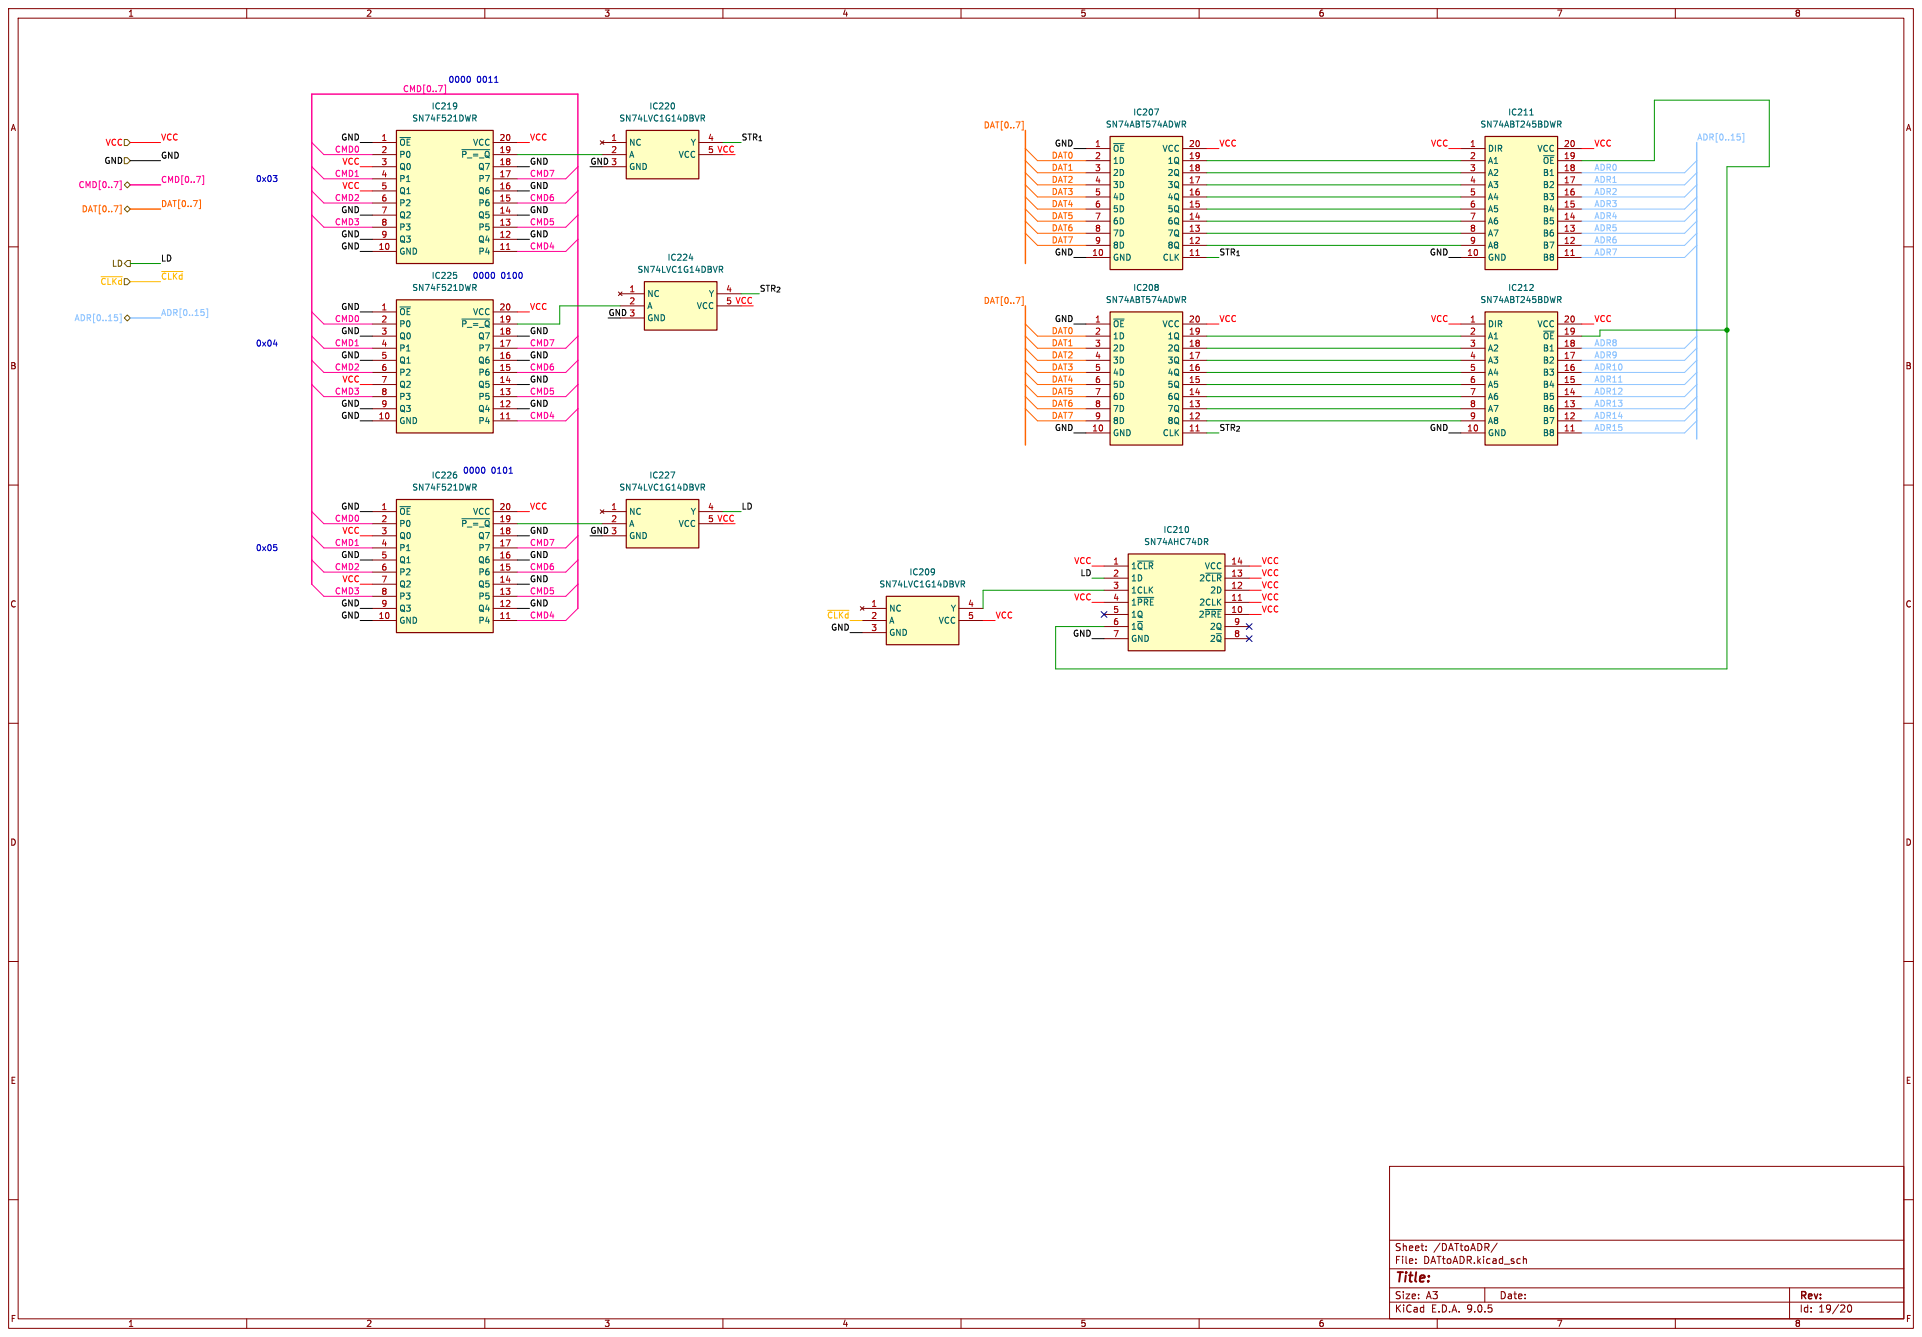
[picture p306: page 19]

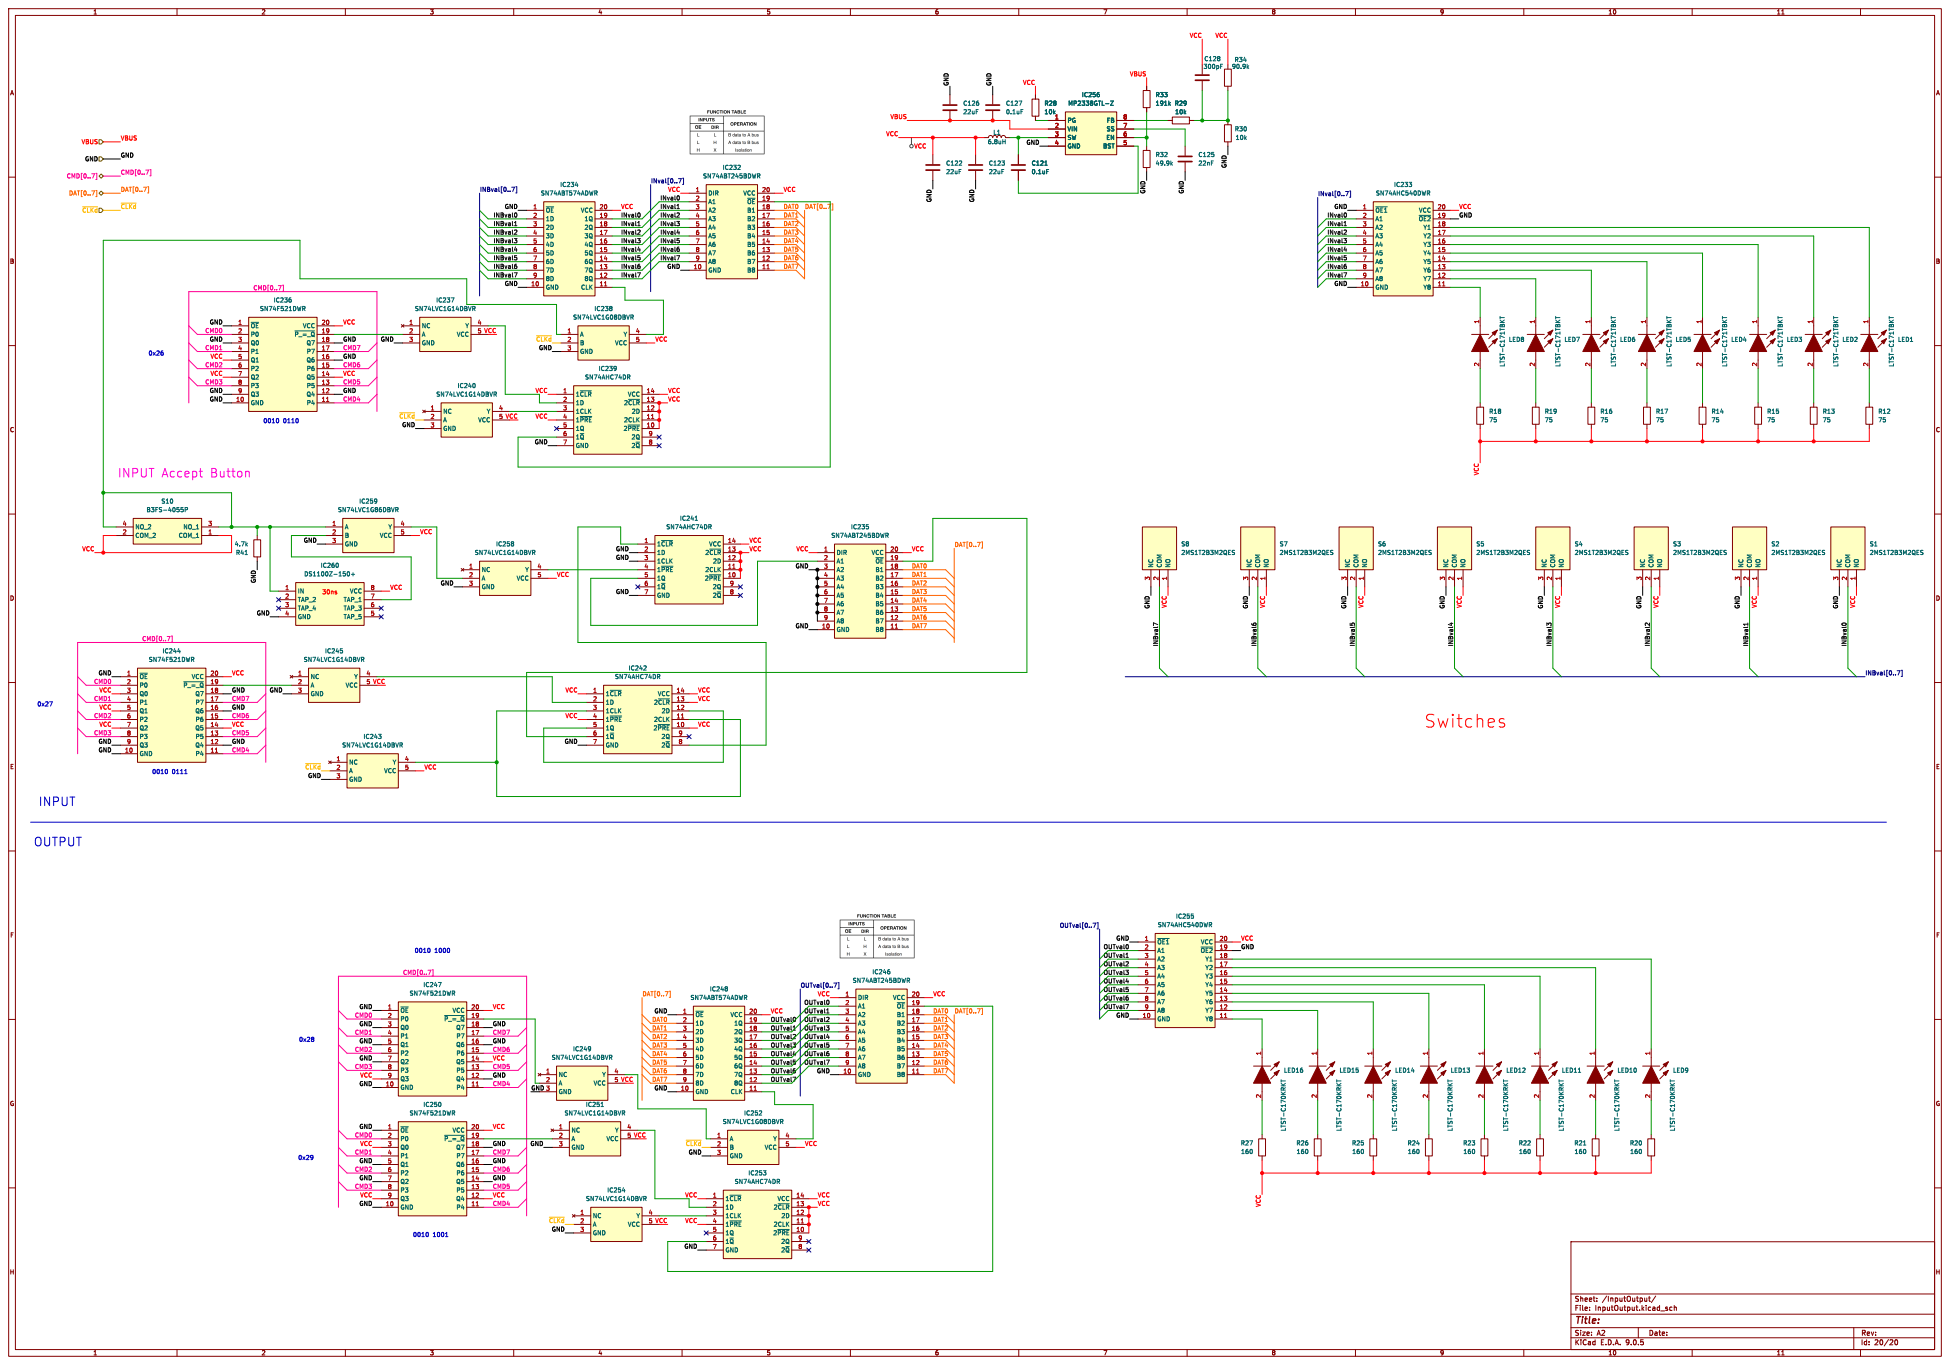
[picture p307: page 20]

CMD[0..7] VBUS DAT[0..7] GND

1 S6 DIR 2MS1T2B3M2QES 1 A1 2 A2 3 A3 4 A4 5 A5 6 A6 7 A7 8 A8 9 GND 10 VCC 20 ~{OE}19 B1 18 B2 17 B3 16 B4 15 B5 14 B6 13 B7 12 B8 11
