SSCsimsi/8Bit_Computer/8Bit Computer ver2.0/Kicad/Computer/8Bit_Computer_PCB_V2.7.pdf

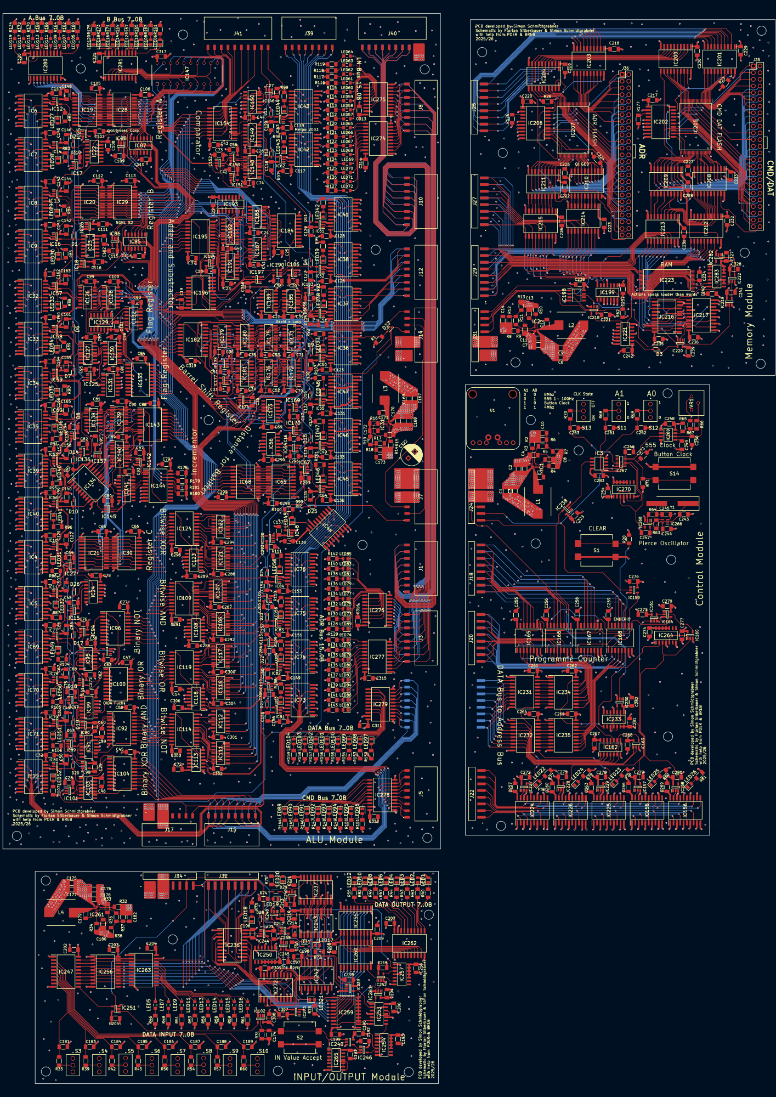
[picture p308: page 1]
