SSCsimsi/8Bit_Computer/8Bit Computer ver2.0/Kicad/Computer/8Bit_Computer_PCB_V2.6.pdf

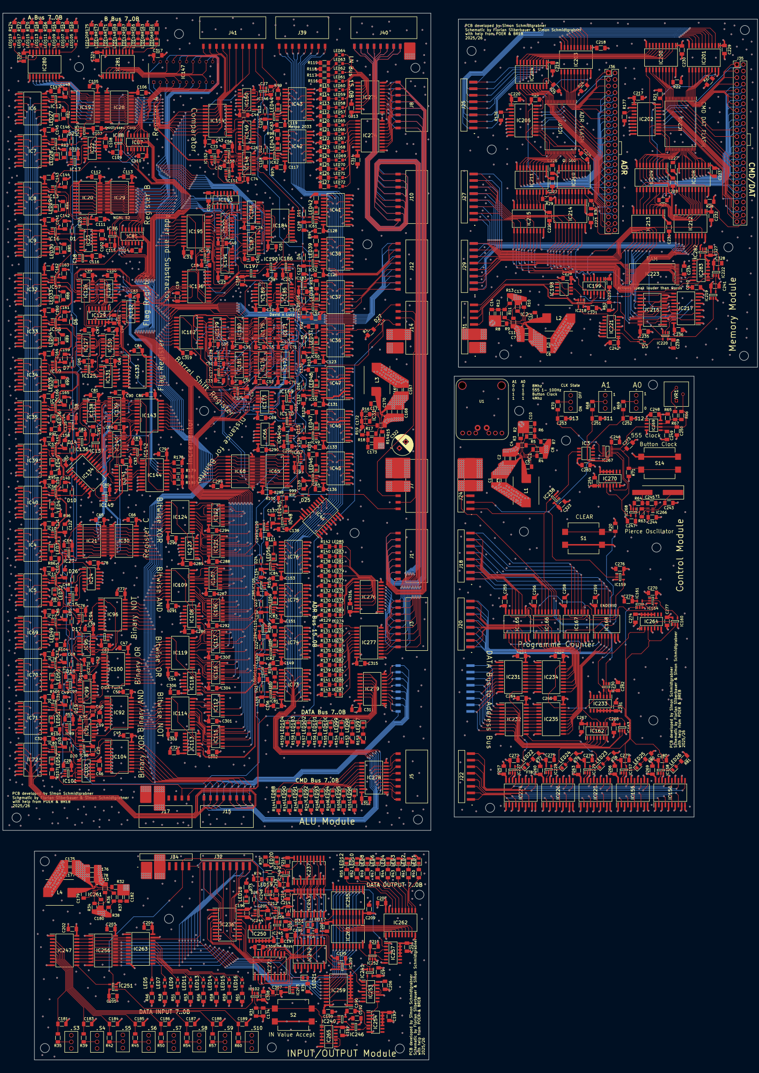
[picture p309: page 1]
