SSCsimsi/8Bit_Computer/8Bit Computer ver2.0/Kicad/Computer/8Bit_Computer_PCB_V2.5.pdf

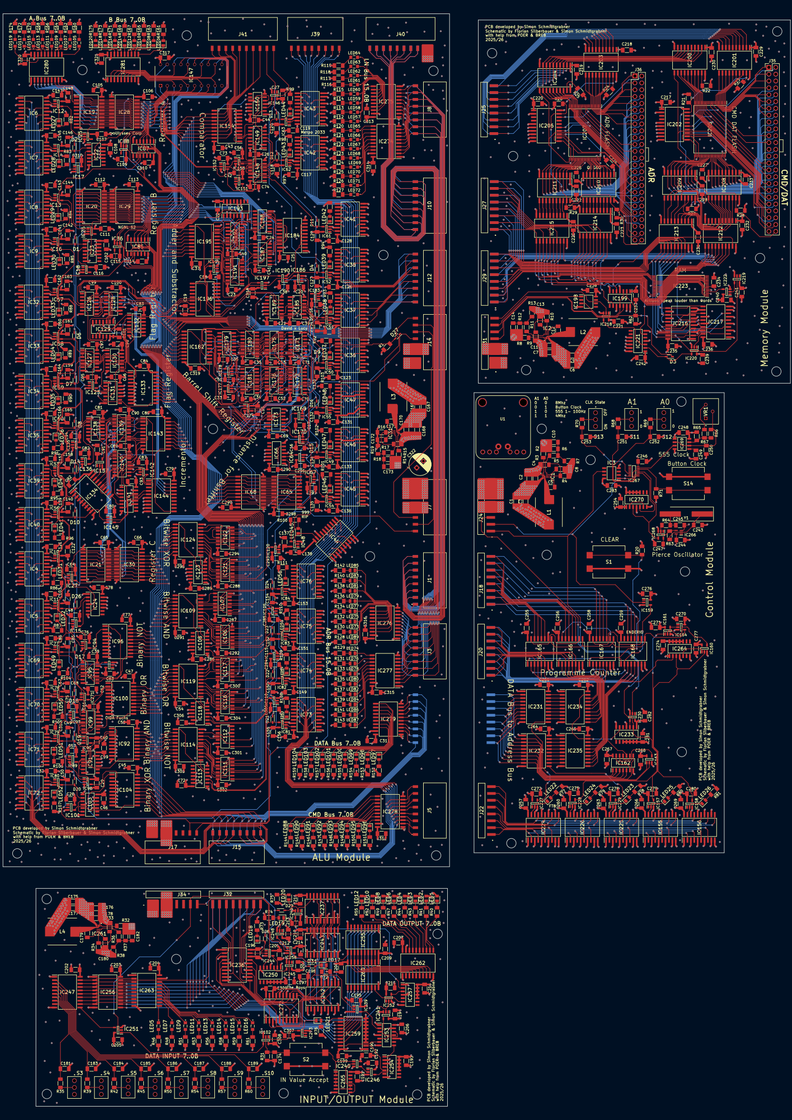
[picture p310: page 1]
