SSCsimsi/8Bit_Computer/8Bit Computer ver2.0/programmes/assembler/assembler VSC/main.cpp

#include <cstdint>
#include <iostream>
#include <fstream>
#include <string>
#include <list>
#include <bits/stdc++.h>

using namespace std;

enum Requires{  
    Nothing,
    Data,
    Address,
    Both
};

enum Disables{
    None,
    DataBus,
    AddressBus
};

enum Duration{
    oneCycle,
    twoCycles
};

class Cmd {
public:

	void Init(string nameIn, uint8_t valIn, Requires reqIn, Duration durIn, Disables disIn) {
		name = nameIn;
		val = valIn;
        req = reqIn;
        dis = disIn;
        dur = durIn;
	}

	string Name() {
		return name;
	}

	uint8_t Put() {
		return val;
	}

    uint8_t Req(Requires reqIn) {
        return (req == reqIn);
    }

    Disables Dis() {
        return dis;
    }
    
    Duration Dur() {
        return dur;
    }

private:
    string name;
	uint8_t val;
    Requires req;
    Disables dis;
    Duration dur;
};

class Label {
public:
    void SetName(string nameIn) {
        name = nameIn;
    }

    void AddPosition(uint16_t lineIn) {
        line.push_back(lineIn);
    }

    void SetDestination(uint16_t toIn) {
        to = toIn;
    }

    string GetName() {
        return name;
    }

    list<uint16_t> GetPositions() {
        return line;
    }

    uint16_t GetDestination() {
        return to;
    }

private:
    string name = "undef.";
    list<uint16_t> line;
    uint16_t to = 0;
};

list<Cmd> Commands;
list<Label> Labels;

void CreateList(void);
string ToHex(uint16_t num, uint8_t len);

int main() {

	CreateList();

	/* Open the code to be read from */
	ifstream codeFile("code.txt");

    /* temporary file for rewriting code */
    ofstream tmpCode("tmp.txt");

	/* Create the hex files for programming the computer */
	ofstream cmdFile("cmd", ios::binary); //cmd and dat in one file, since they are combined in one chip
	ofstream adrFile("adr", ios::binary);

    /* Create a txt for logging errors */
    ofstream errorLog("errors.txt");



	string newLine;
	uint8_t check;

    uint16_t currentLine = 0;

    Disables prevBusAccess = None;
    Disables prevToLastBusAccess = None;

    uint16_t prevAdr = 0;
    Duration prevAdrDuration = oneCycle;

    ifstream tmpCodeFile("code.txt");

    /* check for labels and their positions */
    while(getline(tmpCodeFile, newLine)) {

        /* store label, and skip to next cycle */
        if(newLine.find("label:") == 0) {

            Label label;

            newLine = newLine.substr(6);

            /* cut off spaces */
            uint8_t pos = newLine.find_first_not_of(' ');
            newLine = newLine.substr(pos);
            if(newLine.find(' ') != newLine.npos) {
                pos = newLine.find(' ');
                newLine = newLine.substr(0,pos);
            }

            errorLog << "found label: " << newLine << endl;

            label.SetName(newLine);
            Labels.push_back(label);
            continue;
        }



        /* 
         * current line shows the line within the assembled programme, 
         * so it will only increment if a command was found 
         */
        if((newLine.find(";") != newLine.npos) and (newLine.find("//") != 0)) {

            /* cut off comments */
            if(newLine.find("//") != newLine.npos) {
                newLine = newLine.substr(0, newLine.find("//"));
            }

            // add spaces, otherwise it would not be possible to search for labels
            newLine.append("   ");

            /* check for every known label within the current line */
            for(Label &label : Labels) {

                bool run = true;
                string labelInLine = "undef.";
                
                // indexes
                uint16_t ind1 = 0;
                uint16_t ind2 = 0;

                while(run) {

                    try {

                        if(newLine.find(' ', ind1 + 1) != newLine.npos) {
                            ind1 = newLine.find(' ', ind1 + 1);
                        }
                        else {
                            run = false;
                        }

                        if(newLine.find(' ', ind1 + 1) != newLine.npos) {
                            ind2 = newLine.find(' ', ind1 + 1);
                        }
                        else {
                            run = false;
                        }

                        labelInLine = newLine.substr(ind1 + 1, ind2 - ind1 - 1);

                        if(labelInLine == label.GetName()) {

                            /* if found next to "nop" it is meant to be jumped to */
                            if(newLine.find("nop") != newLine.npos) {
                                label.SetDestination(currentLine);

                                errorLog << "found destination for: " << label.GetName();
                                errorLog << " at: " << ToHex(currentLine, 4) << endl;
                            }

                            /* otherwise it is next to jmp or cjp, of which the location needs to be stored */
                            else if((newLine.find("jmp") != newLine.npos) or (newLine.find("cjp") != newLine.npos)) {
                                label.AddPosition(currentLine);
                            }

                            /* other locations are not allowed */
                            else {
                                errorLog << "illegal position for label \"" << label.GetName();
                                errorLog << "\" at line: " << ToHex(currentLine, 4) << endl;
                            }

                            run = false;
                        }
                    }
                    catch(exception e) {

                        errorLog << "error while searching for labels at line " << ToHex(currentLine, 4) << endl;

                        run = false;
                    }
                }
            }

            currentLine++;
        }
    }

    tmpCodeFile.close();

    errorLog << endl;



    currentLine = 0;

	while(getline(codeFile, newLine)) {

        check = 0;

        /* skips empty lines, ones with comments, or label definitions */
        if(newLine.empty() or (newLine.find("//") == 0 ) or (newLine.find("label:") == 0)) {
            tmpCode << newLine << endl;
            continue;
        }

        /* beginn reading the code from the first semicolon */
        uint8_t pos = newLine.find(";") + 1;
        newLine = newLine.substr(pos);

        /* cut out any spaces */
        pos = newLine.find_first_not_of(' ');
        newLine = newLine.substr(pos);

        /* write new line numbers at the beginning of the lines */
        tmpCode << ToHex(currentLine, 4) + "; " + newLine << endl;

        /* in order to avoid an empty string later */
        newLine = newLine.append("               ");



		for(Cmd cmd : Commands) {

			if(cmd.Name() == newLine.substr(0, newLine.find(' '))) {

                /* write cmd value to the file */
                uint8_t b = cmd.Put();
                cmdFile.write(reinterpret_cast<char*>(&b), 1);

                

                /* cmd XX ---- */
                uint8_t val = 0x00;

                /* 
                 * only if the command needs data, and no previous command 
                 * is outputting data to the bus 
                 */
                if((cmd.Req(Requires::Data) or cmd.Req(Requires::Both)) and 
                !(prevBusAccess == Disables::DataBus)) {

                    /* try to write 8 data bits to the cmd file */
                    try{
                        newLine = newLine.substr(newLine.find(' ') + 1);
                        string s = newLine.substr(0, 2);
                        val = stoul(s, nullptr, 16);
                    }
                    catch(exception e) {
                        errorLog << "unknown data value at line: " << ToHex(currentLine, 4) << endl;
                    }
                }
                cmdFile.write(reinterpret_cast<char*>(&val), 1);



                /* cmd -- XXXX */
                uint16_t adr = 0x0000;
                bool labelDetected = false;

                /* if there's a label at this position, it will write the destination to adr */
                for(Label label : Labels) {

                    for(uint16_t i : label.GetPositions()) {

                        if(i == currentLine) {
                            adr = label.GetDestination();
                            labelDetected = true;

                            errorLog << "replaced address at line " << ToHex(currentLine, 4);
                            errorLog << " with: " << ToHex(label.GetDestination(), 4);
                            errorLog << " > " << label.GetName() << endl;
                        }
                    }
                }

                /* 
                 * if the command needs an address, and no previous command 
                 * is outputting an address to the bus 
                 */
                if((cmd.Req(Requires::Address) or cmd.Req(Requires::Both)) and 
                !(prevToLastBusAccess == Disables::AddressBus) and !labelDetected) {

                    /* try to write 16bits to the adr file */
                    try{
                        newLine = newLine.substr(newLine.find(' ') + 1);
                        string s = newLine.substr(0, 4);
                        adr = stoul(s, nullptr, 16);
                        prevAdr = adr;
                    } 
                    catch(exception e) {
                        errorLog << "unknown address value at line: " << ToHex(currentLine, 4) << endl;
                    }
                }

                /* in order to keep addresses on for one cycle longer */
                if(prevAdrDuration == twoCycles) {
                    adr = prevAdr;
                }
                adrFile.write(reinterpret_cast<char*>(&adr), 2);



                currentLine++;
                prevToLastBusAccess = prevBusAccess;
                prevBusAccess = cmd.Dis();
                prevAdrDuration = cmd.Dur();

                check = 1;
                break;
			}          
		}

		if(!check) {

			errorLog << "unknown command at line: " << ToHex(currentLine, 4) << endl;
			//return -1;
		}
	}

    /* close and reopen the tmp file for reading*/
    tmpCode.close();
    ifstream newTmpCode("tmp.txt");

    /* delete and recreate the original code.txt for transferring the code with new line numbers */
    codeFile.close();
    remove("code.txt");
    ofstream newCodeFile("code.txt");

    /* transfer rewritten code to the code file */
    while(getline(newTmpCode, newLine)) {
        newCodeFile << newLine << endl;
    }

    /* delete temporary file */
    newTmpCode.close();
    remove("tmp.txt");

    /* Close the files */
	newCodeFile.close();
	adrFile.close();
    errorLog.close();
    cmdFile.close();
}

void CreateList() {

    Cmd cmd;

    // --- CORE ---
    cmd.Init("nop", 0x00, Requires::Nothing, Duration::oneCycle, Disables::None);       Commands.push_back(cmd); // No Operation
    cmd.Init("jmp", 0x01, Requires::Address, Duration::oneCycle, Disables::None);       Commands.push_back(cmd); // Jump
    cmd.Init("cjp", 0x02, Requires::Both,    Duration::oneCycle, Disables::None);       Commands.push_back(cmd); // Jump if

    // --- BUS TRANSFER ---
    cmd.Init("stx", 0x03, Requires::Data,    Duration::oneCycle, Disables::None);       Commands.push_back(cmd); // Store to interface reg 1
    cmd.Init("sty", 0x04, Requires::Data,    Duration::oneCycle, Disables::None);       Commands.push_back(cmd); // Store to interface reg 2
    cmd.Init("ldz", 0x05, Requires::Nothing, Duration::oneCycle, Disables::AddressBus); Commands.push_back(cmd); // Load interface regs

    // --- STORAGE ---
    cmd.Init("sto", 0x06, Requires::Both,    Duration::oneCycle,  Disables::None);      Commands.push_back(cmd); // Store to RAM
    cmd.Init("lod", 0x07, Requires::Address, Duration::twoCycles, Disables::DataBus);   Commands.push_back(cmd); // Load from RAM

    // --- ALU ---
    cmd.Init("add", 0x08, Requires::Nothing, Duration::oneCycle, Disables::DataBus);    Commands.push_back(cmd); // Add
    cmd.Init("adc", 0x09, Requires::Nothing, Duration::oneCycle, Disables::DataBus);    Commands.push_back(cmd); // Add with carry
    cmd.Init("sub", 0x0A, Requires::Nothing, Duration::oneCycle, Disables::DataBus);    Commands.push_back(cmd); // Subtract

    // --- INCREMENTOR ---
    cmd.Init("inc", 0x0B, Requires::Nothing, Duration::oneCycle, Disables::DataBus);    Commands.push_back(cmd); // Increment
    cmd.Init("dec", 0x0C, Requires::Nothing, Duration::oneCycle, Disables::DataBus);    Commands.push_back(cmd); // Decrement

    // --- LOGIC ---
    cmd.Init("not", 0x0D, Requires::Nothing, Duration::oneCycle, Disables::DataBus);    Commands.push_back(cmd); // Binary Not
    cmd.Init("orr", 0x0E, Requires::Nothing, Duration::oneCycle, Disables::DataBus);    Commands.push_back(cmd); // Binary Or
    cmd.Init("and", 0x0F, Requires::Nothing, Duration::oneCycle, Disables::DataBus);    Commands.push_back(cmd); // Binary And
    cmd.Init("xor", 0x10, Requires::Nothing, Duration::oneCycle, Disables::DataBus);    Commands.push_back(cmd); // Binary Xor
    cmd.Init("bnt", 0x11, Requires::Nothing, Duration::oneCycle, Disables::DataBus);    Commands.push_back(cmd); // Bitwise Not
    cmd.Init("bor", 0x12, Requires::Nothing, Duration::oneCycle, Disables::DataBus);    Commands.push_back(cmd); // Bitwise Or
    cmd.Init("ban", 0x13, Requires::Nothing, Duration::oneCycle, Disables::DataBus);    Commands.push_back(cmd); // Bitwise And
    cmd.Init("bxr", 0x14, Requires::Nothing, Duration::oneCycle, Disables::DataBus);    Commands.push_back(cmd); // Bitwise Xor

    // --- COMPARE ---
    cmd.Init("cgt", 0x15, Requires::Nothing, Duration::oneCycle, Disables::DataBus);    Commands.push_back(cmd); // Compare Greater than
    cmd.Init("ceq", 0x16, Requires::Nothing, Duration::oneCycle, Disables::DataBus);    Commands.push_back(cmd); // Compare Equal
    cmd.Init("clt", 0x17, Requires::Nothing, Duration::oneCycle, Disables::DataBus);    Commands.push_back(cmd); // Compare Smaller than

    // --- A/B/C REGISTERS ---
    cmd.Init("sta", 0x18, Requires::Data,    Duration::oneCycle, Disables::None);       Commands.push_back(cmd); // Store A
    cmd.Init("lda", 0x19, Requires::Nothing, Duration::oneCycle, Disables::DataBus);    Commands.push_back(cmd); // Load A
    cmd.Init("stb", 0x1A, Requires::Data,    Duration::oneCycle, Disables::None);       Commands.push_back(cmd); // Store B
    cmd.Init("ldb", 0x1B, Requires::Nothing, Duration::oneCycle, Disables::DataBus);    Commands.push_back(cmd); // Load B
    cmd.Init("stc", 0x1C, Requires::Data,    Duration::oneCycle, Disables::None);       Commands.push_back(cmd); // Store C
    cmd.Init("ldc", 0x1D, Requires::Nothing, Duration::oneCycle, Disables::DataBus);    Commands.push_back(cmd); // Load C

    // --- FLAG REGISTER ---
    cmd.Init("stf", 0x1E, Requires::Data,    Duration::oneCycle, Disables::None);       Commands.push_back(cmd); // Store Flags
    cmd.Init("lcr", 0x1F, Requires::Nothing, Duration::oneCycle, Disables::DataBus);    Commands.push_back(cmd); // Load Carry
    cmd.Init("ldo", 0x20, Requires::Nothing, Duration::oneCycle, Disables::DataBus);    Commands.push_back(cmd); // Load Overflow
    cmd.Init("ldf", 0x21, Requires::Nothing, Duration::oneCycle, Disables::DataBus);    Commands.push_back(cmd); // Load Flags

    // --- SHIFT REGISTER ---
    cmd.Init("std", 0x22, Requires::Data,    Duration::oneCycle, Disables::None);       Commands.push_back(cmd); // Store Distance
    cmd.Init("ldd", 0x23, Requires::Nothing, Duration::oneCycle, Disables::DataBus);    Commands.push_back(cmd); // Load Distance
    cmd.Init("sft", 0x24, Requires::Nothing, Duration::oneCycle, Disables::DataBus);    Commands.push_back(cmd); // Shift
    cmd.Init("sfc", 0x25, Requires::Nothing, Duration::oneCycle, Disables::DataBus);    Commands.push_back(cmd); // Shift Circular

    // --- INPUTS ---
    cmd.Init("sti", 0x26, Requires::Data,    Duration::oneCycle, Disables::None);       Commands.push_back(cmd); // Store Inputs
    cmd.Init("ldi", 0x27, Requires::Nothing, Duration::oneCycle, Disables::DataBus);    Commands.push_back(cmd); // Load Inputs
    cmd.Init("ldu", 0x28, Requires::Nothing, Duration::oneCycle, Disables::DataBus);    Commands.push_back(cmd); // Load Unread

    // --- OUTPUTS ---
    cmd.Init("sop", 0x29, Requires::Data,    Duration::oneCycle, Disables::None);       Commands.push_back(cmd); // Store Outputs
    cmd.Init("lop", 0x2A, Requires::Nothing, Duration::oneCycle, Disables::DataBus);    Commands.push_back(cmd); // Load Outputs



    // unused on the physical version, as there is no screen

    // --- SCREEN ---
    cmd.Init("str", 0x2B, Requires::Both,    Duration::oneCycle,  Disables::None);      Commands.push_back(cmd); // Store Row
    cmd.Init("ldr", 0x2C, Requires::Nothing, Duration::twoCycles, Disables::DataBus);   Commands.push_back(cmd); // Load Row

    // --- CONTROLLER ---
    cmd.Init("lin", 0x2D, Requires::Nothing, Duration::oneCycle,  Disables::DataBus);   Commands.push_back(cmd); // Load Inputs
}

string ToHex(uint16_t num, uint8_t len) {

    string out;

    for(int i; i < len; i++) {
        out = out + "0";
    }

    try {
        stringstream s;
        s << hex << (int)num;

        uint8_t strLen = s.str().length();

        out = out.insert((len-strLen), s.str());
        out = out.substr(0, len);

        transform(out.begin(), out.end(), out.begin(),::toupper);
    }
    catch(exception e) {}

    return out;
}
