SSCsimsi/8Bit_Computer/8Bit Computer ver2.0/programmes/assembler/assembler STM/assembler/main.cpp

#include <cstdint>
#include <iostream>
#include <fstream>
#include <string>
#include <list>

using namespace std;

#define CMDLENGTH 3

enum Requires{
    Nothing,
    Data,
    Address,
    Both
};

enum Disables{
    None,
    DataBus,
    AddressBus
};

class Cmd {
public:

	/*
	 * the name is made up of 3 ascii symbols,
	 * the value has to fit within 8 bits
	 */
	void Init(string nameIn, uint8_t valIn, Requires reqIn, Disables disIn) {
		name = nameIn;
		val = valIn;
        req = reqIn;
        dis = disIn;
	}

	uint8_t Compare(string newLine) {
		return name == newLine.substr(0, CMDLENGTH);
	}

	uint8_t Put() {
		return val;
	}

    uint8_t Req(Requires reqIn) {
        return (req == reqIn);
    }

    uint8_t Dis(Disables disIn) {
        return (dis == disIn);
    }

private:
    string name;
	uint8_t val;
    Requires req;
    Disables dis;
};

list<Cmd> Commands;

void CreateList(void);

int main() {

	CreateList();

	/* Open the code */
	ifstream codeFile("code.txt");

	/* Create the hex files for programming the computer */
	ofstream cmdFile("cmd.hex"); //cmd and dat in one file, since they are combined in one flash chip
	ofstream adrFile("adr.hex");

	string newLine;
	uint8_t check;

	while(getline(codeFile, newLine)) {

		check = 0;
		uint8_t pos = newLine.find(' ') + 1;
        newLine = newLine.substr(pos); //cut off the line number
        newLine.append("000000000000");  //in order to avoid an empty string later

		for(Cmd cmd : Commands) {

			if(cmd.Compare(newLine)) {

				/* write cmd value to the file */
				uint8_t b = cmd.Put();
				cmdFile.write(reinterpret_cast<char*>(&b),1);

                /*
                 * cmd 00 ----
                 */
                if(cmd.Req(Requires::Data) or cmd.Req(Requires::Both)) {

                    /* write 8 data bits to the cmd file */
                    uint8_t val = stoul(newLine.substr(4,2), nullptr, 16);
		            cmdFile.write(reinterpret_cast<char*>(&val),1);

                } else {

                    /* write 0x00 to the cmd file, this value will not be used during execution */
                    uint8_t val = 0x00;
		            cmdFile.write(reinterpret_cast<char*>(&val),1);
                }

                /*
                 * cmd -- 0000
                 */
                if(cmd.Req(Requires::Address) or cmd.Req(Requires::Both)) {

                    /* write 16bits to the adr file */
                    uint16_t adr = stoul(newLine.substr(7,4), nullptr, 16);
		            adrFile.write(reinterpret_cast<char*>(&adr),2);

                } else {

                    /* write 0x0000 to the adr file, this value will not be used during execution */
                    uint16_t adr = 0x0000;
		            adrFile.write(reinterpret_cast<char*>(&adr),2);
                }

				check = 1;
				break;
			}
		}

		if(!check) {

			ofstream Error("UnknownCommand.txt");
			Error.close();

			return -1;
		}
	}

	/* Close the files */
	codeFile.close();
	cmdFile.close();
	adrFile.close();
}

void CreateList() {

    Cmd cmd;

    // --- CORE ---
    cmd.Init("nop", 0x00, Requires::Nothing, Disables::None);       Commands.push_back(cmd); // No Operation
    cmd.Init("jmp", 0x01, Requires::Address, Disables::None);       Commands.push_back(cmd); // Jump
    cmd.Init("cjp", 0x02, Requires::Both,    Disables::None);       Commands.push_back(cmd); // Jump if

    // --- BUS TRANSFER ---
    cmd.Init("stx", 0x03, Requires::Data,    Disables::None);       Commands.push_back(cmd); // Store to interface reg 1
    cmd.Init("sty", 0x04, Requires::Data,    Disables::None);       Commands.push_back(cmd); // Store to interface reg 2
    cmd.Init("ldz", 0x05, Requires::Nothing, Disables::AddressBus); Commands.push_back(cmd); // Load interface regs

    // --- STORAGE ---
    cmd.Init("sto", 0x06, Requires::Both,    Disables::DataBus);    Commands.push_back(cmd); // Store to RAM
    cmd.Init("lod", 0x07, Requires::Nothing, Disables::DataBus);    Commands.push_back(cmd); // Load from RAM

    // --- ALU ---
    cmd.Init("add", 0x08, Requires::Nothing, Disables::DataBus);    Commands.push_back(cmd); // Add
    cmd.Init("adc", 0x09, Requires::Nothing, Disables::DataBus);    Commands.push_back(cmd); // Add with carry
    cmd.Init("sub", 0x0A, Requires::Nothing, Disables::DataBus);    Commands.push_back(cmd); // Subtract

    // --- INCREMENTOR ---
    cmd.Init("inc", 0x0B, Requires::Nothing, Disables::DataBus);    Commands.push_back(cmd); // Increment
    cmd.Init("dec", 0x0C, Requires::Nothing, Disables::DataBus);    Commands.push_back(cmd); // Decrement

    // --- LOGIC ---
    cmd.Init("bnt", 0x0D, Requires::Nothing, Disables::DataBus);    Commands.push_back(cmd); // Binary Not
    cmd.Init("bor", 0x0E, Requires::Nothing, Disables::DataBus);    Commands.push_back(cmd); // Binary Or
    cmd.Init("ban", 0x0F, Requires::Nothing, Disables::DataBus);    Commands.push_back(cmd); // Binary And
    cmd.Init("bxr", 0x10, Requires::Nothing, Disables::DataBus);    Commands.push_back(cmd); // Binary Xor
    cmd.Init("not", 0x11, Requires::Nothing, Disables::DataBus);    Commands.push_back(cmd); // Bitwise Not
    cmd.Init("orr", 0x12, Requires::Nothing, Disables::DataBus);    Commands.push_back(cmd); // Bitwise Or
    cmd.Init("and", 0x13, Requires::Nothing, Disables::DataBus);    Commands.push_back(cmd); // Bitwise And
    cmd.Init("xor", 0x14, Requires::Nothing, Disables::DataBus);    Commands.push_back(cmd); // Bitwise Xor

    // --- COMPARE ---
    cmd.Init("cgt", 0x15, Requires::Nothing, Disables::DataBus);    Commands.push_back(cmd); // Compare Greater than
    cmd.Init("ceq", 0x16, Requires::Nothing, Disables::DataBus);    Commands.push_back(cmd); // Compare Equal
    cmd.Init("clt", 0x17, Requires::Nothing, Disables::DataBus);    Commands.push_back(cmd); // Compare Smaller than

    // --- A/B/C REGISTERS ---
    cmd.Init("sta", 0x18, Requires::Data,    Disables::None);       Commands.push_back(cmd); // Store A
    cmd.Init("lda", 0x19, Requires::Nothing, Disables::DataBus);    Commands.push_back(cmd); // Load A
    cmd.Init("stb", 0x1A, Requires::Data,    Disables::None);       Commands.push_back(cmd); // Store B
    cmd.Init("ldb", 0x1B, Requires::Nothing, Disables::DataBus);    Commands.push_back(cmd); // Load B
    cmd.Init("stc", 0x1C, Requires::Data,    Disables::None);       Commands.push_back(cmd); // Store C
    cmd.Init("ldc", 0x1D, Requires::Nothing, Disables::DataBus);    Commands.push_back(cmd); // Load C

    // --- FLAG REGISTER ---
    cmd.Init("stf", 0x1E, Requires::Data,    Disables::None);       Commands.push_back(cmd); // Store Flags
    cmd.Init("lcr", 0x1F, Requires::Nothing, Disables::DataBus);    Commands.push_back(cmd); // Load Carry
    cmd.Init("ldo", 0x20, Requires::Nothing, Disables::DataBus);    Commands.push_back(cmd); // Load Overflow
    cmd.Init("ldf", 0x21, Requires::Nothing, Disables::DataBus);    Commands.push_back(cmd); // Load Flags

    // --- SHIFT REGISTER ---
    cmd.Init("std", 0x22, Requires::Data,    Disables::None);       Commands.push_back(cmd); // Store Distance
    cmd.Init("ldd", 0x23, Requires::Nothing, Disables::DataBus);    Commands.push_back(cmd); // Load Distance
    cmd.Init("sft", 0x24, Requires::Nothing, Disables::DataBus);    Commands.push_back(cmd); // Shift
    cmd.Init("sfc", 0x25, Requires::Nothing, Disables::DataBus);    Commands.push_back(cmd); // Shift Circular

    // --- INPUTS ---
    cmd.Init("sti", 0x26, Requires::Data,    Disables::None);       Commands.push_back(cmd); // Store Inputs
    cmd.Init("ldi", 0x27, Requires::Nothing, Disables::DataBus);    Commands.push_back(cmd); // Load Inputs
    cmd.Init("ldu", 0x28, Requires::Nothing, Disables::DataBus);    Commands.push_back(cmd); // Load Unread

    // --- OUTPUTS ---
    cmd.Init("sop", 0x29, Requires::Data,    Disables::None);       Commands.push_back(cmd); // Store Outputs
    cmd.Init("lop", 0x2A, Requires::Nothing, Disables::DataBus);    Commands.push_back(cmd); // Load Outputs



    /* unused, since we did not build the screen

    // --- SCREEN ---
    cmd.Init("str", 0x2B, Requires::Both,    Disables::None);       Commands.push_back(cmd); // Store Row
    cmd.Init("ldr", 0x2C, Requires::Nothing, Disables::DataBus);    Commands.push_back(cmd); // Load Row

    // --- CONTROLLER ---
    cmd.Init("lin", 0x2D, Requires::Nothing, Disables::DataBus);    Commands.push_back(cmd); // Load Inputs

    */
}
