SSCsimsi/8Bit_Computer/(commit log)

2025-04-18 Updated 1.5. 8Bit Computer ver2.0
    [chips availability.xlsx, commands.xlsx]
2025-04-18 added 74x885 to the list
    [chips availability.xlsx]
2025-04-18 added buffer to the list + made 8bit parallel adder
    [chips availability.xlsx, commands.xlsx]
2025-04-29 reorganized some stuff
    [chips availability.xlsx, commands.xlsx]
2025-05-03 + diplomarbeit zusammenfassung
    [commands.xlsx]
2025-06-21 added commands to the list + redid previous order
    [commands.xlsx]
2025-06-27 Update commands.xlsx
    + Flags
    + new comparison commands
    [commands.xlsx]
2025-08-06 Started work on the ALU
    + a few fixes for Adder/Subtractor and Comparator
    + ADC (Add With Carry) command for Adder/Subtractor
    - removed Command Decoder as it was redundant
2025-08-06 worked on ALU
    + updated commands.xlsx
    [commands.xlsx]
2025-08-06 Finished the Incrementor
    + added Incrementor to ALU
    ~ updated commands
    [commands.xlsx]
2025-08-07 Add Shift Register to ALU
    + added control logic to shift reg
    [commands.xlsx]
2025-08-15 Update Flag Register.dig
    + fixed the timing
    ~ not sure about D-flip-flops with drivers, could use buffers instead
2025-08-20 Update ALU
    + added STC and STF outputs to the incrementor
    + added the new Register to the ALU
    still needed:
    - incrementor needs to store to the C register after performing its task
    - command for outputting the C register to the data bus
    - incrementor should not output to the data bus (incase we do want to have interrupts in the cpu)
    - C register should cause an interrupt if a specified value is reached
2025-08-20 Update commands.xlsx
    added and changed previously discussed commands
    [commands.xlsx]
2025-08-21 Update Registers
    + added a load command for every register
    + connected every register to the output of the ALU
    + connected the Qs output of the incrementor to the STR input of the C register using an or gate
    [commands.xlsx]
2025-08-21 Update CPU.dig
    still needs to be implemented:
    - programme counter along with jump and conditional jump commands
    - maybe timers along with comparison registers and interrupts
    - RAM still needs to be connected to the address bus properly
    [commands.xlsx]
2025-09-02 added program counter
    - the clear input still needs to be connected
    - a 16 bit register is still needed for RAM addresses
    - maybe timers + interrupts
2025-09-06 Partslist
    added possible Storage chips
    formated List for better readability
    added multiple Datasheets and Websites
    [chips availability.xlsx]
2025-09-06 Partslist
    added XOR, AND, OR
    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
    [chips availability.xlsx]
2025-09-08 parts
    added some better chip versions
    added some datasheets
    added some Websites
    [chips availability.xlsx]
2025-09-09 partslist
    little format changes
    [chips availability.xlsx]
2025-09-29 parts
    added flash
    added sram
    added some prices
    added 8in or diagram
    [chips availability.xlsx]
2025-09-29 parts
    changed some prices
    [chips availability.xlsx]
2025-10-01 Update commands.xlsx
    set previous shift commands to deprecated
    [commands.xlsx]
2025-10-01 partslist
    formatted list
    highlighted best chips green
    multiplexer rise and fall time ???
    [chips availability.xlsx]
2025-10-02 partslist
    added Register
    added new MUX
    [chips availability.xlsx]
2025-10-02 started work on 8 to 16 bit converter
    [commands.xlsx]
2025-10-02 Partslist
    added BUY links to mouser
    specified Flash 512k*16
    [chips availability.xlsx]
2025-10-02 finished the 8 to 16 converter
    [commands.xlsx]
2025-10-02 parts
    added 16Bit Dlatch Buffer
    added 2x Dlatch
    added 8Bit Register with tristate
    [chips availability.xlsx]
2025-10-03 parts,Kicad
    added Parts into Kicad
    |Waiting for CAD Model of SN74HCS574DGSR|
    started Kicad Schematic:
    added ALU->BinaryXOR/AND/OR/NOT
    [ALU.kicad_sch, BinaryAND.kicad_sch, BinaryNOT.kicad_sch, BinaryOR.kicad_sch, BinaryXOR.kicad_sch, Computer.kicad_pcb, Computer.kicad_sch, chips availability.xlsx]
2025-10-04 parts,Kicad
    added 74HCS574 to Kicad
    Kicad:
    ALU->added Bitwise NOT,OR,XOR,AND
    ALU->added A,B 8in OR
    [ALU.kicad_sch, BinaryAND.kicad_sch, BinaryNOT.kicad_sch, BinaryOR.kicad_sch, BinaryXOR.kicad_sch, BitwiseAND.kicad_sch, BitwiseNOT.kicad_sch, BitwiseOR.kicad_sch]
2025-10-04 KicadParts
    added the Parts as .zip
2025-10-05 partslist
    added shift reg 194
    [chips availability.xlsx]
2025-10-06 parts
    added new NOR flash M29F800FT
    [chips availability.xlsx]
2025-10-07 Kicad,parts
    added FlagRegister
    began Inc, Comp
    parts:
    added comparator for P>Q 682
    added faster sram 12ns AS7C
    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
    [ALU.kicad_sch, BinaryAND.kicad_sch, BinaryNOT.kicad_sch, BinaryXOR.kicad_sch, BitwiseAND.kicad_sch, BitwiseNOT.kicad_sch, BitwiseOR.kicad_sch, BitwiseXOR.kicad_sch]
2025-10-07 added RAM
    still needs to be verified
    [commands.xlsx]
2025-10-09 named commands
    + each command now has a hex value
    * renamed the ram inputs to make more sense
    + added simple explanations to the ram commands in the excel file
    [commands.xlsx]
2025-10-10 partsList
    added Program Counter 163
    changed some chips to AHC
    added 1CH AND 08
    changed shift reg to old -> Build own barrel Shifter
    changed IS Ram to old -> AS faster
    [chips availability.xlsx]
2025-10-10 parts,Kicad
    changed 8xDlatch HCS to ABT 574
    waiting for SRAM CAD Model
    imported AHC types of ICs
    added ProgrammeCounter
    finished Comparator
    changed all HCS to AHC except 3in OR ->no AHC Version
    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
    [ALU.kicad_sch, BinaryAND.kicad_sch, BinaryNOT.kicad_sch, BinaryOR.kicad_sch, BinaryXOR.kicad_sch, BitwiseAND.kicad_sch, BitwiseNOT.kicad_sch, BitwiseOR.kicad_sch]
2025-10-10 added 2 more commands
    - LD to register 1
    - LD to register 2
    both together are one big 16 bit register for ram to be able to write to the full addr bus
    [commands.xlsx]
2025-10-10 parts, Kicad
    added MUX 157 for BarrelShiftReg
    began with BarrelShiftRegister
    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
    [ALU.kicad_sch, BarrelShiftRegister.kicad_sch, Comparator.kicad_sch, ProgrammeCounter.kicad_sch, chips availability.xlsx]
2025-10-11 2 new commands
    - store to jump reg 1
    - store to jump reg 2
    these are needed in order to be able to jump to 16 bit wide addresses
    [commands.xlsx]
2025-10-11 partsList, Kicad
    added faster Comparator 521
    added 1CH XOR
    added 8Bit and 16Bit Driver 245, 16245
    ->they need pullUp resistors for High-Z when power on
    included SRAM CAD Model AS7C1024
    included some CAD Models
    added Register 1 0x20 and 0x21
    finished Incrementor
    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
    [ALU.kicad_sch, BarrelShiftRegister.kicad_sch, Comparator.kicad_sch, Incrementor.kicad_sch, ProgrammeCounter.kicad_sch, chips availability.xlsx, chips availabilityOLD.xlsx, chips availabilityOLDOLD.xlsx]
2025-10-12 Kicad
    added Register 2(0x22 u 0x23) and 3(0x13 u 0x14)
    added BarrelShiftRegister
    added AdderSubstractor
    added cmd Comparators to the bitwise and binary Logic
    [ALU.kicad_sch, AdderSubstractor.kicad_sch, BarrelShiftRegister.kicad_sch, BinaryAND.kicad_sch, BinaryNOT.kicad_sch, BinaryOR.kicad_sch, BinaryXOR.kicad_sch, BitwiseAND.kicad_sch]
2025-10-12 removed redundant commands
    - the command values still need to be changed back
    [commands.xlsx]
2025-10-13 finished lookup table, still needs testing
    not sure on the actual operation
    [commands.xlsx]
2025-10-14 Kicad
    changed the comp values to the new ones
    [ALU.kicad_sch, Comparator.kicad_sch, ProgrammeCounter.kicad_sch]
2025-10-15 changed RAM.dig
    any transfer related commands have been removed and the ram module now takes into account the fact that in/out are combined on the chip we are planning on using
    [commands.xlsx]
2025-10-17 Kicad
    added Programmer Adapter
    [ProgrammeAdapter.kicad_pcb, ProgrammeAdapter.kicad_sch]
2025-10-18 Kicad
    deleted the Qs
    began with FlashMemory
    added the CMD comparators for Inc, Comp, AddSub, FlagReg, BarrelShifter, ProgCount
    added Diodes and DATdis line
    [ALU.kicad_sch, Comparator.kicad_sch, Computer.kicad_sch, FlashMemory.kicad_sch, Incrementor.kicad_sch, ProgrammeCounter.kicad_sch]
2025-10-19 added data to address bus interface
    [commands.xlsx]
2025-10-20 added i/o
    [commands.xlsx]
2025-10-23 parts
    added male/ female headers for PCB to PCB
    [chips availability.xlsx]
2025-10-23 parts
    added 8channel not
    added possible Leds
    added possible switches
    [chips availability.xlsx]
2025-10-24 added register in front of the shift reg
    would have caused a bus collision
    otherwise
    [commands.xlsx]
2025-10-24 changed the input leds so that they show the value stored in the input register
2025-10-24 Kicad,parts
    worked on Flash memory
    began RAM
    added Delay Chip for Flash
    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
    [ALU.kicad_sch, Comparator.kicad_sch, Computer.kicad_sch, FlashMemory.kicad_sch, ProgrammeCounter.kicad_sch, RAM.kicad_sch, chips availability.xlsx]
2025-10-25 Kicad
    included Delay, pin Strips and headers, 8xnot
    added some comps
    finished flash mem
    added DATtoADR
    [ALU.kicad_sch, AdderSubstractor.kicad_sch, Computer.kicad_sch, DATtoADR.kicad_sch, FlagRegister.kicad_sch, FlashMemory.kicad_sch, chips availability.xlsx]
2025-10-27 Kicad, parts
    Parts:
    added Leds
    added Input Output
    changed Q bus to DAT bus
    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
    [ALU.kicad_sch, AdderSubstractor.kicad_sch, BarrelShiftRegister.kicad_sch, BinaryAND.kicad_sch, BinaryNOT.kicad_sch, BinaryOR.kicad_sch, BinaryXOR.kicad_sch, BitwiseAND.kicad_sch]
2025-10-28 Update CPU.dig
    switched the orientation of the I/O leds
    from LSB to the left to it being on the right side
2025-10-28 Kicad, parts
    added Flipswitch
    added Inductor for PSU
    added Step-Down Conv chip MP2338GTL
    added Step-Down Conv circuit for 20V VBUS to 5V VCC
    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
    [ALU.kicad_sch, Computer.kicad_sch, InputOutput.kicad_sch, chips availability.xlsx]
2025-10-29 Kicad, parts
    added USB C PD Triggerboard
    added Delay Chip for 90ns
    added Push Button
    added USB C PD Triggerboard
    added rising edge detector via Delay and Xor for Accept Push Button
    added VBUS net
    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
    [ALU.kicad_sch, AdderSubstractor.kicad_sch, BarrelShiftRegister.kicad_sch, BinaryAND.kicad_sch, BinaryNOT.kicad_sch, BinaryOR.kicad_sch, BinaryXOR.kicad_sch, BitwiseAND.kicad_sch]
2025-11-01 Kicad
    changed to module version
    [Computer.kicad_sch, DATtoADR.kicad_sch, FlashMemory.kicad_sch, InputOutput.kicad_sch, ProgrammeCounter.kicad_sch, RAM.kicad_sch]
2025-11-06 parts,Kicad
    added parts models to github
    added unbuffered Not gate
    added Clock Generator via Pierce Oscillator
    designed Oscillator circuit for 8Mhz
    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
    [ClockGen.kicad_pcb, ClockGen.kicad_sch, chips availability.xlsx]
2025-11-06 Kicad, folders
    added Computer Schematic pdf of the module version
    added Clock Gen pdf Schemtics and PCB
    folders:
    changed old Computer versions to OLD_
    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
    [39281023.step, 39281103.step, 39281183.step, 39281243.step, 39303035.step, 74HC04D_653.step, 74HC08D_652.step, 8Bit_Computer_1.0.kicad_pcb]
2025-11-09 Kicad SCH/PCB
    Kicad SCH/PCB:
    changed the References in SCH
    began with INOUTPUT module nearly done
    [ALU.kicad_sch, AdderSubstractor.kicad_sch, BarrelShiftRegister.kicad_sch, BinaryAND.kicad_sch, BinaryNOT.kicad_sch, BinaryOR.kicad_sch, BinaryXOR.kicad_sch, BitwiseAND.kicad_sch]
2025-11-09 found 2 short circuits within the alu
2025-11-09 testing, fixed the ram and increased the downtime on the address and data busses, if requested
    the clock in the cpu is currently replaced by a button for testing purposes
2025-11-09 ...the hex display was the wrong way around
    [commands.xlsx]
2025-11-13 Create test.txt
    the next few operations need to make use of the current value in A in order to ensure a proper test of all the commands used
2025-11-14 checked flash
    changed the clock in the cpu to 10Hz for testing purposes and redid the timing for the flash, since the previous version was left over from the last big debugging session
2025-11-16 test programme
    continued adding commands to be tested + translated to hex
    [commands.xlsx]
2025-11-20 testing, changed incrementor
    also had the carry out and overflow wires switched
2025-11-20 Update test.txt
    added a warning, as the flag register currently is a random numbers generator
2025-11-20 found the error
    another collision issue, added pulldowns and a few diodes to the flag related signals in the alu
2025-11-20 marked all the tested commands
    [commands.xlsx]
2025-11-27 Kicad, parts
    added Mux 4:1 for CLK
    added LM555
    added some Diodes for Flash disable
    fixed wrong routing of flag register
    fixed wrong routing of STC STF in INC/AddS
    LM555 circuit for 1Hz to 100Hz
    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
    [AdderSubstractor.kicad_sch, ClockGen.kicad_pcb, ClockGen.kicad_sch, Computer.kicad_sch, FlagRegister.kicad_sch, Incrementor.kicad_sch, InputOutput.kicad_sch, RAM.kicad_sch]
2025-11-30 Kicad,parts
    added 1N4148 Diode SMD
    fixed some routings of Schematic
    created Flash mem and RAM PCB
    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
    [Computer.kicad_pcb, Computer.kicad_sch, FlagRegister.kicad_sch, FlashMemory.kicad_sch, InputOutput.kicad_sch, ProgrammeCounter.kicad_sch, chips availability.xlsx]
2025-12-05 worked on the test code
    [commands.xlsx]
2025-12-05 tag der offenen Tür
    [Computer.kicad_pcb]
2025-12-07 Kicad
    added the Programme Counter und Dat to adr module
    [Computer.kicad_pcb, Computer.kicad_sch, DATtoADR.kicad_sch, ProgrammeCounter.kicad_sch]
2025-12-08 worked on the test programme
    still needs to be translated to hex, also still missing the input commands
    [commands.xlsx]
2025-12-08 added every command to the test
    still needs translating and needs to be executed
    [commands.xlsx]
2025-12-08 Update CPU.dig
    added a clk counter circuit for debugging purposes, found the error to occur on the falling edge of the clock
2025-12-08 found the error...
    i forgot a diode to the address disable bus
2025-12-08 finished testing
    everything works, the last error was an unconnected wire in the alu
    [commands.xlsx]
2025-12-09 changes to commands
    + added the store inputs command
    - had to change the values for the load inputs, load unread, store outputs and load outputs commands
    + added two commands to the screen
    [commands.xlsx]
2025-12-11 added controller inputs
    d-pad, ok and esc buttons
    [commands.xlsx]
2026-01-06 Kicad
    added 10pin 2,54mm Header
    finished ALU PCB and added pin Header for extra use (DAT,ADR,CMD,Ddis,CLK)
    31.12-06.01 about +60hr for ALU
    [ALU.kicad_sch, BinaryOR.kicad_sch, BinaryXOR.kicad_sch, Computer.kicad_pcb, Computer.kicad_sch, DATtoADR.kicad_sch, FlagRegister.kicad_sch, Incrementor.kicad_sch]
2026-01-07 Kicad
    added Leds for B Bus and A Bus
    [ALU.kicad_sch, Computer.kicad_pcb, Computer.kicad_sch]
2026-01-08 started writing the assembler
2026-01-08 Kicad
    changed the clearence ro 0.25mm on inner copper layers
    todo: 100uF for PSU
    mounting holes
    schematic check silberb
    [Computer.kicad_pcb]
2026-01-08 Kicad
    added Schematic PDF V2.0
    added PCB PDF V2.0
    renamed the old PDFs
    [Computer.kicad_pcb]
2026-01-10 Kicad Fixes only schematic
    fixed important schematic errors
    [ALU.kicad_sch, BarrelShiftRegister.kicad_sch, Comparator.kicad_sch, Computer.kicad_pcb, Computer.kicad_sch, FlagRegister.kicad_sch, InputOutput.kicad_sch, ProgrammeCounter.kicad_sch]
2026-01-10 Kicad, PCB Fix
    fixed the errors on the PCB
    added mounting holes
    added GND panels on Top and Bot Layer
    added 100uF
    [Computer.kicad_sch, FlagRegister.kicad_sch, ProgrammeCounter.kicad_sch, RAM.kicad_sch]
2026-01-11 Kicad separated PCBs, added production files
    [ALU_Module.kicad_pcb, Control_Module.kicad_pcb, Input_Output_Module.kicad_pcb, Memory_Module.kicad_pcb]
2026-01-15 sorted some things. added bom
    [39281023.step, 39281103.step, 39281183.step, 39281243.step, 39303035.step, 74HC04D_653.step, 74HC08D_652.step, 8Bit_Computer_1.0.kicad_pcb]
2026-01-22 chnaged 150Ohms to 390
    [BOM.xlsx]
2026-01-29 not fully working yet
    the values it writes to the files are not correct
    [main.cpp]
2026-01-29 finished the assembler
    had some "assistance"
2026-01-31 moved some stuff
    kept working on the assembler in vscode
2026-02-11 updated T76 software, Kicad bugs
    changed the inverting outs of IC199 to non inverting
    changed Pin of CMD decoder IC237 0x2A from GND to VCC (pin5)
    deleted diode d30
    changed silkscreen of the Clock gen mux from 0 1 555 to 1 0 555 and buttonclk from 1 0 to 0 1
    changed the DS1100-150+ of the edge detector to an or gate SN74HCS32
    [Computer.kicad_sch, FlashMemory.kicad_sch, InputOutput.kicad_sch]
2026-02-11 Kicad new pdfs V2.5
2026-02-12 strings show error
    Failed to execute MI command:
    -var-create - * &((()._M_local_buf))
    [main.cpp]
2026-02-12 kicad incrementor cmd comp fix
    fixed wrong hex to bin to pins
    [ALU.kicad_sch]
2026-02-13 assembler works
2026-02-15 some stuff for the documentation
    [Truth Tables.xlsx]
2026-02-15 Create Numbers systems.xlsx
    [Numbers systems.xlsx]
2026-02-26 fixed compiler
    text mode inserts new line characters
    > changed the files' mode to binary
    [main.cpp]
2026-03-03 fixed problems in programme in assembler
2026-03-05 Kicad
    fixed some design errors(dat dis DistShiftreg, wrong cmd pins)
    added description to every CMD for better debug, use CTRL+f and use option "Whole words only" to search e.g. inc
    [ALU.kicad_sch, Computer.kicad_sch, DATtoADR.kicad_sch, FlagRegister.kicad_sch, FlashMemory.kicad_sch, InputOutput.kicad_sch, ProgrammeCounter.kicad_sch, RAM.kicad_sch]
2026-03-06 fixes
    fixed timing for dat to adr register
    added a new short test programme for dat to adr register
    [DATtoADR.kicad_sch, FlashMemory.kicad_sch]
2026-03-09 Update Numbers systems.xlsx
    [Numbers systems.xlsx]
2026-03-11 Update Truth Tables.xlsx
    [Truth Tables.xlsx]
2026-03-14 add image + begin reworking assembler
    [main.cpp]
2026-03-14 added functionality to the assembler
    when writing code, lines need to be started with semicolons
    when assembling the binary files, the assembler will rewrite the line numbers in the code file, helping with writing jump commands
    - addresses next to jump commands will however not be changed > still needs to be fixed
    [main.cpp]
2026-03-15 Fixed some Design bugs
    added some pdfs
    [ALU.kicad_sch, Computer.kicad_sch, DATtoADR.kicad_sch, FlashMemory.kicad_sch, ProgrammeCounter.kicad_sch, chips availability.xlsx]
2026-03-15 worked on calculator
    the calculation methods still need to be worked out
    the assembler needs to recognize and leave empty lines, for readabilities' sake
2026-03-15 empty lines in assembler + programme more readable
2026-03-15 worked on reusing labels, problems persist
    checking for the values within the positions list does not work
    [main.cpp]
2026-03-16 fixed labels in assembler
    [main.cpp]
2026-03-17 added debugging messages
    added debugging messages to the errors.txt file after assembly
    [main.cpp]
2026-03-17 part 1 of changing to A4
    [ALU.kicad_sch, AdderSubstractor.kicad_sch, BarrelShiftRegister.kicad_sch, Comparator.kicad_sch, DATtoADR.kicad_sch, FlashMemory.kicad_sch, ProgrammeCounter.kicad_sch, RAM.kicad_sch]
2026-03-17 Update Commands.xlsx + main.cpp
    - fixed a typo, added more info to commands
    - removed the address disabling for ldz from the bus transfer register, since it will disable the address bus one cycle later. This seemed too complicated, and it doesnt really matter
    [Commands.xlsx]
2026-03-18 fixed code + fixed error output in main.cpp
    the address bus disabling did not work previously, so it had to be moved by one cycle
    [main.cpp]
2026-03-19 main.cpp + commands.xlsx
    small changes
    [Commands.xlsx]
2026-03-19 changed page numbers, compressed ROOT file from A1 to A4
    [AB_Bus_LEDs_ALU.kicad_sch, ADR_Bus_LEDs_ALU.kicad_sch, ADR_Flash.kicad_sch, ALU.kicad_sch, ALU_Control_Module.kicad_sch, ALU_Memory_Module.kicad_sch, AdderSubstractor.kicad_sch, AdderSubstractor_ALU.kicad_sch]
2026-03-21 changed page numbers, every schematic is now A4
    [AB_Bus_LEDs_ALU.kicad_sch, ADR_Bus_LEDs_ALU.kicad_sch, ADR_Flash.kicad_sch, ALU.kicad_sch, ALU_Control_Module.kicad_sch, ALU_Memory_Module.kicad_sch, AdderSubstractor.kicad_sch, AdderSubstractor_ALU.kicad_sch]
2026-03-27 school files to server, added documentation for 8Bit-Computer
    [Commands.xlsx, Numbers systems.xlsx, Truth Tables.xlsx]
2026-04-02 small fixes for the assembler
    assembler now allows labels containing the names of other labels
    [main.cpp]
2026-04-03 fixes
    tried to make the input programme wait until the button is let go of and then allow another value to be stored.
2026-04-06 Code + Simulation changes
    changed the barrel shift register, since it shifted in the wrong direction. This change still needs to be implemented in the physical version
    multiplication works now, 16bit operations are not yet implemented, same with error detection and division
    [main.cpp]
